AMSAT-ZL/KiwiSAT_Sub-Systems/Camera/C328-Camera-Application/grid test 300mm distance.jpg

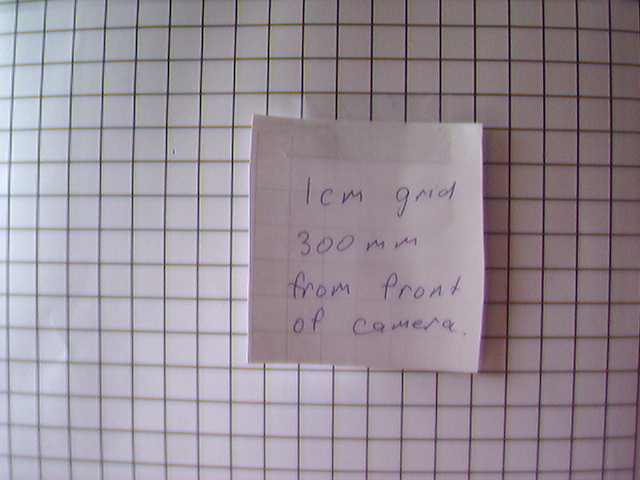
Camera/C328-Camera-Application/grid test 300mm distance.jpg
