AMSAT-ZL/KiwiSAT_Sub-Systems/IHU/Rev2/KiwiSAT U51 fix.JPG

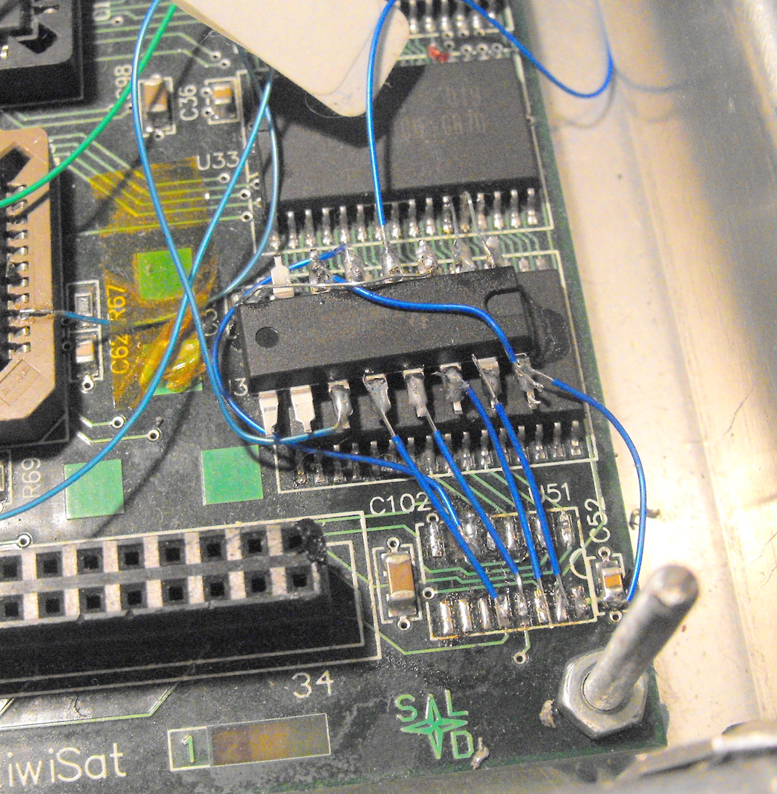
IHU/Rev2/KiwiSAT U51 fix.JPG
