AMSAT-ZL/KiwiSAT_Sub-Systems/README.md

# KiwiSAT_Sub-Systems
This Repository is for KiwiSAT Hardware.
It contains Data sheets for components, schematics, PCB designs, 
test data and photos for all the KiwiSAT Modules.
