AMSAT-ZL/KiwiSAT_Sub-Systems/Camera/PCB Panels/ReadMe.txt

15 May 2008   C Gumbrell

CameraADAC1 panel.
  Camera Version 2 and ADAC controller PCBs in a panel.
  Released for quote to OurPCB

16 May 2008   C Gumbrell

CameraADAC2 panel.
  Modified Camera Version 2 and ADAC controller PCBs in a panel.
  (not that version numbers of these PCBs was not changed)
  Power plane clearance needed to be increased for OurPCB.
  Released for manufacture.
