AMSAT-ZL/KiwiSAT_Sub-Systems/IHU/FEC_Encoder/ReadMe.txt

FEC Schematic

Forward Error Correction PCB

This is an add-on PCB for the IHU (first revision). It implements the FEC encoding.

Latest version is FEC Encoder 06B

Files:
FEC_Encoder_06B.DSN                     CAD schematic file (Proteus)
FEC_Encoder_06B.LYT                     CAD PCB file (Proteus)
FEC_Encoder_06B Schematic.pdf           PDF of the schematic
FEC_Encoder_06B Copper.pdf              Copper design (use this file to create the PCB)
FEC_Encoder_06B Layout.pdf              Diagram of the PCB layers. red=copper  blue=wire jumpers
