AMSAT-ZL/KiwiSAT_Sub-Systems/BCR/Notes on BCR.docx

Notes on BCR

This BCR (Battery Charge Regulator) uses MPPT (Maximum Power Point Transfer) to control the charge current fed to the battery.

The MPPT is controlled by a number 12FC671 PIC microcontrollers.

The programming code for these PICs is no longer available.
