AMSAT-ZL/KiwiSAT_Sub-Systems/FM_Receivers/drill.pdf

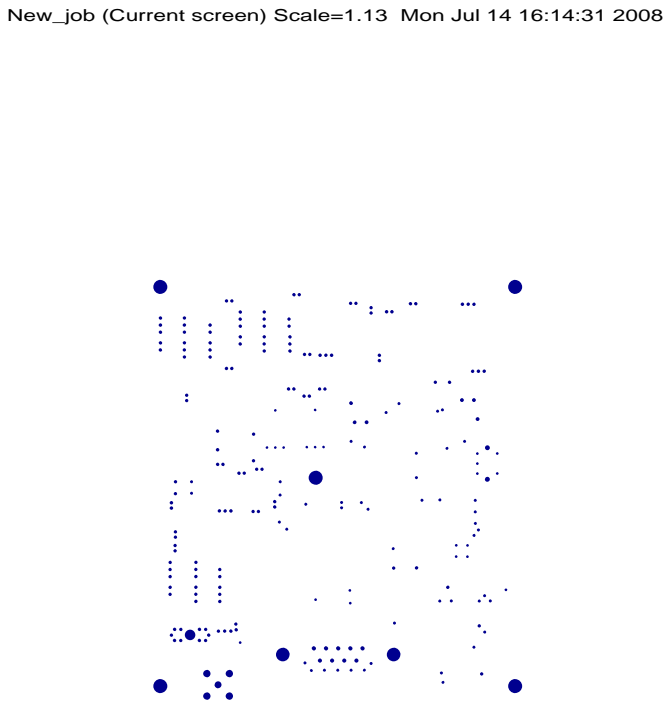
[picture p3: page 1]

New_job (Current screen) Scale=1.13 Mon Jul 14 16:14:31 2008
