AMSAT-ZL/KiwiSAT_Sub-Systems/BCR/BCR_Schematic_1.pdf

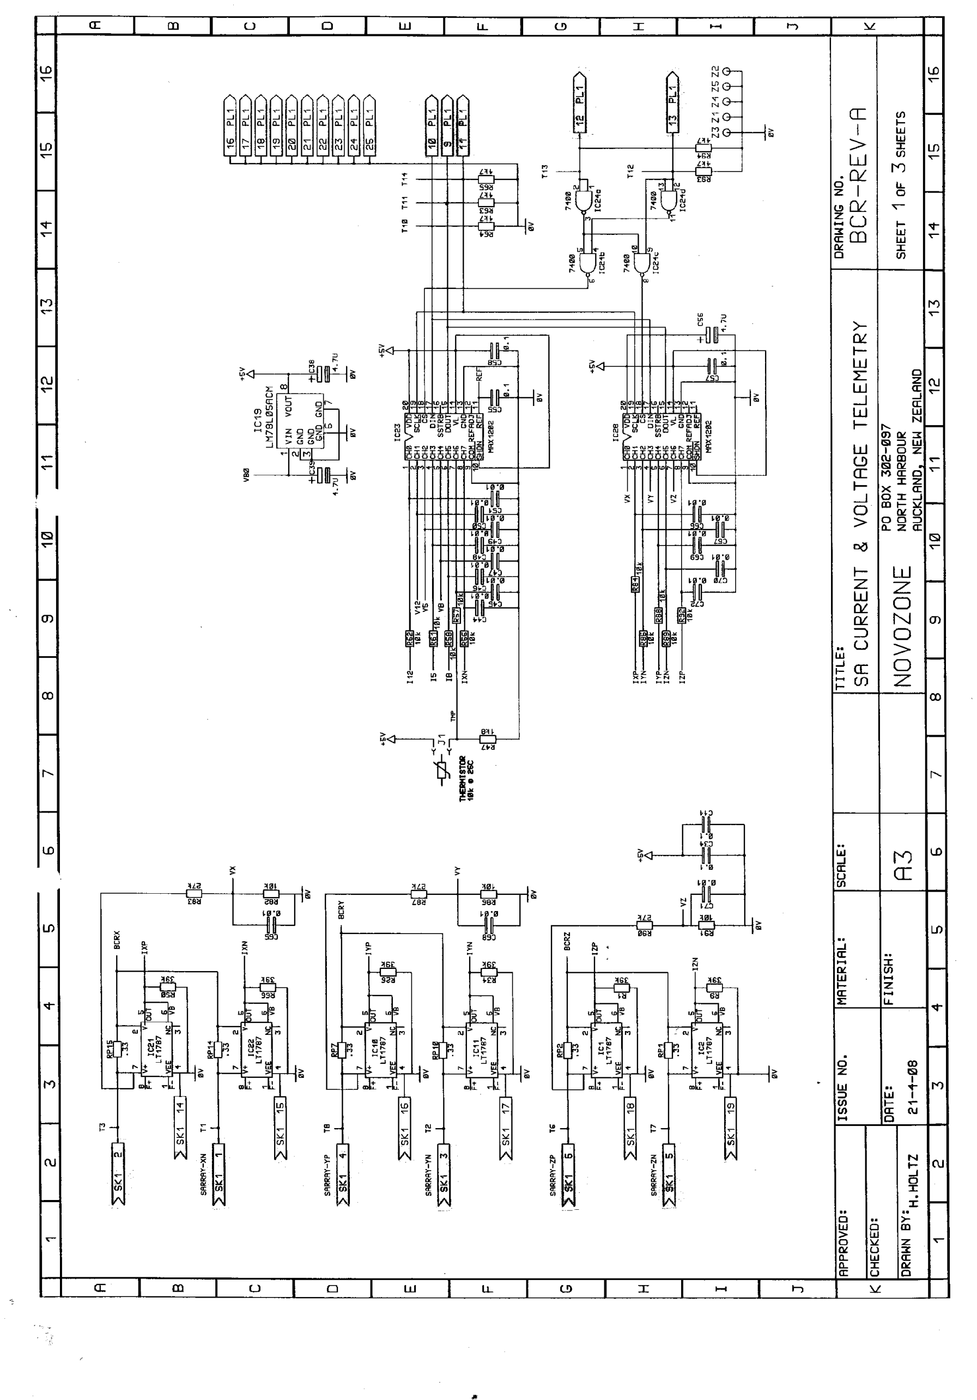
[picture p4: page 1]
