AMSAT-ZL/KiwiSAT_Sub-Systems/BCR/BCR_Schematic_2.pdf

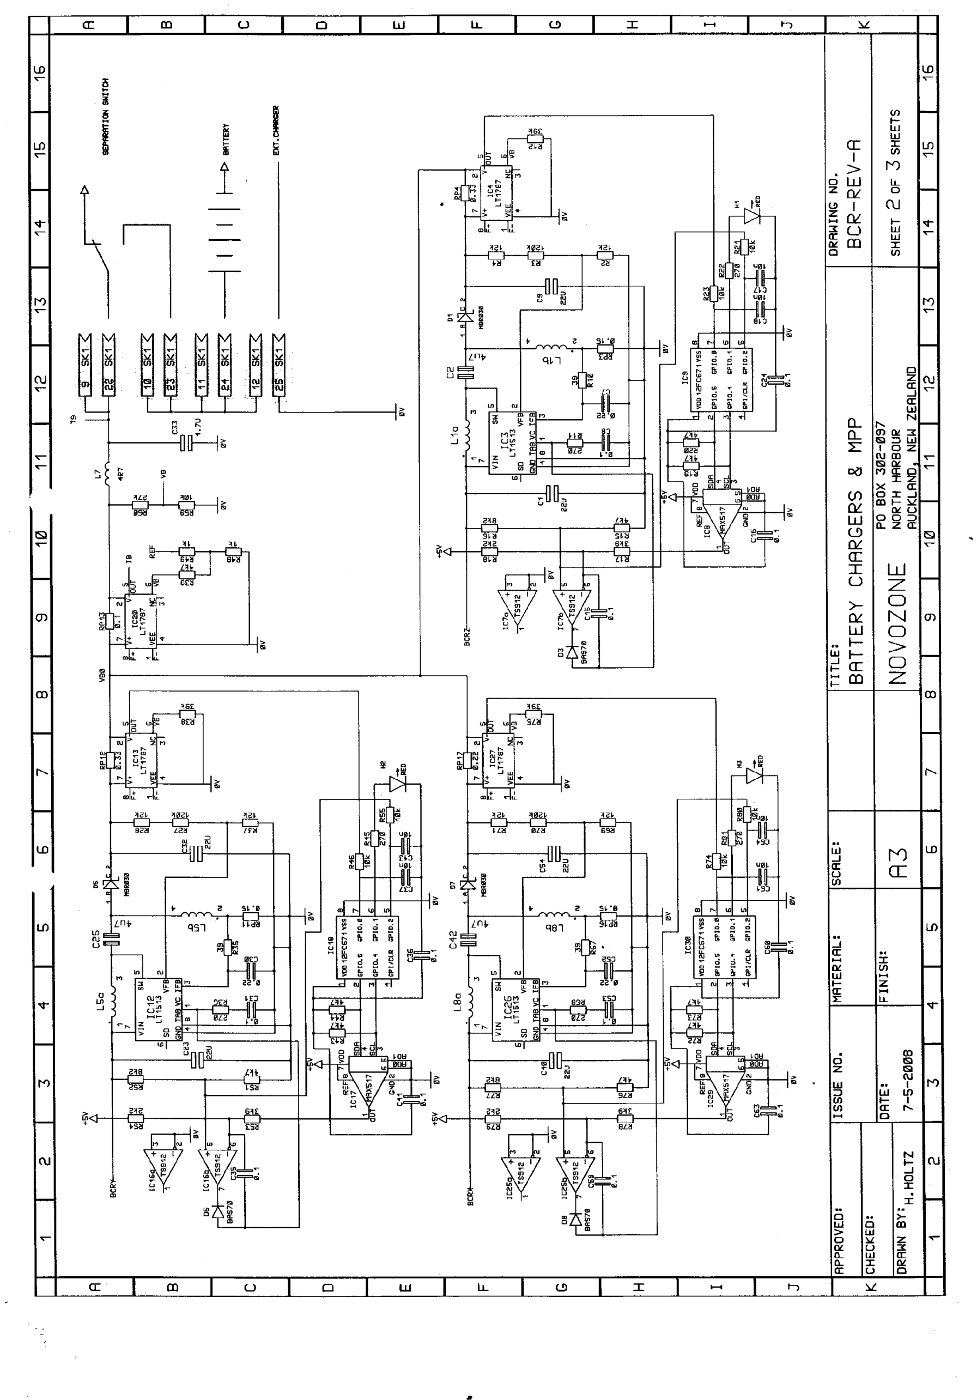
[picture p5: page 1]
