AMSAT-ZL/KiwiSAT_Sub-Systems/BCR/BCR_Schematic_3.pdf

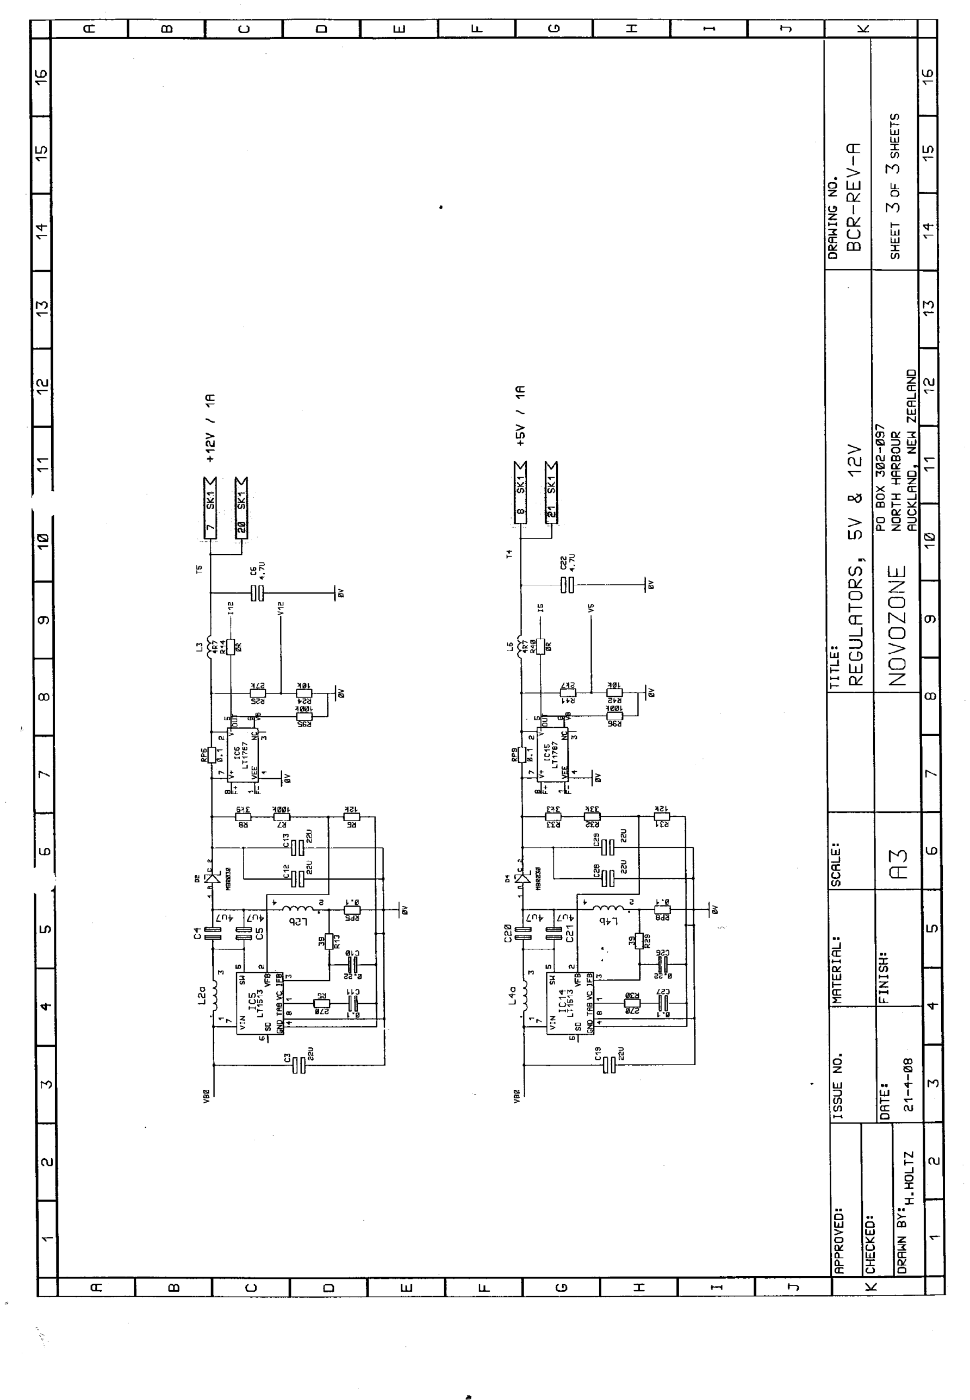
[picture p6: page 1]
