AMSAT-ZL/KiwiSAT_Sub-Systems/BCR/BCR_Board Layout.pdf

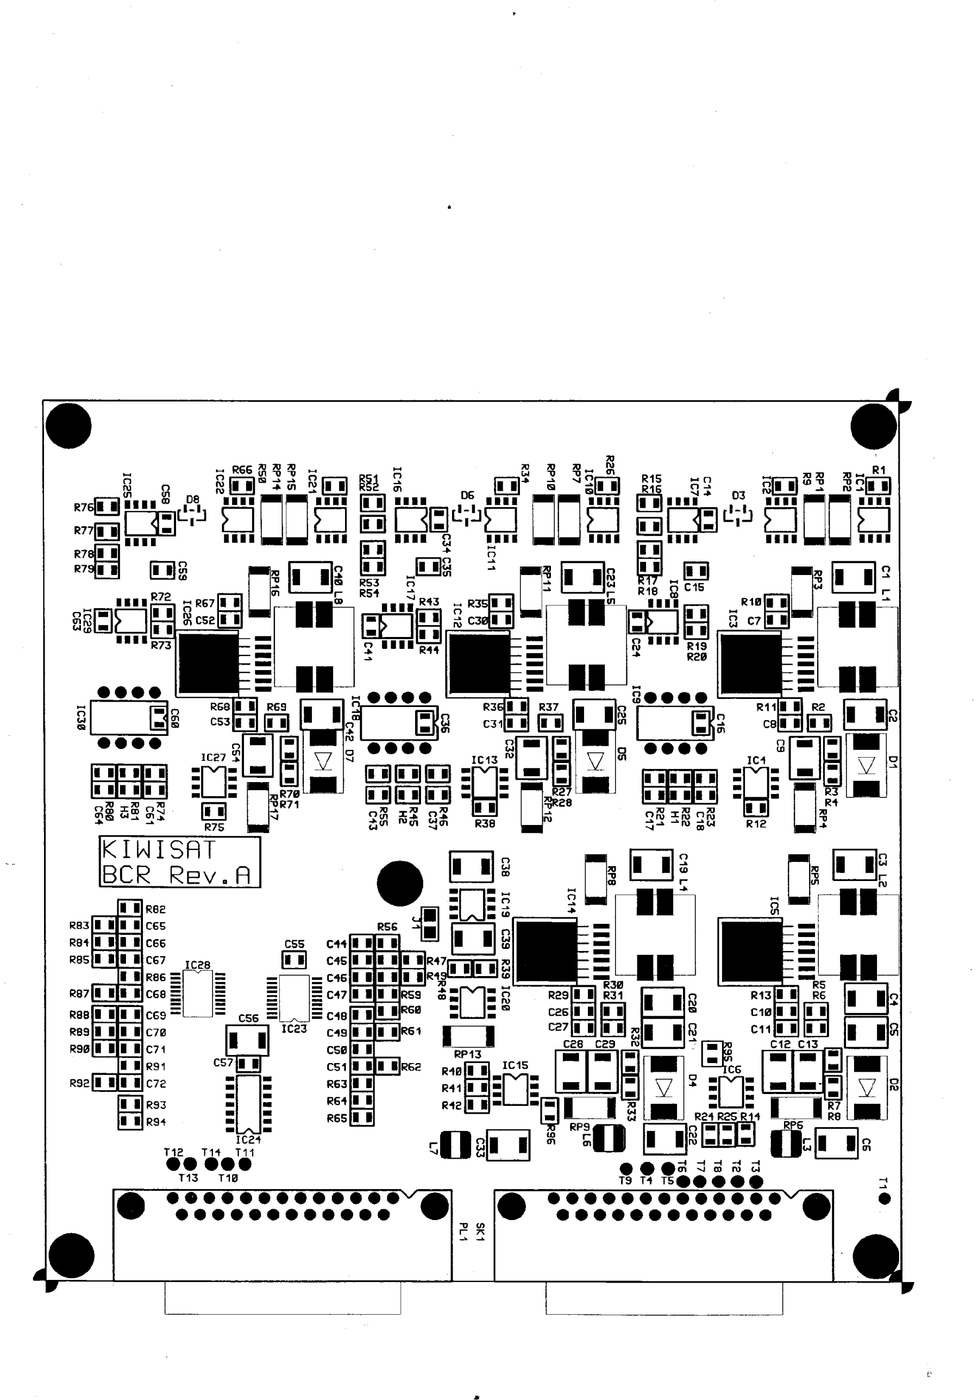
[picture p7: page 1]
