AMSAT-ZL/KiwiSAT_Sub-Systems/ADC_Module/ADC_Module_V10.gif

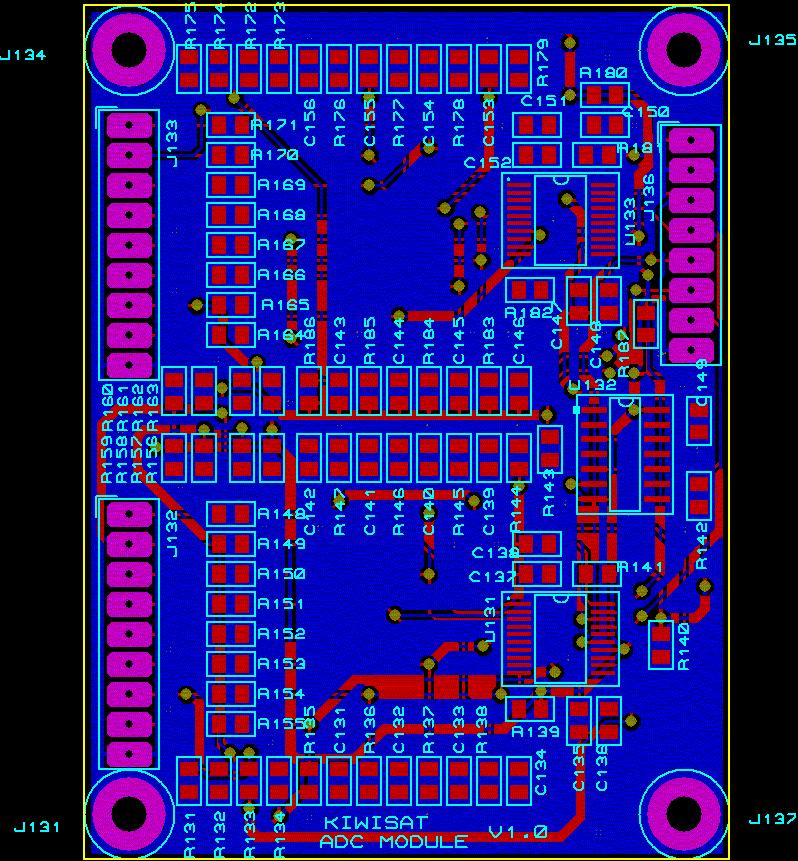
ADC_Module/ADC_Module_V10.gif
