AMSAT-ZL/KiwiSAT_Sub-Systems/Antennas/2M Turnstile Tx Ant/2M Canted Turnstile 3D.jpg

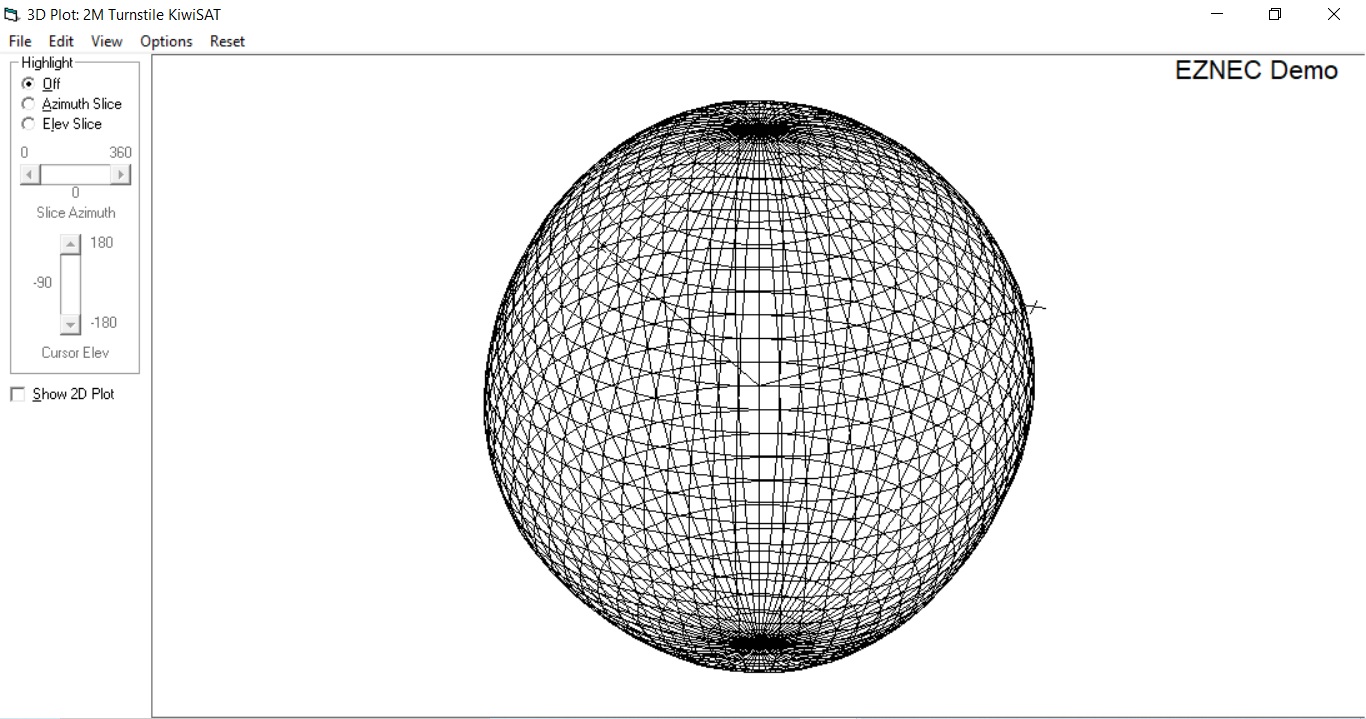
Antennas/2M Turnstile Tx Ant/2M Canted Turnstile 3D.jpg
