AMSAT-ZL/KiwiSAT_Sub-Systems/Antennas/2M Turnstile Tx Ant/2M Turnstile Azimuth.jpg

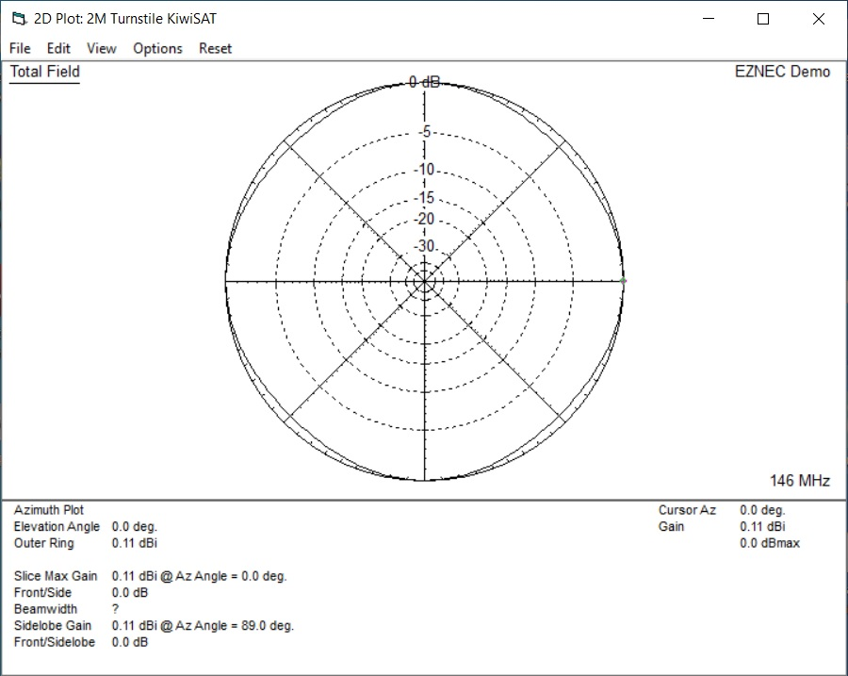
Antennas/2M Turnstile Tx Ant/2M Turnstile Azimuth.jpg
