AMSAT-ZL/KiwiSAT_Sub-Systems/Antennas/2M Turnstile Tx Ant/2M Turnstile Model.jpg

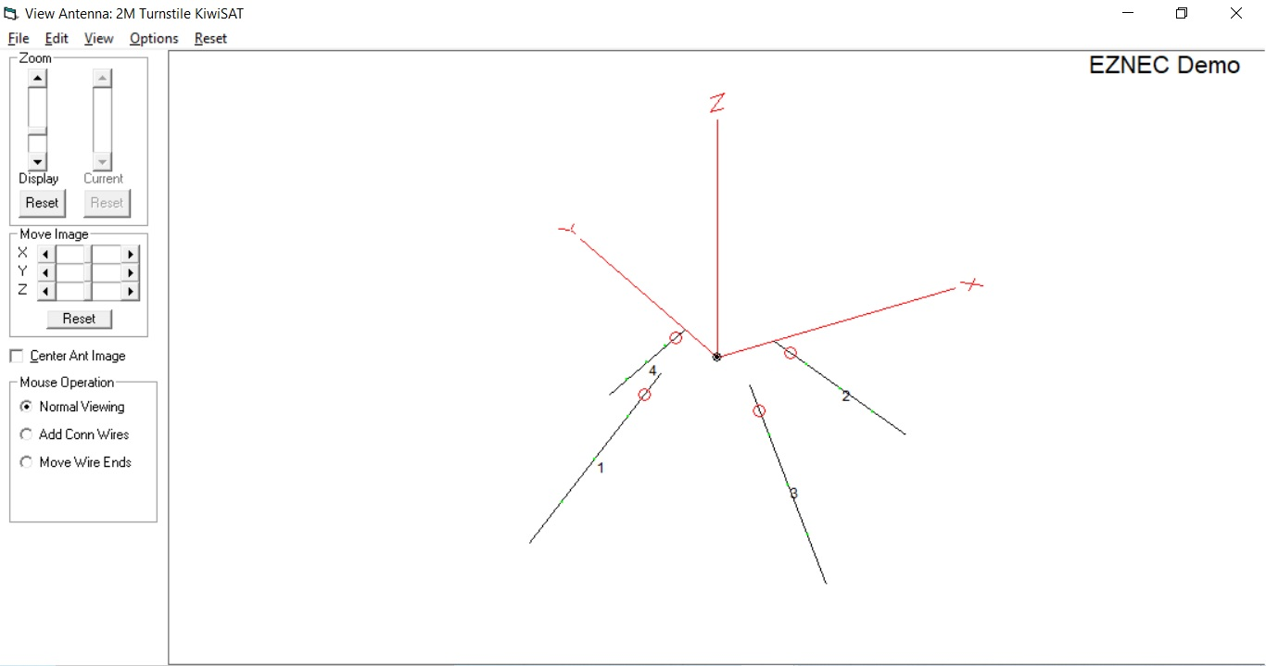
Antennas/2M Turnstile Tx Ant/2M Turnstile Model.jpg
