AMSAT-ZL/KiwiSAT_Sub-Systems/Antennas/70CM Whip/70Cm Whip1.bmp

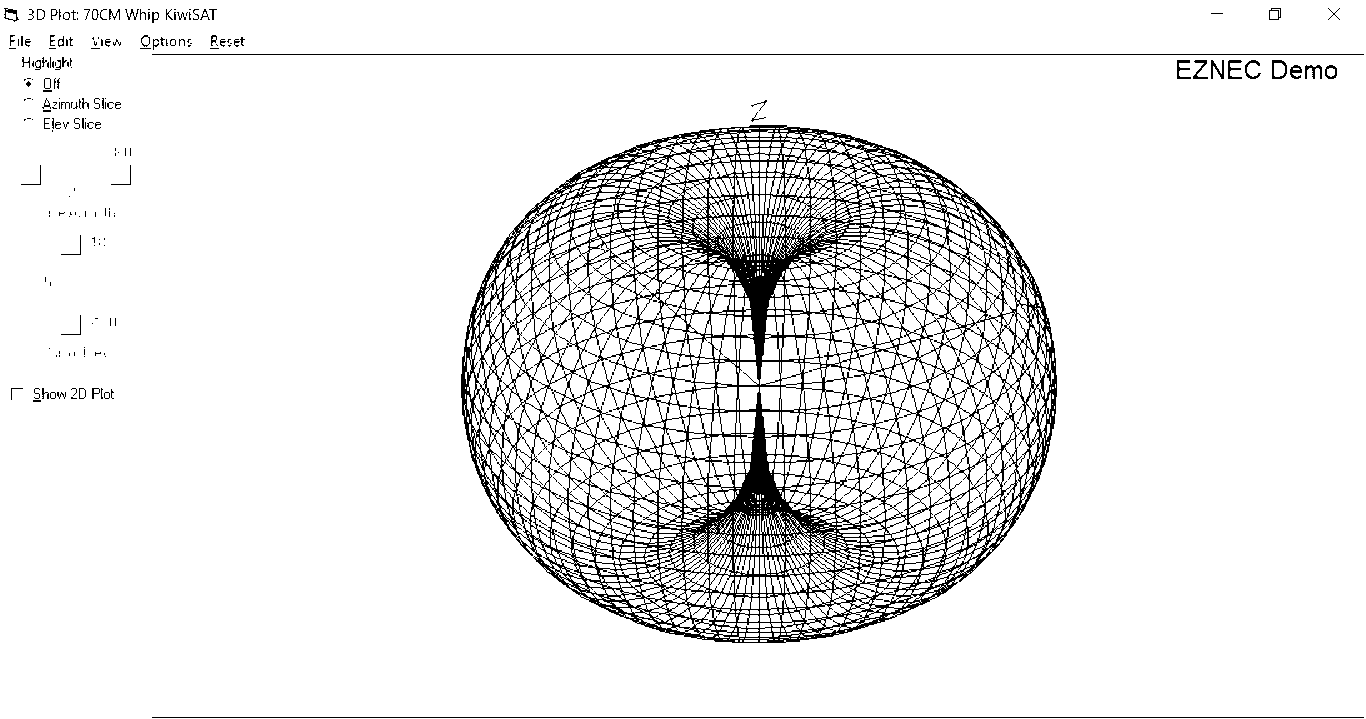
Antennas/70CM Whip/70Cm Whip1.bmp
