AMSAT-ZL/KiwiSAT_Sub-Systems/Antennas/70CM Whip/70Cm Whip1.jpg

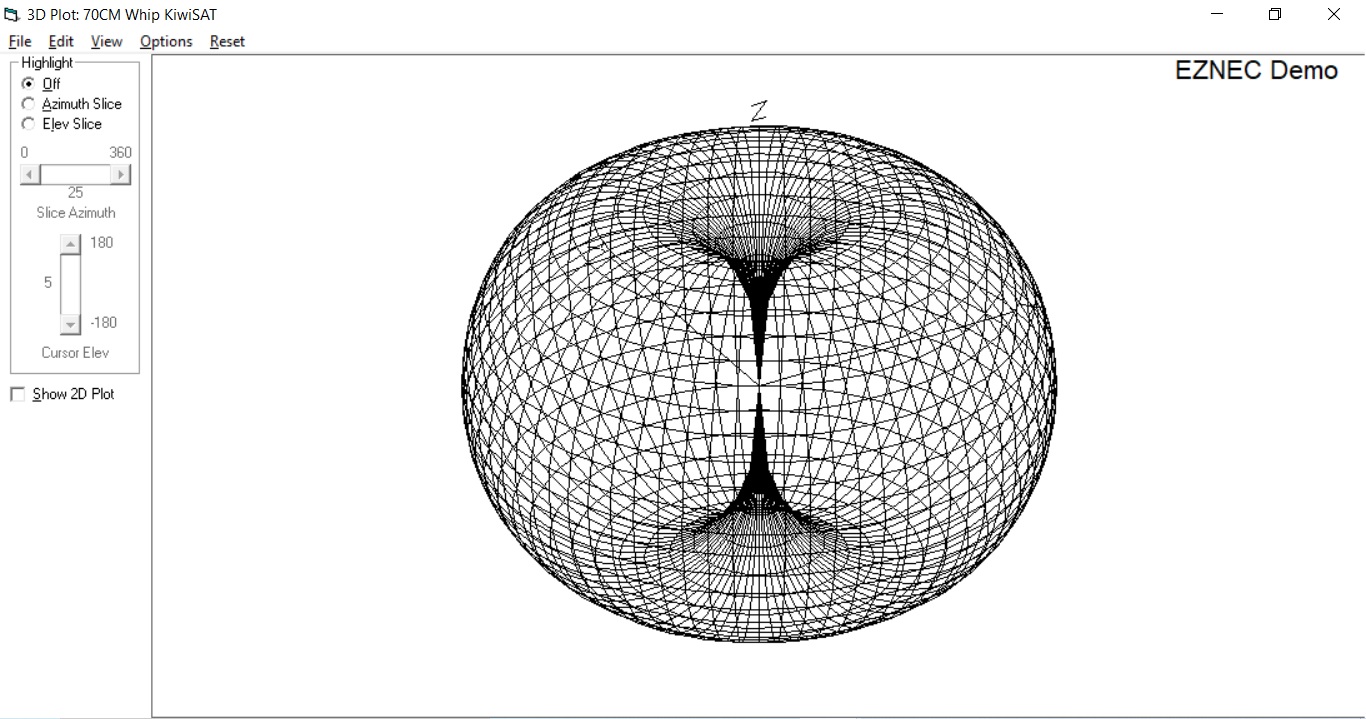
Antennas/70CM Whip/70Cm Whip1.jpg
