AMSAT-ZL/KiwiSAT_Sub-Systems/Antennas/70CM Whip/70CM Whip Model.jpg

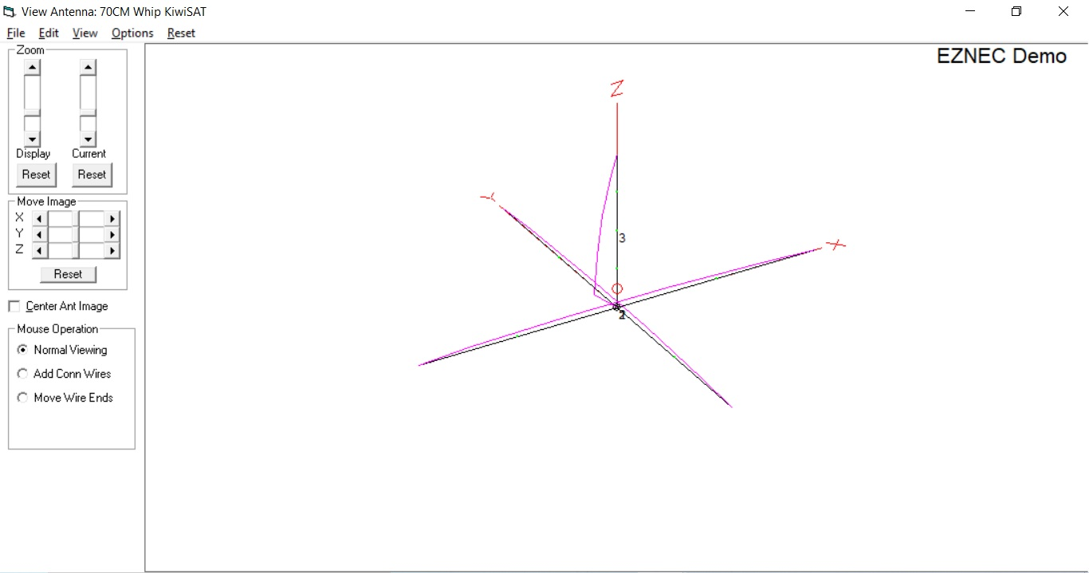
Antennas/70CM Whip/70CM Whip Model.jpg
