AMSAT-ZL/KiwiSAT_Sub-Systems/Antennas/Ant Switch/Ant Switch Block.jpg

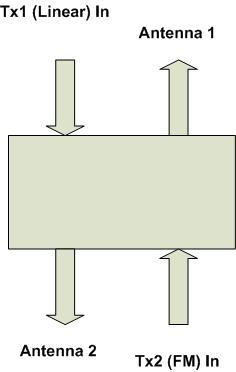
Antennas/Ant Switch/Ant Switch Block.jpg
