AMSAT-ZL/KiwiSAT_Sub-Systems/Antennas/Ant Switch/Antenna Phasing.jpg

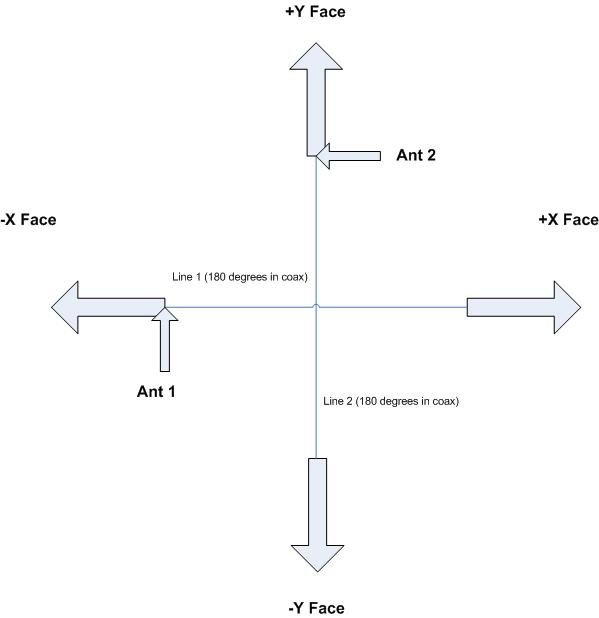
Antennas/Ant Switch/Antenna Phasing.jpg
