AMSAT-ZL/KiwiSAT_Sub-Systems/Antennas/Ant Switch/SCRN01.JPG

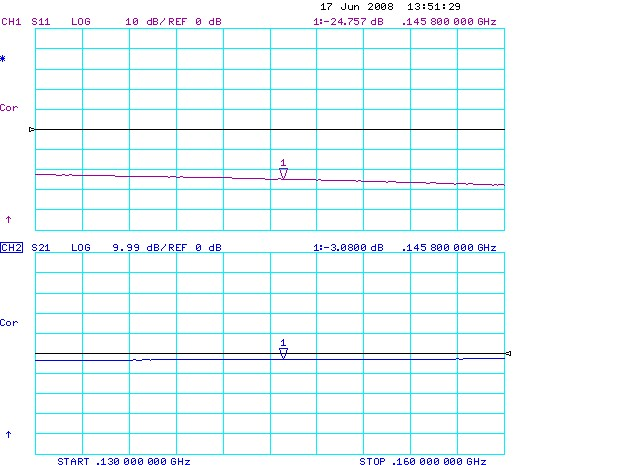
Antennas/Ant Switch/SCRN01.JPG
