AMSAT-ZL/KiwiSAT_Sub-Systems/BCR/BCR - in tray.jpg

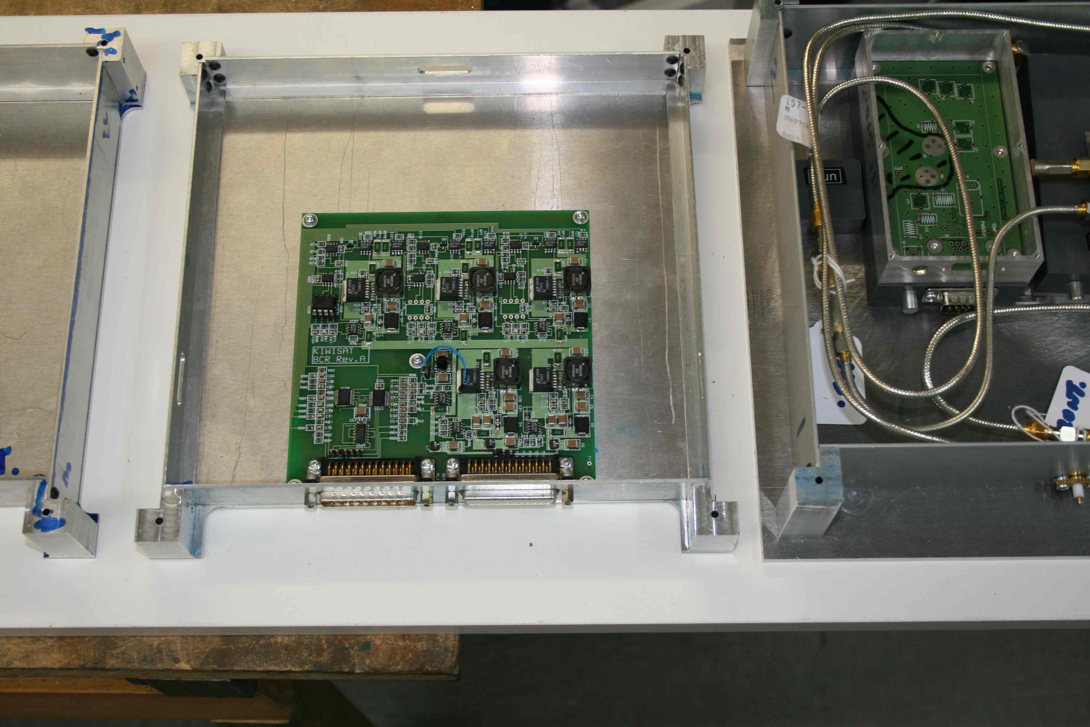
BCR/BCR - in tray.jpg
