AMSAT-ZL/KiwiSAT_Sub-Systems/BCR/KiwiSAT - BCR board Mk 2.jpg

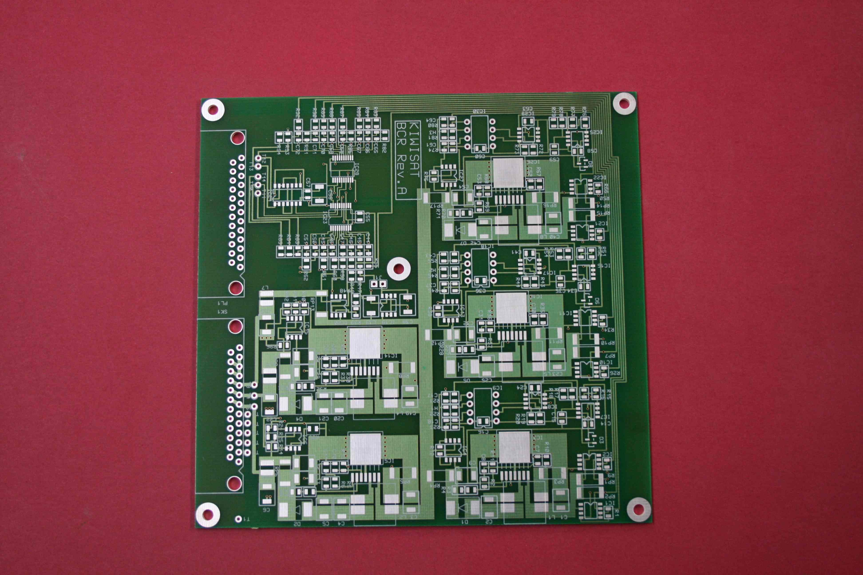
BCR/KiwiSAT - BCR board Mk 2.jpg
