AMSAT-ZL/KiwiSAT_Sub-Systems/BCR/SolarSim/Error Message.jpg

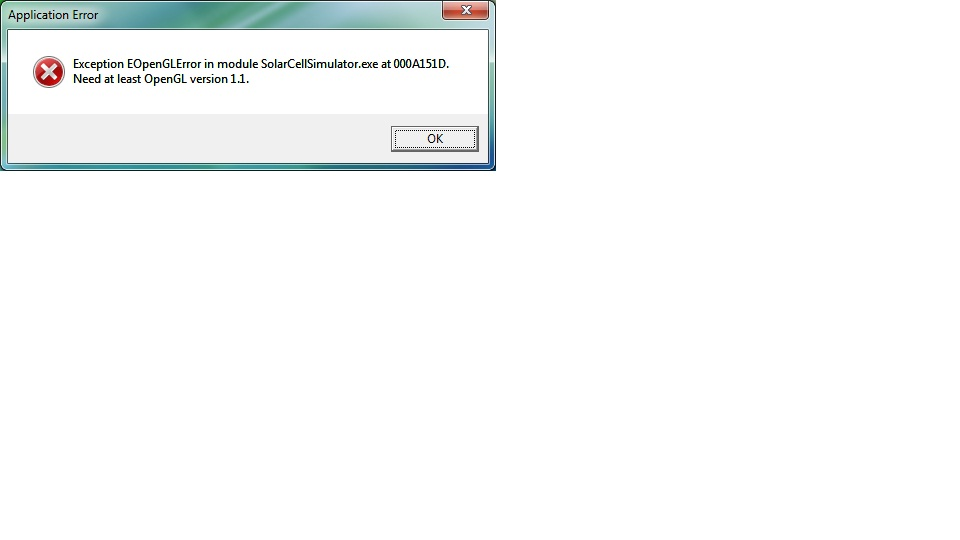
BCR/SolarSim/Error Message.jpg
