AMSAT-ZL/KiwiSAT_Sub-Systems/BCR/SolarSim/KiwiSAT - Power Sim1.jpg

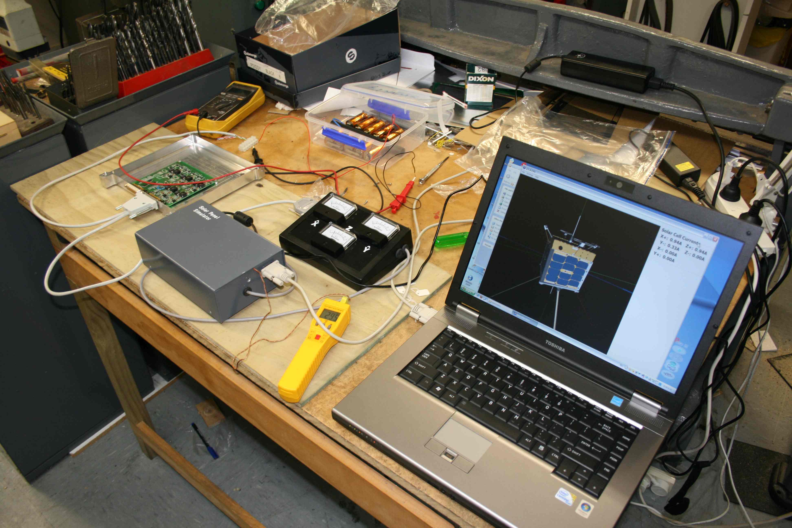
BCR/SolarSim/KiwiSAT - Power Sim1.jpg
