AMSAT-ZL/KiwiSAT_Sub-Systems/BCR/SolarSim/KiwiSAT - Power Sim2.jpg

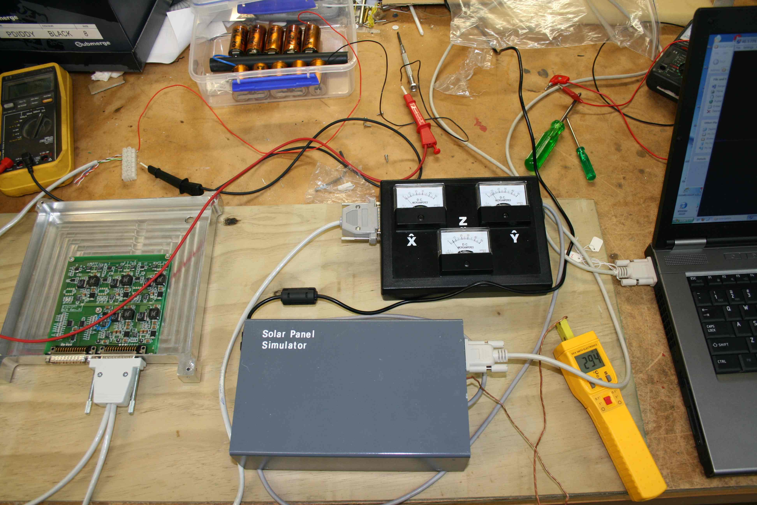
BCR/SolarSim/KiwiSAT - Power Sim2.jpg
