AMSAT-ZL/KiwiSAT_Sub-Systems/BCR/SolarSim/KiwiSAT - Power Sim3.jpg

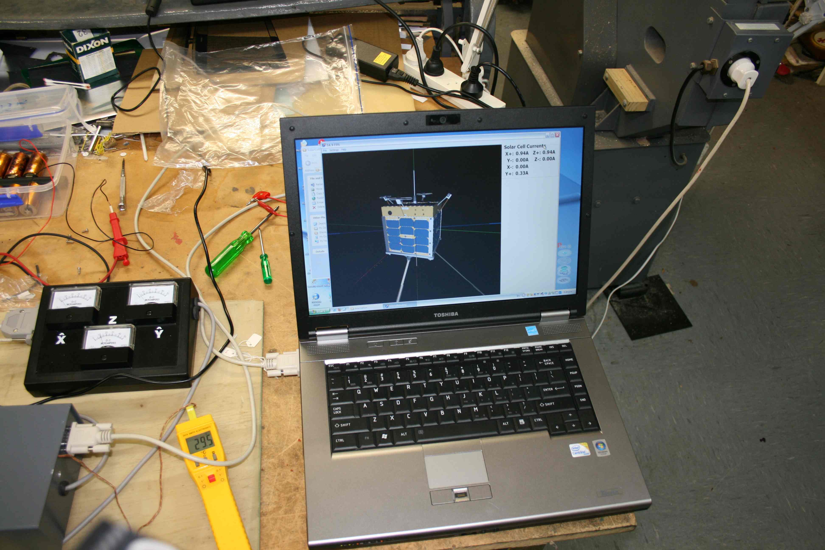
BCR/SolarSim/KiwiSAT - Power Sim3.jpg
