AMSAT-ZL/KiwiSAT_Sub-Systems/BCR/SolarSim/Sat Sim3.jpg

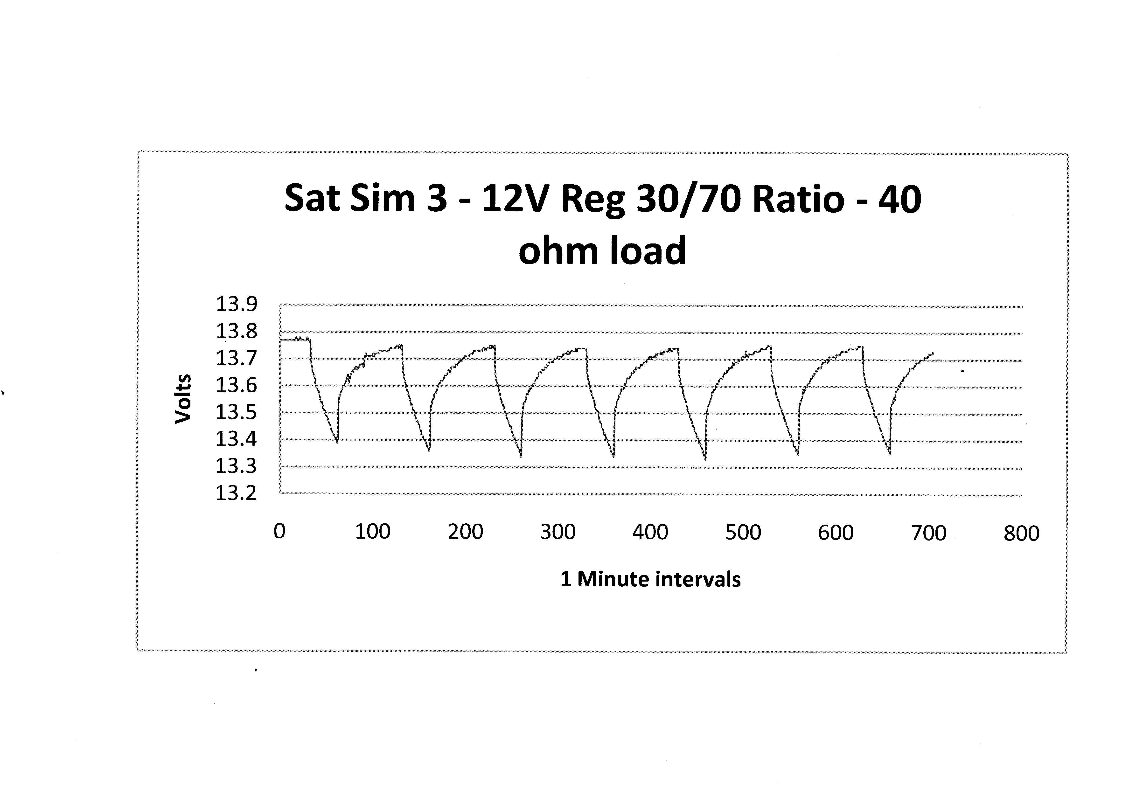
BCR/SolarSim/Sat Sim3.jpg
