AMSAT-ZL/KiwiSAT_Sub-Systems/BCR/SolarSim/Sat Sim4.jpg

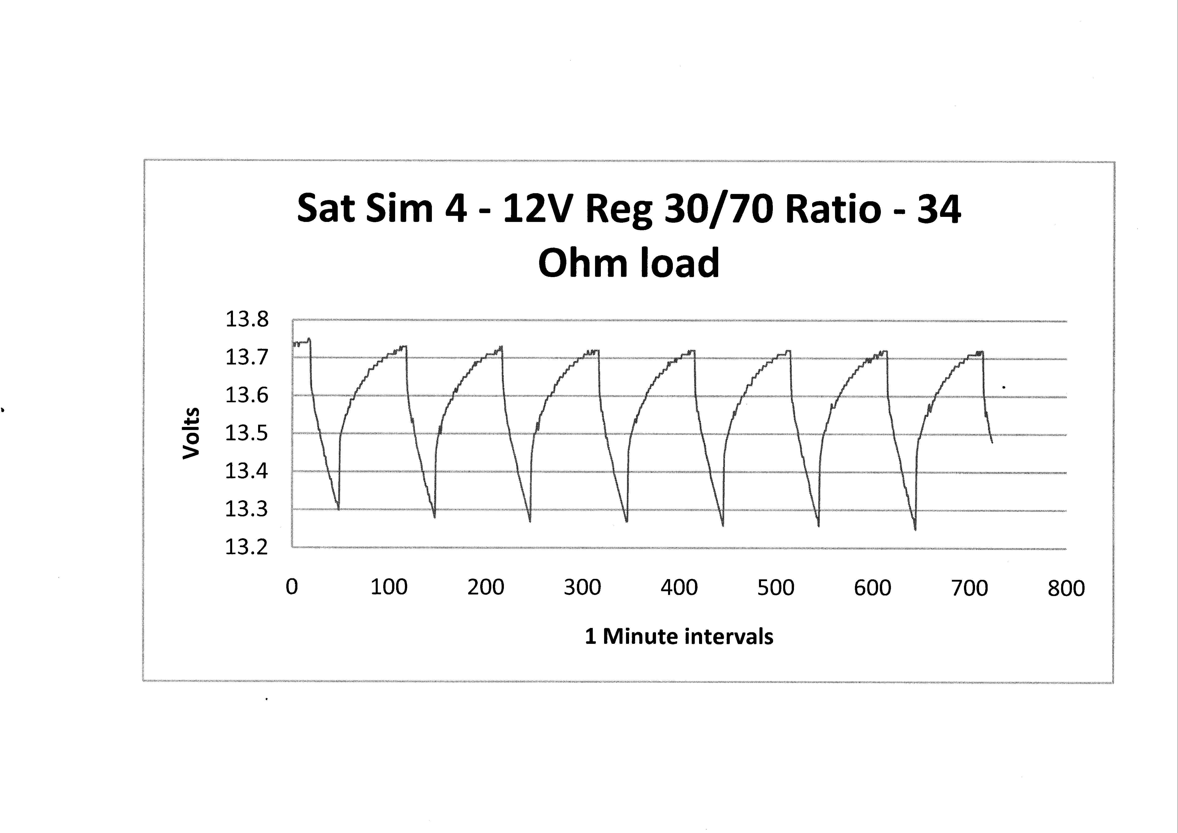
BCR/SolarSim/Sat Sim4.jpg
