AMSAT-ZL/KiwiSAT_Sub-Systems/BCR/SolarSim/Sat Sim5.jpg

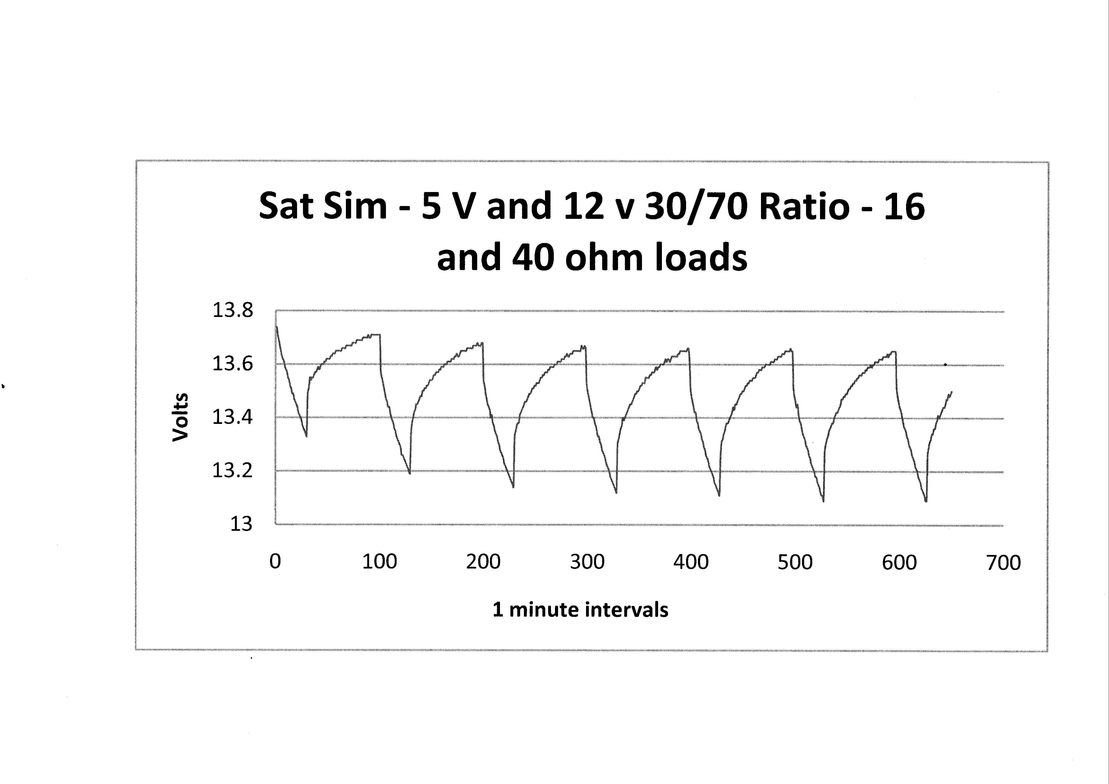
BCR/SolarSim/Sat Sim5.jpg
