AMSAT-ZL/KiwiSAT_Sub-Systems/BCR/SolarSim/Sat Sim 11.jpg

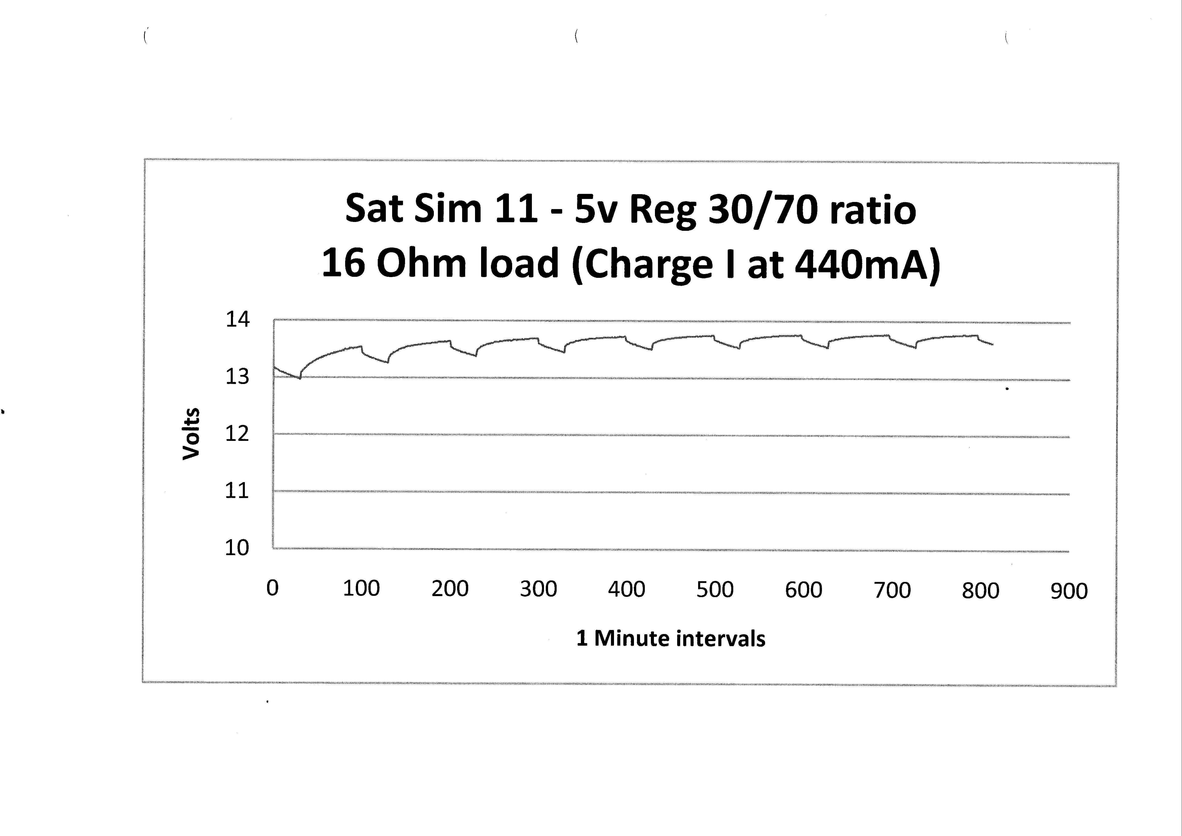
BCR/SolarSim/Sat Sim 11.jpg
