AMSAT-ZL/KiwiSAT_Sub-Systems/BCR/SolarSim/Sat Sim 12.jpg

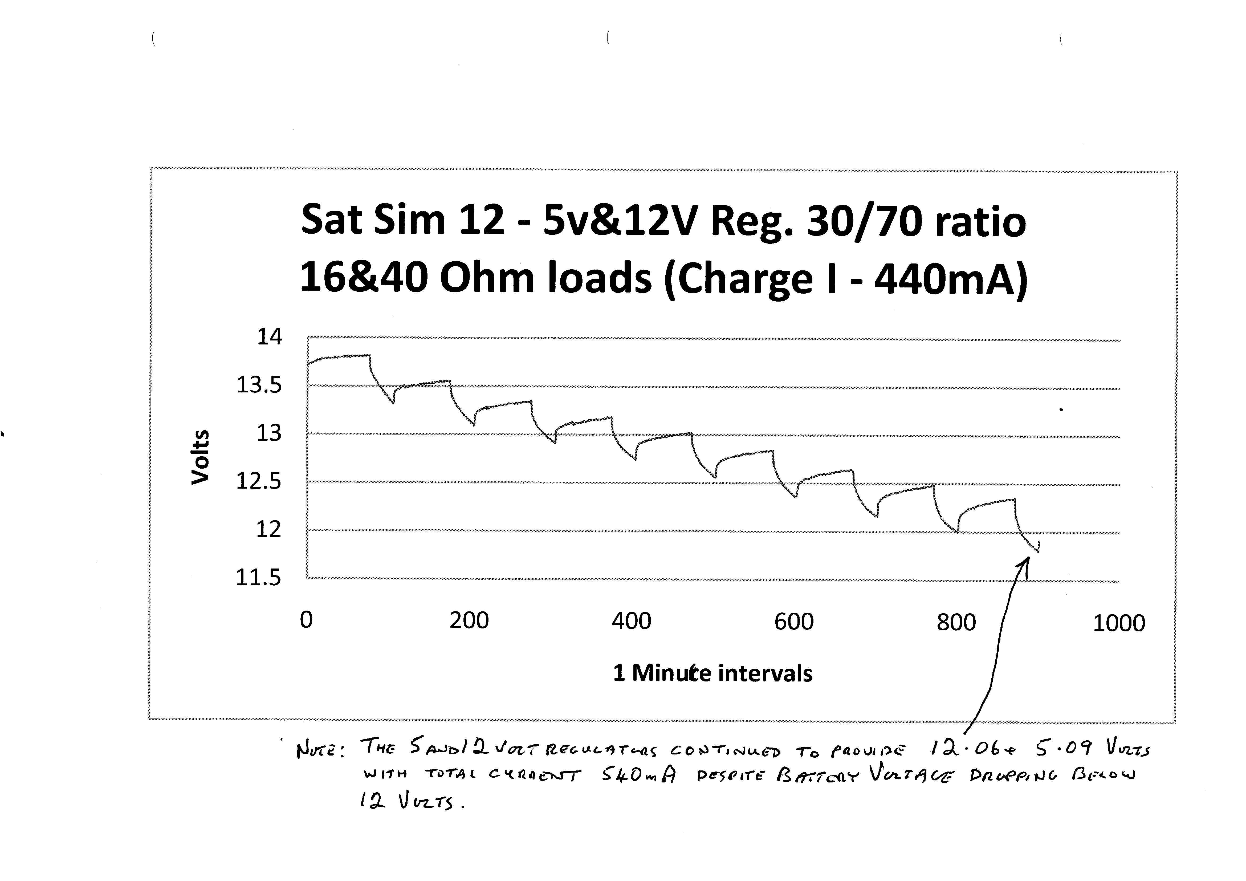
BCR/SolarSim/Sat Sim 12.jpg
