AMSAT-ZL/KiwiSAT_Sub-Systems/BCR/SolarSim/Sat Sim 13.jpg

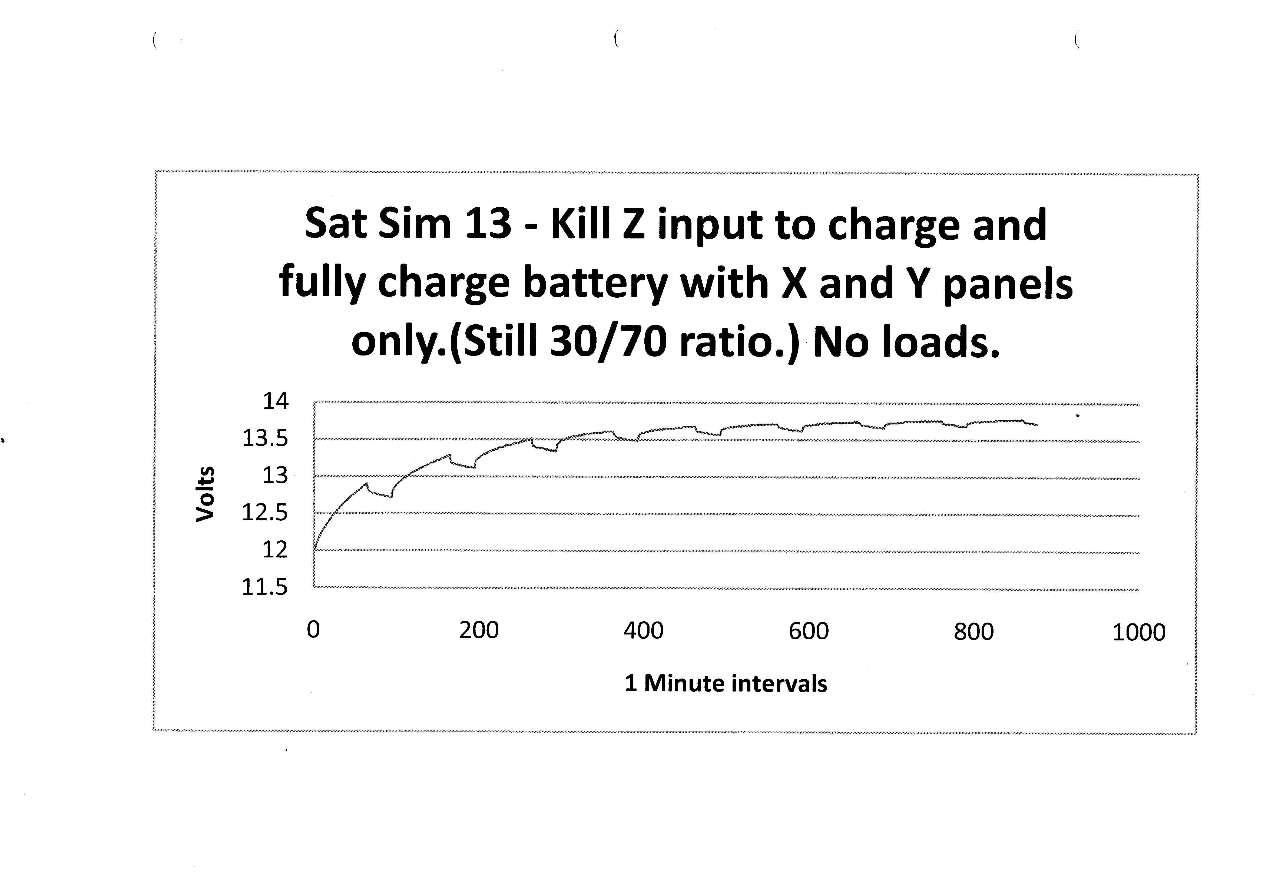
BCR/SolarSim/Sat Sim 13.jpg
