AMSAT-ZL/KiwiSAT_Sub-Systems/BCR/SolarSim/Sat Sim 14.jpg

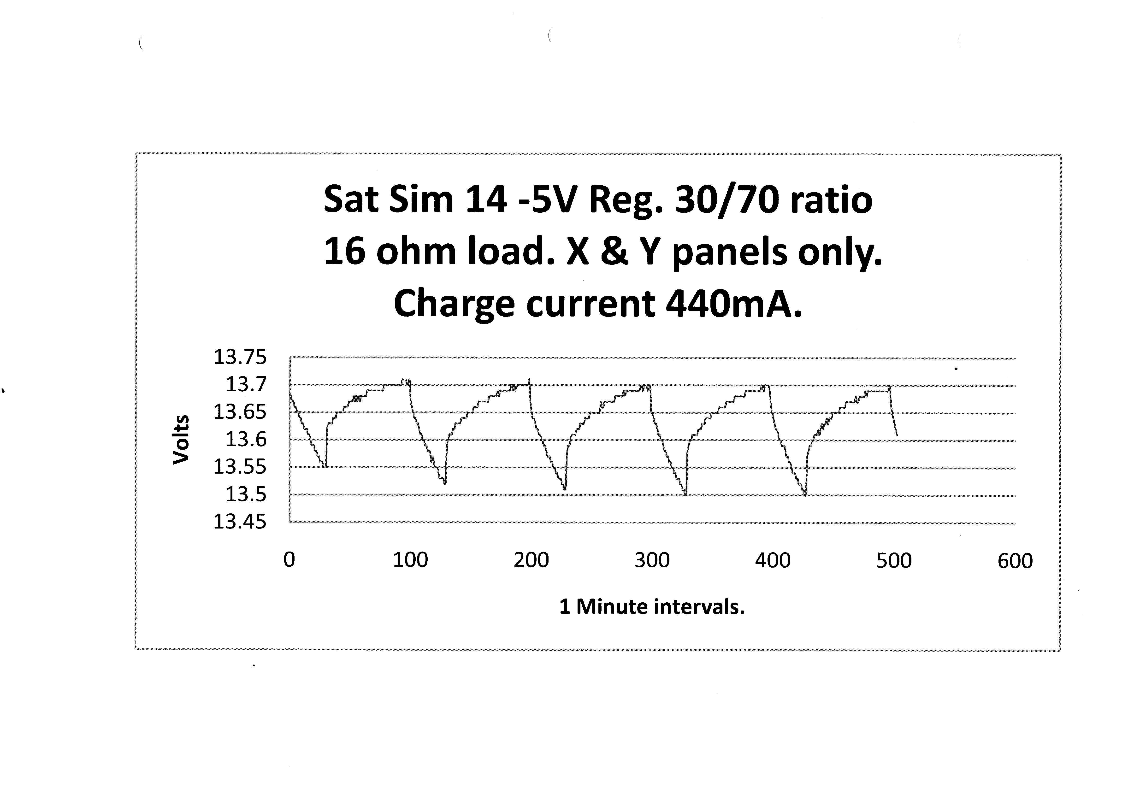
BCR/SolarSim/Sat Sim 14.jpg
