AMSAT-ZL/KiwiSAT_Sub-Systems/BCR/SolarSim/Sat Sim 15.jpg

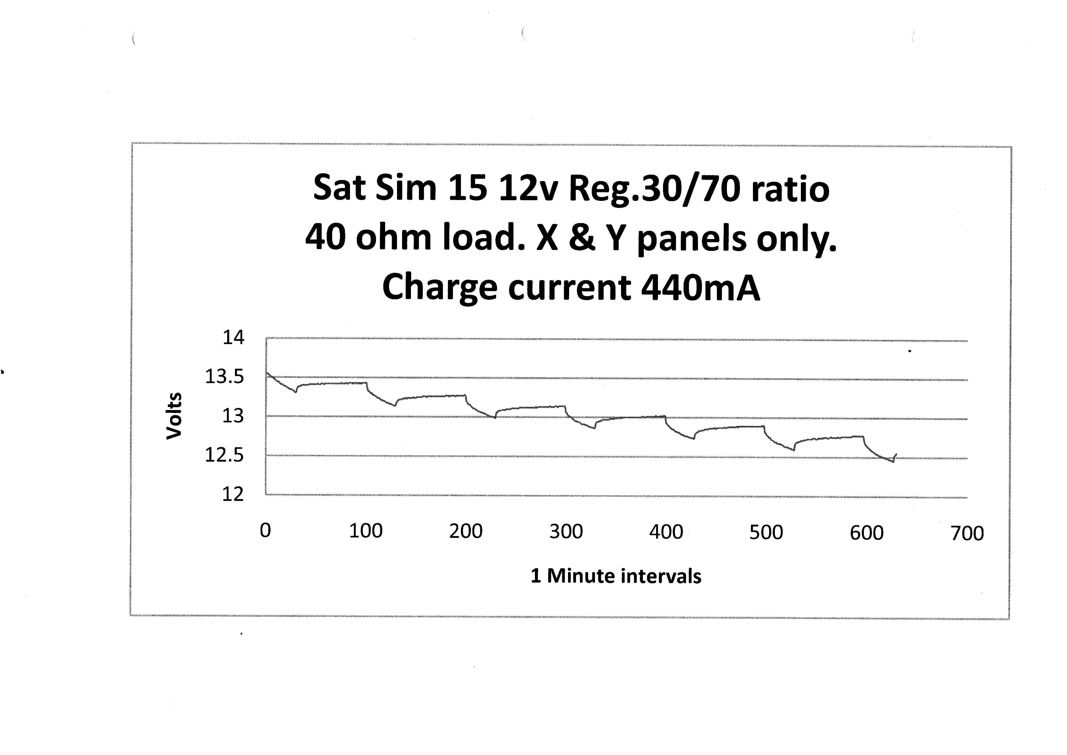
BCR/SolarSim/Sat Sim 15.jpg
