AMSAT-ZL/KiwiSAT_Sub-Systems/BCR/SolarSim/Save0001.jpg

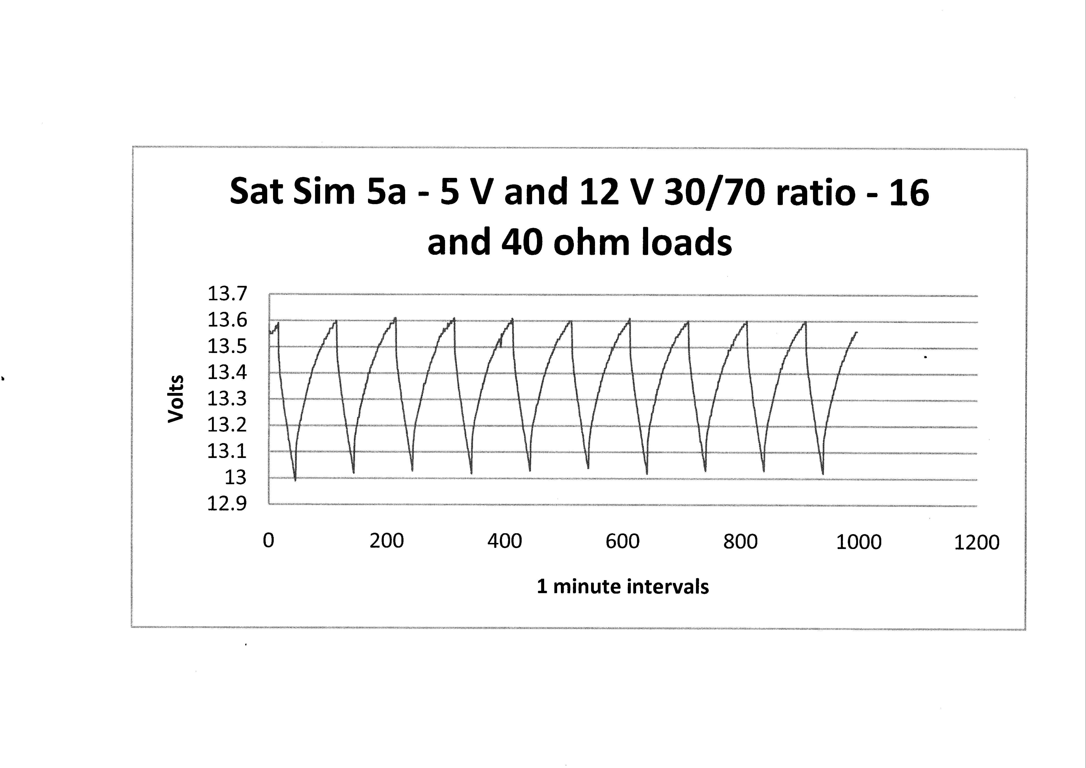
BCR/SolarSim/Save0001.jpg
