AMSAT-ZL/KiwiSAT_Sub-Systems/BCR/SolarSim/Save.jpg

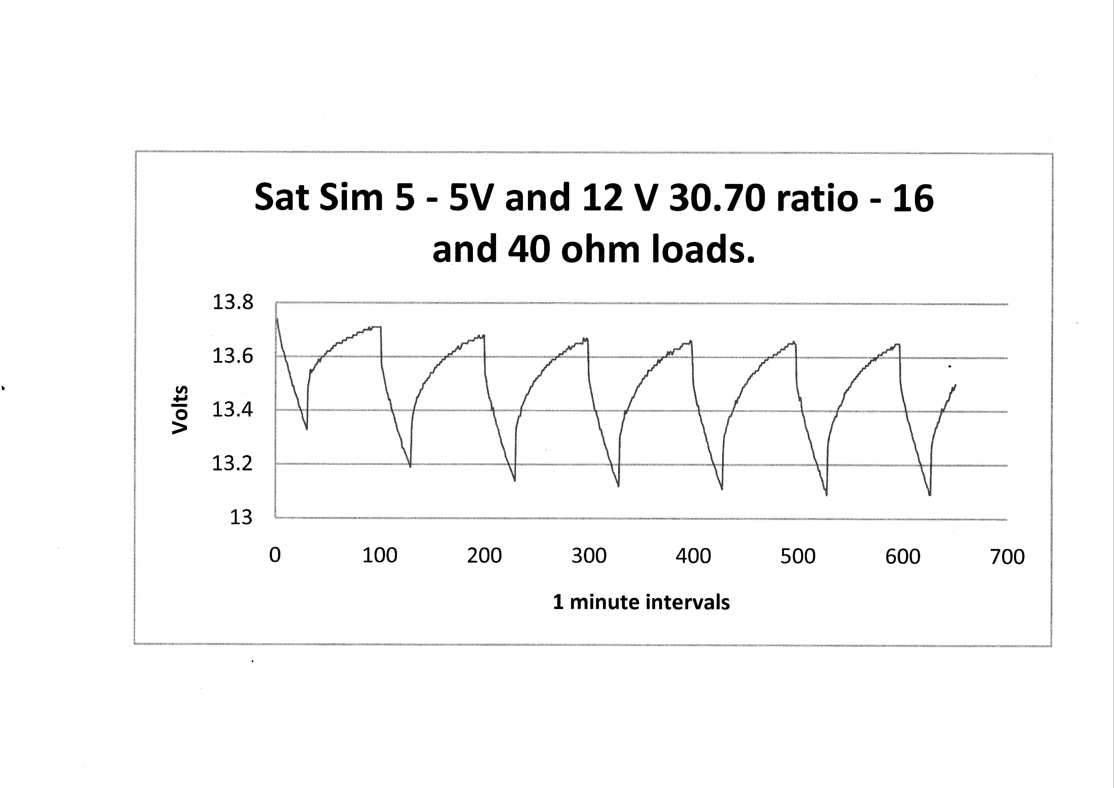
BCR/SolarSim/Save.jpg
