AMSAT-ZL/KiwiSAT_Sub-Systems/BCR/SolarSim/Side1.gif

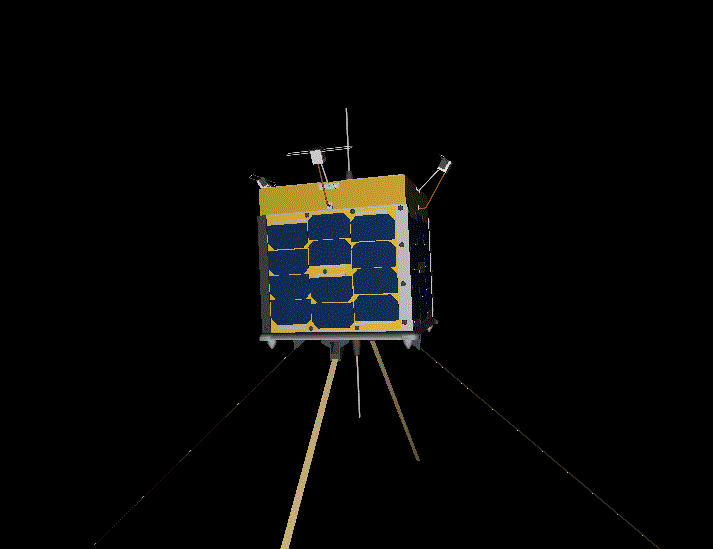
BCR/SolarSim/Side1.gif
