AMSAT-ZL/KiwiSAT_Sub-Systems/BCR/SolarSim/Side2.gif

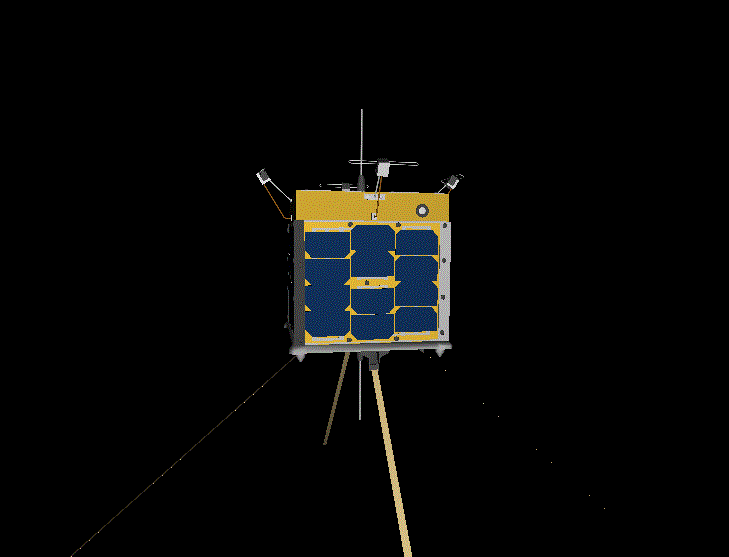
BCR/SolarSim/Side2.gif
