AMSAT-ZL/KiwiSAT_Sub-Systems/BCR/SolarSim/Solar Sim1.jpg

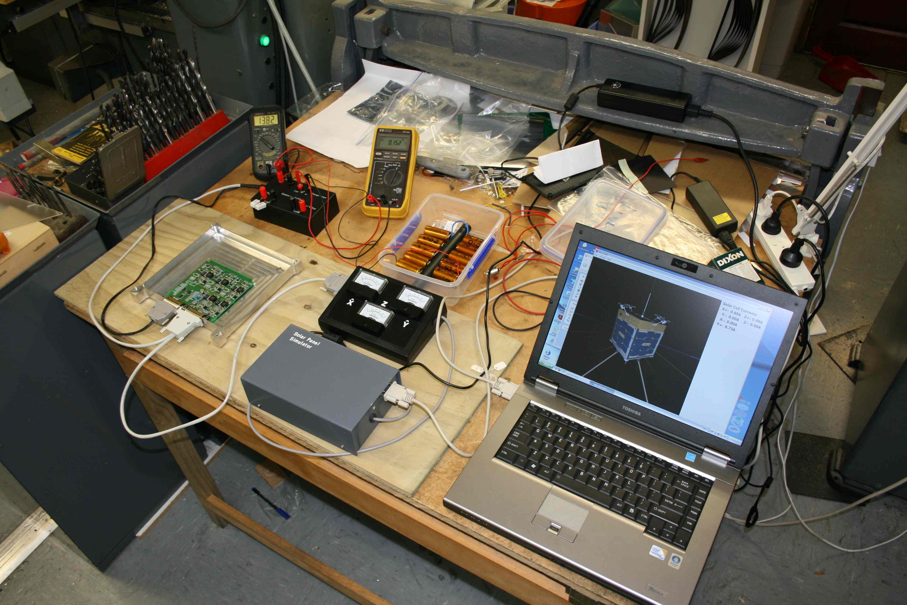
BCR/SolarSim/Solar Sim1.jpg
