AMSAT-ZL/KiwiSAT_Sub-Systems/BCR/SolarSim/Solar Sim2.jpg

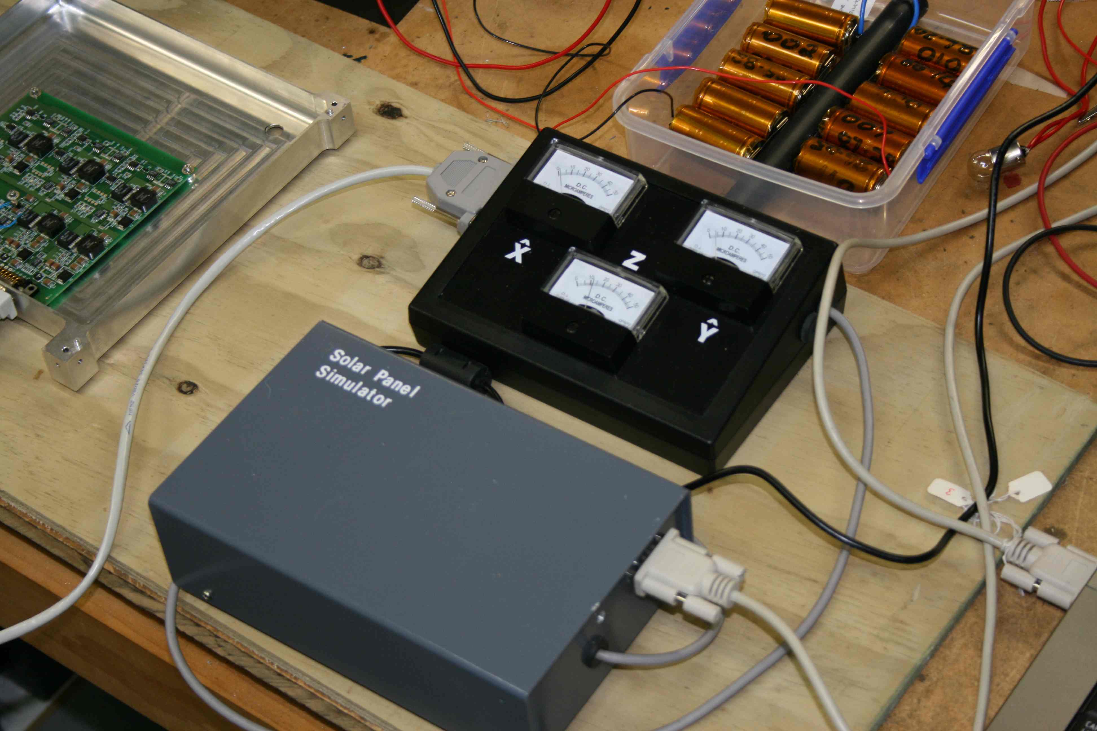
BCR/SolarSim/Solar Sim2.jpg
