AMSAT-ZL/KiwiSAT_Sub-Systems/BCR/SolarSim/ZFaceBtm.gif

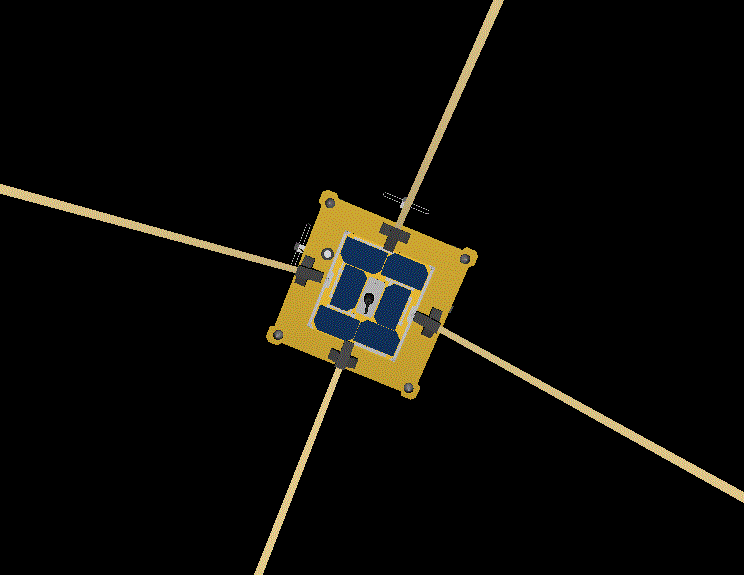
BCR/SolarSim/ZFaceBtm.gif
