AMSAT-ZL/KiwiSAT_Sub-Systems/BCR/SolarSim/ZFaceTop.gif

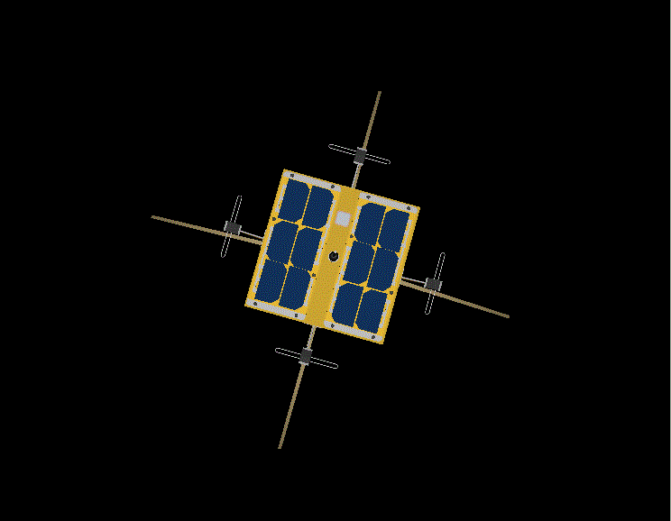
BCR/SolarSim/ZFaceTop.gif
