AMSAT-ZL/KiwiSAT_Sub-Systems/Block_v1.5.jpg

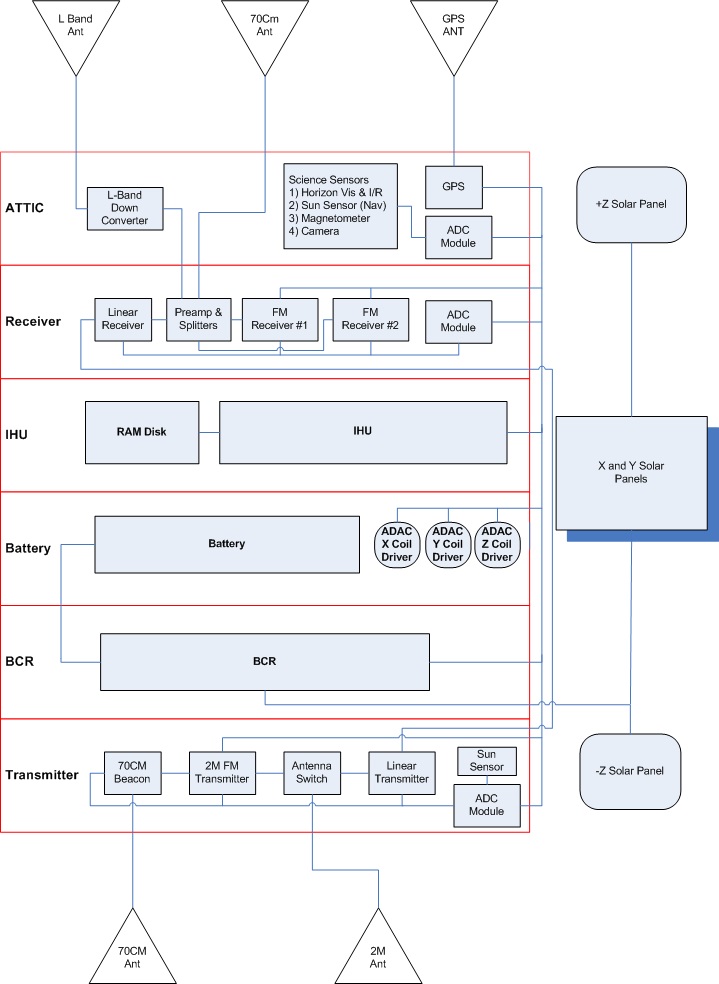
Block_v1.5.jpg
