AMSAT-ZL/KiwiSAT_Sub-Systems/Camera/Camera PCB - Coloured Image.gif

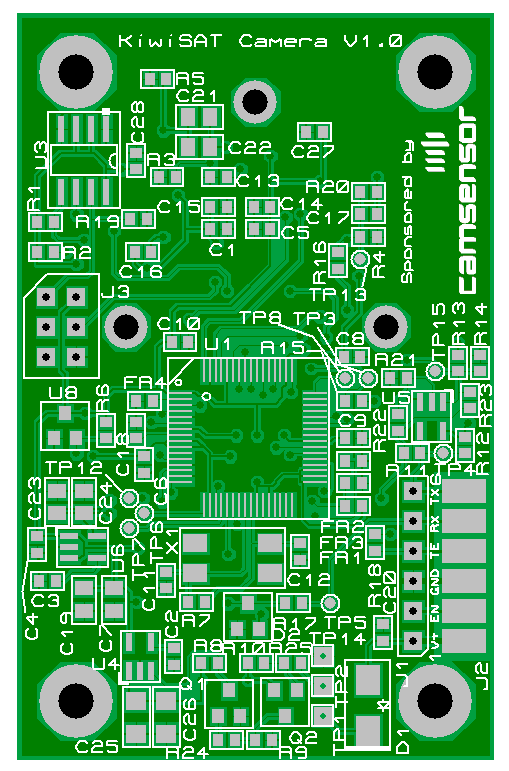
Camera/Camera PCB - Coloured Image.gif
