AMSAT-ZL/KiwiSAT_Sub-Systems/FM_Receivers/UHF FM RX Pictures/0 - UHF FM RX.jpg

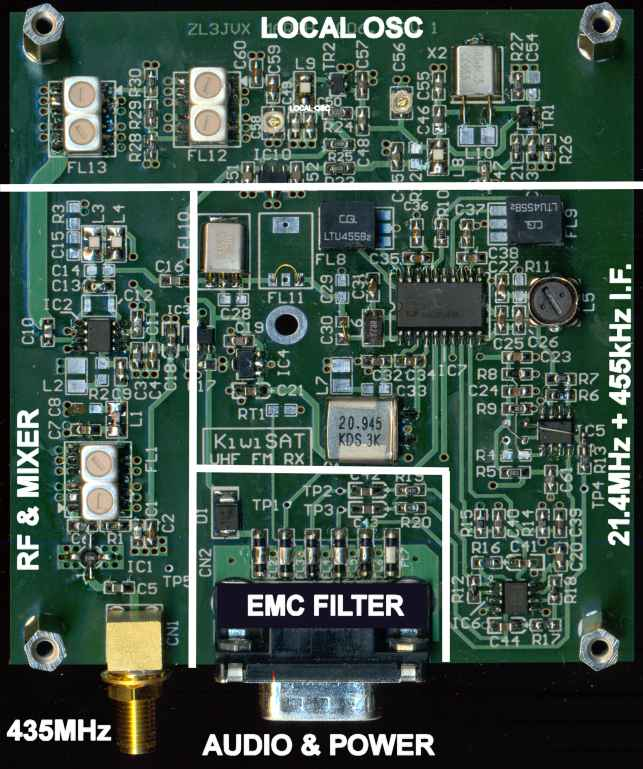
FM_Receivers/UHF FM RX Pictures/0 - UHF FM RX.jpg
