AMSAT-ZL/KiwiSAT_Sub-Systems/FM_Receivers/UHF FM RX Pictures/1 - RF and Mixer.jpg

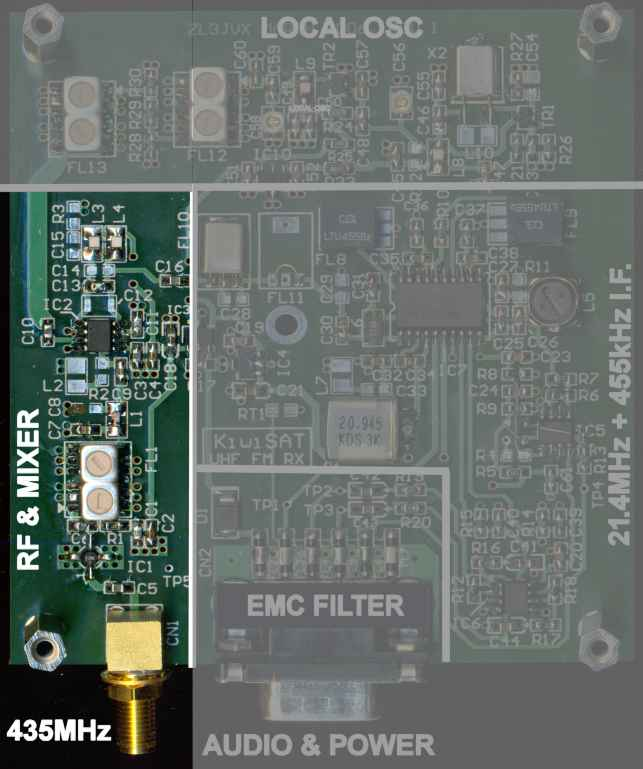
FM_Receivers/UHF FM RX Pictures/1 - RF and Mixer.jpg
