AMSAT-ZL/KiwiSAT_Sub-Systems/FM_Receivers/UHF FM RX Pictures/2 - 21-4MHz and 455kHz IF.jpg

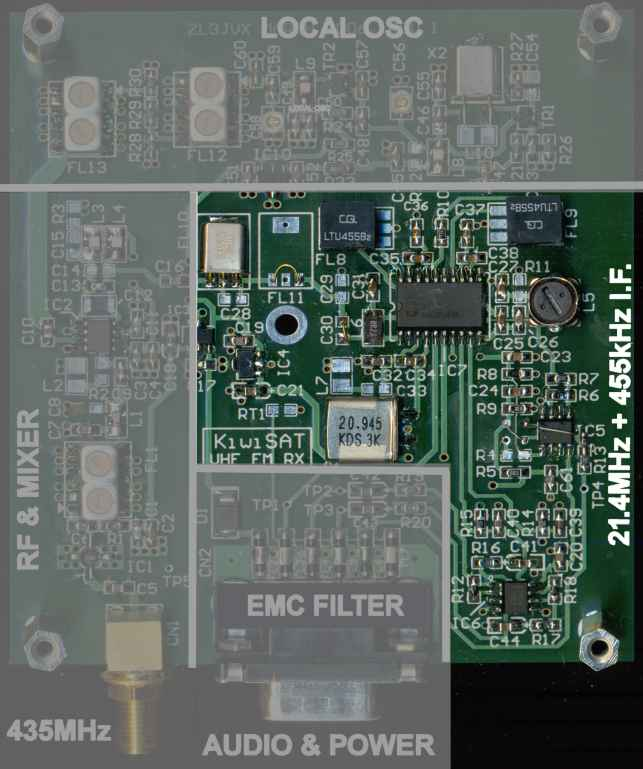
FM_Receivers/UHF FM RX Pictures/2 - 21-4MHz and 455kHz IF.jpg
