AMSAT-ZL/KiwiSAT_Sub-Systems/FM_Receivers/UHF FM RX Pictures/4 - EMC Filters.jpg

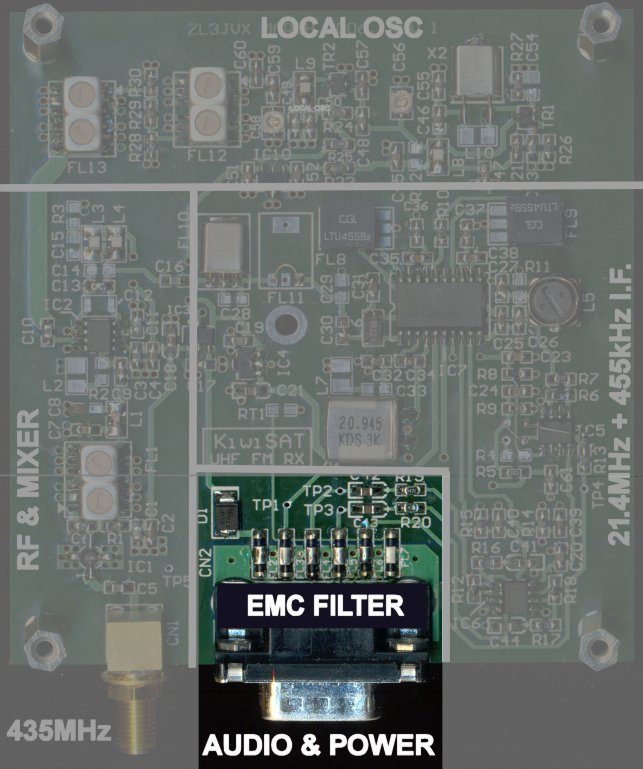
FM_Receivers/UHF FM RX Pictures/4 - EMC Filters.jpg
