AMSAT-ZL/KiwiSAT_Sub-Systems/GPS/DSCF2909.JPG

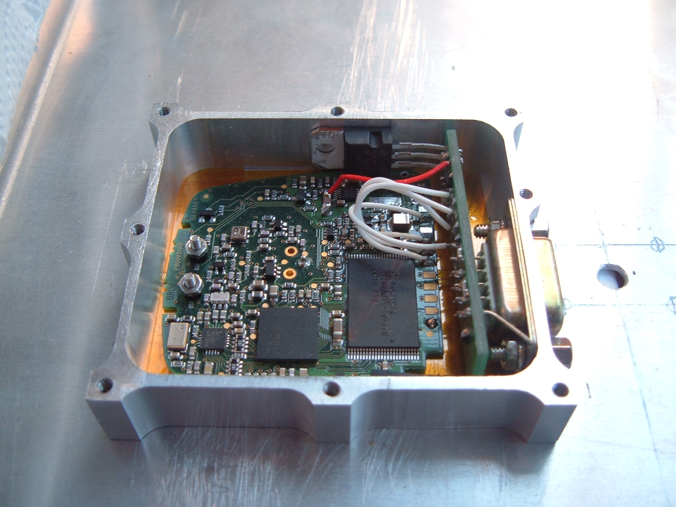
GPS/DSCF2909.JPG
