AMSAT-ZL/KiwiSAT_Sub-Systems/GPS/KiwiSAT - GPS Ant3.JPG

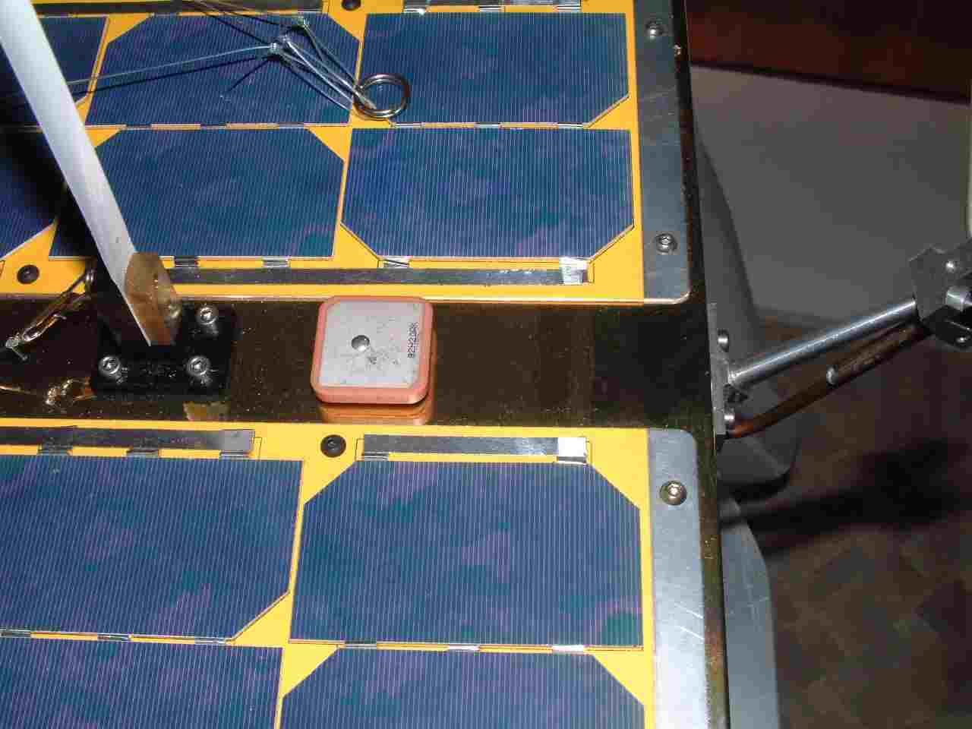
GPS/KiwiSAT - GPS Ant3.JPG
