AMSAT-ZL/KiwiSAT_Sub-Systems/IHU/FEC_Encoder/FEC V6 25Sept07.gif

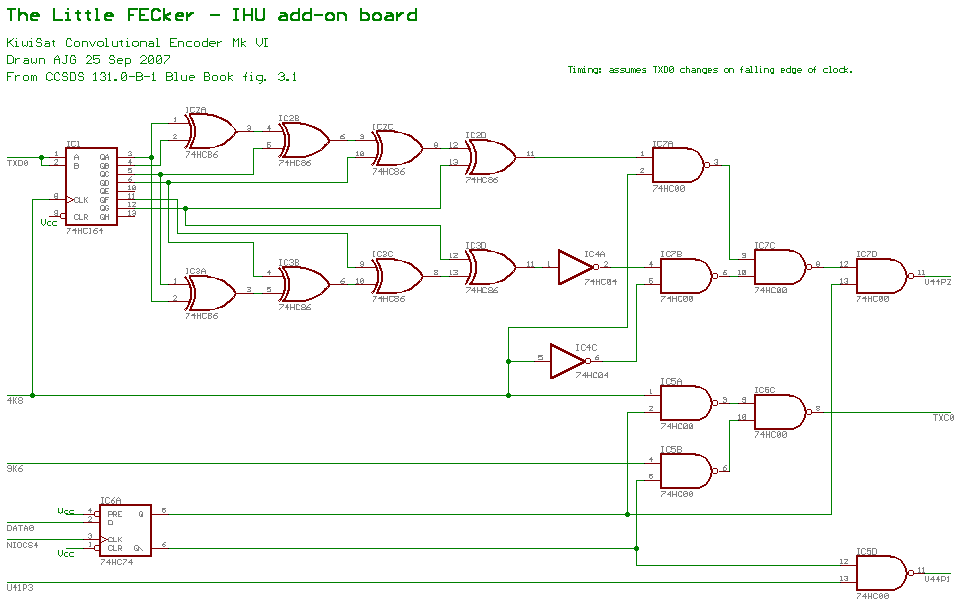
IHU/FEC_Encoder/FEC V6 25Sept07.gif
