AMSAT-ZL/KiwiSAT_Sub-Systems/IHU/FPGA/mem_wr_rd_corrected.JPG

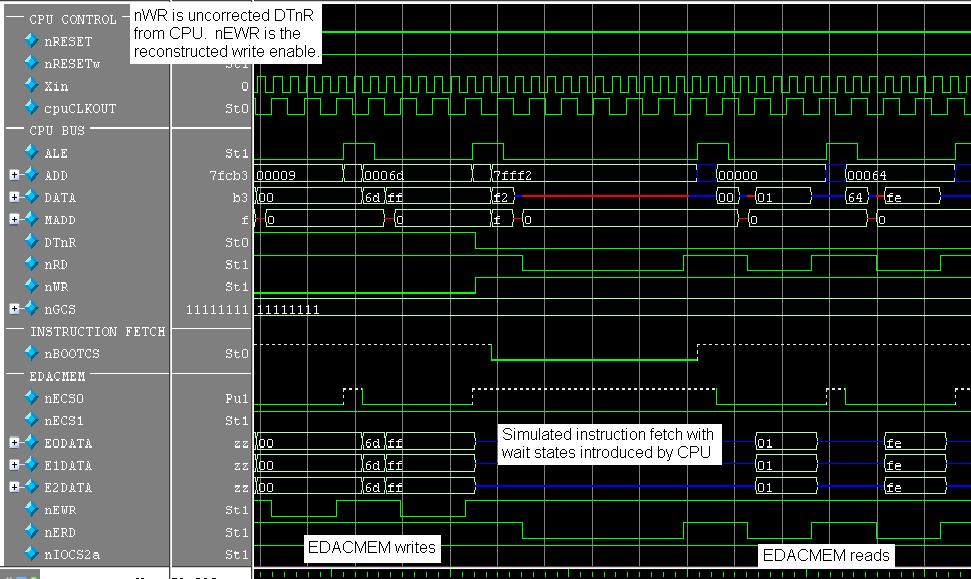
IHU/FPGA/mem_wr_rd_corrected.JPG
