AMSAT-ZL/KiwiSAT_Sub-Systems/IHU/Rev2/IHU1.jpg

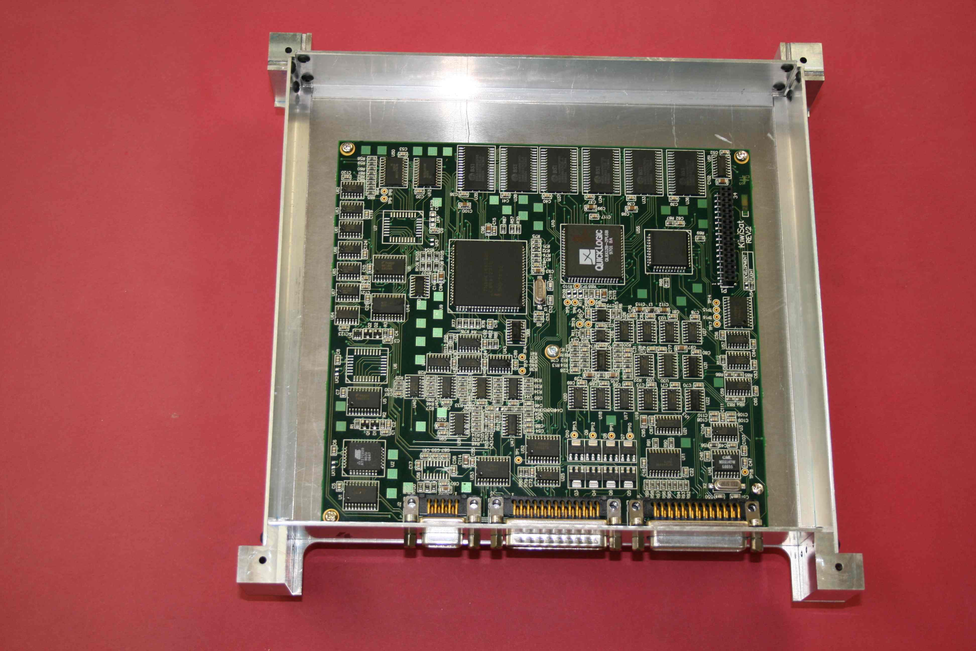
IHU/Rev2/IHU1.jpg
