AMSAT-ZL/KiwiSAT_Sub-Systems/IHU/Rev2/IHU2.jpg

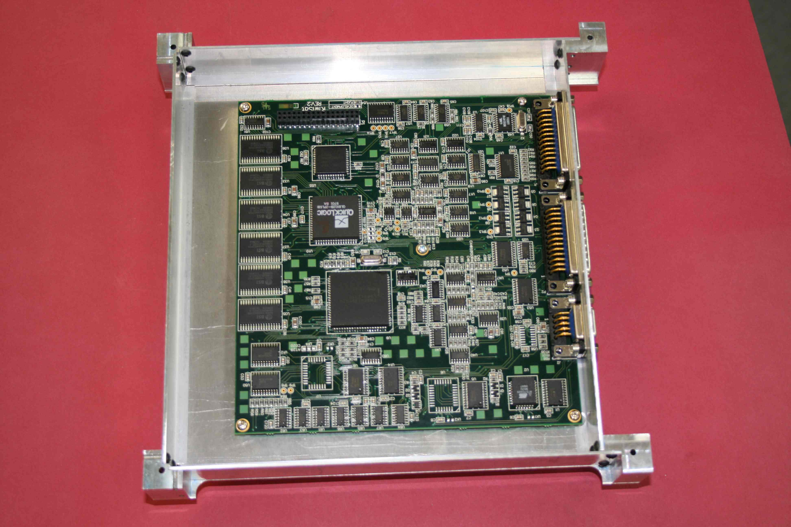
IHU/Rev2/IHU2.jpg
