AMSAT-ZL/KiwiSAT_Sub-Systems/IHU/Rev2/IHU_SCH_page11.bmp

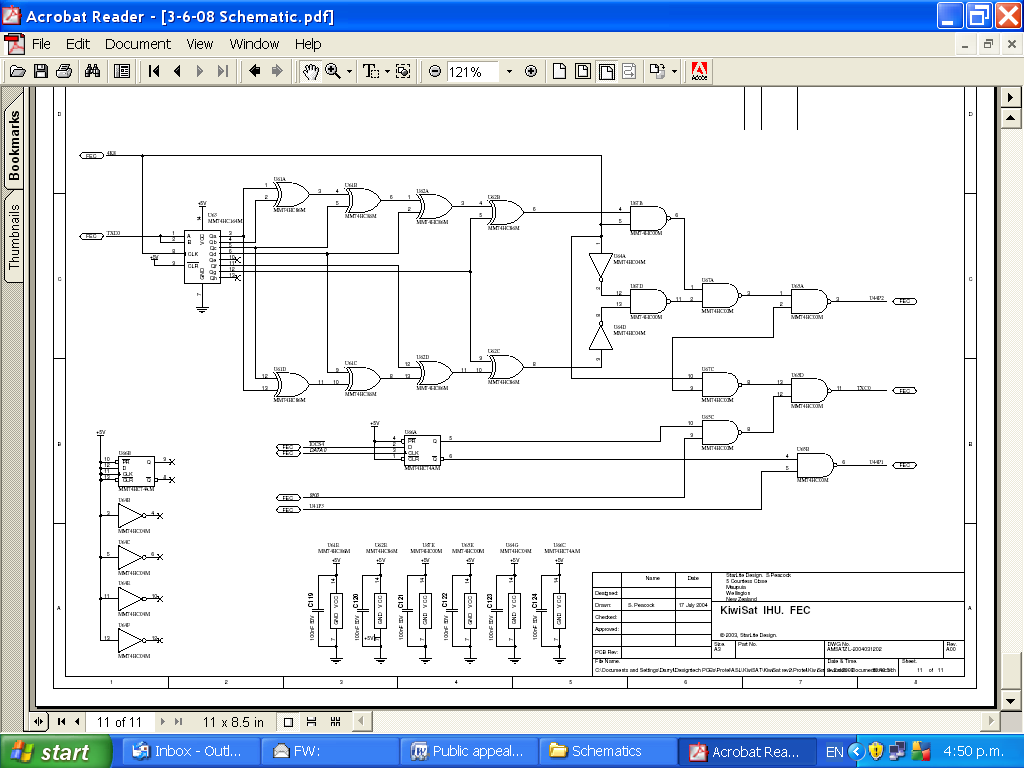
IHU/Rev2/IHU_SCH_page11.bmp
