AMSAT-ZL/KiwiSAT_Sub-Systems/IHU/Rev2/IMG_0348.JPG

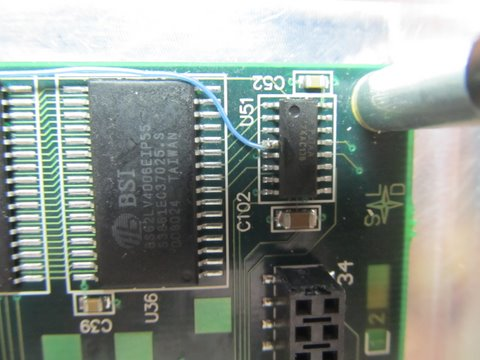
IHU/Rev2/IMG_0348.JPG
