AMSAT-ZL/KiwiSAT_Sub-Systems/IHU/Rev2/IMG_0351.JPG

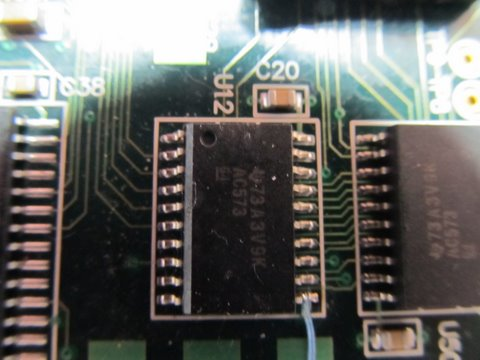
IHU/Rev2/IMG_0351.JPG
