AMSAT-ZL/KiwiSAT_Sub-Systems/IHU/Rev2/KiwiSAT - Mk 2  IHU DB9.jpg

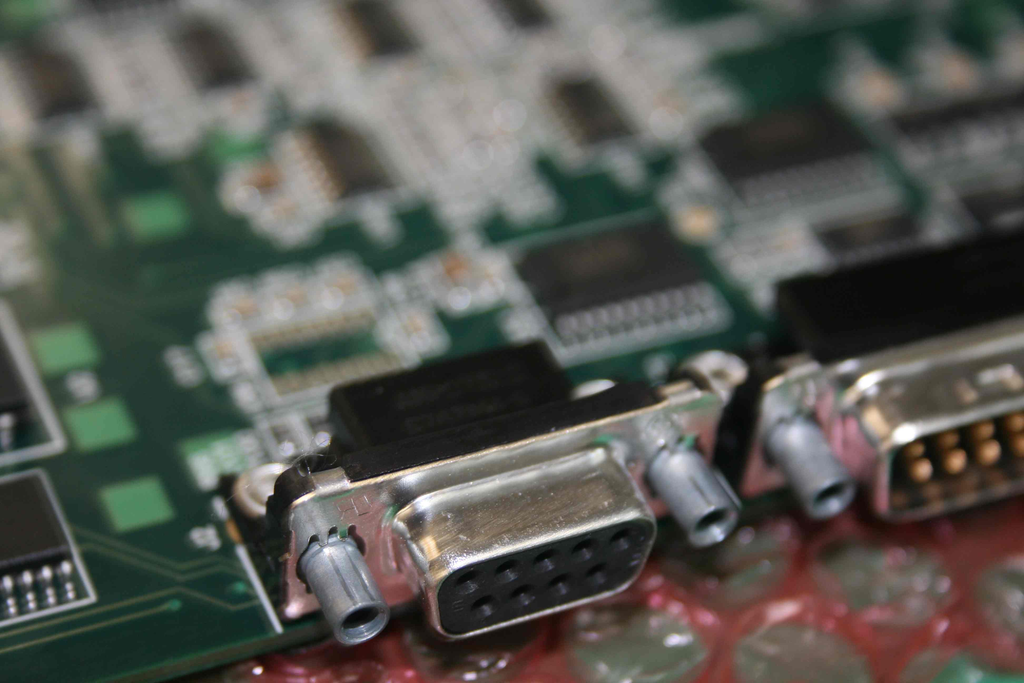
IHU/Rev2/KiwiSAT - Mk 2 IHU DB9.jpg
