AMSAT-ZL/KiwiSAT_Sub-Systems/IHU/Rev2/KiwiSAT - Mk 2  IHU PCB's.jpg

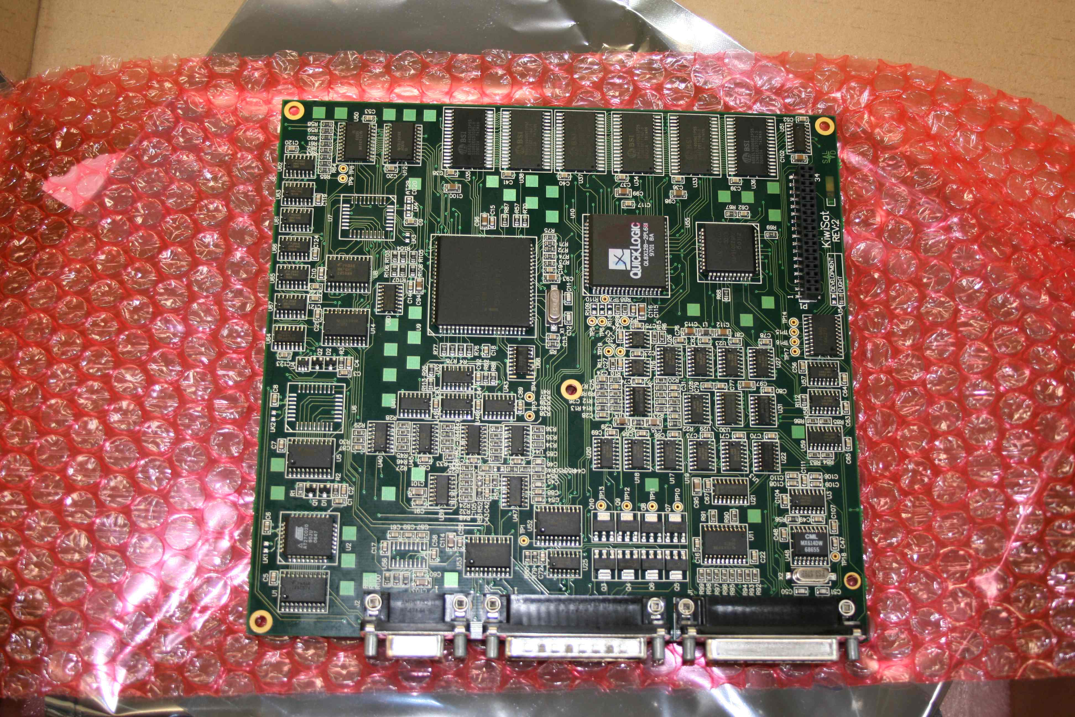
IHU/Rev2/KiwiSAT - Mk 2 IHU PCB's.jpg
