AMSAT-ZL/KiwiSAT_Sub-Systems/IHU/Rev2/Plots/nINTACK_Pullup.JPG

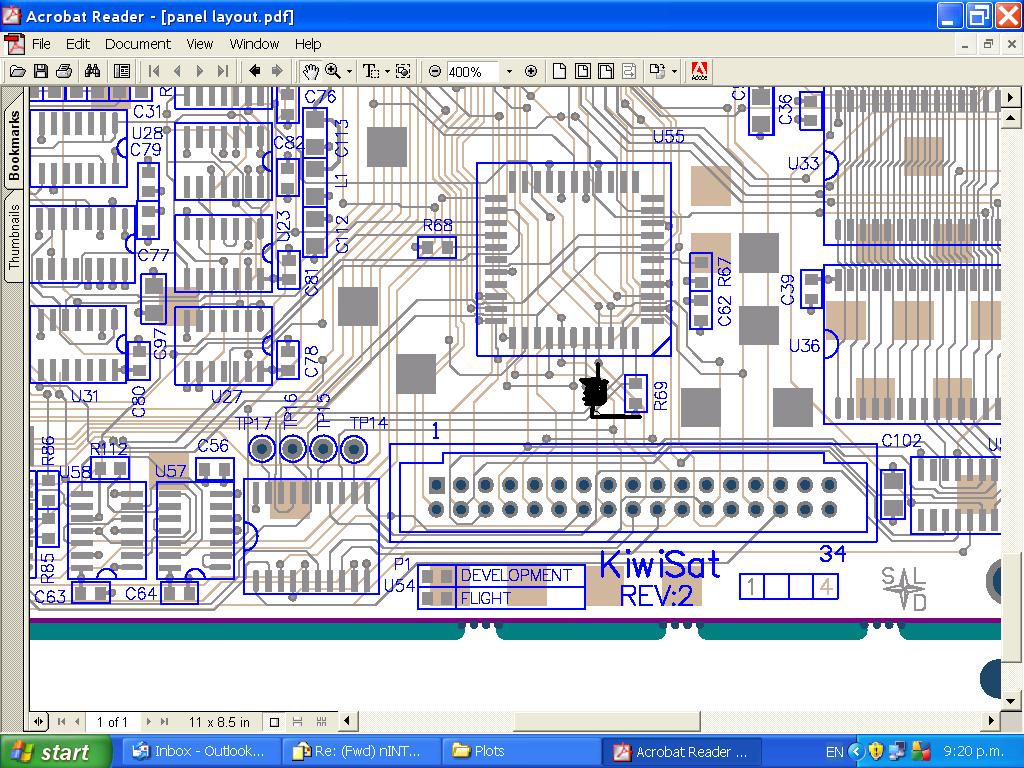
IHU/Rev2/Plots/nINTACK_Pullup.JPG
