AMSAT-ZL/KiwiSAT_Sub-Systems/IHU/Rev2/R479440-01.jpg

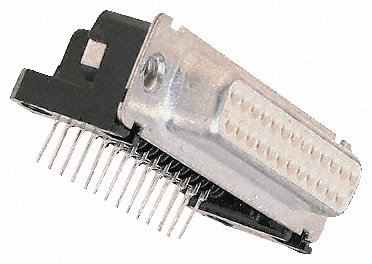
IHU/Rev2/R479440-01.jpg
