AMSAT-ZL/KiwiSAT_Sub-Systems/IHU/Rev2/Willem Eprom AT27C020.bmp

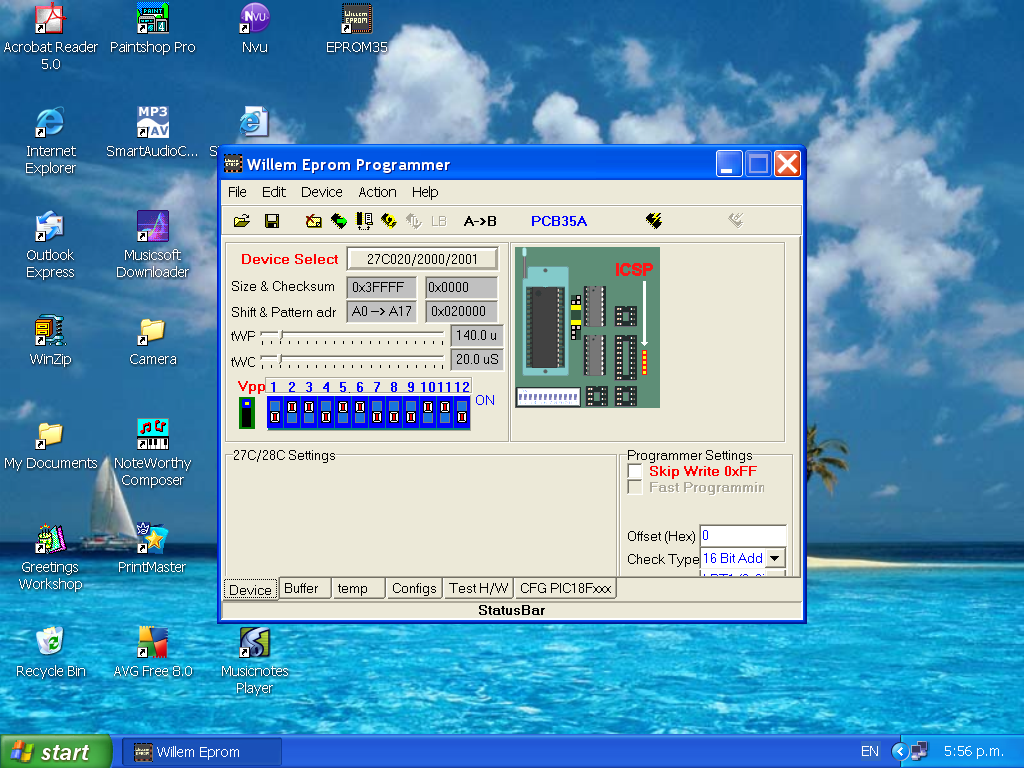
IHU/Rev2/Willem Eprom AT27C020.bmp
