AMSAT-ZL/KiwiSAT_Sub-Systems/Launch Adapter/IMG_2427.JPG

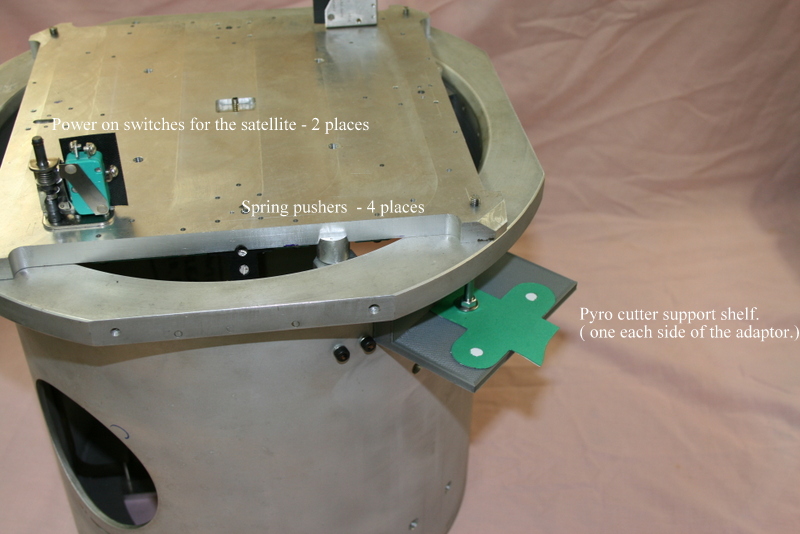
Launch Adapter/IMG_2427.JPG
