AMSAT-ZL/KiwiSAT_Sub-Systems/Launch Adapter/IMG_2428.JPG

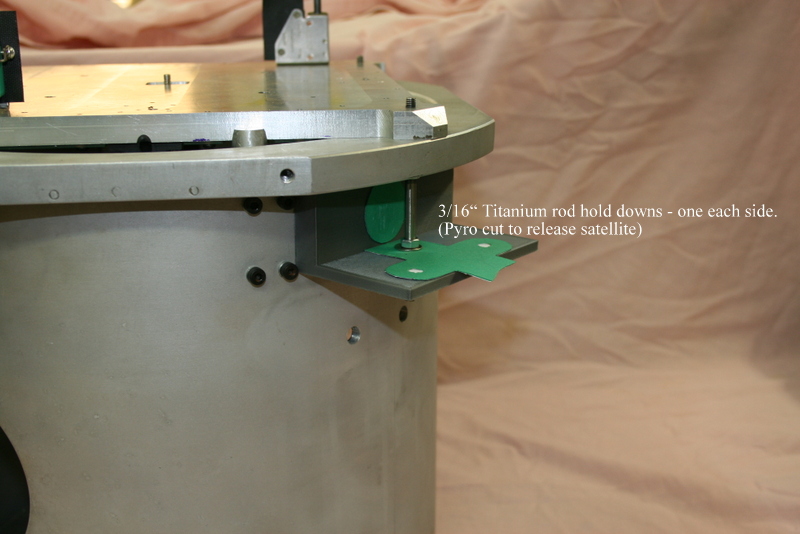
Launch Adapter/IMG_2428.JPG
