AMSAT-ZL/KiwiSAT_Sub-Systems/Launch Adapter/IMG_2430.JPG

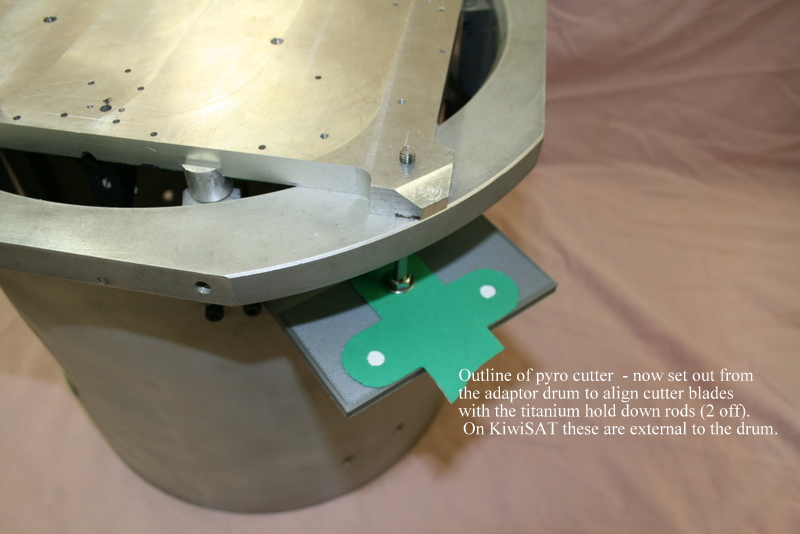
Launch Adapter/IMG_2430.JPG
