AMSAT-ZL/KiwiSAT_Sub-Systems/Launch Adapter/Launch Adapt. release1.jpg

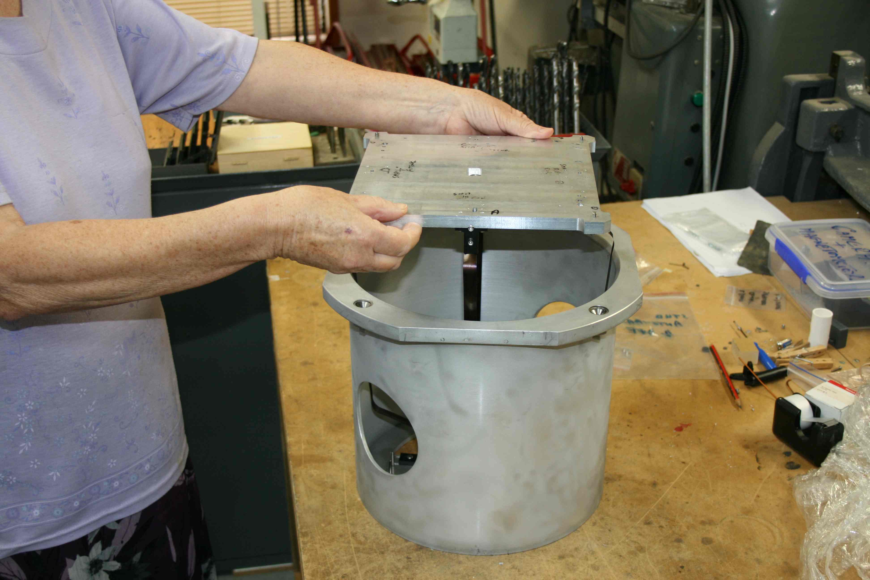
Launch Adapter/Launch Adapt. release1.jpg
