AMSAT-ZL/KiwiSAT_Sub-Systems/Launch Adapter/Launch adaptor 1.jpg

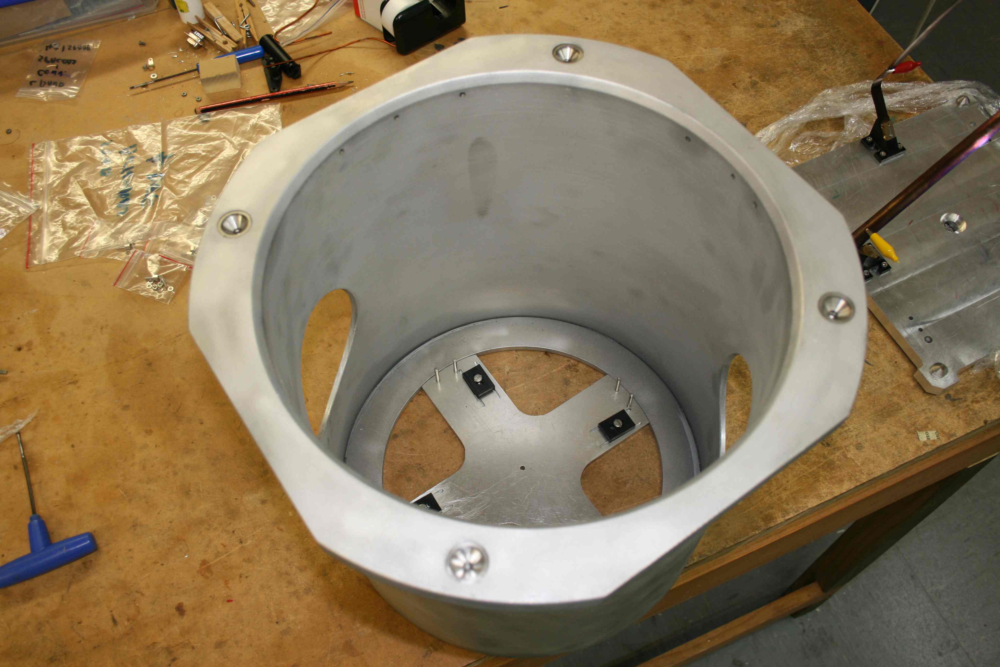
Launch Adapter/Launch adaptor 1.jpg
