AMSAT-ZL/KiwiSAT_Sub-Systems/Launch Adapter/Launch adaptor 2.jpg

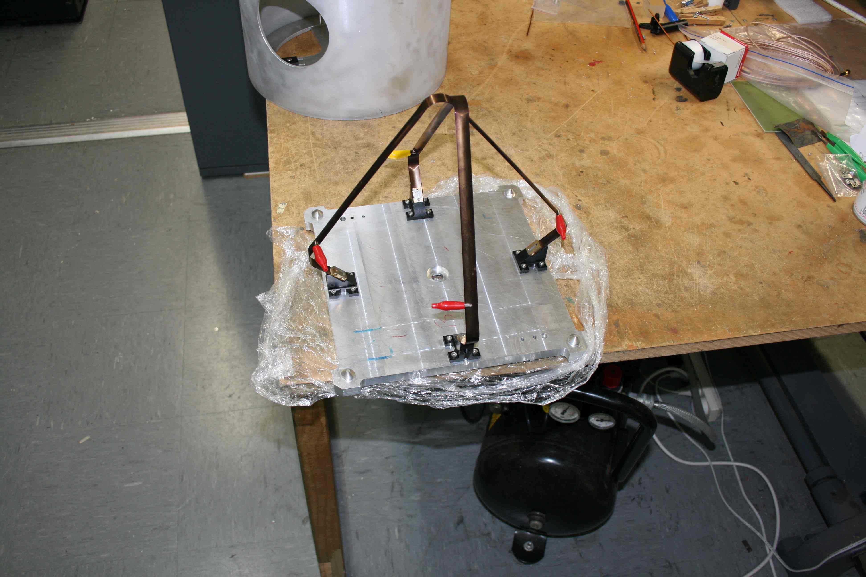
Launch Adapter/Launch adaptor 2.jpg
