AMSAT-ZL/KiwiSAT_Sub-Systems/Launch Adapter/Launch adaptor 3.jpg

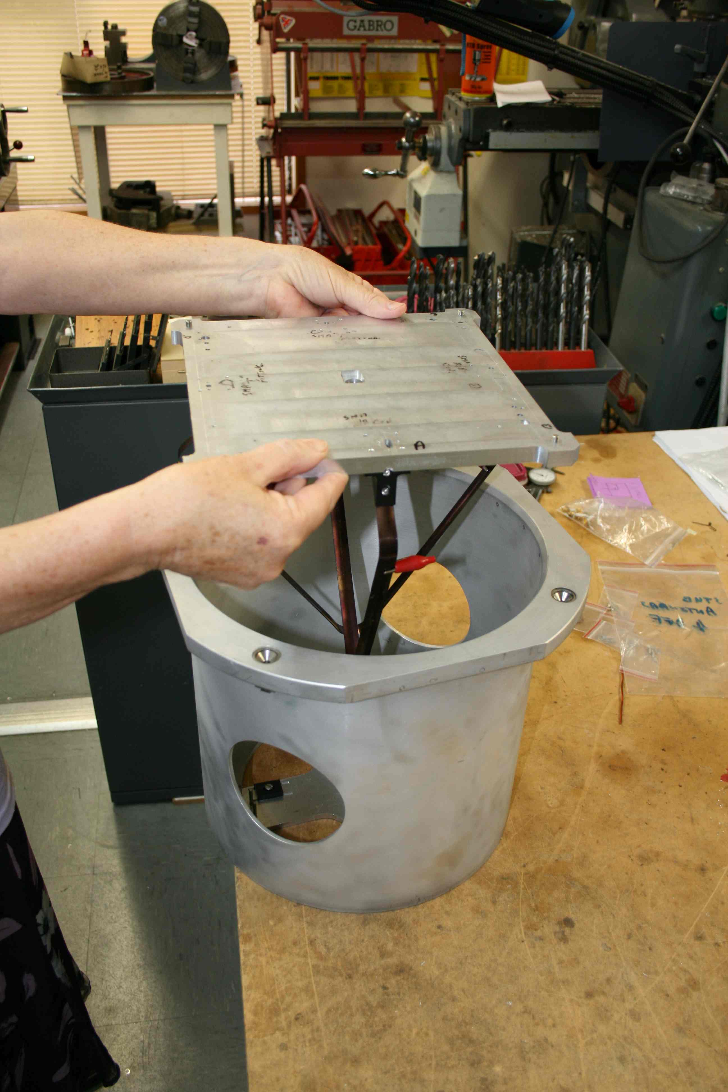
Launch Adapter/Launch adaptor 3.jpg
