AMSAT-ZL/KiwiSAT_Sub-Systems/Launch Adapter/Launch adaptor 4.jpg

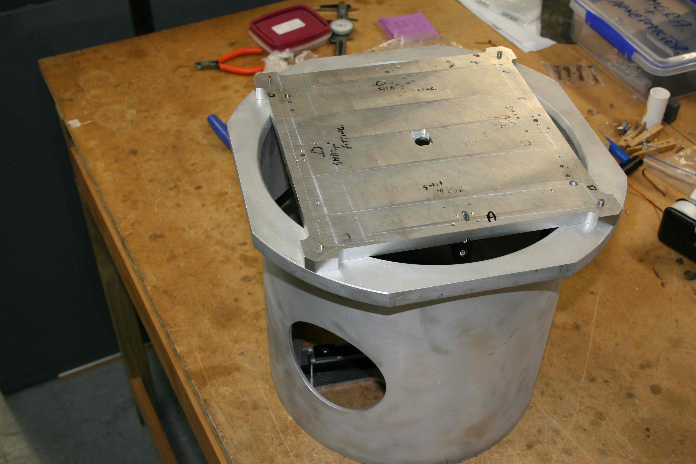
Launch Adapter/Launch adaptor 4.jpg
