AMSAT-ZL/KiwiSAT_Sub-Systems/Launch Adapter/Launch adaptor 5.jpg

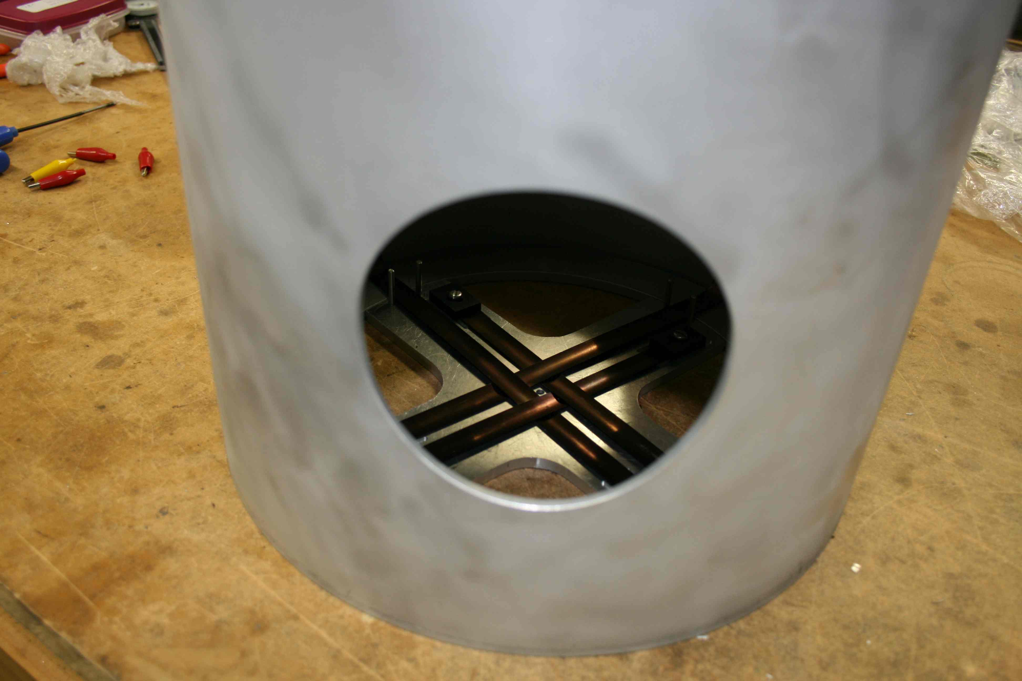
Launch Adapter/Launch adaptor 5.jpg
