AMSAT-ZL/KiwiSAT_Sub-Systems/Launch Adapter/Launch adaptor release2.jpg

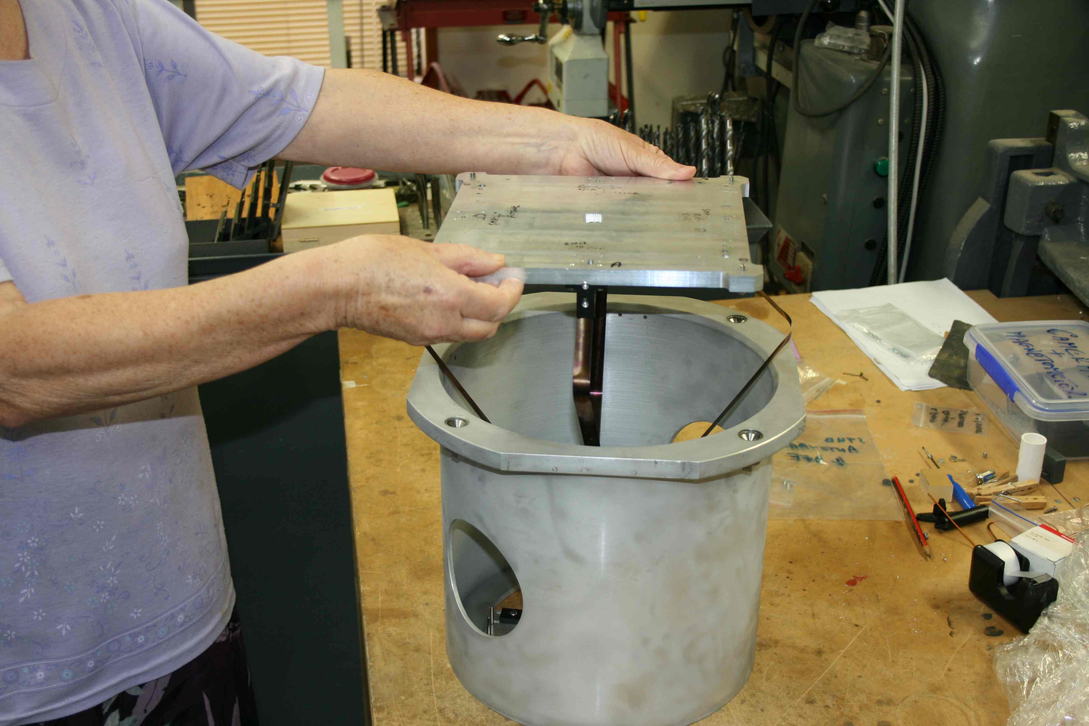
Launch Adapter/Launch adaptor release2.jpg
