AMSAT-ZL/KiwiSAT_Sub-Systems/Launch Adapter/Launch adaptor release3.jpg

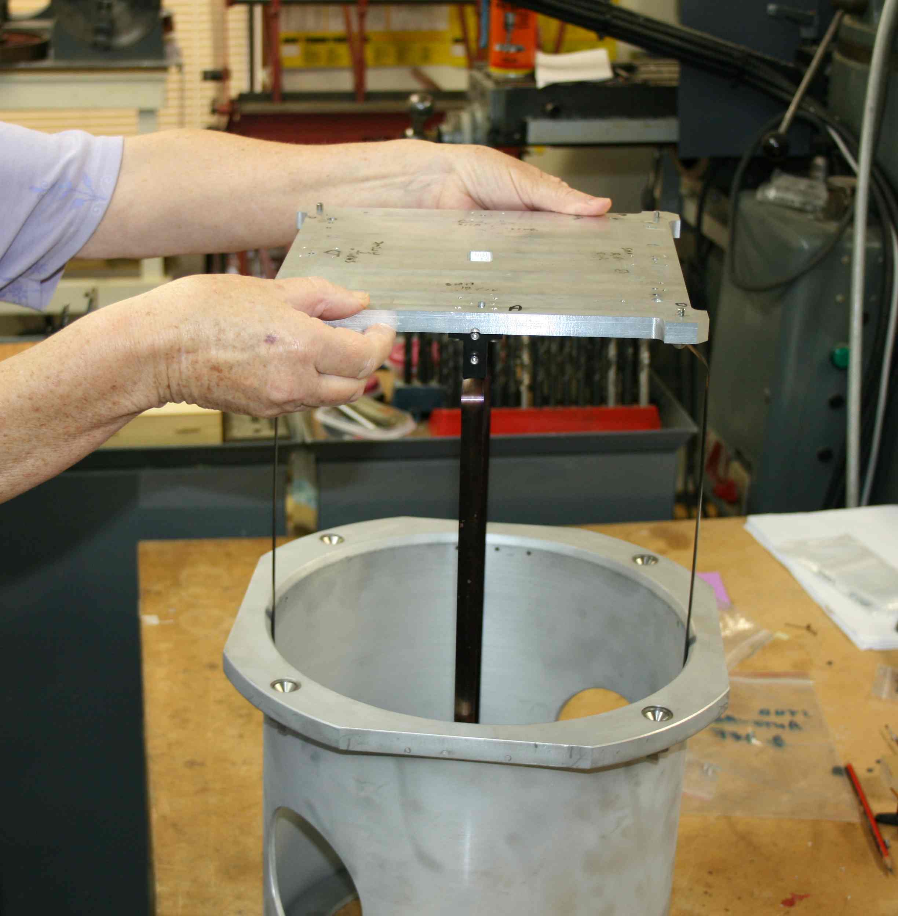
Launch Adapter/Launch adaptor release3.jpg
