AMSAT-ZL/KiwiSAT_Sub-Systems/Launch Adapter/Launch adaptor release4.jpg

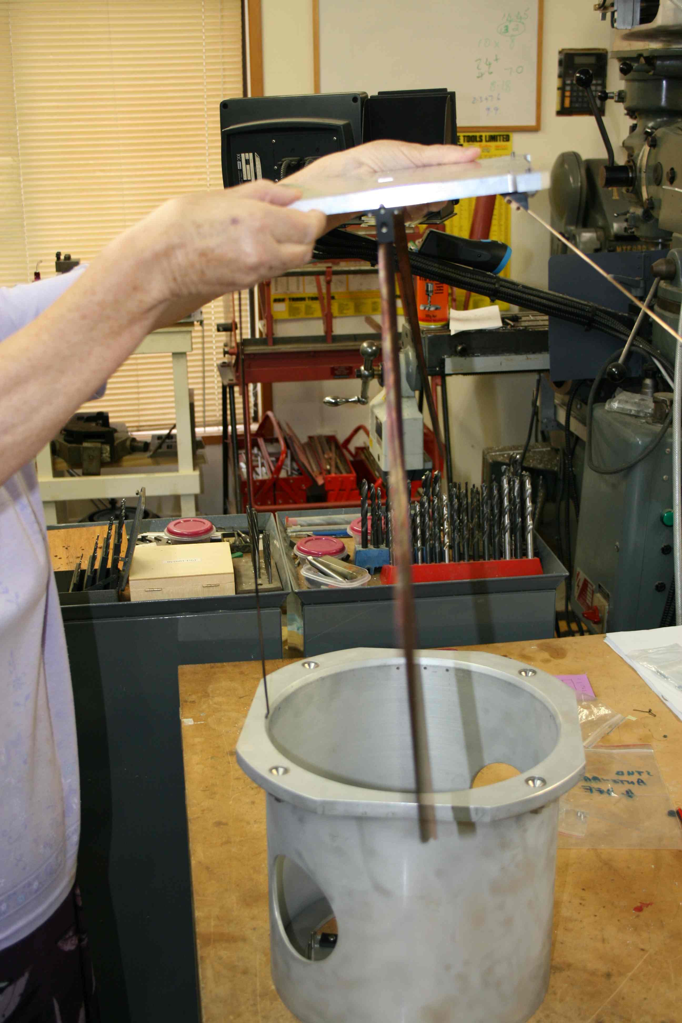
Launch Adapter/Launch adaptor release4.jpg
