AMSAT-ZL/KiwiSAT_Sub-Systems/Magnetometer/Magnetometer_V10.gif

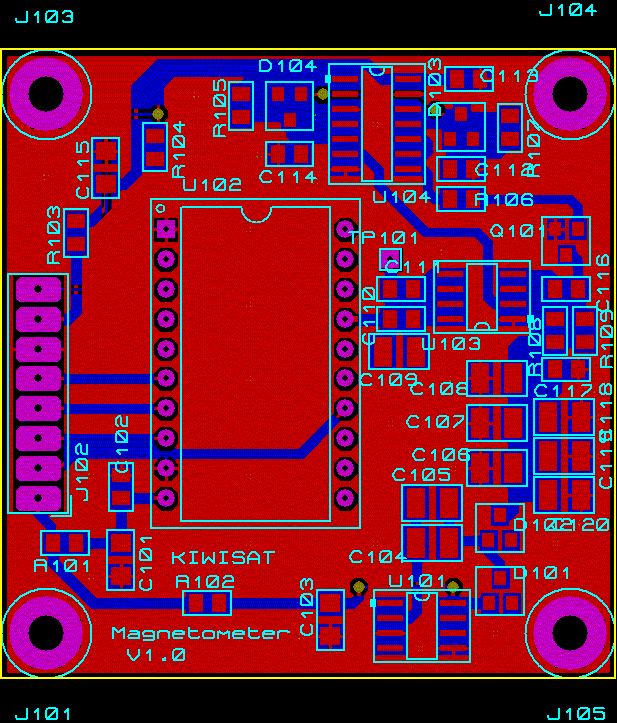
Magnetometer/Magnetometer_V10.gif
