AMSAT-ZL/KiwiSAT_Sub-Systems/Mechanical/Tray - Attic Layout (under)_Model.jpg

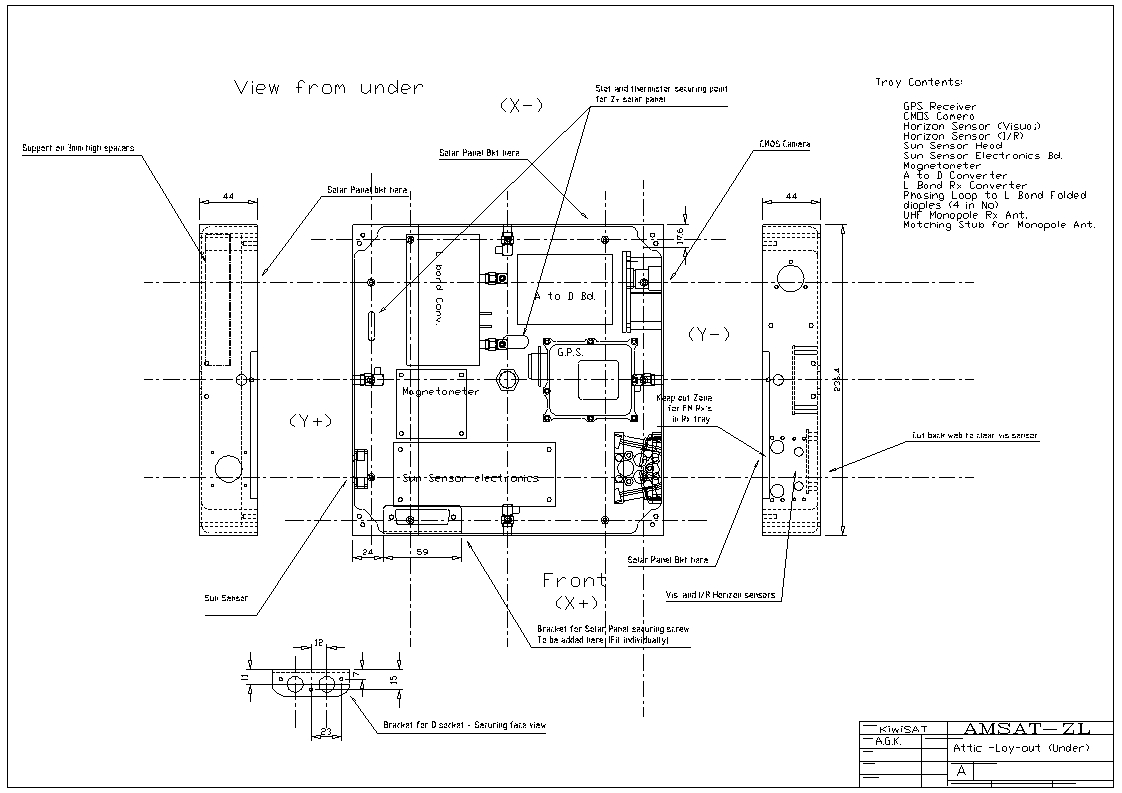
Mechanical/Tray - Attic Layout (under)_Model.jpg
