AMSAT-ZL/KiwiSAT_Sub-Systems/Mechanical/Tray - Attic Layout (under)_Model_2.jpg

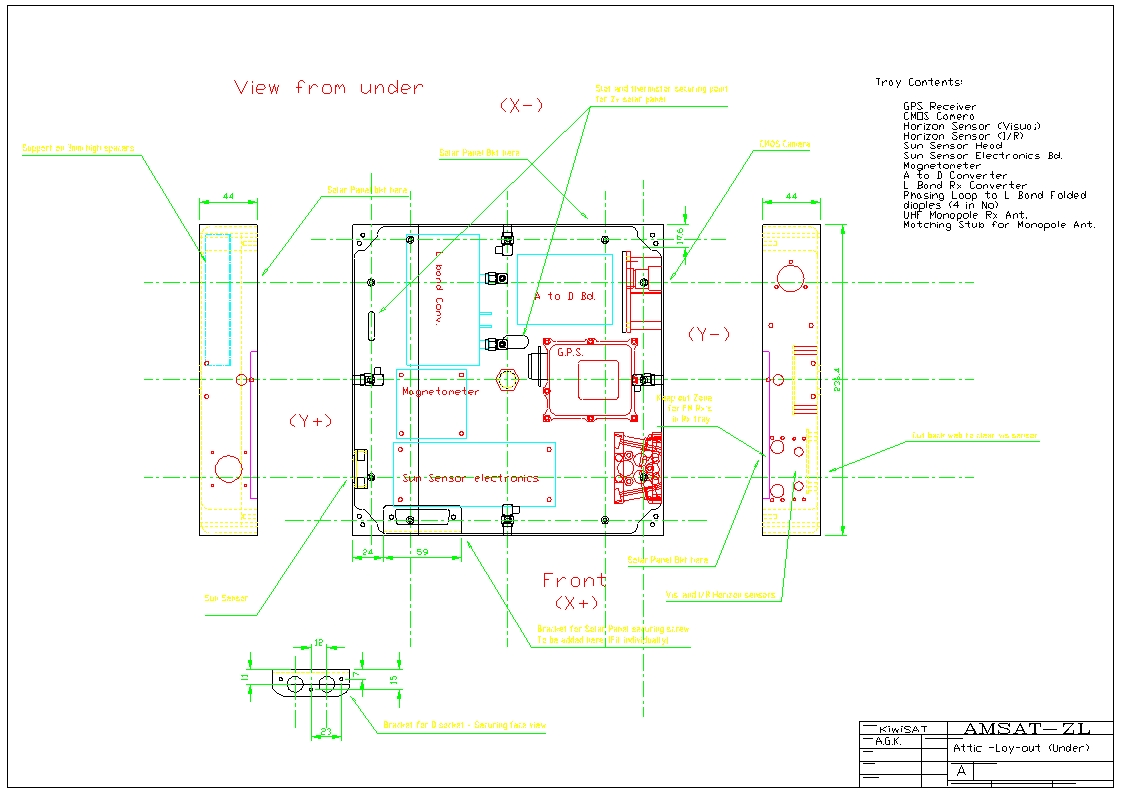
Mechanical/Tray - Attic Layout (under)_Model_2.jpg
