AMSAT-ZL/KiwiSAT_Sub-Systems/Mechanical/Tray - Battery Layout_Model.jpg

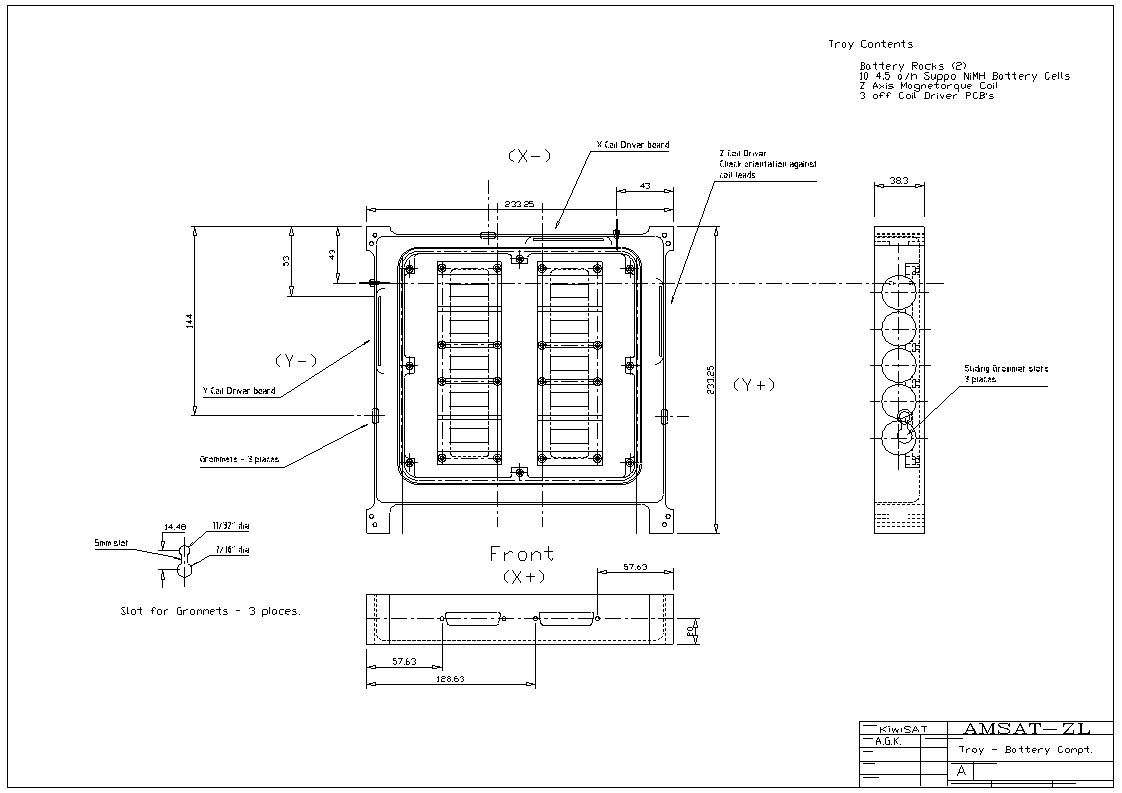
Mechanical/Tray - Battery Layout_Model.jpg
