AMSAT-ZL/KiwiSAT_Sub-Systems/Mechanical/Tray - BCR Layout_Model.jpg

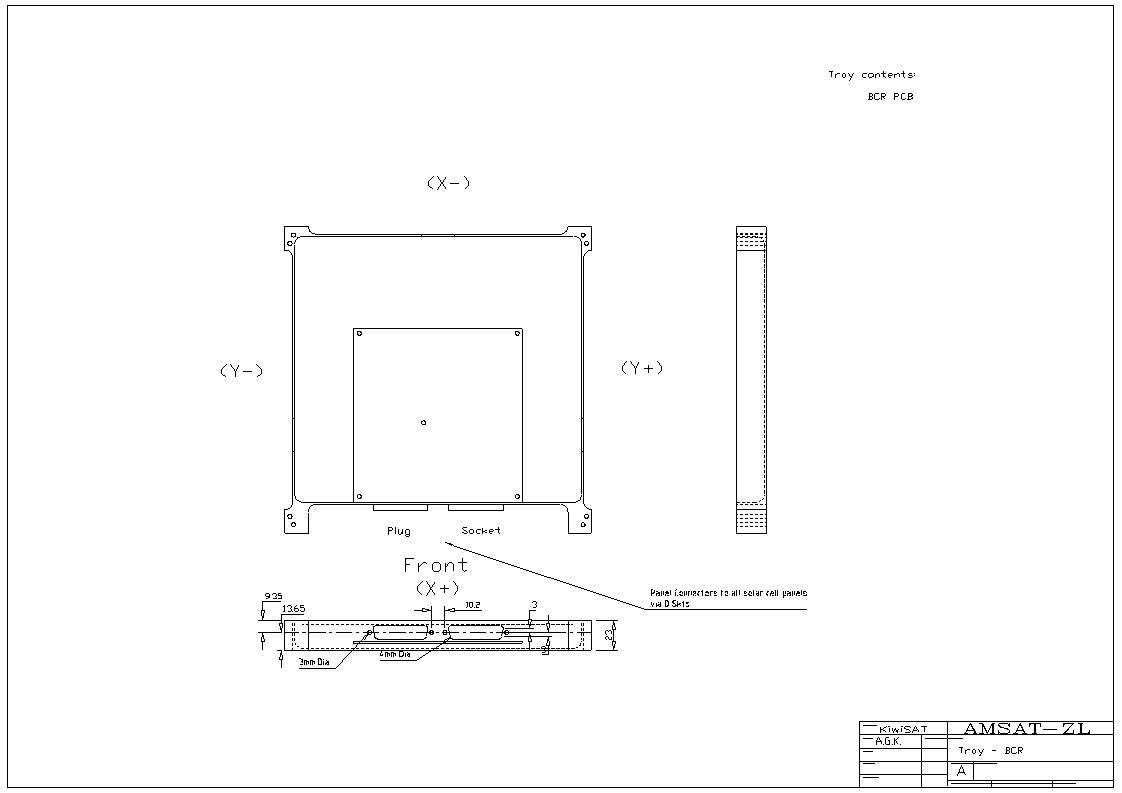
Mechanical/Tray - BCR Layout_Model.jpg
