AMSAT-ZL/KiwiSAT_Sub-Systems/Mechanical/Tray - IHU Layout_Model.jpg

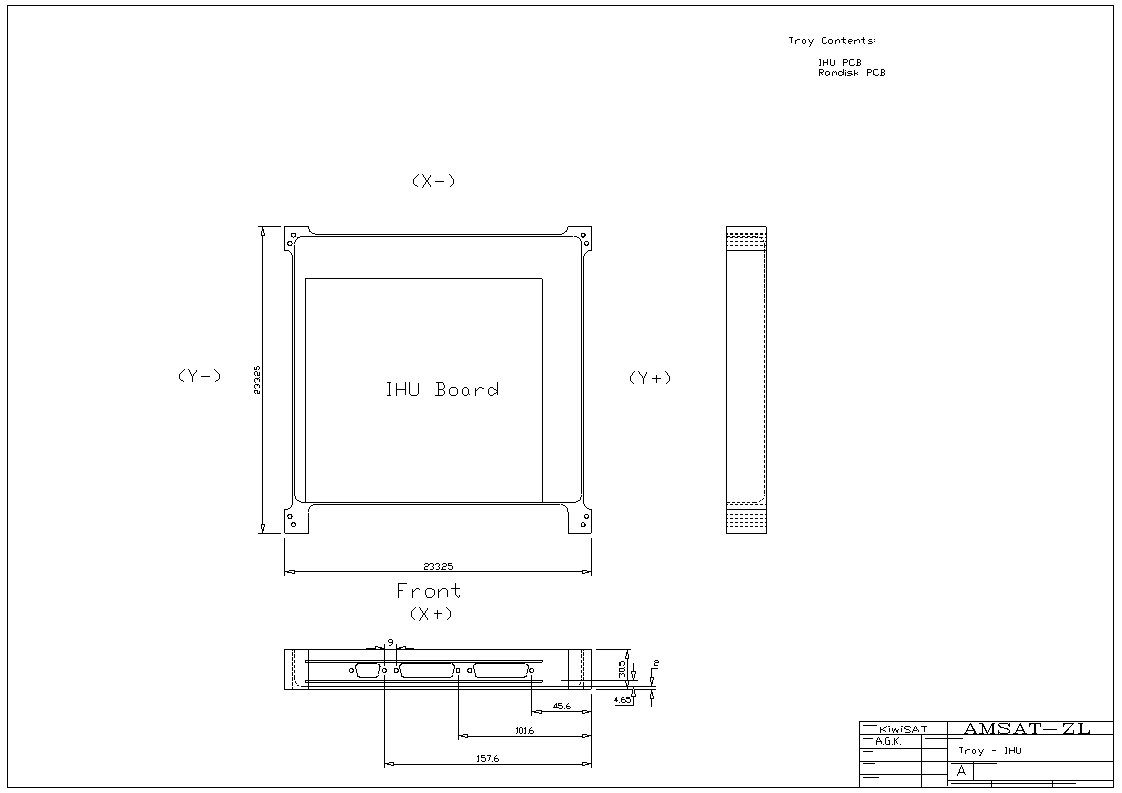
Mechanical/Tray - IHU Layout_Model.jpg
