AMSAT-ZL/KiwiSAT_Sub-Systems/Mechanical/Tray - IHU Layout_Model_3.jpg

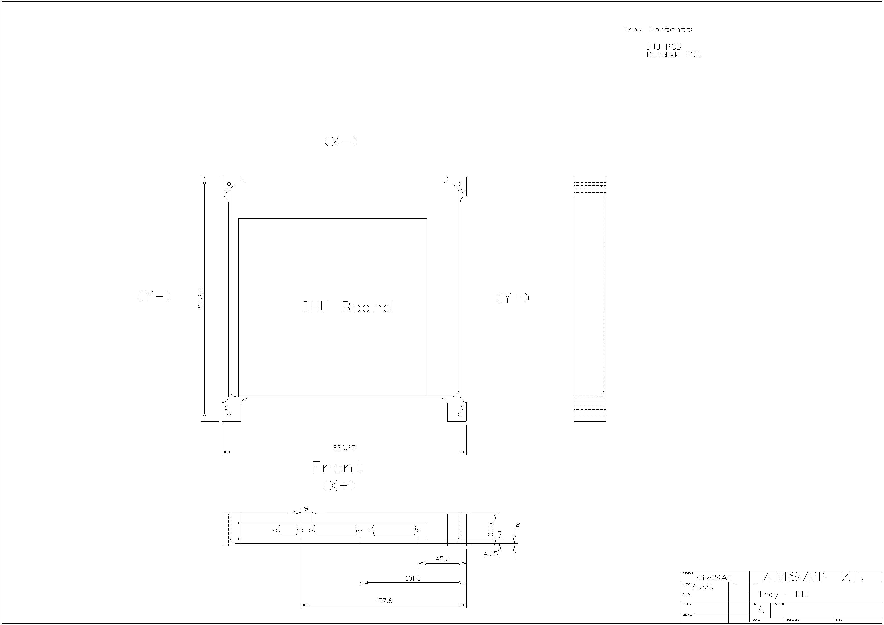
Mechanical/Tray - IHU Layout_Model_3.jpg
