AMSAT-ZL/KiwiSAT_Sub-Systems/Mechanical/Tray - Receivers Layout_Model.jpg

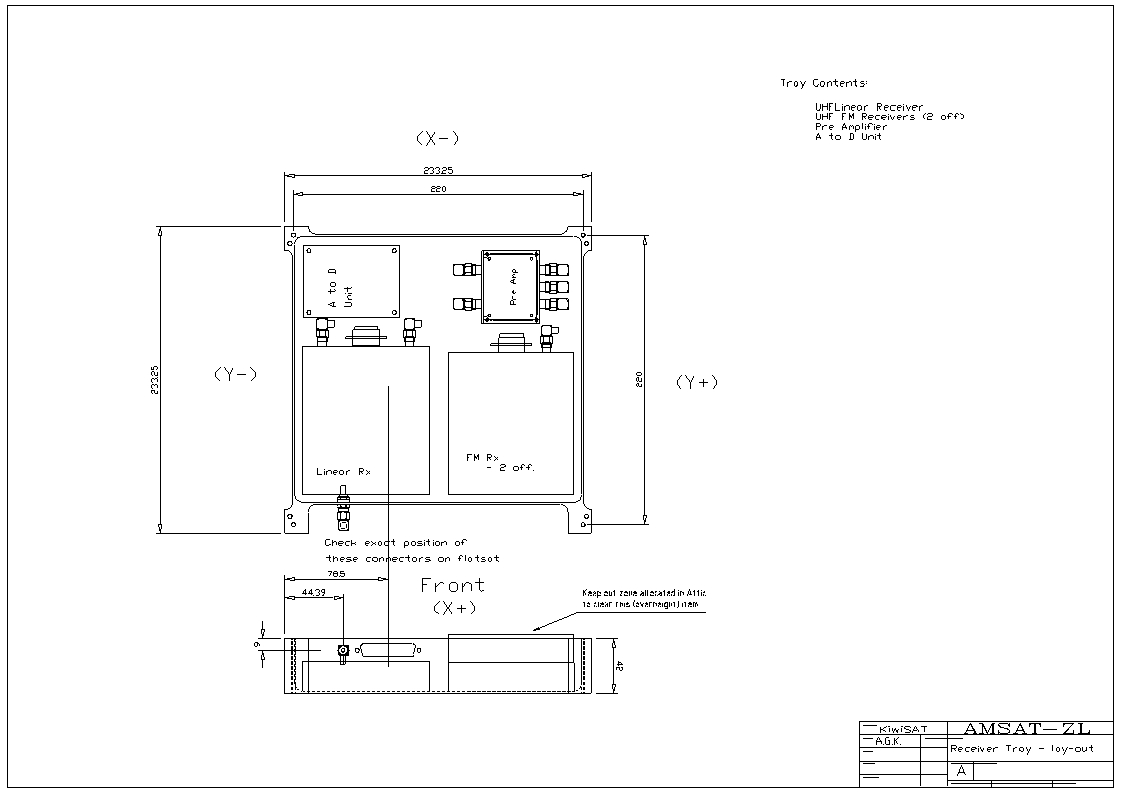
Mechanical/Tray - Receivers Layout_Model.jpg
