AMSAT-ZL/KiwiSAT_Sub-Systems/Mechanical/Tray - Receivers Layout_Model_3.jpg

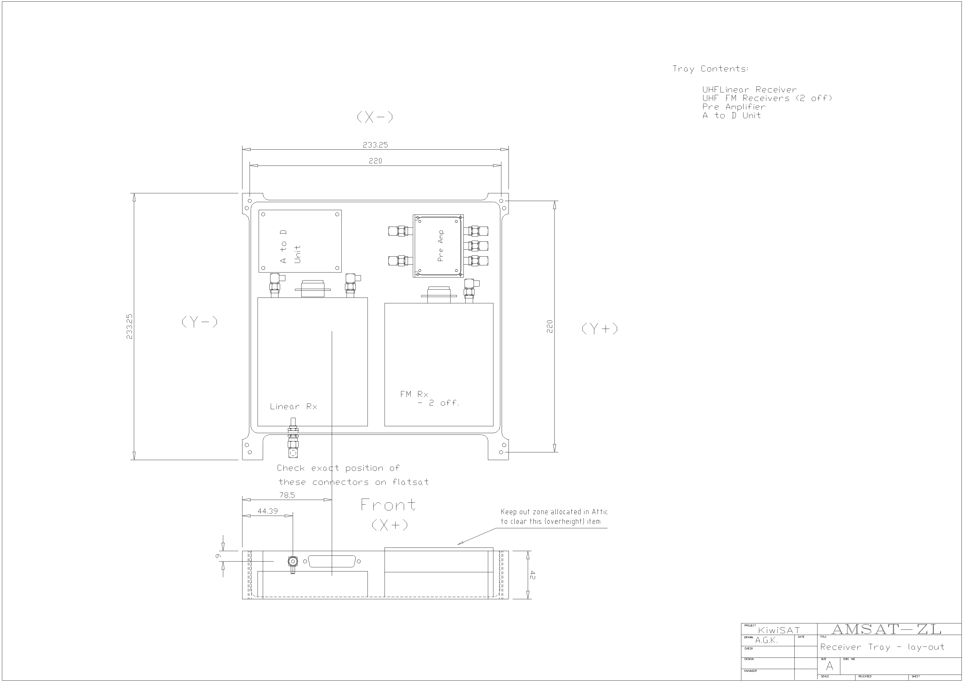
Mechanical/Tray - Receivers Layout_Model_3.jpg
