AMSAT-ZL/KiwiSAT_Sub-Systems/Mechanical/Tray - Transmitter Layout_Model.jpg

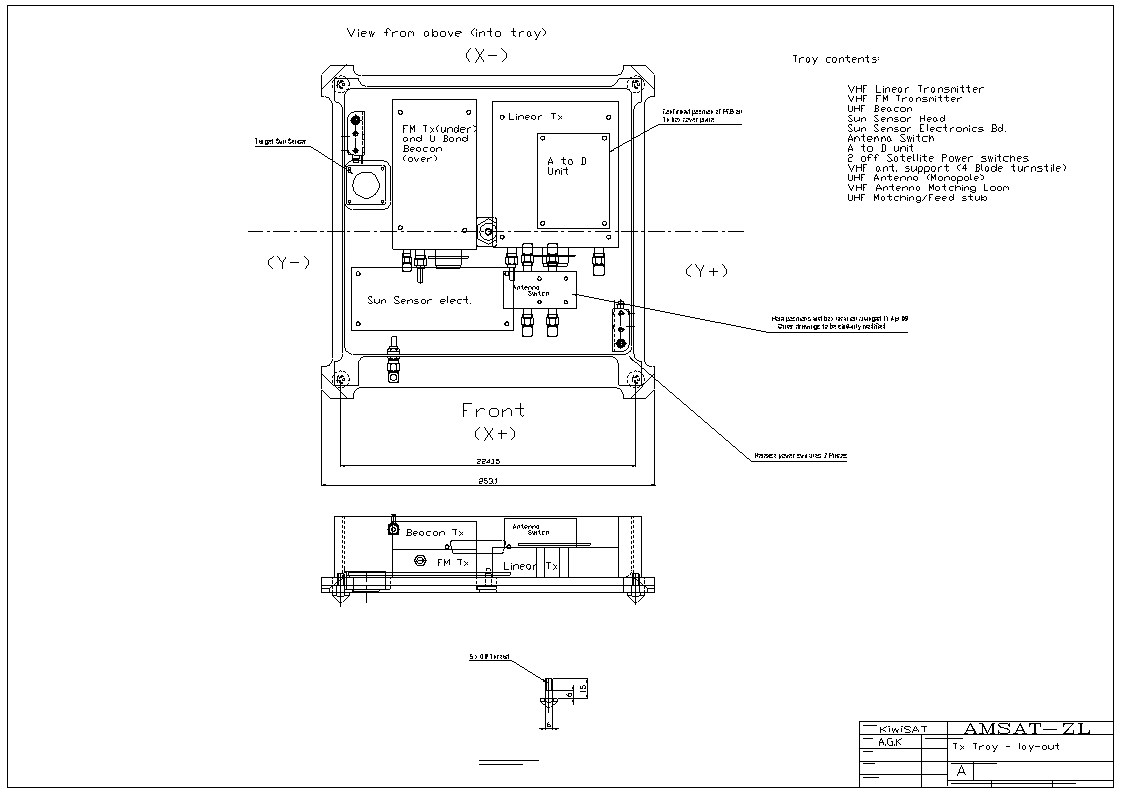
Mechanical/Tray - Transmitter Layout_Model.jpg
