AMSAT-ZL/KiwiSAT_Sub-Systems/Preamp/PreampV3/Preamp + splitter box.jpg

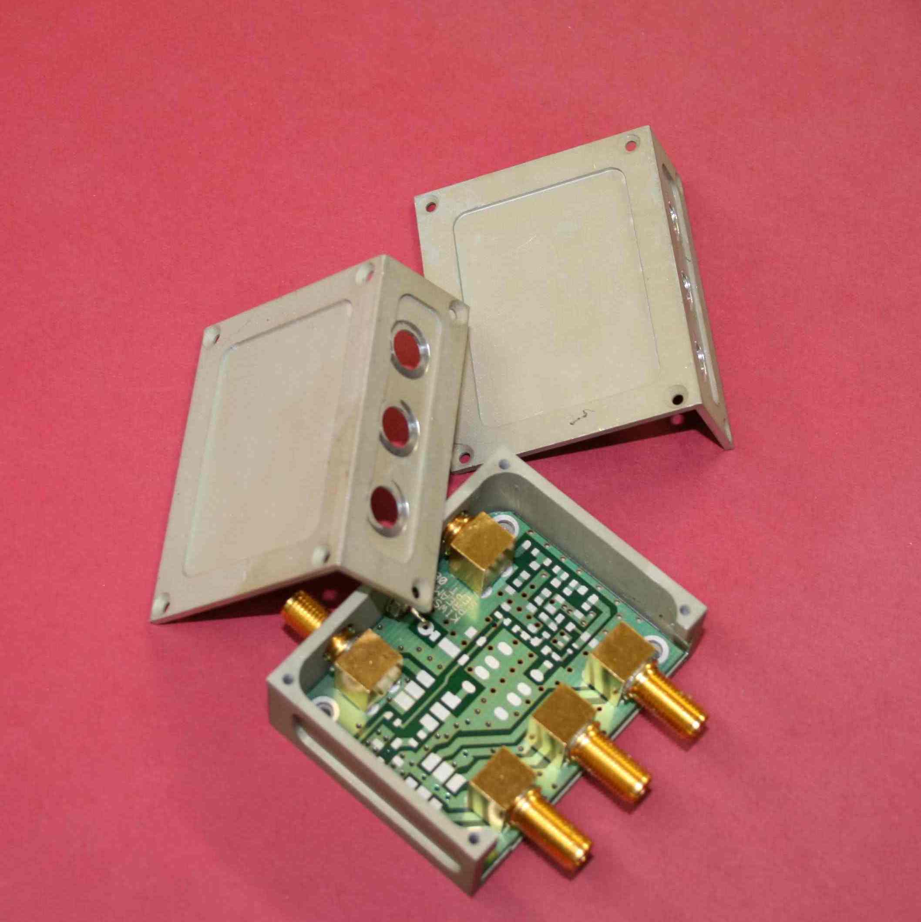
Preamp/PreampV3/Preamp + splitter box.jpg
