AMSAT-ZL/KiwiSAT_Sub-Systems/Preamp/U-Band Preamp.jpg

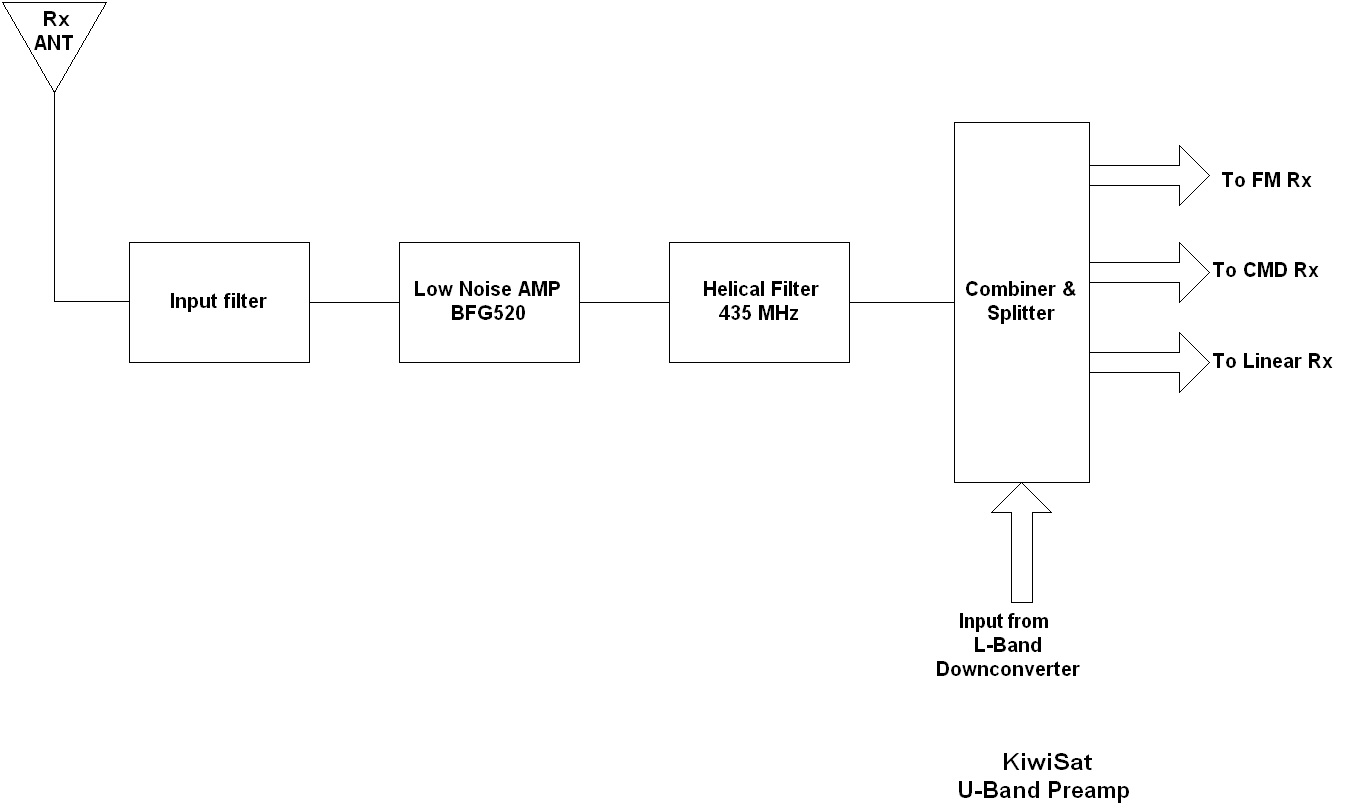
Preamp/U-Band Preamp.jpg
