AMSAT-ZL/KiwiSAT_Sub-Systems/Solar Panels1.jpg

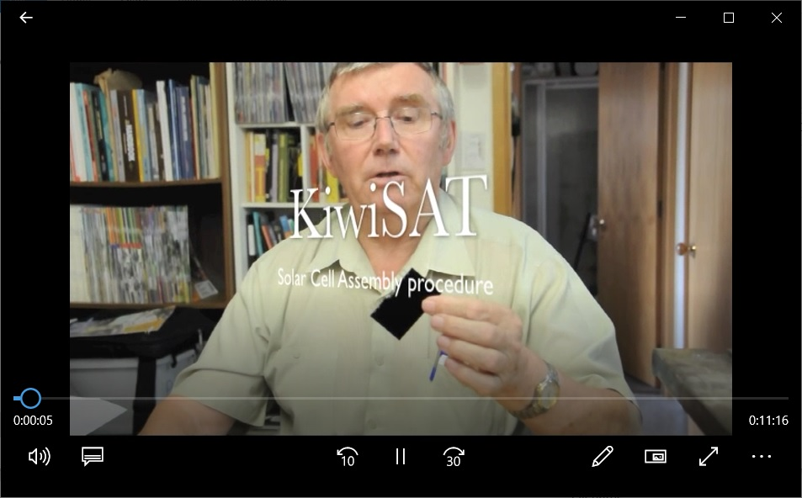
Solar Panels1.jpg
