AMSAT-ZL/KiwiSAT_Sub-Systems/Solar Panels/Adhesive laydown - First trial.jpg

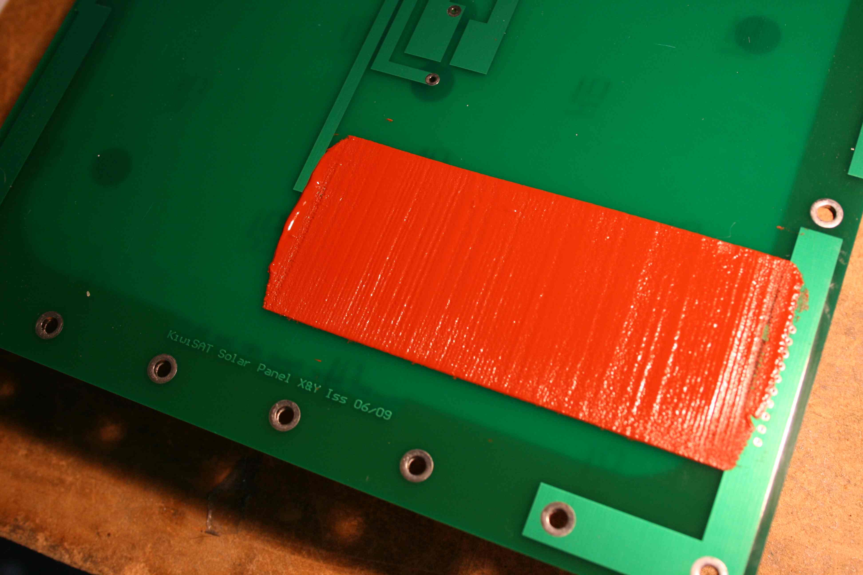
Solar Panels/Adhesive laydown - First trial.jpg
