AMSAT-ZL/KiwiSAT_Sub-Systems/Solar Panels/Cell and Blank.jpg

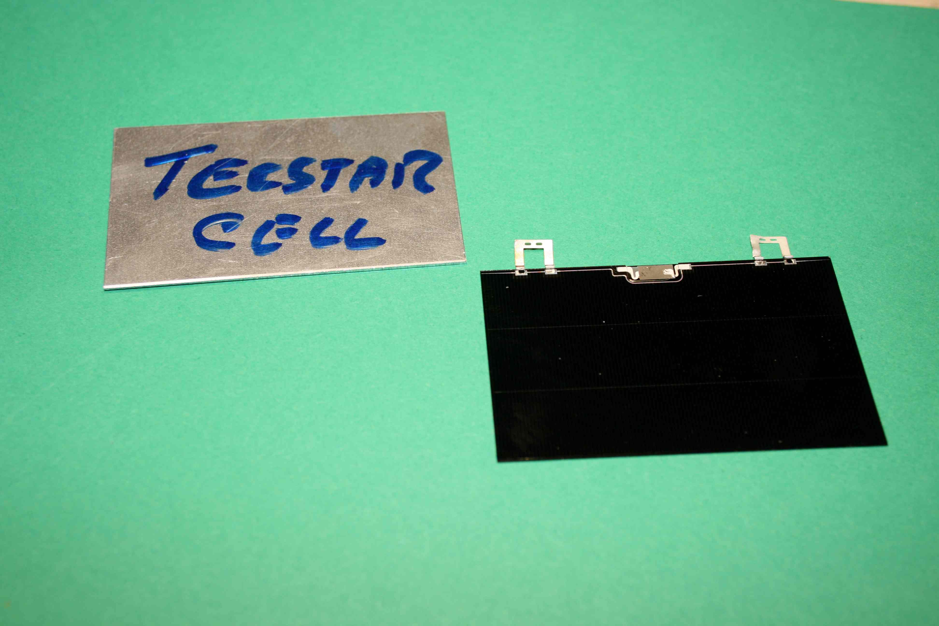
Solar Panels/Cell and Blank.jpg
