AMSAT-ZL/KiwiSAT_Sub-Systems/Solar Panels/Cell Box_Pack.jpg

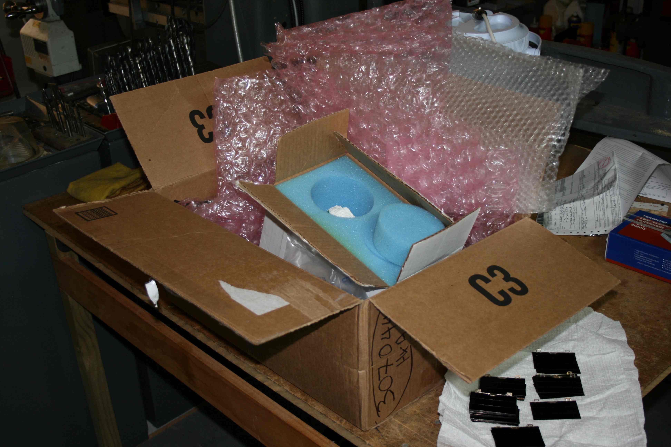
Solar Panels/Cell Box_Pack.jpg
