AMSAT-ZL/KiwiSAT_Sub-Systems/Solar Panels/CIMG1652.JPG

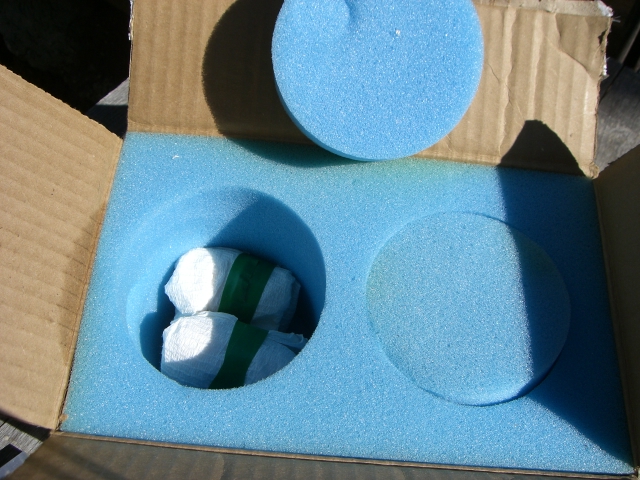
Solar Panels/CIMG1652.JPG
