AMSAT-ZL/KiwiSAT_Sub-Systems/Solar Panels/clip_image004.jpg

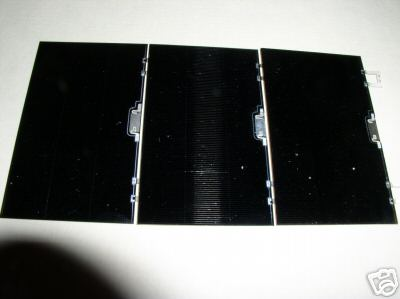
Solar Panels/clip_image004.jpg
