AMSAT-ZL/KiwiSAT_Sub-Systems/Solar Panels/First solar panels.jpg

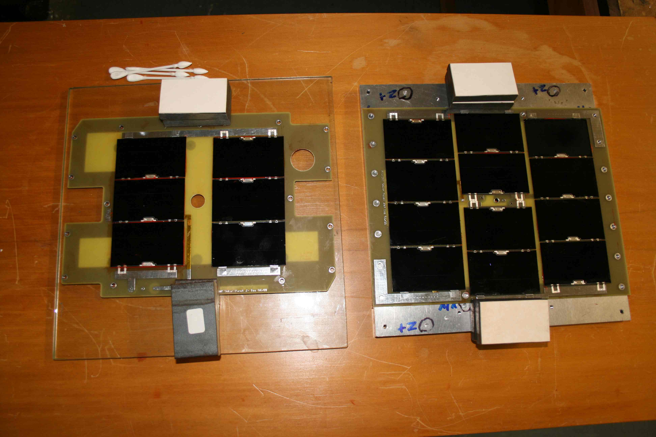
Solar Panels/First solar panels.jpg
