AMSAT-ZL/KiwiSAT_Sub-Systems/Solar Panels/Lay-up1.jpg

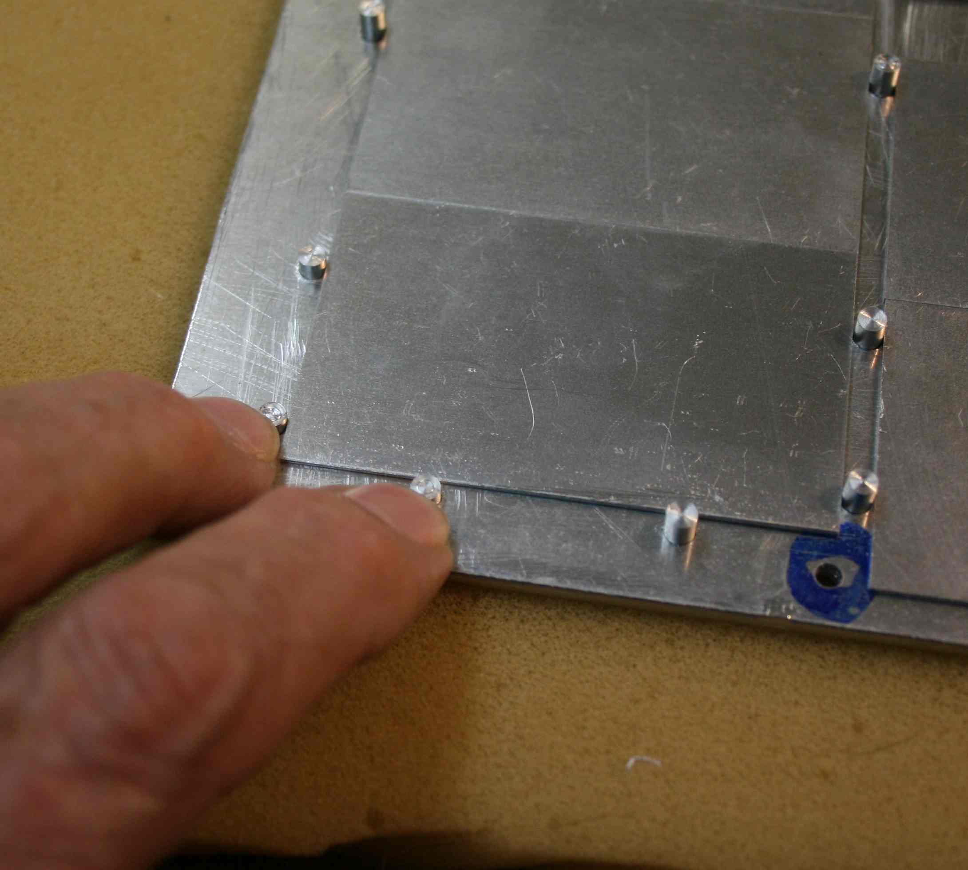
Solar Panels/Lay-up1.jpg
