AMSAT-ZL/KiwiSAT_Sub-Systems/Solar Panels/Lay-up2.jpg

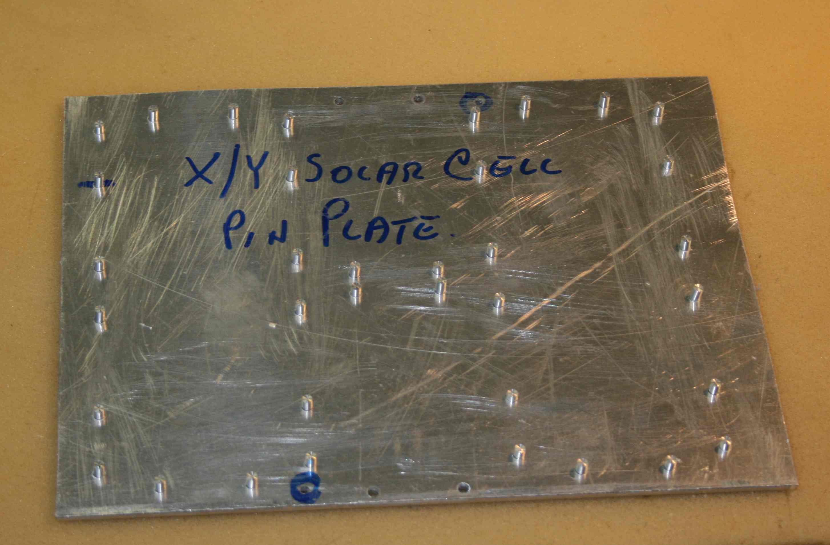
Solar Panels/Lay-up2.jpg
