AMSAT-ZL/KiwiSAT_Sub-Systems/Solar Panels/Lay-up3.jpg

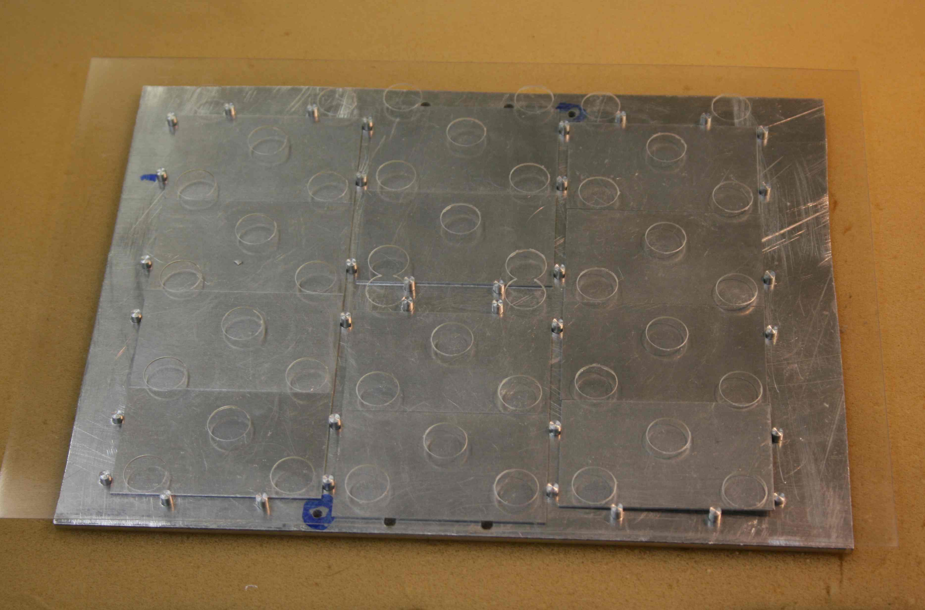
Solar Panels/Lay-up3.jpg
