AMSAT-ZL/KiwiSAT_Sub-Systems/Solar Panels/Lay-up4.jpg

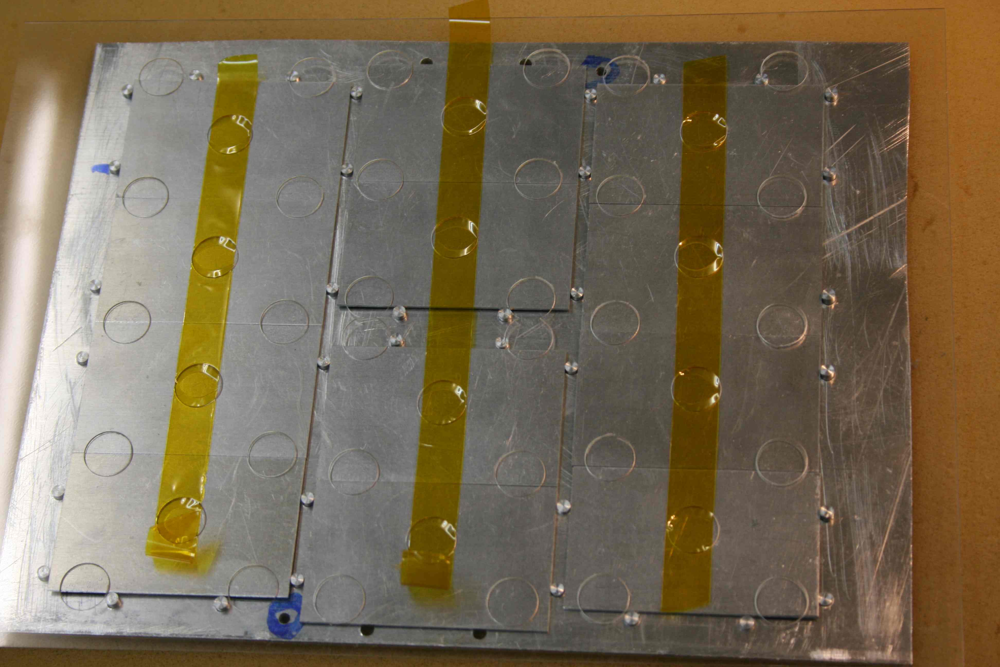
Solar Panels/Lay-up4.jpg
