AMSAT-ZL/KiwiSAT_Sub-Systems/Solar Panels/Lay-up5.jpg

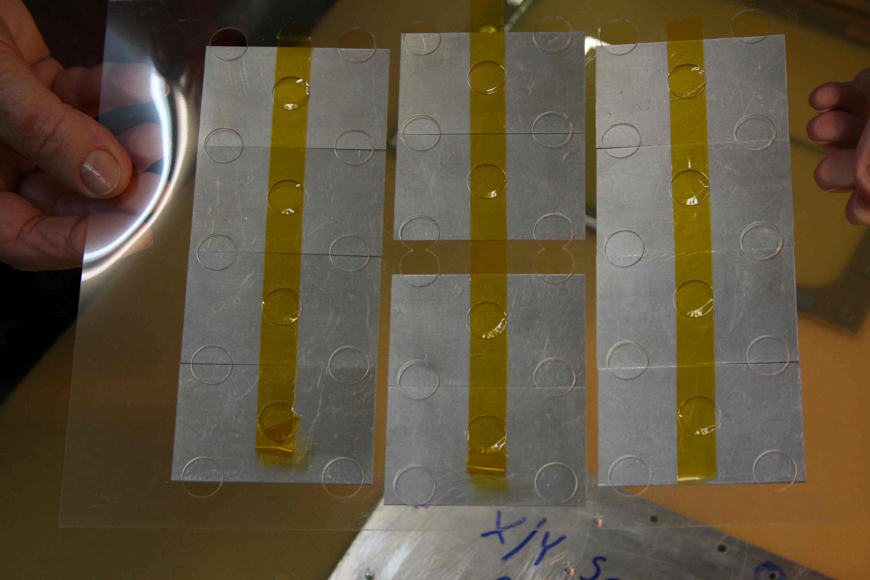
Solar Panels/Lay-up5.jpg
