AMSAT-ZL/KiwiSAT_Sub-Systems/Solar Panels/Lay-up6.jpg

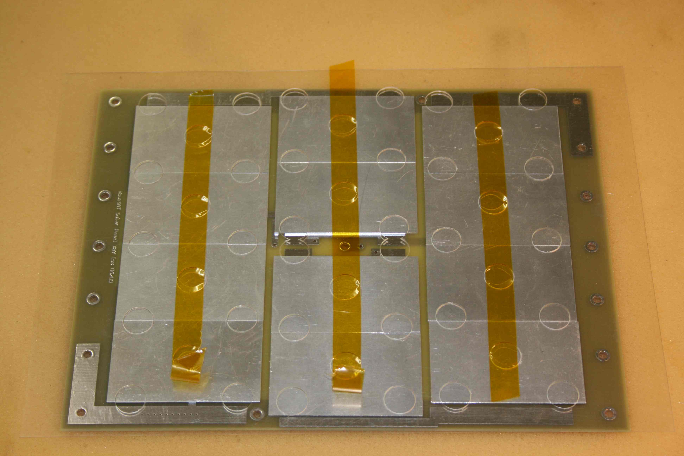
Solar Panels/Lay-up6.jpg
