AMSAT-ZL/KiwiSAT_Sub-Systems/Solar Panels/Lay-up7.jpg

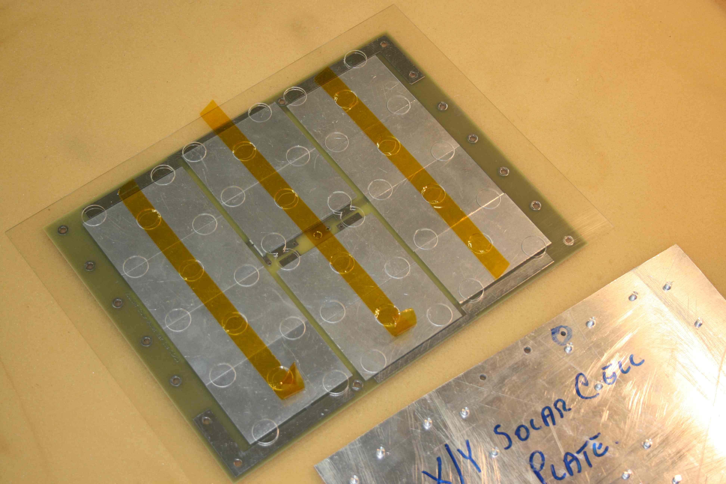
Solar Panels/Lay-up7.jpg
