AMSAT-ZL/KiwiSAT_Sub-Systems/Solar Panels/Lay-up8.jpg

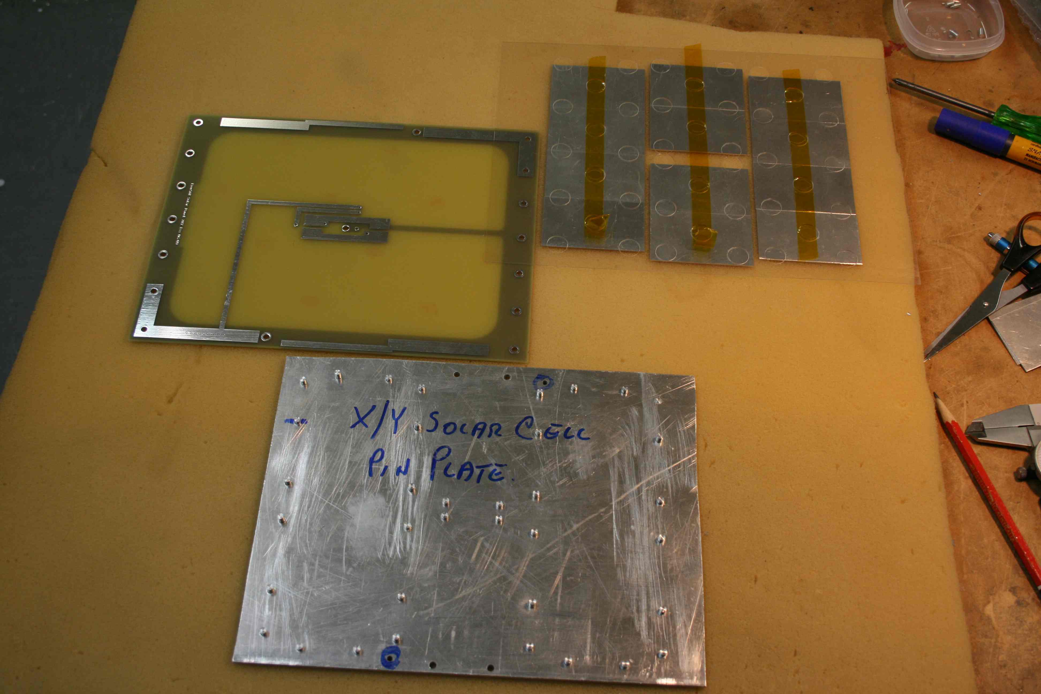
Solar Panels/Lay-up8.jpg
