AMSAT-ZL/KiwiSAT_Sub-Systems/Solar Panels/Lay-up9.jpg

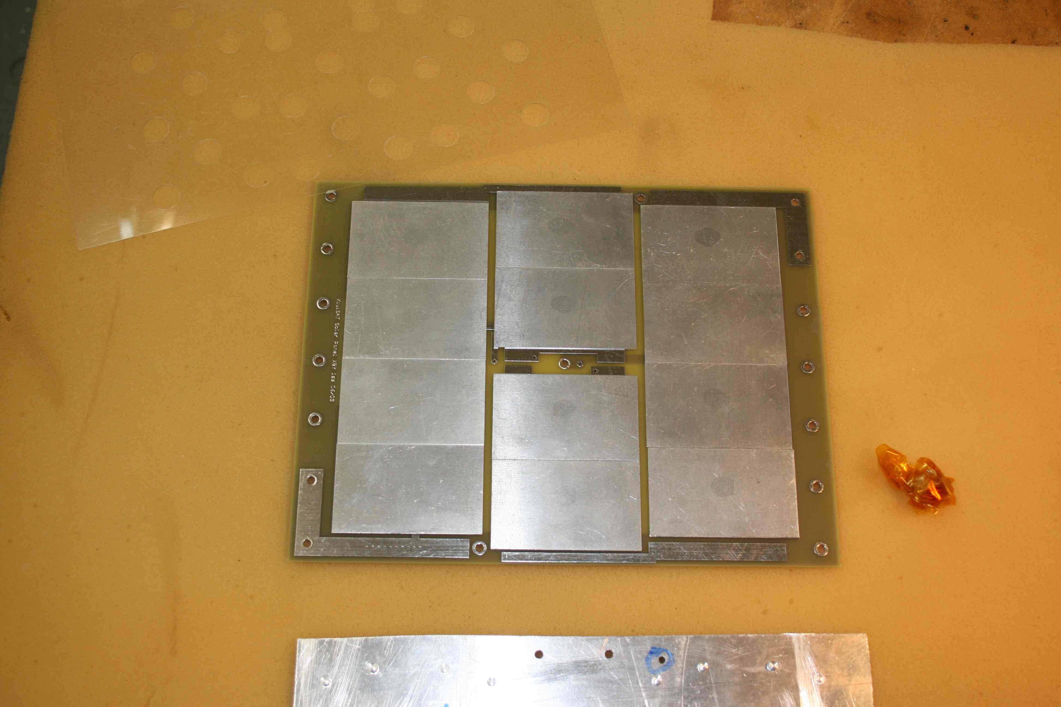
Solar Panels/Lay-up9.jpg
