AMSAT-ZL/KiwiSAT_Sub-Systems/Solar Panels/Lay-up10.jpg

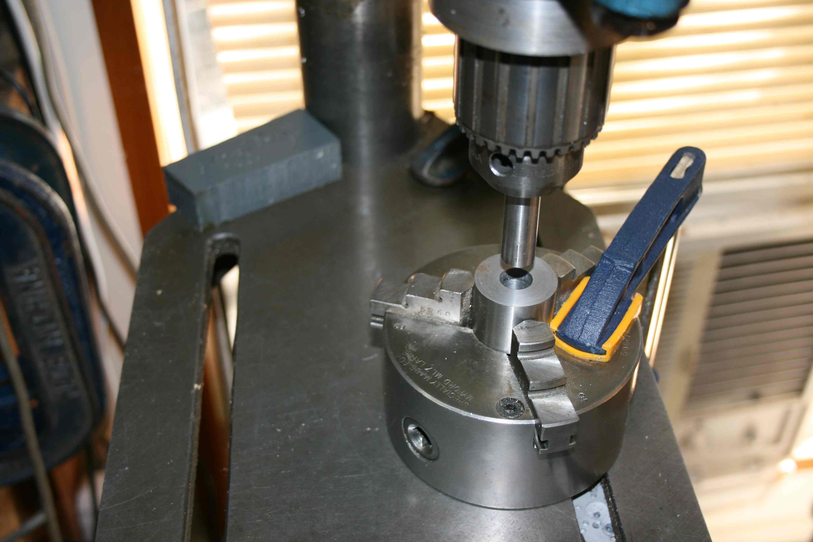
Solar Panels/Lay-up10.jpg
