AMSAT-ZL/KiwiSAT_Sub-Systems/Solar Panels/Solar panel boards2.jpg

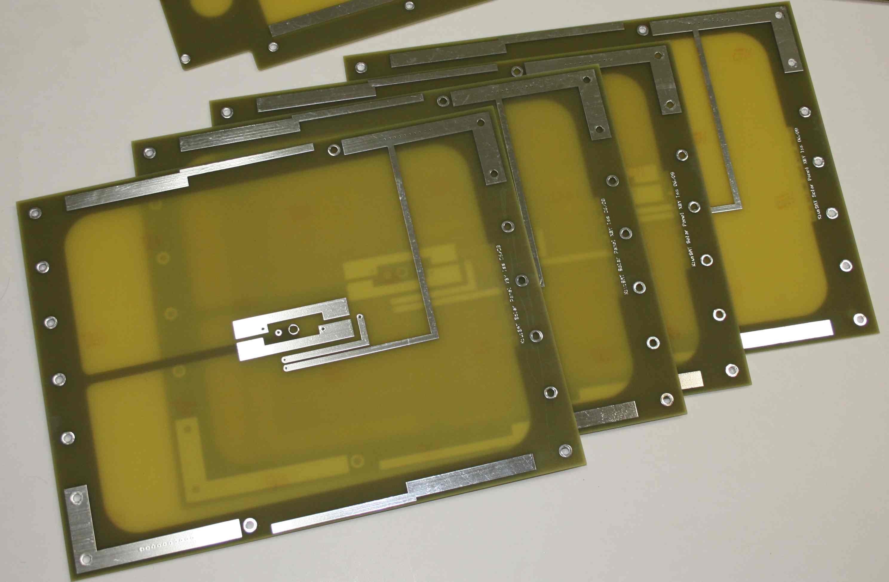
Solar Panels/Solar panel boards2.jpg
