AMSAT-ZL/KiwiSAT_Sub-Systems/Solar Panels/Solar panel boards.jpg

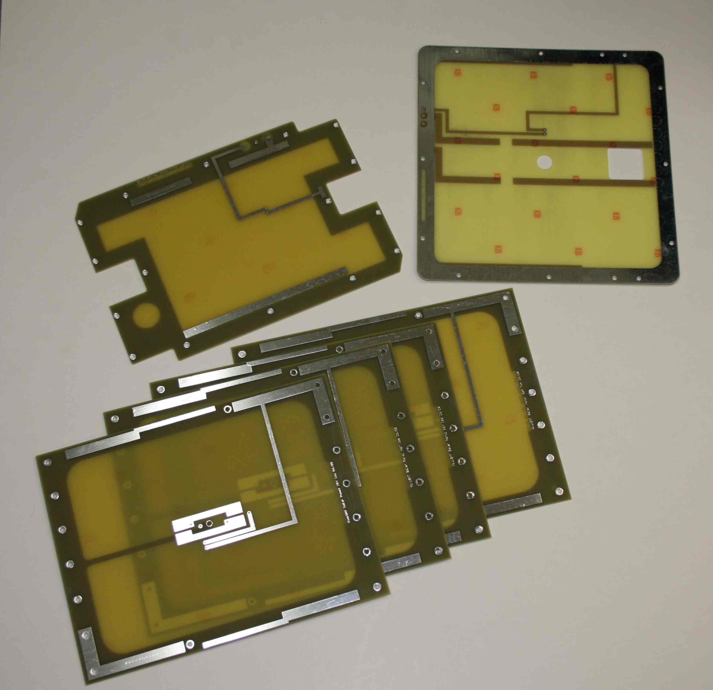
Solar Panels/Solar panel boards.jpg
