AMSAT-ZL/KiwiSAT_Sub-Systems/Sun_Sensor/SunSensor_V1.gif

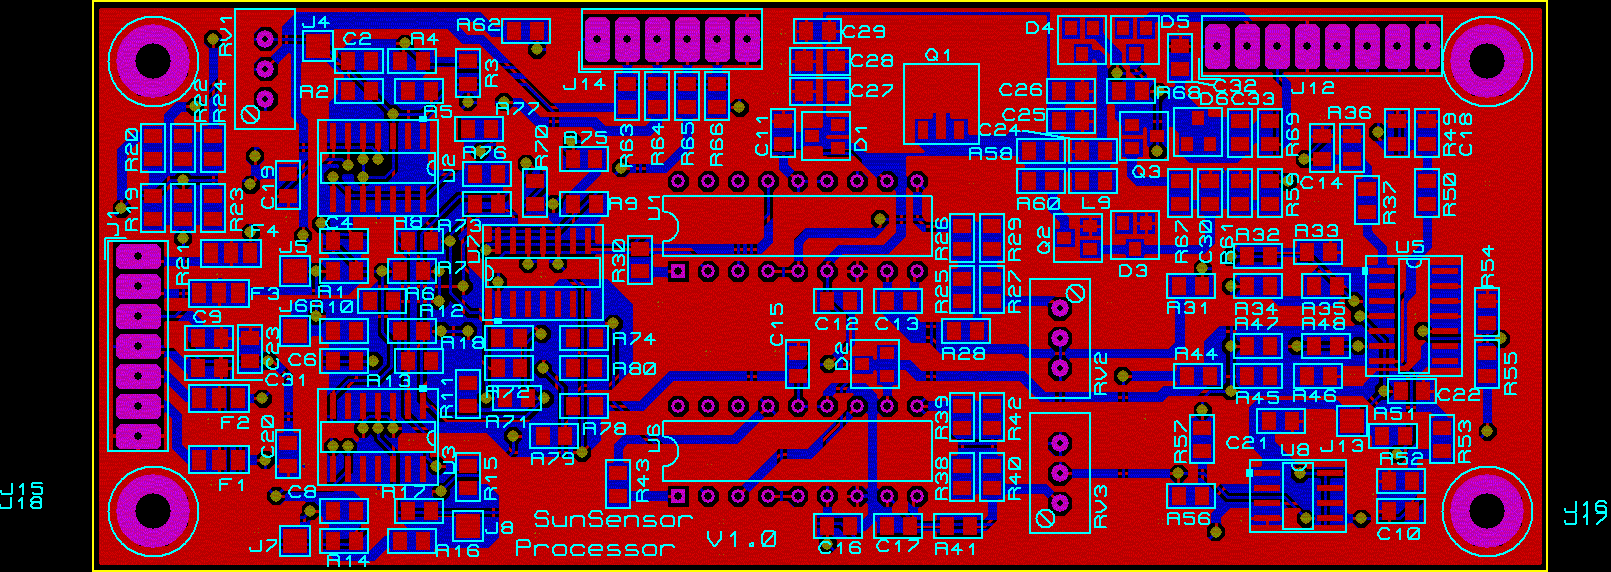
Sun_Sensor/SunSensor_V1.gif
