AMSAT-ZL/KiwiSAT_Sub-Systems/ADC_Module/ADC_Module_V10_BOM.xls

 | ADC PCB BOM
 |  |  | 2008-11-27
 | Number of PCBs
 |  | 5
 | All Cs 50V unless otherwise noted
 | Ensure Cs are appropriate type - do not use Y5V! X5R or X7R are okay
 | All Rs 1% unless otherwise noted
Quantity | Total | Total | Reference | Value | Package | Supplier
per PCB | Quantity | Supplied |  |  | Note | Part #
16 | 80 | 0 | C131-C134, C139-C146, C153-C156 | 1nF | SMD 0805 | ? - from my own stock
30 | 150 | - | C135, R131, R134-R136, R138, R139, R144-R147, R156, R157, R159-R163, R172-R179, R182-R185 | DNF | no part fitted | -
5 | 25 | 27 | C136, C138, C148, C150, C151 | 4.7uF 6.3V | SMD 0805 | Farnell 521-2832
3 | 15 | 17 | C137, C149, C152 | 100nF | SMD 0805 | ? - from my own stock
1 | 5 | 6 | C147 | 10nF | SMD 0805 | ? - from my own stock
4 | 20 | - | J131, J134, J135, J137 | M3 mount | no part | -
2 | 10 | - | J132, J133 | SIL-9 | no part | -
1 | 5 | - | J136 | SIL-8 | no part | -
20 | 100 | 102 | R132, R133, R148-R155, R158, R164-R171, R186 | 10k | SMD 0805 | Farnell 163-2457
1 | 5 | 0 | R137 | 22k | SMD 0805 | ? - from my own stock
1 | 5 | 0 | R140 | 1k | SMD 0805 | ? - from my own stock
3 | 15 | 17 | R141, R180, R181 | 10R | SMD 0805 | ? - from my own stock
2 | 10 | 0 | R142, R187 | 4k7 | SMD 0805 | ? - from my own stock
1 | 5 | 6 | R143 | 0R | SMD 0805 | ? - from my own stock
2 | 10 | 0 | U131, U133 | MAX1202 | SSOP20 | from Fred
1 | 5 | 6 | U132 | 74HC00 | SO14 | ? - from my own stock
