AMSAT-ZL/KiwiSAT_Sub-Systems/FM_Receivers/UHF-FM-RX BOM 2008-02-28.xls

Part Type | Designator | Footprint
0.5pF | C29 | CAP_0805
1-10pF | C12 | CAP_JR100
1-10pF | C56 | CAP_JR100
1-10pF | C58 | CAP_JR100
1uF | C44 | CAP_3216
1uF | C43 | CAP_3216
1uF | C42 | CAP_3216
1uF | C21 | CAP_3216
1uF | C41 | CAP_3216
1uF | C18 | CAP_3216
2.2k | R7 | RES_0805
2SC3356 | TR2 | IC_SOT23_3_BCE
2SC3356 | TR1 | IC_SOT23_3_BCE
2pF | C59 | CAP_0805
4.7k | R10 | RES_0805
4.7k | R26 | RES_0805
5pF | C60 | CAP_0805
6.8k | R21 | RES_0805
7pF | C7 | CAP_0805
8.2uH | L6 | IND_0805_1210
9nH | L1 | IND_0805_1210
10k 5% NTC | RT1 | CAP_0805
10k | R9 | RES_0805
10k | R5 | RES_0805
10k | R999 | RES_0805
10nF | C36 | CAP_0805
10nF | C38 | CAP_0805
10nF | C37 | CAP_0805
10nF | C35 | CAP_0805
10nF | C40 | CAP_0805
10nF | C26 | CAP_0805
10pF | C46 | CAP_0805
10pF | C25 | CAP_0805
15pF | C30 | CAP_0805
20.945MHz | X1 | XTAL_QC_41
20R | R29 | RES_0805
21.4MHz 30kHz | FL10 | XTAL_QC44
22pF | C13 | CAP_0805
27nH | L9 | IND_0805_1210
33pf | C48 | CAP_0805
47R | R13 | RES_0805
47k | R16 | RES_0805
47k | R17 | RES_0805
47pF | C34 | CAP_0805
47pF | C55 | CAP_0805
56nH | L8 | IND_0805_1210
68pF | C32 | CAP_0805
100R | R23 | RES_0805
100R | R1 | RES_0805
100k | R15 | RES_0805
100k | R14 | RES_0805
100k | R18 | RES_0805
100k | R12 | RES_0805
100nF | C4 | CAP_0805
100nF | C19 | CAP_0805
100nF | C22 | CAP_0805
100nF | C23 | CAP_0805
100nF | C20 | CAP_0805
100nF | C61 | CAP_0805
100nF | C17 | CAP_0805
100nF | C50 | CAP_0805
100nF | C31 | CAP_0805
100nF | C24 | CAP_0805
100nF | C51 | CAP_0805
100nF | C2 | CAP_0805
100nF | C52 | CAP_0805
100nF | C47 | CAP_0805
100pF | C57 | CAP_0805
106.25MHz | X2 | XTAL_QC_41
150nH | L3 | IND_0805_1210
150nH | L4 | IND_0805_1210
150pF | C39 | CAP_0805
150pF | C14 | CAP_0805
240k | R24 | RES_0805
270uH | L5 | TRANS_TOKO_7P
300R | R28 | RES_0805
300R | R27 | RES_0805
300R | R30 | RES_0805
300R | R25 | RES_0805
330nH | L10 | IND_0805_1210
390k | R8 | RES_0805
390pF | C27 | CAP_0805
470R | R19 | RES_0805
470R | R20 | RES_0805
470k | R6 | RES_0805
680pF | C11 | CAP_0805
680pF | C45 | CAP_0805
680pF | C9 | CAP_0805
680pF | C53 | CAP_0805
680pF | C5 | CAP_0805
680pF | C49 | CAP_0805
680pF | C3 | CAP_0805
680pF | C6 | CAP_0805
680pF | C1 | CAP_0805
680pF | C16 | CAP_0805
680pF | C10 | CAP_0805
CFU445B2 | FL9 | FILTER_PBFS_CFT
CFU445B2 | FL8 | FILTER_PBFS_CFT
CON_01 | TP2 | CON_TP
CON_01 | TP5 | CON_TP
CON_01 | TP1 | CON_TP
CON_01 | TP3 | CON_TP
CON_01 | TP4 | CON_TP
CON_DB9B | CN2 | CON_DB9RA_PLUG
DNS | C28 | CAP_0805
DNS | C33 | CAP_0805
DNS | C15 | CAP_0805
DNS | C54 | CAP_0805
DNS | C8 | CAP_0805
DNS | L7 | IND_0805_1210
DNS | L2 | IND_0805_1210
DNS | R3 | RES_0805
DNS | R22 | RES_0805
DNS | R4 | RES_0805
DNS | R11 | RES_0805
DNS | R2 | RES_0805
DNS | FL11 | XTAL_QC44
HELICAL_FILTER-5CHW | FL1 | FILTER_5CHW
HELICAL_FILTER-5CHW | FL13 | FILTER_5CHW
HELICAL_FILTER-5CHW | FL12 | FILTER_5CHW
IC_SA605 | IC7 | SOJ20/400
DNS | IC1 | IC_MMIC_84
LM2904 | IC5 | SO-8
LM2904 | IC6 | SO-8
MBRS130LT3 | D1 | SMB(403A)
MISC_SWAPBOX | J1 | MISC_SWAPBOX
NFM61RH20T332T1 | FL4 | FILTER_NFE61H
NFM61RH20T332T1 | FL6 | FILTER_NFE61H
NFM61RH20T332T1 | FL5 | FILTER_NFE61H
NFM61RH20T332T1 | FL7 | FILTER_NFE61H
NFM61RH20T332T1 | FL3 | FILTER_NFE61H
NFM61RH20T332T1 | FL2 | FILTER_NFE61H
NJM78L05UA | IC3 | IC_SOT89
NJM78L08UA | IC10 | IC_SOT89
NJM78L08UA | IC4 | IC_SOT89
SMA_RECEPTACLE | CN1 | CON_SMA_RA
U2796B | IC2 | SO-8
NOTES:
DNS means "Do Not Stuff"
A small inductor may be needed across the xtal to improve spectrum
Cut and jumper required around IC5, see photo
IC1 is only for testing, need to replace with short
4 pole IF filter preferable to 2 pole. RX will need to re-characterised
Probably worth getting SN1 back from Ian to allow side by side checking
