AMSAT-ZL/KiwiSAT_Sub-Systems/FM_Transmitter/FM TX RevF bom.xls

Used | Part Type | Designator | Footprint | Description | Qnty for 3 PCBs | Stock | Part Type | Size | order
2 | 0p5 | C14 C44 | 2012C | Capacitor 0805 | 6 | 0 | 0p5 | 0805 | 10
5 | 100n | C3 C18 C25 | 2012C | Capacitor 0805 | 15 | 36 | 100p | 0805 | 10
5 | 100p | C19 C23 | 2012C | Capacitor 0805 | 15 | 10 | 10p | 0805 | 10
1 | 10p | C36 | 2012C | Capacitor 0805 | 3 | 0 | 120p | 0805 | 10
1 | 120p | C26 | 2012C | Capacitor 0805 | 3 | 0 | 1n | 0805 | 50
1 | 180p | C8 | 2012C | Capacitor 0805 | 3 | 9 | 1p | 0805 | 10
1 | 18p | C30 | 2012C | Capacitor 0805 | 3 | 18 | 270p | 0805 | 10
14 | 1n | C1 C6 C9 | 2012C | Capacitor 0805 | 42 | 0 | 39P | 0805 | 10
2 | 1p | C7 C43 | 2012C | Capacitor 0805 | 6 | 3 | 4u7 | 0805 | 10
1 | 1p5 | C21 | 2012C | Capacitor 0805 | 3 | 7 | 5p6 | 0805 | 10
1 | 220p | C5 | 2012C | Capacitor 0805 | 3 | 100 | 1uH | 1210 | 5
1 | 22P | C10 | 2012C | Capacitor 0805 | 3 | 18
1 | 270p | C4 | 2012C | Capacitor 0805 | 3 | 0 | SMA-RA |  | 3
1 | 27p | C29 | 2012C | Capacitor 0805 | 3 | 17 | 16MHz |  | 1
1 | 330p | C24 | 2012C | Capacitor 0805 | 3 | 9 | DB9RA_PLG |  | 3
2 | 33p | C34 C35 | 2012C | Capacitor 0805 | 6 | 19
1 | 39P | C16 | 2012C | Capacitor 0805 | 3 | 0
3 | 47P | C12 C28 | 2012C | Capacitor 0805 | 9 | 18
1 | 4u7 | C2 | 2012C | Capacitor 0805 | 3 | 0
1 | 56P | C15 | 2012C | Capacitor 0805 | 3 | 100
1 | 5p6 | C20 | 2012C | Capacitor 0805 | 3 | 0
3 | 100k | R23 R29 | 2012R | Resistor SMD | 9 | 14
4 | 10k | R6 R10 R19 | 2012R | Resistor SMD | 12 | 40
1 | 120R | R14 | 2012R | Resistor SMD | 3 | 10
1 | 15k | R7 | 2012R | Resistor SMD | 3 | 11
4 | 1k | R4 R9 R18 | 2012R | Resistor SMD | 12 | 20
1 | 22R | R17 | 2012R | Resistor SMD | 3 | 100
1 | 240R | R12 | 2012R | Resistor SMD | 3 | 9
1 | 270R | R8 | 2012R | Resistor SMD | 3 | 8
2 | 47k | R2 R5 | 2012R | Resistor SMD | 6 | 15
3 | 47R | R1 R3 R13 | 2012R | Resistor SMD | 9 | 15
2 | 560k | R20 R22 | 2012R | Resistor SMD | 6 | 8
1 | 68k | R21 | 2012R | Resistor SMD | 3 | 11
1 | 6k8 | R32 | 2012R | Resistor SMD | 3 | 16
2 | 120nH | L3 L4 | TOKO136KEEPOUT | COIL AND SCREENING CAN | 6
4 | 62nH | L6 L7 L8 | TOKO136KEEPOUT | COIL AND SCREENING CAN | 12
2 | FB 120E | L1 L12 | 805 | Choke smd | 6 | 10
2 | 1uH | L2 L5 | 1210 | Choke smd | 6 | 2
1 | COIL1.5/2.5S | L11 | COIL3.5/3S | Air wound coil | 3
1 | 5.5t/3.5mm | L16 | COIL5.5/3S | Air wound coil | 3
1 | 5.5t/3mm | L9 | COIL5.5/3S | Air wound coil | 3
1 | 6.5t/4S | L13 | COIL6.5/4S | Air wound coil | 3
1 | DB9RA_PLG | P1 | DB9RAM_18316 | 9 way Dsub pins RA | 3 | 0
1 | SMA-RA | S1 | SMA-RA | PCB BNC SOCKET METAL | 3 | 0
1 | SMC-RA | S2 | SMA-RA | PCB BNC SOCKET METAL | 3 | 3
1 | FQD11P06 | Q7 | DPAK-H | P CHAN MOSFET | 3 | 4
1 | LM358D | IC1 | SO-8 | Dual Op Amp | 3 | 4
2 | 2SC3356 | Q2 Q3 | SOT-23S | UHF NPN transistor | 6 | 18
1 | 8v2 | D1 | SOT-23S | Zener diode | 3 | 7
2 | BAS16 | D2 D5 | SOT-23S | Switching diode | 6 | 20
2 | BBY40 | D3 D4 | SOT-23S | VARICAP 5P/8V | 6 | 8
1 | BFR92A | Q1 | SOT-23S | UHF NPN transistor | 3 | 8
1 | 2SC908 | Q5 | TO-5 | NPN RF TRANSISTOR | 3 | 6
1 | 16MHz | X1 | XTAL/UM | Generic Crystal | 3 | 2
