AMSAT-ZL/KiwiSAT_Sub-Systems/70Cm_Beacon/BeaconParts List.xls

Sheet: MixerAMP
Designator | Value | Type | Source | PN. | Notes
C1 | 100pf | 0603 | Farnell | 722-080
C2 | 100pf | 0603 | Farnell | 722-080
C6 | 10nf | 0805 | Farnell | 301-9937
C13 | 1uf | 0805 | Farnell | 197-476
C3 | 100pf | 0603 | Farnell | 722-080
C17 | 150pf | 0603 | Farnell | 722-108
C18 | 150pf | 0603 | Farnell | 722-108
C19 | 22pf | 0603 | Farnell
C23 | 22pf | 0603 | Farnell
C25 | 10nf | 0603 | Farnell
C24 | 1nf | 0603 | Farnell
C20 | 1uf | 0603 | Farnell
L1 | 330nH | 0805 | Farnell | 400-0532
L2 | 330nH | 0805 | Farnell | 400-0532
L3 | 2.2uH | 0805 | Farnell
L4 | 2.2uH | 0805 | Farnell
R1 | 100 | 0805 | Farnell | 911-732
R2 | 330 | 0805 | Farnell
R4 | 51 | 0805 | Farnell | 321-7905
R5 | 51 | 0805 | Farnell | 321-7905
R6 | AOT | 0805 | Farnell
R7 | AOT | 0805 | Farnell
R8 | AOT | 0805 | Farnell
RT1 | 10K | 0805 | Farnell |  | Thermistor
IC1 | ERA-3 |  | Minicircuits
IC2 | GVA-84 |  | Minicircuits
U1 | TUF-5SM |  | Minicircuits |  | Mixer
CN1 | SMA | PCB rta | Digikey | J569-ND | Johnson 142-0701-501
CN2 | SMC | PCB rta
CN3 | DB9 | PCB rta | Farnell | 150-710
PCB |  |  | Sierra Proto
Box |  |  | Fred

Sheet: Local Oscillator
Designator | Value | Type | Source | PN. | Notes
C33 | TBD | 0603
C35 | 1nf | 0805
C21 | 47pf | 0603
C22 | 47pf | 0603
C34 | 2.2pf | 0603
C39 | 2.2pf | 0603
C40 | 2.2pf | 0603
C36 | 1nf | 0805
C9 | 2.2pf | 0603
C41 | 2.2pf | 0603
C42 | 2.2pf | 0603
C43 | 0.68pf | 0603
C44 | 2.2pf | 0603
C45 | 2.2pf | 0603
C46 | 2.2pf | 0603
C47 | 0.68pf | 0603
C48 | 2.2pf | 0603
C49 | 2.2pf | 0603
L9 | 100nH | 0805 | Farnell | 400-470
L7 | 56nH | 0805 | Farnell | 400-0420
L8 | 56nH | 0805 | Farnell | 400-0420
L9 | 56nH | MC120 | TOKO
L10 | 56nH | MC120 | TOKO
L11 | 56nH | MC120 | TOKO
L12 | 56nH | MC120 | TOKO
R21 | 560 | 0805 | Farnell | 911-823
R12 | 10k | 0805 | Farnell | 911-975
R6 | 22k | 0805 | Farnell | 912-013
R17 | 100 | 0805 | Farnell | 911-732
R22 | 330 | 0805 | Farnell | 911-793
R18 | 1.5k | 0805 | Farnell | 911-872
R19 | 68k | 0805 | Farnell | 912-074
R20 | 47 | 0805 | Farnell | 911-690
Q1 | BFW92A
Q2 | BSW92A
X1 | 97.18666 |  | Hi Q |  | Crystal 5th O/T series res

Sheet: Power Supply
Designator | Value | Type | Source | PN. | Notes
C35 | 10uf | 1206 | Farnell
C38 | 100nf | 0805 | Farnell | 644-249
C36 | 10uf | 1206 | Farnell
C37 | 1nf | 0805 | Farnell | 718-567
U4 | LP2951 |  | Farnell
R19 | 10k | 0805 | Farnell | 911-975
R20 | 10k | 0805 | Farnell | 911-975
R21 | 10k | 0805 | Farnell | 911-975
D1 | MBRS130LT3 |  | Farnell | 708-150 | Idiot diode
D2 | MBRS130LT3 |  | Farnell | 708-150 | Idiot diode
