AMSAT-ZL/KiwiSAT_Sub-Systems/FM_Receivers/2008-02-28 Assembly instructions and BOM/UHF-FM-RX BOM 2006-10-10.xls

Sheet: UHF-FM-RX
Part Type | Designator | Footprint | Load on PCB ? | Supply to Assy house | Notes
0.5pF NPO | C29 | CAP_0805 | no
100k | R12 | RES_0805 | yes
100k | R14 | RES_0805 | yes
100k | R15 | RES_0805 | yes
100k | R18 | RES_0805 | yes
100nF | C17 | CAP_0805 | yes
100nF | C19 | CAP_0805 | yes
100nF | C2 | CAP_0805 | yes
100nF | C20 | CAP_0805 | yes
100nF | C22 | CAP_0805 | yes
100nF | C23 | CAP_0805 | yes
100nF | C24 | CAP_0805 | yes
100nF | C31 | CAP_0805 | yes
100nF | C4 | CAP_0805 | yes
100nF | C47 | CAP_0805 | yes
100nF | C50 | CAP_0805 | yes
100nF | C51 | CAP_0805 | yes
100nF | C52 | CAP_0805 | yes
100nF | C61 | CAP_0805 | yes
100pF NPO | C57 | CAP_0805 | yes
100R | R1 | RES_0805 | yes
100R | R23 | RES_0805 | yes
106.25MHz | X2 | XTAL_QC_41 | no |  | On order
10k | R5 | RES_0805 | no |  | AOT for Squelch
10k | R9 | RES_0805 | yes
10k | R999 | RES_0805 | no |  | Board modification
10k 5% NTC | RT1 | CAP_0805 | no
10nF | C26 | CAP_0805 | yes
10nF | C35 | CAP_0805 | yes
10nF | C36 | CAP_0805 | yes
10nF | C37 | CAP_0805 | yes
10nF | C38 | CAP_0805 | yes
10nF | C40 | CAP_0805 | yes
10pF NPO | C25 | CAP_0805 | yes
10pF NPO | C46 | CAP_0805 | yes
1-10pF | C12 | CAP_JR100 | yes | yes
1-10pF | C56 | CAP_JR100 | yes | yes
1-10pF | C58 | CAP_JR100 | yes | yes
150nH | L3 | IND_0805_1210 | no
150nH | L4 | IND_0805_1210 | no
150pF NPO | C14 | CAP_0805 | yes
150pF NPO | C39 | CAP_0805 | yes
15pF NPO | C30 | CAP_0805 | yes
1uF 16V 0805 | C18 | CAP_3216 | yes
1uF 16V 0805 | C21 | CAP_3216 | yes
1uF 16V 0805 | C41 | CAP_3216 | yes
1uF 16V 0805 | C42 | CAP_3216 | yes
1uF 16V 0805 | C43 | CAP_3216 | yes
1uF 16V 0805 | C44 | CAP_3216 | yes
2.2k | R7 | RES_0805 | yes
20.945MHz | X1 | XTAL_QC_41 | no |  | On order
20R | R29 | RES_0805 | yes
21.4MHz 30kHz | FL10 | XTAL_QC44 | no |  | On order
22pF NPO | C13 | CAP_0805 | yes
240k | R24 | RES_0805 | yes
270uH | L5 | TRANS_TOKO_7P | yes | yes
27nH | L9 | IND_0805_1210 | yes | yes
2pF NPO | C59 | CAP_0805 | yes
2SC3356 | TR1 | IC_SOT23_3_BCE | yes | yes
2SC3356 | TR2 | IC_SOT23_3_BCE | yes | yes
300R | R25 | RES_0805 | yes
300R | R27 | RES_0805 | yes
300R | R28 | RES_0805 | yes
300R | R30 | RES_0805 | yes
330nH | L10 | IND_0805_1210 | no
33pf NPO | C48 | CAP_0805 | yes
390k | R8 | RES_0805 | yes
390pF NPO | C27 | CAP_0805 | yes
4.7k | R10 | RES_0805 | yes
4.7k | R26 | RES_0805 | yes
470k | R6 | RES_0805 | yes
470R | R19 | RES_0805 | yes
470R | R20 | RES_0805 | yes
47k | R16 | RES_0805 | yes
47k | R17 | RES_0805 | yes
47pF | C55 | CAP_0805 | yes
47pF NPO | C34 | CAP_0805 | yes
47R | R13 | RES_0805 | yes
56nH | L8 | IND_0805_1210 | yes | yes
5pF NPO | C60 | CAP_0805 | yes
6.8k | R21 | RES_0805 | yes
680pF | C1 | CAP_0805 | yes
680pF | C10 | CAP_0805 | yes
680pF | C11 | CAP_0805 | yes
680pF | C16 | CAP_0805 | yes
680pF | C3 | CAP_0805 | yes
680pF | C45 | CAP_0805 | yes
680pF | C49 | CAP_0805 | yes
680pF | C5 | CAP_0805 | yes
680pF | C53 | CAP_0805 | yes
680pF | C6 | CAP_0805 | yes
680pF | C9 | CAP_0805 | yes
68pF NPO | C32 | CAP_0805 | yes
7pF NPO | C7 | CAP_0805 | yes
8.2uH | L6 | IND_0805_1210 | yes | yes | On order
9nH | L1 | IND_0805_1210 | yes | yes | On order
CFU445B2 | FL8 | FILTER_PBFS_CFT | yes | yes
CFU445B2 | FL9 | FILTER_PBFS_CFT | yes | yes
CON_DB9B | CN2 | CON_DB9RA_PLUG | no
DNS | C15 | CAP_0805 | no
DNS | C28 | CAP_0805 | no
DNS | C33 | CAP_0805 | no
DNS | C54 | CAP_0805 | no
DNS | C8 | CAP_0805 | no
DNS | FL11 | XTAL_QC44 | no
DNS | L2 | IND_0805_1210 | no
DNS | L7 | IND_0805_1210 | no
DNS | R11 | RES_0805 | no
DNS | R2 | RES_0805 | no
DNS | R22 | RES_0805 | no
DNS | R3 | RES_0805 | no
DNS | R4 | RES_0805 | no
HELICAL_FILTER-5CHW | FL1 | FILTER_5CHW | yes | yes
HELICAL_FILTER-5CHW | FL12 | FILTER_5CHW | yes | yes
HELICAL_FILTER-5CHW | FL13 | FILTER_5CHW | yes | yes
IC_SA605 | IC7 | SOJ20/400 | yes | yes
INA-03184 | IC1 | IC_MMIC_84 | yes | yes
LM2904 | IC5 | SO-8 | yes | yes
LM2904 | IC6 | SO-8 | yes | yes
MBRS130LT3 | D1 | SMB(403A) | yes | yes
NFM61RH20T332T1 | FL2 | FILTER_NFE61H | yes | yes
NFM61RH20T332T1 | FL3 | FILTER_NFE61H | yes | yes
NFM61RH20T332T1 | FL4 | FILTER_NFE61H | yes | yes
NFM61RH20T332T1 | FL5 | FILTER_NFE61H | yes | yes
NFM61RH20T332T1 | FL6 | FILTER_NFE61H | yes | yes
NFM61RH20T332T1 | FL7 | FILTER_NFE61H | yes | yes
NJM78L05UA | IC3 | IC_SOT89 | yes | yes | Tab needs solder mask scraping away
NJM78L08UA | IC10 | IC_SOT89 | yes | yes | Tab needs solder mask scraping away
NJM78L08UA | IC4 | IC_SOT89 | yes | yes | Tab needs solder mask scraping away
SMA_RECEPTACLE | CN1 | CON_SMA_RA | yes | yes
U2796B | IC2 | SO-8 | yes | yes
Unless otherwise stated, capacitors may be NPO, X7R or Y5U
Unless otherwise stated, resistors are 1%
Include photo of finished PCB
Mark Atherton, 10th October 2006

Sheet: SUPPLY TO ASSY HOUSE
Part Type | Designator | Footprint
NFM61RH20T332T1 | FL2 | FILTER_NFE61H
NFM61RH20T332T1 | FL3 | FILTER_NFE61H
NFM61RH20T332T1 | FL4 | FILTER_NFE61H
NFM61RH20T332T1 | FL5 | FILTER_NFE61H
NFM61RH20T332T1 | FL6 | FILTER_NFE61H
NFM61RH20T332T1 | FL7 | FILTER_NFE61H
NJM78L08UA | IC10 | IC_SOT89
NJM78L08UA | IC4 | IC_SOT89
CFU445B2 | FL8 | FILTER_PBFS_CFT
CFU445B2 | FL9 | FILTER_PBFS_CFT
LM2904 | IC5 | SO-8
LM2904 | IC6 | SO-8
HELICAL_FILTER-5CHW | FL12 | FILTER_5CHW | 420MHz
HELICAL_FILTER-5CHW | FL13 | FILTER_5CHW | 420MHz
NJM78L05UA | IC3 | IC_SOT89
HELICAL_FILTER-5CHW | FL1 | FILTER_5CHW | 434MHz
INA-03184 | IC1 | IC_MMIC_84
U2796B | IC2 | SO-8
IC_SA605 | IC7 | SOJ20/400
MBRS130LT3 | D1 | SMB(403A)
270uH | L5 | TRANS_TOKO_7P
8.2uH | L6 | IND_0805_1210
Needs fetching from garage
1-10pF | C12 | CAP_JR100
1-10pF | C56 | CAP_JR100
1-10pF | C58 | CAP_JR100
2SC3356 | TR1 | IC_SOT23_3_BCE
2SC3356 | TR2 | IC_SOT23_3_BCE
Needs ordering
9nH | L1 | IND_0805_1210 | M1153CT-ND | USD 0.53
56nH | L8 | IND_0805_1210 | M1185CT-ND | USD 0.53
27nH | L9 | IND_0805_1210 | M1181CT-ND | USD 0.53
SMA_RECEPTACLE | CN1 | CON_SMA_RA | J569-ND | USD 12.80 | One with Kelvin
DB9 RA PCB |  |  | RS 151-804 to 152-043
Thermistors ? |  |  |  |  | What type ?
