AMSAT-ZL/KiwiSAT_Sub-Systems/IHU/Rev2/BOM/KiwiSatOverview.XLS

Part Type | Designator | Footprint | Description | Read-Only Field 2 | Read-Only Field 3 | DEVELOPMENT VERSION | FLIGHT VERSION
0K 1% (0805) | R103 | CC0805 | RES CHIP 0E 150V 125mW |  |  | NOT FITTED | FITTED
0K 1% (0805) | R104 | CC0805 | RES CHIP 0E 150V 125mW |  |  | NOT FITTED | FITTED
0K 1% (0805) | R101 | CC0805 | RES CHIP 0E 150V 125mW |  |  | NOT FITTED | FITTED
0K 1% (0805) | R100 | CC0805 | RES CHIP 0E 150V 125mW |  |  | NOT FITTED | FITTED
0K 1% (0805) | R105 | CC0805 | RES CHIP 0E 150V 125mW |  |  | NOT FITTED | FITTED
0K 1% (0805) | R107 | CC0805 | RES CHIP 0E 150V 125mW |  |  | NOT FITTED | FITTED
0K 1% (0805) | R108 | CC0805 | RES CHIP 0E 150V 125mW |  |  | NOT FITTED | FITTED
0K 1% (0805) | R106 | CC0805 | RES CHIP 0E 150V 125mW |  |  | NOT FITTED | FITTED
1M 1% | R34 | CC0805 | RES CHIP 1M 150V 125mW 1% | VENKEL | CR0805-8W-10004FT | FITTED | FITTED
1k 1% | R55 | CC0805 | RES CHIP 1k 150V 125mW 1% | VENKEL | CR0805-8W-1001F | FITTED | FITTED
1k 1% | R23 | CC0805 | RES CHIP 1k 150V 125mW 1% | VENKEL | CR0805-8W-1001F | FITTED | FITTED
1k 1% | R1 | CC0805 | RES CHIP 1k 150V 125mW 1% | VENKEL | CR0805-8W-1001F | FITTED | FITTED
1k 1% | R10 | CC0805 | RES CHIP 1k 150V 125mW 1% | VENKEL | CR0805-8W-1001F | FITTED | FITTED
1k 1% | R14 | CC0805 | RES CHIP 1k 150V 125mW 1% | VENKEL | CR0805-8W-1001F | FITTED | FITTED
1k 1% | R19 | CC0805 | RES CHIP 1k 150V 125mW 1% | VENKEL | CR0805-8W-1001F | FITTED | FITTED
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
10k 1% | R76 | CC0805 | RES CHIP 10k 150V 125mW 1% | VENKEL | CR0805-8W-1002FT | FITTED | FITTED
10k 1% | R66 | CC0805 | RES CHIP 10k 150V 125mW 1% | VENKEL | CR0805-8W-1002FT | FITTED | FITTED
10k 1% | R44 | CC0805 | RES CHIP 10k 150V 125mW 1% | VENKEL | CR0805-8W-1002FT | FITTED | FITTED
10k 1% | R2 | CC0805 | RES CHIP 10k 150V 125mW 1% | VENKEL | CR0805-8W-1002FT | FITTED | FITTED
10k 1% | DEVELOPMENT | CC0805 | RES CHIP 10k 150V 125mW 1% | VENKEL | CR0805-8W-1002FT | FITTED | NOT FITTED
10k 1% | R3 | CC0805 | RES CHIP 10k 150V 125mW 1% | VENKEL | CR0805-8W-1002FT | FITTED | FITTED
10k 1% | R50 | CC0805 | RES CHIP 10k 150V 125mW 1% | VENKEL | CR0805-8W-1002FT | FITTED | FITTED
10k 1% | FLIGHT | CC0805 | RES CHIP 10k 150V 125mW 1% | VENKEL | CR0805-8W-1002FT | NOT FITTED | FITTED
10nF 50V | C107 | CC0805 | CAP X7R 10nF 50V 10% | VENKEL | C0805X7R500-103KN | FITTED | FITTED
10nF 50V | C42 | CC0805 | CAP X7R 10nF 50V 10% | VENKEL | C0805X7R500-103KN | FITTED | FITTED
10nF 50V | C108 | CC0805 | CAP X7R 10nF 50V 10% | VENKEL | C0805X7R500-103KN | FITTED | FITTED
10nF 50V | C109 | CC0805 | CAP X7R 10nF 50V 10% | VENKEL | C0805X7R500-103KN | FITTED | FITTED
10nF 50V | C106 | CC0805 | CAP X7R 10nF 50V 10% | VENKEL | C0805X7R500-103KN | FITTED | FITTED
10pF 50V | C11 | CC0805 | CAP COG 10pF 50V 5% | VENKEL | C0805C0G500-100JN | FITTED | FITTED
12k1 1% | R45 | CC0805 | RES CHIP 12k1 150V 125mW 1% | VENKEL | CR0805-8W-1212FT | FITTED | FITTED
13k 1% | R43 | CC0805 | RES CHIP 13k 150V 125mW 1% | VENKEL | CR0805-8W-1302FT | FITTED | FITTED
14.7456MHz | X1 | XTAL-HC49SD | XTAL SMD 14.7456MHz | FOX | HC49SD-14.7456 | FITTED | FITTED
18pF 50V | C51 | CC0805 | CAP COG 18pF 50V 5% | VENKEL | C0805C0G500-180JN | FITTED | FITTED
18pF 50V | C50 | CC0805 | CAP COG 18pF 50V 5% | VENKEL | C0805C0G500-180JN | FITTED | FITTED
22pF 50V | C12 | CC0805 | CAP COG 22pF 50V 5% | VENKEL | C0805C0G500-220JN | FITTED | FITTED
24k3 1% | R46 | CC0805 | RES CHIP 24k3 150V 125mW 1% | VENKEL | CR0805-8W-2432FT | FITTED | FITTED
27k4 1% | R20 | CC0805 | RES CHIP 27k4 150V 125mW 1% | VENKEL | CR0805-8W-2742FT | FITTED | FITTED
27k4 1% | R11 | CC0805 | RES CHIP 27k4 150V 125mW 1% | VENKEL | CR0805-8W-2742FT | FITTED | FITTED
30k1 1% | R42 | CC0805 | RES CHIP 30k1 150V 125mW 1% | VENKEL | CR0805-8W-3012FT | FITTED | FITTED
30k1 1% | R24 | CC0805 | RES CHIP 30k1 150V 125mW 1% | VENKEL | CR0805-8W-3012FT | FITTED | FITTED
33R2 1% | R95 | CC0805 | RES CHIP 33R2 150V 125mW 1% | VENKEL | CR0805-8W-33R2FT | FITTED | FITTED
33R2 1% | R92 | CC0805 | RES CHIP 33R2 150V 125mW 1% | VENKEL | CR0805-8W-33R2FT | FITTED | FITTED
33R2 1% | R93 | CC0805 | RES CHIP 33R2 150V 125mW 1% | VENKEL | CR0805-8W-33R2FT | FITTED | FITTED
33R2 1% | R94 | CC0805 | RES CHIP 33R2 150V 125mW 1% | VENKEL | CR0805-8W-33R2FT | FITTED | FITTED
33R2 1% | R99 | CC0805 | RES CHIP 33R2 150V 125mW 1% | VENKEL | CR0805-8W-33R2FT | FITTED | FITTED
33R2 1% | R90 | CC0805 | RES CHIP 33R2 150V 125mW 1% | VENKEL | CR0805-8W-33R2FT | FITTED | FITTED
33R2 1% | R91 | CC0805 | RES CHIP 33R2 150V 125mW 1% | VENKEL | CR0805-8W-33R2FT | FITTED | FITTED
33R2 1% | R96 | CC0805 | RES CHIP 33R2 150V 125mW 1% | VENKEL | CR0805-8W-33R2FT | FITTED | FITTED
33R2 1% | R97 | CC0805 | RES CHIP 33R2 150V 125mW 1% | VENKEL | CR0805-8W-33R2FT | FITTED | FITTED
33R2 1% | R98 | CC0805 | RES CHIP 33R2 150V 125mW 1% | VENKEL | CR0805-8W-33R2FT | FITTED | FITTED
33R2 1% | R86 | CC0805 | RES CHIP 33R2 150V 125mW 1% | VENKEL | CR0805-8W-33R2FT | FITTED | FITTED
33R2 1% | R84 | CC0805 | RES CHIP 33R2 150V 125mW 1% | VENKEL | CR0805-8W-33R2FT | FITTED | FITTED
33R2 1% | R83 | CC0805 | RES CHIP 33R2 150V 125mW 1% | VENKEL | CR0805-8W-33R2FT | FITTED | FITTED
33R2 1% | R88 | CC0805 | RES CHIP 33R2 150V 125mW 1% | VENKEL | CR0805-8W-33R2FT | FITTED | FITTED
33R2 1% | R85 | CC0805 | RES CHIP 33R2 150V 125mW 1% | VENKEL | CR0805-8W-33R2FT | FITTED | FITTED
33R2 1% | R89 | CC0805 | RES CHIP 33R2 150V 125mW 1% | VENKEL | CR0805-8W-33R2FT | FITTED | FITTED
33k2 1% | R48 | CC0805 | RES CHIP 33k2 150V 125mW 1% | VENKEL | CR0805-8W-3322FT | FITTED | FITTED
33k2 1% | R40 | CC0805 | RES CHIP 33k2 150V 125mW 1% | VENKEL | CR0805-8W-3322FT | FITTED | FITTED
36k5 1% | R39 | CC0805 | RES CHIP 36k5 150V 125mW 1% | VENKEL | CR0805-8W-3652FT | FITTED | FITTED
39k2 1% | R18 | CC0805 | RES CHIP 39k2 150V 125mW 1% | VENKEL | CR0805-8W-3922FT | FITTED | FITTED
39k2 1% | R9 | CC0805 | RES CHIP 39k2 150V 125mW 1% | VENKEL | CR0805-8W-3922FT | FITTED | FITTED
47k5 1% | R15 | CC0805 | RES CHIP 47k5 150V 125mW 1% | VENKEL | CR0805-8W-4752FT | FITTED | FITTED
47k5 1% | R6 | CC0805 | RES CHIP 47k5 150V 125mW 1% | VENKEL | CR0805-8W-4752FT | FITTED | FITTED
56k2 1% | R54 | CC0805 | RES CHIP 56k2 150V 125mW 1% | VENKEL | CR0805-8W-5622FT | FITTED | FITTED
68k1 1% | R25 | CC0805 | RES CHIP 68k1 150V 125mW 1% | VENKEL | CR0805-8W-6812FT | FITTED | FITTED
74AC138SC | U51 | SO-16 | IC 3-8 LINE DECODER / DEMULTIPLEXOR | FAIRCHILD | 74AC138SC | FITTED | FITTED
74AC273SC | U52 | SO-20W | IC OCTAL D-TYPE FLIP FLOP WITH RESET | FAIRCHILD | 74AC273SC | FITTED | FITTED
74AC273SC | U54 | SO-20W | IC OCTAL D-TYPE FLIP FLOP WITH RESET | FAIRCHILD | 74AC273SC | FITTED | FITTED
74AC273SC | U53 | SO-20W | IC OCTAL D-TYPE FLIP FLOP WITH RESET | FAIRCHILD | 74AC273SC | FITTED | FITTED
74AC573SC | U12 | SO-20W | IC OCTAL D LATCH WITH TRI-STATE OUTPUTS | FAIRCHILD | 74AC573SC | FITTED | FITTED
74AC573SC | U50 | SO-20W | IC OCTAL D LATCH WITH TRI-STATE OUTPUTS | FAIRCHILD | 74AC573SC | FITTED | FITTED
74AC573SC | U14 | SO-20W | IC OCTAL D LATCH WITH TRI-STATE OUTPUTS | FAIRCHILD | 74AC573SC | FITTED | FITTED
74AC573SC | U11 | SO-20W | IC OCTAL D LATCH WITH TRI-STATE OUTPUTS | FAIRCHILD | 74AC573SC | FITTED | FITTED
74AC574ASC | U5 | SO-20W | IC OCTAL D FLIP-FLOP WITH 3-STATE OUTPUTS | FAIRCHILD | 74AC574ASC | FITTED | FITTED
74AC574ASC | U1 | SO-20W | IC OCTAL D FLIP-FLOP WITH 3-STATE OUTPUTS | FAIRCHILD | 74AC574ASC | FITTED | FITTED
74HC393D | U60 | SO-14 | IC SN74HC393DR DUAL 4BIT BINRY COUNTR SO-14 |  |  | FITTED | FITTED
82k5 1% | R8 | CC0805 | RES CHIP 82k5 150V 125mW 1% | VENKEL | CR0805-8W-8252FT | FITTED | FITTED
82k5 1% | R17 | CC0805 | RES CHIP 82k5 150V 125mW 1% | VENKEL | CR0805-8W-8252FT | FITTED | FITTED
90k9 1% | R28 | CC0805 | RES CHIP 90k9 150V 125mW 1% | VENKEL | CR0805-8W-9092FT | FITTED | FITTED
100k 1% | R53 | CC0805 | RES CHIP 100k 150V 125mW 1% | VENKEL | CR0805-8W-1003FT | FITTED | FITTED
100k 1% | R81 | CC0805 | RES CHIP 100k 150V 125mW 1% | VENKEL | CR0805-8W-1003FT | FITTED | FITTED
100k 1% | R59 | CC0805 | RES CHIP 100k 150V 125mW 1% | VENKEL | CR0805-8W-1003FT | FITTED | FITTED
100k 1% | R58 | CC0805 | RES CHIP 100k 150V 125mW 1% | VENKEL | CR0805-8W-1003FT | FITTED | FITTED
100k 1% | R82 | CC0805 | RES CHIP 100k 150V 125mW 1% | VENKEL | CR0805-8W-1003FT | FITTED | FITTED
100k 1% | R26 | CC0805 | RES CHIP 100k 150V 125mW 1% | VENKEL | CR0805-8W-1003FT | FITTED | FITTED
100k 1% | R16 | CC0805 | RES CHIP 100k 150V 125mW 1% | VENKEL | CR0805-8W-1003FT | FITTED | FITTED
100k 1% | R21 | CC0805 | RES CHIP 100k 150V 125mW 1% | VENKEL | CR0805-8W-1003FT | FITTED | FITTED
100k 1% | R56 | CC0805 | RES CHIP 100k 150V 125mW 1% | VENKEL | CR0805-8W-1003FT | FITTED | FITTED
100k 1% | R38 | CC0805 | RES CHIP 100k 150V 125mW 1% | VENKEL | CR0805-8W-1003FT | FITTED | FITTED
100k 1% | R22 | CC0805 | RES CHIP 100k 150V 125mW 1% | VENKEL | CR0805-8W-1003FT | FITTED | FITTED
100k 1% | R63 | CC0805 | RES CHIP 100k 150V 125mW 1% | VENKEL | CR0805-8W-1003FT | FITTED | FITTED
100k 1% | R64 | CC0805 | RES CHIP 100k 150V 125mW 1% | VENKEL | CR0805-8W-1003FT | FITTED | FITTED
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
100nF 50V | C13 | CC0805 | CAP X7R 100nF 50V 10% | VENKEL | C0805X7R500-104KN | FITTED | FITTED
100nF 50V | C116 | CC0805 | CAP X7R 100nF 50V 10% | VENKEL | C0805X7R500-104KN | FITTED | FITTED
100nF 50V | C117 | CC0805 | CAP X7R 100nF 50V 10% | VENKEL | C0805X7R500-104KN | FITTED | FITTED
100nF 50V | C22 | CC0805 | CAP X7R 100nF 50V 10% | VENKEL | C0805X7R500-104KN | FITTED | FITTED
100nF 50V | C21 | CC0805 | CAP X7R 100nF 50V 10% | VENKEL | C0805X7R500-104KN | FITTED | FITTED
100nF 50V | C104 | CC0805 | CAP X7R 100nF 50V 10% | VENKEL | C0805X7R500-104KN | FITTED | FITTED
100nF 50V | C76 | CC0805 | CAP X7R 100nF 50V 10% | VENKEL | C0805X7R500-104KN | FITTED | FITTED
100nF 50V | C47 | CC0805 | CAP X7R 100nF 50V 10% | VENKEL | C0805X7R500-104KN | FITTED | FITTED
100nF 50V | C20 | CC0805 | CAP X7R 100nF 50V 10% | VENKEL | C0805X7R500-104KN | FITTED | FITTED
100nF 50V | C16 | CC0805 | CAP X7R 100nF 50V 10% | VENKEL | C0805X7R500-104KN | FITTED | FITTED
100nF 50V | C82 | CC0805 | CAP X7R 100nF 50V 10% | VENKEL | C0805X7R500-104KN | FITTED | FITTED
100nF 50V | C105 | CC0805 | CAP X7R 100nF 50V 10% | VENKEL | C0805X7R500-104KN | FITTED | FITTED
100nF 50V | C111 | CC0805 | CAP X7R 100nF 50V 10% | VENKEL | C0805X7R500-104KN | FITTED | FITTED
100nF 50V | C64 | CC0805 | CAP X7R 100nF 50V 10% | VENKEL | C0805X7R500-104KN | FITTED | FITTED
100nF 50V | C63 | CC0805 | CAP X7R 100nF 50V 10% | VENKEL | C0805X7R500-104KN | FITTED | FITTED
100nF 50V | C65 | CC0805 | CAP X7R 100nF 50V 10% | VENKEL | C0805X7R500-104KN | FITTED | FITTED
100nF 50V | C110 | CC0805 | CAP X7R 100nF 50V 10% | VENKEL | C0805X7R500-104KN | FITTED | FITTED
100nF 50V | C75 | CC0805 | CAP X7R 100nF 50V 10% | VENKEL | C0805X7R500-104KN | FITTED | FITTED
100pF 50V | C46 | CC0805 | CAP COG 100pF 50V 5% | VENKEL | C0805C0G500-101JN | FITTED | FITTED
100pF 50V | C45 | CC0805 | CAP COG 100pF 50V 5% | VENKEL | C0805C0G500-101JN | FITTED | FITTED
110k 1% | R36 | CC0805 | RES CHIP 110k 150V 125mW 1% | VENKEL | CR0805-8W-1103FT | FITTED | FITTED
110k 1% | R41 | CC0805 | RES CHIP 110k 150V 125mW 1% | VENKEL | CR0805-8W-1103FT | FITTED | FITTED
121k 1% | R29 | CC0805 | RES CHIP 121k 150V 125mW 1% | VENKEL | CR0805-8W-1213FT | FITTED | FITTED
182k 1% | R35 | CC0805 | RES CHIP 182k 150V 125mW 1% | VENKEL | CR0805-8W-1823FT | FITTED | FITTED
220pF 50V | C26 | CC0805 | CAP COG 220pF 50V 5% | VENKEL | C0805C0G500-221JN | FITTED | FITTED
220pF 50V | C32 | CC0805 | CAP COG 220pF 50V 5% | VENKEL | C0805C0G500-221JN | FITTED | FITTED
221k 1% | R47 | CC0805 | RES CHIP 221k 150V 125mW 1% | VENKEL | CR0805-8W-2213FT | FITTED | FITTED
221k 1% | R37 | CC0805 | RES CHIP 221k 150V 125mW 1% | VENKEL | CR0805-8W-2213FT | FITTED | FITTED
332k 1% | R27 | CC0805 | RES CHIP 332k 150V 125mW 1% | VENKEL | CR0805-8W-3323FT | FITTED | FITTED
432k 1% | R30 | CC0805 | RES CHIP 432k 150V 125mW 1% | VENKEL | CR0805-8W-4323FT | FITTED | FITTED
470pF 50V | C44 | CC0805 | CAP COG 470pF 50V 5% | VENKEL | C0805C0G500-471JN | FITTED | FITTED
475k 1% | R32 | CC0805 | RES CHIP 475k 150V 125mW 1% | VENKEL | CR0805-8W-4753FT | FITTED | FITTED
619k 1% | R31 | CC0805 | RES CHIP 619k 150V 125mW 1% | VENKEL | CR0805-8W-6193FT | FITTED | FITTED
909k 1% | R33 | CC0805 | RES CHIP 909k 150V 125mW 1% | VENKEL | CR0805-8W-9093FT | FITTED | FITTED
AT27C020 | U2 | PLCC/R-32 | IC 256k x 8 EPROM | ATMEL | AT27C020 | FITTED | FITTED
AT27C020 | U6 | PLCC/R-32 | IC 256k x 8 EPROM | ATMEL | AT27C020 | FITTED | FITTED
AT27C020 | U7 | PLCC/R-32 | IC 256k x 8 EPROM | ATMEL | AT27C020 | FITTED | FITTED
BLM31AJ601SN1 | L1 | CC1206 | IND FERRITE BEAD | MURATA | BLM31AJ601SN1 | FITTED | FITTED
CD74ACT297M | U30 | SO-16 | IC DIGITAL PHASE-LOCKED LOOP | TI | CD74ACT297M | FITTED | FITTED
CD74ACT297M | U21 | SO-16 | IC DIGITAL PHASE-LOCKED LOOP | TI | CD74ACT297M | FITTED | FITTED
CD74HC4024M | U31 | SO-14 | IC 7-STAGE BINARY RIPPLE COUNTER | TI | CD74HC4024M | FITTED | FITTED
CD74HC4024M | U22 | SO-14 | IC 7-STAGE BINARY RIPPLE COUNTER | TI | CD74HC4024M | FITTED | FITTED
DB9S | J2 | DB9/LRS | CON DB9 RECEPTICAL LOW PROFILE | AMP | 747844-5 | FITTED | FITTED
DB25P | P2 | DB25/LRP | CON DB25 PLUG LOW PROFILE | AMP | 747842-5 | FITTED | FITTED
DB25S | J1 | DB25/LRS | CON DB25 RECEPTICAL LOW PROFILE | AMP | 747846-5 | FITTED | FITTED
FIDUCIAL | TOPFIDB | FIDUCIAL(PACK) | FIDUCIAL -SMD VISON TARGET (NOT A REAL COMPONENT) | FIDUCIAL (NOT A REAL COMPONENT) | FIDUCIAL (NOT A REAL COMPONENT) | * | *
FIDUCIAL | TOPFIDA | FIDUCIAL(PACK) | FIDUCIAL -SMD VISON TARGET (NOT A REAL COMPONENT) | FIDUCIAL (NOT A REAL COMPONENT) | FIDUCIAL (NOT A REAL COMPONENT) | * | *
FMMD914 | D2 | SOT-23 | DIODE SILICON PLANAR HIGH SPEED SWITCHING | ZETEX | FMMD914 | FITTED | FITTED
FMMD914 | D1 | SOT-23 | DIODE SILICON PLANAR HIGH SPEED SWITCHING | ZETEX | FMMD914 | FITTED | FITTED
HM628512CLFPI-7 | U36 | RENESAS/FP-32D | IC 512K x 8 SRAM | RENESAS | HM628512CLFPI-7 | FITTED | FITTED
HM628512CLFPI-7 | U35 | RENESAS/FP-32D | IC 512K x 8 SRAM | RENESAS | HM628512CLFPI-7 | FITTED | FITTED
HM628512CLFPI-7 | U38 | RENESAS/FP-32D | IC 512K x 8 SRAM | RENESAS | HM628512CLFPI-7 | FITTED | FITTED
HM628512CLFPI-7 | U37 | RENESAS/FP-32D | IC 512K x 8 SRAM | RENESAS | HM628512CLFPI-7 | FITTED | FITTED
HM628512CLFPI-7 | U34 | RENESAS/FP-32D | IC 512K x 8 SRAM | RENESAS | HM628512CLFPI-7 | FITTED | FITTED
HM628512CLFPI-7 | U33 | RENESAS/FP-32D | IC 512K x 8 SRAM | RENESAS | HM628512CLFPI-7 | FITTED | FITTED
IDC32 | P1 | AMP/1-103169-5 | CON IDC HEADER 0.1" 17x2 | AMP | 1-103169-5 | FITTED | FITTED
LM311M | U16 | SO-8 | IC VOLTAGE COMPARATOR | NAT SEMI | LM311M | FITTED | FITTED
LM311M | U24 | SO-8 | IC VOLTAGE COMPARATOR | NAT SEMI | LM311M | FITTED | FITTED
LM2902D | U47 | SO-14 | IC QUAD OP-AMP -40 to +125C | TI | LM2902D | FITTED | FITTED
LM2902D | U15 | SO-14 | IC QUAD OP-AMP -40 to +125C | TI | LM2902D | FITTED | FITTED
MAX823MEUK-T | U4 | SOT-23/5 | IC 5-PIN uP SUPER WITH W-DOG AND MAN-RESET 4.38V | MAXIUM | MAX823MEUK-T | FITTED | FITTED
MAX3232ECAE | U56 | SO-16 | IC 2RX 2TX RS232 TRANSCEIVER | MAXIM | MAX3232ECAE | FITTED | NOT FITTED
MC74HC4040 | U59 | SO-16 | IC 12-STAGE RIPPLE CARRY BINARY COUNTER | FAIRCHILD | MM74HC4040M | FITTED | FITTED
MISC-LOGO | A1 | STARLITE | LOGO |  |  | FITTED | FITTED
MM7HC4052M | U3 | SO-16 | IC DUAL 4-CHANNEL ANALOG MULTIPLEXOR | FAIRCHILD | MM74HC4052M | FITTED | FITTED
MM74HC00M | U67 | SO-14 | IC QUAD 2-INPUT NAND GATE | FAIRCHILD | MM74HC00M | FITTED | FITTED
MM74HC00M | U65 | SO-14 | IC QUAD 2-INPUT NAND GATE | FAIRCHILD | MM74HC00M | FITTED | FITTED
MM74HC00M | U57 | SO-14 | IC QUAD 2-INPUT NAND GATE | FAIRCHILD | MM74HC00M | FITTED | FITTED
MM74HC04M | U64 | SO-14 | IC HEX INVERTER | FAIRCHILD | MM74HC04M | FITTED | FITTED
MM74HC04M | U39 | SO-14 | IC HEX INVERTER | FAIRCHILD | MM74HC04M | FITTED | FITTED
MM74HC04M | U46 | SO-14 | IC HEX INVERTER | FAIRCHILD | MM74HC04M | FITTED | FITTED
MM74HC74AM | U43 | SO-14 | IC DUAL D-TYPE FLIP FLOP | FAIRCHILD | MM74HC74AM | FITTED | FITTED
MM74HC74AM | U66 | SO-14 | IC DUAL D-TYPE FLIP FLOP | FAIRCHILD | MM74HC74AM | FITTED | FITTED
MM74HC74AM | U19 | SO-14 | IC DUAL D-TYPE FLIP FLOP | FAIRCHILD | MM74HC74AM | FITTED | FITTED
MM74HC74AM | U58 | SO-14 | IC DUAL D-TYPE FLIP FLOP | FAIRCHILD | MM74HC74AM | FITTED | FITTED
MM74HC74AM | U28 | SO-14 | IC DUAL D-TYPE FLIP FLOP | FAIRCHILD | MM74HC74AM | FITTED | FITTED
MM74HC86M | U61 | SO-14 | IC QUAD 2-INPUT XOR GATE | FAIRCHILD | MM74HC86M | FITTED | FITTED
MM74HC86M | U25 | SO-14 | IC QUAD 2-INPUT XOR GATE | FAIRCHILD | MM74HC86M | FITTED | FITTED
MM74HC86M | U62 | SO-14 | IC QUAD 2-INPUT XOR GATE | FAIRCHILD | MM74HC86M | FITTED | FITTED
MM74HC86M | U32 | SO-14 | IC QUAD 2-INPUT XOR GATE | FAIRCHILD | MM74HC86M | FITTED | FITTED
MM74HC86M | U13 | SO-14 | IC QUAD 2-INPUT XOR GATE | FAIRCHILD | MM74HC86M | FITTED | FITTED
MM74HC86M | U23 | SO-14 | IC QUAD 2-INPUT XOR GATE | FAIRCHILD | MM74HC86M | FITTED | FITTED
MM74HC164M | U40 | SO-14 | IC 8-BIT SERIAL-IN / PARALLEL-OUT SHIGT REGISTER | FAIRCHILD | MM74HC164M | FITTED | FITTED
MM74HC164M | U29 | SO-14 | IC 8-BIT SERIAL-IN / PARALLEL-OUT SHIGT REGISTER | FAIRCHILD | MM74HC164M | FITTED | FITTED
MM74HC164M | U45 | SO-14 | IC 8-BIT SERIAL-IN / PARALLEL-OUT SHIGT REGISTER | FAIRCHILD | MM74HC164M | FITTED | FITTED
MM74HC164M | U63 | SO-14 | IC 8-BIT SERIAL-IN / PARALLEL-OUT SHIGT REGISTER | FAIRCHILD | MM74HC164M | FITTED | FITTED
MM74HC164M | U27 | SO-14 | IC 8-BIT SERIAL-IN / PARALLEL-OUT SHIGT REGISTER | FAIRCHILD | MM74HC164M | FITTED | FITTED
MM74HC164M | U26 | SO-14 | IC 8-BIT SERIAL-IN / PARALLEL-OUT SHIGT REGISTER | FAIRCHILD | MM74HC164M | FITTED | FITTED
MM74HC164M | U42 | SO-14 | IC 8-BIT SERIAL-IN / PARALLEL-OUT SHIGT REGISTER | FAIRCHILD | MM74HC164M | FITTED | FITTED
MM74HC164M | U44 | SO-14 | IC 8-BIT SERIAL-IN / PARALLEL-OUT SHIGT REGISTER | FAIRCHILD | MM74HC164M | FITTED | FITTED
MM74HC164M | U20 | SO-14 | IC 8-BIT SERIAL-IN / PARALLEL-OUT SHIGT REGISTER | FAIRCHILD | MM74HC164M | FITTED | FITTED
MM74HC164M | U41 | SO-14 | IC 8-BIT SERIAL-IN / PARALLEL-OUT SHIGT REGISTER | FAIRCHILD | MM74HC164M | FITTED | FITTED
MM74HC164M | U17 | SO-14 | IC 8-BIT SERIAL-IN / PARALLEL-OUT SHIGT REGISTER | FAIRCHILD | MM74HC164M | FITTED | FITTED
MM74HC164M | U18 | SO-14 | IC 8-BIT SERIAL-IN / PARALLEL-OUT SHIGT REGISTER | FAIRCHILD | MM74HC164M | FITTED | FITTED
MM74HC245AWM | U8 | SO-20W | IC OCTAL 3-STATE TRANSCEIVER | FAIRCHILD | MM74HC245AWM | FITTED | FITTED
MMBT3904LT1 | Q2 | SOT-23 | TRANSISTOR NPN GENERAL PURPOSE 40V 100mA | ON SEMI | MMBT3904LT1 | FITTED | FITTED
MMBT3904LT1 | Q1 | SOT-23 | TRANSISTOR NPN GENERAL PURPOSE 40V 100mA | ON SEMI | MMBT3904LT1 | FITTED | FITTED
MMFT2N02ELT1 | Q5 | SOT-223 | MOSFET POWER N CHANNEL 2A 20V | ON SEMI | MMFT2N02ELT1 | FITTED | FITTED
MMFT2N02ELT1 | Q8 | SOT-223 | MOSFET POWER N CHANNEL 2A 20V | ON SEMI | MMFT2N02ELT1 | FITTED | FITTED
MMFT2N02ELT1 | Q6 | SOT-223 | MOSFET POWER N CHANNEL 2A 20V | ON SEMI | MMFT2N02ELT1 | FITTED | FITTED
MMFT2N02ELT1 | Q10 | SOT-223 | MOSFET POWER N CHANNEL 2A 20V | ON SEMI | MMFT2N02ELT1 | FITTED | FITTED
MMFT2N02ELT1 | Q9 | SOT-223 | MOSFET POWER N CHANNEL 2A 20V | ON SEMI | MMFT2N02ELT1 | FITTED | FITTED
MMFT2N02ELT1 | Q7 | SOT-223 | MOSFET POWER N CHANNEL 2A 20V | ON SEMI | MMFT2N02ELT1 | FITTED | FITTED
MMFT2N02ELT1 | Q3 | SOT-223 | MOSFET POWER N CHANNEL 2A 20V | ON SEMI | MMFT2N02ELT1 | FITTED | FITTED
MMFT2N02ELT1 | Q4 | SOT-223 | MOSFET POWER N CHANNEL 2A 20V | ON SEMI | MMFT2N02ELT1 | FITTED | FITTED
MX614DW | U48 | SO-16W | IC BELL 202 MODEM | CML | MX614DW | FITTED | FITTED
PSEUDO-LAYERWINDOW | PSEUDO1 | WINDOW-4 | Pseudo schematic part used in PCB layout. |  |  | FITTED | FITTED
PSEUDO-TITLE-BLOCK | PSEUDO2 | BOARD-TITLE-BLOCK | Pseudo schematic part used in PCB layout. |  |  | FITTED | FITTED
QL8X12B-1PL68M | U10 | PLCC-68 | IC QL8x12B PLCC68 | QUICKLOGIC | QL8x12B-1PL68M | FITTED | FITTED
SN74HC32NSR | U68 | SO-16 | IC SN74HC32NSR QUAD 2 I/P POSITIVE OR GATES SO14 |  |  | FITTED | FITTED
SOT 1% | R49 | CC0805 | RES CHIP S.O.T. 150V 125mW 1% | VENKEL | CR0805-8W-????FT | FITTED | FITTED
TN80C188EB20 | U9 | PLCC-84 | IC 16-BIT HIGH-INTEGRATION EMBEDDED PROCESSOR | INTEL | TN80C188EB20 | FITTED | FITTED
TP | TP9 | TP3 | Test Point |  |  | FITTED | FITTED
TP | TP8 | TP3 | Test Point |  |  | FITTED | FITTED
TP | TP17 | TP3 | Test Point |  |  | FITTED | FITTED
TP | TP12 | TP3 | Test Point |  |  | FITTED | FITTED
TP | TP11 | TP3 | Test Point |  |  | FITTED | FITTED
TP | TP10 | TP3 | Test Point |  |  | FITTED | FITTED
TP | TP19 | TP3 | Test Point |  |  | FITTED | FITTED
TP | TP20 | TP3 | Test Point |  |  | FITTED | FITTED
TP | TP18 | TP3 | Test Point |  |  | FITTED | FITTED
TP | TP16 | TP3 | Test Point |  |  | FITTED | FITTED
TP | TP15 | TP3 | Test Point |  |  | FITTED | FITTED
TP | TP14 | TP3 | Test Point |  |  | FITTED | FITTED
TP | TP13 | TP3 | Test Point |  |  | FITTED | FITTED
TP | TP7 | TP3 | Test Point |  |  | FITTED | FITTED
TP | TP2 | TP3 | Test Point |  |  | FITTED | FITTED
TP | TP5 | TP3 | Test Point |  |  | FITTED | FITTED
TP | TP6 | TP3 | Test Point |  |  | FITTED | FITTED
TP | TP3 | TP3 | Test Point |  |  | FITTED | FITTED
TP | TP4 | TP3 | Test Point |  |  | FITTED | FITTED
TP | TP1 | TP3 | Test Point |  |  | FITTED | FITTED
TRIANGLE2A | LK2 | 805 | 2 WAY TRIANGLE JUMPERS. PRELINKED |  | REMOVE FROM BOM | FITTED | FITTED
TRIANGLE2A | LK1 | 805 | 2 WAY TRIANGLE JUMPERS. PRELINKED |  | REMOVE FROM BOM | FITTED | FITTED
TRIANGLE2A | LK3 | 805 | 2 WAY TRIANGLE JUMPERS. PRELINKED |  | REMOVE FROM BOM | FITTED | FITTED
TRIANGLE3B | LK4 | 0805_X2 | 3 WAY TRIANGLE JUMPERS. PRELINKED 3-2 |  | REMOVE FROM BOM | FITTED | FITTED
Z85230 16 V E C | U55 | PLCC-44 | IC ZILOG ESCC. | ZILOG | Z85230 16 V E C | FITTED | FITTED
