AMSAT-ZL/KiwiSAT_Sub-Systems/FM_Receivers/Production BOM_v1.0.xls

Part Type | Designator | Footprint | Quantity per Unit | Total for 6 Units
U2796B | IC2 | SO-8 | 1 | 6
SMA_RECEPTACLE | CN1 | CON_SMA_RA | 1 | 6
NJM78L08UA | IC10, IC4, IC3 | IC_SOT89 | 3 | 18
NFM61RH20T332T1 | FL2, FL3, FL4, FL5, FL6, FL7 | FILTER_NFE61H | 6 | 36
MBRS130LT3 | D1 | SMB(403A) | 1 | 6
LM2904 | IC5, IC6 | SO-8 | 2 | 12
INA-03184 | IC1 | IC_MMIC_84 | 1 | 6
IC_SA605 | IC7 | SOJ20/400 | 1 | 6
HELICAL_FILTER-5CHW | FL1 | FILTER_5CHW | 1 | 6
HELICAL_FILTER-5CHW | FL12, FL13 | FILTER_5CHW | 2 | 12
DNS | C15 | CAP_0805 |  | 0
DNS | C28 | CAP_0805 |  | 0
DNS | C33 | CAP_0805 |  | 0
DNS | C54 | CAP_0805 |  | 0
DNS | C8 | CAP_0805 |  | 0
DNS | FL11 | XTAL_QC44 |  | 0
DNS | L2 | IND_0805_1210 |  | 0
DNS | L7 | IND_0805_1210 |  | 0
DNS | R11 | RES_0805 |  | 0
DNS | R2 | RES_0805 |  | 0
DNS | R22 | RES_0805 |  | 0
DNS | R3 | RES_0805 |  | 0
DNS | R4 | RES_0805 |  | 0
CON_DB9B | CN2 | CON_DB9RA_PLUG | 1 | 6
CFU445B2 | FL8, FL9 | FILTER_PBFS_CFT | 2 | 12
9nH | L1 | IND_0805_1210 | 1 | 6
8.2uH | L6 | IND_0805_1210 | 1 | 6
7pF NPO | C7 | CAP_0805 | 1 | 6
68pF NPO | C32 | CAP_0805 | 1 | 6
680pF | C1, C10, C11, C16, C3, C45, C49, C5, C53, C6, C9 | CAP_0805 | 11 | 66
6.8k | R21 | RES_0805 | 1 | 6
5pF NPO | C60 | CAP_0805 | 1 | 6
56nH | L8 | IND_0805_1210 | 1 | 6
47R | R13 | RES_0805 | 1 | 6
47pF NPO | C34 | CAP_0805 | 1 | 6
47pF | C55 | CAP_0805 | 1 | 6
47k | R16, R17 | RES_0805 | 2 | 12
470R | R19, R20 | RES_0805 | 2 | 12
470k | R6 | RES_0805 | 1 | 6
4.7k | R10, R26 | RES_0805 | 2 | 12
390pF NPO | C27 | CAP_0805 | 1 | 6
390k | R8 | RES_0805 | 1 | 6
33pf NPO | C48 | CAP_0805 | 1 | 6
330nH | L10 | IND_0805_1210 | 1 | 6
300R | R25, R27, R28, R30 | RES_0805 | 4 | 24
2SC3356 | TR1, TR2 | IC_SOT23_3_BCE | 2 | 12
2pF NPO | C59 | CAP_0805 | 1 | 6
27nH | L9 | IND_0805_1210 | 1 | 6
270uH | L5 | TRANS_TOKO_7P | 1 | 6
240k | R24 | RES_0805 | 1 | 6
22pF NPO | C13 | CAP_0805 | 1 | 6
21.4MHz 30kHz | FL10 | XTAL_QC44 | 1 | 6
20R | R29 | RES_0805 | 1 | 6
20.945MHz | X1 | XTAL_QC_41 | 1 | 6
2.2k | R7 | RES_0805 | 1 | 6
1uF 16V 0805 | C18, C21, C41, C42, C43, C44 | CAP_3216 | 6 | 36
15pF NPO | C30 | CAP_0805 | 1 | 6
150pF NPO | C14, C39 | CAP_0805 | 2 | 12
150nH | L3, L4 | IND_0805_1210 | 2 | 12
1-10pF | C12, C56, C58 | CAP_JR100 | 3 | 18
10pF NPO | C25, C46 | CAP_0805 | 2 | 12
10nF | C26, C35, C36, C37, C38, C40 | CAP_0805 | 6 | 36
10k 5% NTC | RT1 | CAP_0805 | 1 | 6
10k | R5, R9, R999 | RES_0805 | 3 | 18
106.25MHz | X2 | XTAL_QC_41 | 1 | 6
100R | R1, R23 | RES_0805 | 2 | 12
100pF NPO | C57 | CAP_0805 | 1 | 6
100nF | C17, C19, C2, C20, C22, C23, C24, C31, C4, C47, C50, C51, C52, C61 | CAP_0805 | 14 | 84
100k | R12, R14, R15, R18 | RES_0805 | 4 | 24
0.5pF NPO | C29 | CAP_0805 | 1 | 6
