AMSAT-ZL/KiwiSAT_Sub-Systems/Camera/Camera_V2.DXF

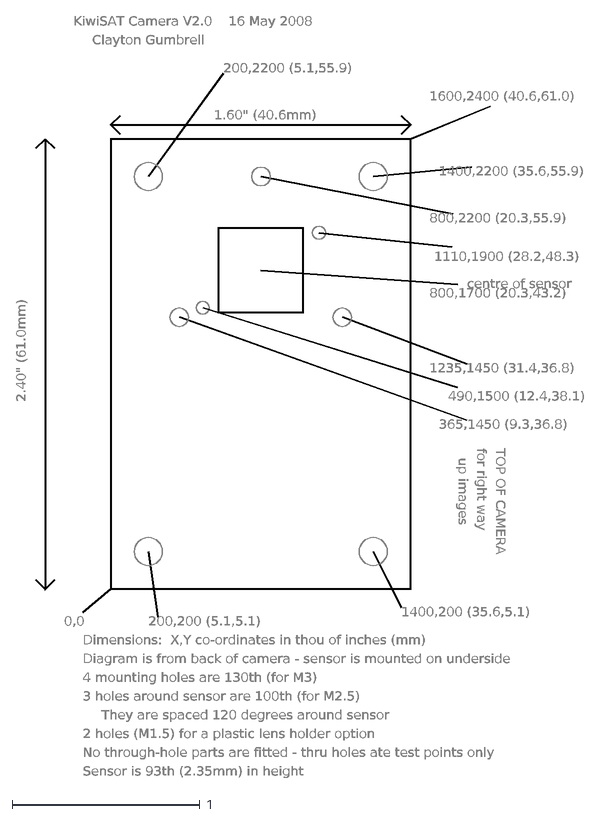
[picture p105: CAD file, 2021-08-17]
Camera/Camera_V2.DXF
1.60" (40.6mm)
2.40" (61.0mm)
0,0
200,200 (5.1,5.1)
1400,200 (35.6,5.1)
365,1450 (9.3,36.8)
1235,1450 (31.4,36.8)
centre of sensor
800,1700 (20.3,43.2)
800,2200 (20.3,55.9)
1400,2200 (35.6,55.9)
1600,2400 (40.6,61.0)
200,2200 (5.1,55.9)
4 mounting holes are 130th (for M3)
3 holes around sensor are 100th (for M2.5)
2 holes (M1.5) for a plastic lens holder option
Sensor is 93th (2.35mm) in height
They are spaced 120 degrees around sensor
Dimensions: X,Y co-ordinates in thou of inches (mm)
No through-hole parts are fitted - thru holes ate test points only
1110,1900 (28.2,48.3)
490,1500 (12.4,38.1)
Diagram is from back of camera - sensor is mounted on underside
KiwiSAT Camera V2.0 16 May 2008
Clayton Gumbrell
TOP OF CAMERA
for right way
up images
