AMSAT-ZL/KiwiSAT_Sub-Systems/Launch Adapter/Launch Adaptor - Concept 1 (CGWIC).dxf

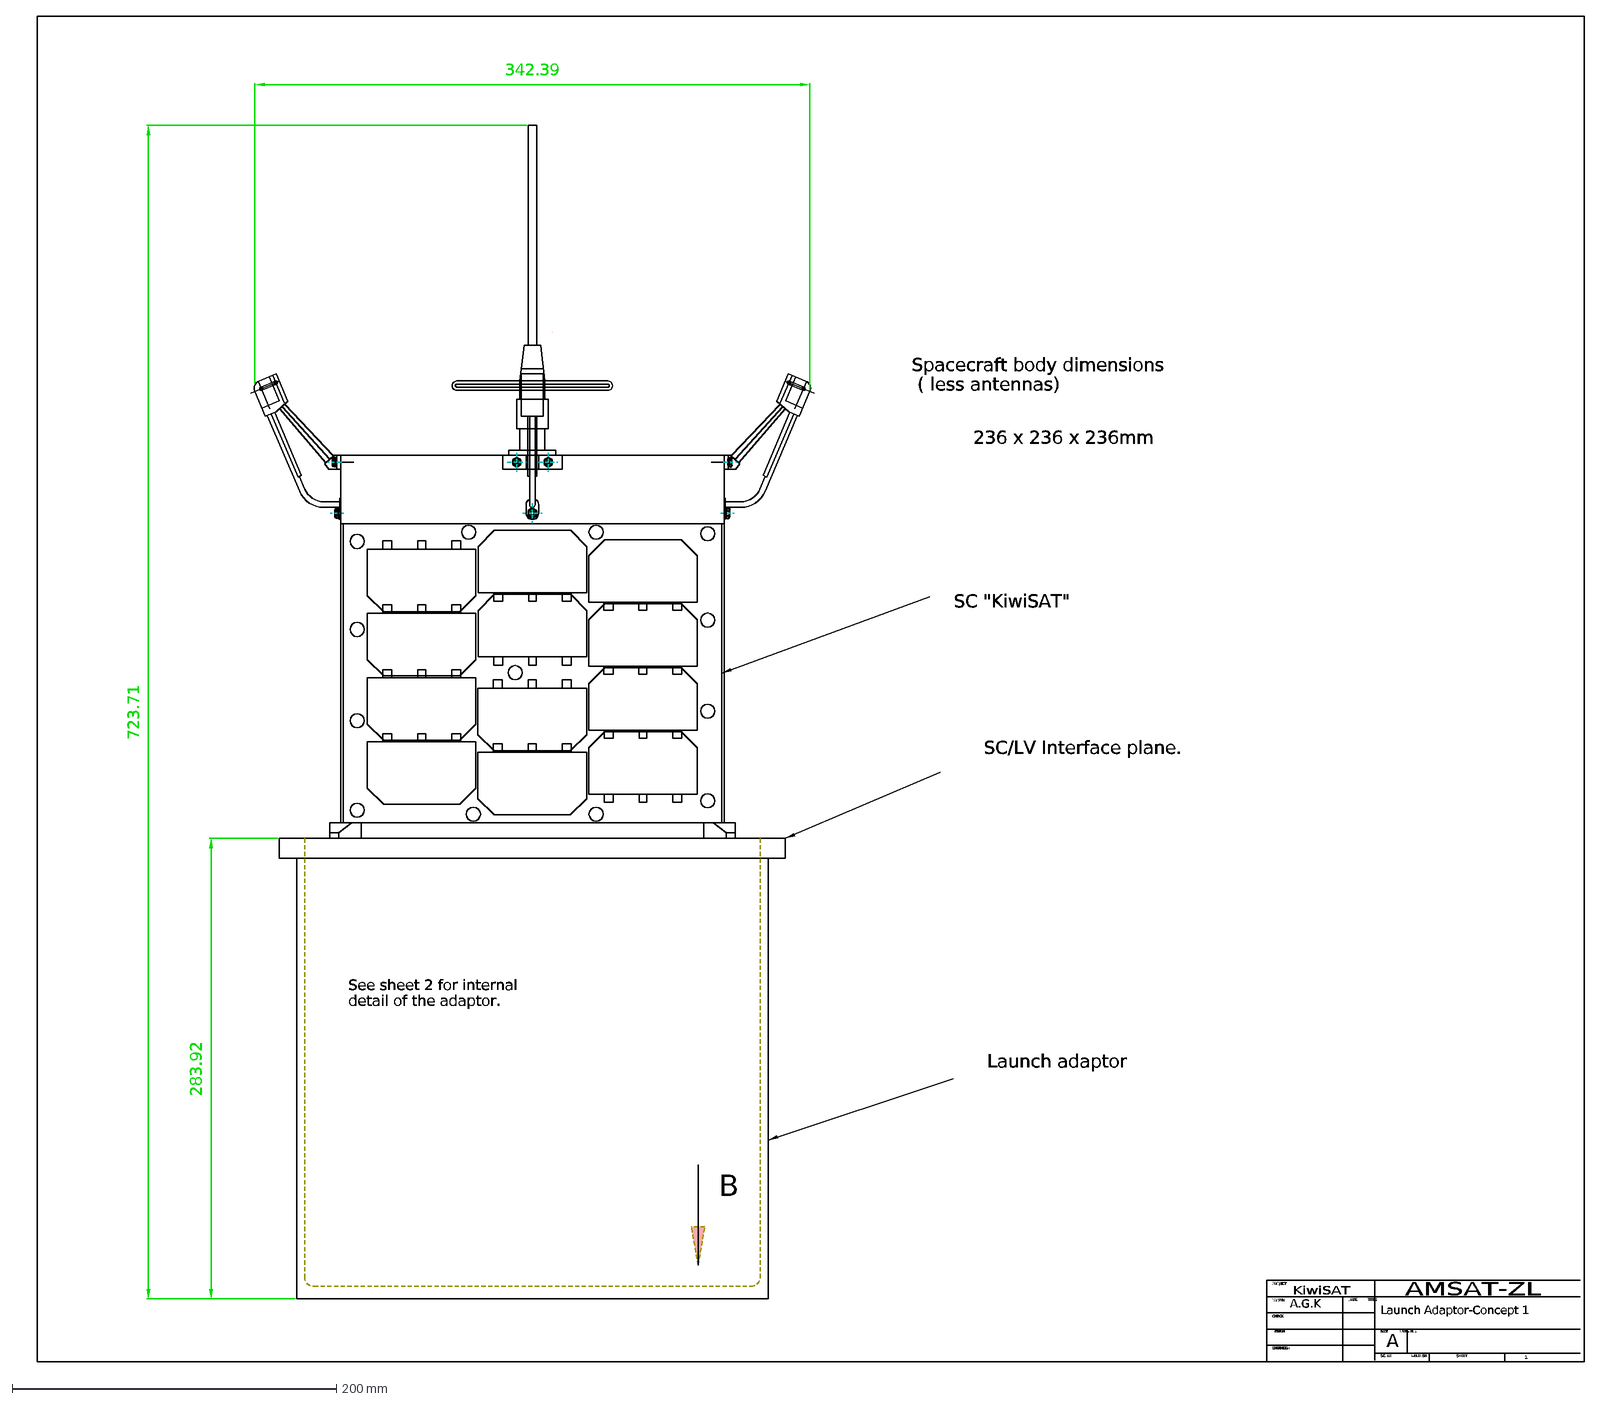
[picture p106: CAD file, 2021-09-17]
Launch Adapter/Launch Adaptor - Concept 1 (CGWIC).dxf
SCALE RELEASED SHEET
AMSAT-ZL
KiwiSAT
DESIGN
ENGINEER
DRAWN
CHECK
PROJECT
DATE TITLE
SIZE DWG. NO.
A
B
Launch adaptor
SC "KiwiSAT"
SC/LV Interface plane.
1
A.G.K
Launch Adaptor-Concept 1
See sheet 2 for internal
detail of the adaptor.
Spacecraft body dimensions
( less antennas)
236 x 236 x 236mm
283.92
723.71
342.39
