AMSAT-ZL/KiwiSAT_Sub-Systems/LBandDownConverter/LBandCon_V1.DXF

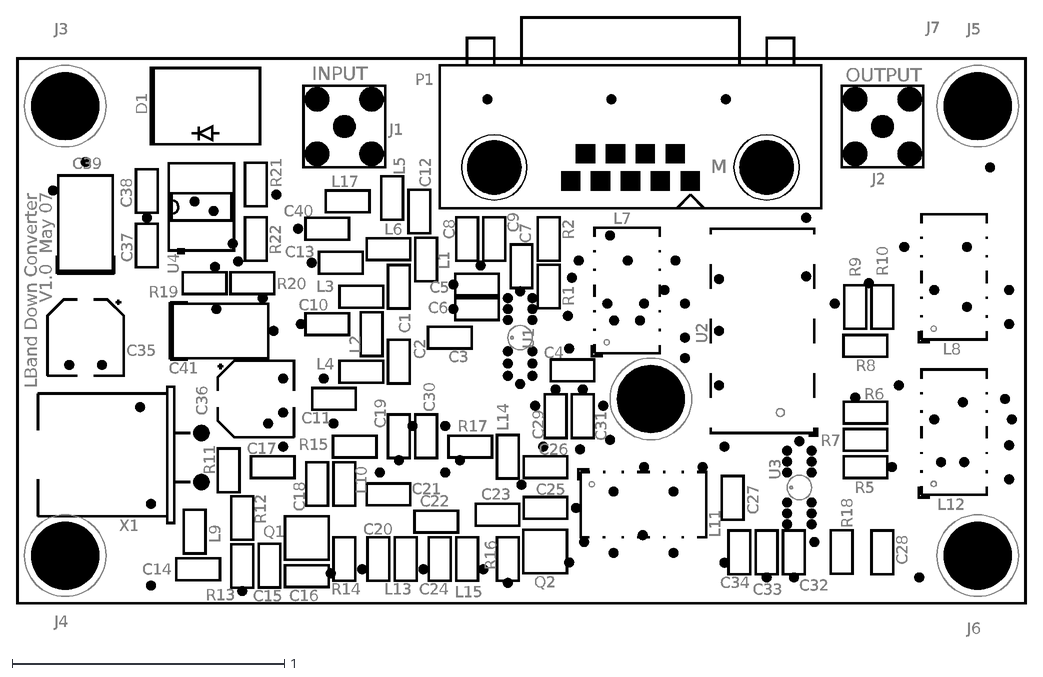
[picture p107: CAD file, 2021-08-17]
LBandDownConverter/LBandCon_V1.DXF
J1
M
P1
J2
L17
C40
L5
C12
L1
L2
L3
L4
L6
L7
L8
C1
C2
C3
C4
C7
C8
C9
U1
R1
R2
R5
R6
R7
R8
R9
R10
U2
C13
C10
C11
C27
L12
C28
U3
L11
C26
Q2
L14
R17
C30
C29
C31
R16
C23
L15
C24
C22
C20
L13
C21
C18
L10
Q1
R14
C15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
