AMSAT-ZL/KiwiSAT_Sub-Systems/Launch Adapter/Launch Adaptor Concept 2 (CGWIC).dxf

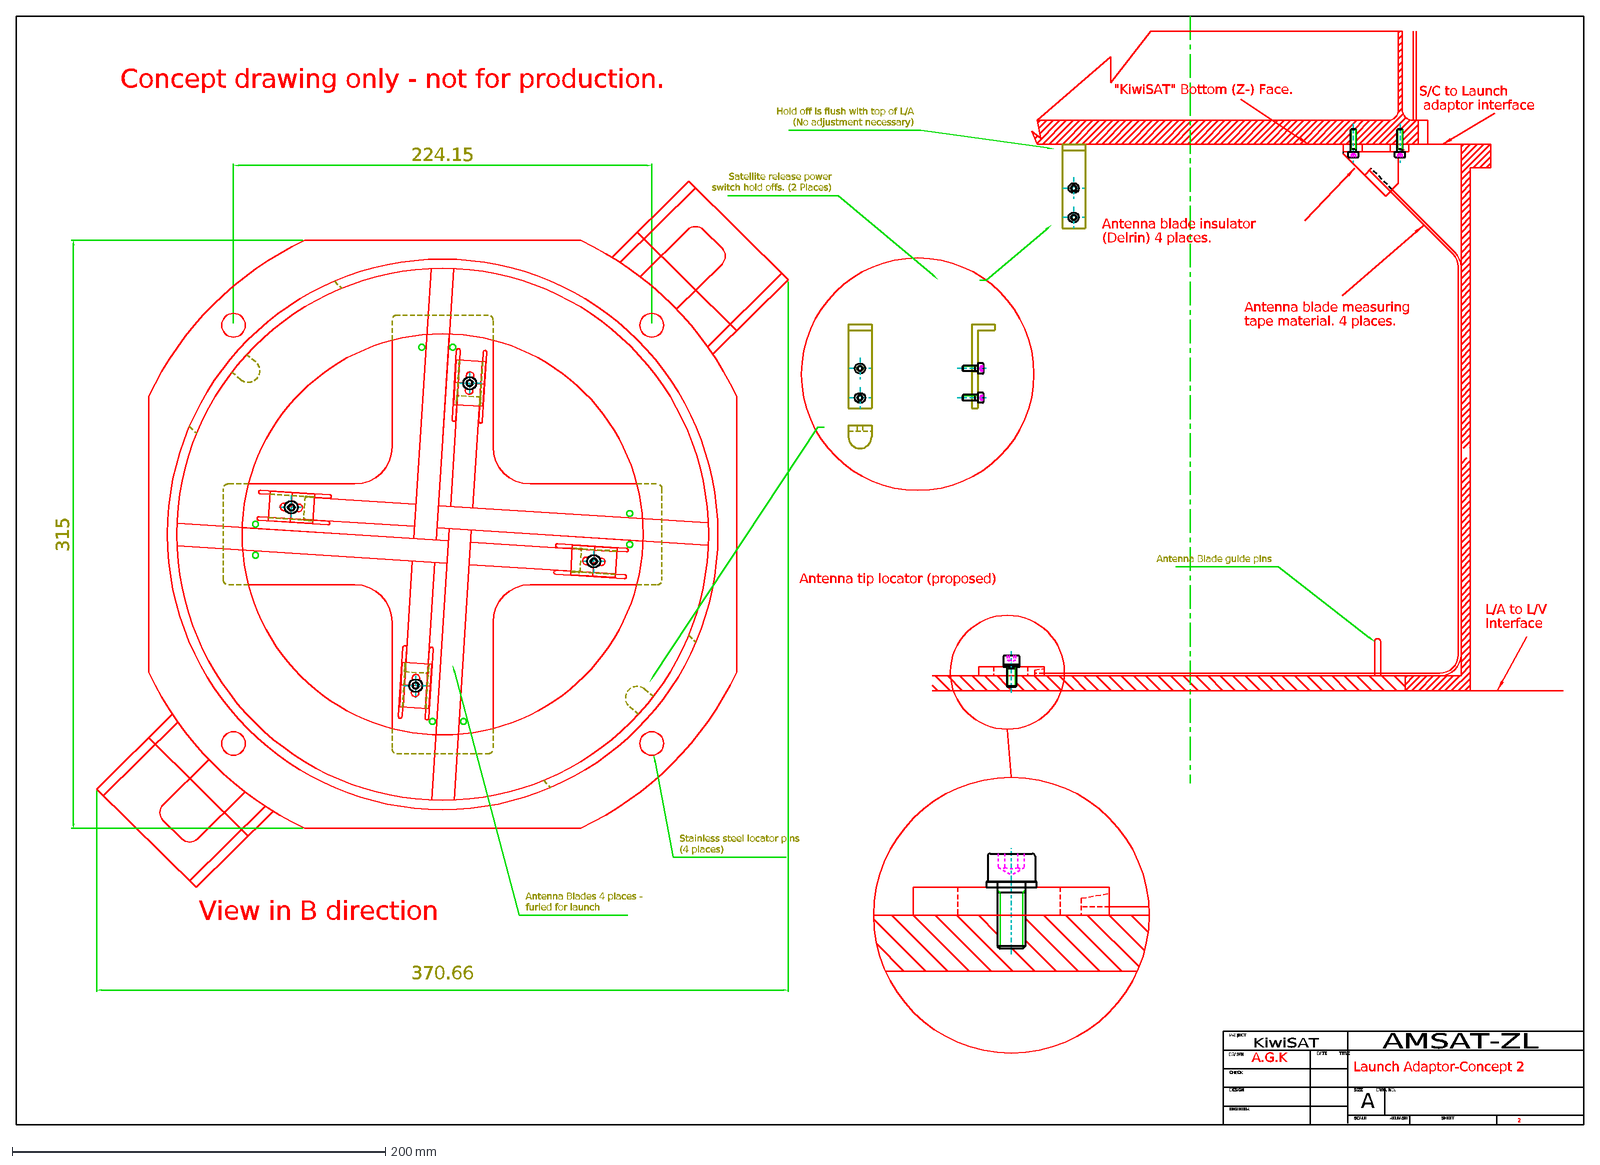
[picture p109: CAD file, 2021-09-17]
Launch Adapter/Launch Adaptor Concept 2 (CGWIC).dxf
SCALE RELEASED SHEET
AMSAT-ZL
KiwiSAT
DESIGN
ENGINEER
DRAWN
CHECK
PROJECT
DATE TITLE
SIZE DWG. NO.
A
Concept drawing only - not for production.
Antenna tip locator (proposed)
"KiwiSAT" Bottom (Z-) Face.
Antenna blade insulator
(Delrin) 4 places.
Antenna blade measuring
tape material. 4 places.
S/C to Launch
adaptor interface
L/A to L/V
Interface
2
Launch Adaptor-Concept 2
A.G.K
View in B direction
224.15
Satellite release power switch hold offs. (2 Places)
Hold off is flush with top of L/A (No adjustment necessary)
Antenna Blade guide pins
315
Antenna Blades 4 places - furled for launch
Stainless steel locator pins (4 places)
370.66
