AMSAT-ZL/KiwiSAT_Sub-Systems/Mechanical/Tray - BCR Layout.dxf

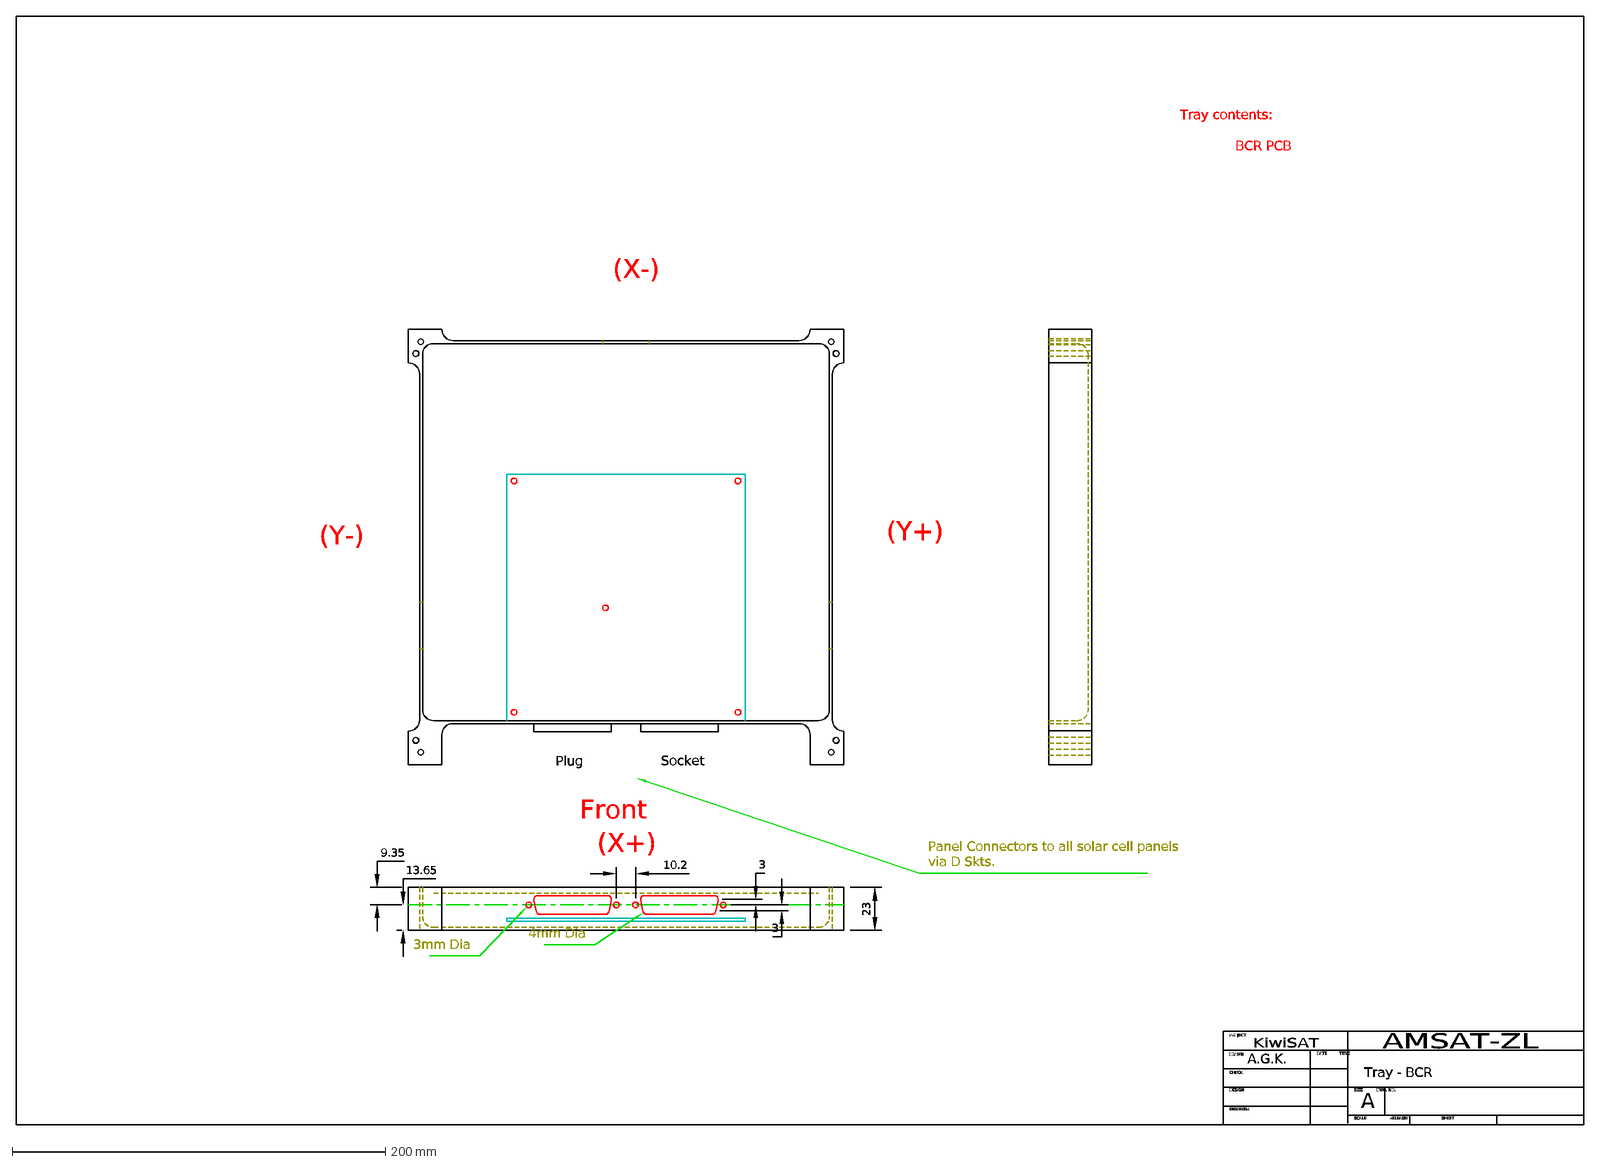
[picture p110: CAD file, 2021-08-17]
Mechanical/Tray - BCR Layout.dxf
SCALE RELEASED SHEET
AMSAT-ZL
KiwiSAT
DESIGN
ENGINEER
DRAWN
CHECK
PROJECT
DATE TITLE
SIZE DWG. NO.
A
A.G.K.
Tray - BCR
4mm Dia
3
3mm Dia
Plug
Socket
Panel Connectors to all solar cell panels via D Skts.
23
Tray contents:
BCR PCB
9.35
13.65
10.2
Front
(X+)
(Y+)
(Y-)
(X-)
