AMSAT-ZL/KiwiSAT_Sub-Systems/Mechanical/Tray - Receivers Layout.dxf

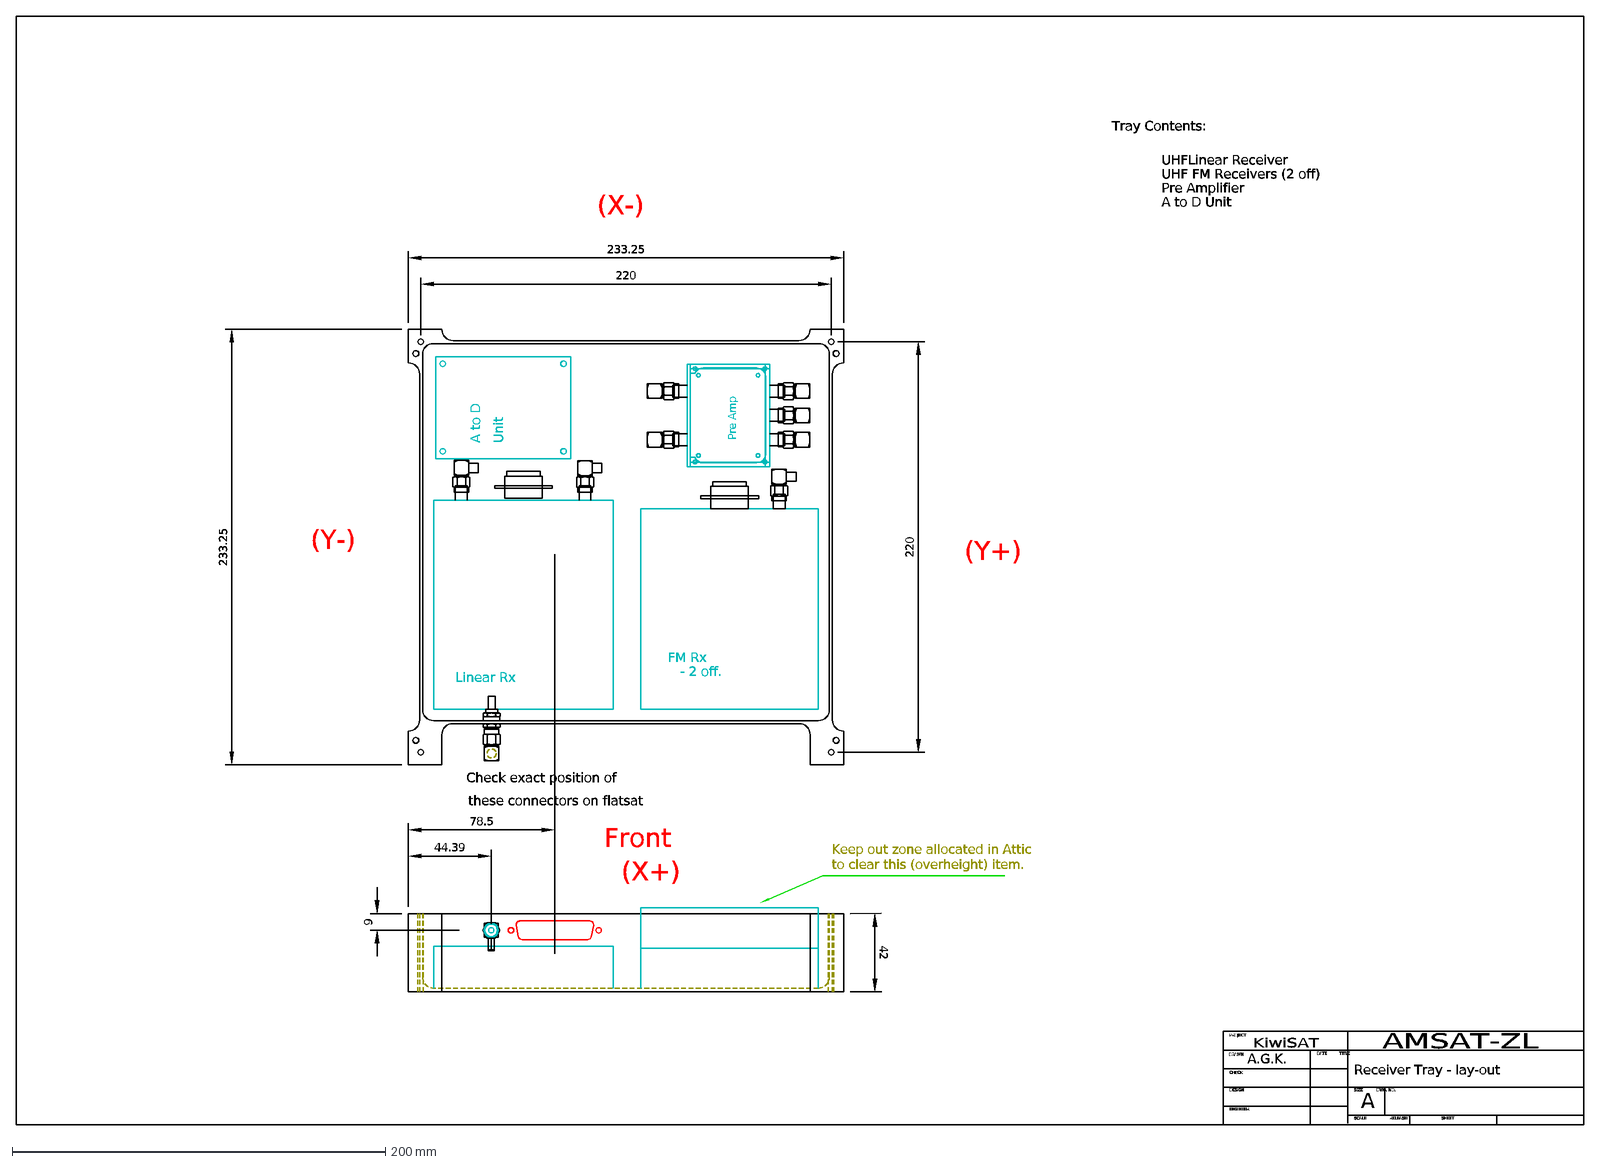
[picture p111: CAD file, 2021-08-17]
Mechanical/Tray - Receivers Layout.dxf
SCALE RELEASED SHEET
AMSAT-ZL
KiwiSAT
DESIGN
ENGINEER
DRAWN
CHECK
PROJECT
DATE TITLE
SIZE DWG. NO.
A
A.G.K.
233.25
Receiver Tray - lay-out
A to D
Unit
Linear Rx
FM Rx
- 2 off.
Keep out zone allocated in Attic to clear this (overheight) item.
Pre Amp
44.39
78.5
9
Check exact position of
these connectors on flatsat
220
42
Tray Contents:
UHFLinear Receiver
UHF FM Receivers (2 off)
Pre Amplifier
A to D Unit
Front
(X+)
(Y+)
(Y-)
(X-)
