AMSAT-ZL/KiwiSAT_Sub-Systems/Mechanical/Tray - Transmitter Layout.dxf

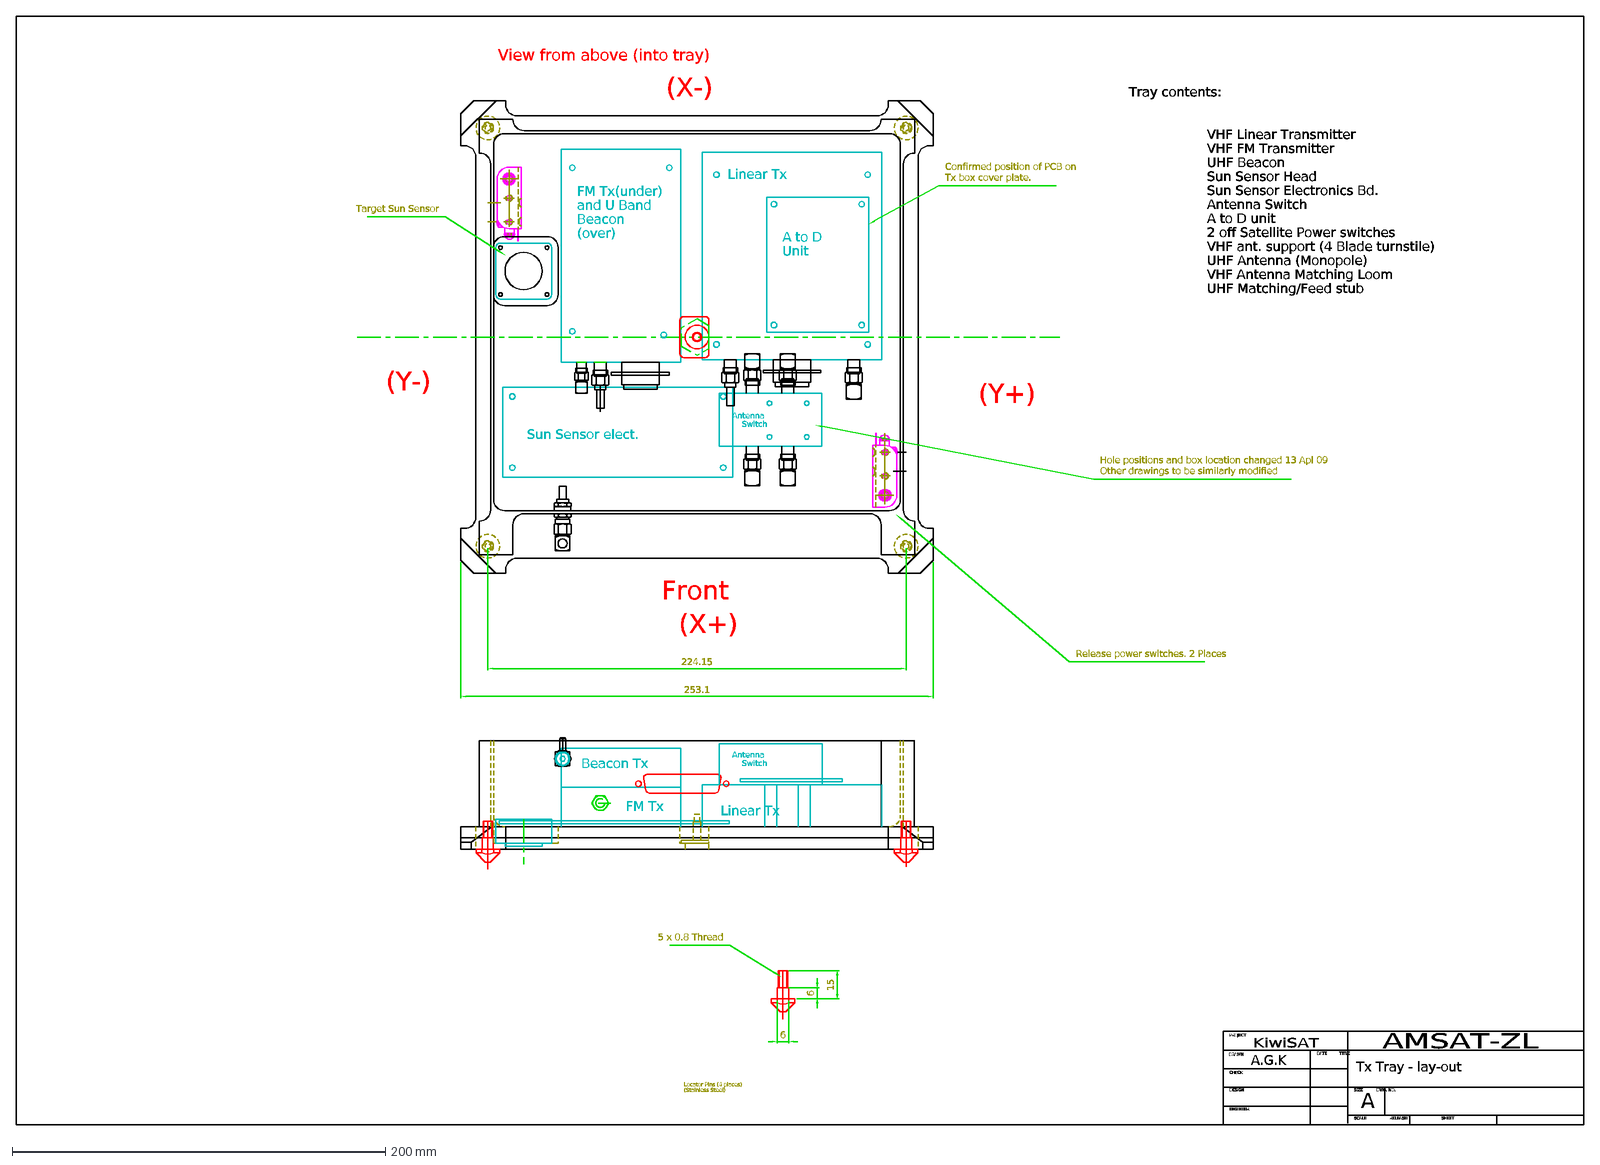
[picture p112: CAD file, 2021-08-17]
Mechanical/Tray - Transmitter Layout.dxf
SCALE RELEASED SHEET
AMSAT-ZL
KiwiSAT
DESIGN
ENGINEER
DRAWN
CHECK
PROJECT
DATE TITLE
SIZE DWG. NO.
A
View from above (into tray)
6
15
5 x 0.8 Thread
Locator Pins (4 places)
(Stainless Steel)
253.1
224.15
Tx Tray - lay-out
Sun Sensor elect.
Linear Tx
A to D
Unit
FM Tx(under)
and U Band
Beacon
(over)
Target Sun Sensor
FM Tx
Beacon Tx
Release power switches. 2 Places
A.G.K
Confirmed position of PCB on Tx box cover plate.
Tray contents:
VHF Linear Transmitter
VHF FM Transmitter
UHF Beacon
Sun Sensor Head
Sun Sensor Electronics Bd.
Antenna Switch
A to D unit
2 off Satellite Power switches
VHF ant. support (4 Blade turnstile)
UHF Antenna (Monopole)
VHF Antenna Matching Loom
UHF Matching/Feed stub
Antenna
Switch
Hole positions and box location changed 13 Apl 09 Other drawings to be similarly modified
Front
(X+)
(Y+)
(Y-)
(X-)
