AMSAT-ZL/KiwiSAT_Sub-Systems/Mechanical/Tray - IHU Layout.dxf

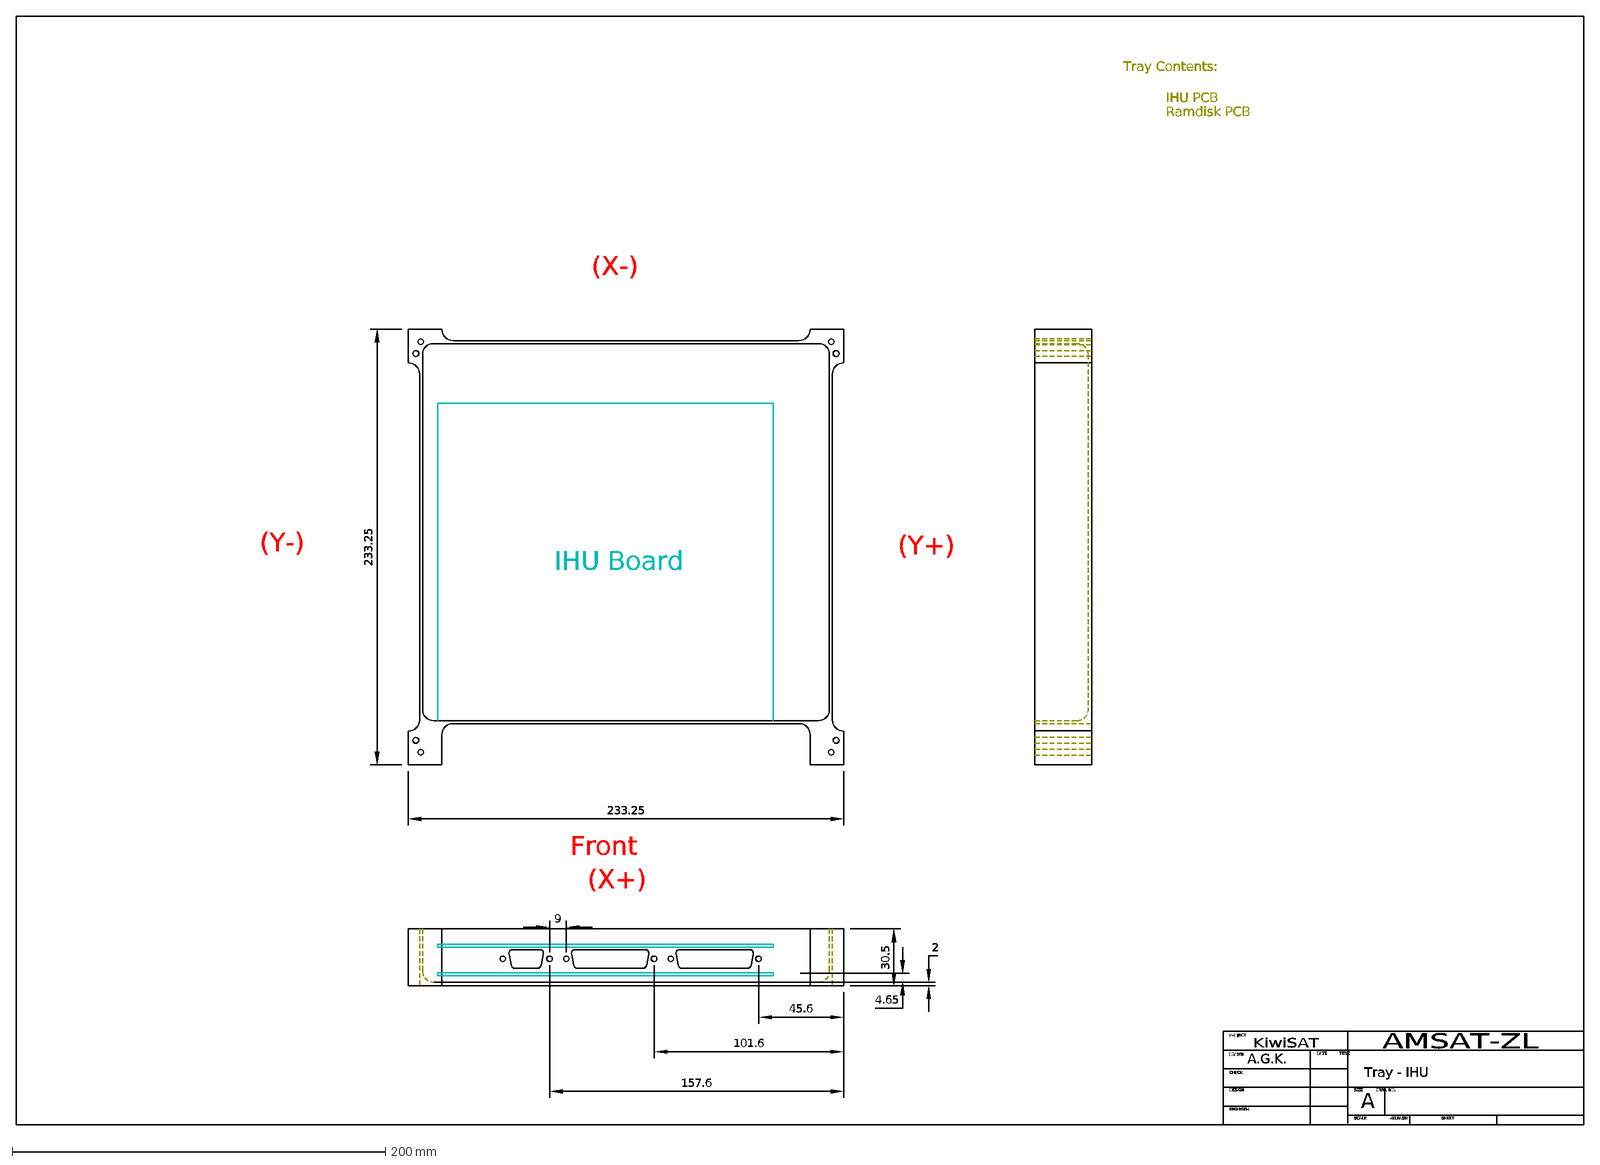
[picture p113: CAD file, 2021-08-17]
Mechanical/Tray - IHU Layout.dxf
SCALE RELEASED SHEET
AMSAT-ZL
KiwiSAT
DESIGN
ENGINEER
DRAWN
CHECK
PROJECT
DATE TITLE
SIZE DWG. NO.
A
A.G.K.
Tray - IHU
233.25
IHU Board
30.5
Tray Contents:
IHU PCB
Ramdisk PCB
2
4.65
9
Front
(X+)
(Y+)
(Y-)
(X-)
45.6
101.6
157.6
