AMSAT-ZL/KiwiSAT_Sub-Systems/(list of files, cad)

Other CAD files:
Mechanical/Tray - Attic Layout (under).dwg
LBandDownConverter/KiwiSAT - L Band Converter Box 3.dwg
Launch Adapter/Launch drum with pushers for CGWIC.dwg
Sun_Sensor/OldFiles/Old design and mechanical/sun sensor (ham) pcb.dwg
Sun_Sensor/OldFiles/Old design and mechanical/new sun sensor 4.dxf
Mechanical/Tray-Attic_Layout_(under).dwg
Sun_Sensor/OldFiles/Old design and mechanical/new sun sensor 4.dwg
