AMSAT-ZL/KiwiSAT_Sub-Systems/Wiring_Loom/Wiring Loom2.0.13.xls

Sheet: Attic
ATTIC
Tray Interconnections
Designation | Type | Tray DB25 (Plug) | Direction | Spacecraft Wiring | Module Wiring |  | Checked | Notes
 |  | Pin Out
+12 Volt Supply | Power | 1 | ← | Battery Tray S1/21 | L-Band DC F/T1 | Sun Sensor J12-1 |  | +12 Volt Supply
Earth bus | Power | 2 | ← | BCR P1/16 | Earth |  |  | Earth bus
Magnetometer Reset | CMOS I/P | 3 | ← | IHU J1/22 | Magnetometer J102-8 |  |  | Magnetometer Reset
-X Panel Temperature | Thermistor O/P | 4 | ← | Battery Tray S1/3 | ADC J132-2 |  |  | -X Panel Temperature
GPS Clock | TTL O/P | 5 | → | IHU P2/7 | GPS P3 |  |  | GPS Clock
GPS Tx Data | TTL O/P | 6 | → | IHU P2/8 | GPS P4 |  |  | GPS Tx Data
GPS Rx Data | TTL I/P | 7 | ← | IHU P2/20 | GPS P5 |  |  | GPS Rx Data
SPI MOSI | TTL I/P | 8 | → | IHU J1/1 | ADC J136-4 |  |  | SPI MOSI
SPI MISO | TTL O/P | 9 | ← | IHU J1/14 | ADC J136-5 |  |  | SPI MISO
SPI CS | TTL I/P | 10 | ← | IHU J1/15 | ADC J136-6 |  |  | SPI CS
SPI CLK | TTL I/P | 11 | ← | IHU J1/2 | ADC J136-3 |  |  | SPI CLK
Camera Activate | Open Drain FET | 12 | ← | IHU P2/12 | Camera J1-2 |  |  | Camera Activate
+5 Volts Supply | Power | 13 | ← | Battery Tray S1/14 | ADC J136-1 | Horizon Sensor J206-4 |  | +5 Volts Supply
Data Supply Earth | Power | 14 | ← | IHU J2/5 | ADC J136-2 |  |  | Data Supply Earth
Camera Tx Data | CMOS I/P | 15 | → | IHU J2/3 | Camera J1-6 |  |  | Camera Tx Data
Camera Rx Data | CMOS O/P | 16 | ← | IHU J2/2 | Camera J1-5 |  |  | Camera Rx Data
Sun Sensor Enable | TTL I/P | 17 | ← | IHU J1/23 | Sun Sensor J12-3 |  |  | Sun Sensor Enable
ADC Chip Select | TTL I/P | 18 | ← | IHU P2/3 | ADC J136-7 |  |  | ADC Chip Select
+Y Panel Temperature | Thermistor O/P | 19 | ← | Battery Tray S1/11 | ADC J132-7 |  |  | +Y Panel Temperature
-Y Panel Temperature | Thermistor O/P | 20 | ← | Battery Tray S1/7 | ADC J132-8 |  |  | -Y Panel Temperature
+Z Solar O/P +ve | Power | 21 | → | BCR Tray S1/6 | Solar Panel |  |  | +Z Solar O/P +ve
+Z Solar O/P -ve | Power | 22 | → | BCR S1/18 | Solar Panel |  |  | +Z Solar O/P -ve
L-Band DC On | Open Drain FET | 23 | ← | IHU P2/24 | L-Band DC F/T3 |  |  | L-Band DC On
GPS Serial Boot | Open Drain FET | 24 | ← | IHU J2/7 OD4 from IHU TP10 | GPS P1/8 |  | OD4 | GPS Serial Boot
GPS Power ON/OFF | Open Drain FET | 25 |  | IHU J2/8 OD5 from IHU TP11 | GPS P1/9 | PWREN | OD5 | GPS Power ON/OFF
Modules
L-Band Down Converter |  | Feed Through |  | Destination |  |  |  | Module #1
 |  | Pin Out |  |  |  |  |  | L-Band Down Converter
+12 Volts | Power | 1 | ← | Tray P1/1 |  |  |  | +12 Volts
Earth | Power | 2 | ← | Tray P1/2 |  |  |  | Earth
Module On | Open Drain FET | 3 | ← | Tray P1/23 |  |  |  | Module On
Earth |  | Mtg screws |  |  |  |  |  | Earth
SMA 1 | Coax RF I/P | SMA 1 | ← | L Band Antenna |  |  |  | SMA 1
SMA 2 | Coax RF O/P | SMA 2 | → | Preamp SMA2 |  |  |  | SMA 2
ADC Module # 1 |  | PCB |  | Destination
 |  | Pin Out |  |  |  |  |  | Designation
+5 Volts Supply | Power | J136-1 | ← | Tray P1/13 |  |  |  | +5 Volts Supply
Earth | Power | J136-2 | ← | Tray P1/14 |  |  |  | Earth #1
SPI Clock from IHU | TTL I/P | J136-3 | ← | Tray P1/11 |  |  |  | SPI CLK
Data I/P from IHU | TTL I/P | J136-4 | ← | Tray P1/8 |  |  |  | SPI MOSI
Data O/P to IHU | TTL O/P | J136-5 | → | Tray P1/9 |  |  |  | SPI MISO
SPI Chip Select from IHU | TTL I/P | J136-6 | ← | Tray P1/10 |  |  |  | SPI CS
A/D Chip Select | TTL I/P | J136-7 | ← | Tray P1/18 |  |  |  | A/D Chip Select
Logic earth | Power | J136-8 | ← | Tray P1/14 |  |  |  | 0 V Logic
Channel 0 | Analog DC | J133-1 | ← | Magnetometer J102-4 |  |  |  | Channel 1 | Magnetometer X
Channel 1 | Analog DC | J133-2 | ← | Magnetometer J102-2 |  |  |  | Channel 2 | Magnetometer Y
Channel 2 | Analog DC | J133-3 | ← | Magnetometer J102-5 |  |  |  | Channel 3 | Magnetometer Z
Channel 3 | Analog DC | J133-4 | ← | Magnetometer J102-3 |  |  |  | Channel 4 | Magnetometer Ref
Channel 4 | Analog DC | J133-5 | ← | Horizon Sensor vis J203-1 |  |  |  | Channel 5 | Horizon Sensor Vis Vref
Channel 5 | Analog DC | J133-6 | ← | Sun Sensor J12-5 |  |  |  | Channel 6 | Sun Sensor X Out
Channel 6 | Analog DC | J133-7 | ← | Sun Sensor J12-6 |  |  |  | Channel 7 | SunSensor Y Out
Channel 7 | Analog DC | J133-8 | ← | Sun Sensor J12-7 |  |  |  | Channel 8 | Sun Sensor Valid
0 V Logic | Power | J133-9 | ← | Tray P1/14 |  |  |  | 0 V Logic | Logic earth
Channel 8 | Analog DC | J132-1 | ← | +Z Panel Thermistor |  |  |  | Channel 9 | +Z Panel Temperature
Channel 9 | Analog DC | J132-2 | ← | -X Panel Thermistor |  |  |  | Channel 10 | -X Panel Temperature
Channel 10 | Analog DC | J132-3 | ← | Horizon Sensor Vis J203-2 |  |  |  | Channel 11 | Horizon Sensor Vis 1
Channel 11 | Analog DC | J132-4 | ← | Horizon Sensor Vis J203-5 |  |  |  | Channel 12 | Horizon Sensor Viz 2
Channel 12 | Analog DC | J132-5 | ← | Horizon Sensor IR1 J206-5 |  |  |  | Channel 13 | Horizon Sensor IR 1
Channel 13 | Analog DC | J132-6 | ← | Horizon Sensor IR2 J208-5 |  |  |  | Channel 14 | Horizon Sensor IR 2
Channel 14 | Analog DC | J132-7 | ← | +Y Panel Thermistor |  |  |  | Channel 15 | +Y Panel Temperature
Channel 15 | Analog DC | J132-8 | ← | -Y Panel Thermistor |  |  |  | Channel 16 | -Y Panel Temperature
0 V Logic | Power | J132-9 | ← | Tray P1/14 |  |  |  | 0 V Logic | Logic earth
Sun Sensor Processor |  | PCB |  | Destination |  |  |  | Designation
 |  | Pin Out
+12 Volts | Power | J12-1 | ← | Tray P1/1 | Magnetometer J102-1 |  |  | +12 Volt Supply
 |  | J12-2 |  | Not Used
Sun Sensor Enable | Analog DC | J12-3 | ← | Tray P1/17 |  |  |  | Sun Sensor Enable
Logic earth | Power | J12-4 | ← | Tray P1/14 |  |  |  | 0 V Logic
SS X output | Analog DC | J12-5 | → | ADC J133-6 |  |  |  | SS X out
SS Y output | Analog DC | J12-6 | → | ADC J133-7 |  |  |  | SS Y out
SS Valid | Analog DC | J12-7 | → | ADC J133-8 |  |  |  | SS Valid
Earth | Power | J12-8 | ← | Tray P1/14 |  |  |  | Earth
Sun Sensor Head Interface |  |  |  |  |  |  |  | Designation
Sensor Y2 Anode | Analog DC | J1-1 | ← | Sun Sensor Head Y2 Anode (J1-1) |  |  |  | Sensor Y2 Anode
Sensor X2 Anode | Analog DC | J1-2 | ← | Sun Sensor Head X2 Anode (J1-2) |  |  |  | Sensor X2 Anode
Sensor Cathode | Analog DC | J1-3 | → | Sun Sensor Head Cathode J1-3 |  |  |  | VCON
+10 Volts | Power | J1-4 |  | Not Used |  |  |  | Supply #1
Sensor Y1 Anode | Analog DC | J1-5 | ← | Sun Sensor Head Y1 Anode (J1-5) |  |  |  | Sensor Y1 Anode
Sensor X1 Anode | Analog DC | J1-6 | ← | Sun Sensor Head X1 Anode (J1-6) |  |  |  | Sensor X1 Anode
Earth | Power | J1-7 |  | Not Used |  |  |  | Earth
Sun Sensor Head |  | PCB |  | Destination |  |  |  | Designation
 |  | Pin Out
Sensor Y2 Anode | Analog DC | 1 | ← | Sun Sensor I/F J1-1 |  |  |  | Sensor Y2 Anode
Sensor X2 Anode | Analog DC | 2 | ← | Sun Sensor I/F J1-2 |  |  |  | Sensor X2 Anode
Sensor Cathode | Analog DC | 3 | → | Sun Sensor I/F J1-3 |  |  |  | VCON
+10 Volts | Power | 4 | ← | Sun Sensor I/F J1-4 |  |  |  | Supply #1
Sensor Y1 Anode | Analog DC | 5 | ← | Sun Sensor I/F J1-5 |  |  |  | Sensor Y1 Anode
Sensor X1 Anode | Analog DC | 6 | ← | Sun Sensor I/F J1-6 |  |  |  | Sensor X1 Anode
Earth | Power | 7 | ← | Sun Sensor I/F J1-7 |  |  |  | Earth
Horizon Sensor IR1 |  | PCB |  | Destination |  |  |  | Designation
 |  | Pin Out
Ground | Power | J206-3 | ← | IR2 J208-3, Tray P1/14 |  |  |  | Ground
+5 Volts Supply | Power | J206-4 | ← | IR2 J208-4, Tray P1/13 |  |  |  | +5 Volts Supply
Output 1 | Analog DC | J206-5 | → | ADC J132-5 |  |  |  | Output 1
Vref Output | Analog DC | J206-6 | → | IR2 J208-6 |  |  |  | Vref Output
Horizon Sensor IR2 |  | PCB Pads
Ground | Power | J208-3 | ← | IR1 J206-3, Tray P1/14 |  |  |  | Ground
+5 Volts | Power | J208-4 | ← | IR1 J206-4, Hor Sens Vis J203-3 |  |  |  | +5 Volts Supply
Output 2 | Analog DC | J208-5 | → | ADC J132-6 |  |  |  | Output 2
Vref Input | Analog DC | J208-6 | ← | IR1 J206-6 |  |  |  | Vref Input
Horizon Sensor Vis |  | PCB Pads
Vref Output | Analog DC | J203-1 | → | ADC J133-5 |  |  |  | Vref Output
Output 1 | Analog DC | J203-2 | → | ADC J132-3 |  |  |  | Output 1
+5 Volts | Power | J203-3 | ← | Horizon Sensor IR2 J208-4, Magnetometer J102-7 |  |  |  | +5 Volts Supply
Ground | Power | J203-4 | ← | Tray P1/14 |  |  |  | Ground
Output 2 | Analog DC | J203-5 | → | ADC J132-4 |  |  |  | Output 2
Ground | Power | J203-6 | ← | Tray P1/14 |  |  |  | Ground
Magnetometer |  | PCB |  | Destination |  |  |  | Designation
 |  | Pin Out
+12 Volts | Power | J102-1 | ← | SunSensor J12-1 |  |  |  | +12 Volt Supply
Mag Y O/P (analogue volts) | Analog DC | J102-2 | → | ADC J133-2 |  |  |  | Magnetometer Y O/P
Magnetometer Vref | Analog DC | J102-3 | → | ADC J133-4 |  |  |  | Magnetometer Vref
Mag X O/P (analogue volts) | Analog DC | J102-4 | → | ADC J133-1 |  |  |  | Magnetometer X O/P
Mag Z O/P (analogue volts) | Analog DC | J102-5 | → | ADC J133-3 |  |  |  | Magnetometer Z O/P
Earth | Power | J102-6 | ← | Tray P1/14 |  |  |  | Earth
+5 Volts Supply | Power | J102-7 | ← | Horizon Sensor Vis J203-3, Camera J1-1 |  |  |  | +5 Volts Supply
Magnetometer Reset | TTL I/P | J102-8 | ← | Tray P1/3 |  |  |  | Reset
Camera |  | PCB |  | Destination |  |  |  | Designation
 |  | Pin Out
+5 Volts Supply | Power | J1-1 | ← | Magnetometer J102-7, GPS P1/1 |  |  |  | +5 Volts Supply
Earth | Power | J1-3 | ← | Tray P1/14 |  |  |  | Earth
Camera Enable (OD FET) | Open Drain FET | J1-2 | ← | Tray P1/12 |  |  |  | Camera Activate
RS232 Camera Tx Data | CMOS O/P | J1-6 | → | Tray P1/15 |  |  |  | Camera Tx Data
RS232 Camera Rx Data | CMOS I/P | J1-5 | ← | Tray P1/16 |  |  |  | Camera Rx Data
GPS |  | DB9 |  | Destination |  |  |  | Designation
 |  | Pin Out
+5 Volts Supply | Power | P1/1 | ← | Camera J1-1 |  |  |  | +5 Volts Supply
Earth | Power | P1/2 | ← | Tray P1/14 |  |  |  | Earth
Clock TTL Pulses | TTL O/P | P1/3 | → | Tray P1/5 |  |  |  | Clock O/P
Data Out | TTL O/P | P1/4 | → | Tray P1/6 |  |  |  | GPS Tx Data
Data I/P | TTL I/P | P1/5 | ← | Tray P1/7 |  |  |  | GPS Rx Data
+5 Volts Supply | Power | P1/6 | ← | Tray P1/13 |  |  |  | +5 Volts Supply
Earth | Power | P1/7 | ← | Tray P1/14 |  |  |  | Earth
Serial Boot | TTL I/P | P1/8 | ← | Tray P1/24 |  |  |  | Serial Boot
PWREN |  | P1/9 |  | Tray P1/25 |  |  |  | GPS Power ON/OFF enable
Solar panel +Z Face |  | Module
 |  | Continental
Z+ Solar O/P +ve | Power | 1 | → | Tray P1/21 |  |  |  | Z+ Solar O/P +ve
Z+ Solar O/P -ve | Power | 2 | → | Tray P1/22 |  |  |  | Z+ Solar O/P -ve
Z+ Panel Thermistor | Analog DC | 3 | → | ADC J132-1 |  |  |  | Z+ Panel Temperature
Earth | Analog DC | 4 | → | ADC J132-9 |  |  |  | Earth
External Battery Charger |  | Charger Socket
Charger +ve | Power | SKT 1/1 |  | Rx Tray P1/14
Charger -ve | Power | SKT 1/2 |  | Rx Tray P1/25

Sheet: Receiver Tray
Receiver Tray
Tray Interconnections
Designation | Type | Tray DB25 (Plug) | Direction | Wiring From S/C | Module Wiring |  | Checked | Notes
 |  | Pin Out
+12 Volts Supply (Rx Tray) | Power | 1 | ← | Battery Tray S1/22 | FM Rx1 P1/1 |  |  | +12 Volts Supply (Rx Tray)
Earth | Power | 2 | ← | BCR P1/17 | FM Rx1 P1/2 |  |  | Earth
 |  | 3
 |  | 4
 |  | 5
+X Panel Temperature | Analog DC | 6 | ← | +X Panel Thermistor | ADC Module J132-2 |  |  | Entry from Wiring cavity
 |  | 7
SPI MOSI | TTL I/P | 8 | ← | IHU J1/7 | ADC Module J136-4 |  |  | SPI Data to ADC
SPI MISO | TTL O/P | 9 | → | IHU J1/20 | ADC Module J136-5 |  |  | SPI Data from ADC
SPI CS | TTL I/P | 10 | ← | IHU J1/21 | ADC Module J136-6 |  |  | SPI Chip Select
SPI CLK | TTL I/P | 11 | ← | IHU J1/8 | ADC Module J136-3 |  |  | SPI Clock
ADC Chip Select | TTL I/P | 12 | ← | IHU P2/3 | ADC Module J136-7 |  |  | ADC Chip Select
+5 Volt Supply | Power | 13 | ← | Battery Tray S1/15 | ADC Module J136-1 |  |  | +5 Volt Supply
Battery Charger | Power | 14 | → | BCR P1/12 | SKT 1/1 | In Attic |  | External Battery Charger + ve
 |  | 15
FM Rx 1 Data O/P | Data | 16 | → | IHU J1/5 | FM Rx1 P1/4 |  |  | FM Rx 1 Data O/P
FM Rx 1 Audio O/P | Audio | 17 | → | IHU J1/6 | FM Rx1 P1/8 |  |  | FM Rx 1 Audio O/P
 |  | 18
 |  | 19
 |  | 20
FM Rx 2 Data O/P | Data | 21 | → | IHU J1/18 | FM Rx2 P1/4 |  |  | FM Rx 2 Data O/P
FM Rx 2 Audio O/P | Audio | 22 | → | IHU J1/19 | FM Rx2 P1/8 |  |  | FM Rx 2 Audio O/P
 |  | 23
 |  | 24
Battery Charger | Power | 25 | → | BCR P1/25 | SKT 1/2 | In Attic |  | External Battery Charger - ve
Preamp/Splitter |  | Feed Through |  | Destination |  |  |  | Destination
 |  | Pin Out
+12 Volts | Power | +12 Volts | ← | FM Rx #2 P1/6 |  |  |  | 12 Volt Bus
Earth | Power | Earth | ← | FM Rx #2 P1/7 |  |  |  | Eth Bus
SMA 1 | Coax | SMA 1 | ← | U Band Antenna |  |  |  | U Band Antenna
SMA 2 | Coax | SMA 2 | ← | L-Band D/C O/P |  |  |  | L-Band D/C O/P
SMA 3 | Coax | SMA 3 | → | Linear Rx SMA 1 |  |  |  | Linear Rx SMA 1
SMA 4 | Coax | SMA 4 | → | FM Rx #1 SMA 1 |  |  |  | FM Rx #1 SMA 1
SMA 5 | Coax | SMA 5 | → | FM Rx #2 SMA 1 |  |  |  | FM Rx #2 SMA 1
Linear Receiver |  | DB9 |  | Destination |  |  |  | Designation
 |  | Pin Out
+5 Volts | Power | 1 | ← | ADC J136-1 |  |  |  | Supply #1
Earth | Power | 2 | ← | Tray P1/2 |  |  |  | Earth #1
Rx Power Control | DC Switch | 3 |  | Not Used (always on) |  |  |  | Rx Enable
Telemetry AGC Output | Analog DC | 4 | → | ADC J133-1 |  |  |  | Telemetry #1
Telemetry Rx temperature | Analog DC | 5 | → | ADC J132-8 |  |  |  | Telemetry #2
+12 Volts | Power | 6 | ← | FM Rx #2 P1/6 |  |  |  | Supply #2
Earth | Power | 7 | ← | FM Rx #2 P1/7 |  |  |  | Earth #2
NC |  | 8
Rx Current Monitor | Analog DC | 9 | → | ADC J133-4 |  |  |  | Rx Current Monitor
Earth |  |  |  |  |  |  |  | Mtg screws
SMA 1 | Coax | SMA 1 | ← | Preamp SMA 3 |  |  |  | RF Input
SMA 2 | Coax | SMA 2 | → | Tx Tray SMA 2 |  |  |  | IF Output
FM Receiver #1 |  | DB9 |  | Destination |  |  |  | Designation
 |  | Pin Out
+12 Volts | Power | 1 | ← | Tray P1/1 |  |  |  | Supply #1
Earth | Power | 2 | ← | Tray P1/2 |  |  |  | Earth #1
Mute O/P | DC Switch | 3 | → | Not Used |  |  |  | Mute O/P
Data O/P | Data | 4 | → | Tray P1/16 |  |  |  | Data O/p
Telemetry Rx temperature | Analog DC | 5 | → | ADC J132-1 |  |  |  | Telemetry #2
+12 Volts | Power | 6 | → | FM Rx #2 P1/1 |  |  |  | Supply #2
Earth | Power | 7 | → | FM Rx #2 P1/2 |  |  |  | Earth #2
Audio O/P | Audio | 8 | → | Tray P1/17 |  |  |  | Audio I/O
RSSI | Analog DC | 9 | → | ADC J133-2 |  |  |  | RSSI
Earth |  |  |  |  |  |  |  | Mtg screws
SMA 1 | Coax | SMA 1 | ← | Preamp SMA 4 |  |  |  | RF Input
FM Receiver #2 |  | DB9 |  | Destination |  |  |  | Designation
 |  | Pin Out
+12 Volts | Power | 1 | ← | FM Rx #1 P1/6 |  |  |  | Supply #1
Earth | Power | 2 | ← | FM Rx #1 P1/7 |  |  |  | Earth #1
Mute O/P | DC Switch | 3 | → | Not Used |  |  |  | Mute O/P
Data O/P | Data | 4 | → | Tray P1/21 |  |  |  | Data O/P
Telemetry Rx temperature | Analog DC | 5 | → | ADC J132-7 |  |  |  | Telemetry #2
+12 Volts | Power | 6 | → | Linear Rx P1/6 | Preamp FT/1 |  |  | Supply #2
Earth | Power | 7 | → | Linear Rx P1/7 | Preamp Earth |  |  | Earth #2
Audio O/P | Audio | 8 | → | Tray P1/22 |  |  |  | Audio I/O
RSSI | Analog DC | 9 | → | ADC J133-3 |  |  |  | RSSI
Earth |  |  |  |  |  |  |  | Mtg screws
SMA 1 | Coax | SMA 1 | ← | Preamp SMA 5 |  |  |  | RF Input
ADC Module # 3 |  | PCB |  | Destination |  |  |  | Designation
+5 Volts | Power | J136-1 | ← | Tray P1/13 | Linear Rx P1/1 |  |  | Supply #1
Earth | Power | J136-2 | ← | Tray P1/2 |  |  |  | Earth #1
SPI Clock from IHU | TTL I/P | J136-3 | ← | Tray P1/11 |  |  |  | SPI CLK
Data I/P from IHU | TTL I/P | J136-4 | ← | Tray P1/8 |  |  |  | SPI MOSI
Data O/P to IHU | TTL O/P | J136-5 | → | Tray P1/9 |  |  |  | SPI MISO
SPI Chip Select from IHU | TTL I/P | J136-6 | ← | Tray P1/10 |  |  |  | SPI CS
A/D Chip Select | TTL I/P | J136-7 | ← | Tray P1/12 |  |  |  | A/D Chip Select
Logic earth | Power | J136-8 | ← | Tray P1/2 |  |  |  | 0 V Logic
Linear Receiver AGC | Analog DC | J133-1 | ← | Linear Rx P1/4 |  |  |  | Channel 0 | Linear Receiver AGC
FM RX1 RSSI | Analog DC | J133-2 | ← | FM Rx #1 P1/9 |  |  |  | Channel 1 | FM RX1 RSSI
FM RX2 RSSI | Analog DC | J133-3 | ← | FM Rx #2 P1/9 |  |  |  | Channel 2 | FM RX2 RSSI
Linear Rx Current | Analog DC | J133-4 | ← | Linear Rx P1/9 |  |  |  | Channel 3 | Linear Rx Current
 |  | J133-5 |  |  |  |  |  | Channel 4
 |  | J133-6 |  |  |  |  |  | Channel 5
 |  | J133-7 |  |  |  |  |  | Channel 6
 |  | J133-8 |  |  |  |  |  | Channel 7
Logic earth |  | J133-9 |  | Tray P1/2 |  |  |  | 0 V Logic
FM Rx 1 Temperature | Analog DC | J132-1 | ← | FM Rx #1 P1/5 |  |  |  | Channel 8 | FM Rx 1 Temperature
+X Panel Temperature | Analog DC | J132-2 | ← | Tray P1/6 |  |  |  | Channel 9 | +X Panel Temperature
 |  | J132-3 |  |  |  |  |  | Channel 10
 |  | J132-4 |  |  |  |  |  | Channel 11
 |  | J132-5 |  |  |  |  |  | Channel 12
 |  | J132-6 |  |  |  |  |  | Channel 13
FM Rx 2 Temperature | Analog DC | J132-7 | ← | FM Rx #2 P1/5 |  |  |  | Channel 14 | FM Rx 2 Temperature
Linear Rx temperature | Analog DC | J132-8 | ← | Linear Rx P1/5 |  |  |  | Channel 15 | Linear Rx temperature
Logic earth | Power | J132-9 | ← | Tray P1/2 |  |  |  | 0 V Logic | Logic earth

Sheet: IHU Tray
IHU Tray
Tray Interconnections
Designation | Type | DB25 (Plug) P2 | Direction | Wiring from S/C |  | Checked | Notes
 |  | Pin Out
+5 Volt Supply | Power | 1 | ← | Battery Tray S1/16 |  |  | +5 Volt Supply
Earth #1 | Power | 2 | ← | BCR P1/15 |  |  | Earth
Out 0 | TTL O/P | 3 | → | BCR P1/2 | Attic P1/18 |  | ADC Chip select
Out 2 | TTL O/P | 4 | → | Battery Tray P1/15 |  |  | ADAC -X
Out 4 | TTL O/P | 5 | → | Battery Tray P1/16 |  |  | ADAC -Y
Out 6 | TTL O/P | 6 | → | Battery Tray P1/17 |  |  | ADAC -Z
1 pps | TTL I/P | 7 | ← | Attic P1/5 |  |  | GPS 1 PPS in
GPS RxD | TTL I/P | 8 | ← | Attic P1/6 |  |  | GPS Rx Data
MISO2 | TTL I/P | 9 | ← | Tx Tray P1/9 |  |  | Tx SPI Data In
n SPI CS2 | TTL O/P | 10 | → | Tx Tray P1/10 |  |  | Tx SPI Chip Select
OD1 | Open Drain FET | 11 | → | Tx Tray P1/4 |  |  | FM TX PTT
OD3 | Open Drain FET | 12 | → | Attic P1/12 |  |  | Camera Activate
IN5 |  | 13
+5 Volt Supply | Power | 14 |  | Battery Tray S1/17 |  |  | +5 Volt Supply
Earth #2 |  | 15 |  | BCR P1/23 |  |  | Earth
Out 1 | TTL O/P | 16 | → | Battery Tray P1/2 |  |  | ADAC +X
Out 3 | TTL O/P | 17 | → | Battery Tray P1/3 |  |  | ADAC +Y
Out 5 | TTL O/P | 18 | → | Battery Tray P1/4 |  |  | ADAC +Z
Out 7 | TTL O/P | 19 | → | Tx Tray P1/20 |  |  | Tx Tray Sun Sensor Enable
GPS TxD | TTL O/P | 20 | → | Attic P1/7 |  |  | Data In From GPS
MOSI2 | TTL O/P | 21 | → | Tx Tray P1/8 |  |  | Tx SPI Data Out
SPI CLK2 | TTL O/P | 22 | → | Tx Tray P1/11 |  |  | Tx SPI Clk out
OD0 | Open Drain FET | 23 | → | Tx Tray P1/3 |  |  | Linear Tx PTT
OD2 | Open Drain FET | 24 | → | Attic P1/23 |  |  | L-Band DC On
IN4 |  | 25
Designation |  | DB25 (Socket) J1 |  |  |  |  | SKT1
 |  | Pin Out |  |  |  |  | DB25 Socket
MOSI0 | TTL O/P | 1 | → | Attic P1/8 |  |  | SCI SPI Data Out
SPI CLK0 | TTL O/P | 2 | → | Attic P1/11 |  |  | SCI SPI Clk out
MOSI1 | TTL O/P | 3 | → | BCR P1/4 |  |  | BCR SPI Data in
SPI CLK1 | TTL O/P | 4 | → | BCR P1/3 |  |  | BCR SPI Clk out
RXA 0 | Data | 5 | ← | Rx Tray P1/16 |  |  | CMD Rx Data
RXB 0 | Audio | 6 | ← | Rx Tray P1/17 |  |  | CMD Rx Audio
MOSI3 | TTL O/P | 7 | → | Rx Tray P1/8 |  |  | Rx SPI Data in
SPI CLK3 | TTL O/P | 8 | → | Rx Tray P1/11 |  |  | RX SPI Clk out
Out 8 | TTL O/P | 9 | →
Out 10 | TTL O/P | 10 | → | Tx Tray P1/6 |  |  | CW Beacon
IN 0 |  | 11
IN 2 |  | 12
MOD Out | Audio | 13 | → | Tx Tray P1/7 |  |  | FM Tx Audio
MISO 0 | TTL I/P | 14 | ← | Attic P1/9 |  |  | SCI SPI Data in
nSPI CS0 | TTL O/P | 15 | → | Attic P1/10 |  |  | SCI SPI Chip Select
MISO 1 | TTL I/P | 16 | ← | BCR P1/5 |  |  | BCR SPI Data out
nSPI CS1 | TTL O/P | 17 | → | BCR P1/1 |  |  | BCR SPI Chip Select
RXA 1 | Data | 18 | ← | Rx Tray P1/21 |  |  | Wkg RX Data
RXB 1 | Audio | 19 | ← | Rx Tray P1/22 |  |  | Wkg Rx Audio
MISO 3 | TTL I/P | 20 | ← | Rx Tray P1/9 |  |  | RX SPI Data In
nSPI CS3 | TTL O/P | 21 | → | Rx Tray P1/10 |  |  | RX SPI Chip Select
Out 9 | TTL O/P | 22 | → | Attic P1/3 |  |  | Magnetometer Reset
Out 11 | TTL O/P | 23 | → | Attic P1/17 |  |  | Attic SunSensor Enable
IN 1 |  | 24
IN 3 |  | 25
Designation |  | DB9 (Socket) J2 |  |  |  |  | Plug1
 |  | Pin Out |  |  |  |  | DB9 Socket
 |  | 1
RS232 ATXD | CMOS O/P | 2 | → | Attic P1/16 |  |  | RS232 Tx Data
RS232 ARXD | CMOS I/P | 3 | ← | Attic P1/15 |  |  | RS232 RX Data
TP12 OD6 | Open Drain FET | 4 | → | Tx Tray P1/5 |  |  | 70CM Beacon PTT
RS232 Eth | Data Power Earth | 5 |  | Attic P1/14 |  |  | RS232 Earth
+5 Volts | Power | 6
TP10 OD4 | Open Drain FET | 7 | → | Attic P1/24 |  |  | GPS Serial Boot. Enable OD4 to pull serial boot low for reset
TP11 OD5 | Open Drain FET | 8 | → | Attic P1/25 |  |  | GPS Power Switch. Enable OD5 to switch GPS OFF
External Reset | CMOS I/P | 9 | ←

Sheet: Battery Tray
Battery Tray
Tray Interconnections
Designation | Type | DB25 (Plug) P1 | Direction | Wiring From S/C | Wiring To Modules | Checked | Notes
 |  | Pin Out
+12 Volts | Power | 1 | ← | Not Used
ADAC +X I/P | TTL I/P | 2 | ← | IHU P2/16 | ADAC #1 J54/1
ADAC +Y I/P | TTL I/P | 3 | ← | IHU P2/17 | ADAC #2 J54/1
ADAC +Z I/P | TTL I/P | 4 | ← | IHU P2/18 | ADAC #3 J54/1
 |  | 5
 |  | 6
 |  | 7
 |  | 8
 |  | 9
- Battery | Power | 10 | → | BCR P1/19 | - Battery
- Battery | Power | 11 | → | BCR P1/20 | - Battery
+ Battery | Power | 12 | ↔ | BCR S1/11 | + Battery | ADAC Driver #1 J52/1
+ Battery | Power | 13 | ↔ | BCR S1/12 | + Battery
Earth | Power | 14 | → | BCR P1/22 | ADAC #1 J52/2
ADAC -X I/P | TTL I/P | 15 | ← | IHU P2/4 | ADAC #1 J54/3
ADAC -Y I/P | TTL I/P | 16 | ← | IHU P2/5 | ADAC #2 J54/3
ADAC -Z I/P | TTL I/P | 17 | ← | IHU P2/6 | ADAC #3 J54/3
 |  | 18
 |  | 19
 |  | 20
 |  | 21
 |  | 22
 |  | 23
 |  | 24
 |  | 25
Designation |  | DB25 (Socket) S1 |  | Wiring to S/C | Wiring from Modules
 |  | Pin Out
-X Solar O/P +ve | Power | 1 | → | BCR S1/1 | X- Connential 1
-X Solar O/P -ve | Power | 2 | → | BCR S1/15 | X- Connential 2
-X Panel Temperature | Thermistor O/P | 3 | → | Attic P1/4 | X- Connential 3
-X Panel Temperature eth | Thermistor O/P | 4 | → | Attic P1/14 | X- Connential 4 |  | Data Earth
-Y Solar O/P +ve | Power | 5 | → | BCR S1/3 | Y- Connential 1
-Y Solar O/P -ve | Power | 6 | → | BCR SK1/17 | Y- Connential 2
-Y Panel Temperature | Thermistor O/P | 7 | → | Attic P1/20 | Y- Connential 3
-Y Panel Temperature eth | Thermistor O/P | 8 | → | Attic P1/14 | Y- Connential 4 |  | Data Earth
+Y Solar O/P +ve | Power | 9 | → | BCR SK1/4 | Y+ Connential 1
+Y Solar O/P -ve | Power | 10 | → | BCR SK1/16 | Y+ Connential 2
+Y Panel Temperature | Thermistor O/P | 11 | → | Attic P1/19 | Y+ Connential 3
+Y Panel Temperature eth | Thermistor O/P | 12 | → | Attic P1/14 | Y+ Connential 4 |  | Data Earth
+5 Volt Supply | Power | 13 | ← | BCR S1/8 | Tray S1/14
+5 Volt Supply (Attic) | Power | 14 | → | Attic P1/13 | Tray S1/13, S1/15
+5 Volt Supply (Rx Tray) | Power | 15 | → | Rx Tray P1/13 | Tray S1/14, S1/16
+5 Volt Supply (IHU #1) | Power | 16 | → | IHU P2/1 | Tray S1/15, S1/17
+5 Volt Supply (IHU #2) | Power | 17 | → | IHU P2/14 | Tray S1/16, S1/18
+5 Volt Supply (Tx Tray) | Power | 18 | → | Tx Tray P1/13 | Tray S1/17, S1/19
+5 Volt Supply | Power | 19 | ← | BCR S1/21 | Tray S1/18
Not Used | Power | 20 | ←
+12 Volt Supply | Power | 21 | → | BCR S1/7 | Tray S1/22
+12 Volt Supply (Attic) | Power | 22 | → | Attic P1/1 | Tray S1/21, S1/23
+12 Volt Supply (Rx Tray) | Power | 23 | → | Rx Tray P1/1 | Tray S1/22, S1/24
+12 Volt Supply (Tx Tray) | Power | 24 | → | Tx Tray P1/1 | Tray S1/23, S1/25
+12 Volt Supply | Power | 25 | ← | BCR S1/20 | Tray S1/24
Modules
ADAC Driver #1 (X Axis) |  | PCB Pads
+12 Volts | Power | J52/1 | ← | Tray P1/12 |  |  | + Battery
Earth | Power | J52/2 | ← | Tray P1/14 |  |  | Eth Bus
+12 Volts | Power | J53/1 | → | ADAC #2 J52/1 |  |  | + Battery
Earth | Power | J53/2 | → | ADAC #2 J52/2 |  |  | Eth Bus
ADAC +X I/P | TTL I/P | J54/1 | ← | Tray P1/2 |  |  | IHU P2/16
ADAC -X I/P | TTL I/P | J54/3 | ← | Tray P1/15 |  |  | IHU P2/4
Data Earth | Earth | J54 /2/4 | ← | Tray P1/14 |  |  | Eth Bus
ADAC +X O/P | Coil Drive | J51/1 | → | X Coil + |  |  | X Coil +ve
ADAC -X O/P | Coil Drive | J51/2 | → | X Coil - |  |  | X Coil -ve
ADAC Driver #2 (Y Axis) |  | PCB Pads
+12 Volts | Power | J52/1 | ← | ADAC #1 J53/1 |  |  | + Battery
Earth | Power | J52/2 | ← | ADAC #1 J53/2 |  |  | Eth Bus
+12 Volts | Power | J53/1 | → | ADAC #3 J52/1 |  |  | + Battery
Earth | Power | J53/2 | ← | ADAC #3 J52/2 |  |  | Eth Bus
ADAC +Y I/P | TTL I/P | J54/1 | ← | Tray P1/3 |  |  | IHU P2/17
ADAC -Y I/P | TTL I/P | J54/3 | ← | Tray P1/16 |  |  | IHU P2/5
Data Earth | Earth | J54 /2/4 | ← | Tray P1/14 |  |  | Eth Bus
ADAC +Y O/P | Coil Drive | J51/1 | → | Y Coil + |  |  | Y Coil +ve
ADAC -Y O/P | Coil Drive | J51/2 | → | Y Coil - |  |  | Y Coil -ve
ADAC Driver #3 (Z Axis) |  | PCB Pads
+12 Volts | Power | J52/1 | ← | ADAC#2 J53/1 |  |  | + Battery
Earth | Power | J52/2 | ← | ADAC#2 J53/2 |  |  | Eth Bus
+12 Volts | Power | J53/1 | → | Spare |  |  | + Battery
Earth | Power | J53/2 | ← | Spare |  |  | Eth Bus
ADAC +Z I/P | TTL I/P | J54/1 | ← | Tray P1/4 |  |  | IHU P2/18
ADAC -Z I/P | TTL I/P | J54/3 | ← | Tray P1/17 |  |  | IHU P2/6
Data Earth | Earth | J54 /2/4 | ← | Tray P1/14 |  |  | Eth Bus
ADAC +Z O/P | Coil Drive | J51/1 | → | Coil Lead |  |  | Z Coil +ve
ADAC -Z O/P | Coil Drive | J51/2 | → | Coil Lead |  |  | Z Coil -ve
-X Solar Panel Module
-X Connential 1 | Power | -X Connential 1 | → | Tray S1/1 | BCR S1/1
-X Connential 2 | Power | -X Connential 2 | → | Tray S1/2 | BCR S1/15
-X Connential 3 | Thermistor O/P | -X Connential 3 | → | Tray S1/3 | Attic P1/4
-X Connential 4 | Data Earth | -X Connential 4 | → | Tray S1/4 | Attic P1/14
-Y Solar Panel Module
-Y Connential 1 | Power | -Y Connential 1 | → | Tray S1/5 | BCR S1/3
-Y Connential 2 | Power | -Y Connential 2 | → | Tray S1/6 | BCR SK1/17
-Y Connential 3 | Thermistor O/P | -Y Connential 3 | → | Tray S1/7 | Attic P1/20
-Y Connential 4 | Data Earth | -Y Connential 4 | → | Tray S1/8 | Attic P1/14
+Y Solar Panel Module
+Y Connential 1 | Power | +Y Connential 1 | → | Tray S1/9 | BCR SK1/4
+Y Connential 2 | Power | +Y Connential 2 | → | Tray S1/10 | BCR SK1/16
+Y Connential 3 | Thermistor O/P | +Y Connential 3 | → | Tray S1/11 | Attic P1/19
+Y Connential 4 | Data Earth | +Y Connential 4 | → | Tray S1/12 | Attic P1/14

Sheet: BCR Tray
BCR Tray
Tray Interconnections
Designation | Type | Tray DB25 (Plug) | Direction | Spacecraft Wiring | Checked | Notes
 |  | Pin Out
SPI CS | TTL I/P | 1 | ← | IHU J1/17 |  | SPI Chip Select
ADC Chip Select | TTL I/P | 2 | ← | IHU P2/3 |  | ADC Chip Select
SPI CLK | TTL I/P | 3 | ← | IHU J1/4 |  | SPI Clock
SPI MOSI | TTL I/P | 4 | ← | IHU J1/3 |  | SPI Data in from IHU
SPI MISO | TTL O/P | 5 | → | IHU J1/16 |  | SPI Data out to IHU
 |  | 6
 |  | 7
 |  | 8
 |  | 9
 |  | 10
 |  | 11
 |  | 12
 |  | 13
Earth | Power | 14
Earth | Power | 15
Earth | Power | 16 | → | Attic P1/2, P1/14 |  | Earth
Earth | Power | 17 | → | Rx Tray P1/2 |  | Earth
Earth | Power | 18 | → | IHU P2/2 |  | Earth
Earth | Power | 19 | → | Battery Tray P1/10 |  | Earth
Earth | Power | 20 | → | Battery Tray P1/11 |  | Earth
Earth | Power | 21 | → | Tx Tray P1/2 |  | Earth
Earth | Power | 22 | → | Battery Tray P1/14 |  | Earth
Earth | Power | 23 | → | IHU P2/15 |  | Earth
 |  | 24
 |  | 25
Designation |  | Tray DB25 (Socket) |  | Wiring From S/C
 |  | Pin Out
-X Solar O/P +ve | Power | 1 | ← | Battery Tray S1/1
+X Solar O/P +ve | Power | 2 | ← | X+ Solar Array |  | Direct from wiring cavity
-Y Solar O/P +ve | Power | 3 | ← | Battery Tray S1/5
+Y Solar O/P +ve | Power | 4 | ← | Y+ Solar Array
-Z Solar O/P +ve | Power | 5 | ← | Tx Tray P1/22
+Z Solar O/P +ve | Power | 6 | ← | Attic P1/21
+12 Volt Supply | Power | 7 | → | Battery Tray S1/21 |  | Main +12 Volt supply
+5 Volt Supply | Power | 8 | → | Battery Tray S1/19 |  | Main +5Volt Supply
Separation Sw C/T | DC Switch | 9 | ← | Tx Tray P1/17 |  | Separation Sw 1 C/T
Separation Sw N/C | DC Switch | 10 | ← | Tx Tray P1/16 |  | Separation Sw 1 N/C
+ Battery | Power | 11 | ↔ | Battery Tray P1/12 |  | Battery +ve
+ Battery | Power | 12 | ← | Rx Tray P1/14 |  | External Charger
 |  | 13
+X Solar O/P -ve | Power | 14 | ← | X+ Solar Array |  | Direct from wiring Cavity
-X Solar O/P -ve | Power | 15 | ← | X- Solar Array |  | X- Solar O/P
+Y Solar O/P -ve | Power | 16 | ← | Y+ Solar Array |  | Y+ Solar O/P
-Y Solar O/P -ve | Power | 17 | ← | Y- Solar Array |  | Y- Solar O/P
+Z Solar O/P -ve | Power | 18 | ← | Attic |  | Z+ Solar O/P
-Z Solar O/P -ve | Power | 19 | ← | Tx Tray P1/25 |  | Z- Solar O/P
+12 Volt Supply | Power | 20 | → | Battery Tray S1/20 |  | Main +12 Volt supply
+5 Volt Supply | Power | 21 | → | Battery Tray S1/13 |  | Main +5Volt Supply
Separation Sw C/T |  | 22 | ← | Not Used
Separation Sw N/C |  | 23 | ← | Not Used
+ Battery | Power | 24 | → | Battery Tray P1/13 |  | Battery +ve
- Battery | Power | 25 | ← | Rx Tray P1/25 |  | External Charger

Sheet: Transmitter Tray
Transmitter Tray
Tray Interconnections
Designation | Type | Tray DB25 (Plug) | Direction | Wiring From S/C | Wiring To Modules | Wiring To Modules |  | Checked | Notes
 |  | Pin Out |  |  |  |  |  |  | Tray
+12 Volt Supply (Tx Tray) | Power | 1 | ← | Battery Tray S1/24 | FM Tx P1/1 |  |  |  | FM Tx +12 Volts
Earth | Power | 2 | ← | BCR P1/21 | Linear Tx P1/2 | ADC J136-2 |  |  | Linear Tx Earth
Linear Tx PTT | Open Drain FET | 3 | ← | IHU P2/23 | Linear Tx P1/3 |  |  |  | Linear Tx PTT
FM Tx PTT | Open Drain FET | 4 | ← | IHU P2/11 | FM Tx P1/3 | 70CM Beacon P1/8 |  |  | FM Tx PTT
70 CM Beacon PTT | Open Drain FET | 5 | ← | IHU J2/4 | 70CM Beacon P1/3 |  |  |  | OD6 from IHU (TP12)
CW Beacon Data In | TTL I/P | 6 | ← | IHU J1/10 | Linear Tx P1/8 |  |  |  | Digital O/P from IHU
FM TX Audio In | Audio | 7 | ← | IHU J1/13 | FM Tx P1/8 |  |  |  | FM TX Audio I/P
SPI MOSI | TTL I/P | 8 | ← | IHU P2/21 | ADC J136-4 |  |  |  | SPI Data to ADC
SPI MISO | TTL O/P | 9 | → | IHU P2/9 | ADC J136-5 |  |  |  | SPI Data from ADC
SPI CS | TTL I/P | 10 | ← | IHU P2/10 | ADC J136-6 |  |  |  | SPI Chip Select
SPI CLK | TTL I/P | 11 | ← | IHU P2/22 | ADC J136-3 |  |  |  | SPI Clock
ADC Chip select | TTL I/P | 12 | ← | BCR P1/13 | ADC Chip select |  |  |  | ADC Chip select
+5 Volt Supply | Power | 13 | ← | Battery Tray S1/18 | Linear Tx P1/1 | ADC J136-1, | 70 CM Beacon P1/9 |  | +5 Volt Supply
+12 Volt Supply (Tx Tray) | Power | 14 | ← | Battery Tray S1/24 | Linear Tx P1/6 |  |  |  | FM Tx +12 Volts
Earth #2 |  | 15 | ← | BCR P1/13 | FM Tx P1/7 | FM Tx P1/7 | Sun Sen P1/7 |  | FM Tx Earth
Separation Switch SW1 N/C |  | 16 | → | BCR S1/10 | Separation Switch SW1 N/C |  |  |  | Separation Sw 1/1
Separation Switch SW1 C/T |  | 17 | → | BCR S1/9 | Separation Switch SW1 C/T |  |  |  | Separation Sw 1/2
 |  | 18 | → |  |  |  |  |  | Separation Sw 1/3
 |  | 19
Sun Sensor Enable | TTL I/P | 20 | → | IHU P2/19 | Sun Sensor J12-3
 |  | 21
-Z Solar O/P +ve | Power | 22 | → | BCR S1/5 | Solar Continental #1 | Z- Solar O/P +ve |  |  | -Z Solar O/P +ve
 |  | 23
 |  | 24
-Z Solar O/P -ve | Power | 25 | → | BCR S1/19 | Solar Continental #2 | Z- Solar O/P -ve |  |  | -Z Solar O/P -ve
Modules
 |  |  |  |  |  |  |  |  | Designation
Linear Transmitter |  | Pin Out |  | Destination |  |  |  |  | Linear Tx
+5 Volts | Power | 1 | ← | Tray P1/13 |  |  |  |  | +5 Volt Supply
Earth | Power | 2 | ← | Tray P1/2 |  |  |  |  | Earth bus
PTT | Open Drain FET | 3 | ← | Tray P1/3 |  |  |  |  | Module On
Telemetry Power Output | Analog DC | 4 | → | ADC J133-1 |  |  |  |  | Telemetry #1
Telemetry PA Temperature | Analog DC | 5 | → | ADC J132-1 |  |  |  |  | Telemetry #2
+12 Volts Supply | Power | 6 | ← | Tray P1/14 |  |  |  |  | +12 Volt Supply
Earth | Power | 7 | ← | Tray P1/2 |  |  |  |  | Earth bus
CW Data from IHU | TTL I/P | 8 | ← | Tray P1/6 |  |  |  |  | CW Beacon Data In
Tx Current Monitor | Analog DC | 9 | → | ADC J133-4 |  |  |  |  | Tx Current Monitor
Earth |  | Mtg screws |  |  |  |  |  |  | Mtg screws
Lin Rx IF | Coax | SMA 1 | ← | Rx Tray SMA 2 | Lin Rx IF | SMA out | in to module |  | Lin Rx IF
Ant Switch | Coax | SMA 2 | → | RF Out | Ant Switch | SMA 2 | out to Antenna switch |  | Ant Switch
 |  |  |  |  |  |  |  |  | Designation
FM Transmitter |  | Pin Out |  | Destination |  |  |  |  | FM Tx
+12 Volts | Power | 1 | ← | Tray P1/1 |  |  |  |  | +12 Volt Supply
Earth | Power | 2 | ← | Tray P1/15 |  |  |  |  | Earth bus
PTT | Open Drain FET | 3 | ← | Tray P1/4 | 70 CM Beacon P1/8 |  |  |  | Module On
Telemetry Power Output | Analog DC | 4 | → | ADC J133-2 |  |  |  |  | Telemetry #1
Telemetry PA Temperature | Analog DC | 5 | → | ADC J132-7 |  |  |  |  | Telemetry #2
+12 Volts | Power | 6 | → | 70 CM Beacon P1/1 |  |  |  |  | +12 Volt Supply
Earth | Power | 7 | → | 70 CM Beacon P1/2 |  |  |  |  | Earth bus
Audio I/P | Audio | 8 | ← | Tray P1/7 |  |  |  |  | Audio I/O
 |  | 9 |  | N/C
Earth |  | Mtg screws |  | Mtg screws |  |  |  |  | Mtg screws
Low Level RF O/P | Coax | SMC 1 | → | 70CM Beacon IF/IP |  |  | out to 70CM beacon |  | Low Level RF O/P
RF Out |  | SMA 3 | → | Ant Switch |  |  | out to Antenna Switch |  | RF Out
Separation Switches |  | Pin Out |  | Destination |  |  |  |  | Separation Switch
Separation Sw N/C | DC Switch | Sw 1 N/C | → | Tray P1/16 | BCR S1/9 |  |  |  | Out to BCR S1/9
Separation Sw C/T | DC Switch | Sw 1 C/T | → | Tray P1/17 | BCR S1/10 |  |  |  | Out to BCR S1/10
Separation Sw N/O | DC Switch | Sw 1 N/O | → | Earth |  |  |  |  | Not Used
Antenna Switch |  | Pin Out |  | Destination |  |  |  |  | Antenna Switch
Input 1 | Coax | SMA 2 | ← | in from Linear Tx |  |  |  |  | Linear Tx SMA
Input 2 | Coax | SMA 3 | ← | in from FM Tx |  |  |  |  | FM Tx SMA
Output #1 | Coax | SMA 4 | → | out to 2M Antenna |  |  |  |  | 2M Tx array
Output #2 | Coax | SMA 5 | → | out to 2M Antenna |  |  |  |  | 2M Tx array
70Cm Beacon Transmitter |  | Pin Out |  | Destination |  |  |  |  | 70 CM Beacon
+12 Volts | Power | 1 | ← | FM Tx P1/6 |  |  |  |  | 12 Volt Bus
Earth | Power | 2 | ← | FM Tx P1/7 |  |  |  |  | Eth Bus
70Cm Beacon PTT | Open Drain FET | 3 | ← | Tray P1/5 |  |  |  |  | IHU P2/24
Telemetry Power Output | Analog DC | 4 | → | ADC J133-3 |  |  |  |  | ADC Module
Telemetry PA Temperature | Analog DC | 5 | → | ADC J132-8 |  |  |  |  | ADC Module
+12 Volts | Power | 6 | → | Sun Sensor J12-1 |  |  |  |  | 12 Volt Bus
Earth | Power | 7 | → | Sun Sensor J12-8 |  |  |  |  | Eth Bus
FM TxPTT | Open Drain FET | 8 | ← | FM Tx P1/3 |  |  |  |  | IHU P2/11
+5 Volts | Power | 9 | ← | Tray P1/13 |  |  |  |  | 5 Volt Bus
Earth | Power | Mtg screws |  | Mtg screws
Low Level RF I/P | Coax | SMC 1 | ← | FM TX SMC 1 |  |  |  |  | Low Level RF I/P
RF Out | Coax | SMA 6 | → | 70CM Antenna |  |  |  |  | 70 CM RF Out
ADC Module #2 |  | Pin Out |  | Destination |  |  |  |  | ADC Module
+5 Volts | Power | J136-1 | ← | Tray P1/13 |  |  |  |  | +5 Volt Supply
Earth | Power | J136-2 | ← | Tray P1/2 |  |  |  |  | Earth bus
SPI Clock from IHU | TTL I/P | J136-3 | ← | Tray P1/11 |  |  |  |  | SPI CLK
Data I/P from IHU | TTL I/P | J136-4 | ← | Tray P1/8 |  |  |  |  | SPI MOSI
Data O/P to IHU | TTL O/P | J136-5 | → | Tray P1/9 |  |  |  |  | SPI MISO
SPI Chip Select from IHU | TTL I/P | J136-6 | ← | Tray P1/10 |  |  |  |  | SPI CS
A/D Chip Select | TTL I/P | J136-7 | ← | Tray P1/12 |  |  |  |  | A/D Chip Select
Logic earth | Power | J136-8 | ← | Tray P1/2 |  |  |  |  | 0 V Logic
Linear Tx Power Output | Analog DC | J133-1 | ← | Linear Tx P1/4 |  |  |  |  | Channel 0
FM Tx Power Output | Analog DC | J133-2 | ← | FM Tx P1/4 |  |  |  |  | Channel 1
Beacon Power Output | Analog DC | J133-3 | ← | Beacon P1/4 |  |  |  |  | Channel 2
Linear Current Monitor | Analog DC | J133-4 | ← | Linear Tx P1/9 |  |  |  |  | Channel 3
 |  | J133-5 | ← |  |  |  |  |  | Channel 4
Sun Sensor X Out | Analog DC | J133-6 | ← | Sun Sensor J12-5 |  |  |  |  | Channel 5
SunSensor Y Out | Analog DC | J133-7 | ← | Sun Sensor J12-6 |  |  |  |  | Channel 6
Sun Sensor Valid | Analog DC | J133-8 | ← | Sun Sensor J12-7 |  |  |  |  | Channel 7
Logic earth | Power | J133-9 | ← | Tray P1/15 |  |  |  |  | 0 V Logic
 |  |  | ←
Linear Tx Temperature | Analog DC | J132-1 | ← | Linear Tx P1/5 |  |  |  |  | Channel 8
-Z Panel Temperature | Analog DC | J132-2 | ← | -Z Panel Con 3 |  |  |  |  | Channel 9
 |  | J132-3 | ← |  |  |  |  |  | Channel 10
 |  | J132-4 | ← |  |  |  |  |  | Channel 11
 |  | J132-5 | ← |  |  |  |  |  | Channel 12
 |  | J132-6 | ← |  |  |  |  |  | Channel 13
FM Tx Temperature | Analog DC | J132-7 | ← | FM Tx P1/5 |  |  |  |  | Channel 14
BeaconTemperature | Analog DC | J132-8 | ← | Beacon P1/5 |  |  |  |  | Channel 15
Logic earth | Power | J132-9 | ← | Tray P1/15 |  |  |  |  | 0 V Logic
Sun Sensor Processor |  | PCB |  | Destination |  |  |  |  | Sun Sensor
+12 Volts | Power | J12-1 | ← | Tray P1/1 |  |  |  |  | +12 Volt Supply
+5 Volts | Power | J12-2 |  | Not Used |  |  |  |  | +5 Volts Not used
Sun Sensor Enable | TTL I/P | J12-3 | ← | Tray P1/20 |  |  |  |  | Sun Sensor Enable
Logic earth | Power | J12-4 | ← | Tray P1/15 |  |  |  |  | 0 V Logic
SS X output | Analog DC | J12-5 | → | ADC J133-6 |  |  |  |  | SS X out
SS Y output | Analog DC | J12-6 | → | ADC J133-7 |  |  |  |  | SS Y out
SS Valid | Analog DC | J12-7 | → | ADC J133-8 |  |  |  |  | SS Valid
Earth | Power | J12-8 | ← | Tray P1/14 |  |  |  |  | Earth
Sun Sensor Head Interface |  |  |  | Sensor Head PCB Pads |  |  |  |  | Sun Sensor Interface
Sensor Y2 Anode | Analog DC | J1-1 | ← | 1 |  |  |  |  | Sun Sensor Head Y2 Anode
Sensor X2 Anode | Analog DC | J1-2 | ← | 2 |  |  |  |  | Sun Sensor Head X2 Anode
Sensor Cathode | Analog DC | J1-3 | → | 3 |  |  |  |  | Sun Sensor Head Cathode
+10 Volts | Power | J1-4 | → | 4 |  |  |  |  | Not Used
Sensor Y1 Anode | Analog DC | J1-5 | ← | 5 |  |  |  |  | Sun Sensor Head Y1 Anode
Sensor X1 Anode | Analog DC | J1-6 | ← | 6 |  |  |  |  | Sun Sensor Head X1 Anode
Earth | Power | J1-7 | ← | 7 |  |  |  |  | Not Used
Sun Sensor Head |  | PCB Pads |  | Destination |  |  |  |  | Sun Sensor Head
Sensor Y2 Anode | Analog DC | 1 | → | Sun Sensor I/F J1-1 |  |  |  |  | Sensor Y2 Anode
Sensor X2 Anode | Analog DC | 2 | → | Sun Sensor I/F J1-2 |  |  |  |  | Sensor X2 Anode
Sensor Cathode | Analog DC | 3 | ← | Sun Sensor I/F J1-3 |  |  |  |  | VCON
+10 Volts | Power | 4 | ← | Sun Sensor I/F J1-4 |  |  |  |  | Supply #1
Sensor Y1 Anode | Analog DC | 5 | → | Sun Sensor I/F J1-5 |  |  |  |  | Sensor Y1 Anode
Sensor X1 Anode | Analog DC | 6 | → | Sun Sensor I/F J1-6 |  |  |  |  | Sensor X1 Anode
Earth | Power | 7 | ← | Sun Sensor I/F J1-7 |  |  |  |  | Earth
Solar panel |  | Continental |  | Destination |  |  |  |  | Solar Panel
Z- Solar O/P +ve | Power | 1 | → | Tray P1/22 |  |  |  |  | Z- Solar O/P +ve
Z- Solar O/P -ve | Power | 2 | → | Tray P1/25 |  |  |  |  | Z- Solar O/P -ve
-Z Panel Thermistor | Analog DC | 3 | → | ADC J132-2 |  |  |  |  | -Z Panel Temperature
Earth | Analog DC | 4 | → | ADC J132-9 |  |  |  |  | Earth

Sheet: Notes
Notes:
Version Number v02.00.13
1) New Format
2) Sun Sensor Enable wires added
3) +Y, -X and -Y Solar Panels to come in through Battery Tray walls
4) +X Solar Panel has direct entry to wiring cavity
5) +Z Solar Panel has direct access to Attic
6) -Z Solar Panel has direct access to Transmitter tray
7) Supply wiring added to battery tray
8) + 12 Volt bus wiring added to trays
9) +5 Volt Bus wiring added to trays
10) ADAC Power feeds taken from battery
11) Tx Tray Logic Earth errors fixed
12) Tx Tray ADC#2 J133-4 connected to Linear Tx P1/9
13) Earth Added to Separation Switch #1
14) Wiring Cavity sheet added for Separation Switch #2
15) Battery Charger wiring to Rx Tray/Attic added
16) Wiring to Separation Switch #1 in Tx Tray removed
17) Error in Rx data/audio to IHU corrected
18) Wiring to Separation Switch in Tx tray restored
19) Wiring to Separation Switch in wiring cavity removed
20) BCR to IHU Interface updated from BCR Rev_B
21) GPS wiring changes in the ATTIC marked in yellow highlite
22) DB9 Socket on IHU added GPS wiring marked in yellow
23) OUT11 not used on IHU for sunsensor - now on OUT 7
24) IHU BCR interface at IHU end updated
24) OUT 11 reused for Attic Sunsor (Note 23 cancelled)
25) IHU OUT8, GPS Serial Boot label removed
26) IHU TP12 to S2/4 added fro 70CM Beacon PTT
27) IHU sockets labels changed from Sx/y to Jx/y
