AMSAT-ZL/KiwiSAT_Sub-Systems/FM_Receivers/2008-02-28 Assembly instructions and BOM/UHF-FM-RX assembled unit.jpg

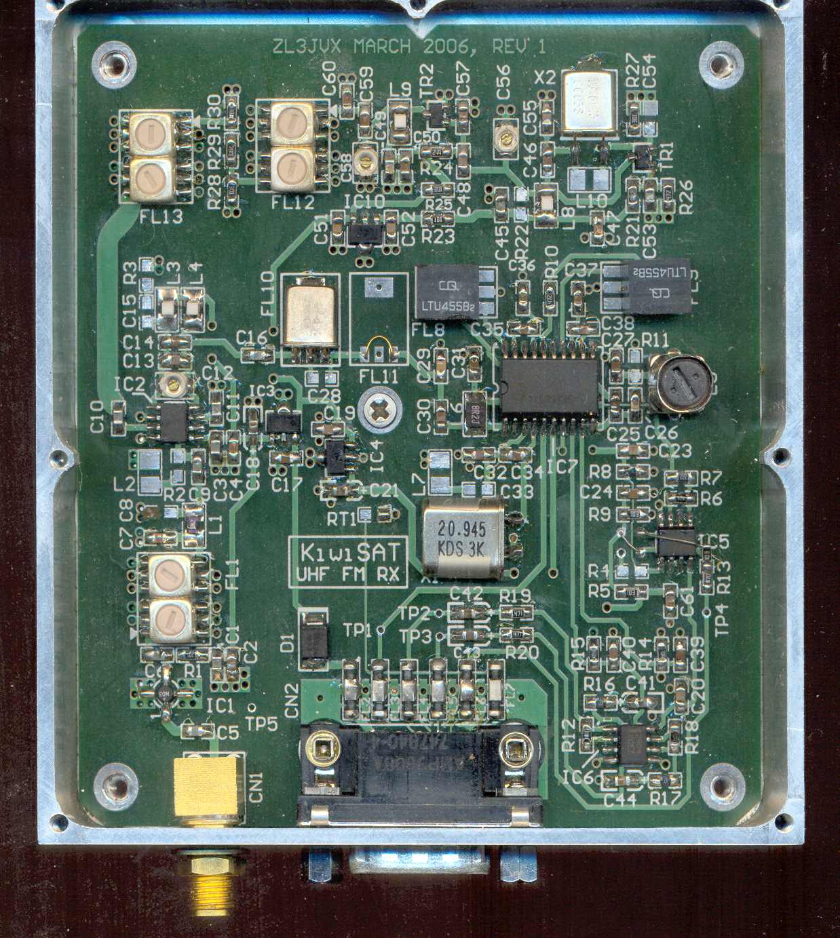
FM_Receivers/2008-02-28 Assembly instructions and BOM/UHF-FM-RX assembled unit.jpg
