AMSAT-ZL/KiwiSAT_Sub-Systems/Solar Panels/First test results for Tecstar cells_.txt

From: "Fred Kennedy" <fredk@kcbbs.gen.nz>
To: <hans2@novozone.co.nz>; <bill@hsmicrowave.com>; <osbornes@paradise.net.nz>; <g.shirville@btinternet.com>
Subject: First test results for Tecstar cells.
Date: Saturday, 8 March 2008 11:08 a.m.

Hi Guys,
               Hot off the press - the first set of results with a reliable clear Sun.
 3 Excel files attached.
    I think they are self explanatory but a few comments.
    The test set up is as pictured and the test was done with the Perspex cell protector 
removed - which upped the no load voltage >0.5 volt.
     The measured angle of the sun from the horizon was taken using the gimbal fitting on the 
left.   It is difficult to read - with my eyesight - but it should be within a degree or so.   (The test 
panel was "squared" onto the Sun using its own indicator.)
   3 sets were taken. with the drawn current controlled by the 3 large rheostats and a small 
500 ohm 5 watt wire wound pot making up the load.  The last reading on each was the 
highest 20mA step I could achieve.
       The cells themselves are the ones I tested at 60 Deg. C in the vac tank for a couple of 
days.   They were from the lower value set as determined under the xenon lamp and 8 
"grubby" ones plus 4 that looked very bright and clean but had a few solder splashes visible 
under the cover glass were used.   They were not cleaned externally either.  Handling of all 
sorts was kept to an absolute minimum.  They are attached to the insulated board using 2 
small double sided Sellotape "fixit" patches - about 1.5m thick - on each cell piece. (So I can 
slice under with a craft knife and remove them for use some time in the future perhaps.  
Suspended like that - above the panel - the slightest pressure from above could crack them 
so I left well alone      

 The shadowing system that I used is shown by Jen on the last pic.  It was very thick black 
card that showed no light whatsoever when held up to the sun.  As you see it covered the cell 
entirely and a very small bit of the cell above and below it. (2 mm or so!!)
   I did it in two positions - the "2nd from top" is shown.
 I'll try and take another set around mid day when the air mass is at its lowest - assuming the 
existing very good Sun conditions are still with us.!!
  Mean time the prototype launch adaptor drawing is now top priority here as I want to get the 
Massey engineering outfit (who have a much bigger lathe than I ) on to it next next week.
     Be interesting to apply the air mass correction to the charts and see what we have bought 
ourselves.  I've added my position co ordinates and UTC time into the chart if anyone is 
interested in doing the maths.
    Anyone need any other readings?
    Very best
Fred
