AMSAT-ZL/KiwiSAT_Sub-Systems/BCR/BCR_ADC_Calibration.pdf

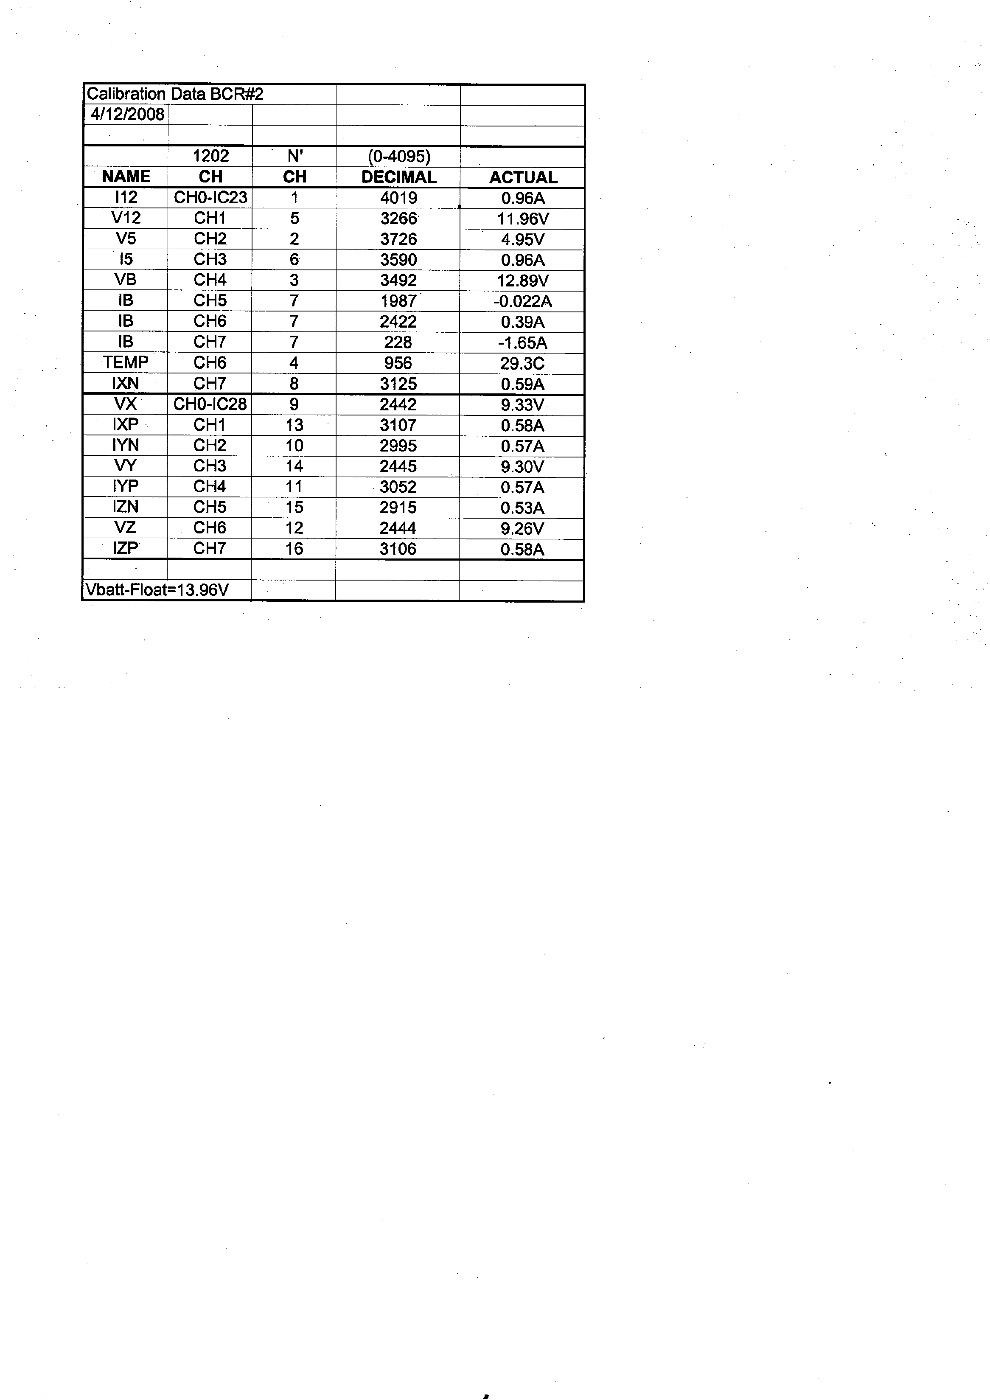
[picture p115: page 1]
