AMSAT-ZL/KiwiSAT_Sub-Systems/Solar Panels/Solar cell evaluation 2.xls

Cell No 10925 01-068 |  | (Rev.2)
Res. Ohms | Volts | Current mA | Power mW
Inf | 2.407 | 0 | 0
13.8 | 2.205 | 157 | 346.185
12.8 | 2.169 | 167 | 362.223
11.8 | 2.12 | 177 | 375.24
10.8 | 2.03 | 185 | 375.55
9.8 | 1.869 | 189 | 353.241
8.8 | 1.696 | 191 | 323.936
7.8 | 1.517 | 192 | 291.264
6.8 | 1.332 | 193 | 257.076
Lit with xenon lamp
Inf | 2.398 | 0 | 0
13.8 | 2.153 | 154 | 331.562
12.8 | 2.122 | 163 | 345.886
11.8 | 2.068 | 174 | 359.832
10.8 | 1.981 | 182 | 360.542
9.8 | 1.828 | 185 | 338.18
8.8 | 1.657 | 187 | 309.859
7.8 | 1.483 | 189 | 280.287
6.8 | 1.303 | 190 | 247.57
Lit with same lamp 20mins later
These lit with steady sunlight at 18 deg alt.
Inf | 2.362 | 0 | 0
13.8 | 2.124 | 152 | 322.848
12.8 | 2.089 | 161 | 336.329
11.8 | 2.035 | 171 | 347.985
10.8 | 1.957 | 179 | 350.303
9.8 | 1.814 | 185 | 335.59
8.8 | 1.665 | 189 | 314.685
7.8 | 1.504 | 192 | 288.768
6.8 | 1.333 | 196 | 261.268
These lit with steady sunlight at 30 degrees alt.
Inf | 2.356 | 0 | 0
13.8 | 2.162 | 155 | 335.11
12.8 | 2.145 | 166 | 356.07
11.8 | 2.124 | 178 | 378.072
10.8 | 2.097 | 192 | 402.624
9.8 | 2.06 | 209 | 430.54
8.8 | 2.007 | 227 | 455.589
7.8 | 1.914 | 245 | 468.93
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
