AMSAT-ZL/KiwiSAT_Sub-Systems/Camera/C328-Camera-Application/camera retest after vacuum test  8 Apr 08.jpg

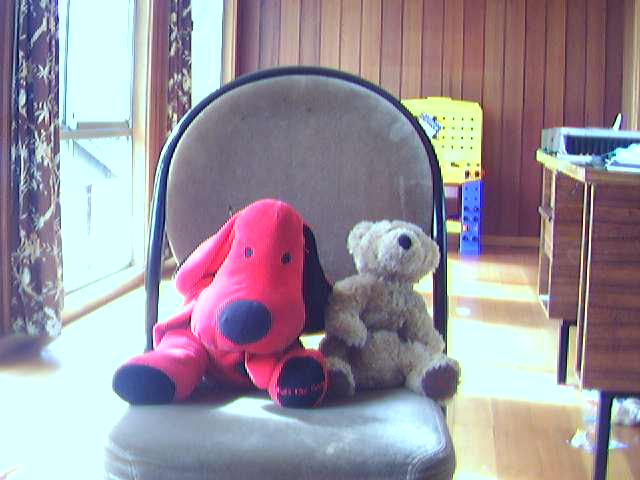
Camera/C328-Camera-Application/camera retest after vacuum test 8 Apr 08.jpg
