AMSAT-ZL/KiwiSAT_Sub-Systems/Camera/C328-Camera-Application/KiwiSAT V2 camera test  5 Jul 08.jpg

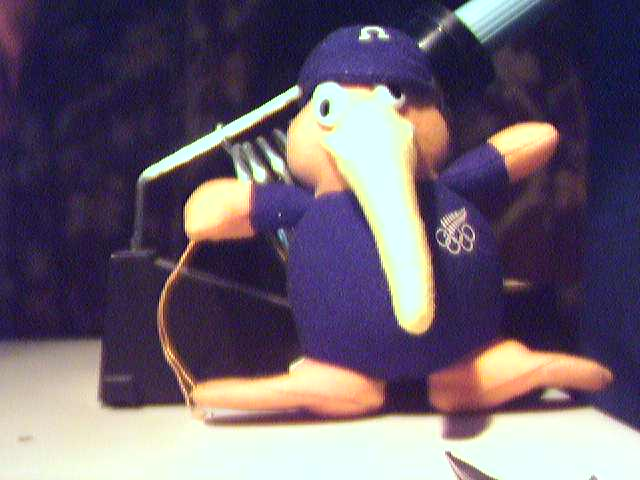
Camera/C328-Camera-Application/KiwiSAT V2 camera test 5 Jul 08.jpg
