AMSAT-ZL/KiwiSAT_Sub-Systems/Solar Panels/Cell test 1.jpg

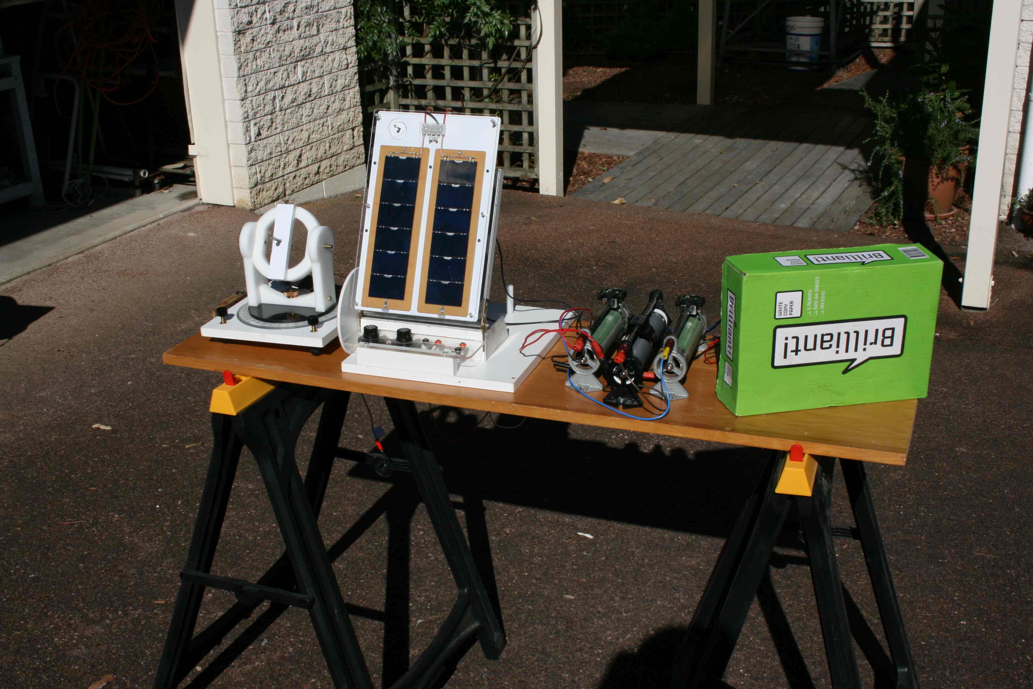
Solar Panels/Cell test 1.jpg
