AMSAT-ZL/KiwiSAT_Sub-Systems/Solar Panels/Cell test 2.jpg

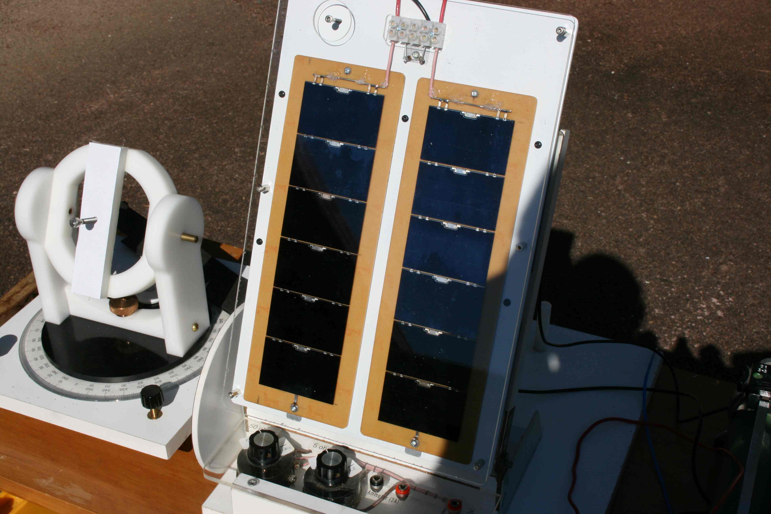
Solar Panels/Cell test 2.jpg
