AMSAT-ZL/KiwiSAT_Sub-Systems/Solar Panels/Cell test 3.jpg

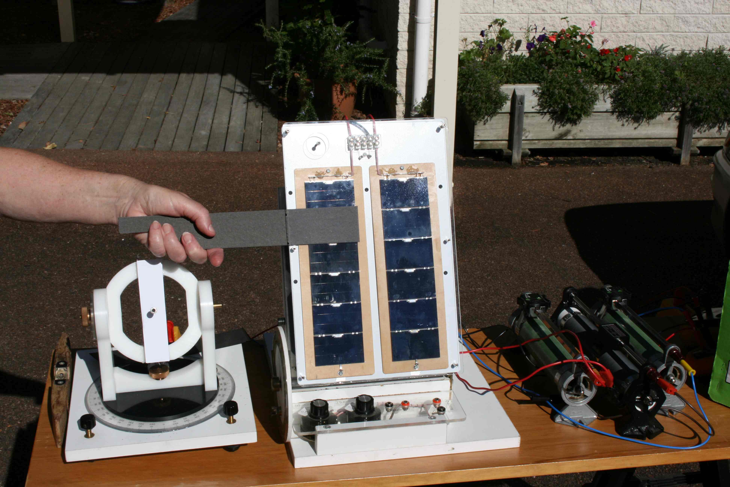
Solar Panels/Cell test 3.jpg
