AMSAT-ZL/KiwiSAT_Sub-Systems/FM_Receivers/drill and top solder.pdf

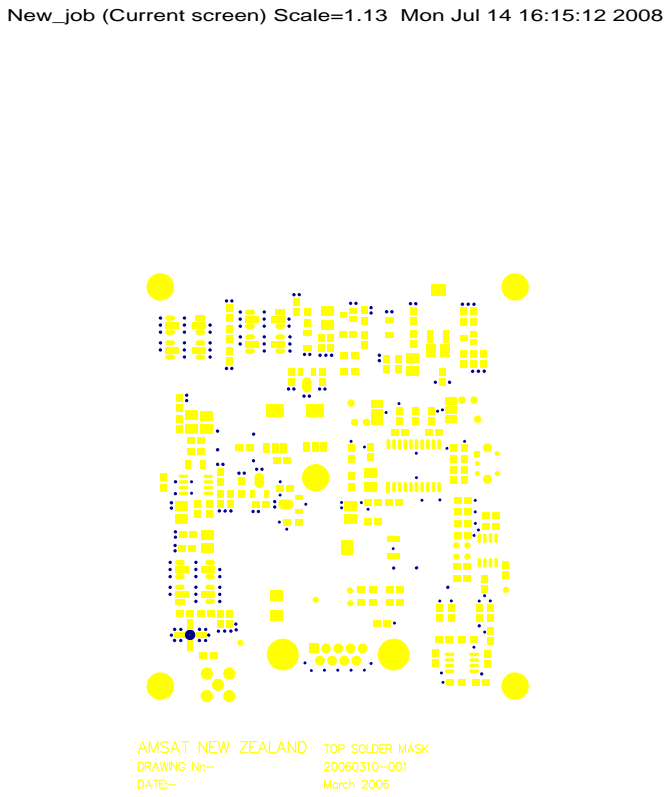
[picture p122: page 1]

New_job (Current screen) Scale=1.13 Mon Jul 14 16:15:12 2008
