AMSAT-ZL/KiwiSAT_Sub-Systems/Launch Adapter/Launch Adaptor - Concept 1 (CGWIC)2.pdf

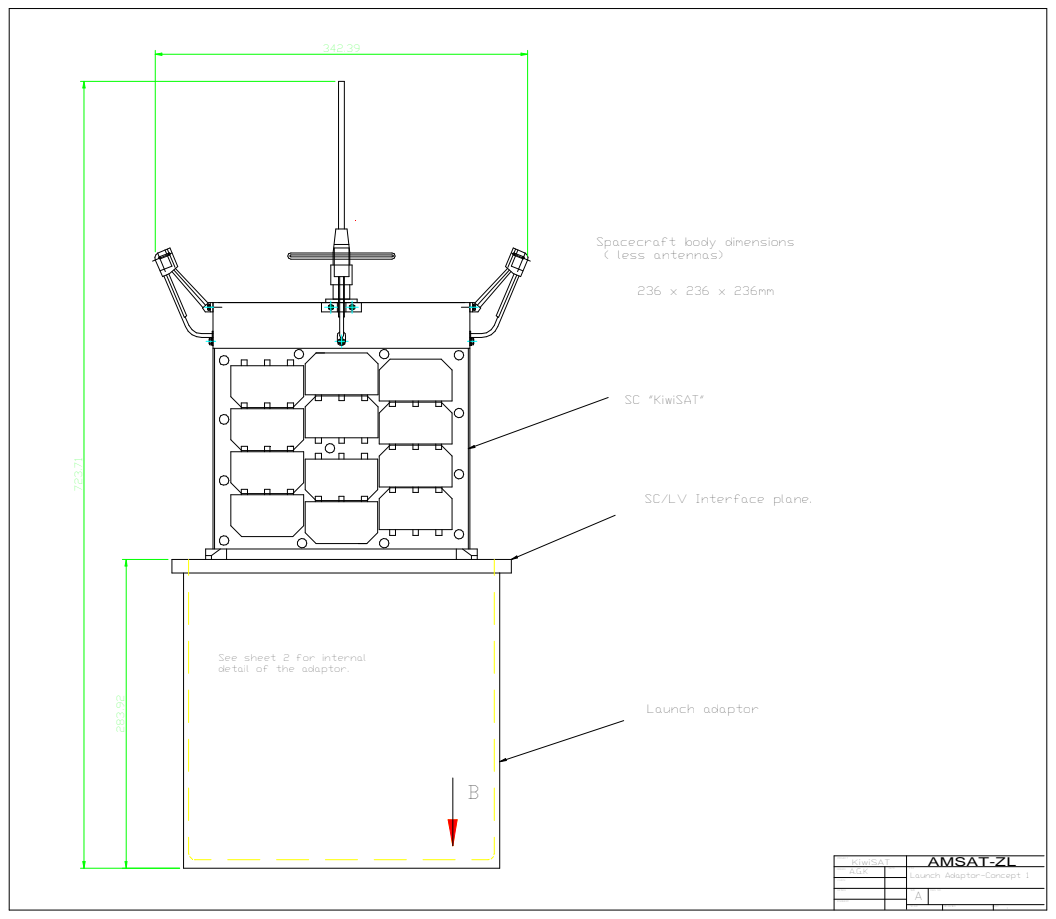
[picture p123: page 1]
Launch adaptor; SC "KiwiSAT"

Spacecraft body dimensions
( less antennas)

SC/LV Interface plane.

See sheet 2 for internal
detail of the adaptor.

DRAWN A.G.K | DATE | TITLE Launch Adaptor-Concept 1

PROJECT KiwiSAT | AMSAT-ZL

CHECK

DESIGN | | SIZE A | DWG. NO.

ENGINEER | | SCALE RELEASED SHEET 1
