AMSAT-ZL/KiwiSAT_Sub-Systems/Launch Adapter/Launch Adaptor Concept 2 (CGWIC).pdf

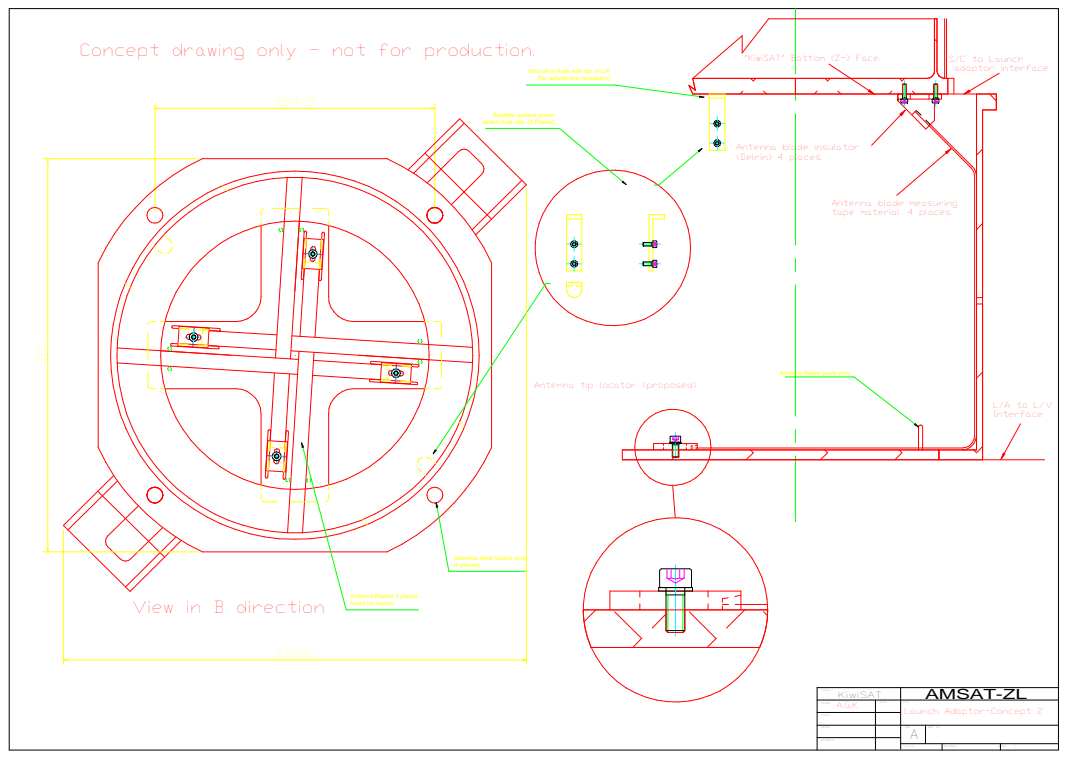
[picture p124: page 1]
S/C to Launch adaptor interface; L/A to L/V Interface; Satellite release power

Concept drawing only - not for production.

"KiwiSAT" Bottom (Z-) Face.

Hold off is flush with top of L/A
(No adjustment necessary)

switch hold offs. (2 Places)

Antenna blade insulator
(Delrin) 4 places.

Antenna blade measuring
tape material. 4 places.

Antenna Blade guide pins

Antenna tip locator (proposed)

Stainless steel locator pins
(4 places)

View in B direction

Antenna Blades 4 places -
furled for launch

PROJECT KiwiSAT | AMSAT-ZL

DRAWN | DATE | TITLE Launch Adaptor-Concept 2 A.G.K

CHECK

DESIGN | | SIZE A | DWG. NO.

ENGINEER | | SCALE RELEASED SHEET 2
