AMSAT-ZL/KiwiSAT_Sub-Systems/RamDisk/RamDisk Schematic 17Jul2004.pdf

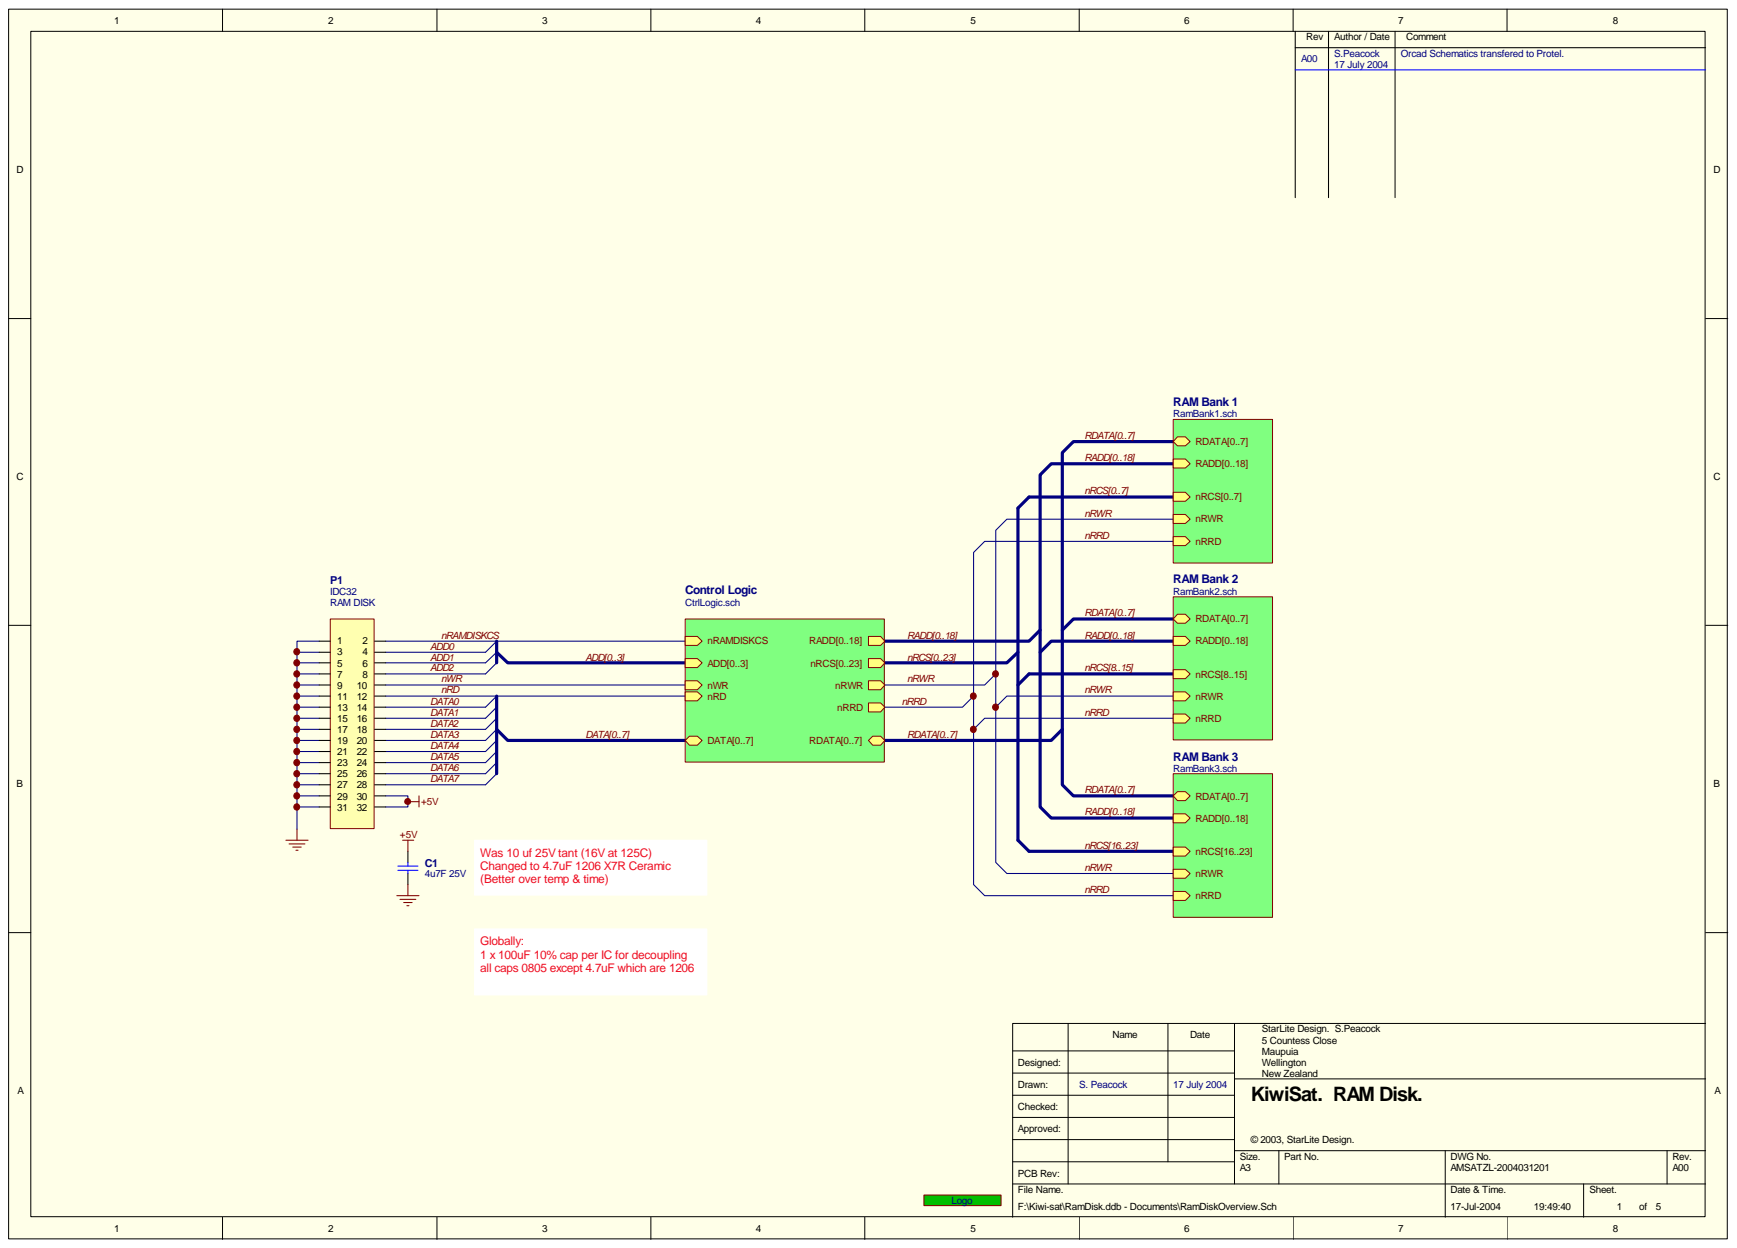
[picture p136: page 1]
Approved:; Name; Date; Designed:; Checked:; Drawn:; © 2003, StarLite Design.; Rev; Author / Date; Comment; Size.; Rev.; Sheet.; 17-Jul-2004; Part No.; DWG No.; AMSATZL-2004031201; File Name.; Date & Time.; nRWR; nRRD; nRCS[0..23]; RADD[0..18]; RDATA[0..7]; nRCS[0..7]; nRCS[8..15]; nRCS[16..23]; DATA[0..7]; ADD[0..3]; nRAMDISKCS ADD0 ADD1 ADD2; DATA0 DATA1 DATA2 DATA3 DATA4 DATA5 DATA6 DATA7; nRD; nWR; nRAMDISKCS; Control Logic CtrlLogic.sch; RAM Bank 1 RamBank1.sch; RAM Bank 2 RamBank2.sch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

Orcad Schematics transfered to Protel.

Was 10 uf 25V tant (16V at 125C)
Changed to 4.7uF 1206 X7R Ceramic
(Better over temp & time)

Globally:
1 x 100uF 10% cap per IC for decoupling
all caps 0805 except 4.7uF which are 1206

StarLite Design. S.Peacock
5 Countess Close
Maupuia
Wellington
New Zealand
KiwiSat. RAM Disk.

PCB Rev:
F:\Kiwi-sat\RamDisk.ddb - Documents\RamDiskOverview.Sch

I/O | 55 I/O | 56 I/O | 57 I/O | 58 I/O | 59 I/O | 60 I/O | 61 I/O | 62 I/O | 63 I/O | 64 I/O | 65 I/O | 66 I/O | 67 I/O | 68

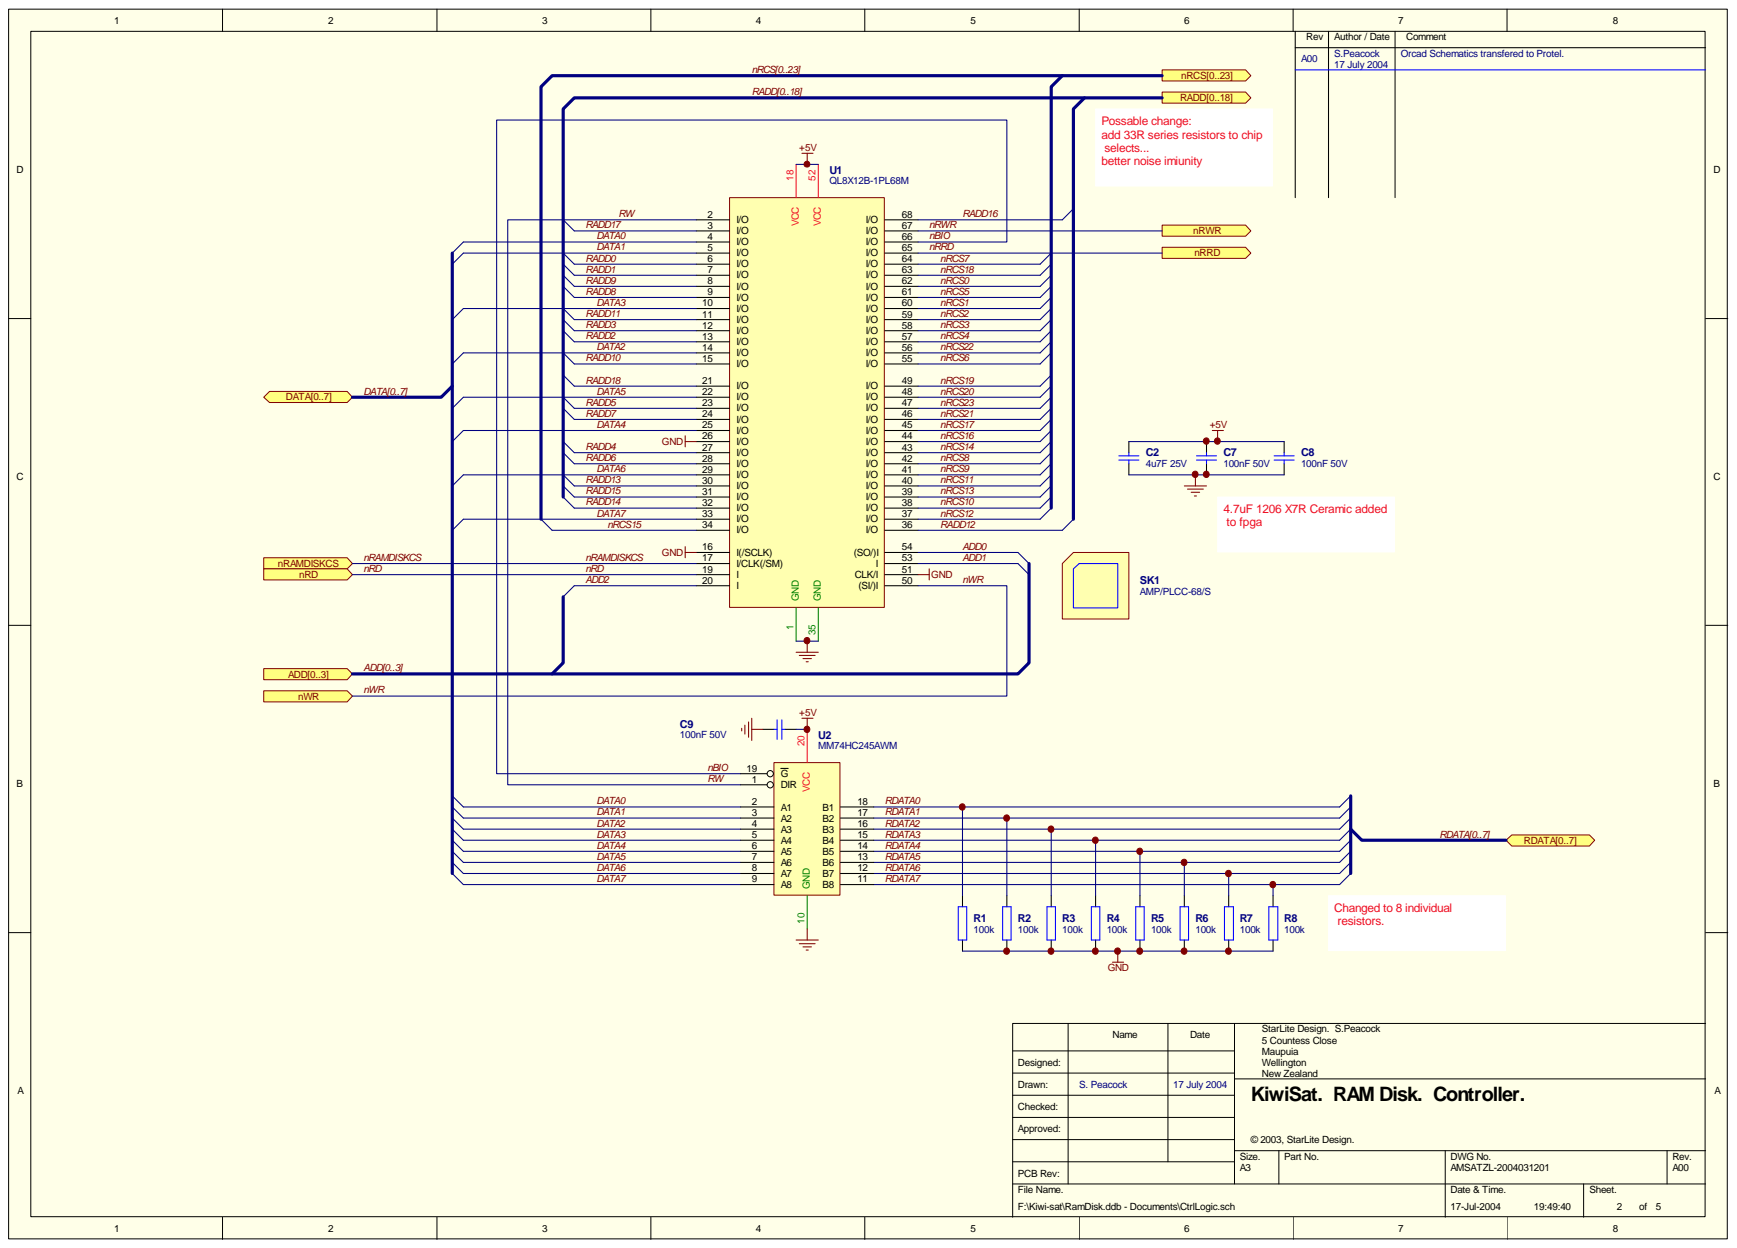
[picture p137: page 2]

Possable change:
add 33R series resistors to chip
selects...
better noise imiunity

StarLite Design. S.Peacock
5 Countess Close
Maupuia
Wellington
New Zealand
KiwiSat. RAM Disk. Controller.

F:\Kiwi-sat\RamDisk.ddb - Documents\CtrlLogic.sch

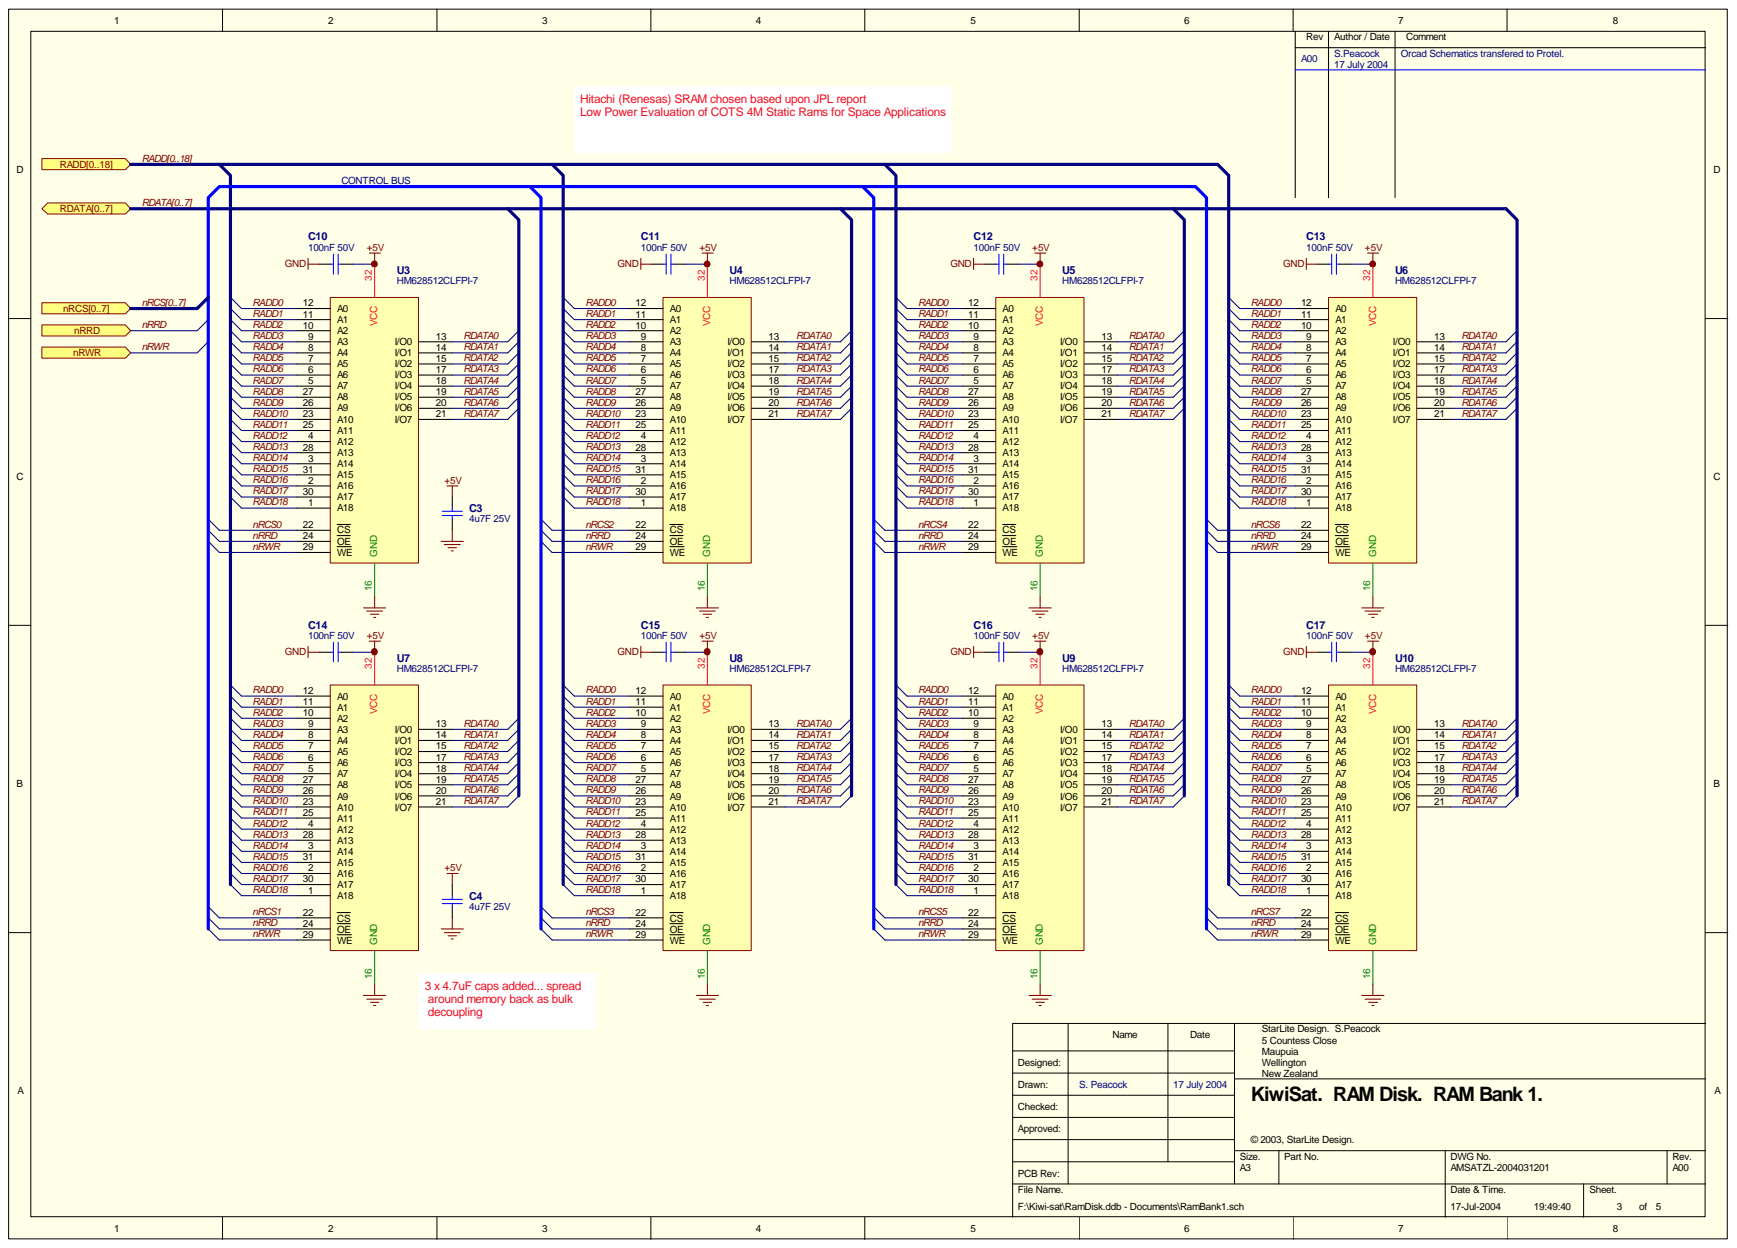
[picture p138: page 3]

Hitachi (Renesas) SRAM chosen based upon JPL report
Low Power Evaluation of COTS 4M Static Rams for Space Applications

3 x 4.7uF caps added... spread
around memory back as bulk
decoupling

StarLite Design. S.Peacock
5 Countess Close
Maupuia
Wellington
New Zealand
KiwiSat. RAM Disk. RAM Bank 1.

F:\Kiwi-sat\RamDisk.ddb - Documents\RamBank1.sch

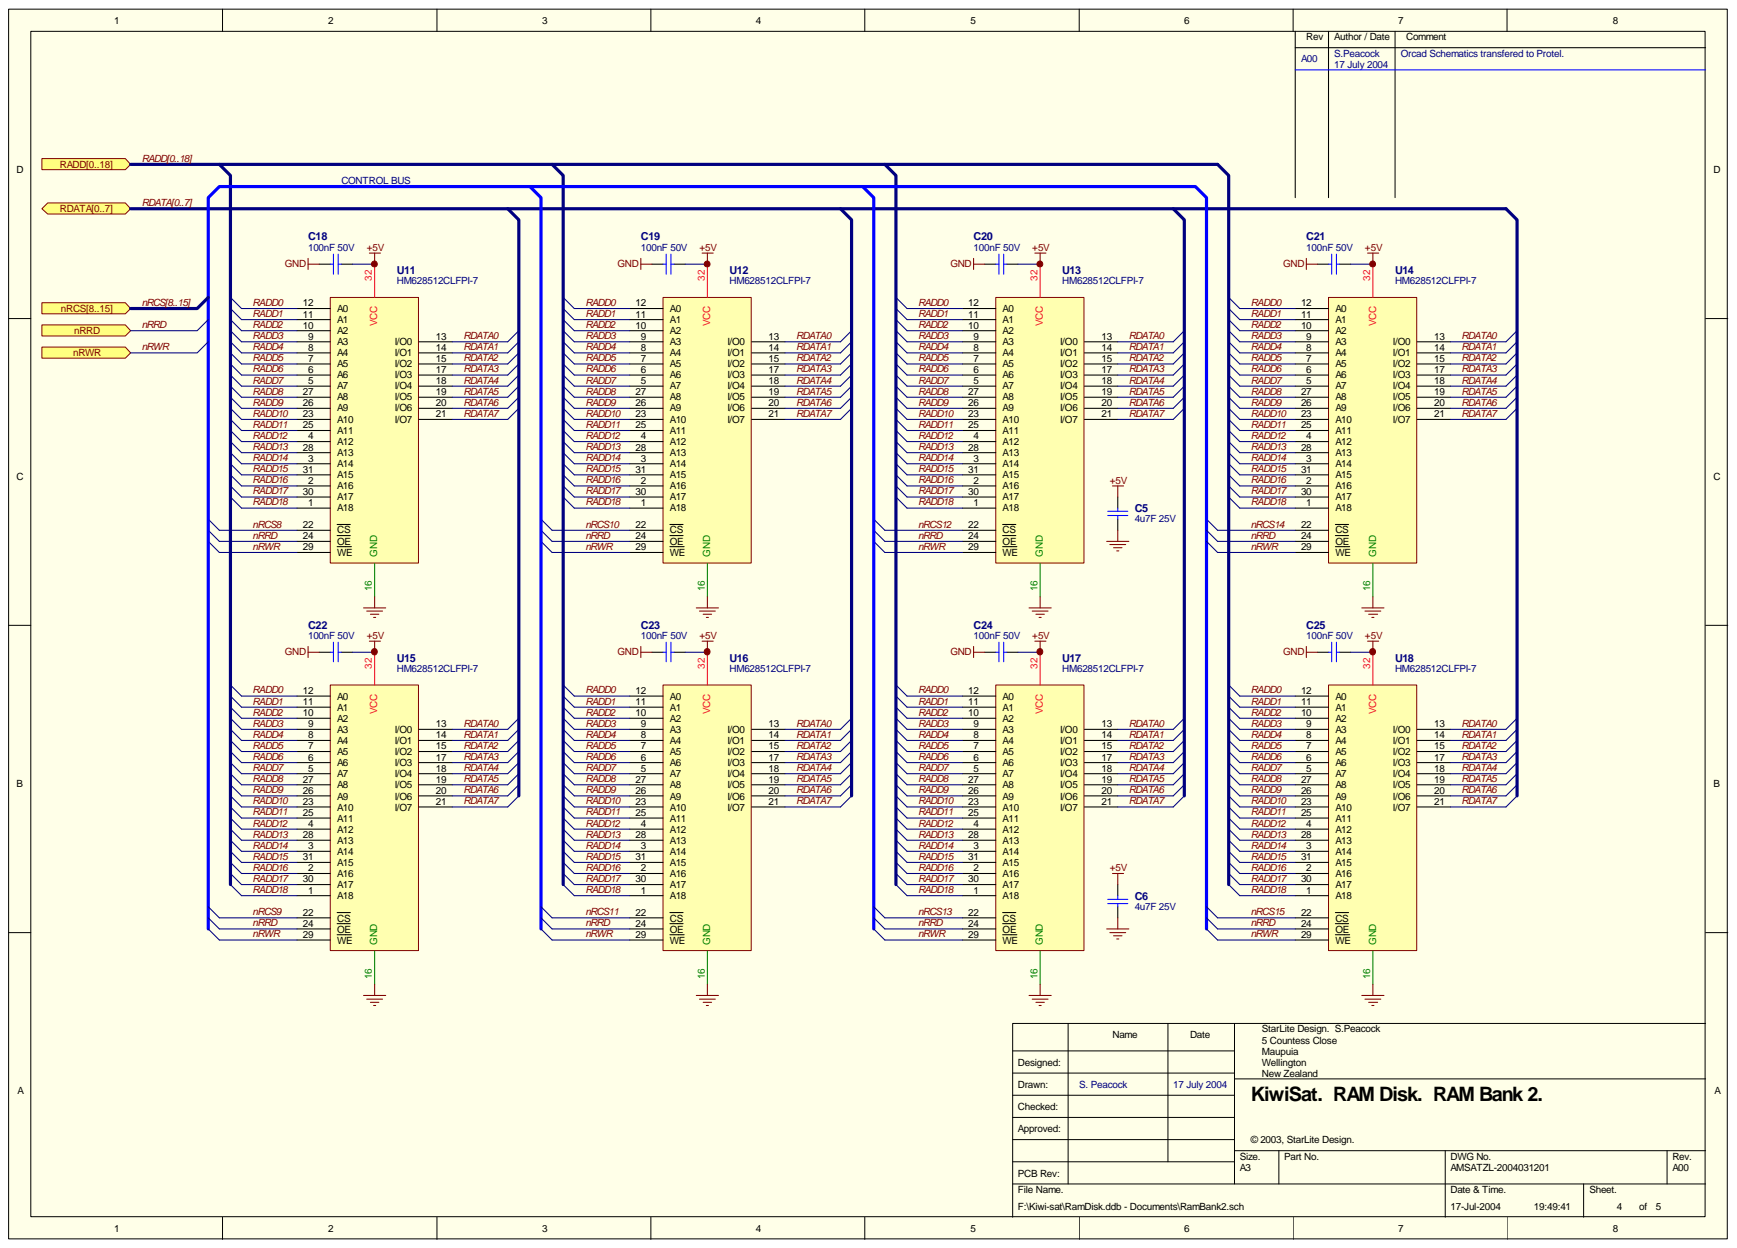
[picture p139: page 4]

StarLite Design. S.Peacock
5 Countess Close
Maupuia
Wellington
New Zealand
KiwiSat. RAM Disk. RAM Bank 2.

F:\Kiwi-sat\RamDisk.ddb - Documents\RamBank2.sch

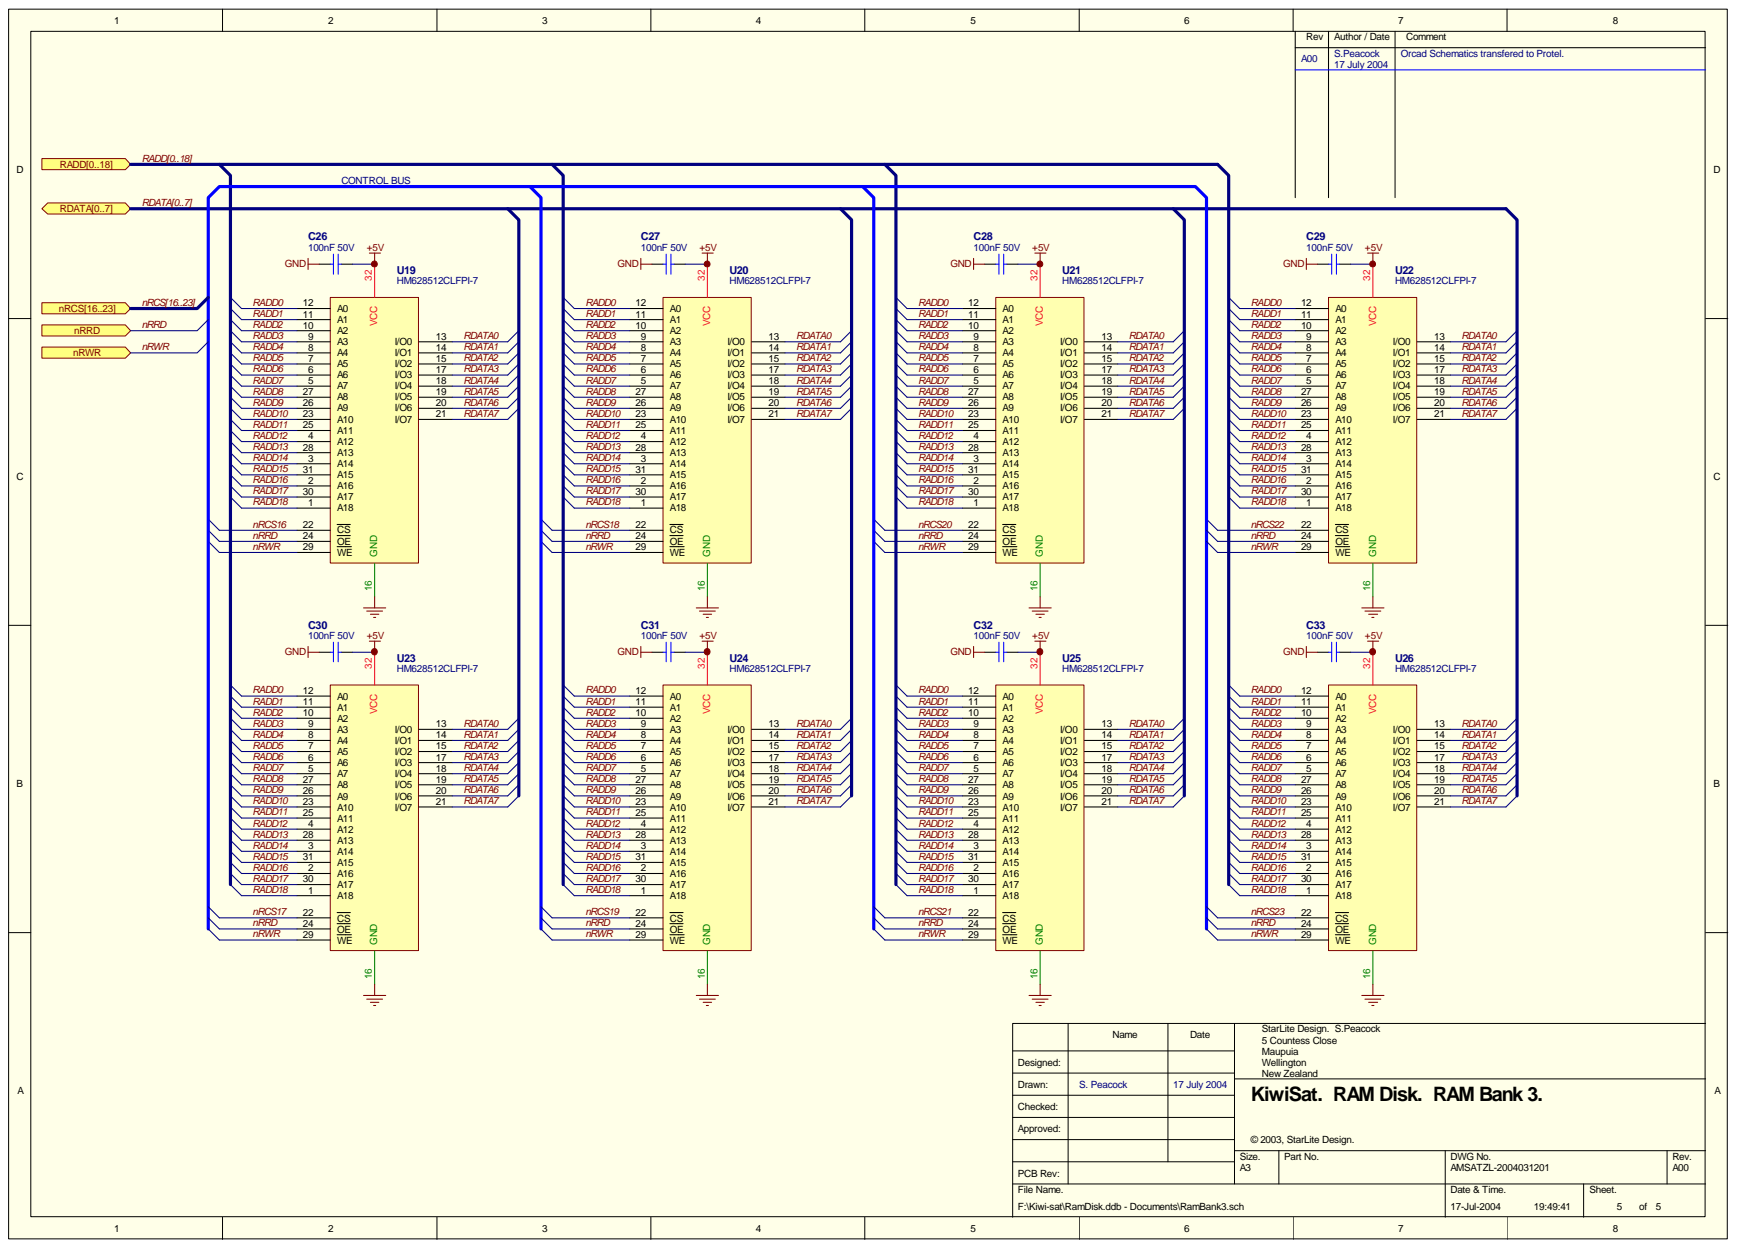
[picture p140: page 5]

StarLite Design. S.Peacock
5 Countess Close
Maupuia
Wellington
New Zealand
KiwiSat. RAM Disk. RAM Bank 3.

F:\Kiwi-sat\RamDisk.ddb - Documents\RamBank3.sch
