AMSAT-ZL/KiwiSAT_Sub-Systems/Wiring_Loom/Attic Sch.pdf

## A to D Board

## Camera +ve

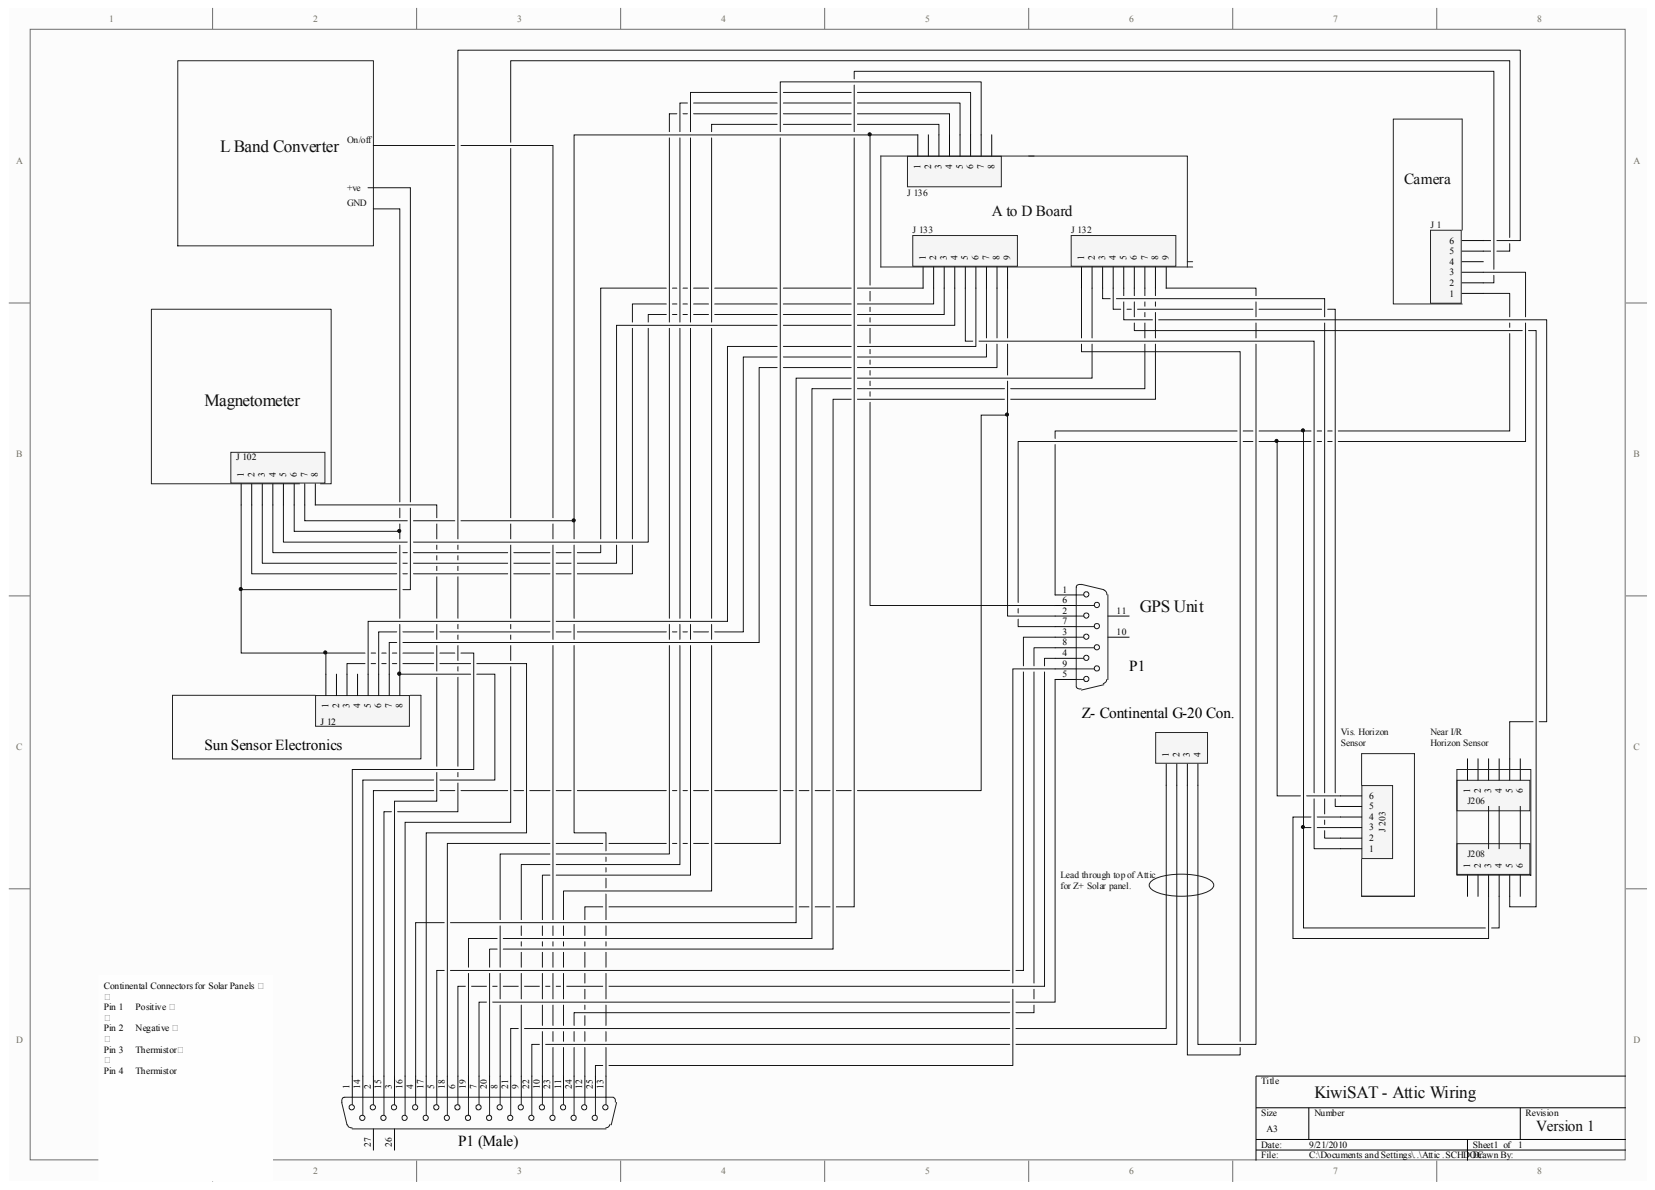
[picture p141: page 1]
Size; Number; Revision; Date:; Sheet of; File:; C:\Documents and Settings\..\Attic .SCHDOCDrawn By:; Continental Connectors for Solar Panels   Pin 1 Positive   Pin 2 Negative   Pin 3 Thermistor  Pin 4 Thermistor; P1 (Male); Magnetometer; GPS Unit; Vis. Horizon; Near I/R; Z- Continental G-20 Con.; GND; L Band Converter; Sensor; Horizon Sensor; On/off; Version 1

Sun Sensor Electronics

Lead through top of Attic
for Z+ Solar panel.

Title
KiwiSAT - Attic Wiring
