AMSAT-ZL/KiwiSAT_Sub-Systems/Wiring_Loom/Battery Tray Sch.pdf

## X Axis (#1)

## Z Axis (#3)

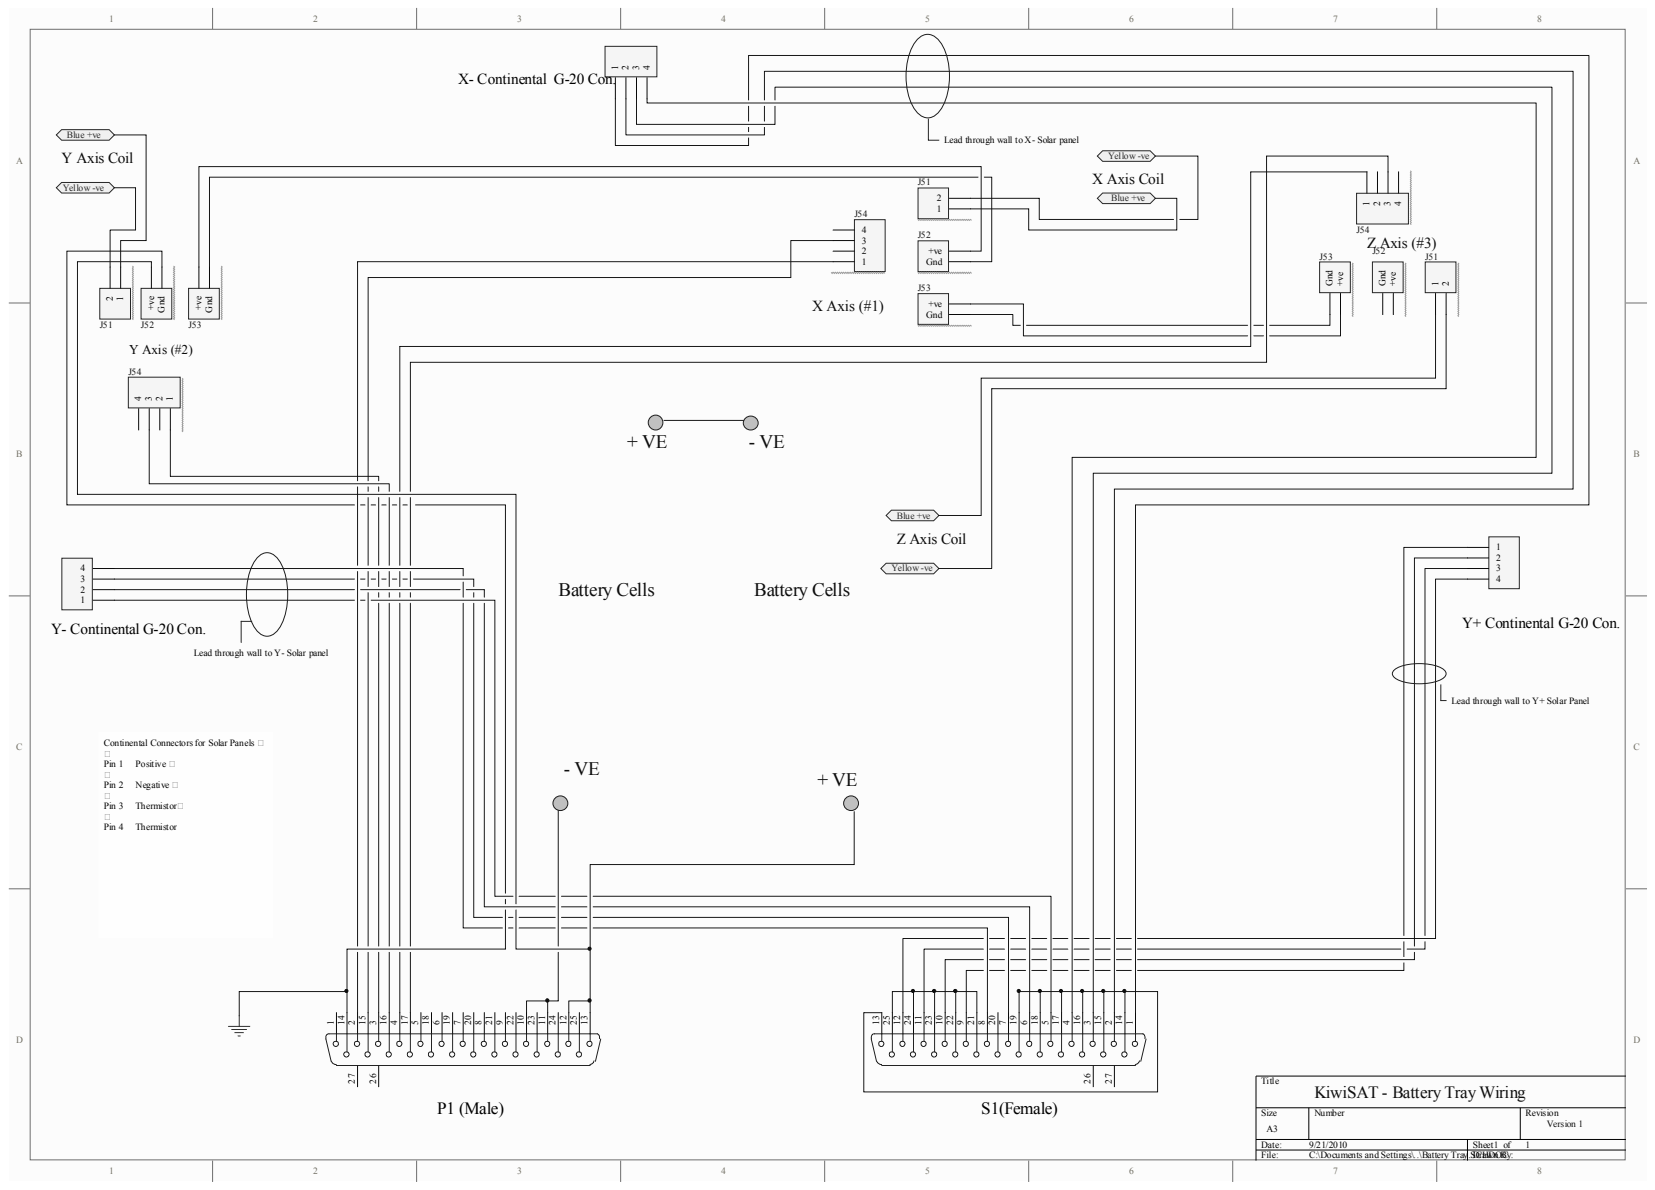
[picture p142: page 1]
Size; Number; Revision; Date:; Sheet of; File:; C:\Documents and Settings\..\Battery Tray.SCHDOC Drawn By:; Gnd; +ve Gnd; J53 Y Axis (#2); P1 (Male); S1(Female); Y- Continental G-20 Con.; X- Continental G-20 Con.; Y+ Continental G-20 Con.; Blue +ve; Yellow -ve; Z Axis Coil; Y Axis Coil; X Axis Coil; Battery Cells; Continental Connectors for Solar Panels   Pin 1 Positive   Pin 2 Negative   Pin 3 Thermistor  Pin 4 Thermistor; Version 1

Lead through wall to X- Solar panel

Lead through wall to Y- Solar panel

Lead through wall to Y+ Solar Panel

Title
KiwiSAT - Battery Tray Wiring
