AMSAT-ZL/KiwiSAT_Sub-Systems/Wiring_Loom/Receiver Tray Sch.pdf

## A to D Board

+ ve

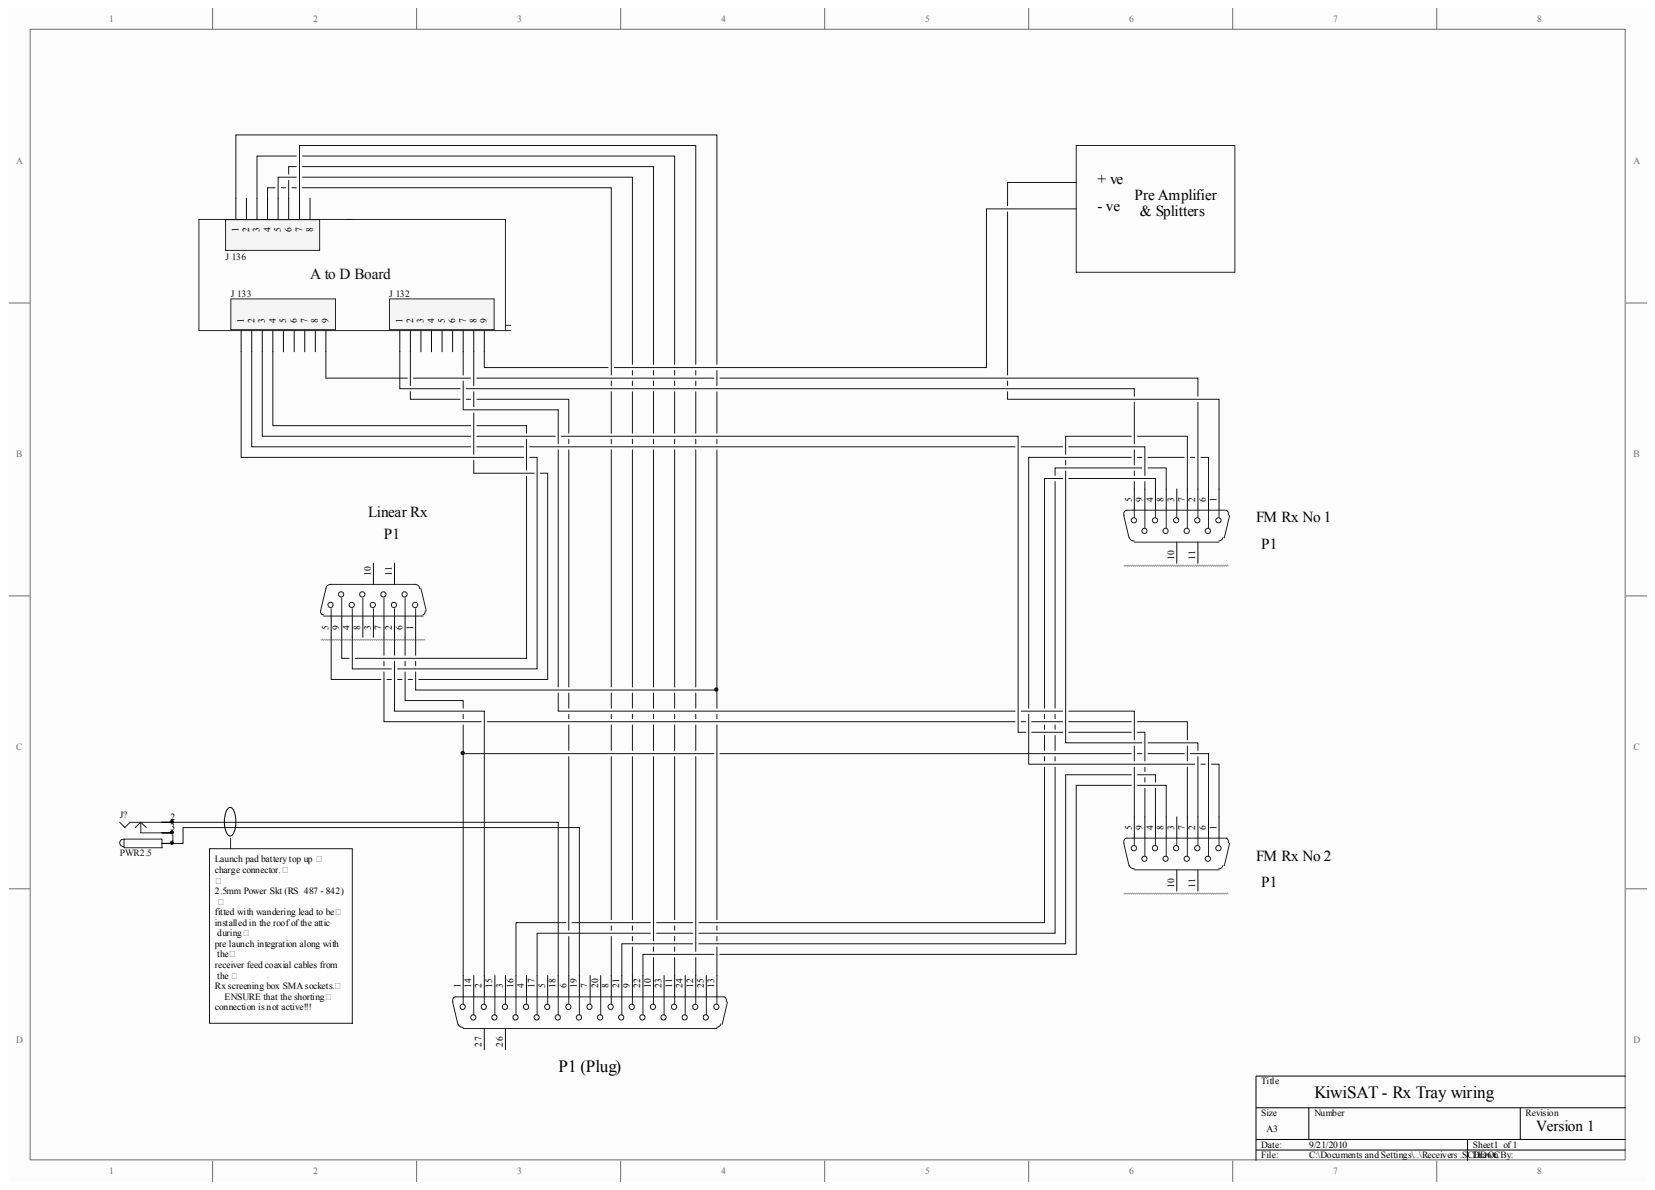
[picture p143: page 1]
Size; Number; Revision; Date:; Sheet of; File:; C:\Documents and Settings\..\Receivers .SCHDOC Drawn By:; P1 (Plug); Linear Rx; Version 1; PWR2.5; Launch pad battery top up 

- ve Pre Amplifier
& Splitters

charge connector.
2.5mm Power Skt (RS 487 - 842)
fitted with wandering lead to be
installed in the roof of the attic
during
pre launch integration along with
the
receiver feed coaxial cables from
the 
Rx screening box SMA sockets.
ENSURE that the shorting
connection is not active!!!

Title
KiwiSAT - Rx Tray wiring
