AMSAT-ZL/KiwiSAT_Sub-Systems/Wiring_Loom/Transmitter Tray Sch.pdf

P1

# 2 mtr FM Tx

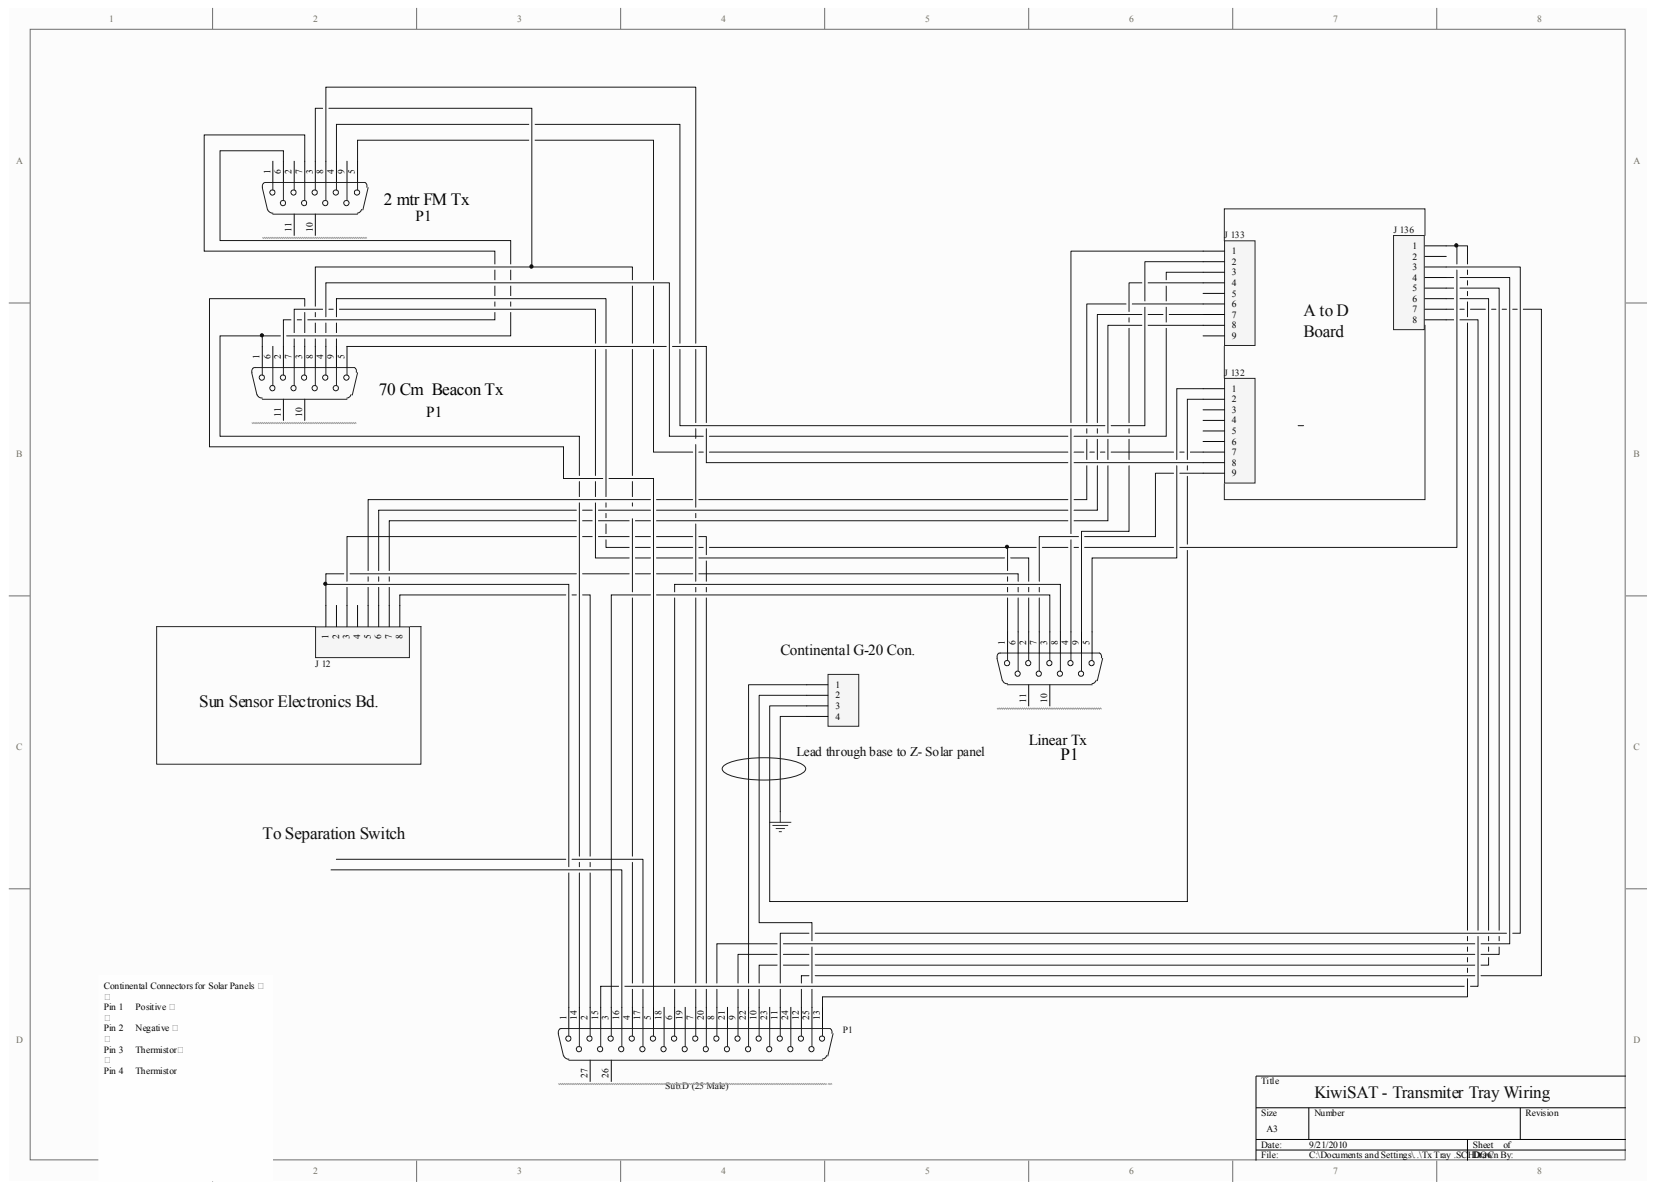
[picture p144: page 1]
Title; Size; Number; Revision; Date:; Sheet of; File:; C:\Documents and Settings\..\Tx Tray .SCHDOC Drawn By:; Sub.D (25 Male); KiwiSAT - Transmiter Tray Wiring; 70 Cm Beacon Tx; Linear Tx; A to D Board; Continental G-20 Con.; Continental Connectors for Solar Panels   Pin 1 Positive   Pin 2 Negative   Pin 3 Thermistor  Pin 4 Thermistor

Sun Sensor Electronics Bd.

Lead through base to Z- Solar panel

To Separation Switch
