AMSAT-ZL/KiwiSAT_Sub-Systems/FM_Receivers/2008-02-28 Assembly instructions and BOM/UHF-FM-RX1.pdf

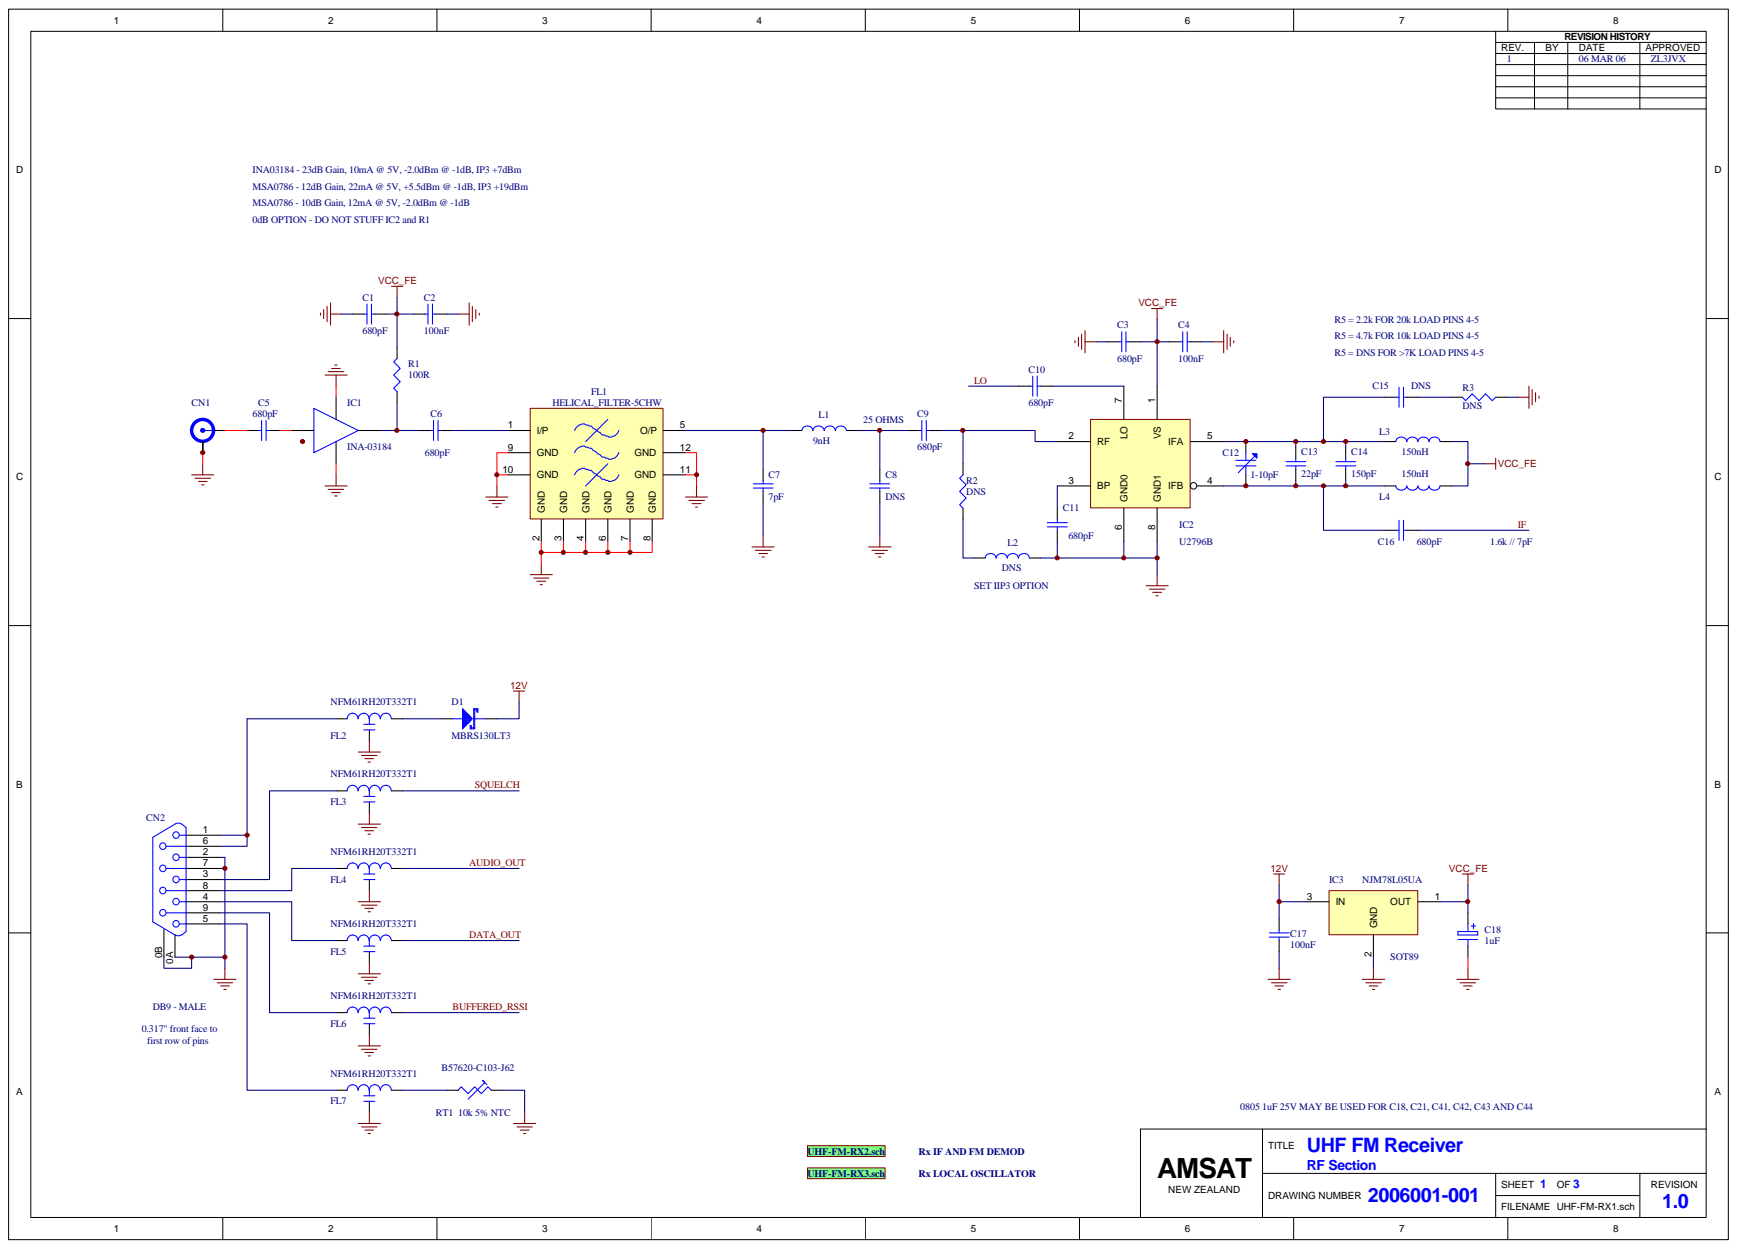
[picture p145: page 1]

INA03184 - 23dB Gain, 10mA @ 5V, -2.0dBm @ -1dB, IP3 +7dBm
MSA0786 - 12dB Gain, 22mA @ 5V, +5.5dBm @ -1dB, IP3 +19dBm
MSA0786 - 10dB Gain, 12mA @ 5V, -2.0dBm @ -1dB
0dB OPTION - DO NOT STUFF IC2 and R1

R5 = 2.2k FOR 20k LOAD PINS 4-5
R5 = 4.7k FOR 10k LOAD PINS 4-5
R5 = DNS FOR >7K LOAD PINS 4-5

0.317" front face to
first row of pins

0805 1uF 25V MAY BE USED FOR C18, C21, C41, C42, C43 AND C44

FILENAME UHF-FM-RX1.sch
