AMSAT-ZL/KiwiSAT_Sub-Systems/FM_Receivers/2008-02-28 Assembly instructions and BOM/UHF-FM-RX2.pdf

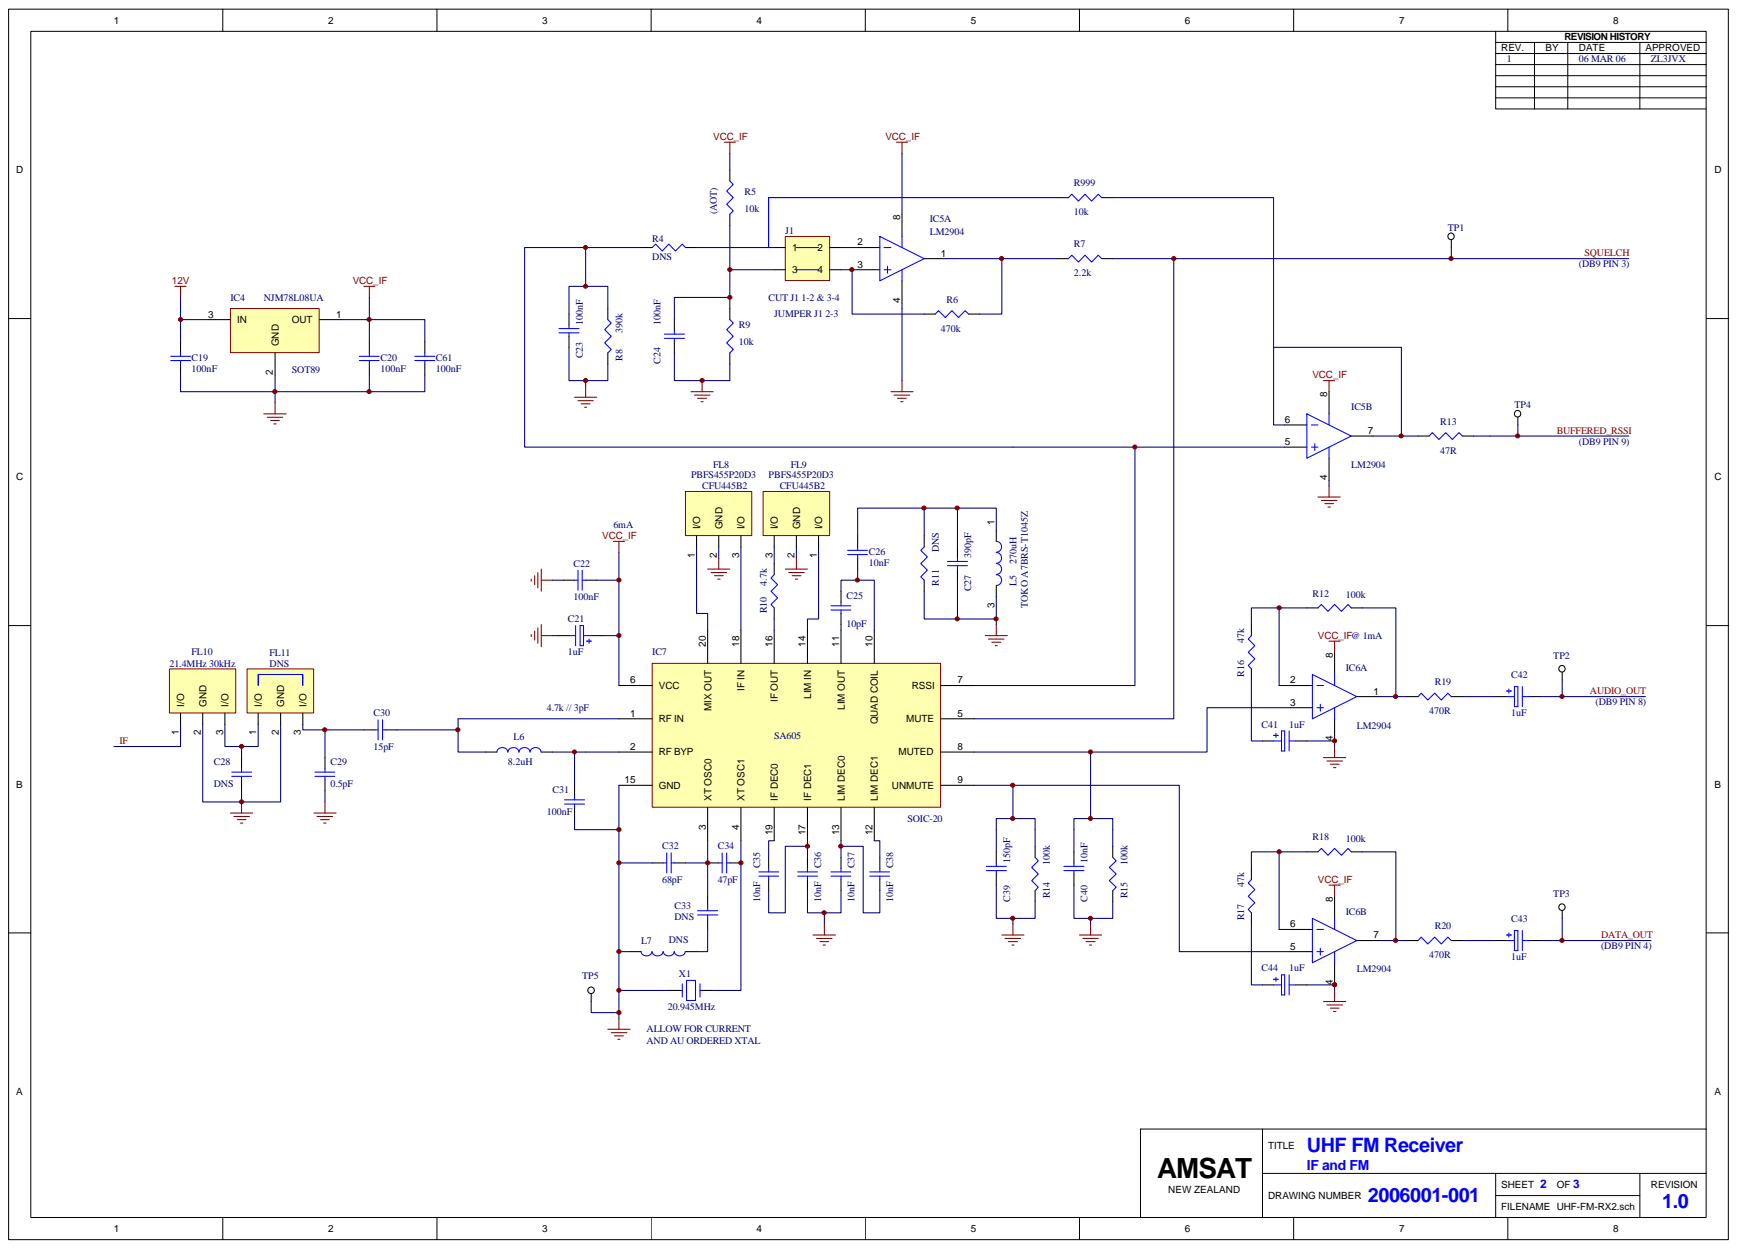
[picture p146: page 1]

ALLOW FOR CURRENT
AND AU ORDERED XTAL

FILENAME UHF-FM-RX2.sch
