AMSAT-ZL/KiwiSAT_Sub-Systems/GPS/Interface RevB/Kiwisat GPS Wiring Diagram  Rev B 20091213.pdf

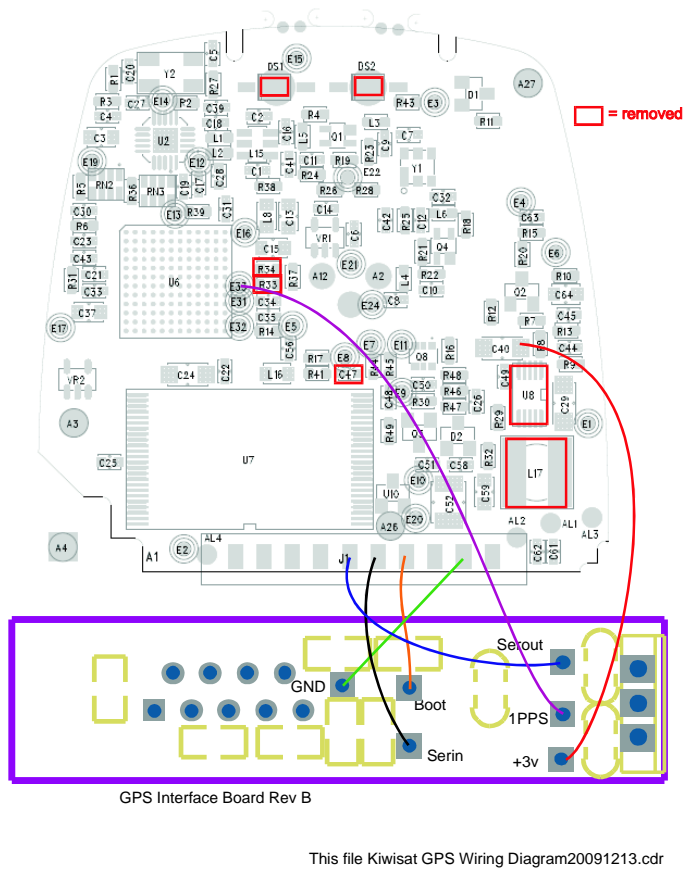
[picture p147: page 1]
GND; Serout; 1PPS; Serin; Boot

GPS Interface Board RevB

This file Kiwisat GPS Wiring Diagram20091213.cdr
