AMSAT-ZL/KiwiSAT_Sub-Systems/IHU/Rev2/Schematics/27-5-08 Schematic.pdf

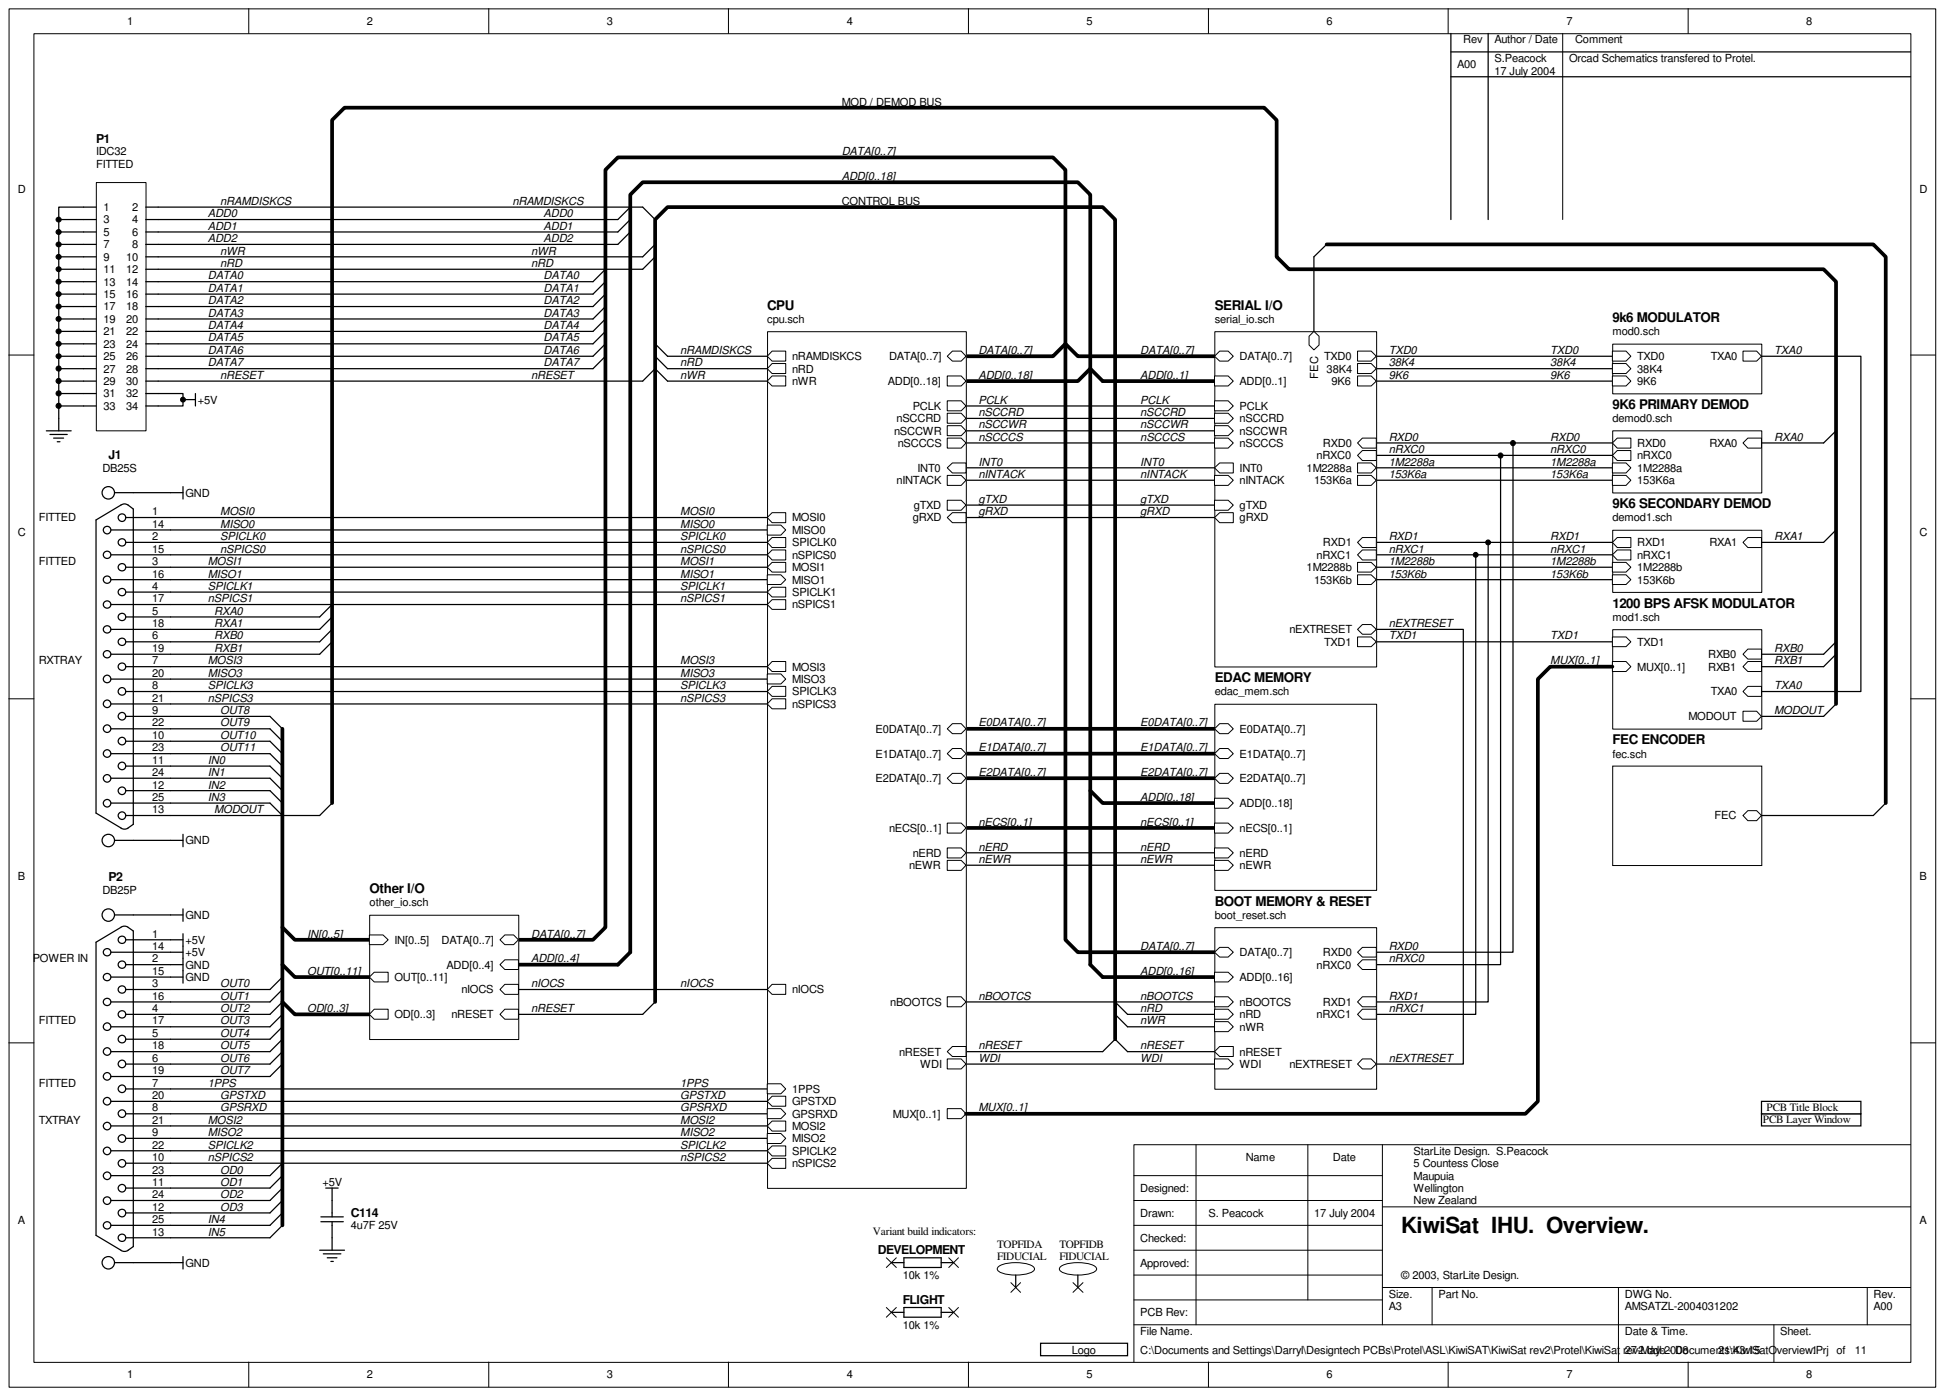
[picture p148: page 1]
Approved:; Name; Date; Designed:; Checked:; Drawn:; © 2003, StarLite Design.; Rev; Author / Date; Comment; Size.; Rev.; Sheet.; 27-May-2008; Part No.; DWG No.; AMSATZL-2004031202; File Name.; Date & Time.; nRAMDISKCS ADD0 ADD1 ADD2; DATA0 DATA1 DATA2 DATA3 DATA4 DATA5 DATA6 DATA7; nRD; nWR; P1 IDC32 FITTED; FITTED; RXTRAY; TXTRAY; POWER IN; GND; GND GND; MOSI0 MISO0 SPICLK0 nSPICS0; nSPICS1; MOSI1 MISO1 SPICLK1; RXA0 RXA1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

MOD / DEMOD BUS

BOOT MEMORY & RESET
boot_reset.sch

PCB Title Block
PCB Layer Window

StarLite Design. S.Peacock
5 Countess Close
Maupuia
Wellington
New Zealand
KiwiSat IHU. Overview.

Variant build indicators:
FIDUCIAL DEVELOPMENT

PCB Rev:
C:\Documents and Settings\Darryl\Designtech PCBs\Protel\ASL\KiwiSAT\KiwiSat rev2\Protel\KiwiSat rev2.ddb - Documents\KiwiSatOverview.Prj

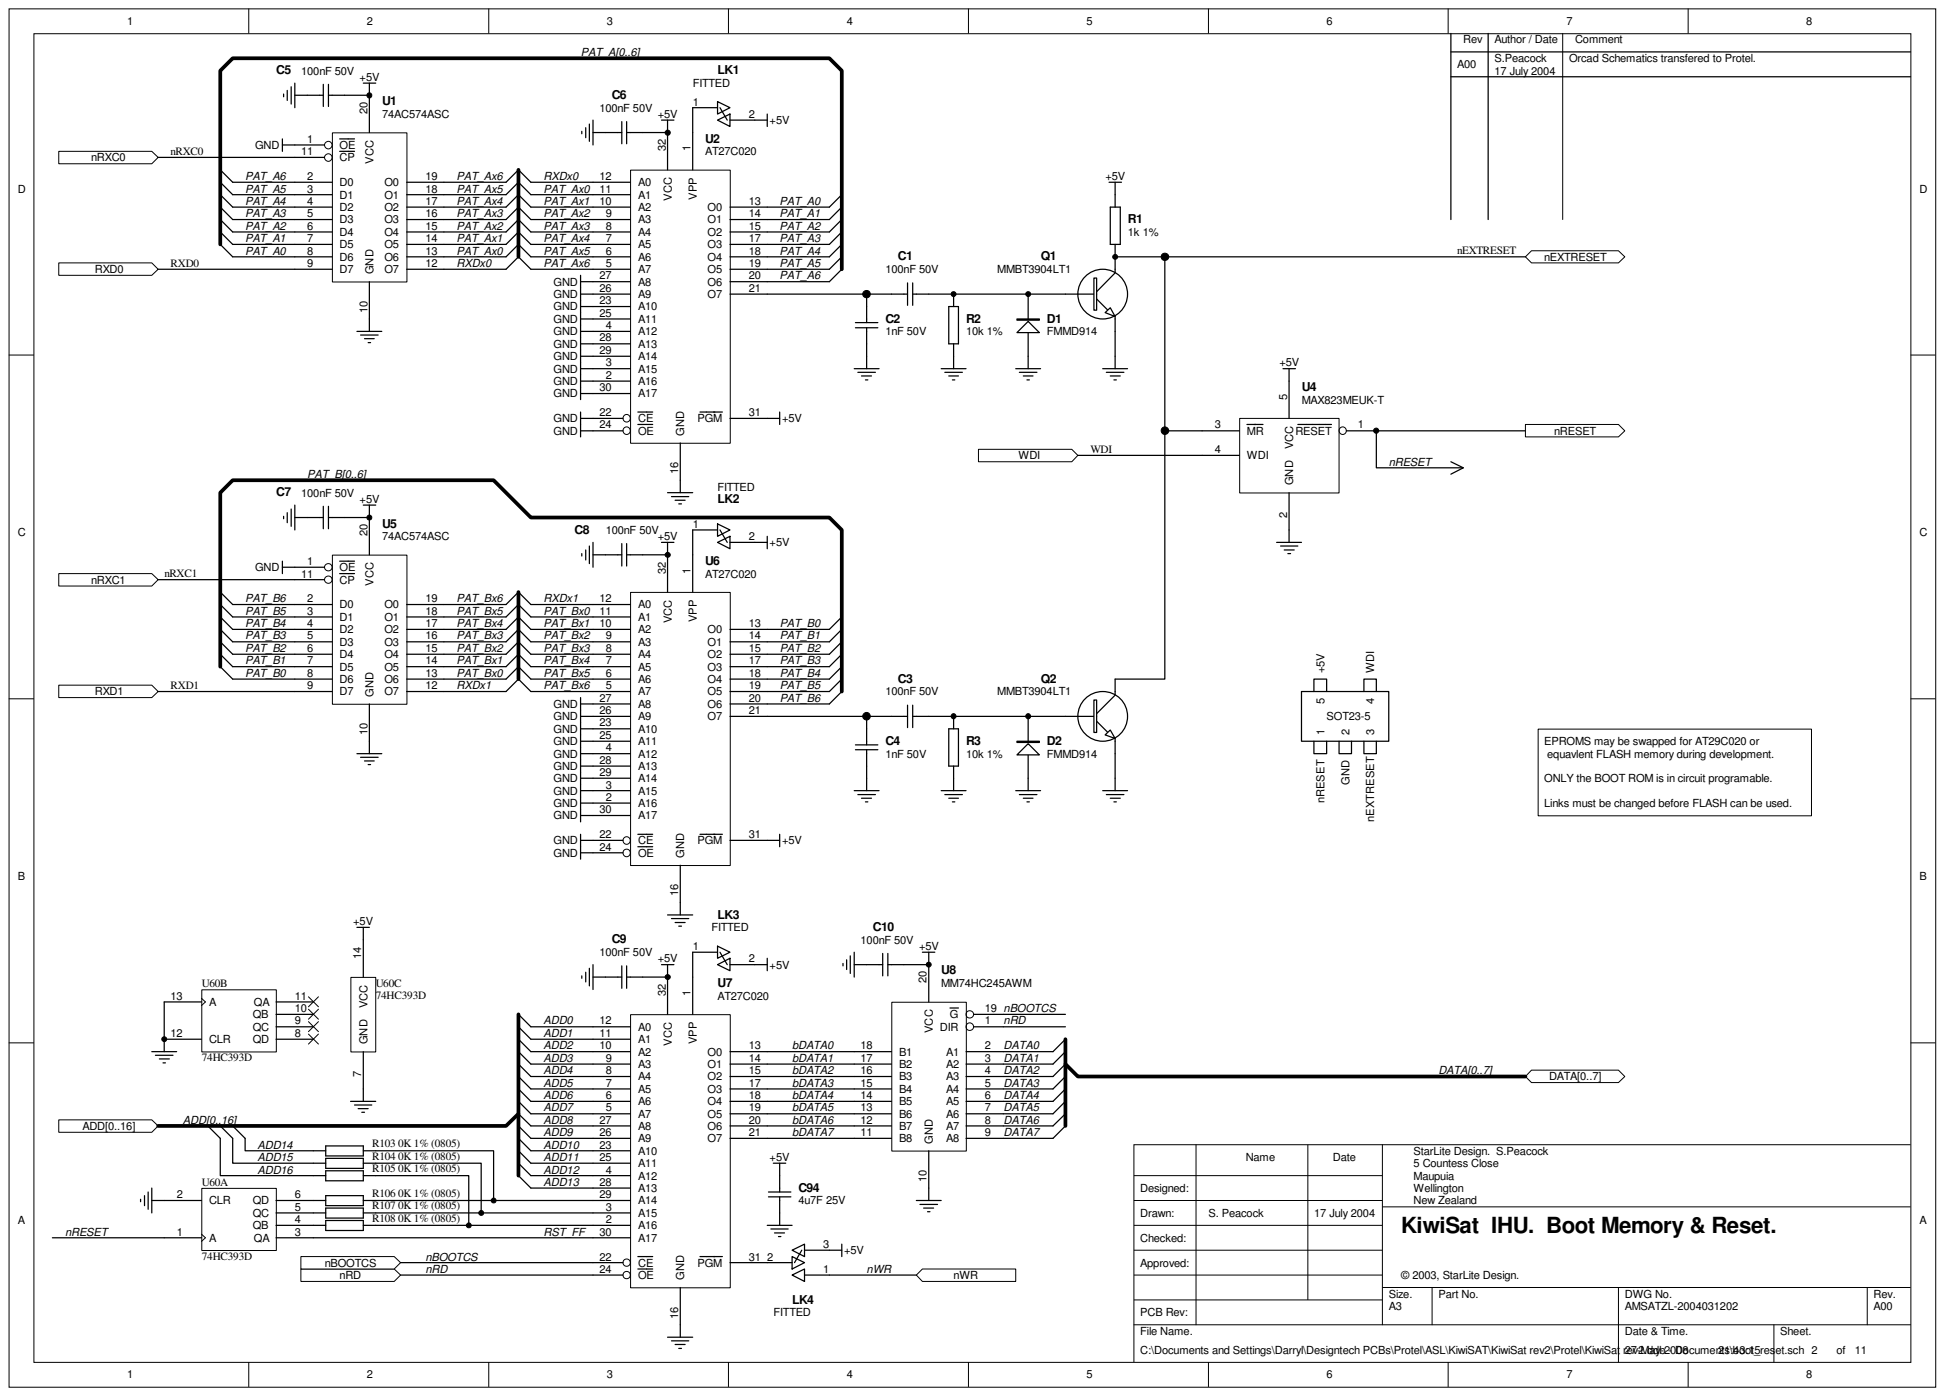
[picture p149: page 2]

EPROMS may be swapped for AT29C020 or
equavlent FLASH memory during development.

ONLY the BOOT ROM is in circuit programable.

Links must be changed before FLASH can be used.

StarLite Design. S.Peacock
5 Countess Close
Maupuia
Wellington
New Zealand
KiwiSat IHU. Boot Memory & Reset.

C:\Documents and Settings\Darryl\Designtech PCBs\Protel\ASL\KiwiSAT\KiwiSat rev2\Protel\KiwiSat rev2.ddb - Documents\boot_reset.sch

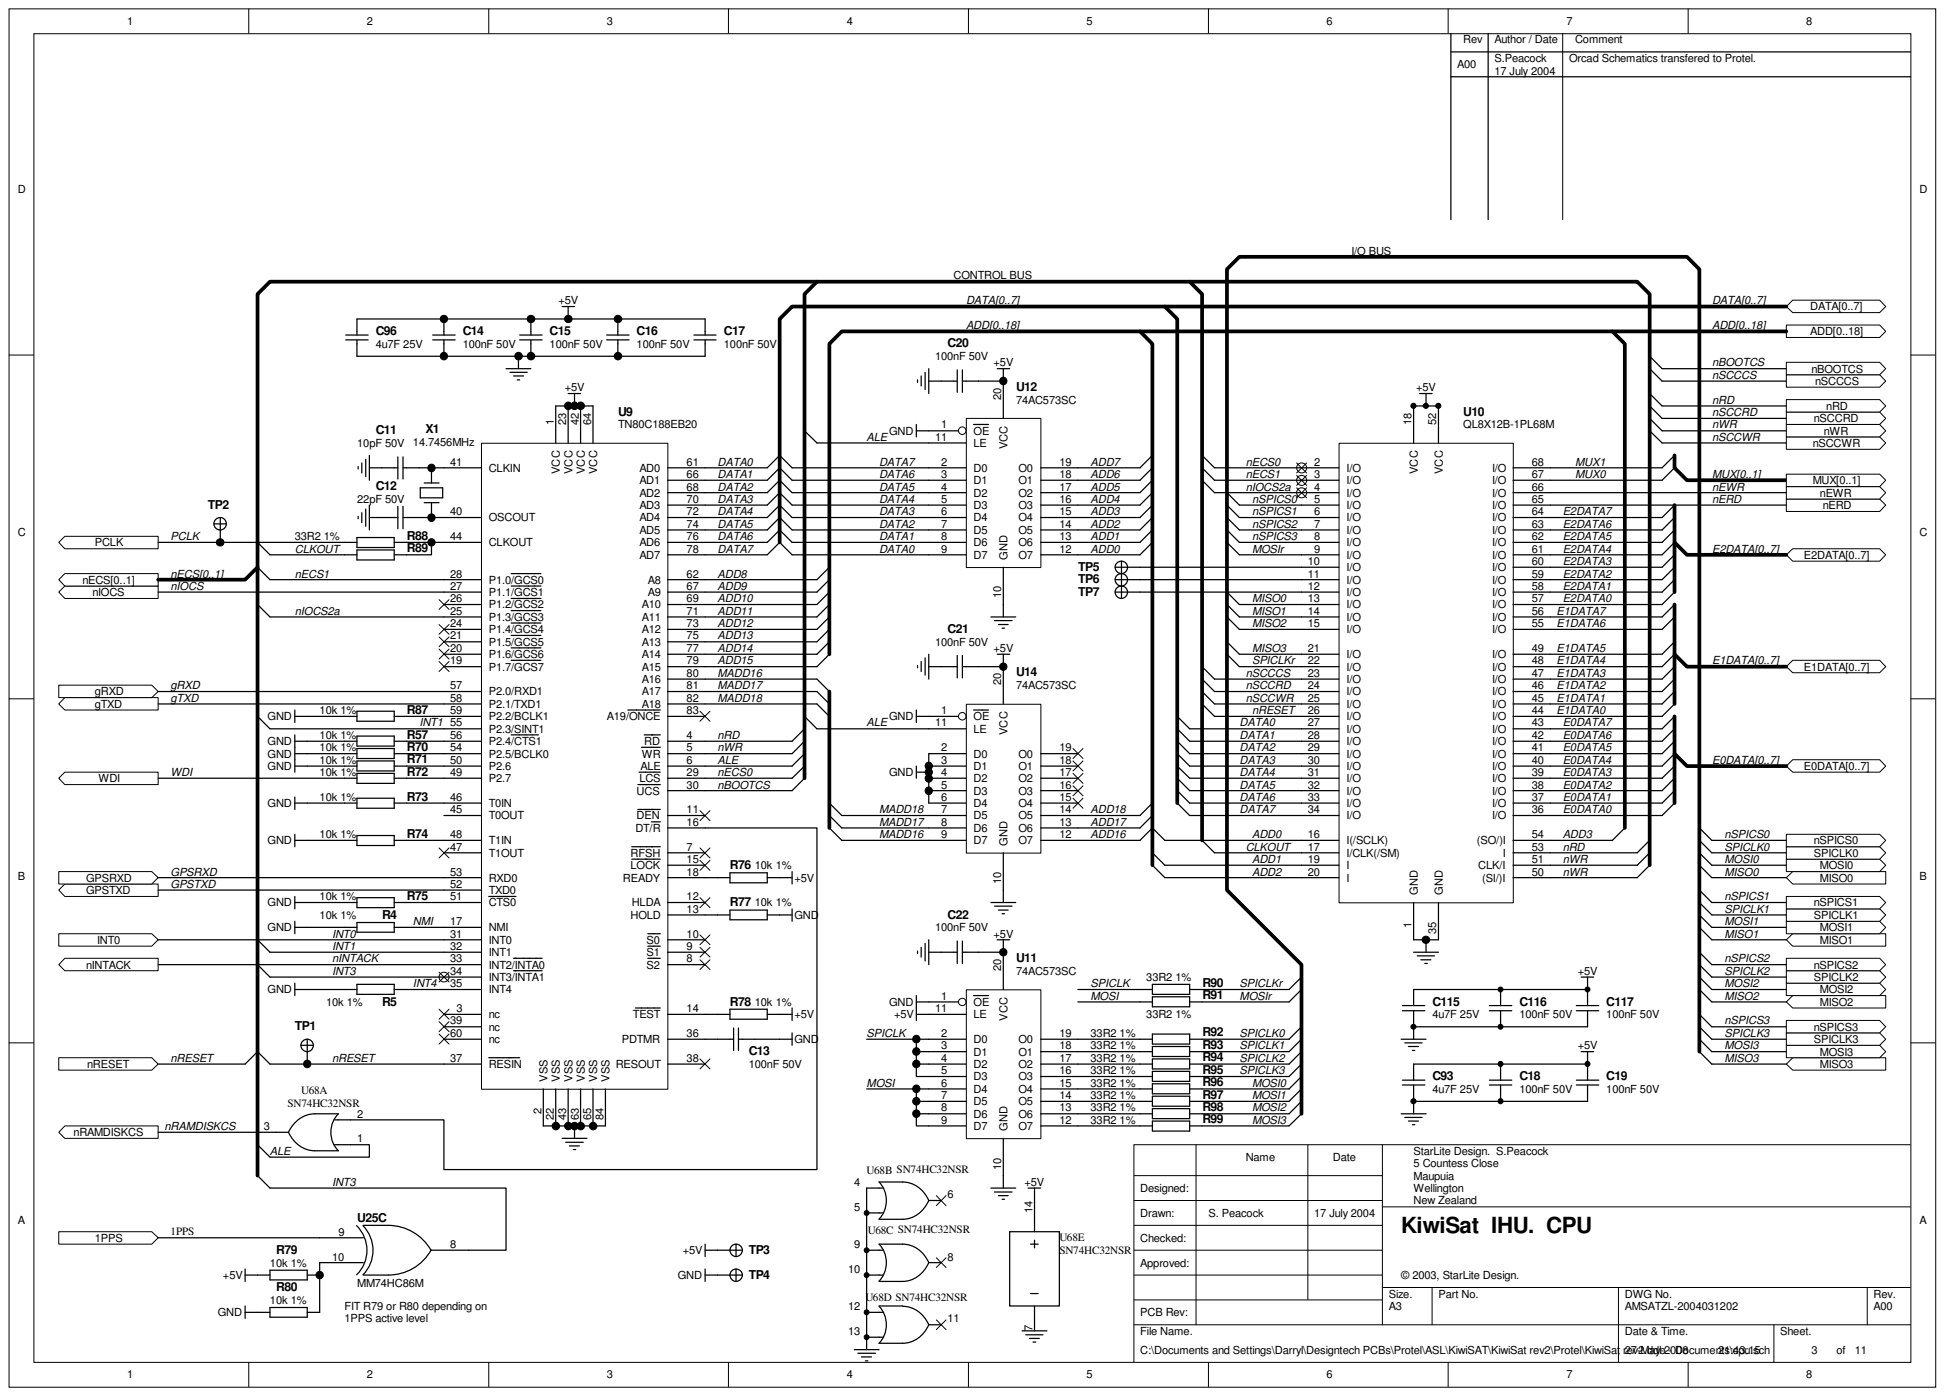
[picture p150: page 3]

FIT R79 or R80 depending on
1PPS active level

C:\Documents and Settings\Darryl\Designtech PCBs\Protel\ASL\KiwiSAT\KiwiSat rev2\Protel\KiwiSat rev2.ddb - Documents\cpu.sch

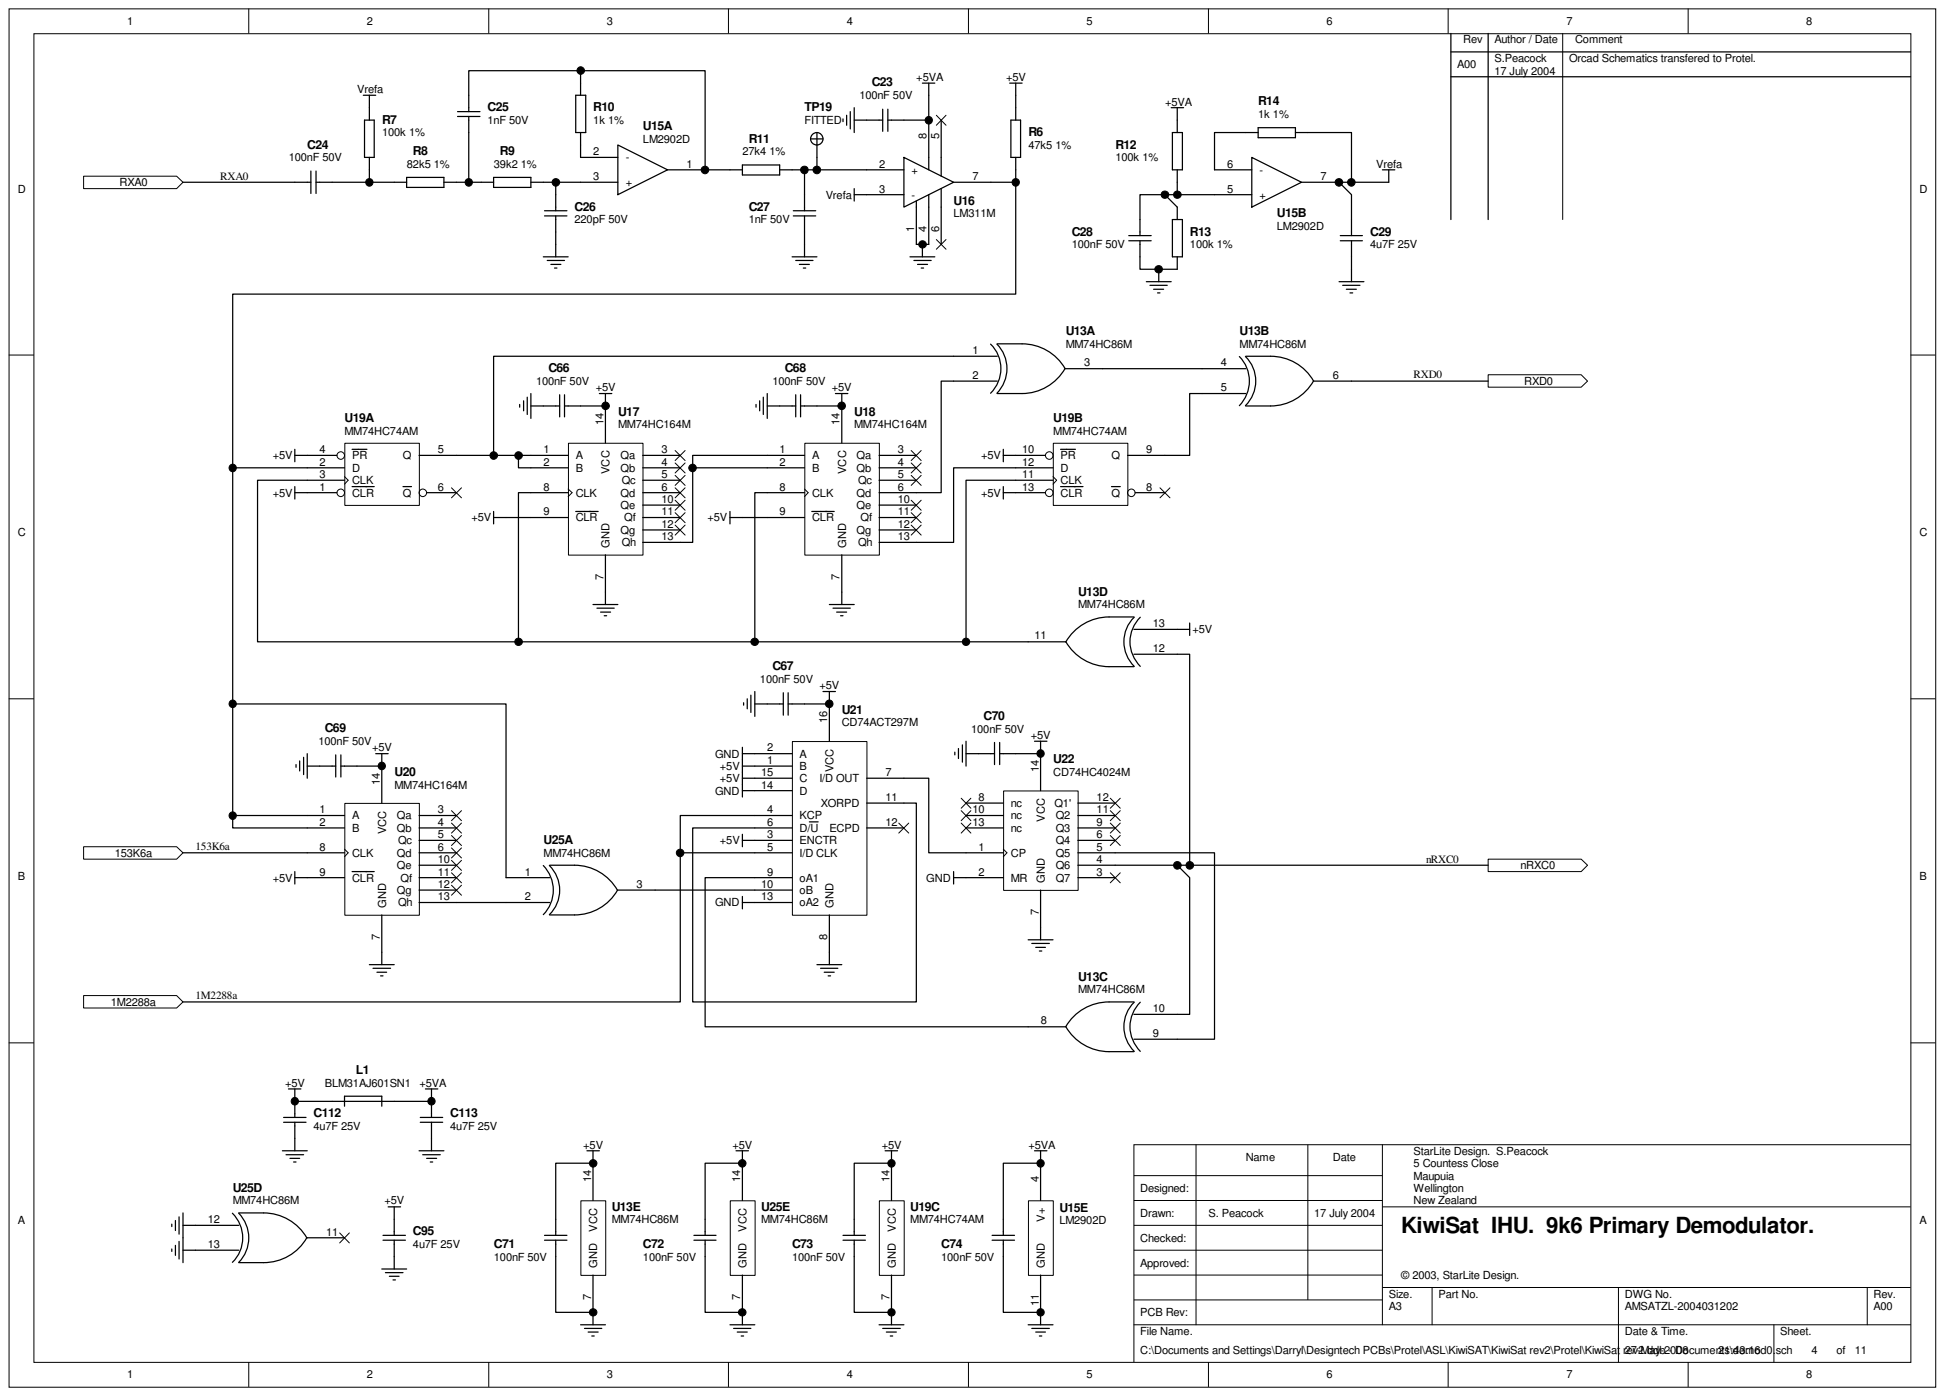
[picture p151: page 4]

StarLite Design. S.Peacock
5 Countess Close
Maupuia
Wellington
New Zealand
KiwiSat IHU. 9k6 Primary Demodulator.

C:\Documents and Settings\Darryl\Designtech PCBs\Protel\ASL\KiwiSAT\KiwiSat rev2\Protel\KiwiSat rev2.ddb - Documents\demod0.sch

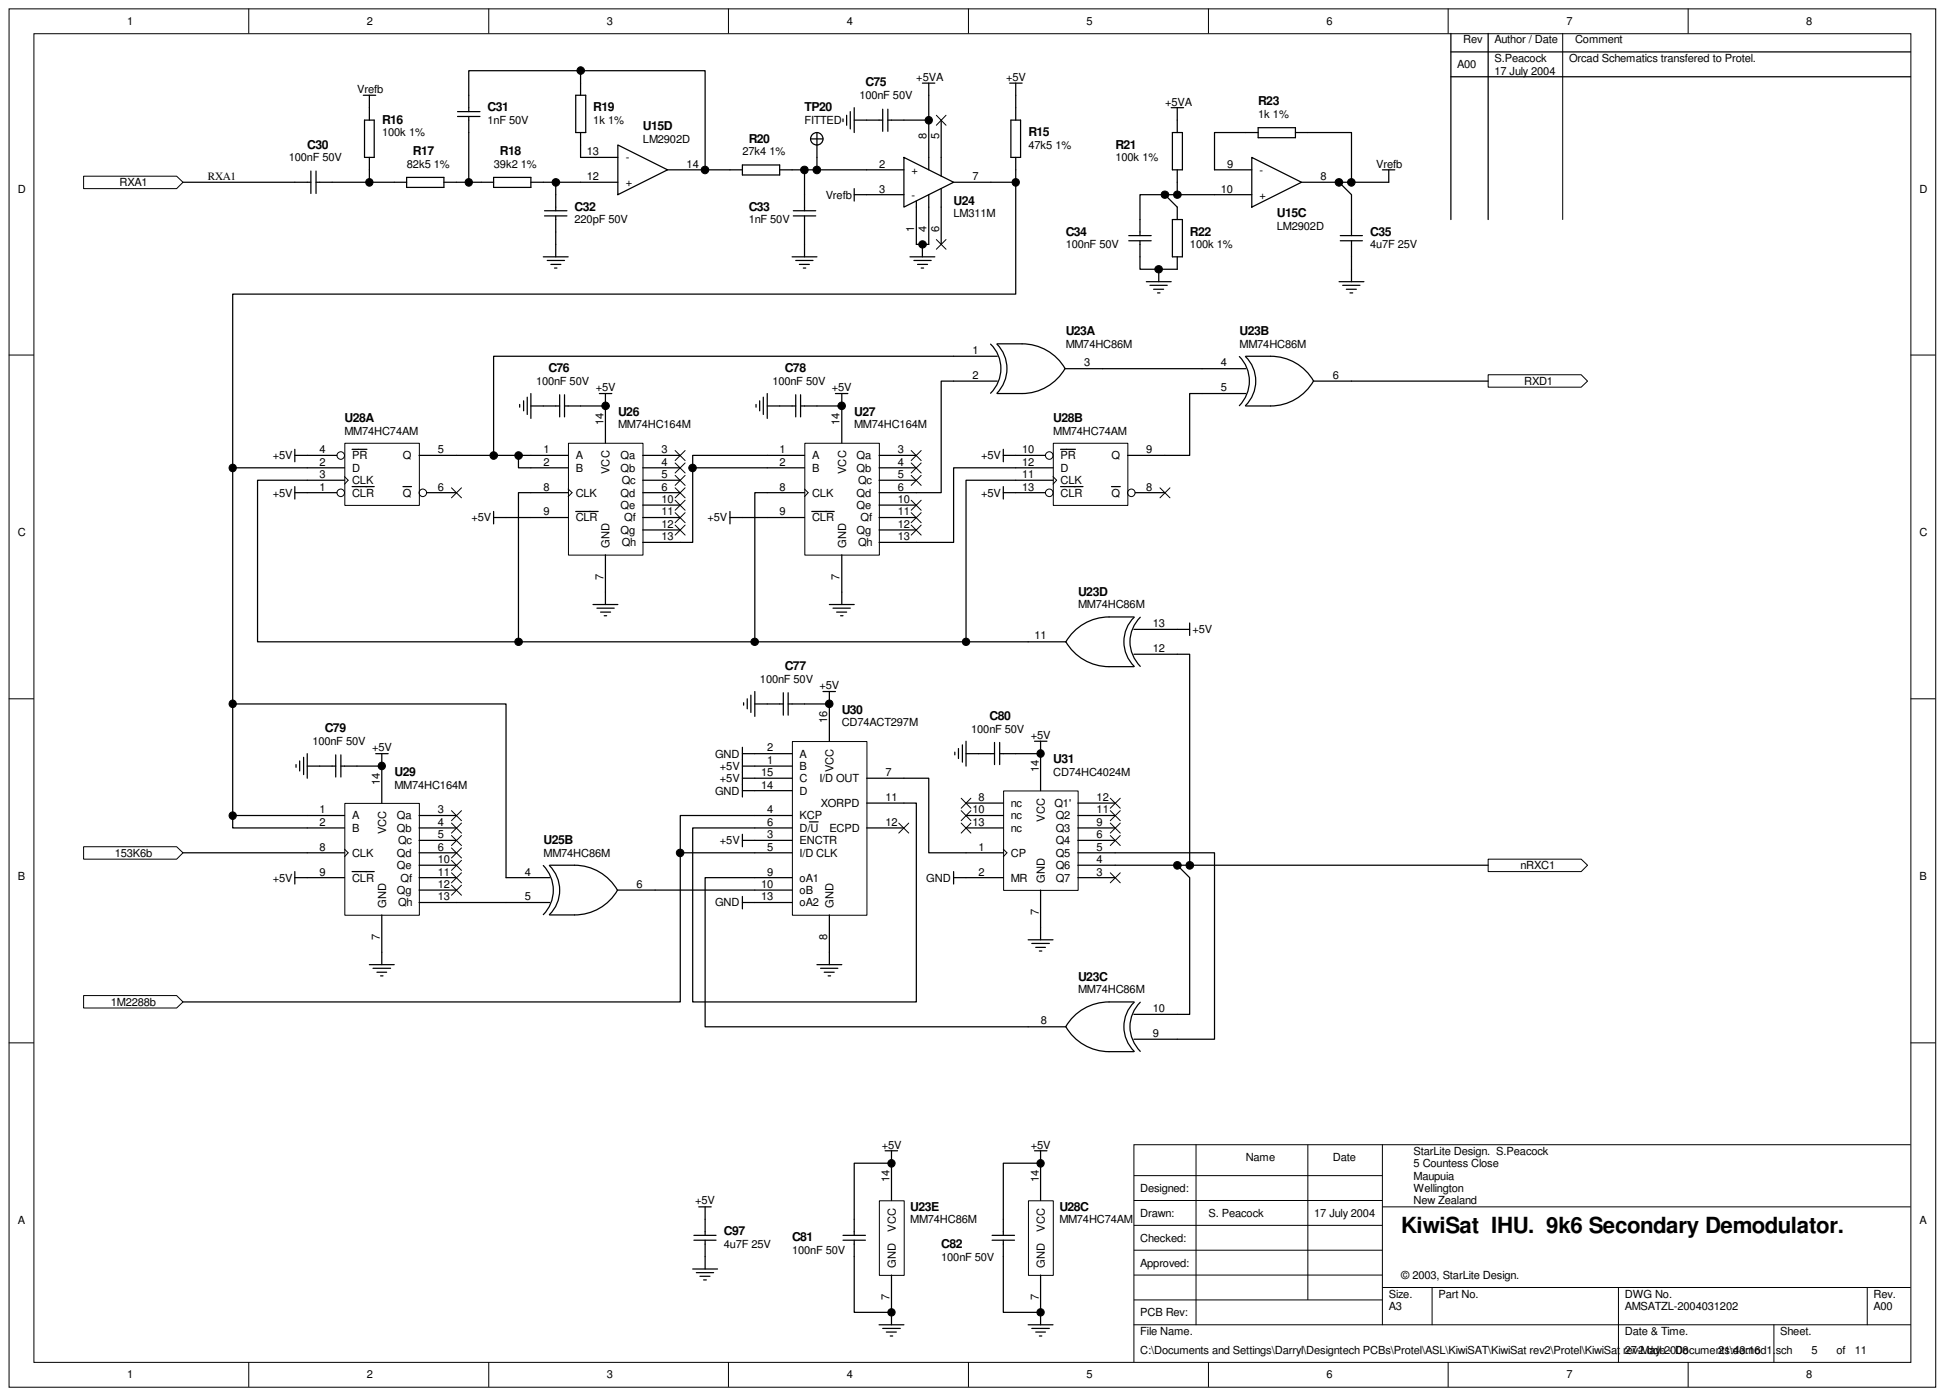
[picture p152: page 5]

StarLite Design. S.Peacock
5 Countess Close
Maupuia
Wellington
New Zealand
KiwiSat IHU. 9k6 Secondary Demodulator.

C:\Documents and Settings\Darryl\Designtech PCBs\Protel\ASL\KiwiSAT\KiwiSat rev2\Protel\KiwiSat rev2.ddb - Documents\demod1.sch

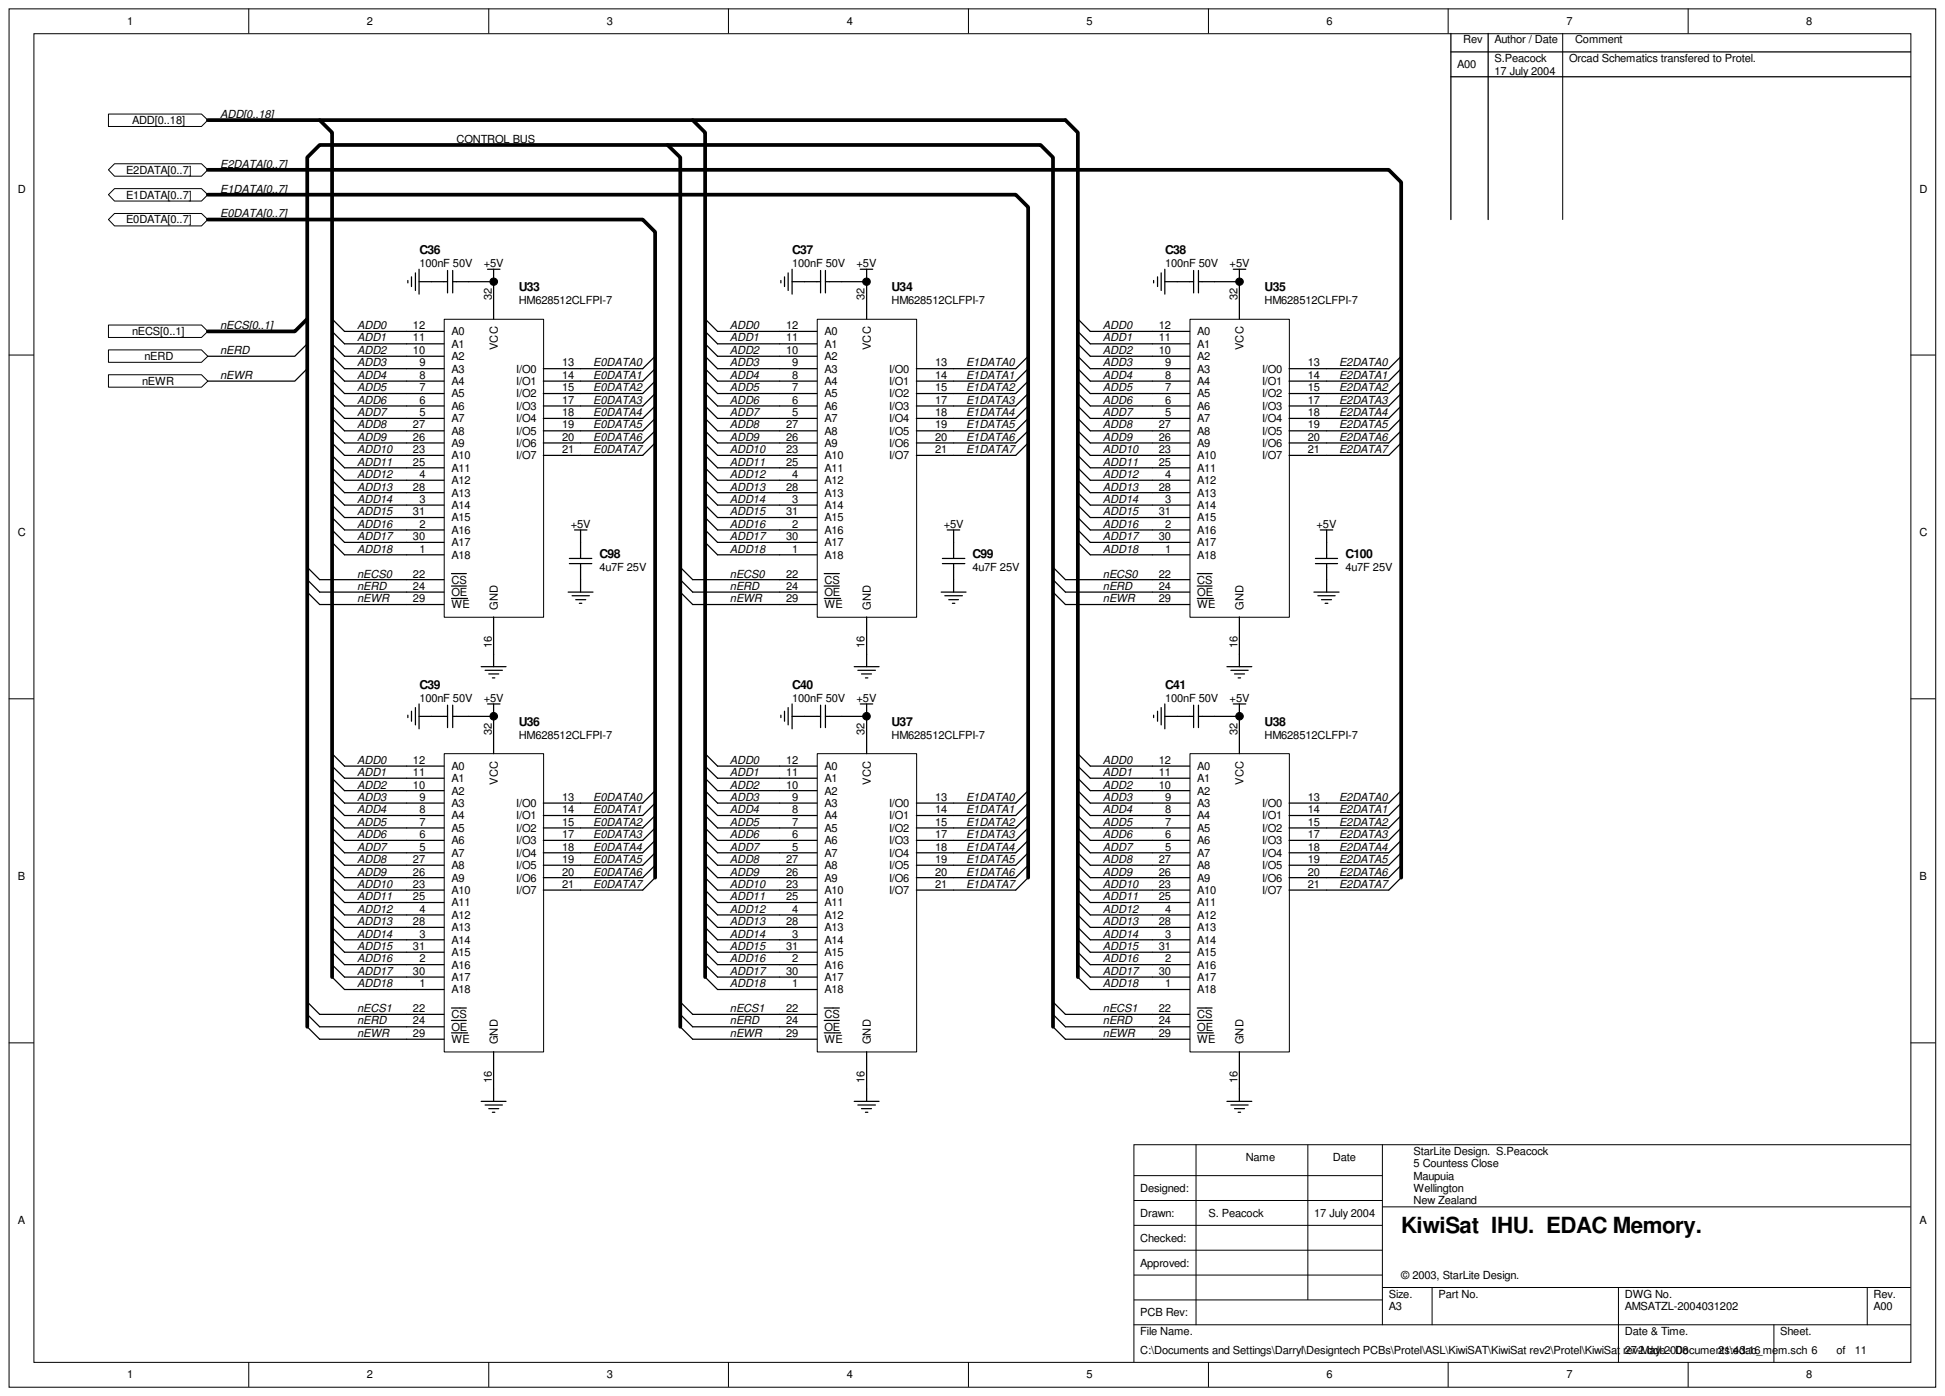
[picture p153: page 6]

StarLite Design. S.Peacock
5 Countess Close
Maupuia
Wellington
New Zealand
KiwiSat IHU. EDAC Memory.

C:\Documents and Settings\Darryl\Designtech PCBs\Protel\ASL\KiwiSAT\KiwiSat rev2\Protel\KiwiSat rev2.ddb - Documents\edac_mem.sch

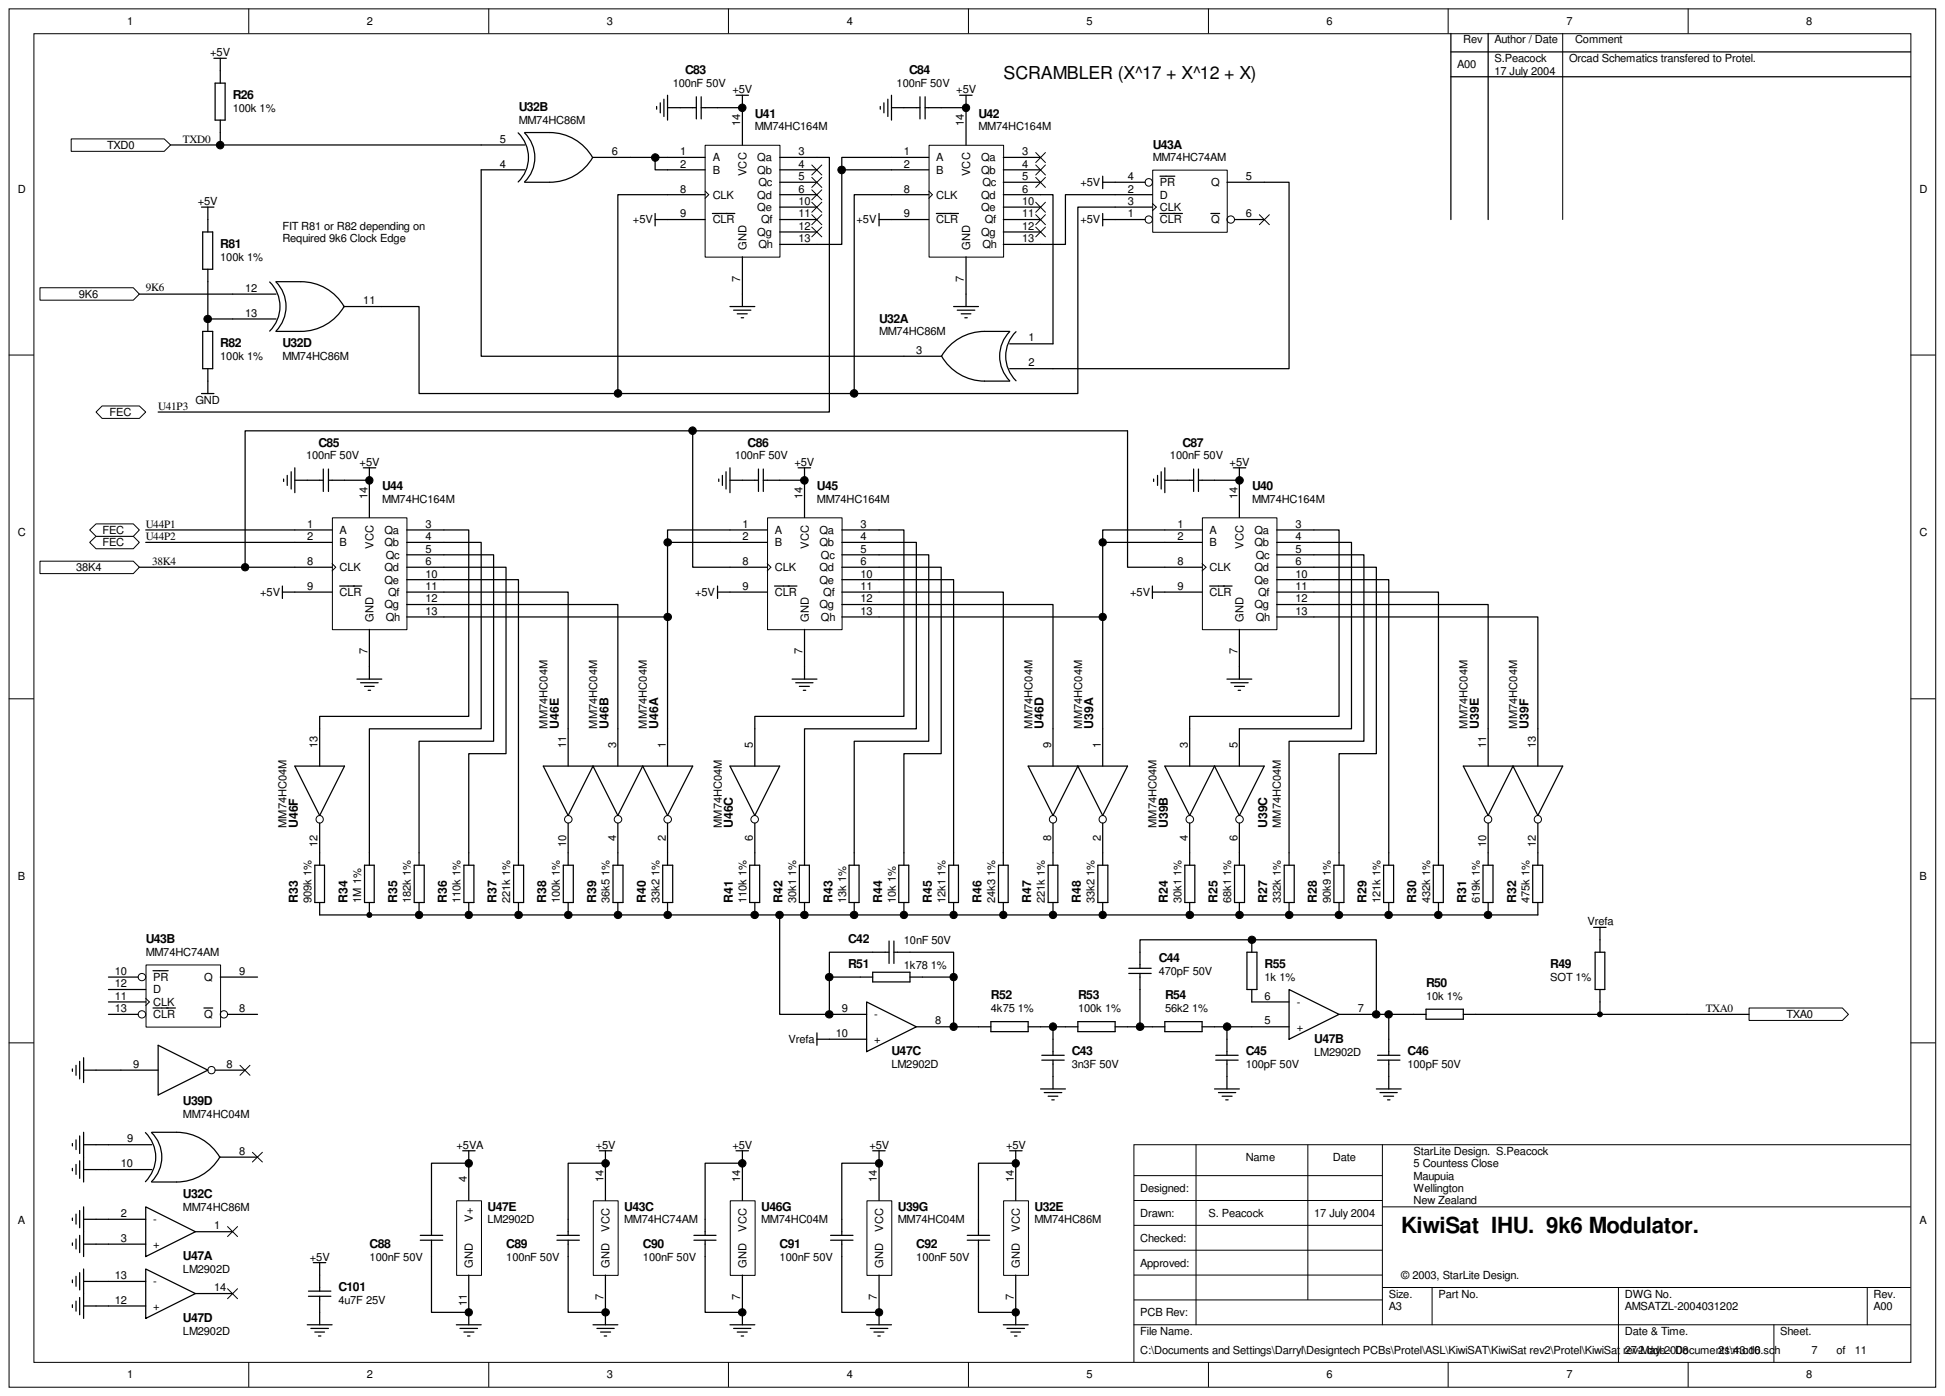
[picture p154: page 7]

FIT R81 or R82 depending on
Required 9k6 Clock Edge

C:\Documents and Settings\Darryl\Designtech PCBs\Protel\ASL\KiwiSAT\KiwiSat rev2\Protel\KiwiSat rev2.ddb - Documents\mod0.sch

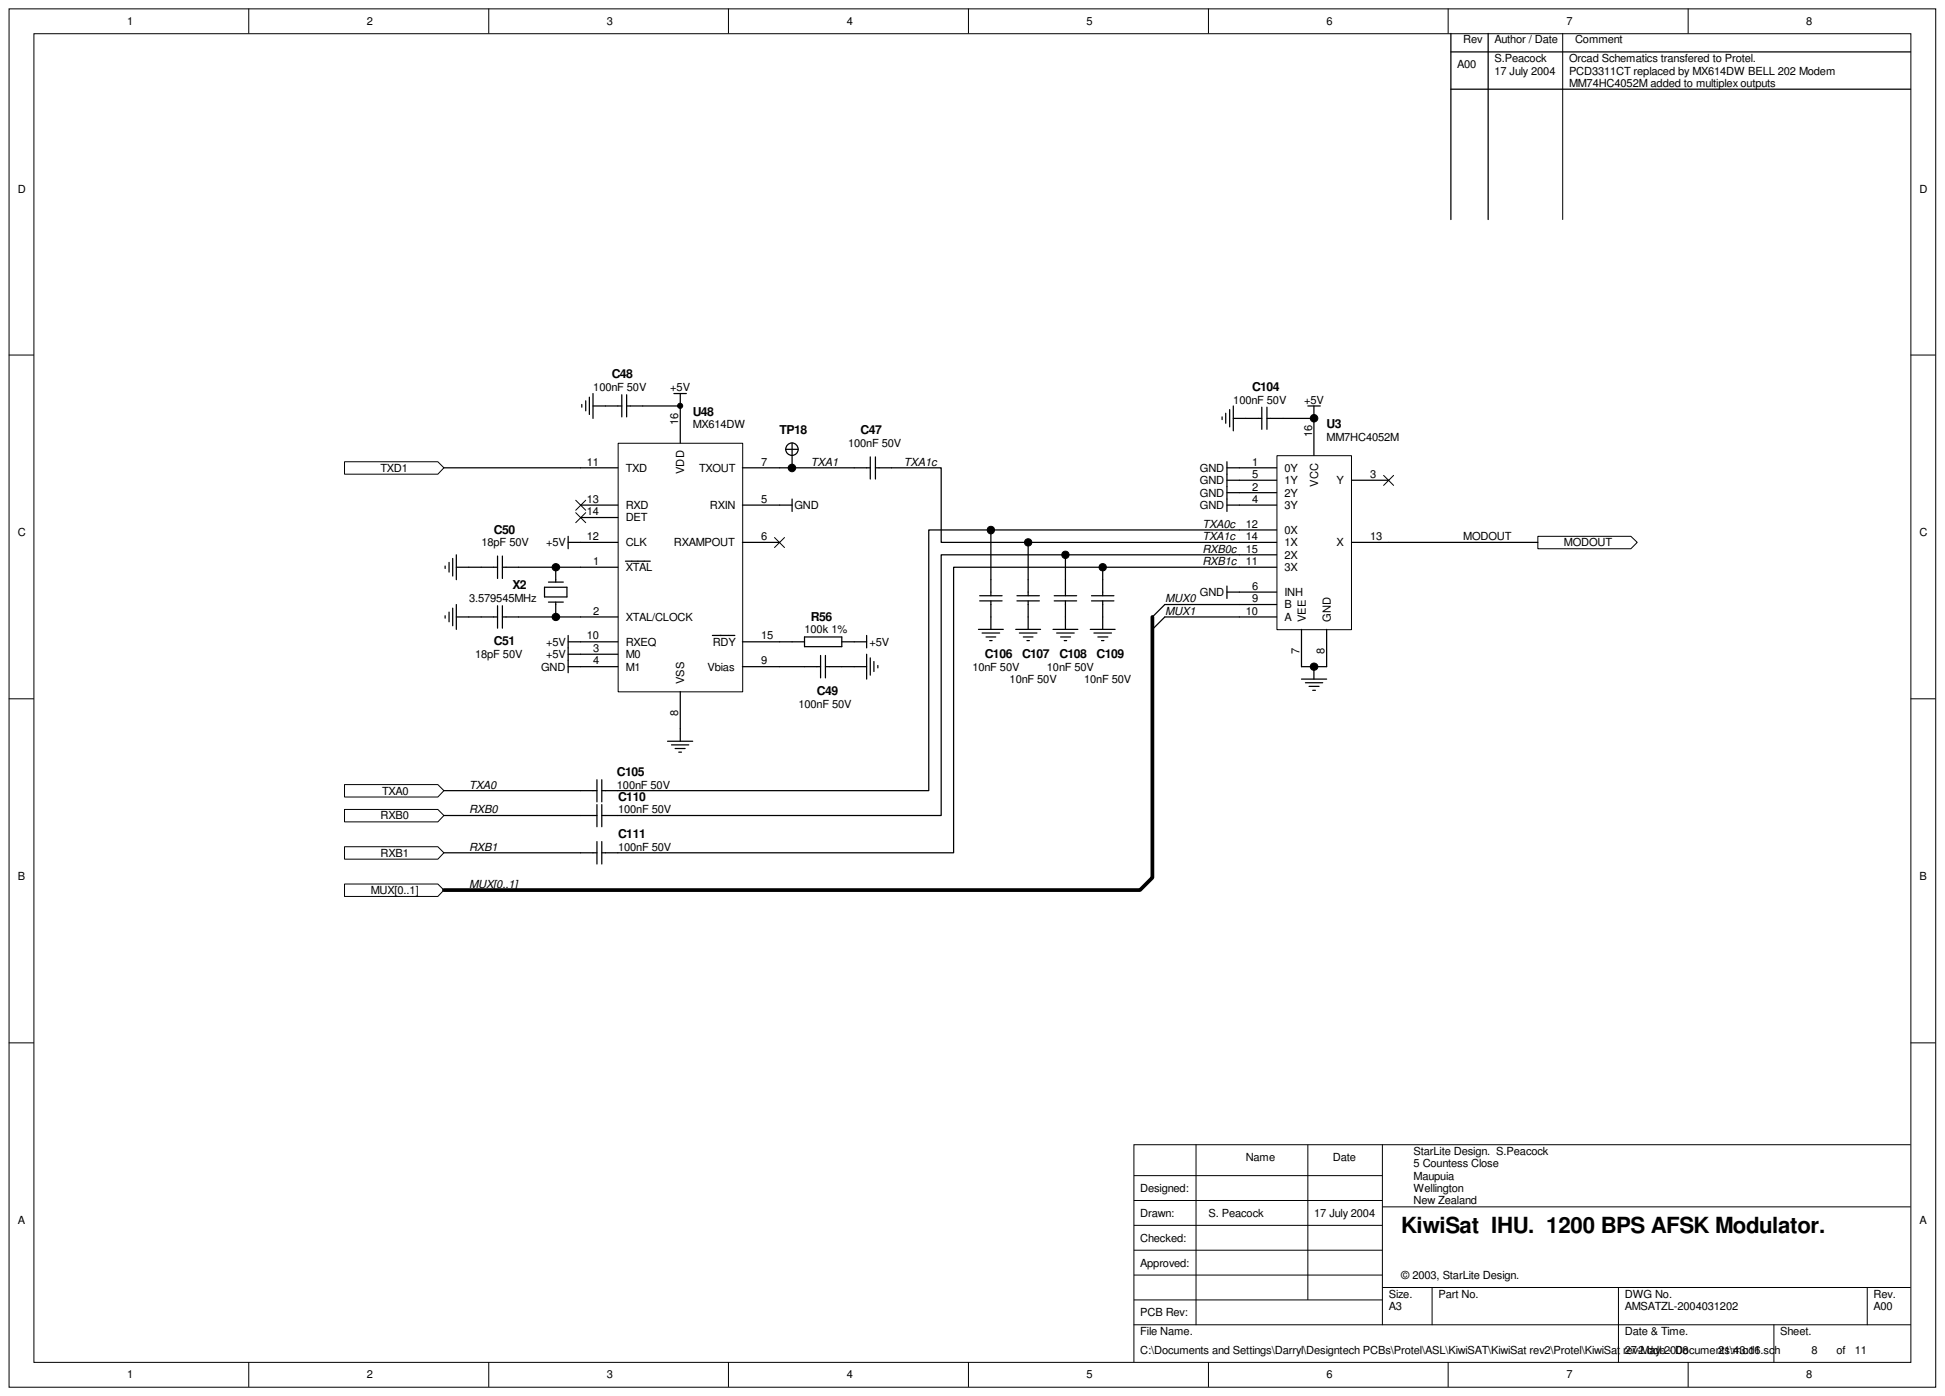
[picture p155: page 8]

MM74HC4052M added to multiplex outputs

StarLite Design. S.Peacock
5 Countess Close
Maupuia
Wellington
New Zealand
KiwiSat IHU. 1200 BPS AFSK Modulator.

C:\Documents and Settings\Darryl\Designtech PCBs\Protel\ASL\KiwiSAT\KiwiSat rev2\Protel\KiwiSat rev2.ddb - Documents\mod1.sch

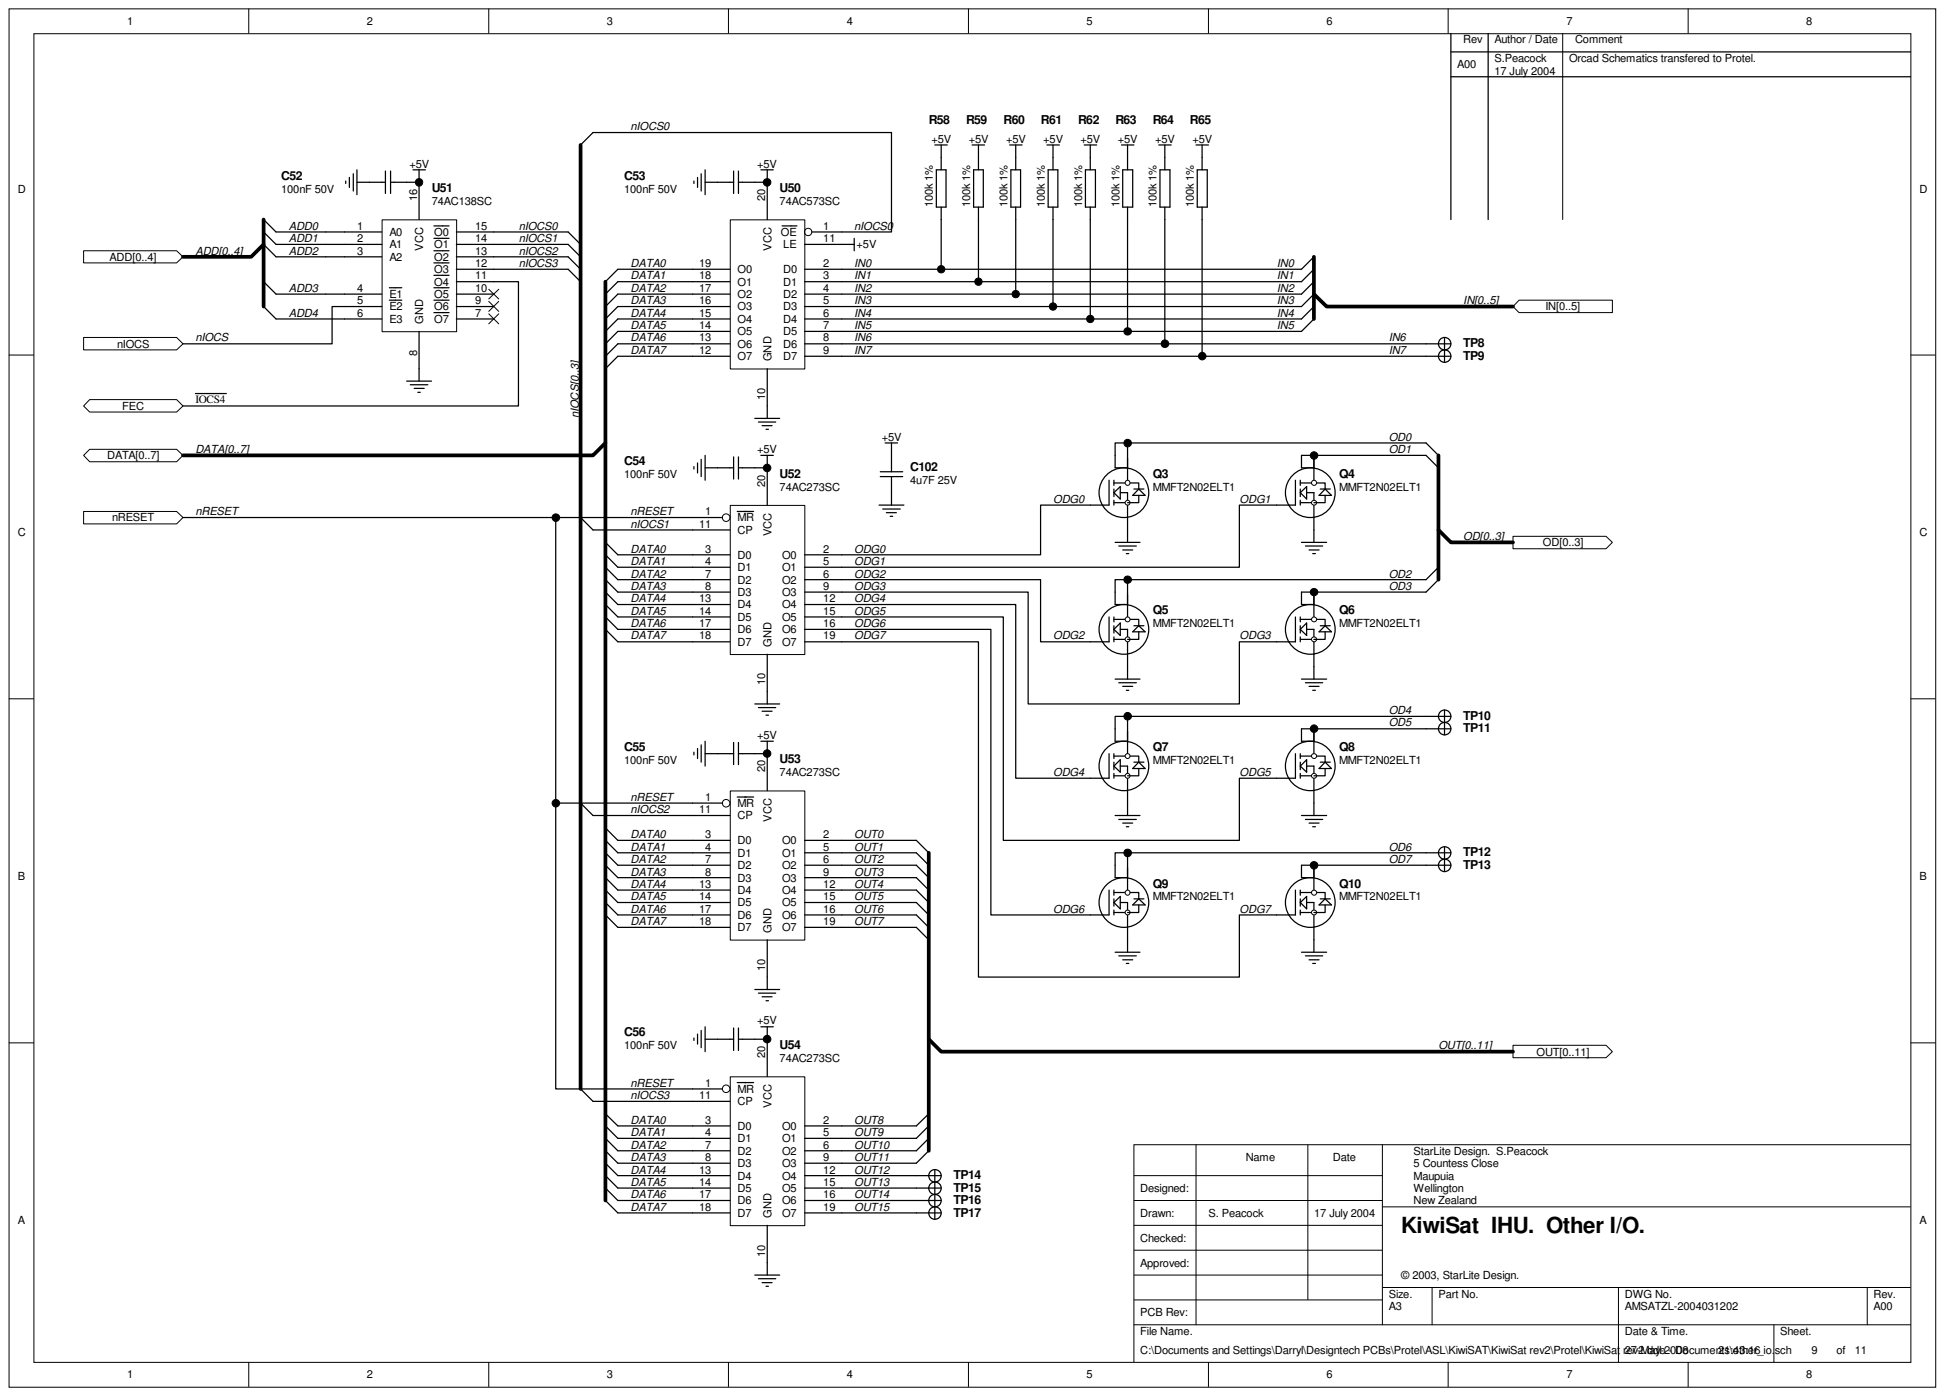
[picture p156: page 9]

C:\Documents and Settings\Darryl\Designtech PCBs\Protel\ASL\KiwiSAT\KiwiSat rev2\Protel\KiwiSat rev2.ddb - Documents\other_io.sch

# DIVIDE BY 3

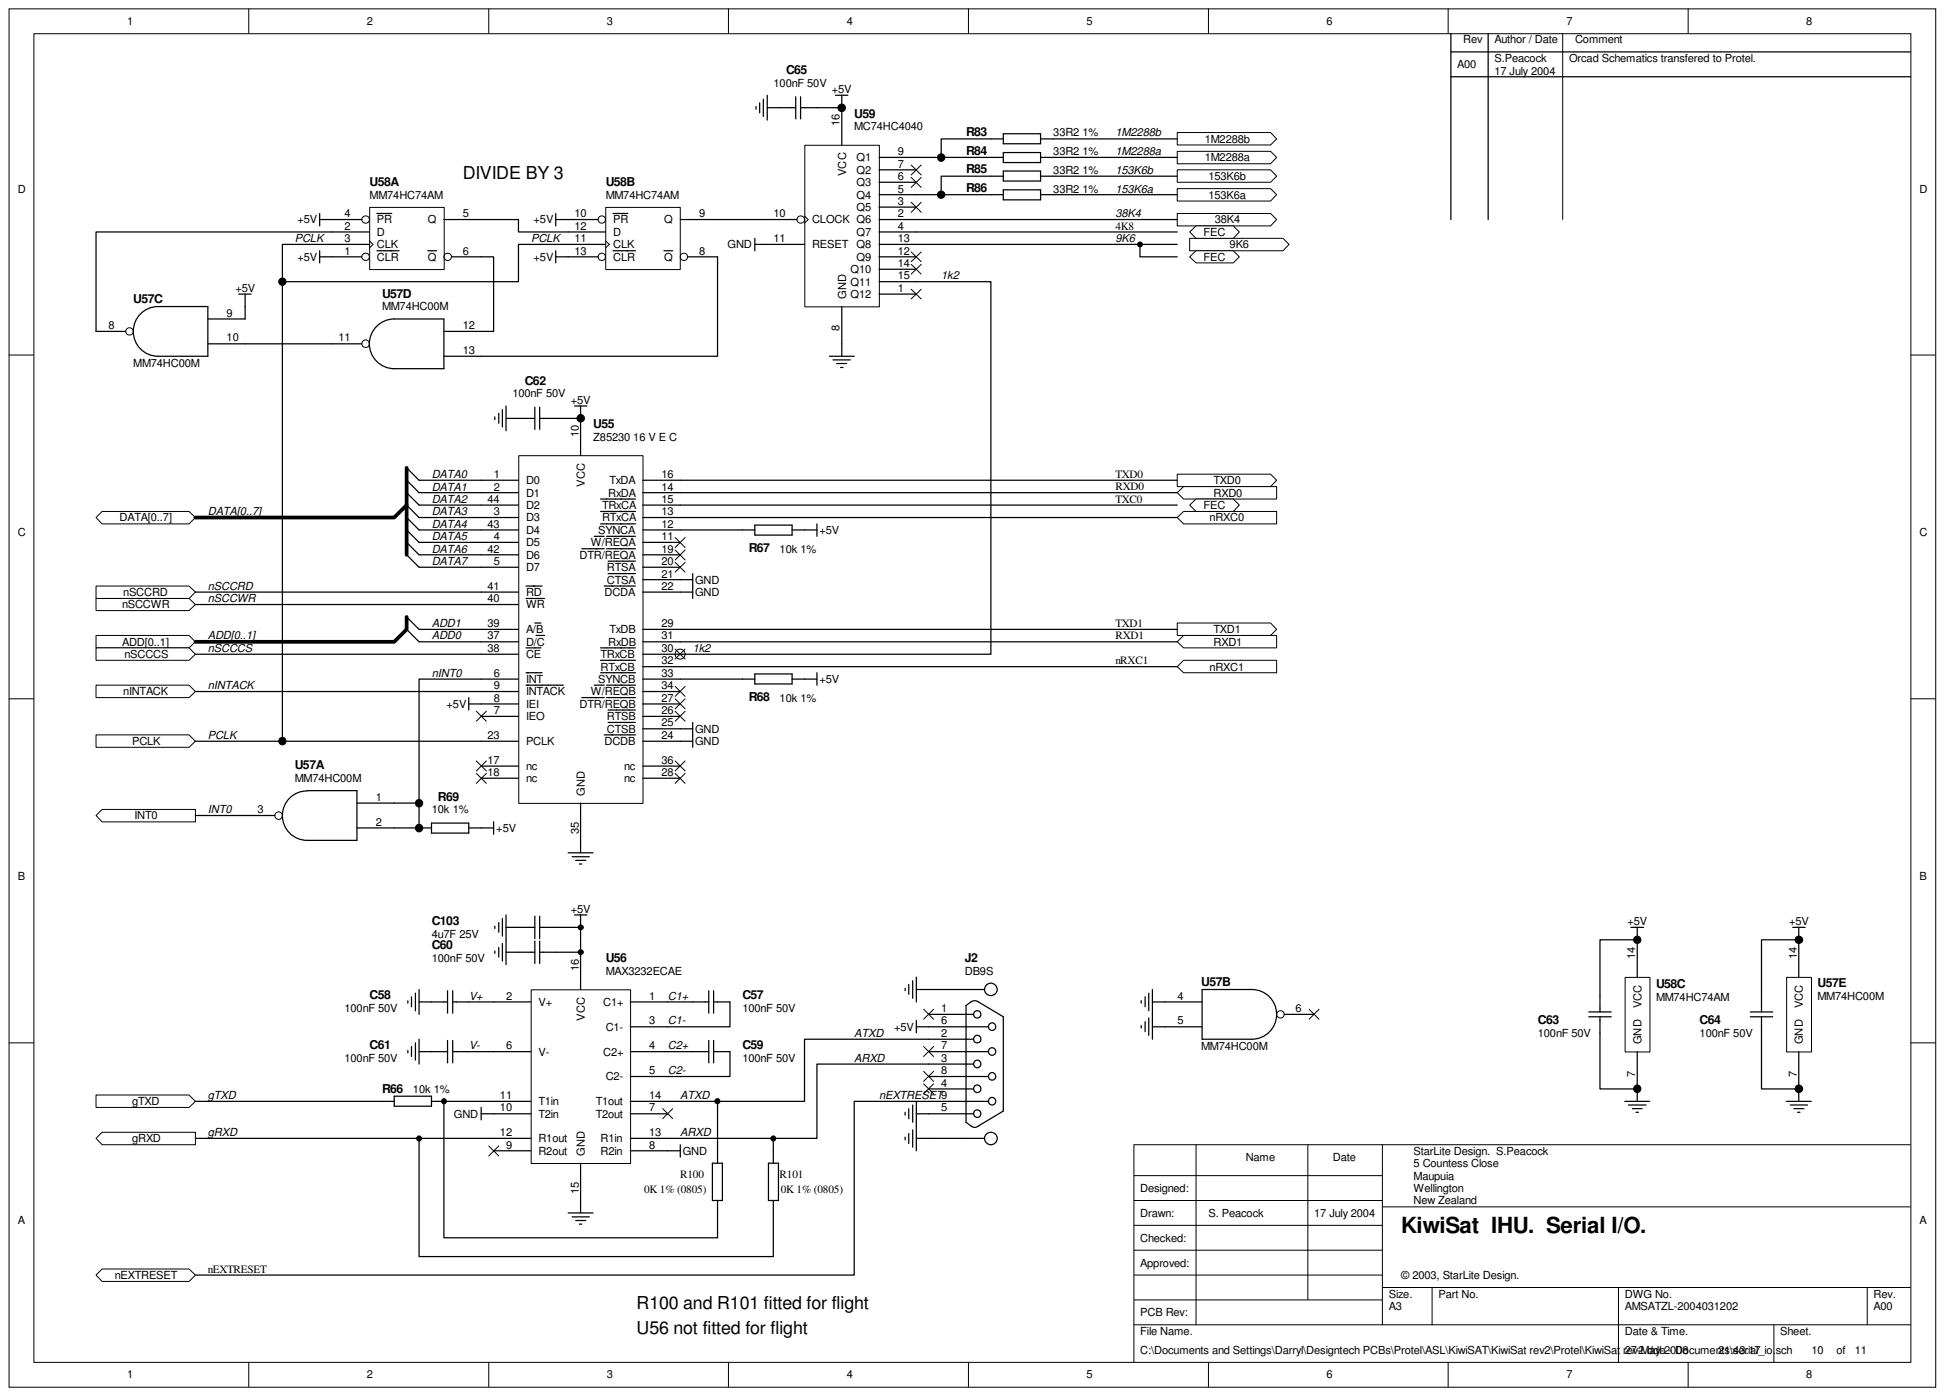
[picture p157: page 10]

R100 and R101 fitted for flight
U56 not fitted for flight

C:\Documents and Settings\Darryl\Designtech PCBs\Protel\ASL\KiwiSAT\KiwiSat rev2\Protel\KiwiSat rev2.ddb - Documents\serial_io.sch

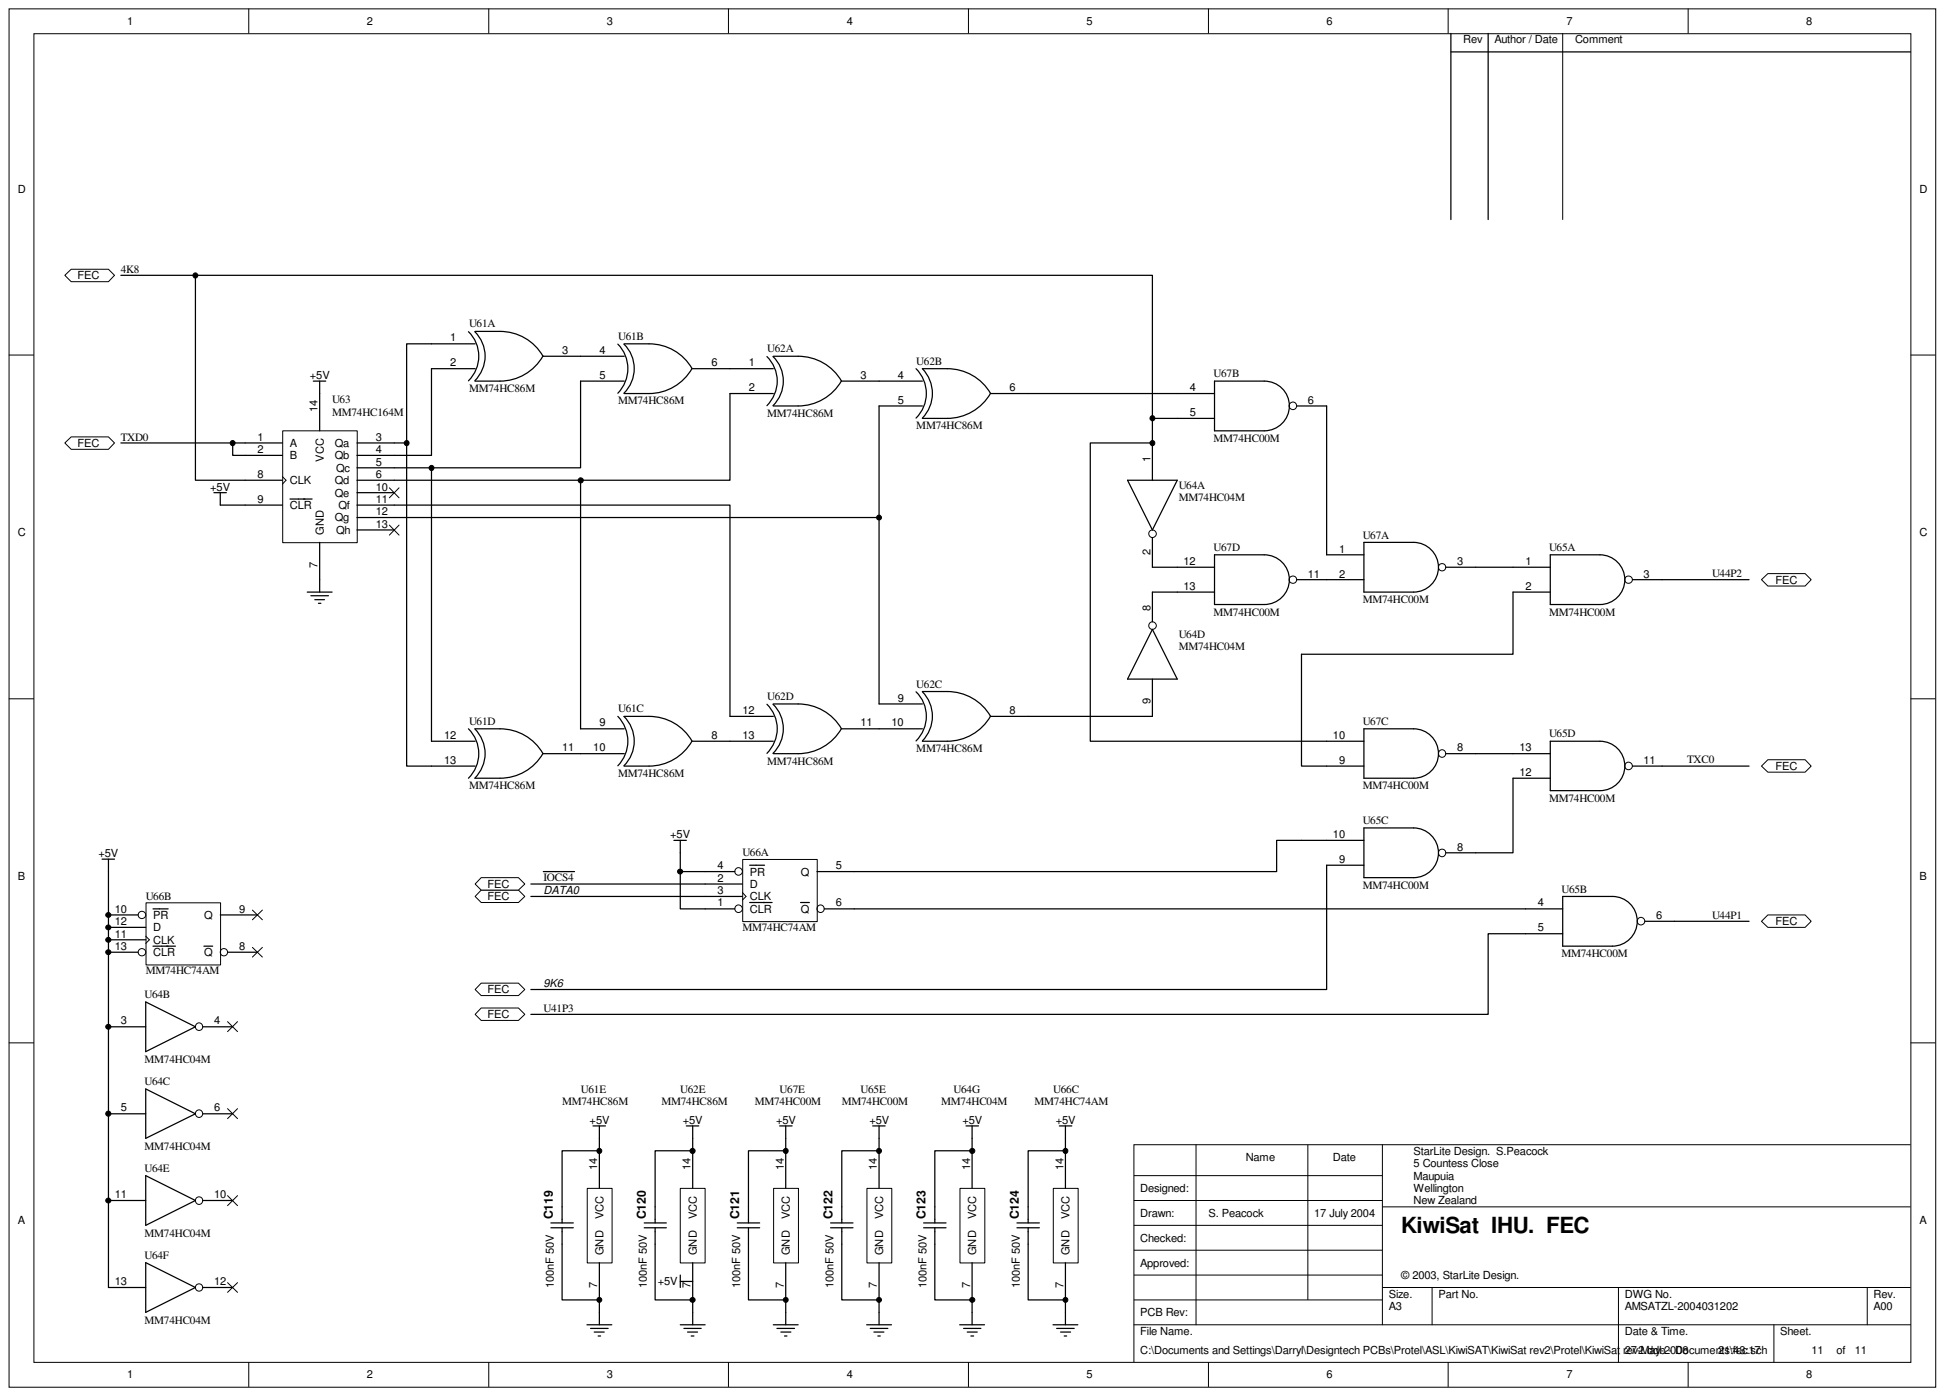
[picture p158: page 11]

C:\Documents and Settings\Darryl\Designtech PCBs\Protel\ASL\KiwiSAT\KiwiSat rev2\Protel\KiwiSat rev2.ddb - Documents\fec.sch
