AMSAT-ZL/KiwiSAT_Sub-Systems/IHU/FPGA/kiwiproj/docs/PCB-schematics/27-5-08 Schematic.pdf

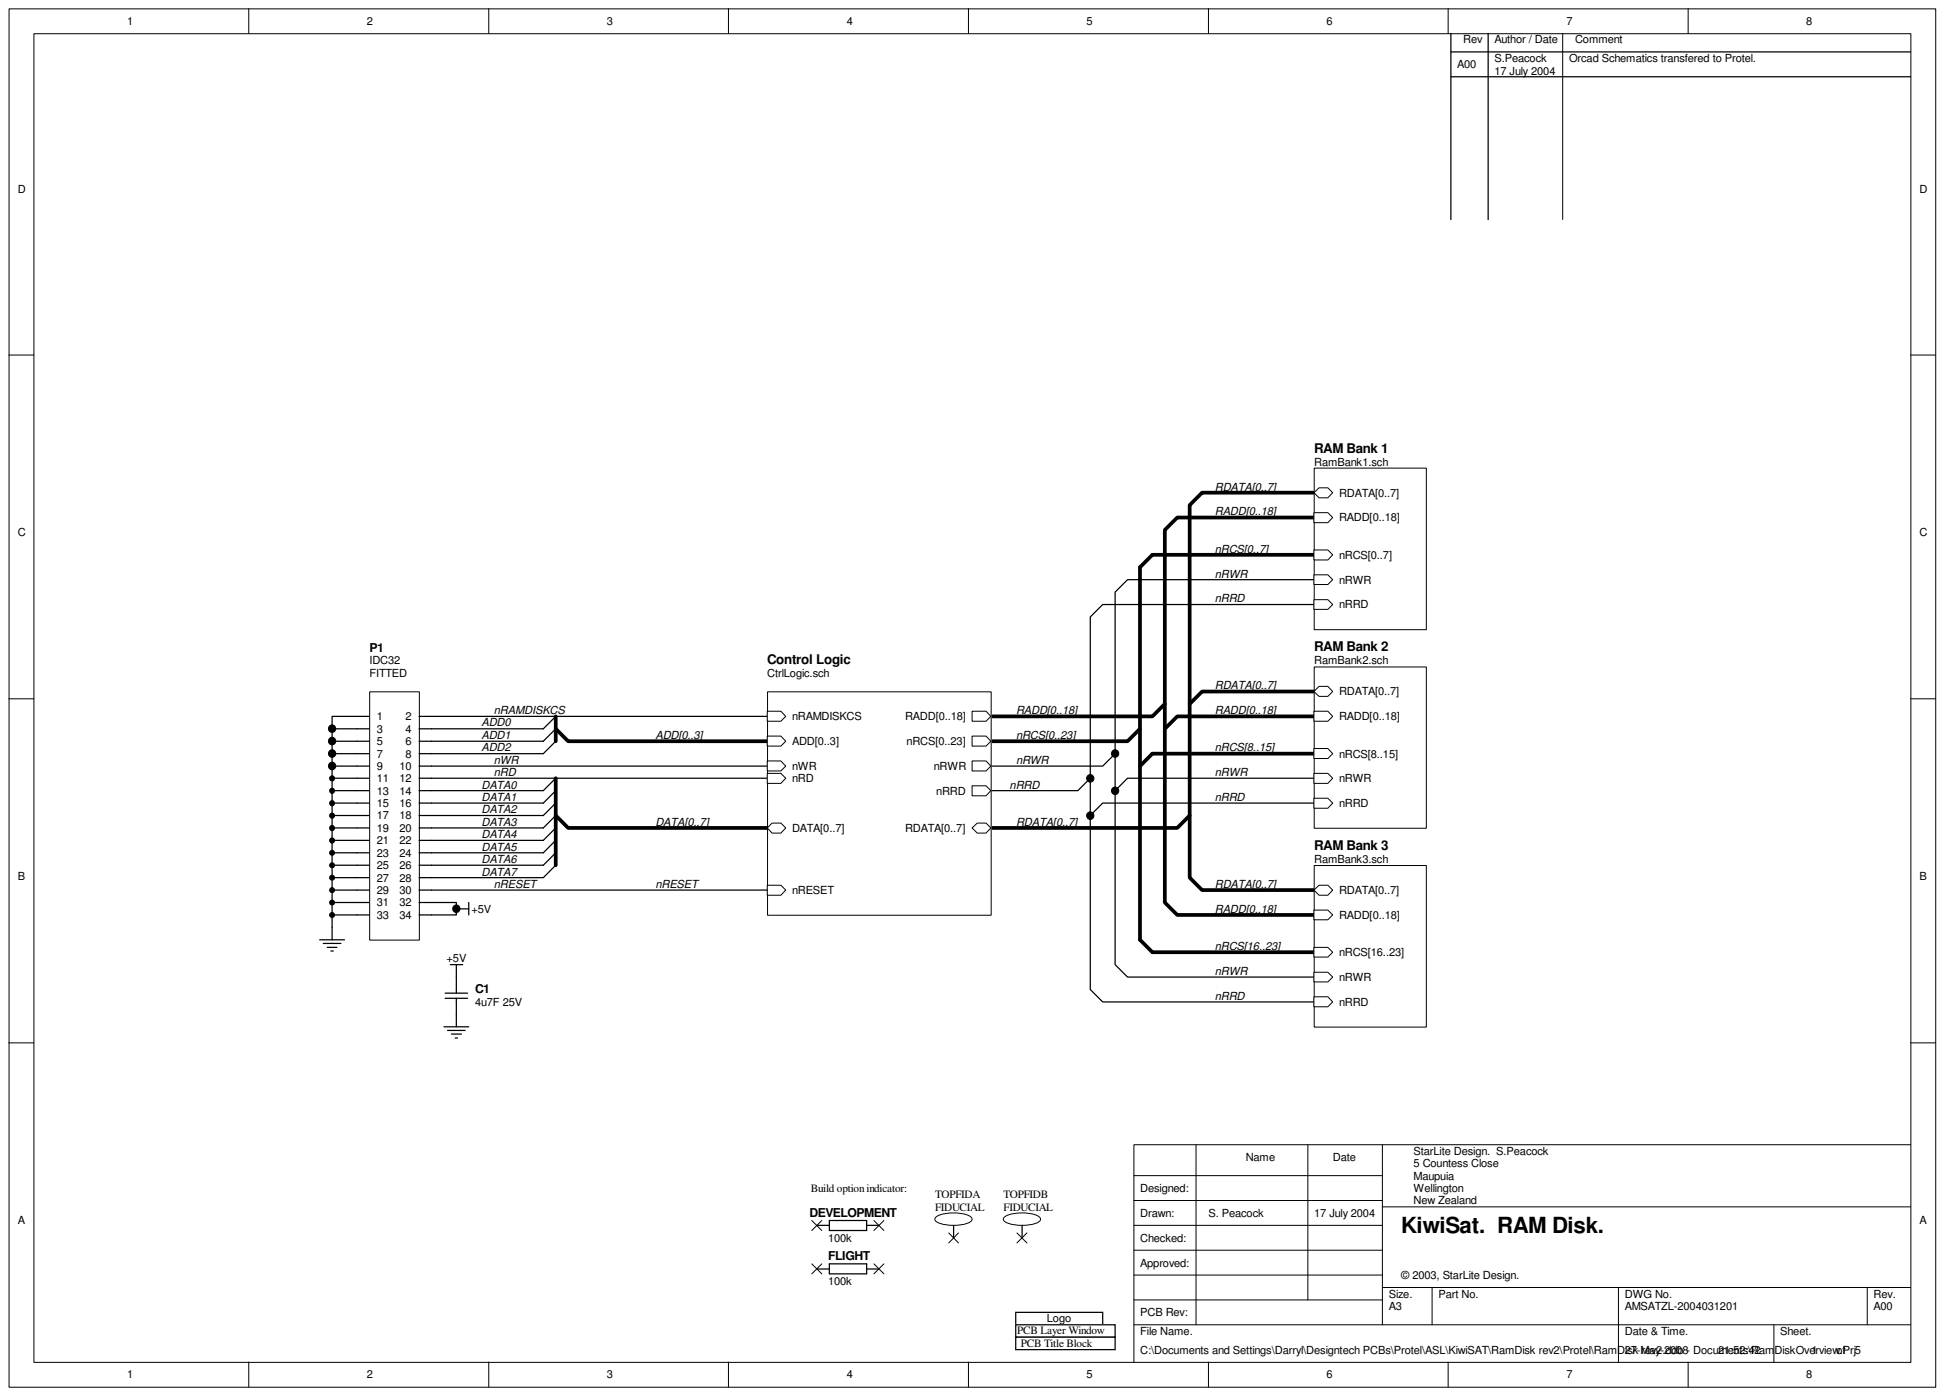
[picture p159: page 1]
Approved:; Name; Date; Designed:; Checked:; Drawn:; © 2003, StarLite Design.; Rev; Author / Date; Comment; Size.; Rev.; Sheet.; 27-May-2008; Part No.; DWG No.; AMSATZL-2004031201; File Name.; Date & Time.; nRWR; nRRD; nRCS[0..23]; RADD[0..18]; RDATA[0..7]; nRCS[0..7]; nRCS[8..15]; nRCS[16..23]; DATA[0..7]; ADD[0..3]; nRAMDISKCS ADD0 ADD1 ADD2; DATA0 DATA1 DATA2 DATA3 DATA4 DATA5 DATA6 DATA7; nRD; nWR; nRAMDISKCS; nRESET; Control Logic CtrlLogic.sch; RAM Bank 1 RamBank1.sch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

StarLite Design. S.Peacock
5 Countess Close
Maupuia
Wellington
New Zealand
KiwiSat. RAM Disk.

Build option indicator:
FIDUCIAL DEVELOPMENT

Logo
PCB Layer Window
PCB Title Block

PCB Rev:
C:\Documents and Settings\Darryl\Designtech PCBs\Protel\ASL\KiwiSAT\RamDisk rev2\Protel\RamDisk rev2.ddb - Documents\RamDiskOverview.Prj

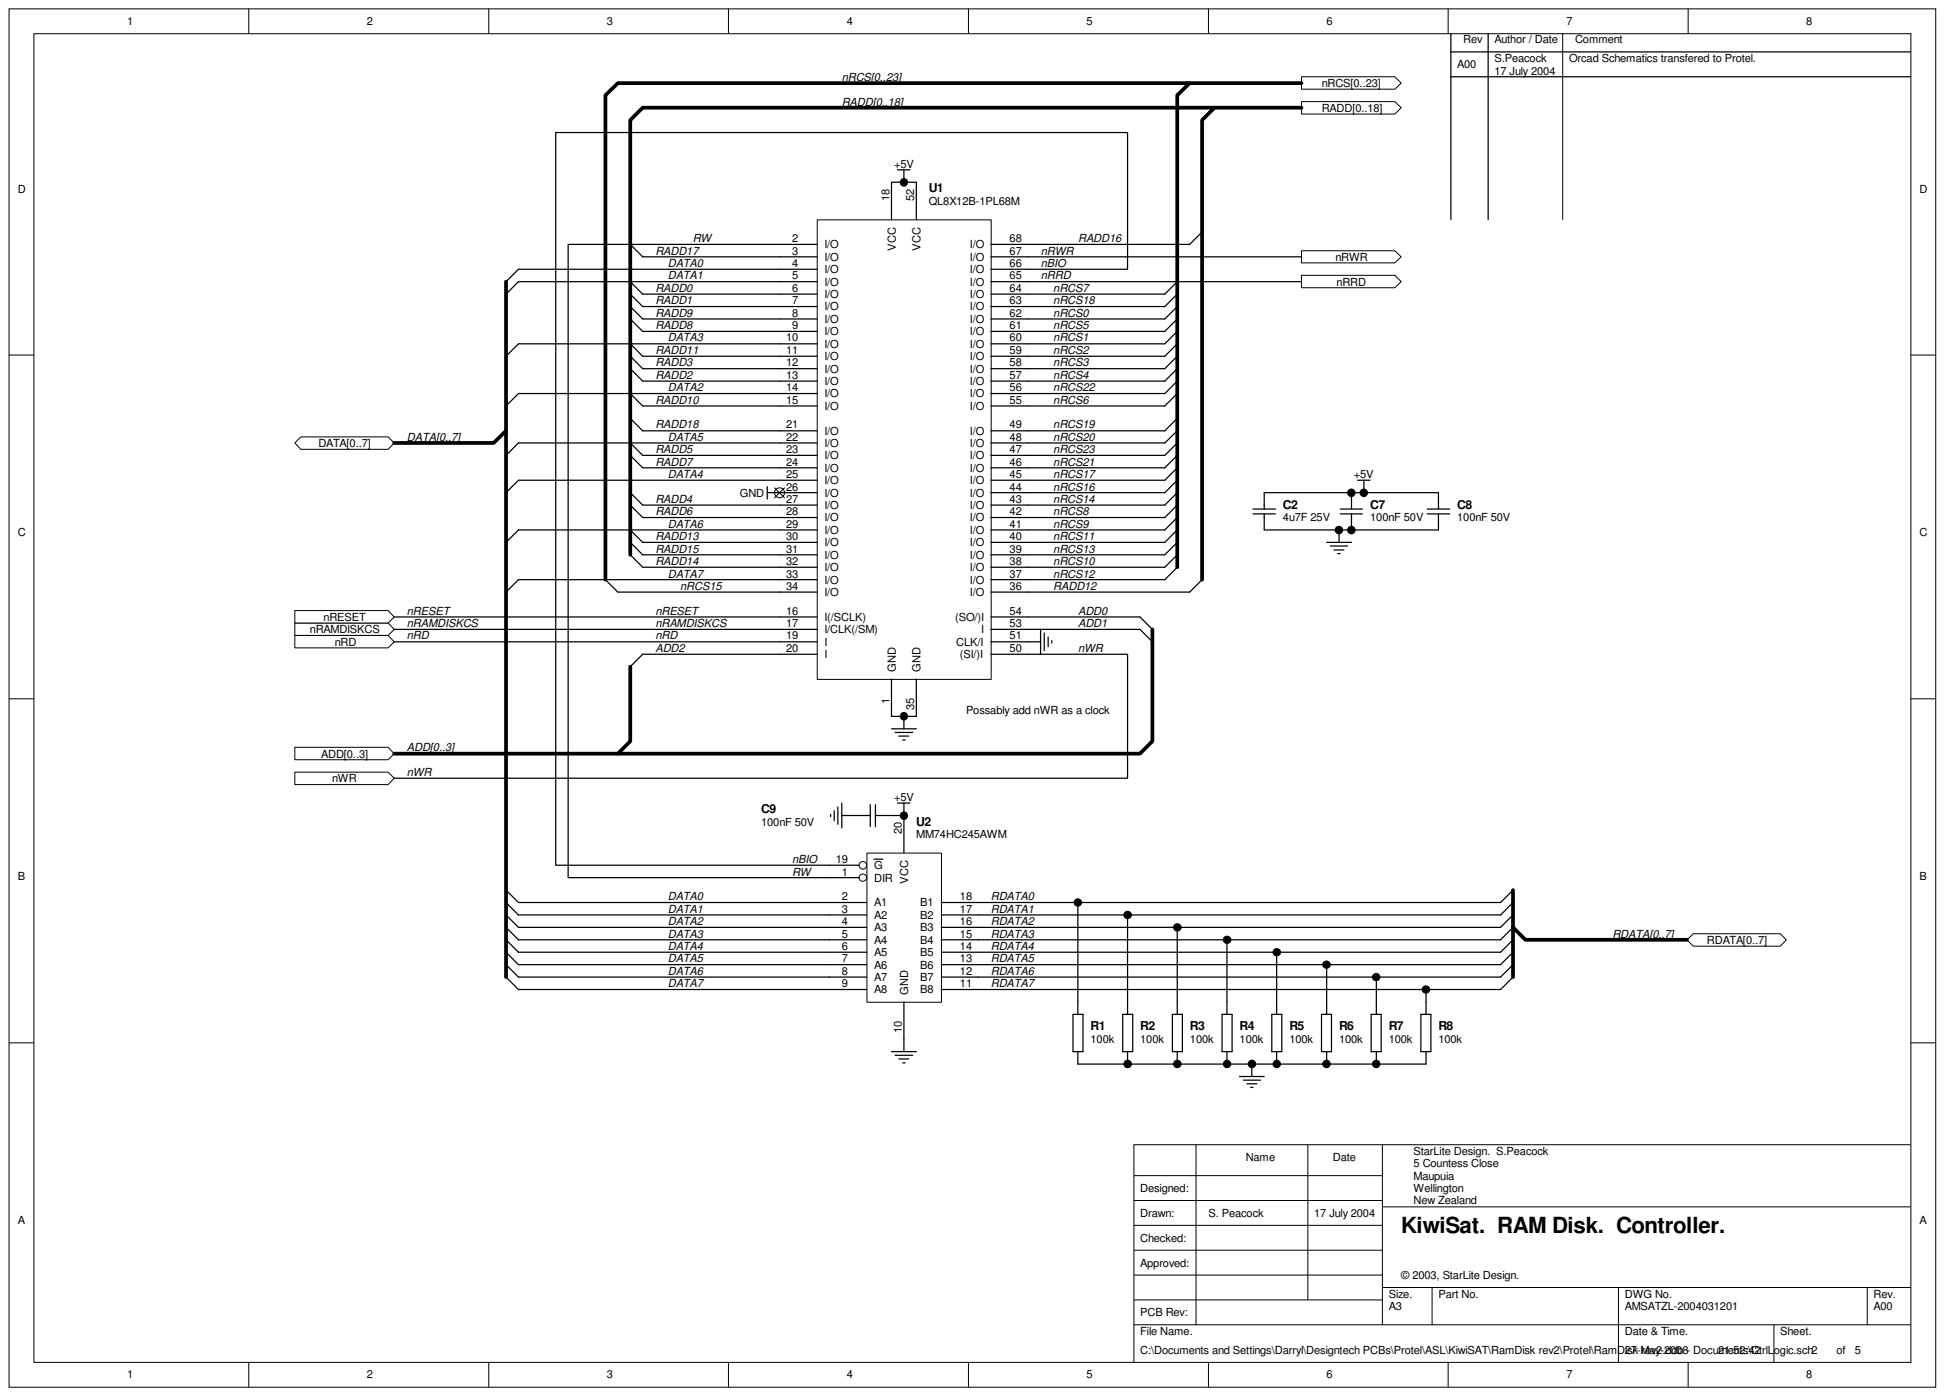
[picture p160: page 2]

Possably add nWR as a clock

StarLite Design. S.Peacock
5 Countess Close
Maupuia
Wellington
New Zealand
KiwiSat. RAM Disk. Controller.

C:\Documents and Settings\Darryl\Designtech PCBs\Protel\ASL\KiwiSAT\RamDisk rev2\Protel\RamDisk rev2.ddb - Documents\CtrlLogic.sch

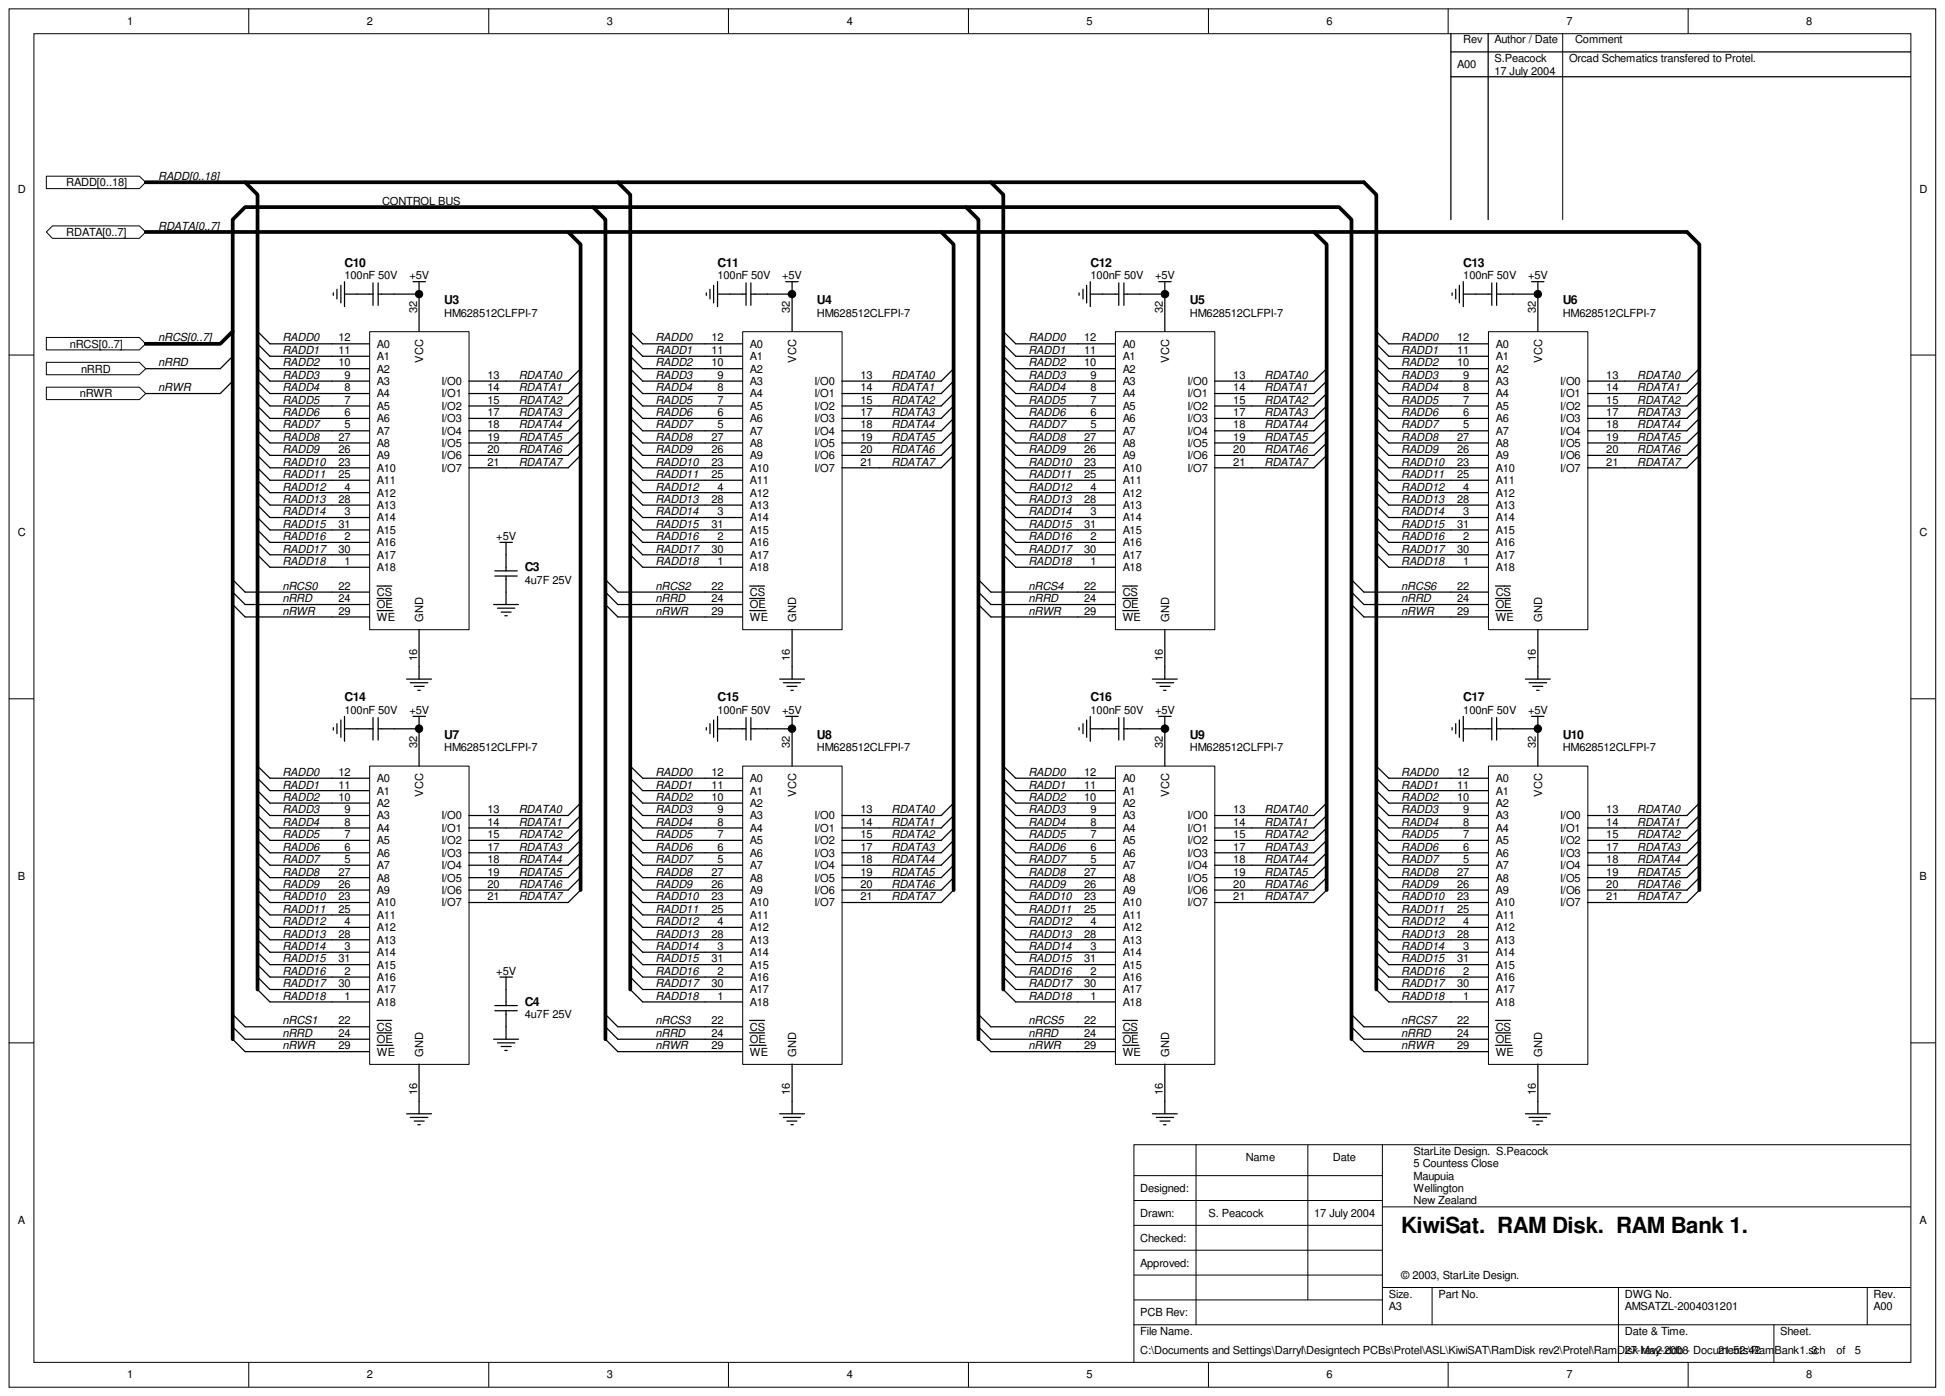
[picture p161: page 3]

StarLite Design. S.Peacock
5 Countess Close
Maupuia
Wellington
New Zealand
KiwiSat. RAM Disk. RAM Bank 1.

C:\Documents and Settings\Darryl\Designtech PCBs\Protel\ASL\KiwiSAT\RamDisk rev2\Protel\RamDisk rev2.ddb - Documents\RamBank1.sch

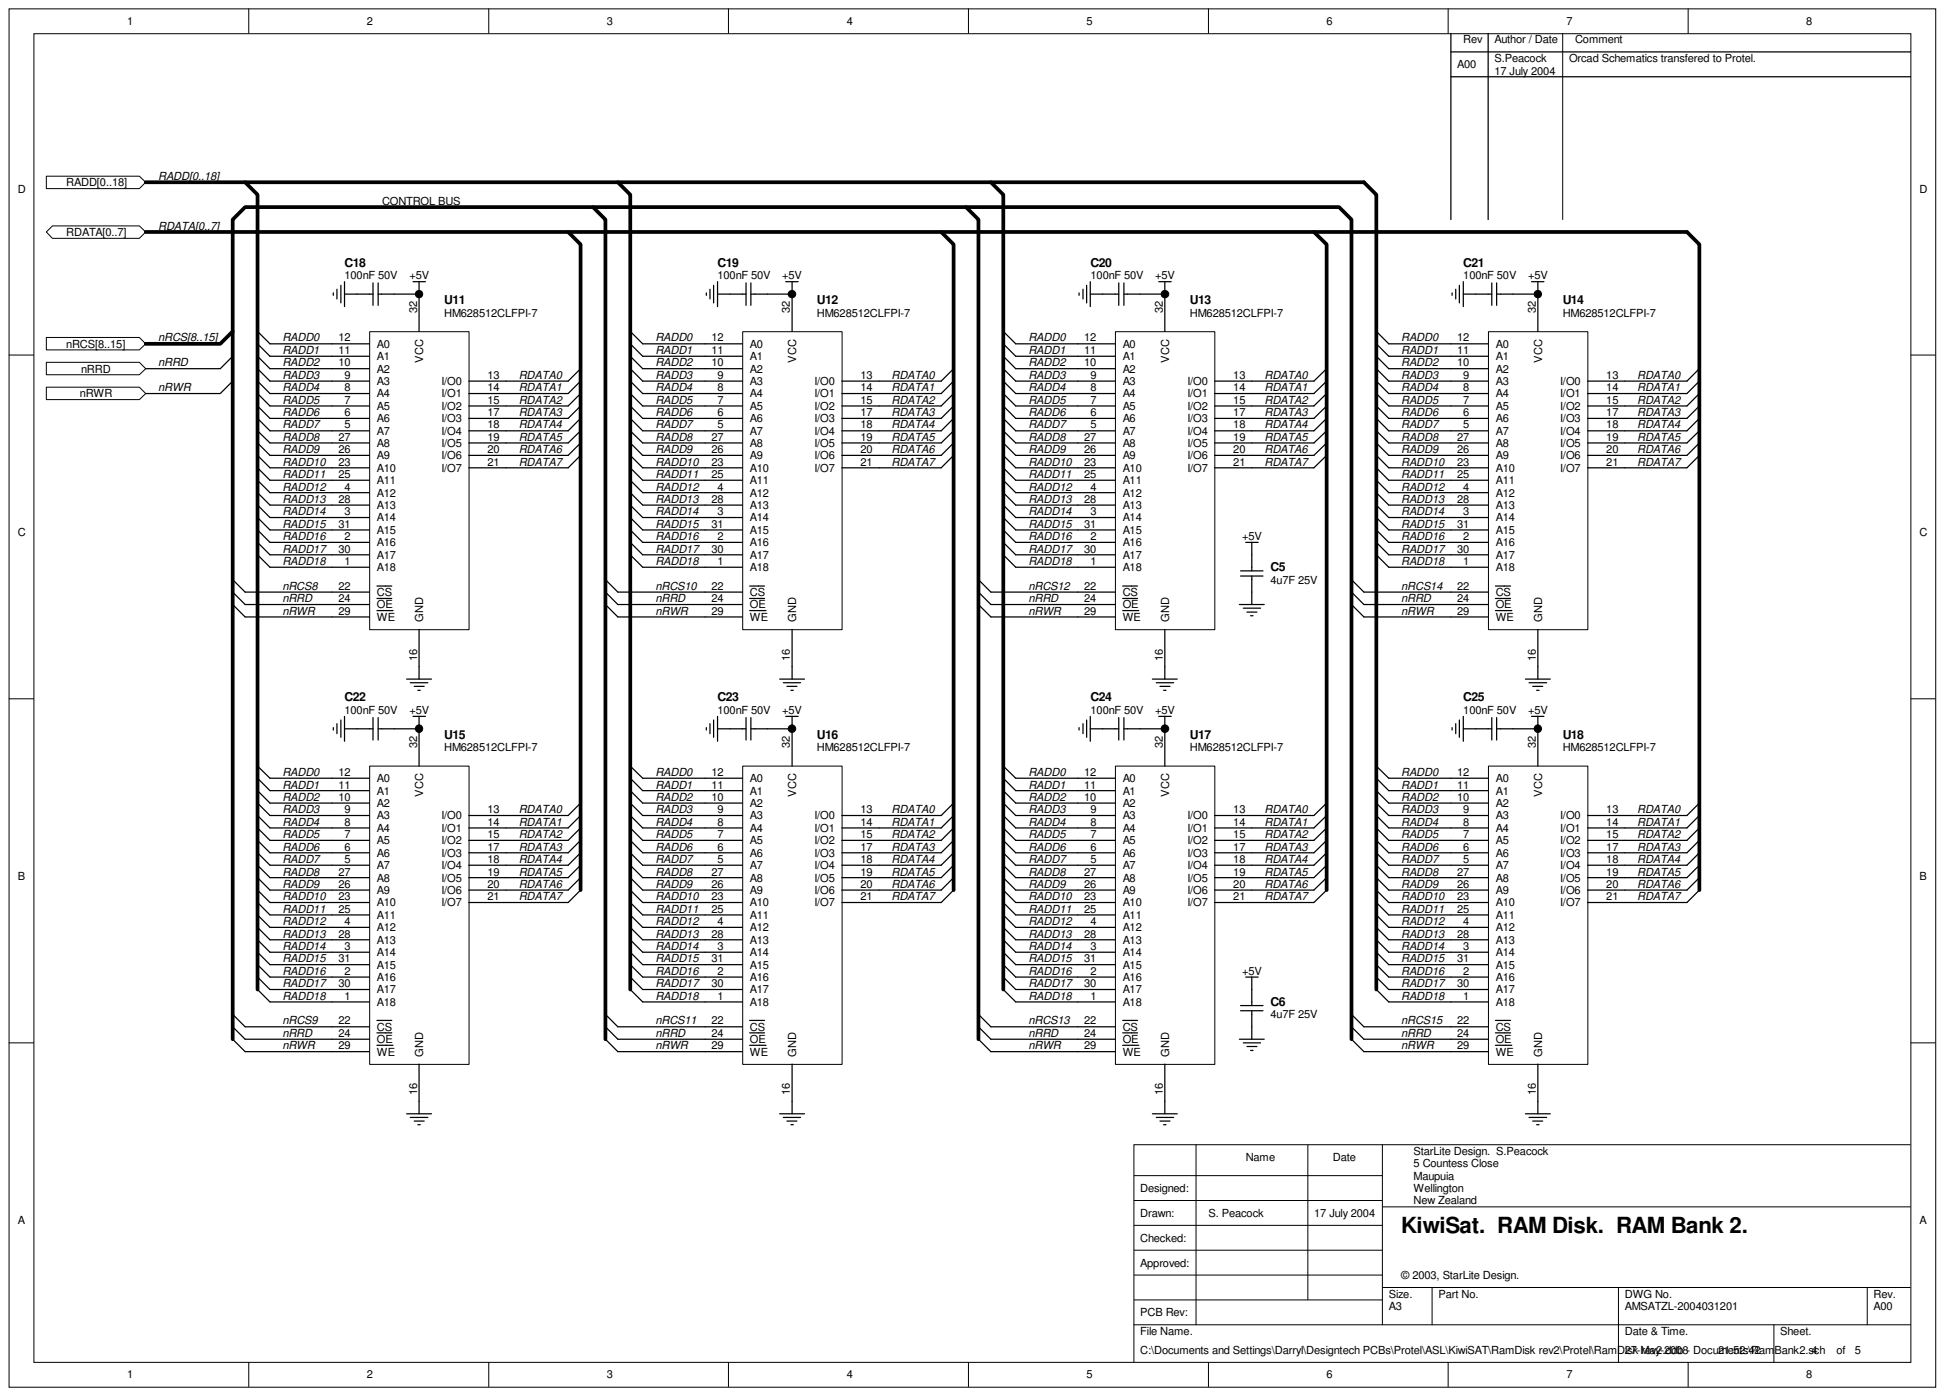
[picture p162: page 4]

StarLite Design. S.Peacock
5 Countess Close
Maupuia
Wellington
New Zealand
KiwiSat. RAM Disk. RAM Bank 2.

C:\Documents and Settings\Darryl\Designtech PCBs\Protel\ASL\KiwiSAT\RamDisk rev2\Protel\RamDisk rev2.ddb - Documents\RamBank2.sch

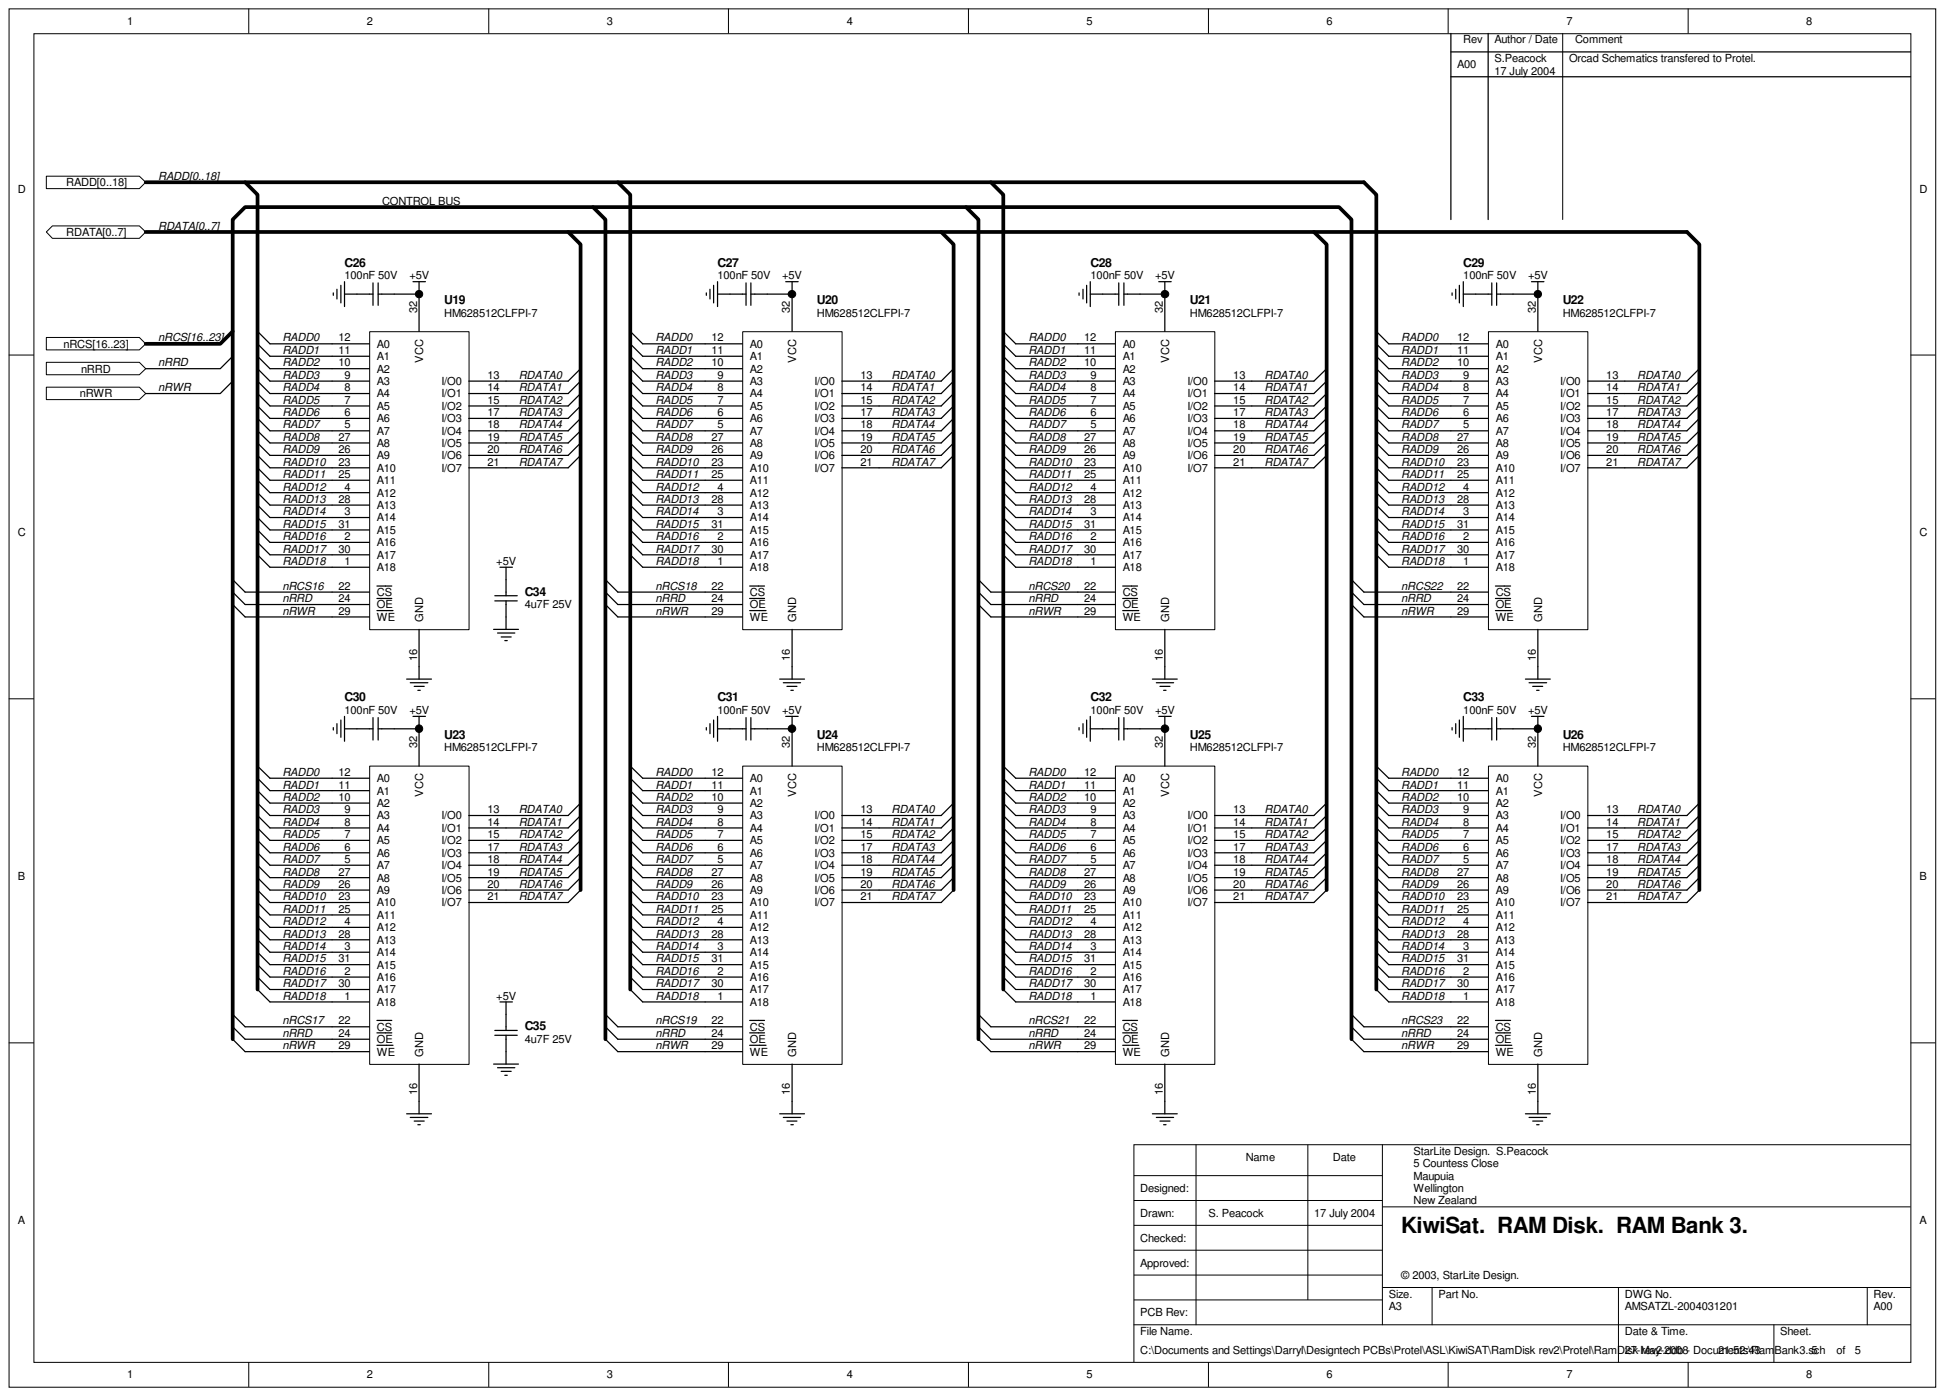
[picture p163: page 5]

StarLite Design. S.Peacock
5 Countess Close
Maupuia
Wellington
New Zealand
KiwiSat. RAM Disk. RAM Bank 3.

C:\Documents and Settings\Darryl\Designtech PCBs\Protel\ASL\KiwiSAT\RamDisk rev2\Protel\RamDisk rev2.ddb - Documents\RamBank3.sch
