AMSAT-ZL/KiwiSAT_Sub-Systems/Launch Adapter/Launch drum  with pushers for CGWIC.pdf

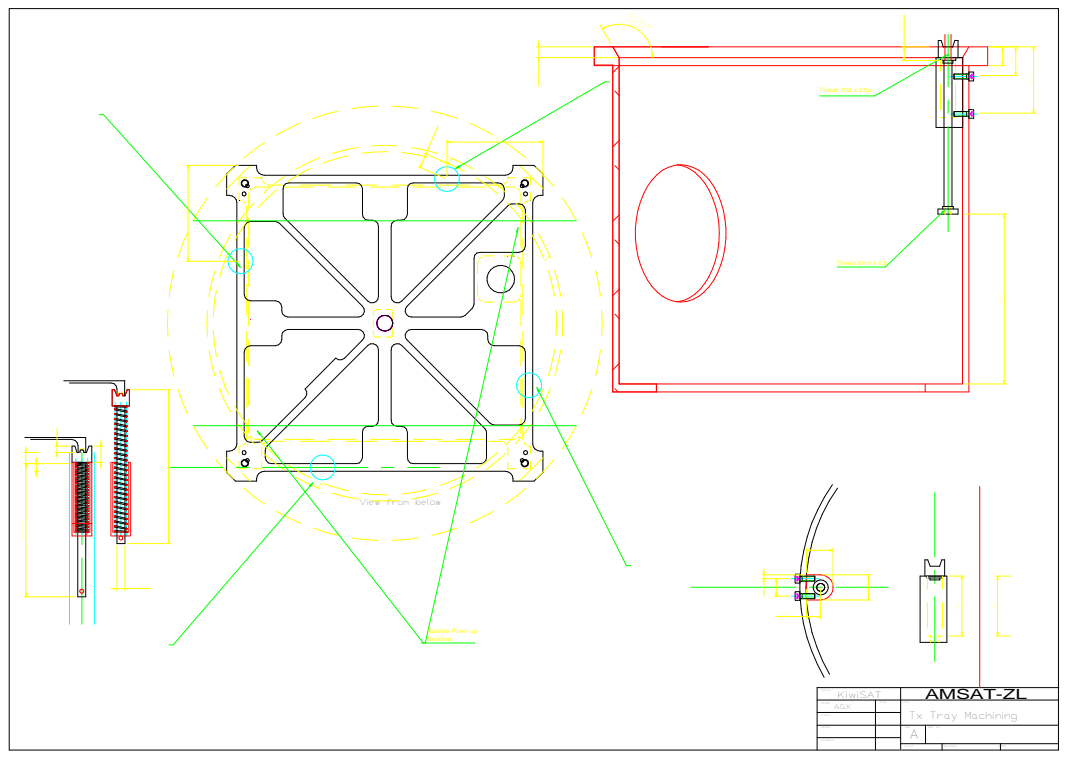
[picture p164: page 1]
Thread 7/32 x 32tpi; Thread 5mm x 0.8

View from below

Satellite Power up
Switches

PROJECT KiwiSAT | AMSAT-ZL

DRAWN | DATE | TITLE Tx Tray Machining A.G.K

CHECK

DESIGN | | SIZE A | DWG. NO.

ENGINEER | | SCALE RELEASED SHEET
