AMSAT-ZL/KiwiSAT_Sub-Systems/GPS/LatimerGPS/Where to drill the fixing hole.pdf

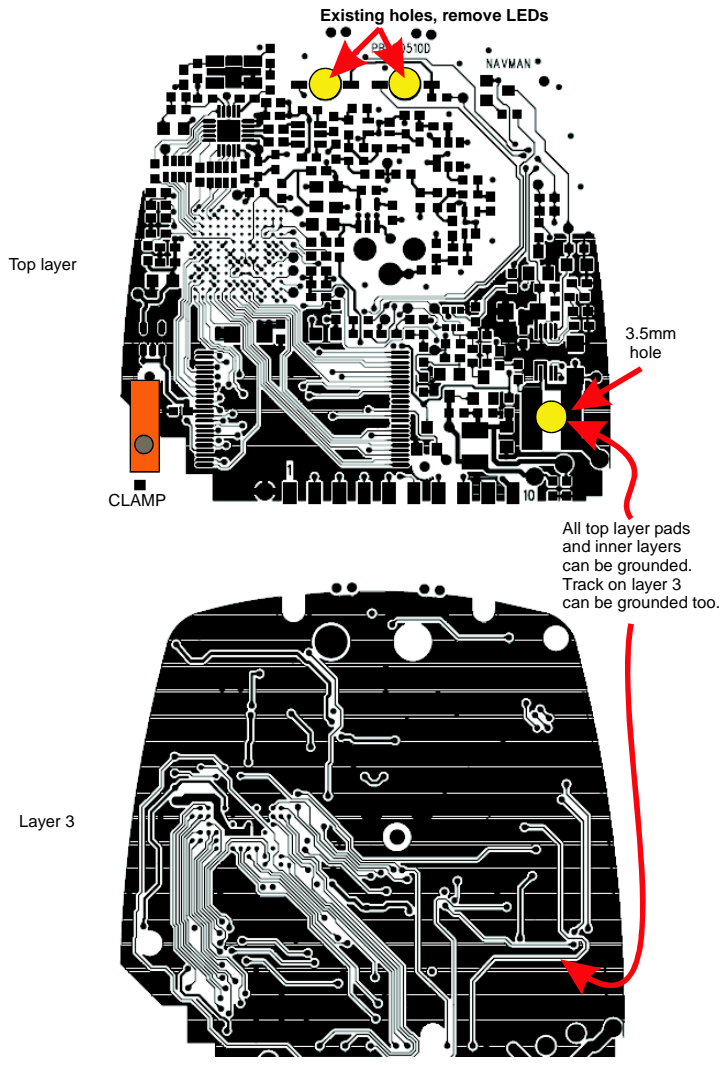
[picture p165: page 1]
Top layer; Layer3; 3.5mm hole; CLAMP

Existing holes, remove LEDs

All top layer pads
and inner layers
can be grounded.
Track on layer3
can be grounded too.
