AMSAT-ZL/KiwiSAT_Sub-Systems/ADC_Module/ADC_Module_V10 mechanical.pdf

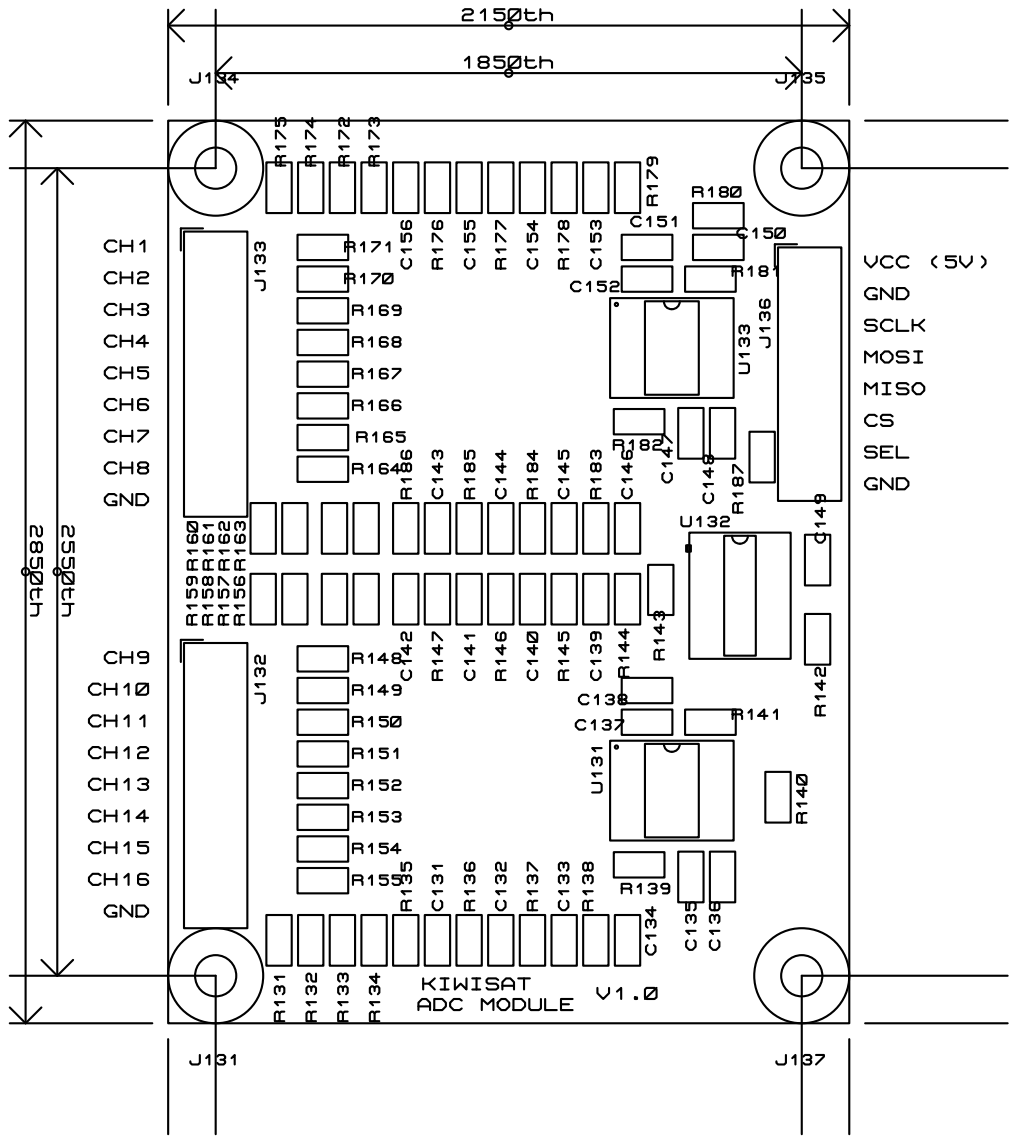
[picture p166: page 1]
