AMSAT-ZL/KiwiSAT_Sub-Systems/ADC_Module/ADC_Module_V10 schematic.pdf

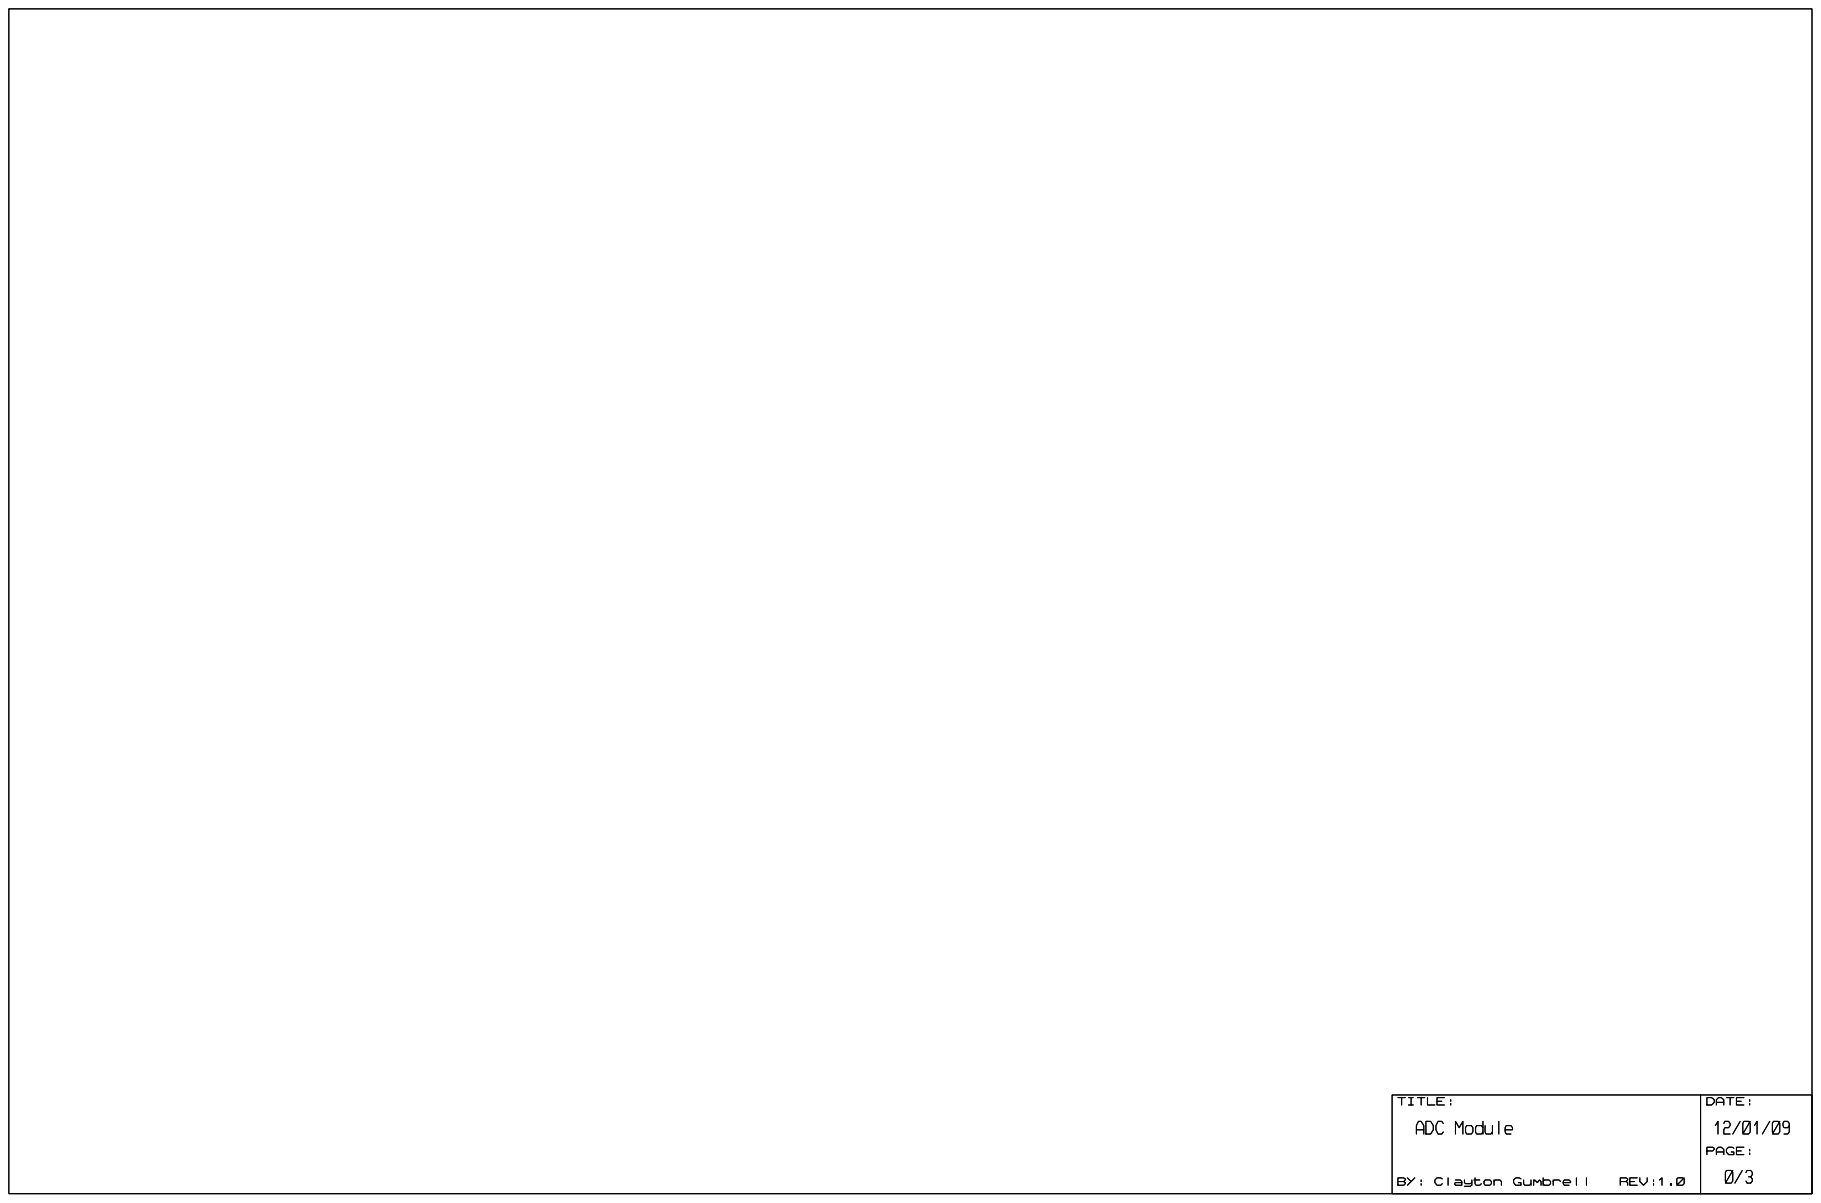
[picture p167: page 1]

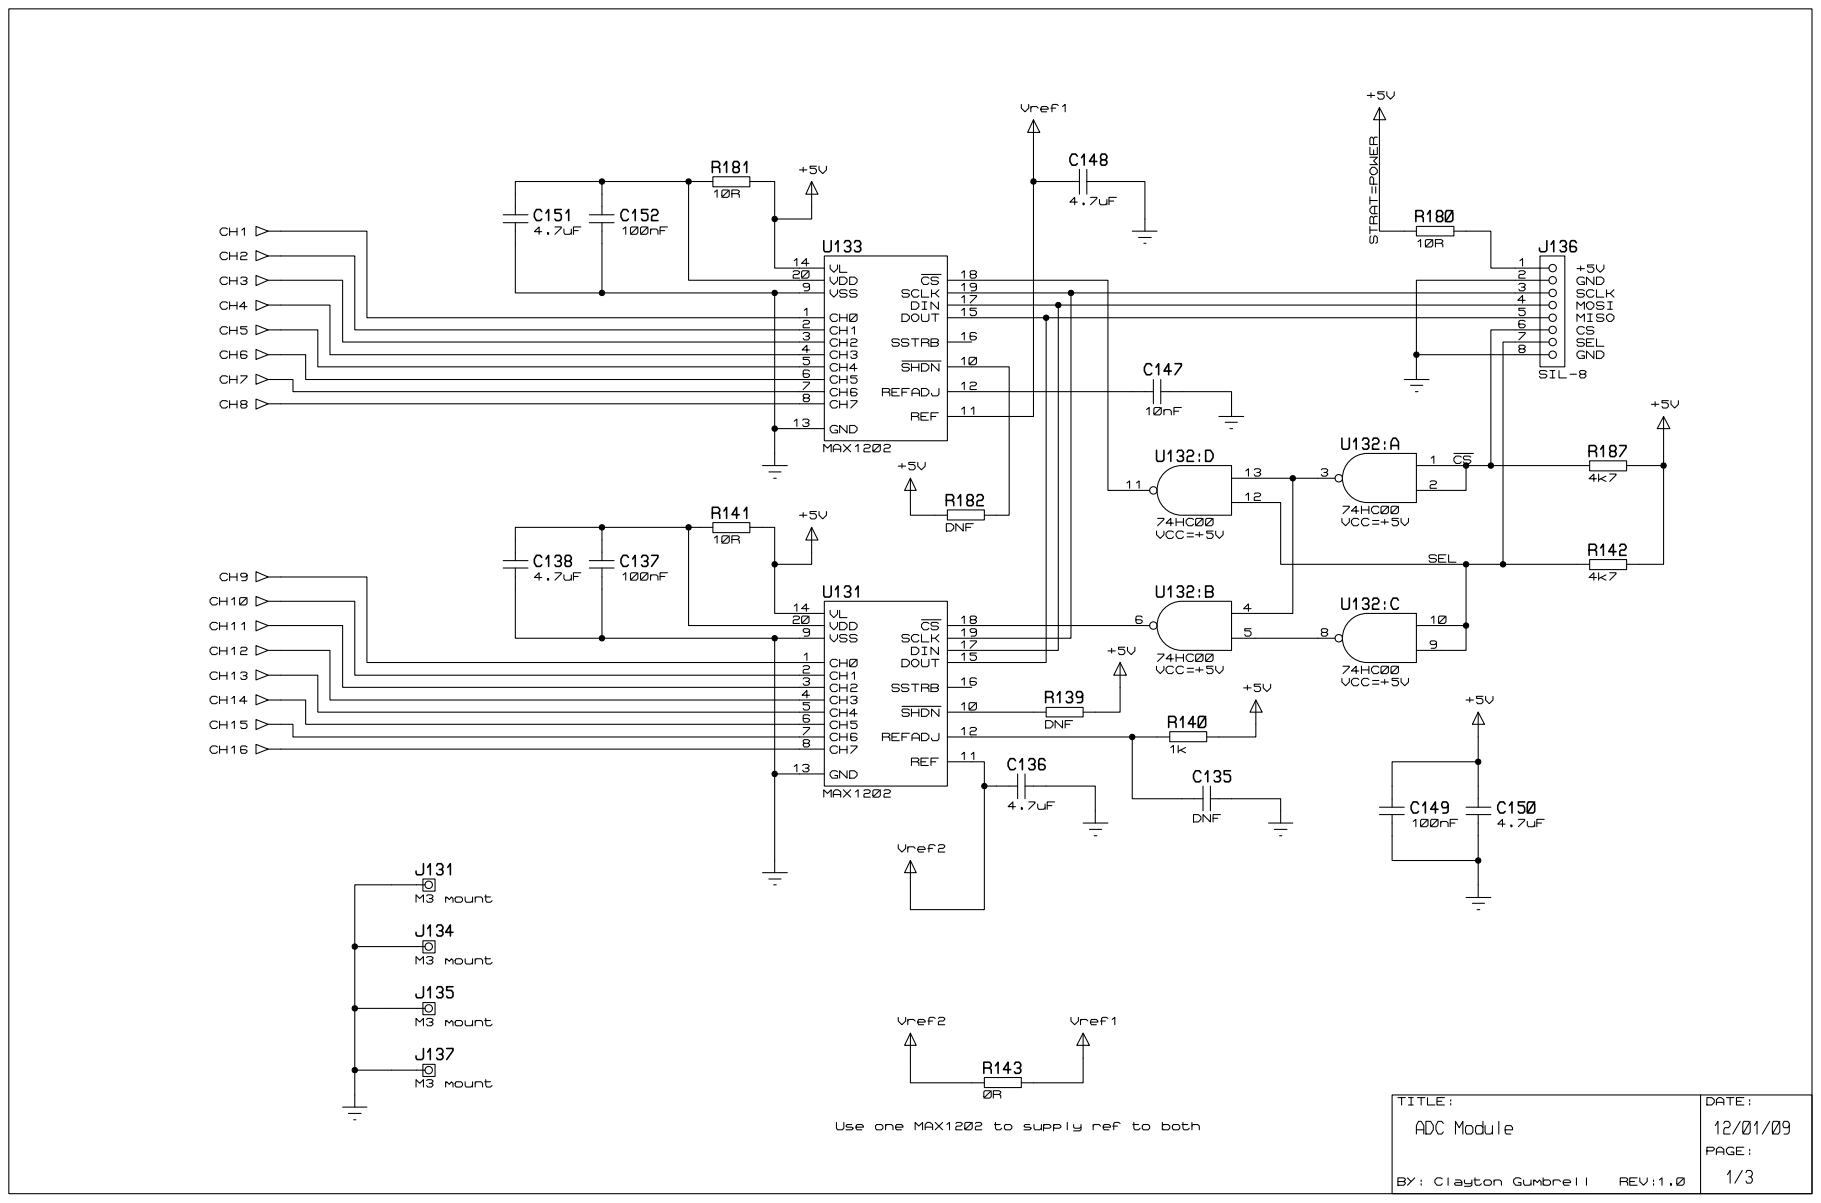
[picture p168: page 2]

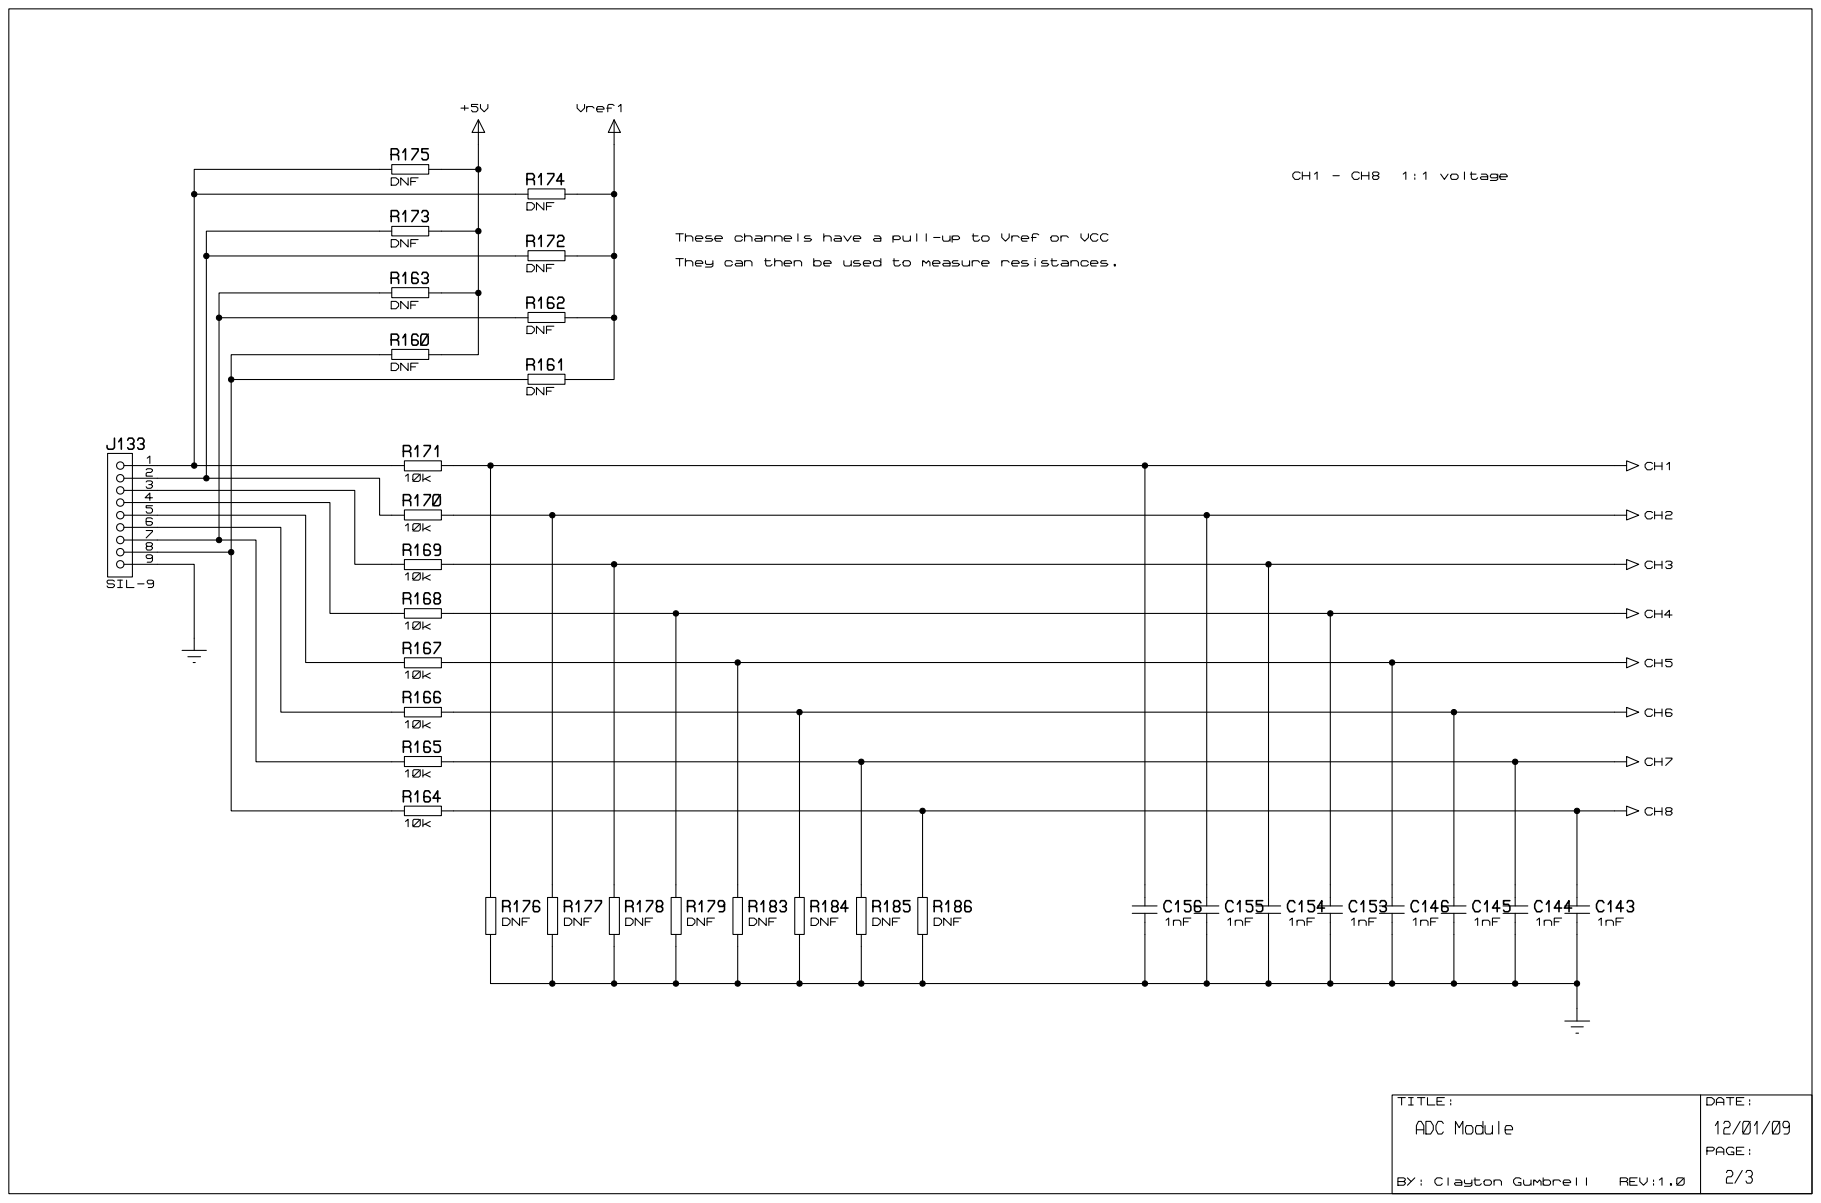
[picture p169: page 3]

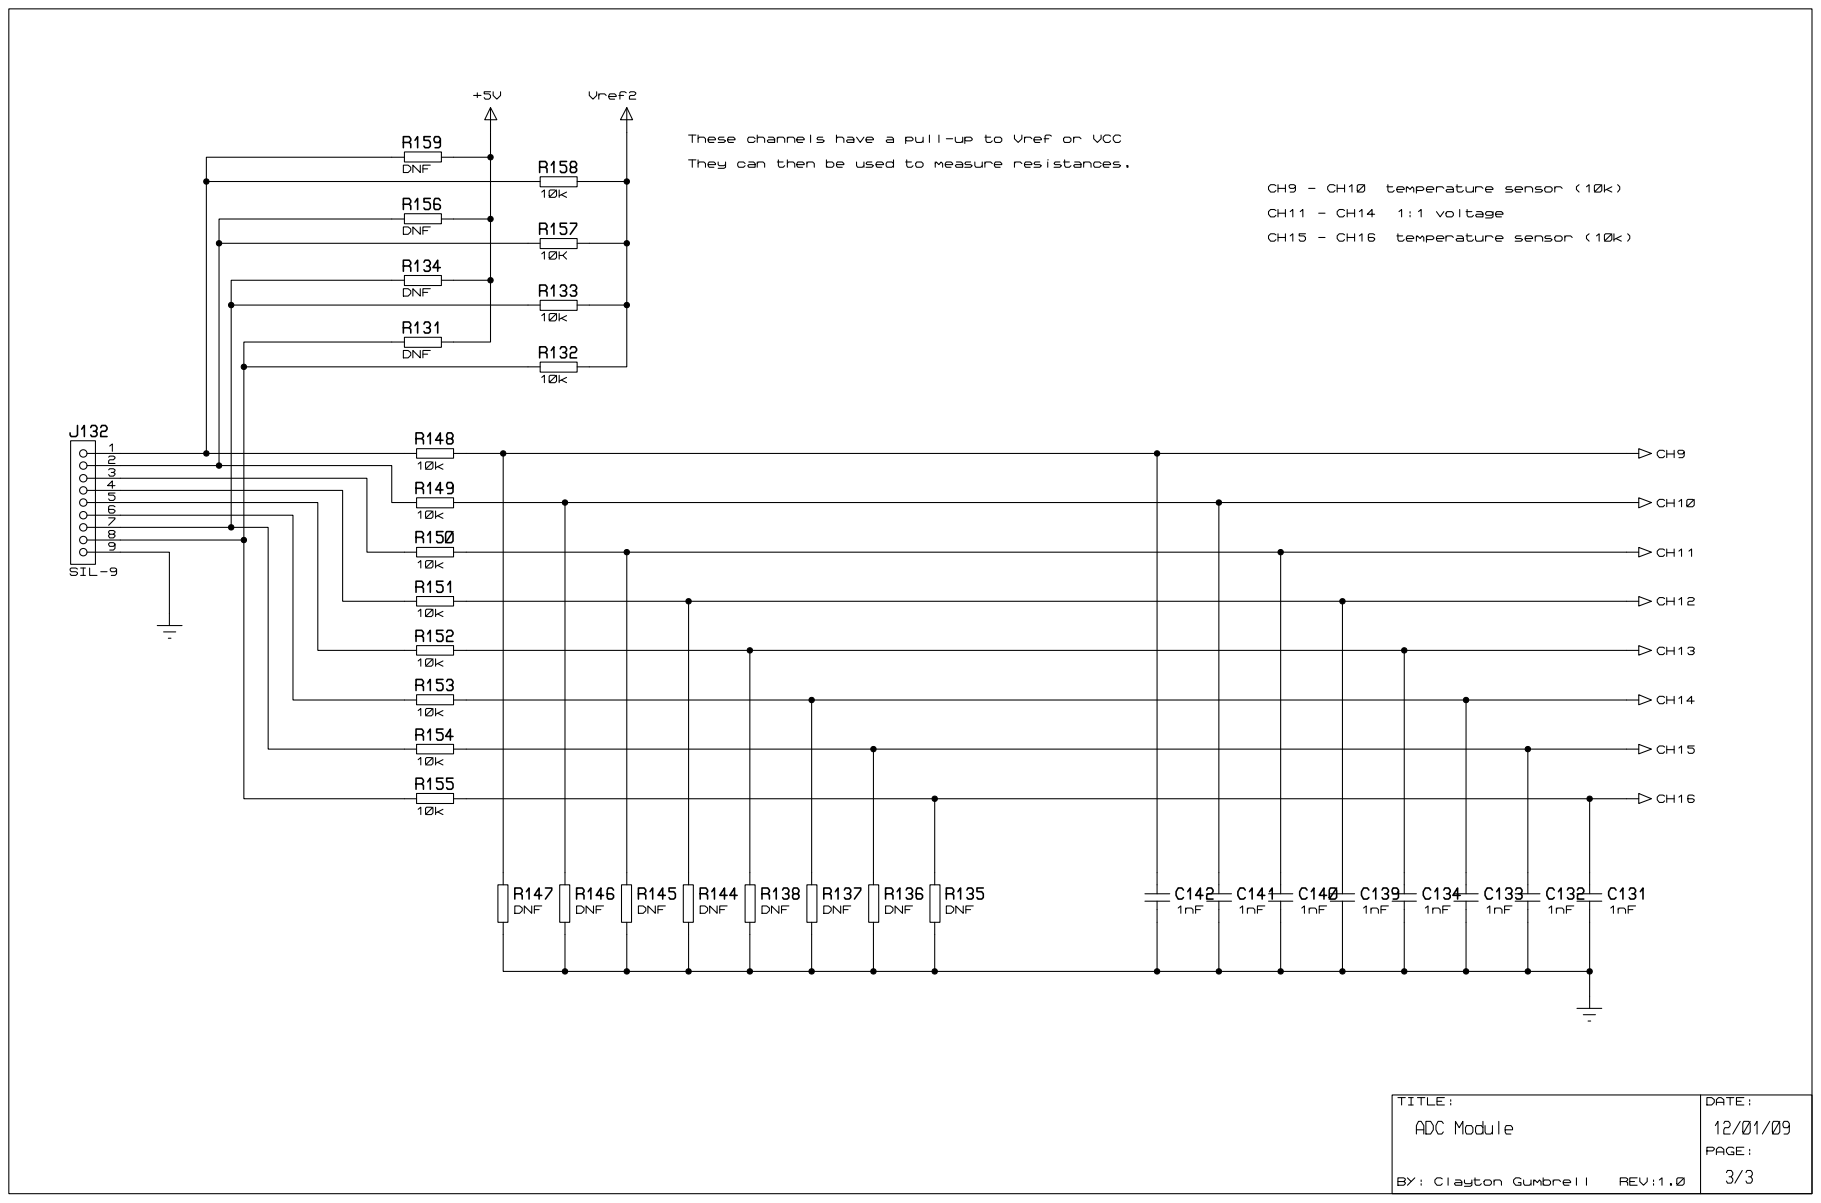
[picture p170: page 4]
