AMSAT-ZL/KiwiSAT_Sub-Systems/Camera/Camera_V2 mechanical.pdf

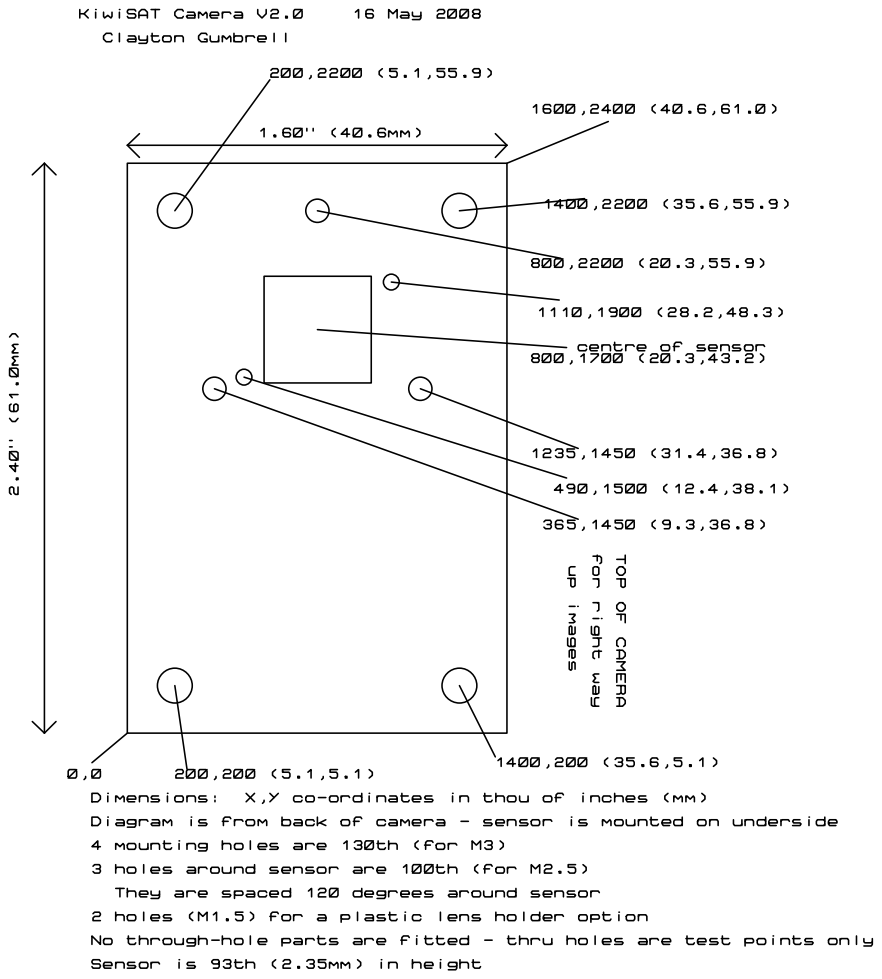
[picture p171: page 1]
