AMSAT-ZL/KiwiSAT_Sub-Systems/Camera/Camera_V2 schematic.pdf

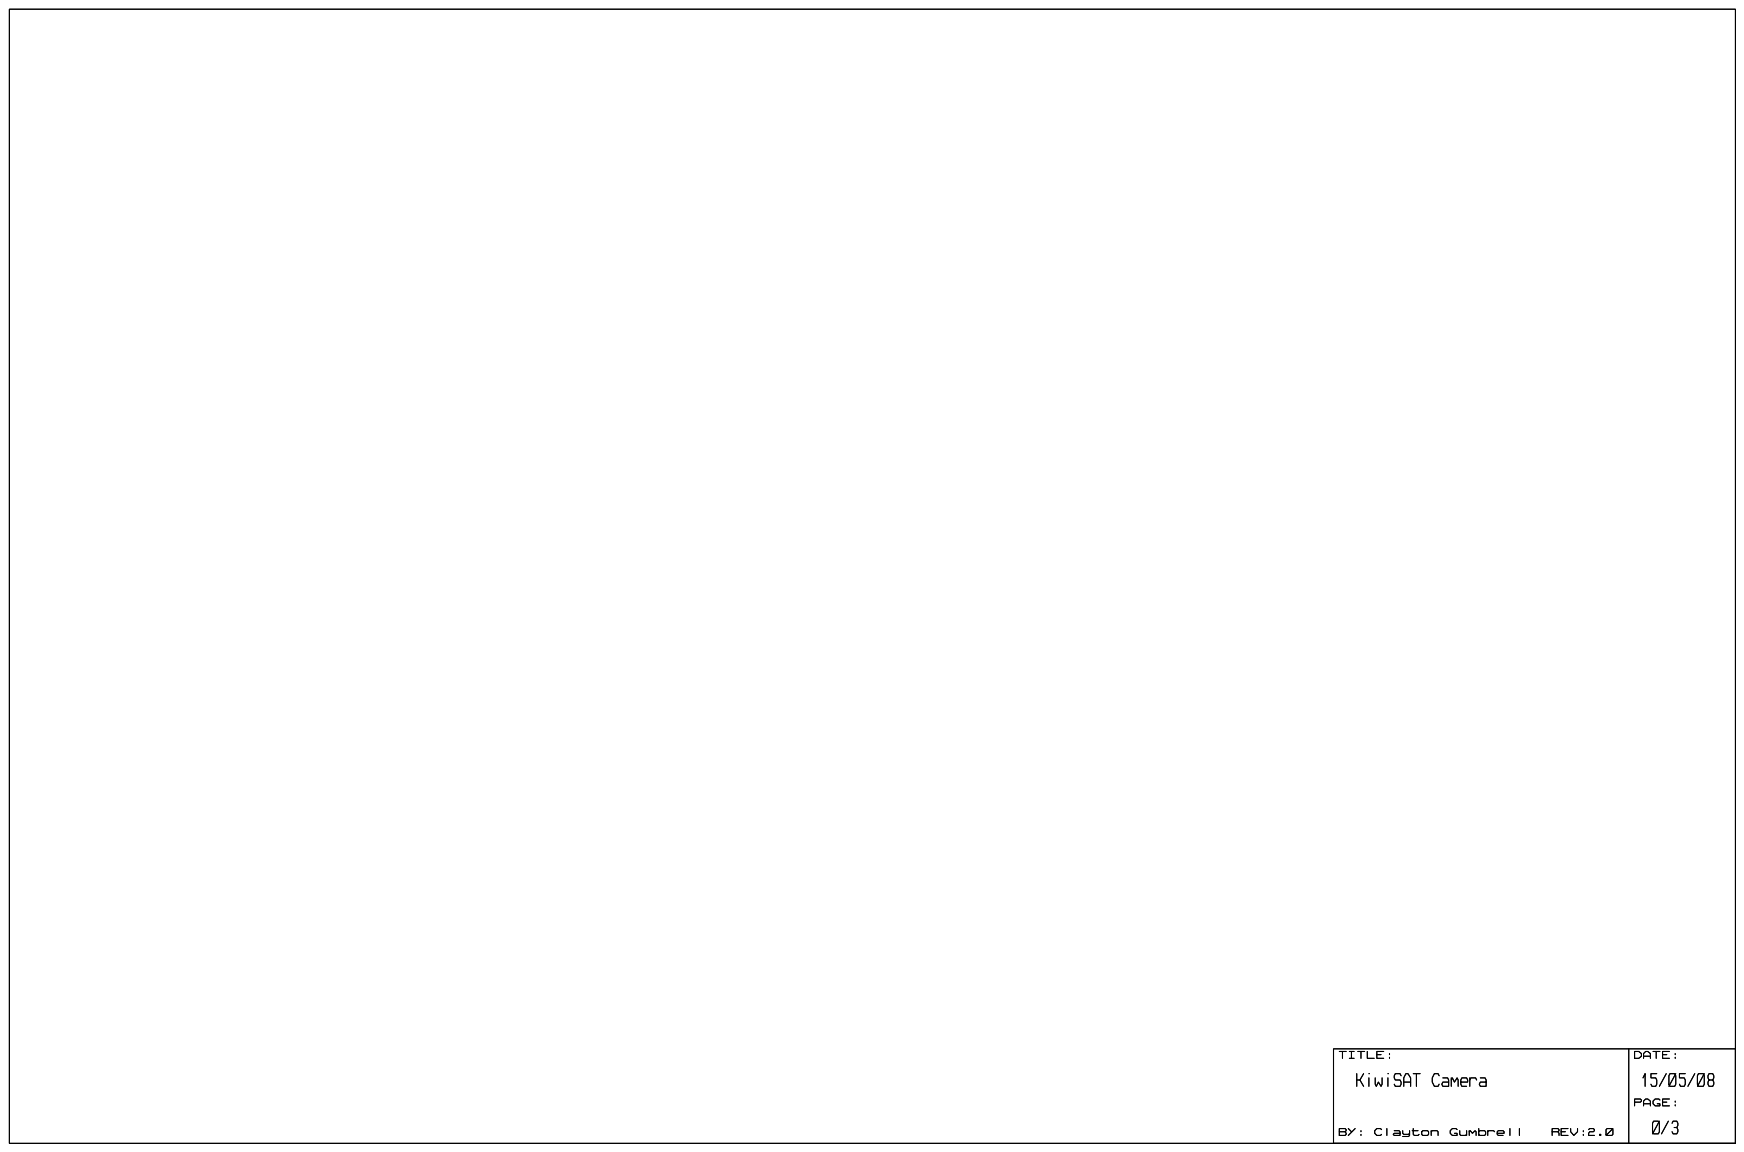
[picture p172: page 1]

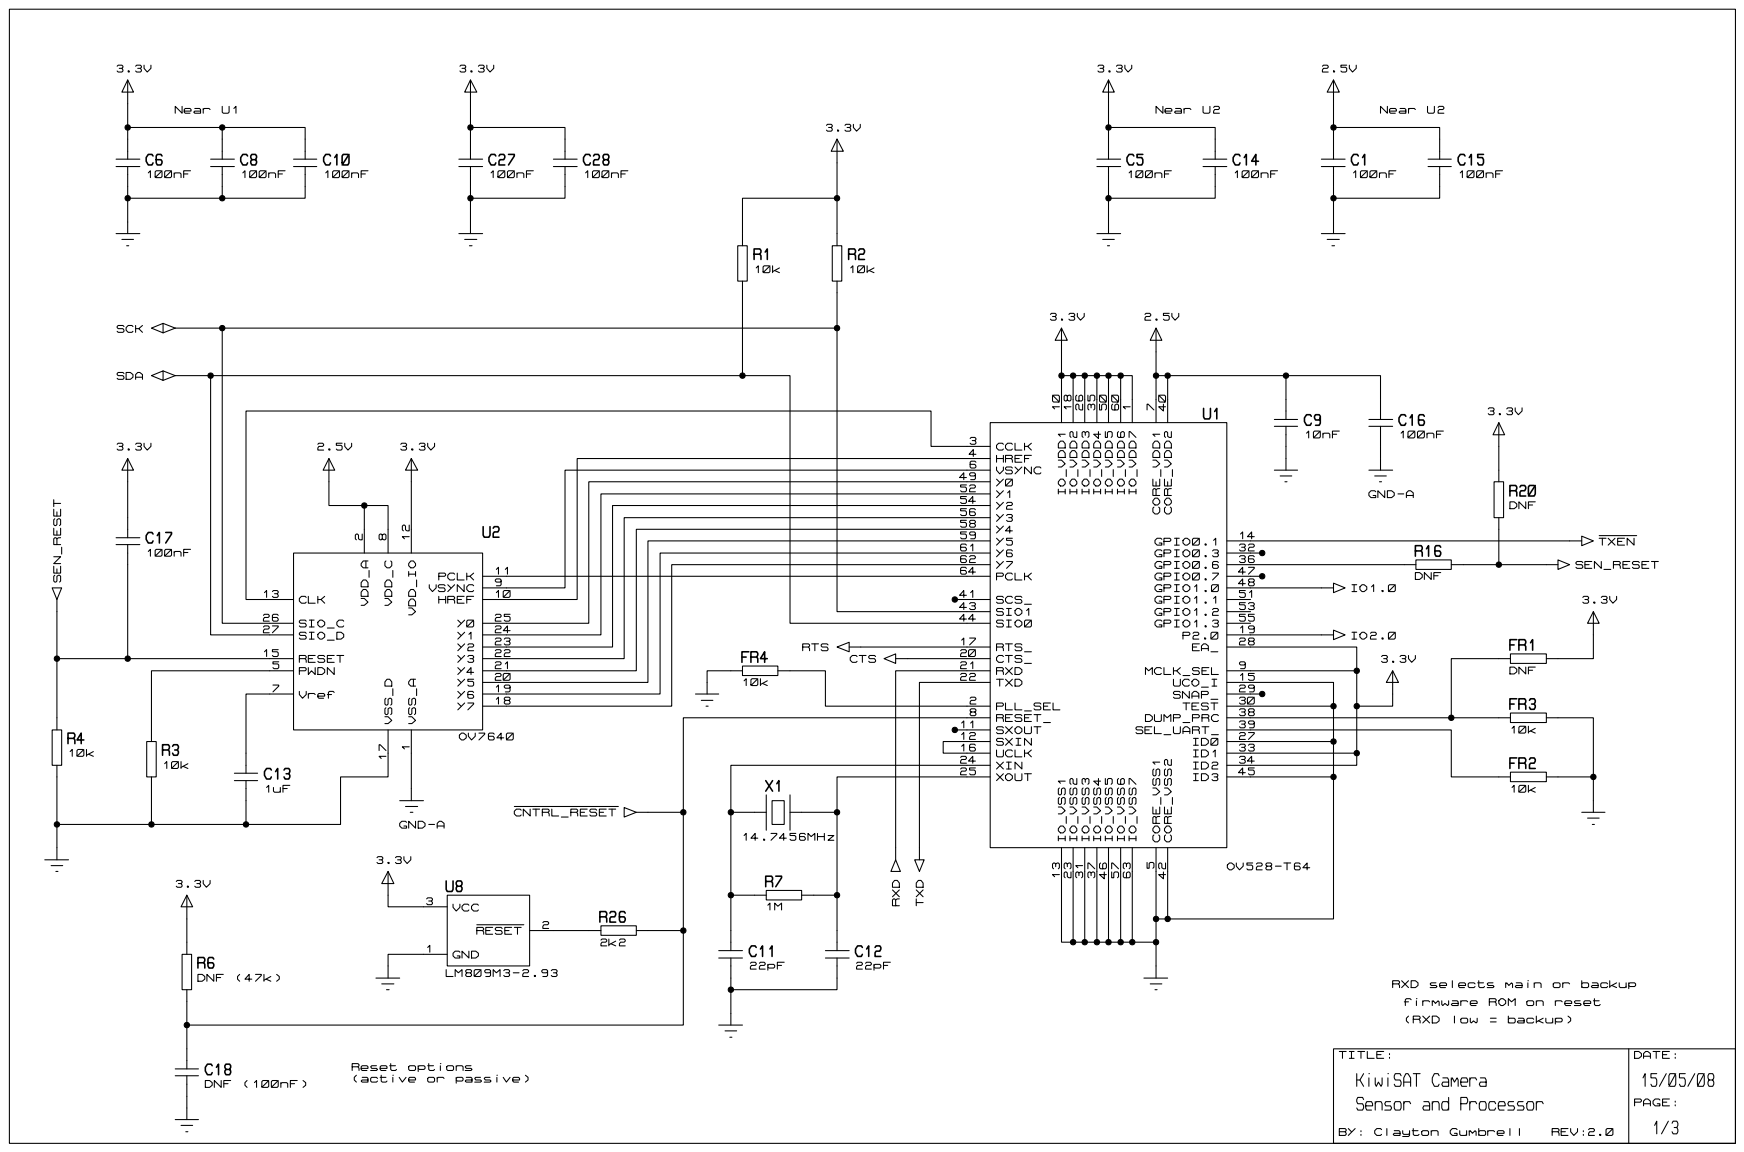
[picture p173: page 2]

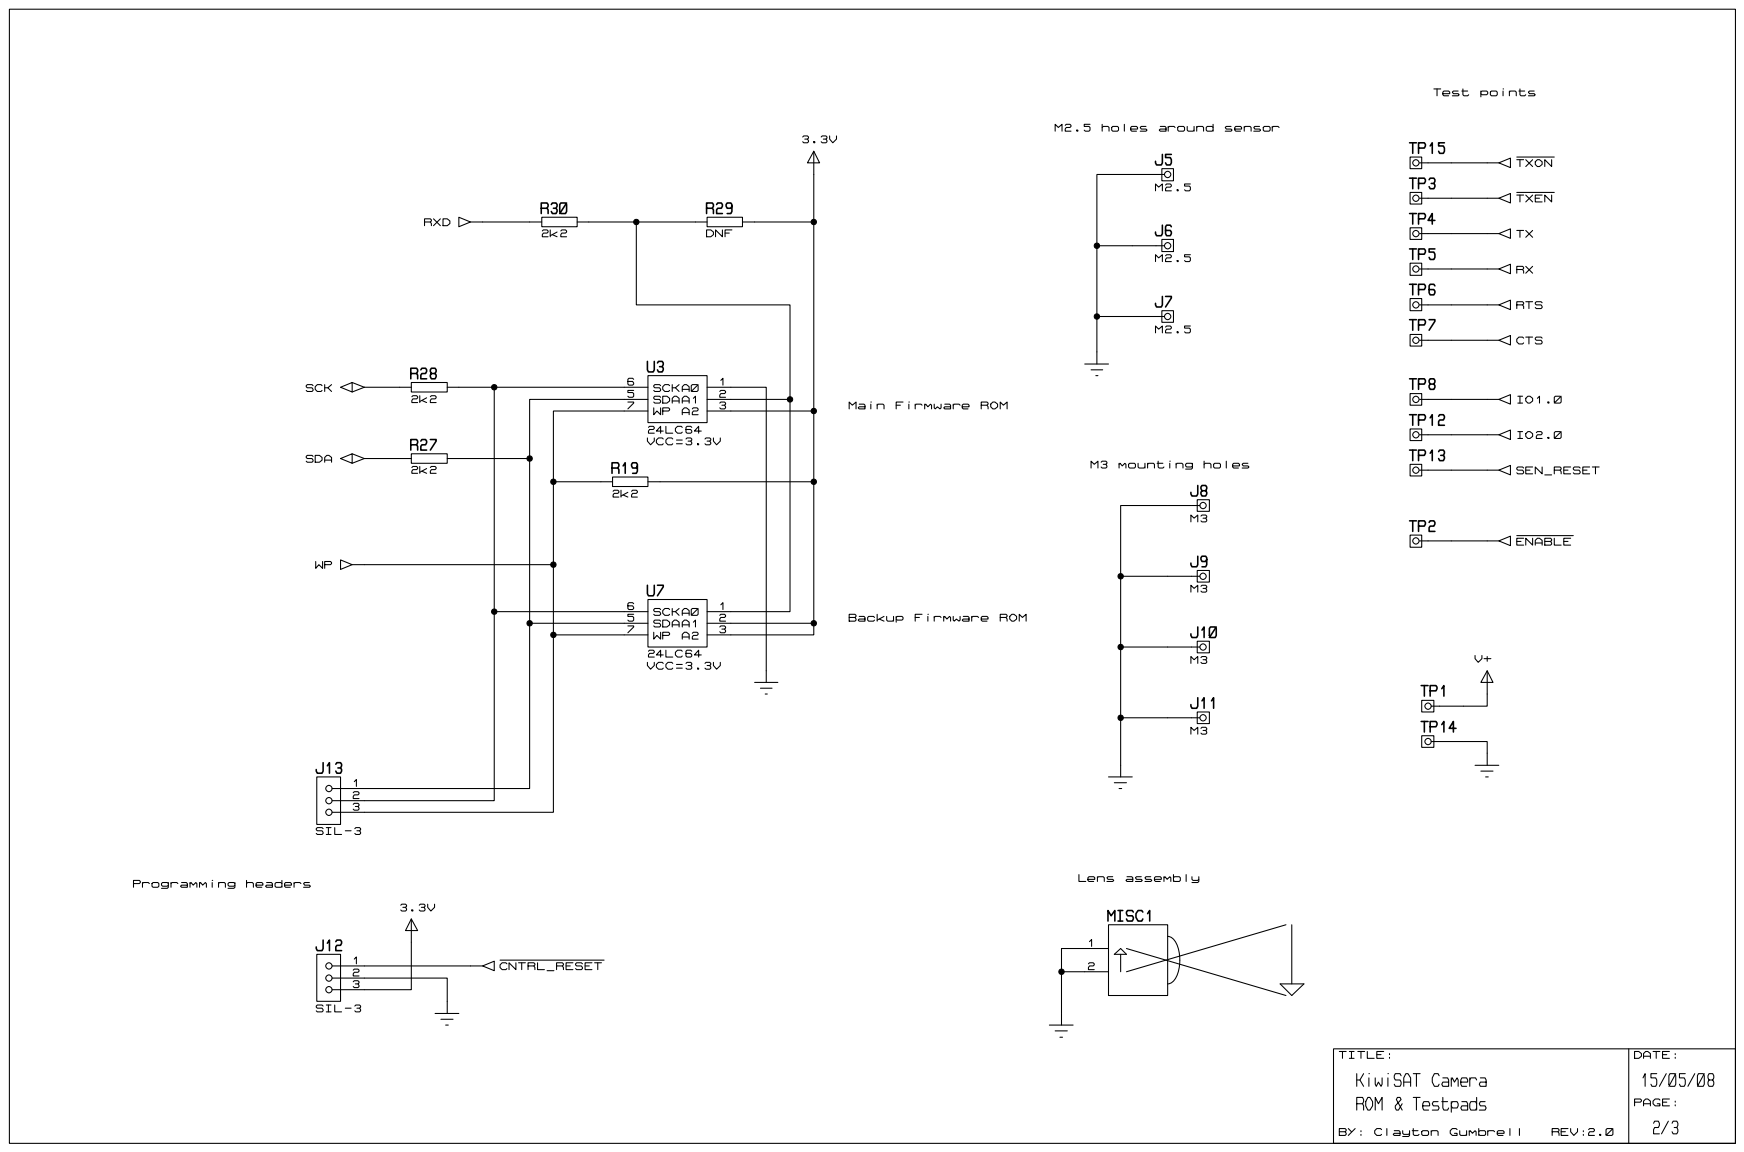
[picture p174: page 3]

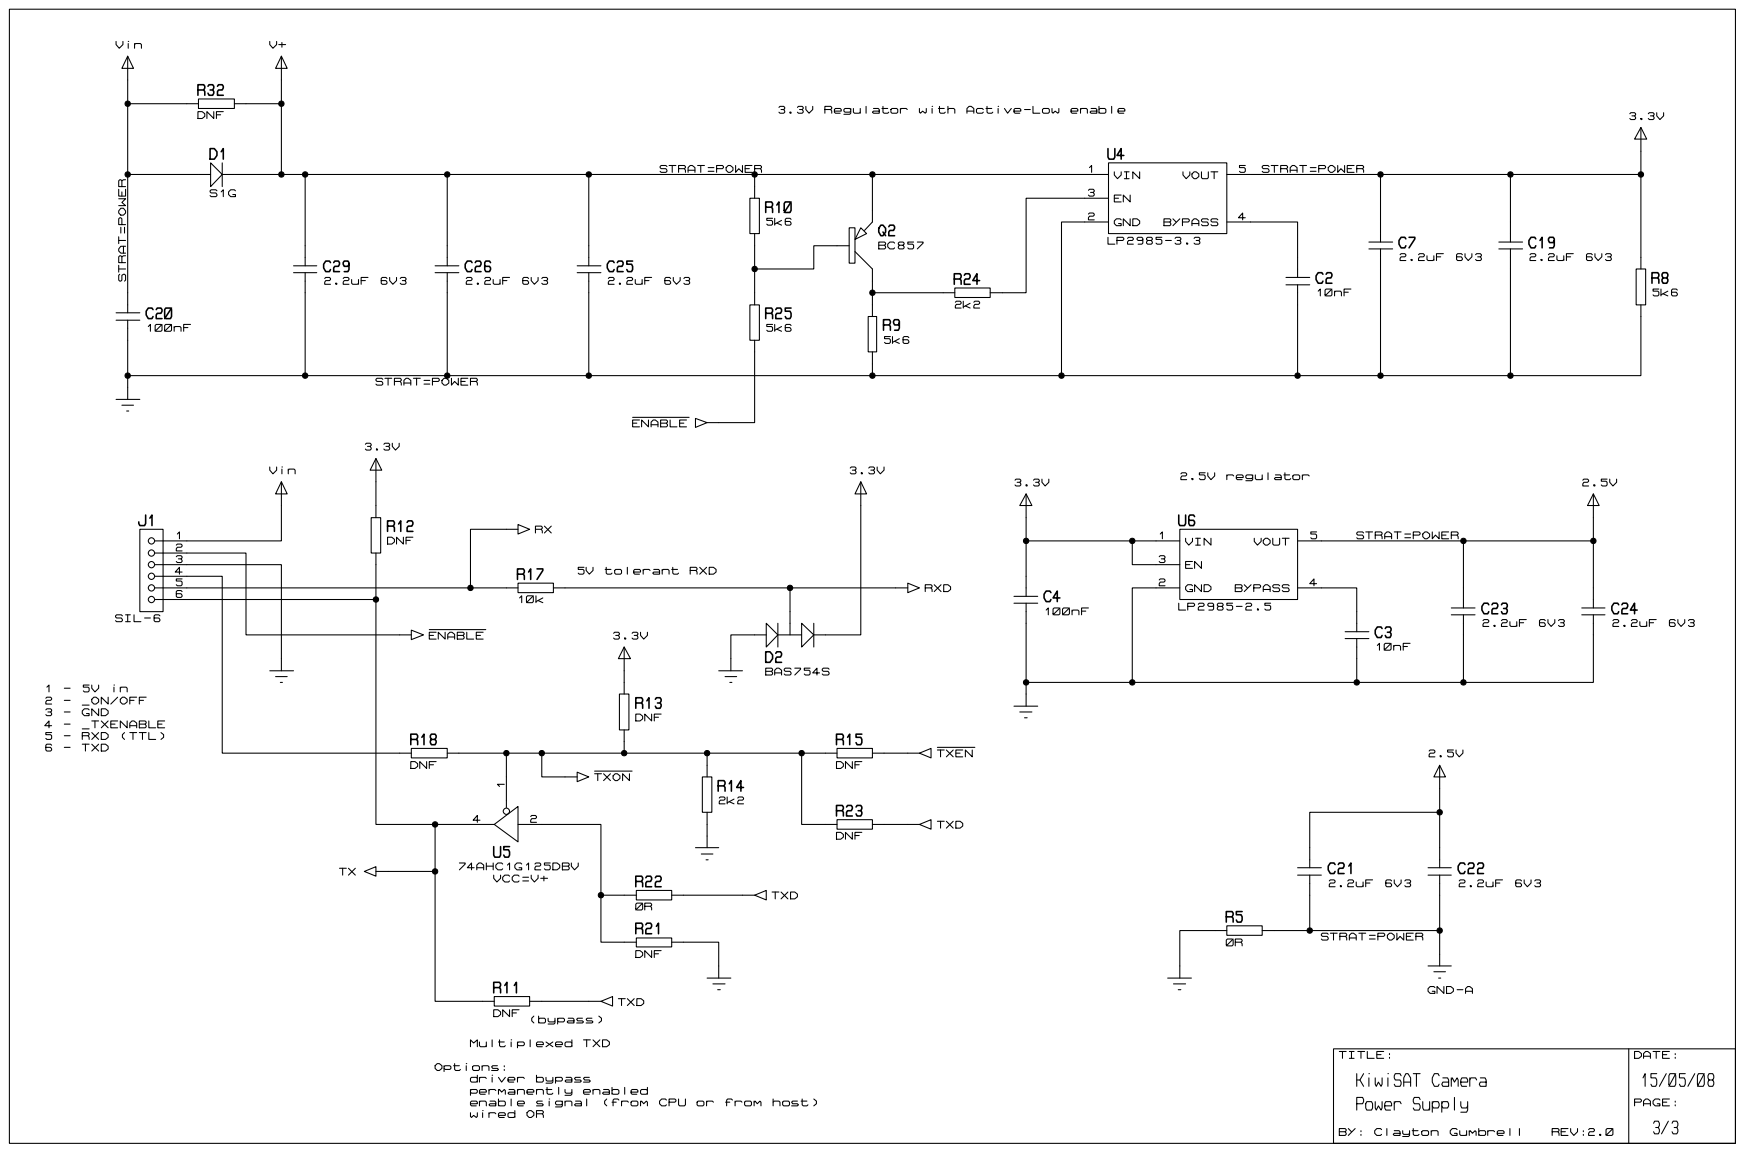
[picture p175: page 4]
