AMSAT-ZL/KiwiSAT_Sub-Systems/Coil_Driver/ADAC Schematic v1.pdf

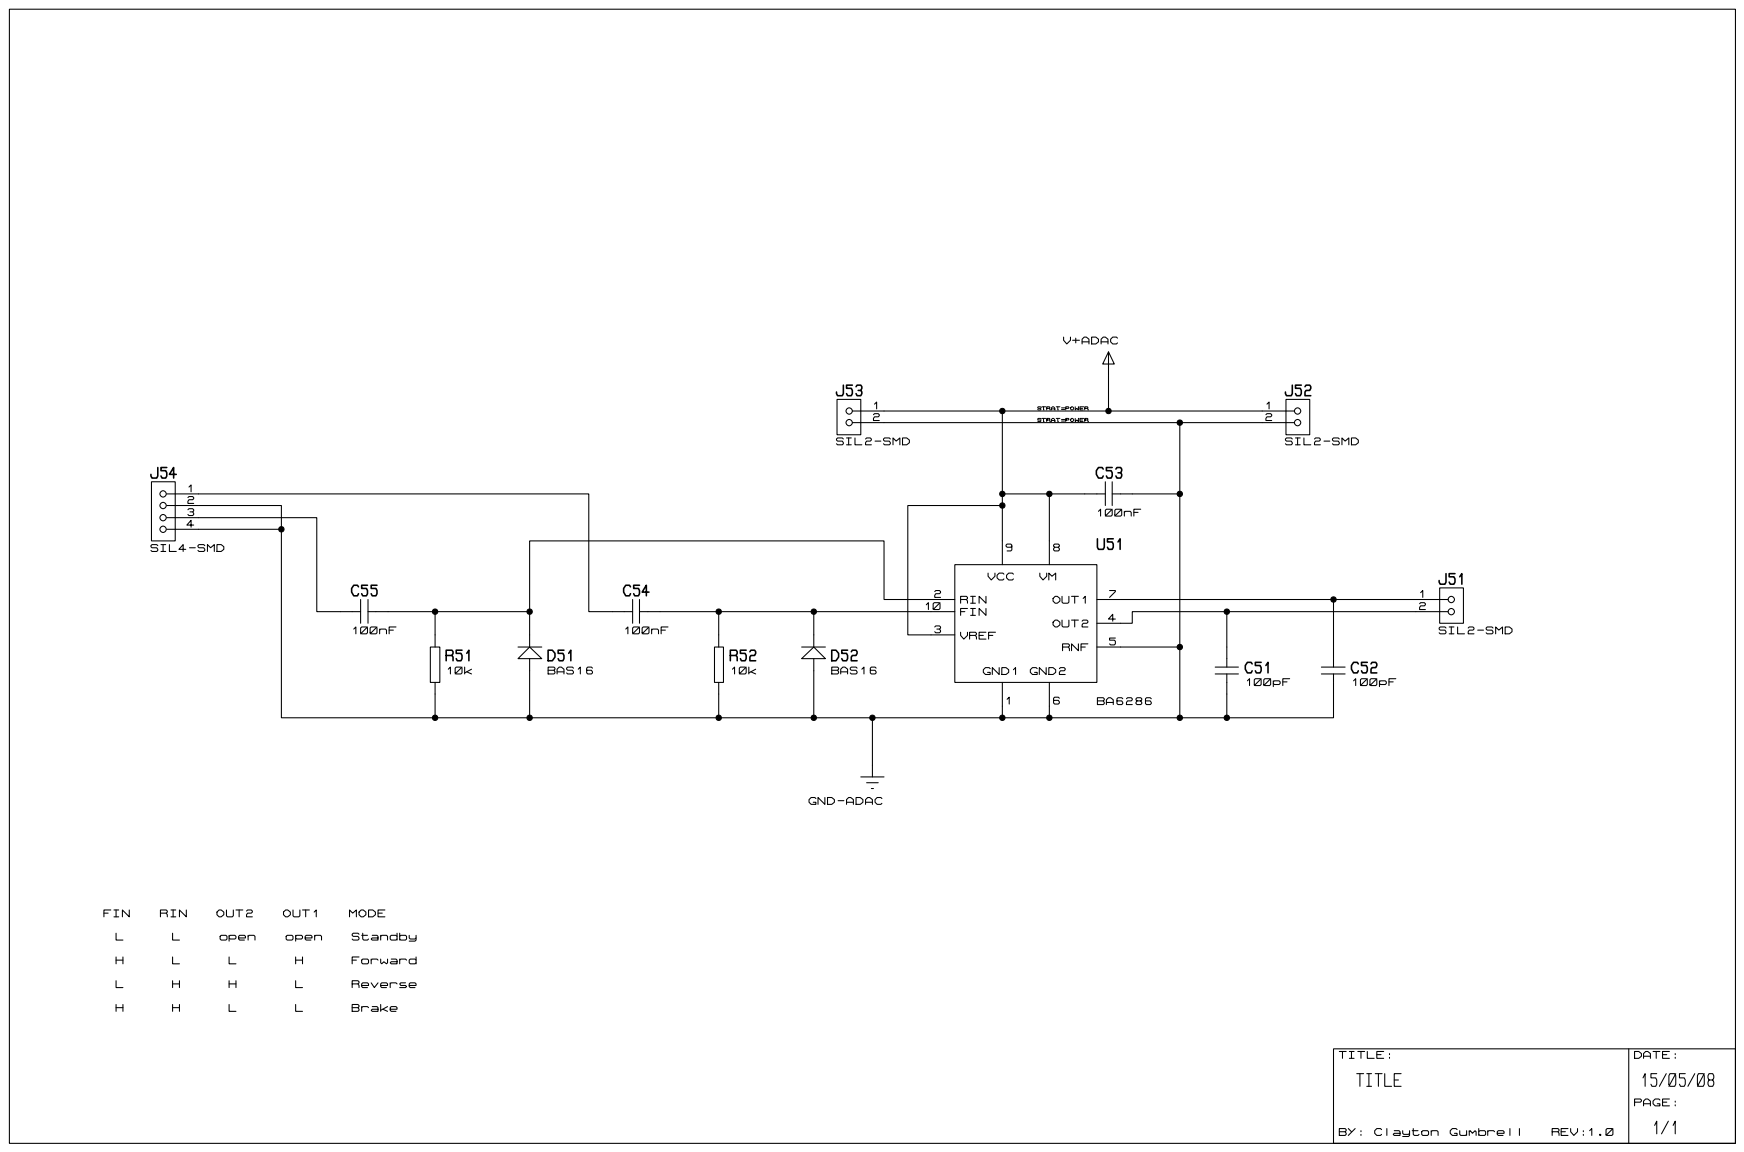
[picture p176: page 1]
