AMSAT-ZL/KiwiSAT_Sub-Systems/Earth_Horizon_Sensor/Horizon_Sensor_Heads_V11 mechanical.pdf

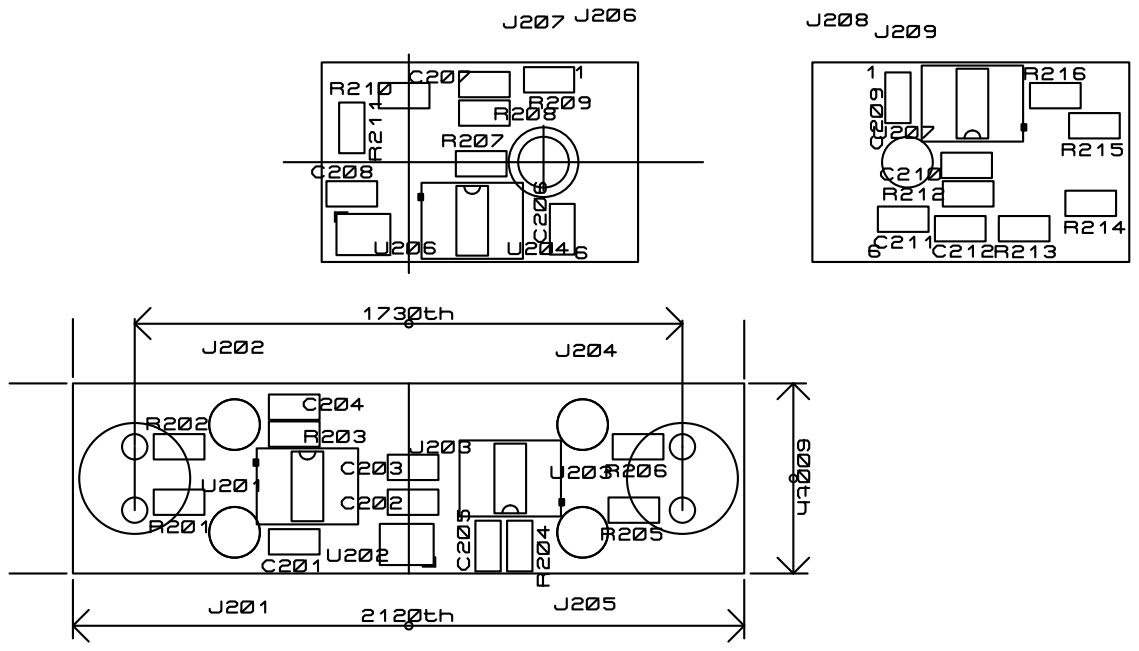
[picture p177: page 1]
