AMSAT-ZL/KiwiSAT_Sub-Systems/Earth_Horizon_Sensor/Horizon_Sensor_Heads_V11b schematic.pdf

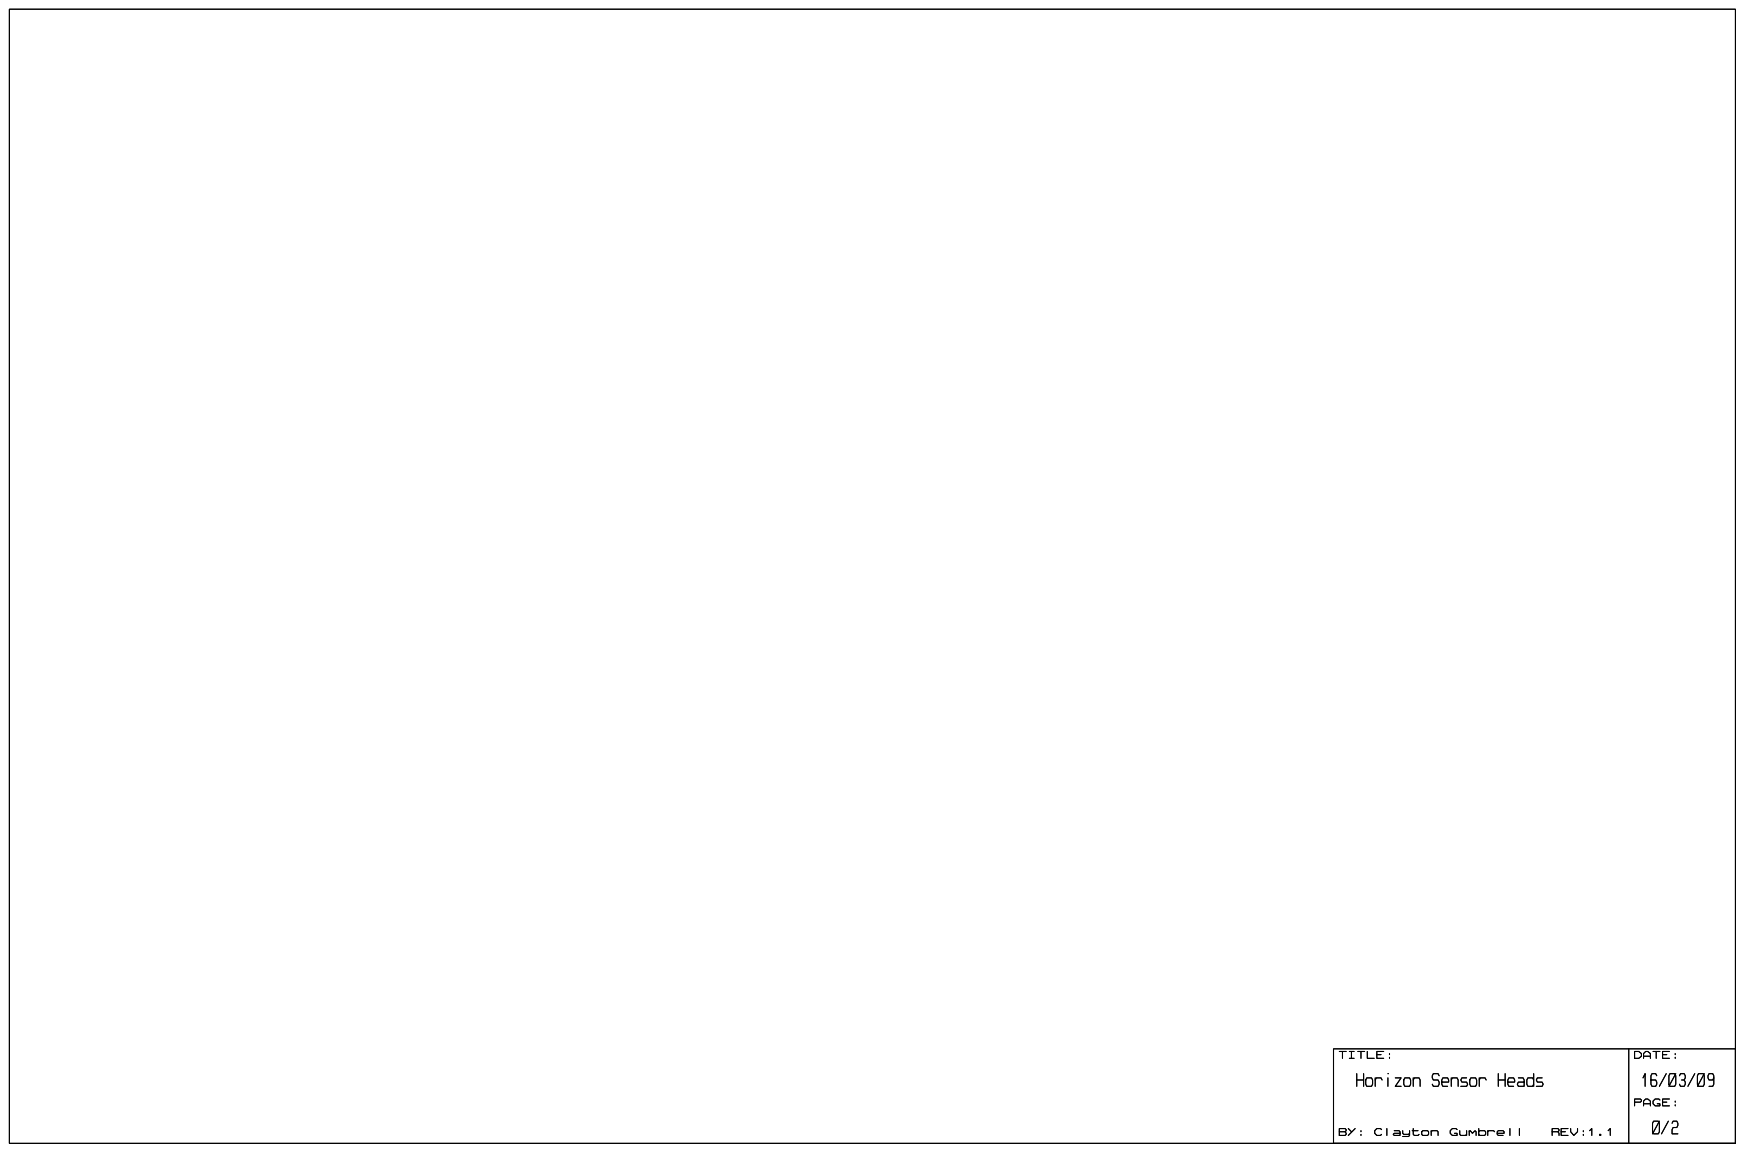
[picture p178: page 1]

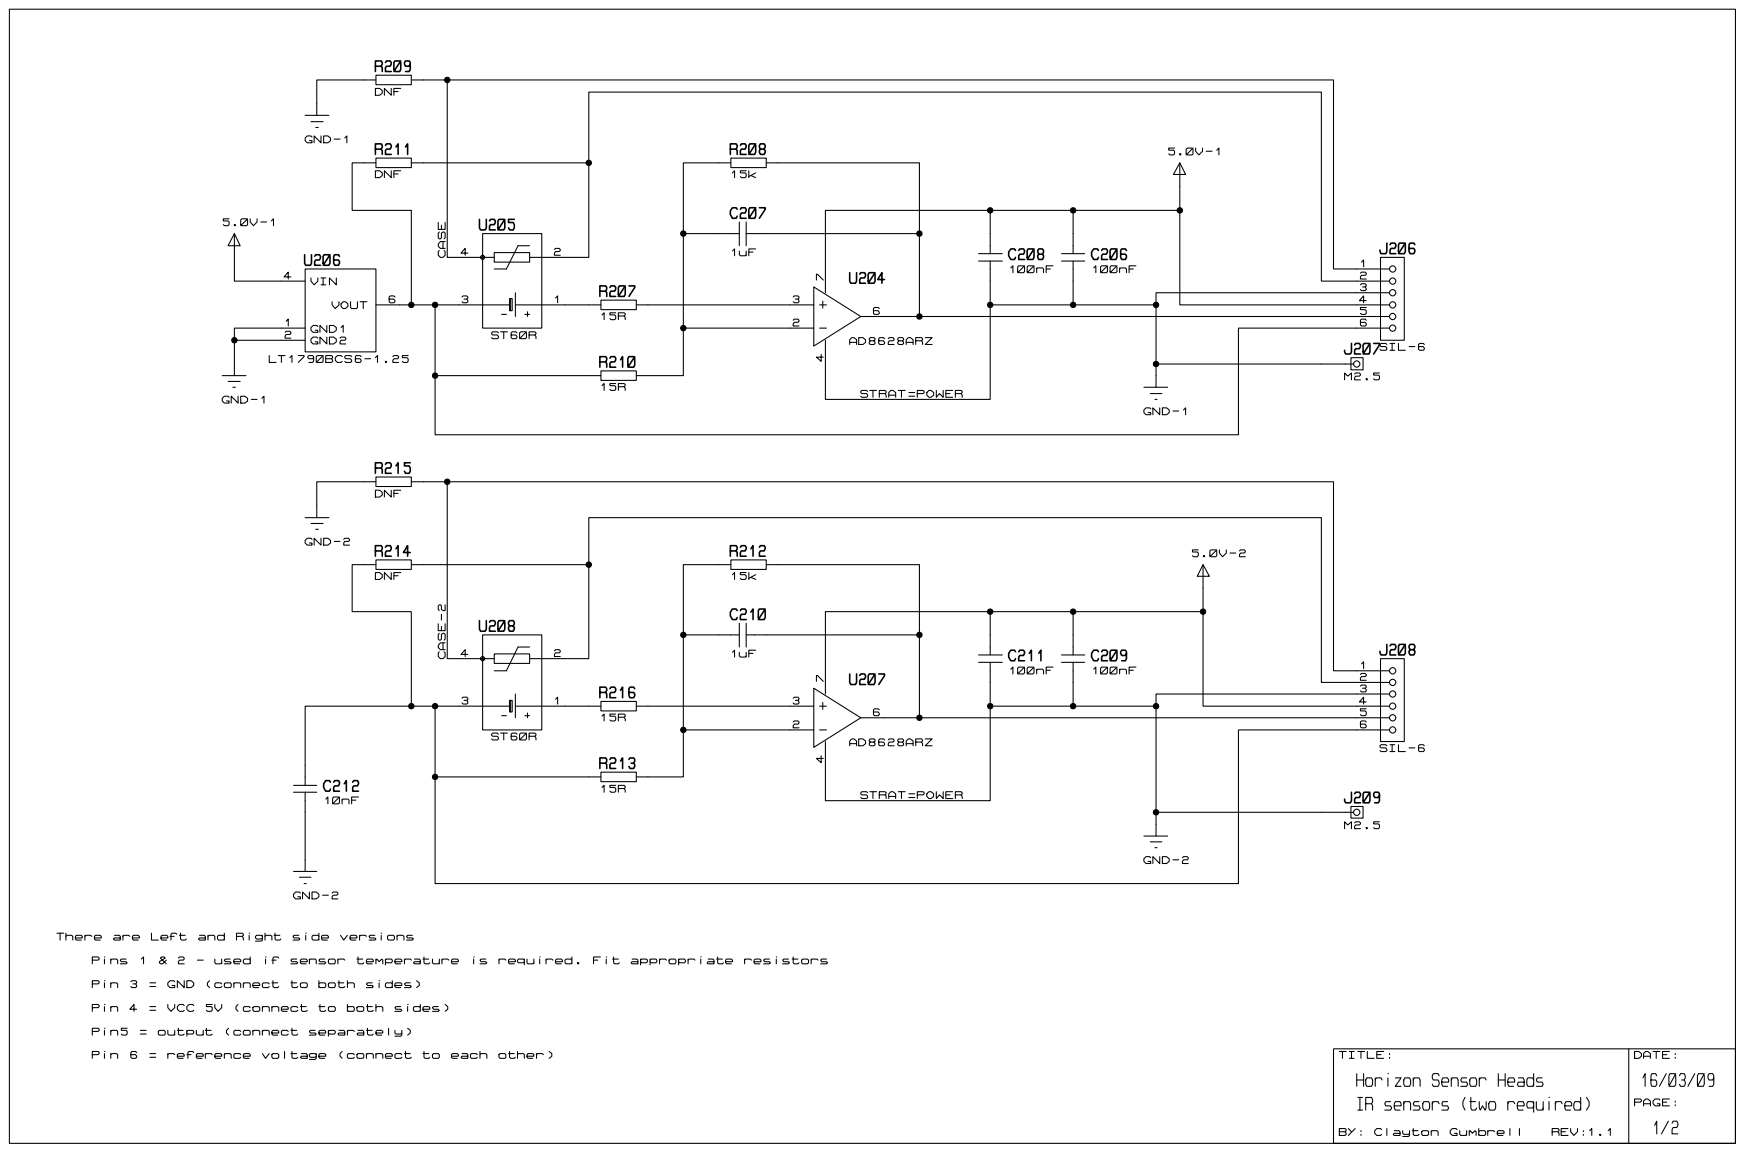
[picture p179: page 2]

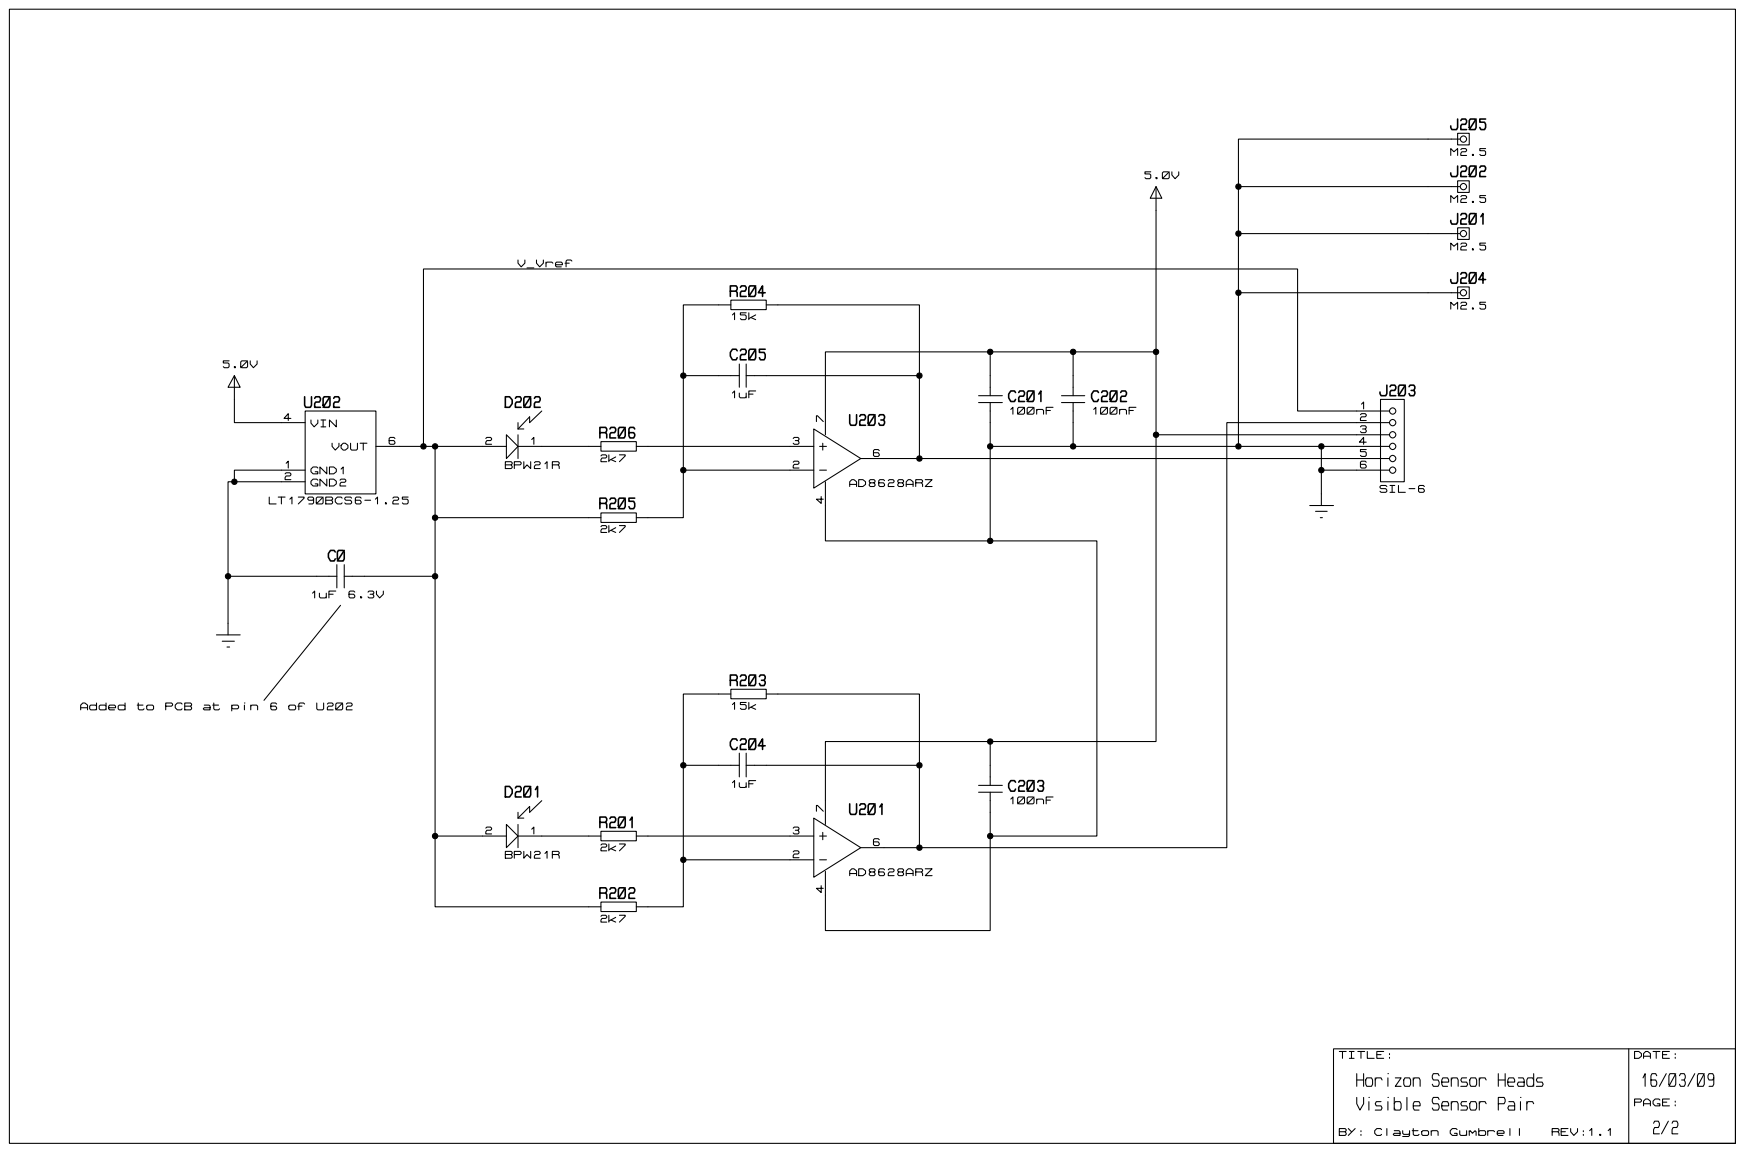
[picture p180: page 3]
