AMSAT-ZL/KiwiSAT_Sub-Systems/LBandDownConverter/LBandCon_V1_schematic.pdf

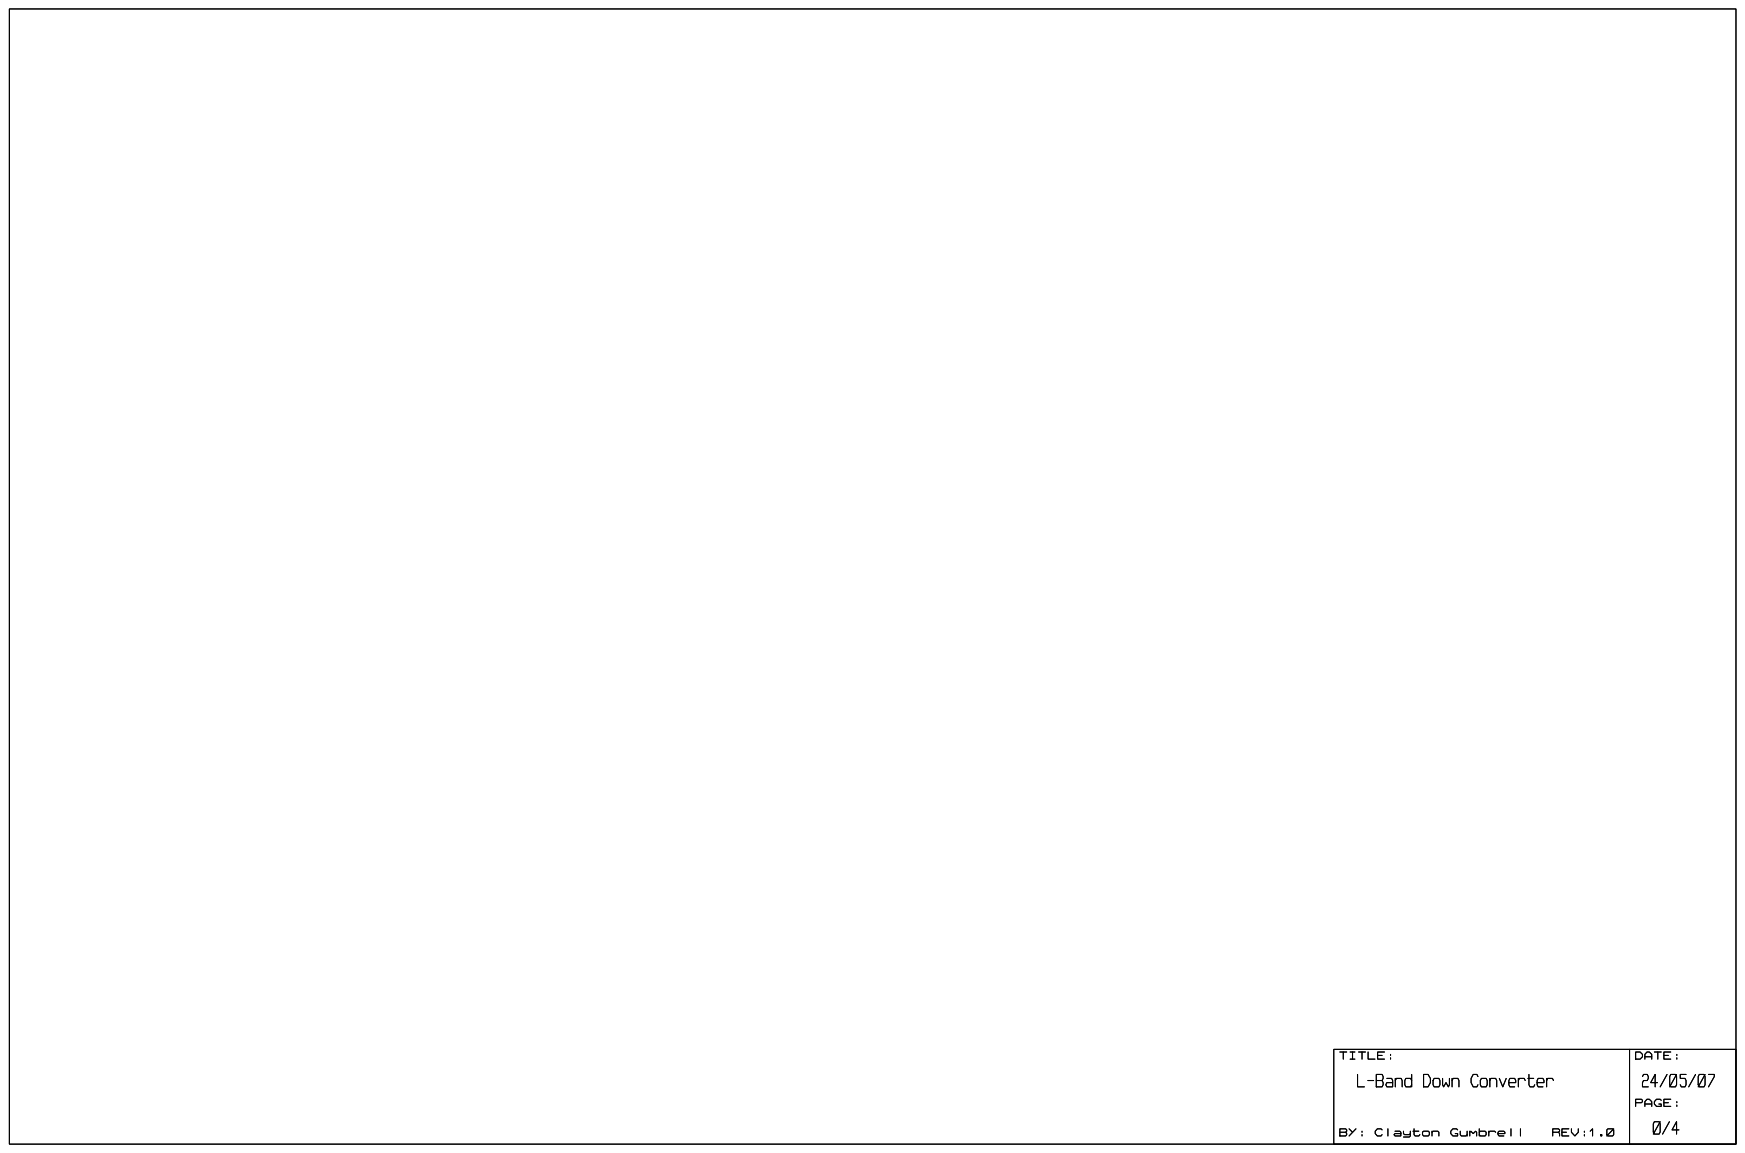
[picture p181: page 1]

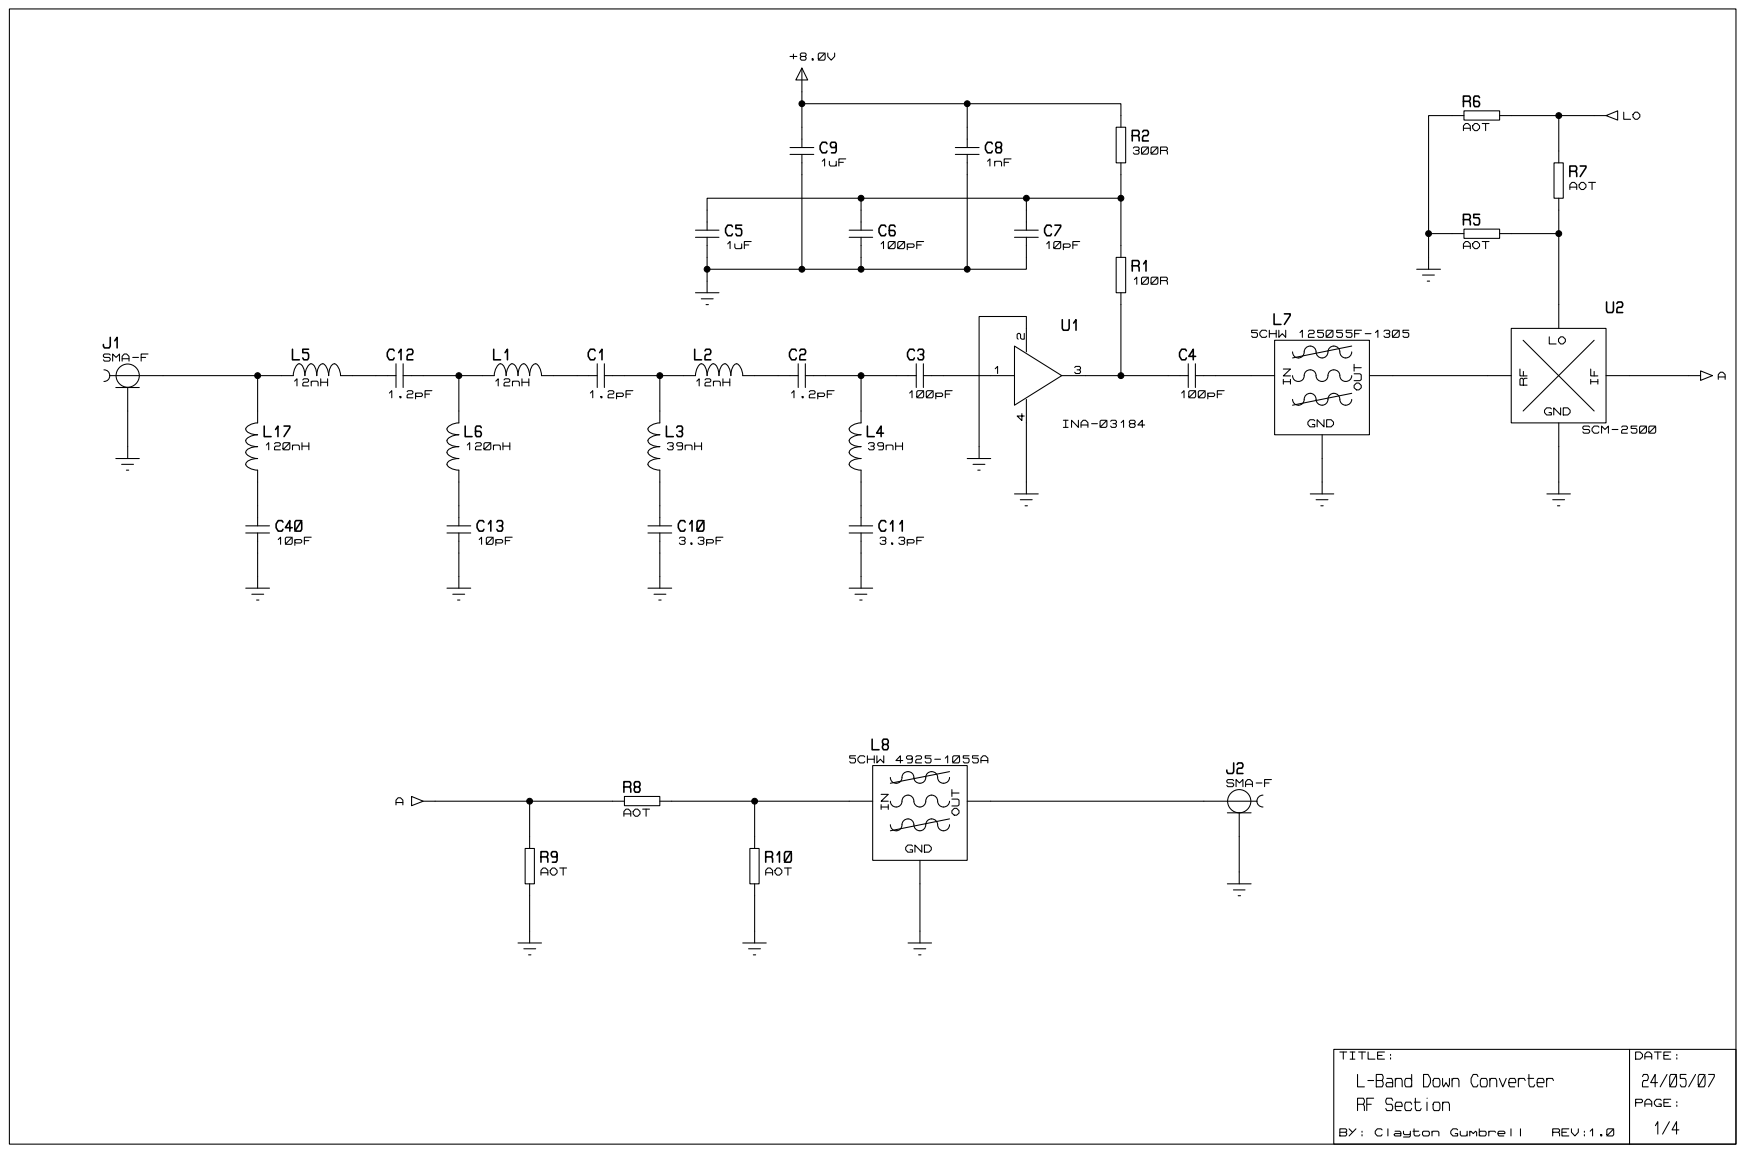
[picture p182: page 2]

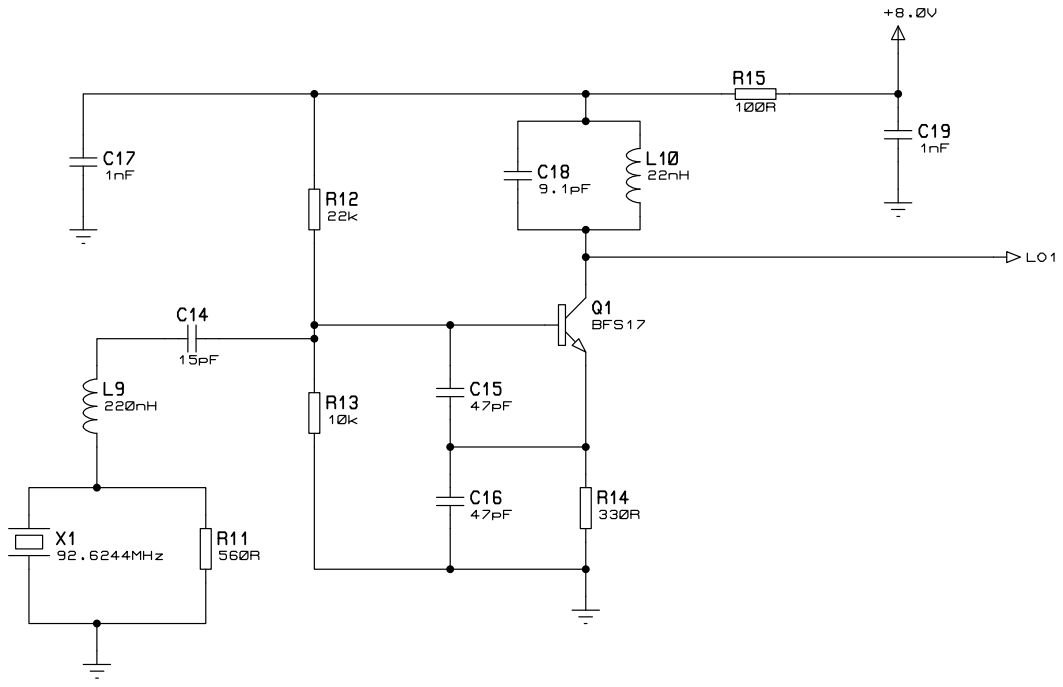
[picture p183: page 3]

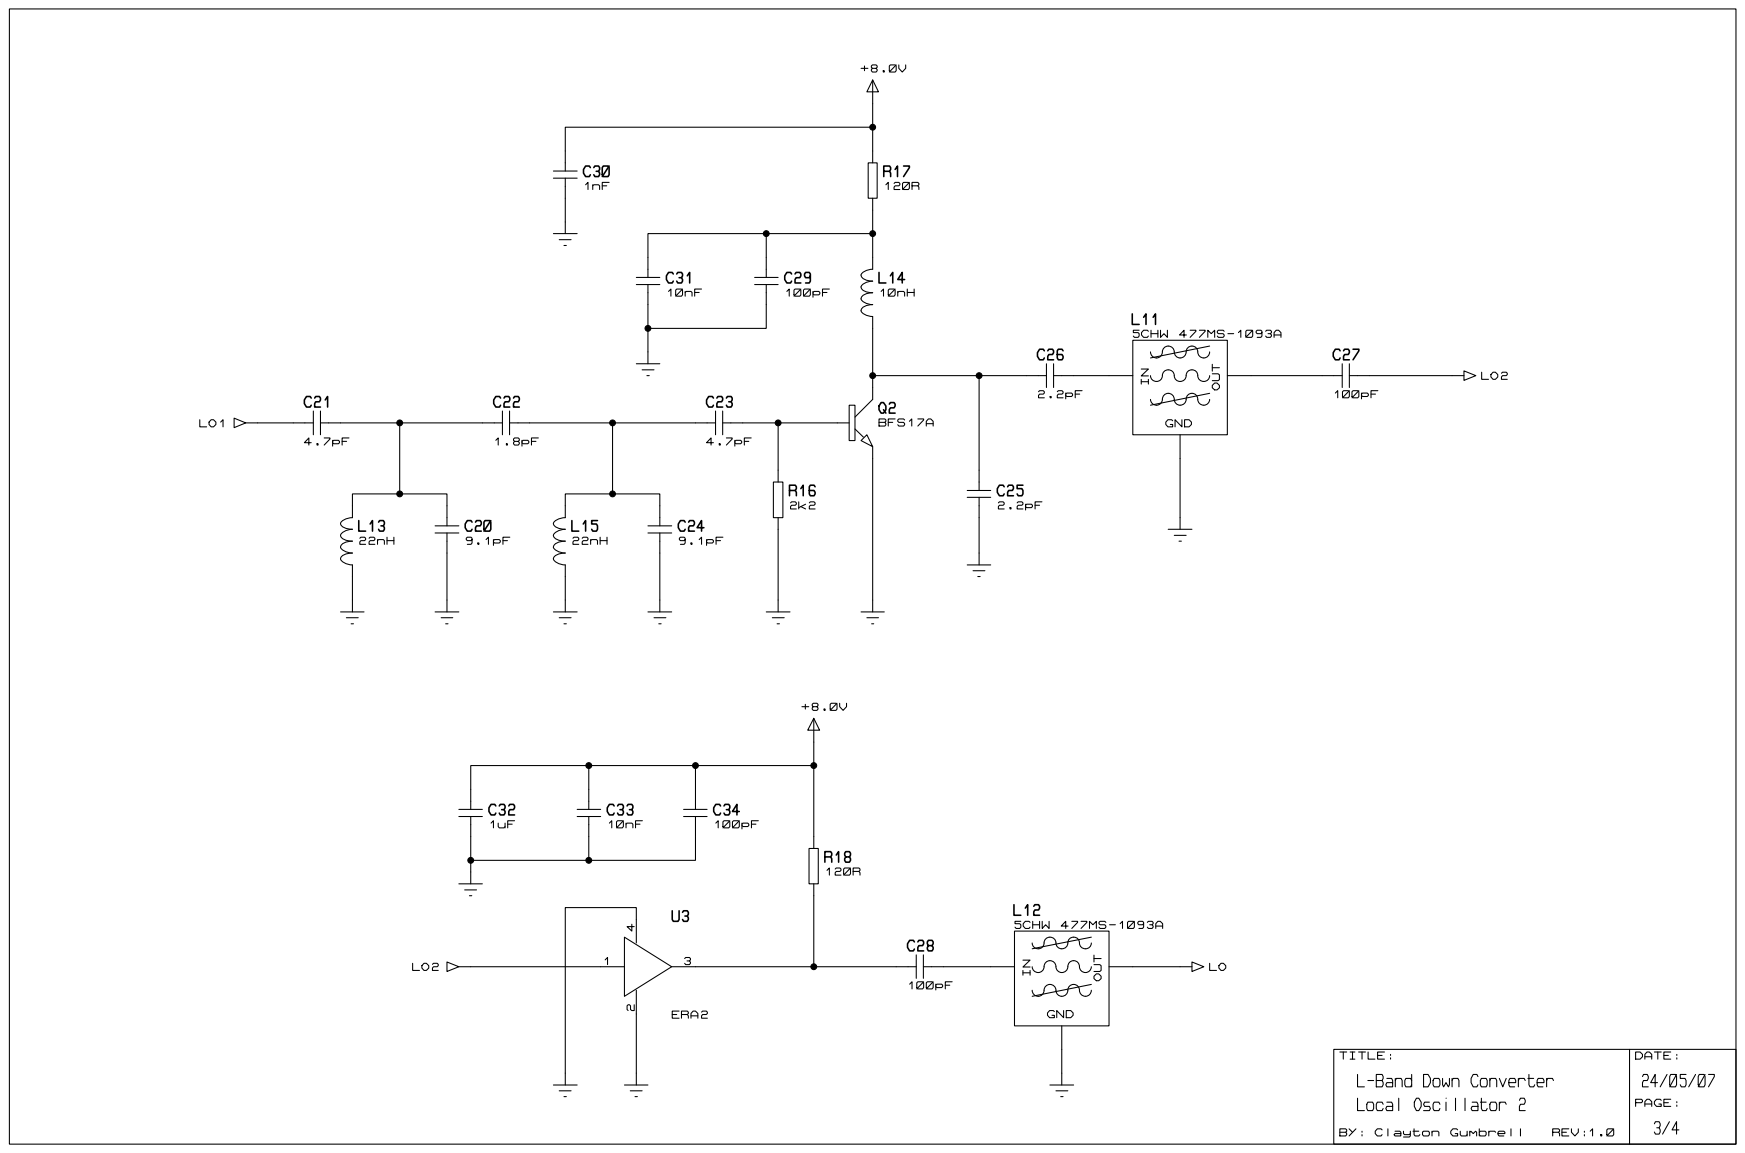
[picture p184: page 4]

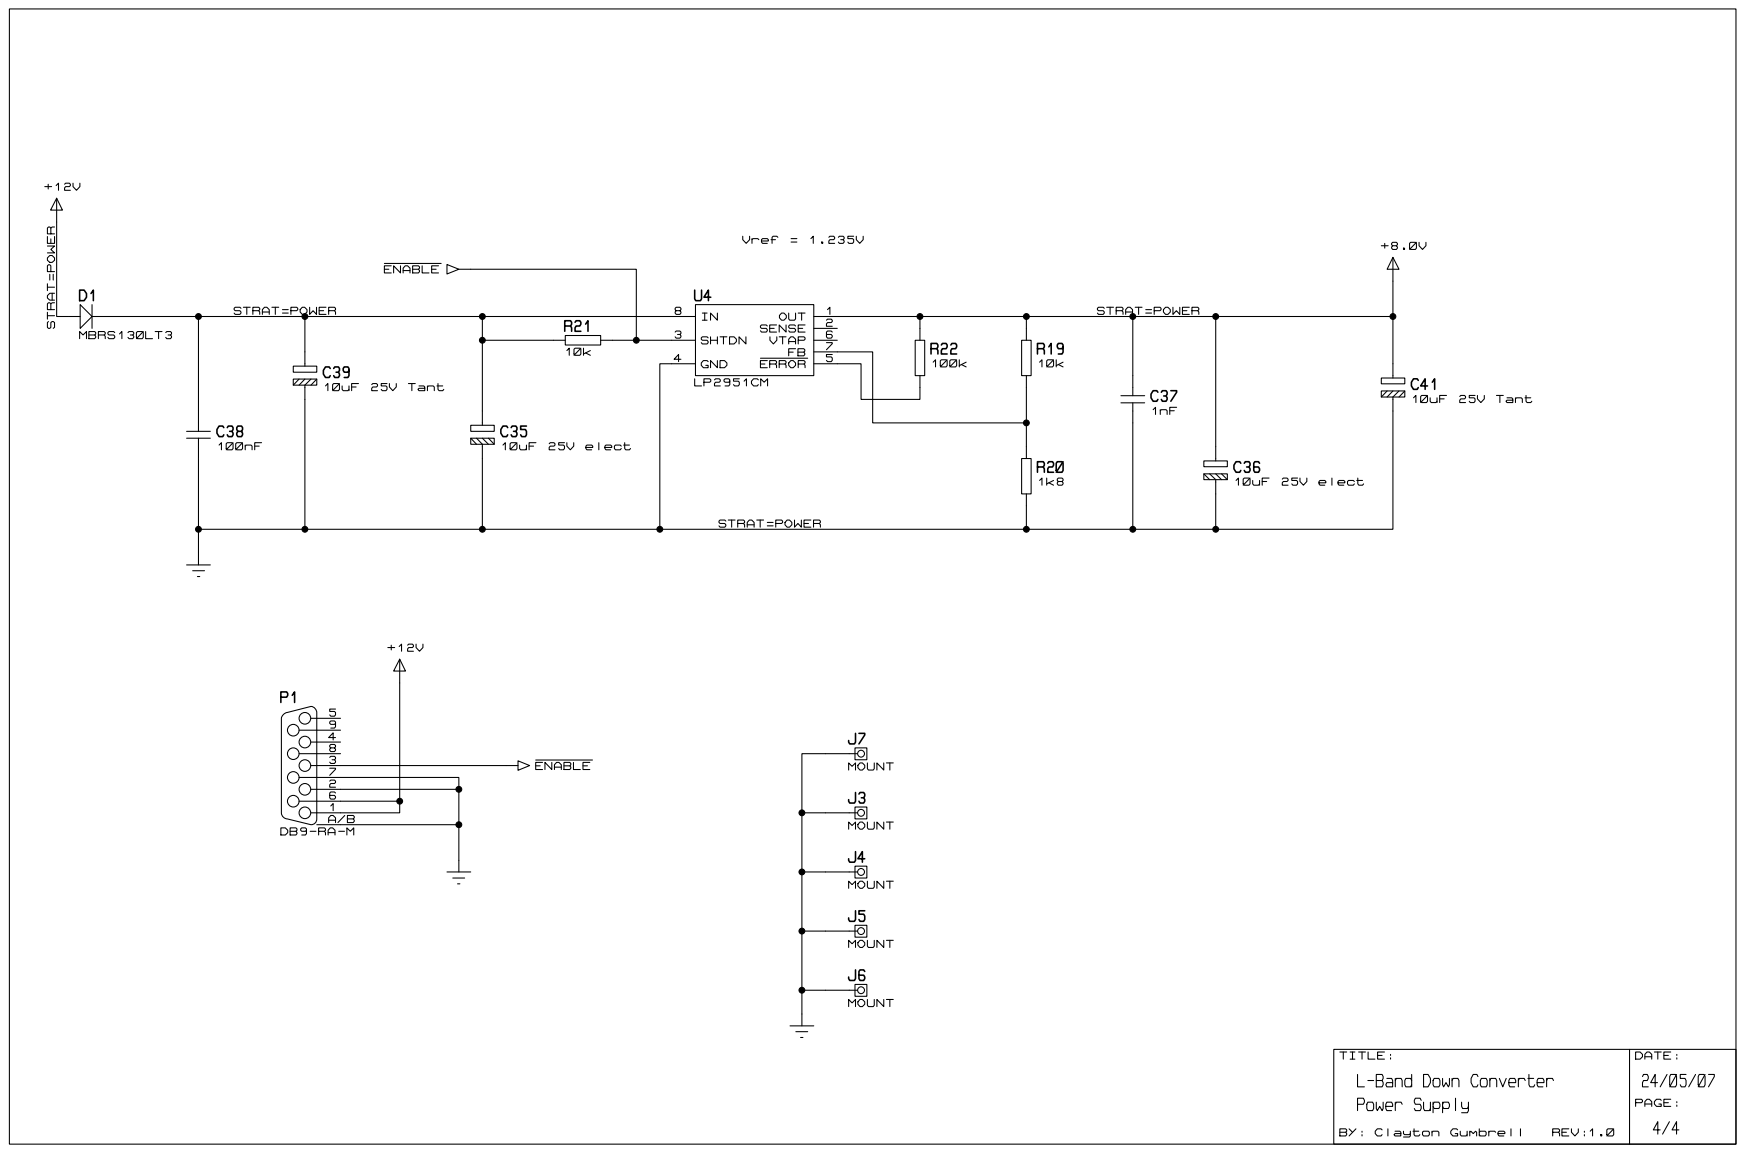
[picture p185: page 5]
