AMSAT-ZL/KiwiSAT_Sub-Systems/Magnetometer/Magnetometer_V10 mechanical.pdf

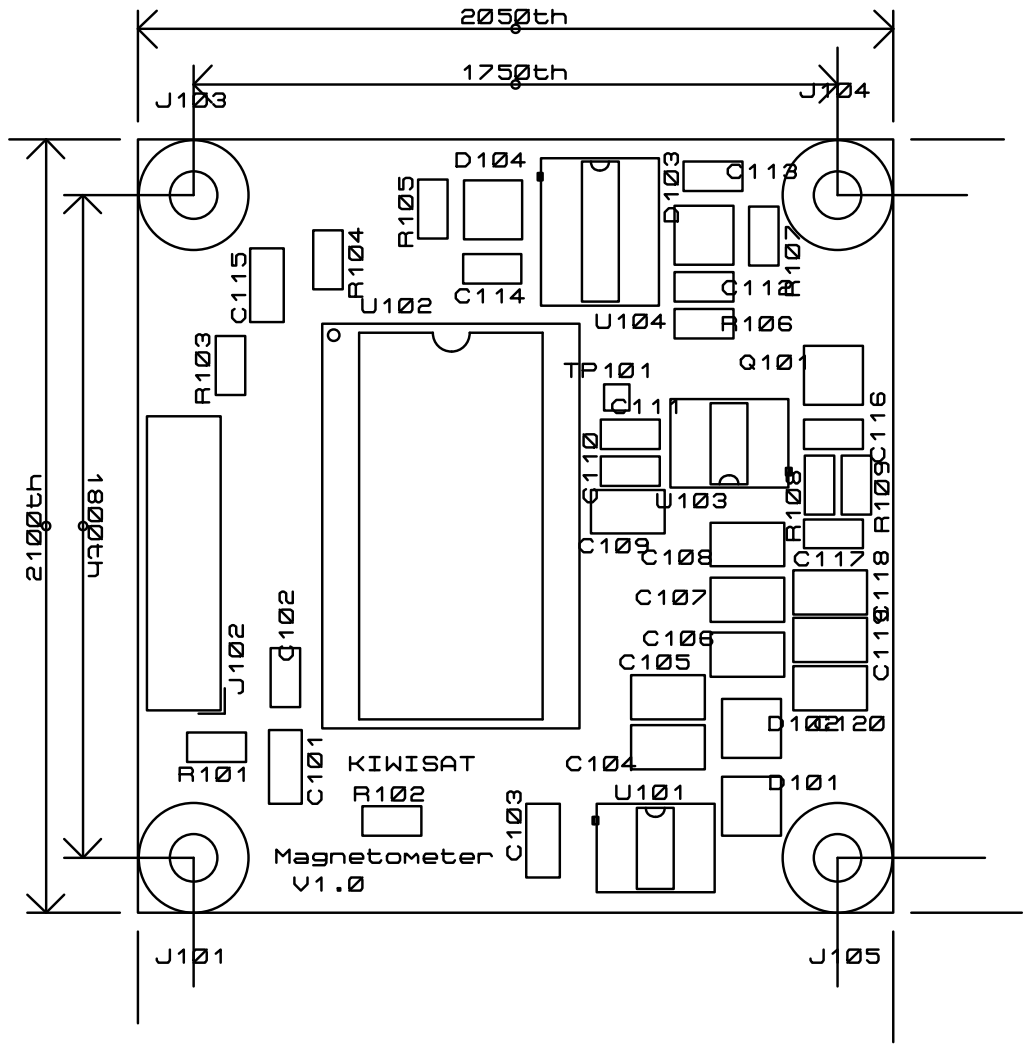
[picture p186: page 1]
