AMSAT-ZL/KiwiSAT_Sub-Systems/Magnetometer/Magnetometer_V10 schematic.pdf

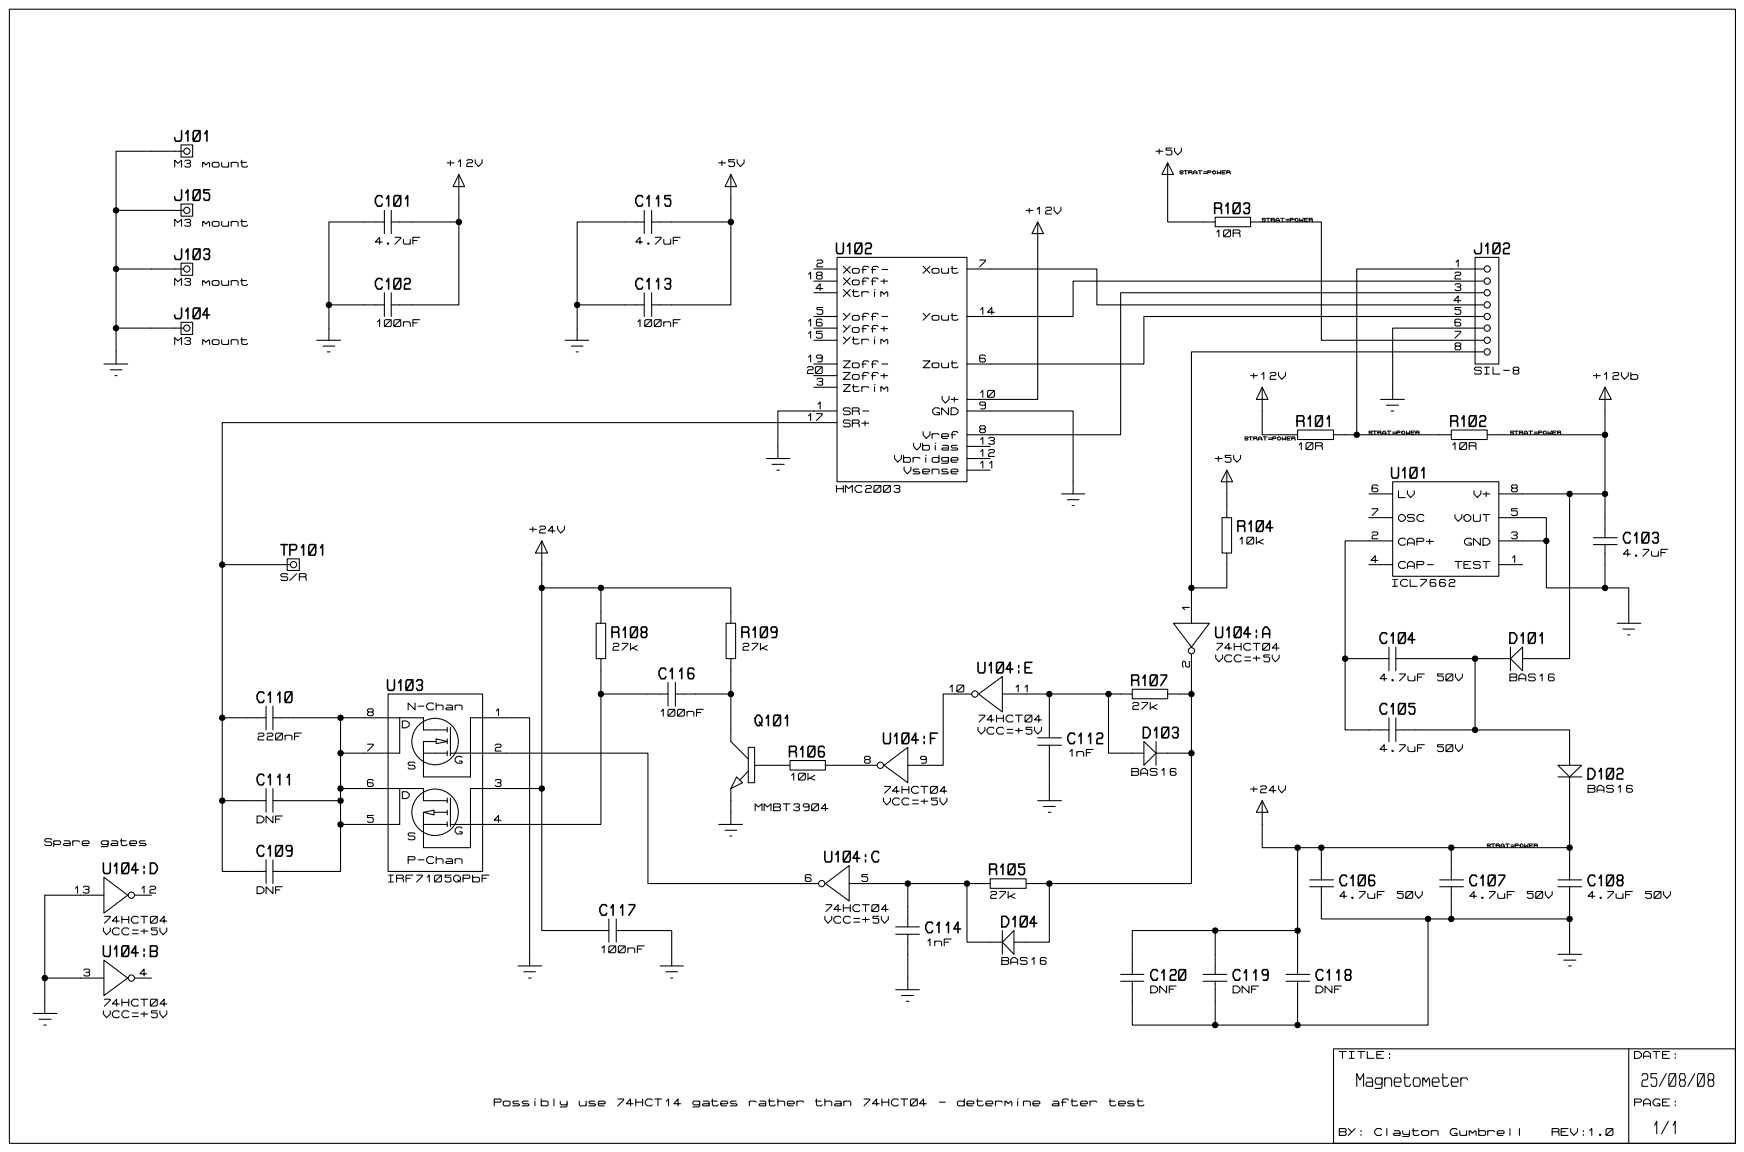
[picture p187: page 1]
