AMSAT-ZL/KiwiSAT_Sub-Systems/Sun_Sensor/SunSensor_V1 mechanical.pdf

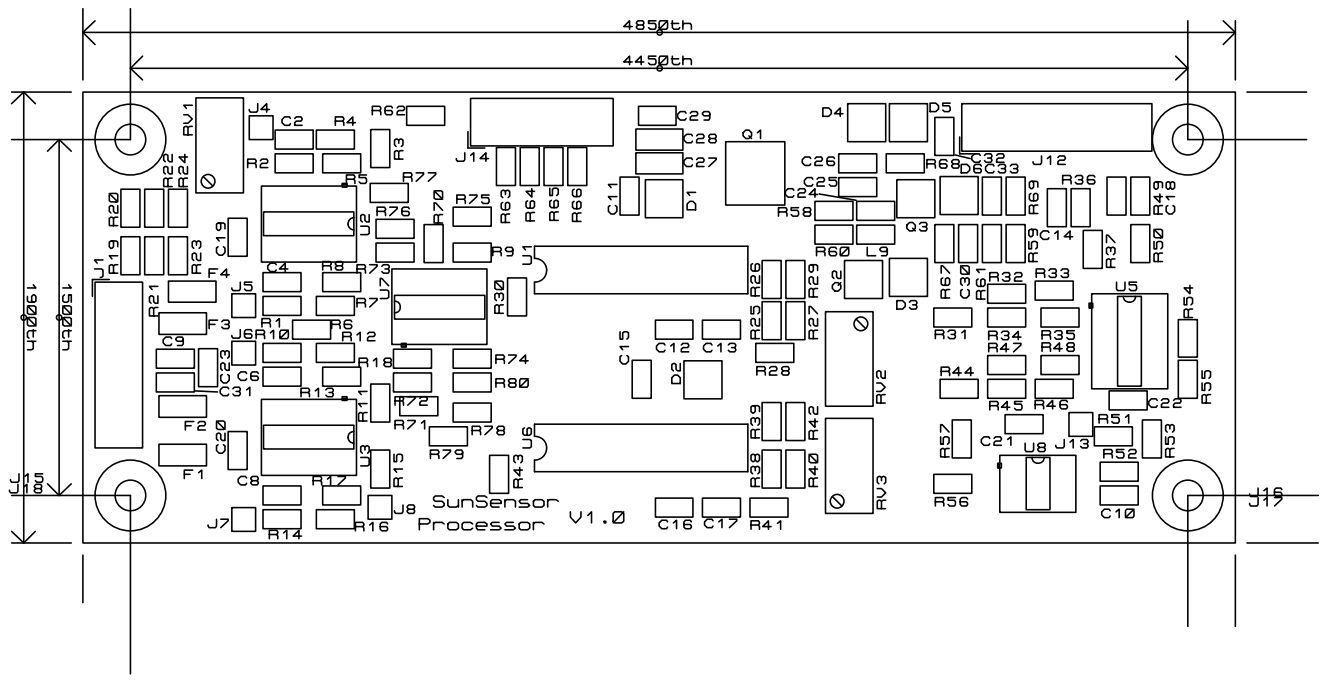
[picture p193: page 1]
