AMSAT-ZL/KiwiSAT_Sub-Systems/Sun_Sensor/SunSensor_V1 schematic.pdf

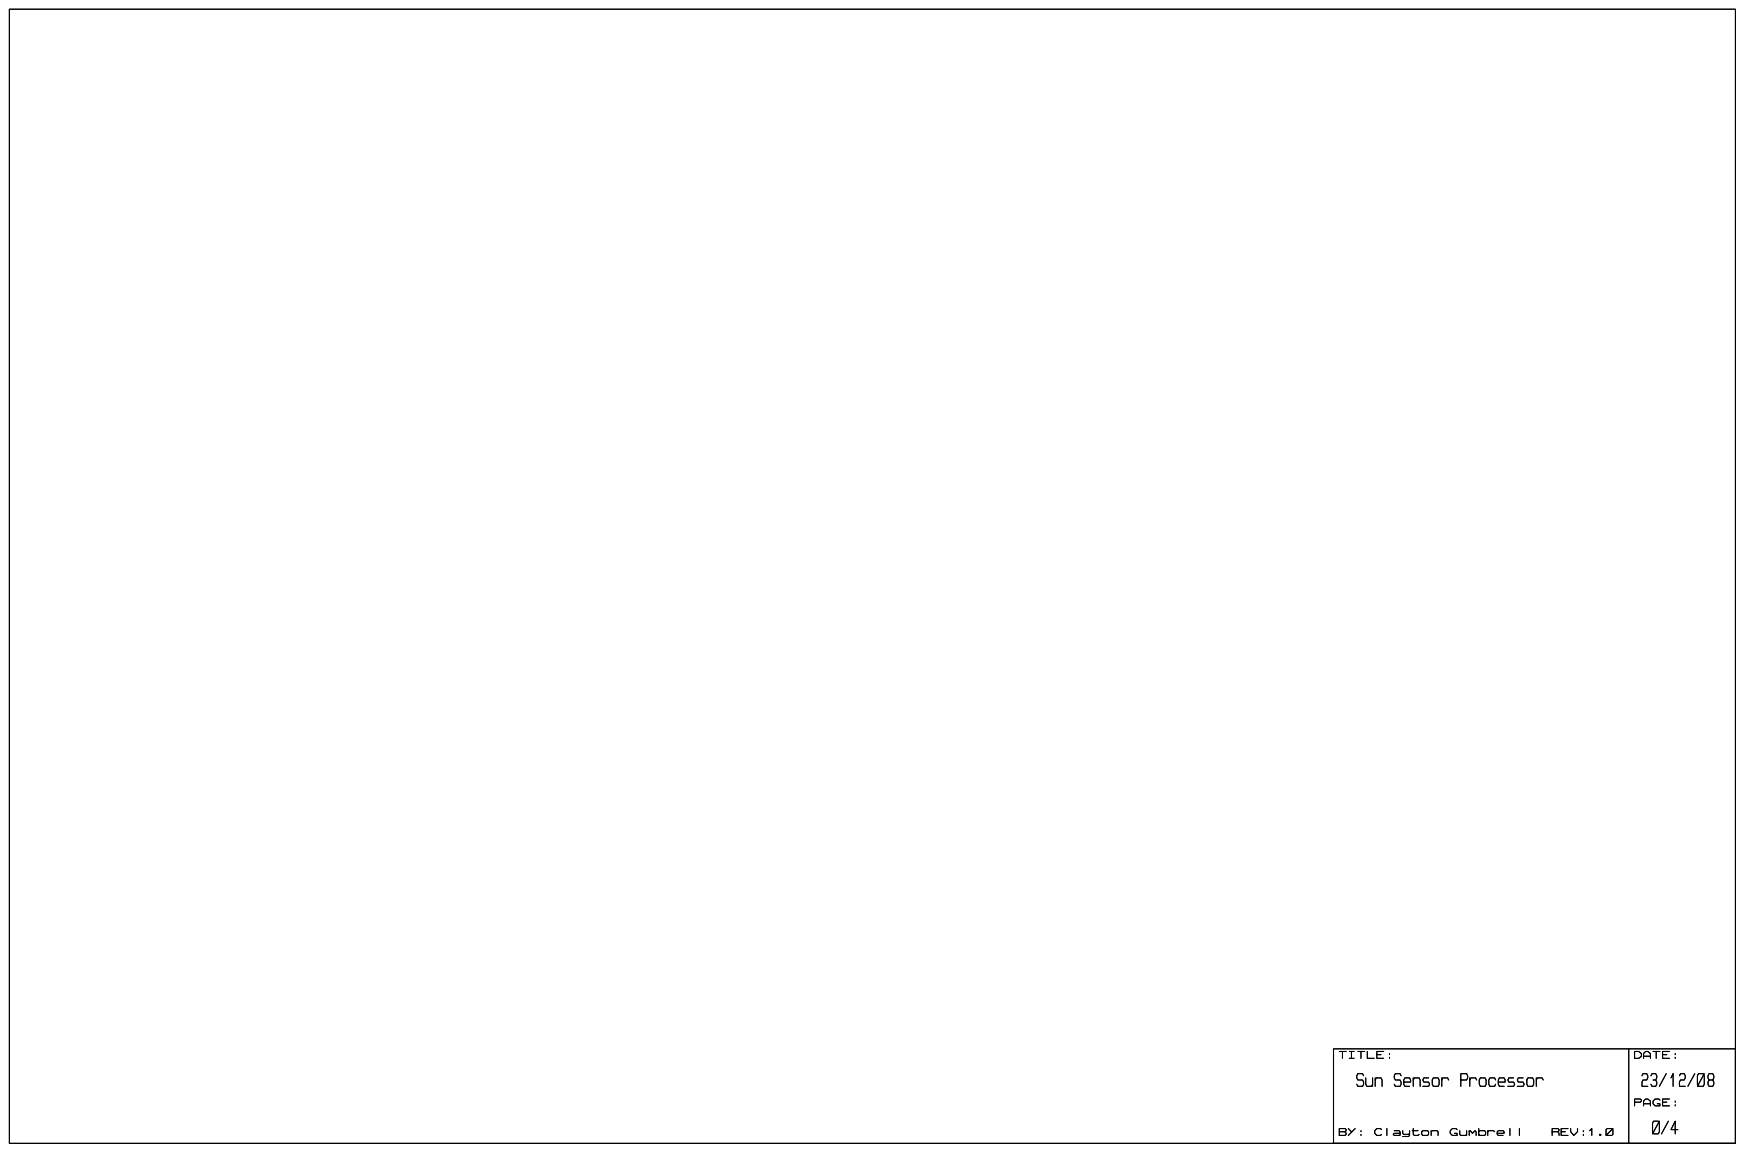
[picture p194: page 1]

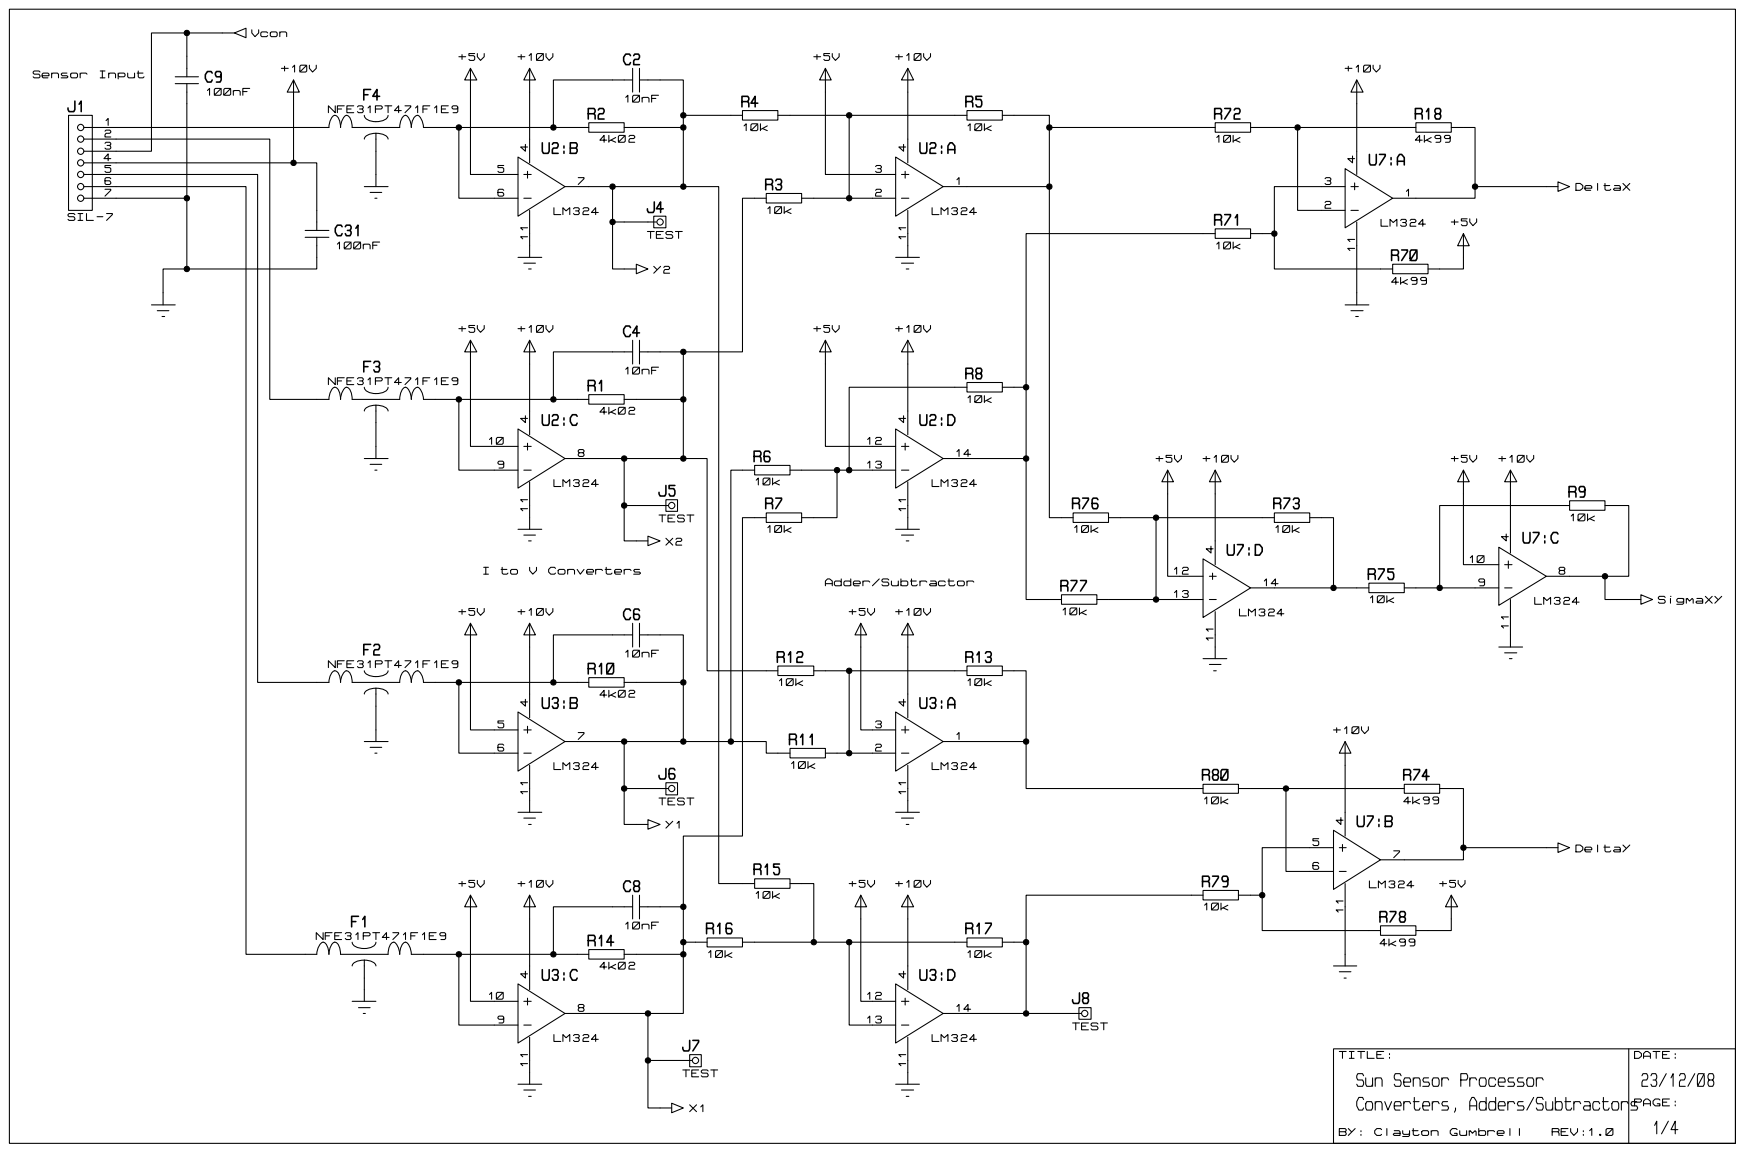
[picture p195: page 2]

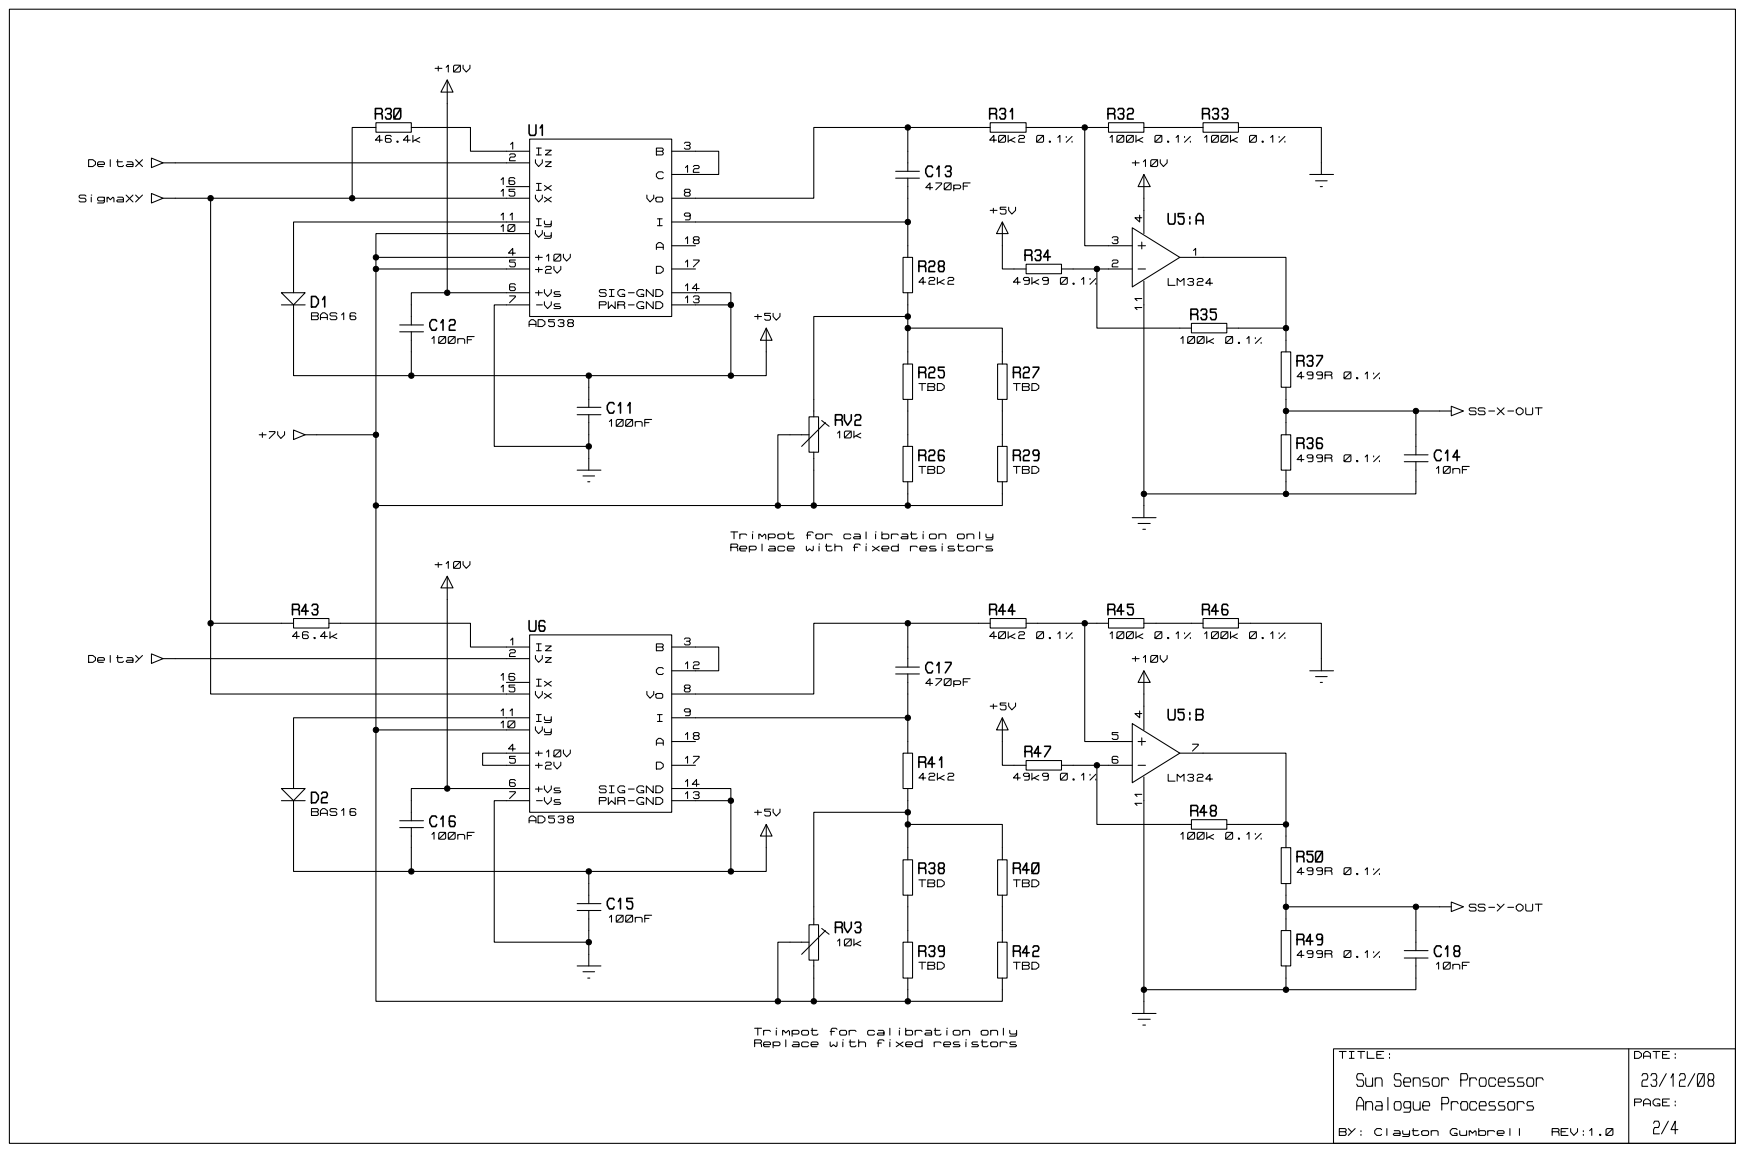
[picture p196: page 3]

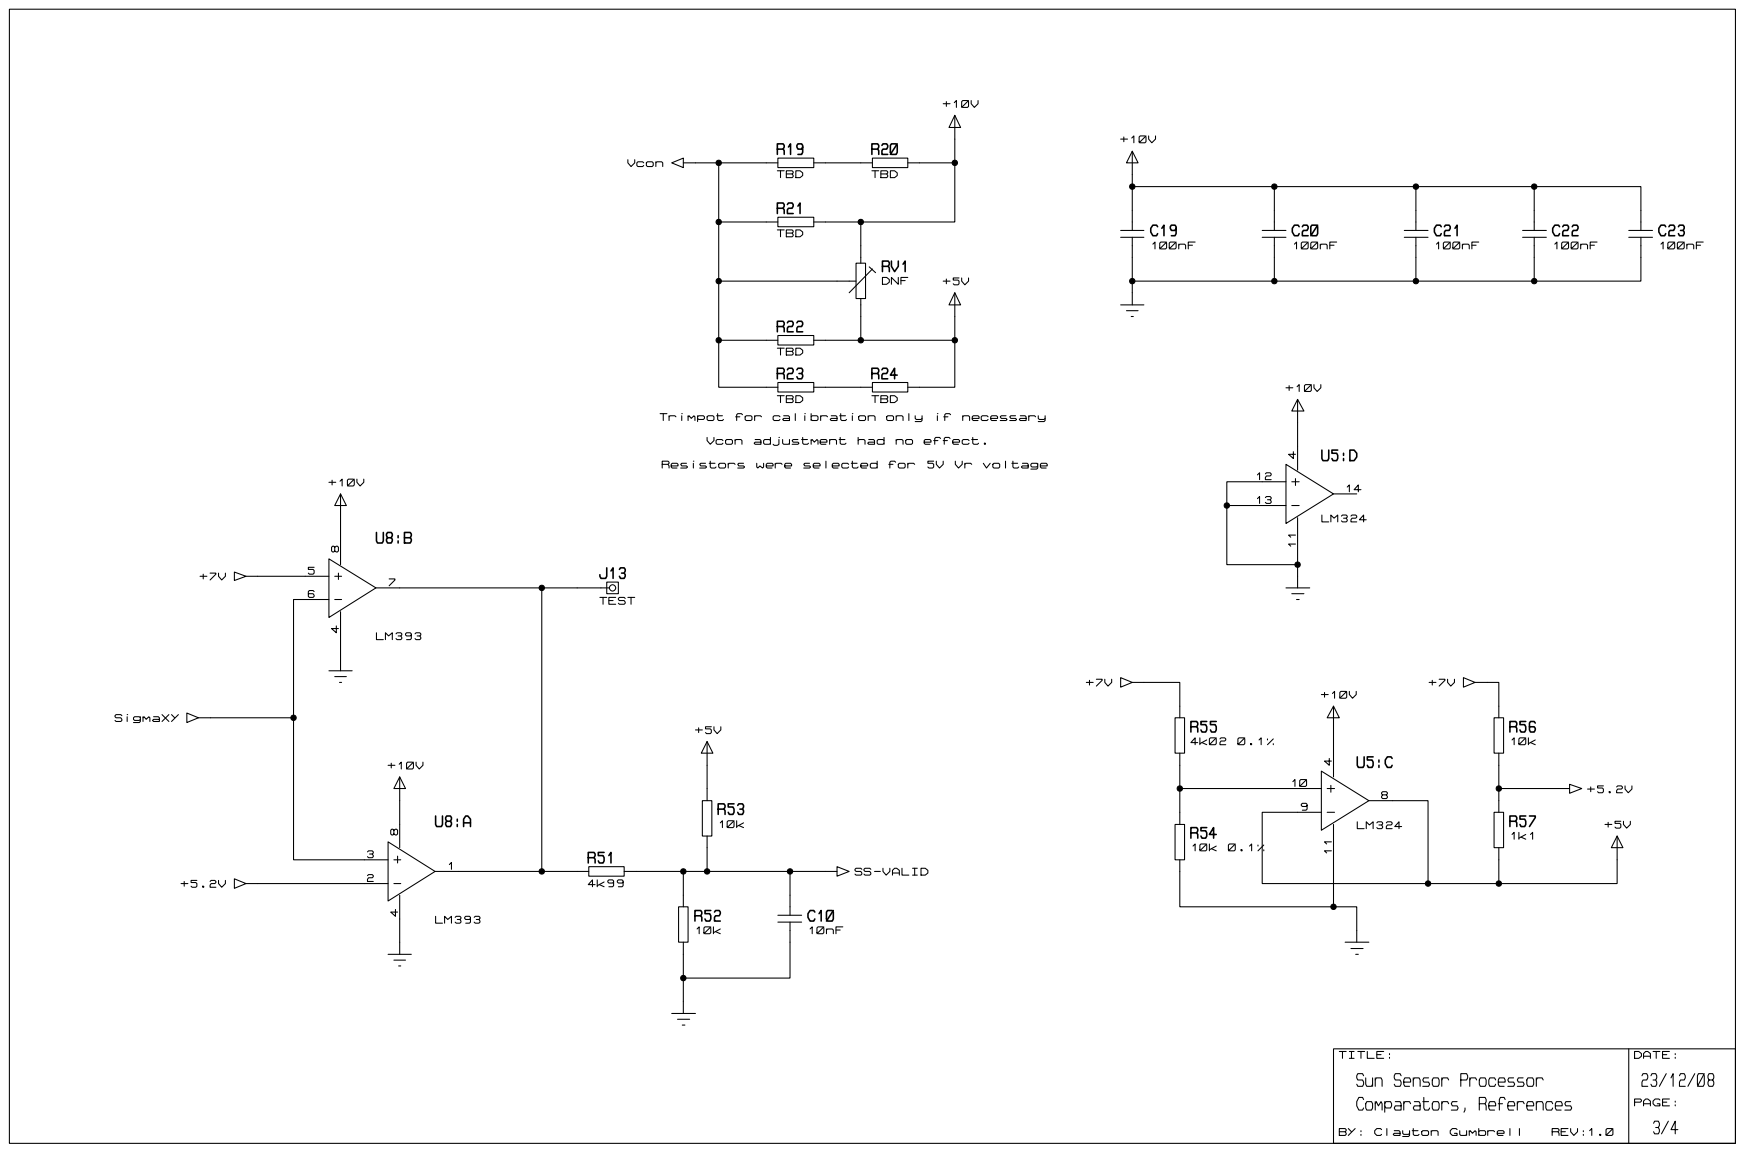
[picture p197: page 4]

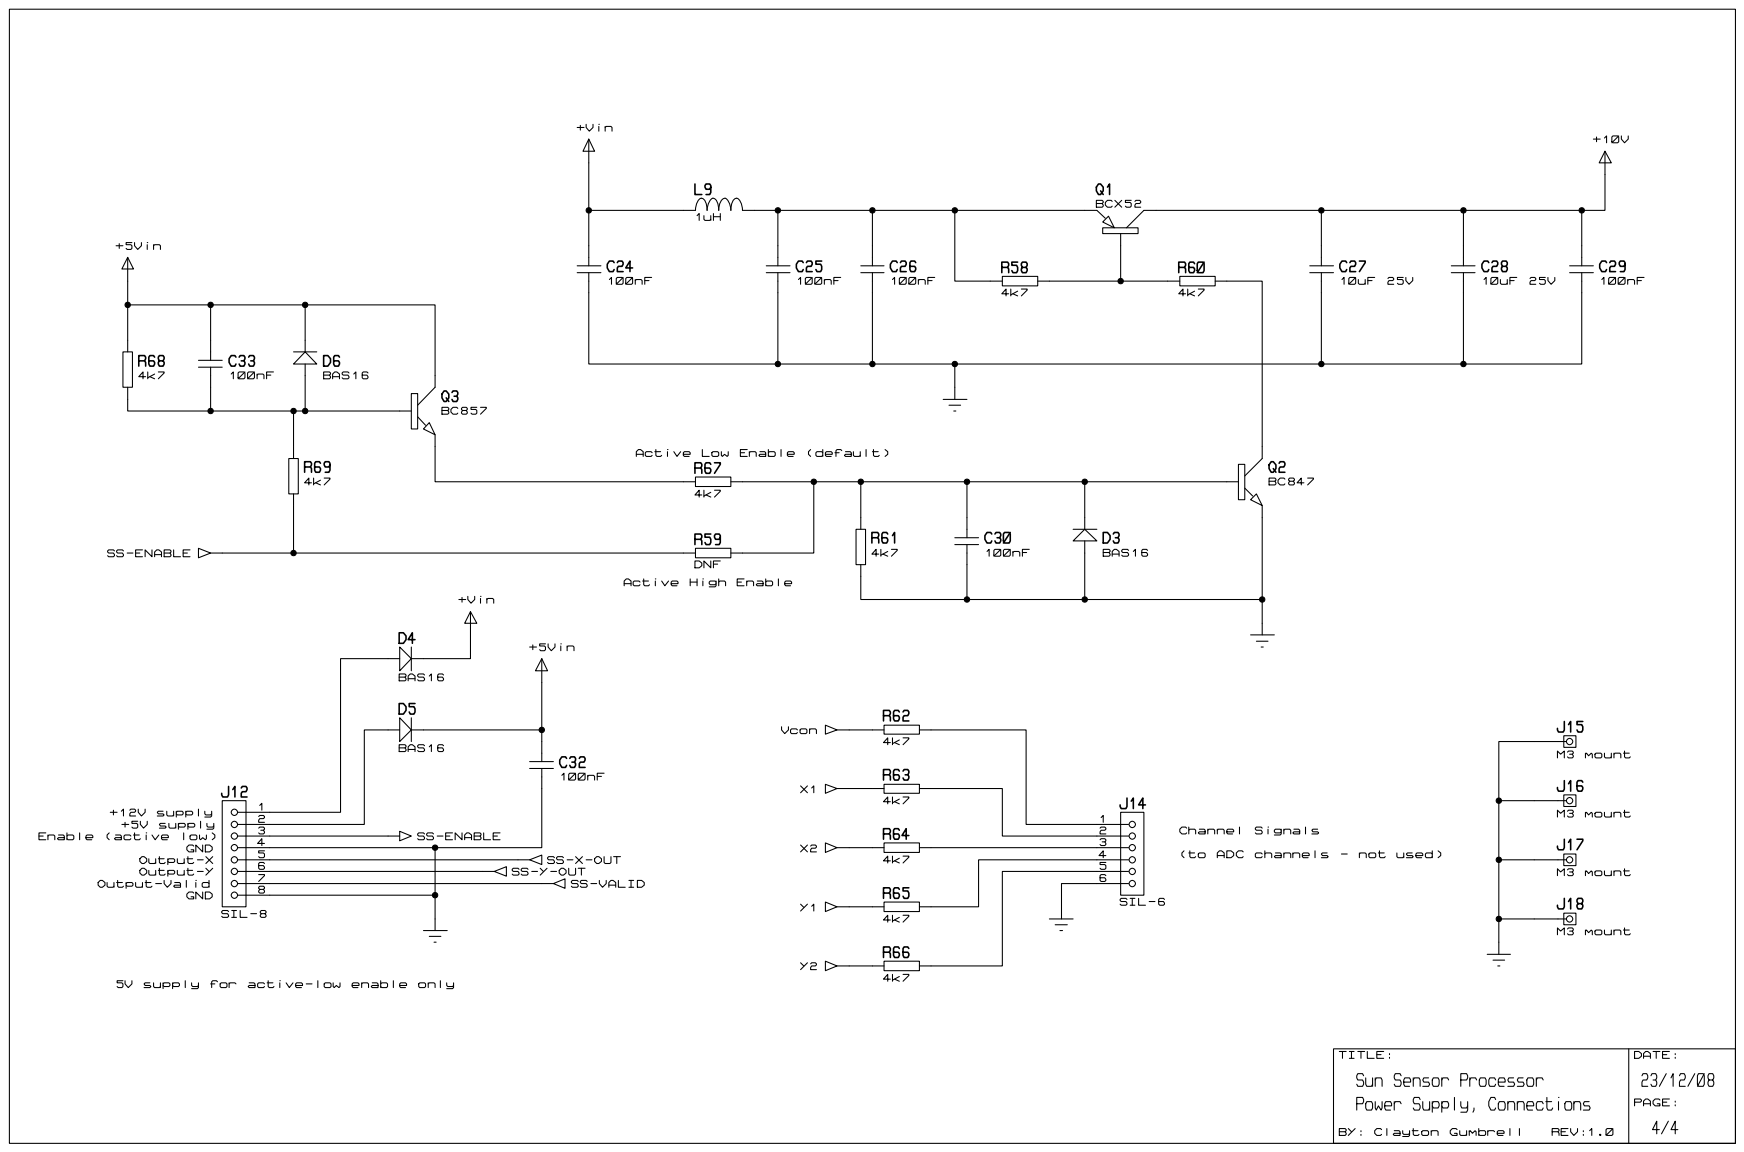
[picture p198: page 5]
