AMSAT-ZL/KiwiSAT_Sub-Systems/FM_Receivers/2008-02-28 Assembly instructions and BOM/UHF-FM-RX3.pdf

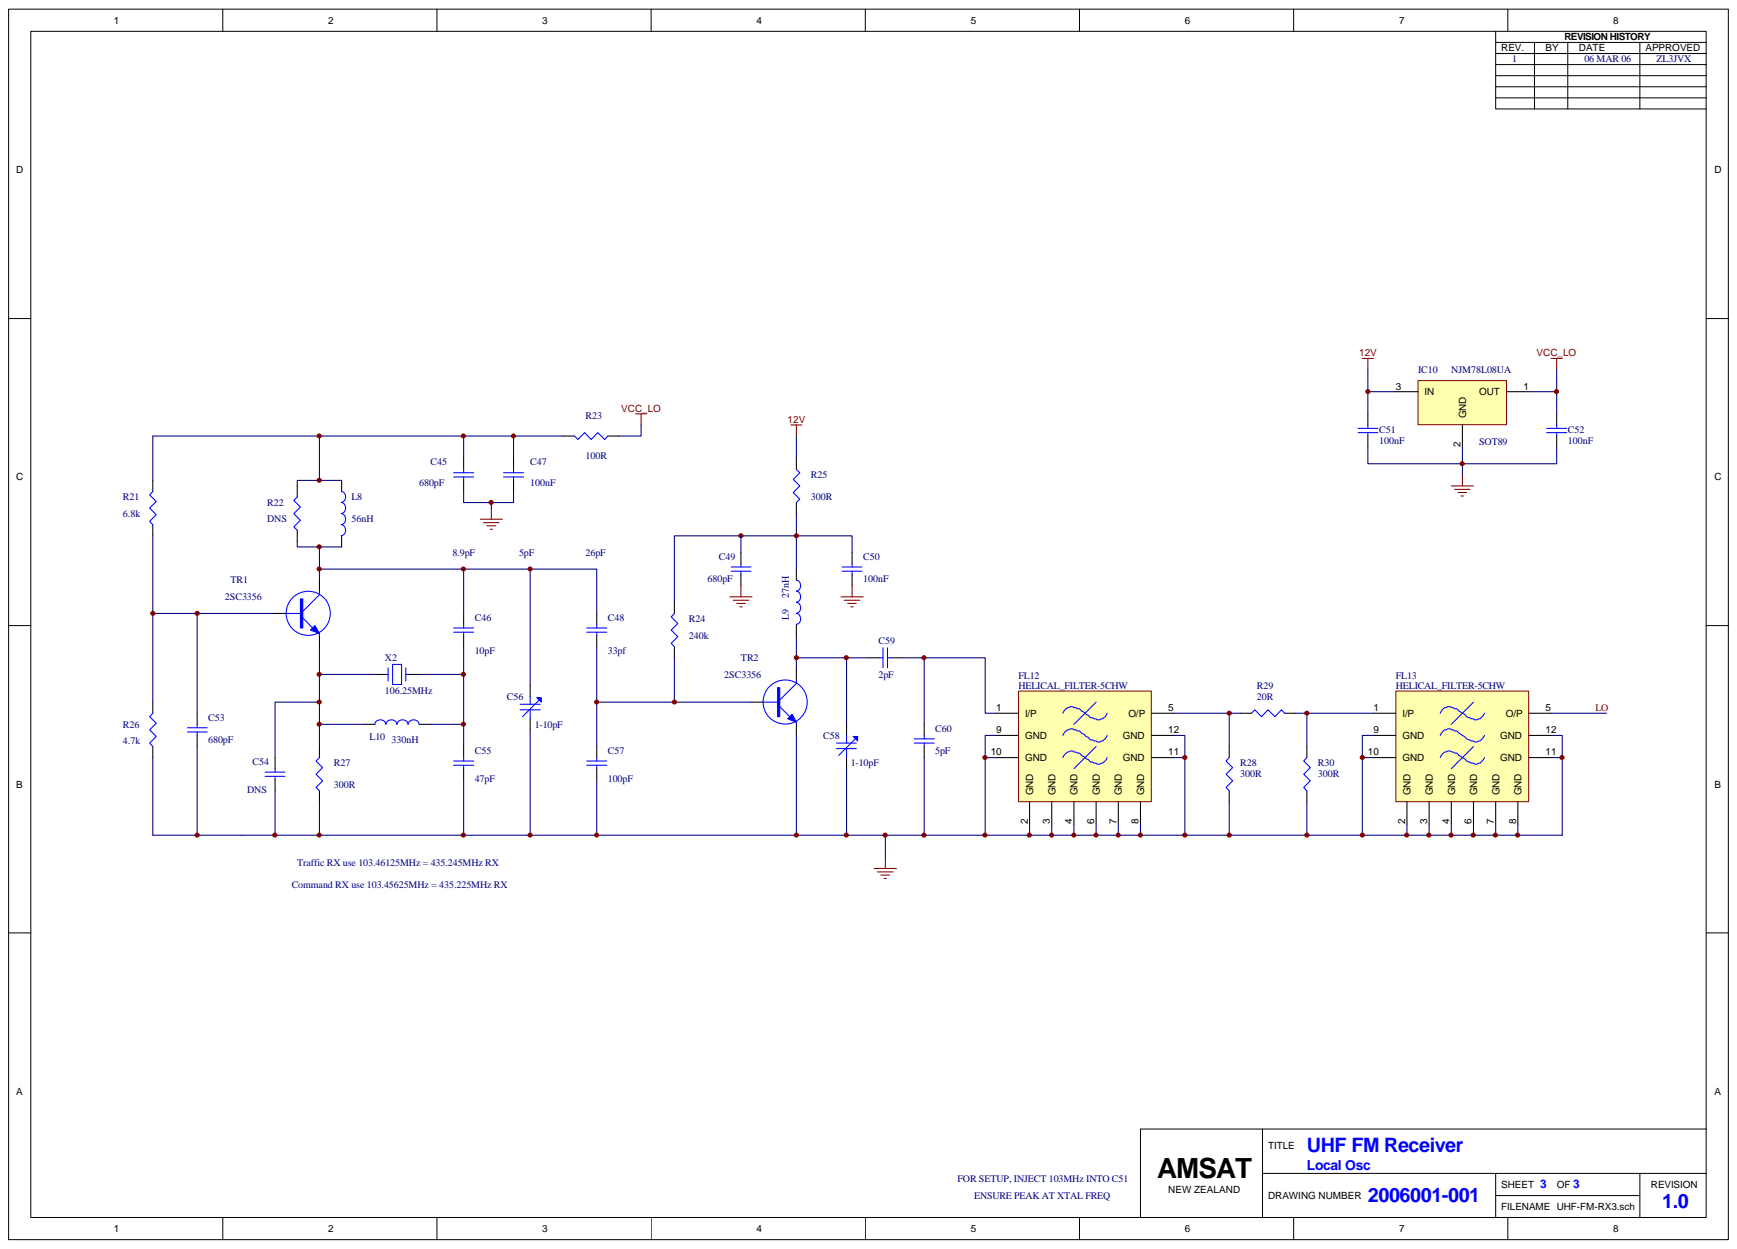
[picture p199: page 1]

Traffic RX use 103.46125MHz = 435.245MHz RX

Command RX use 103.45625MHz = 435.225MHz RX

FOR SETUP, INJECT 103MHz INTO C51
ENSURE PEAK AT XTAL FREQ

FILENAME UHF-FM-RX3.sch
