AMSAT-ZL/KiwiSAT_Sub-Systems/FM_Receivers/Gerbers for UHF-FM-RX/Fabrication UHF FM Rx.pdf

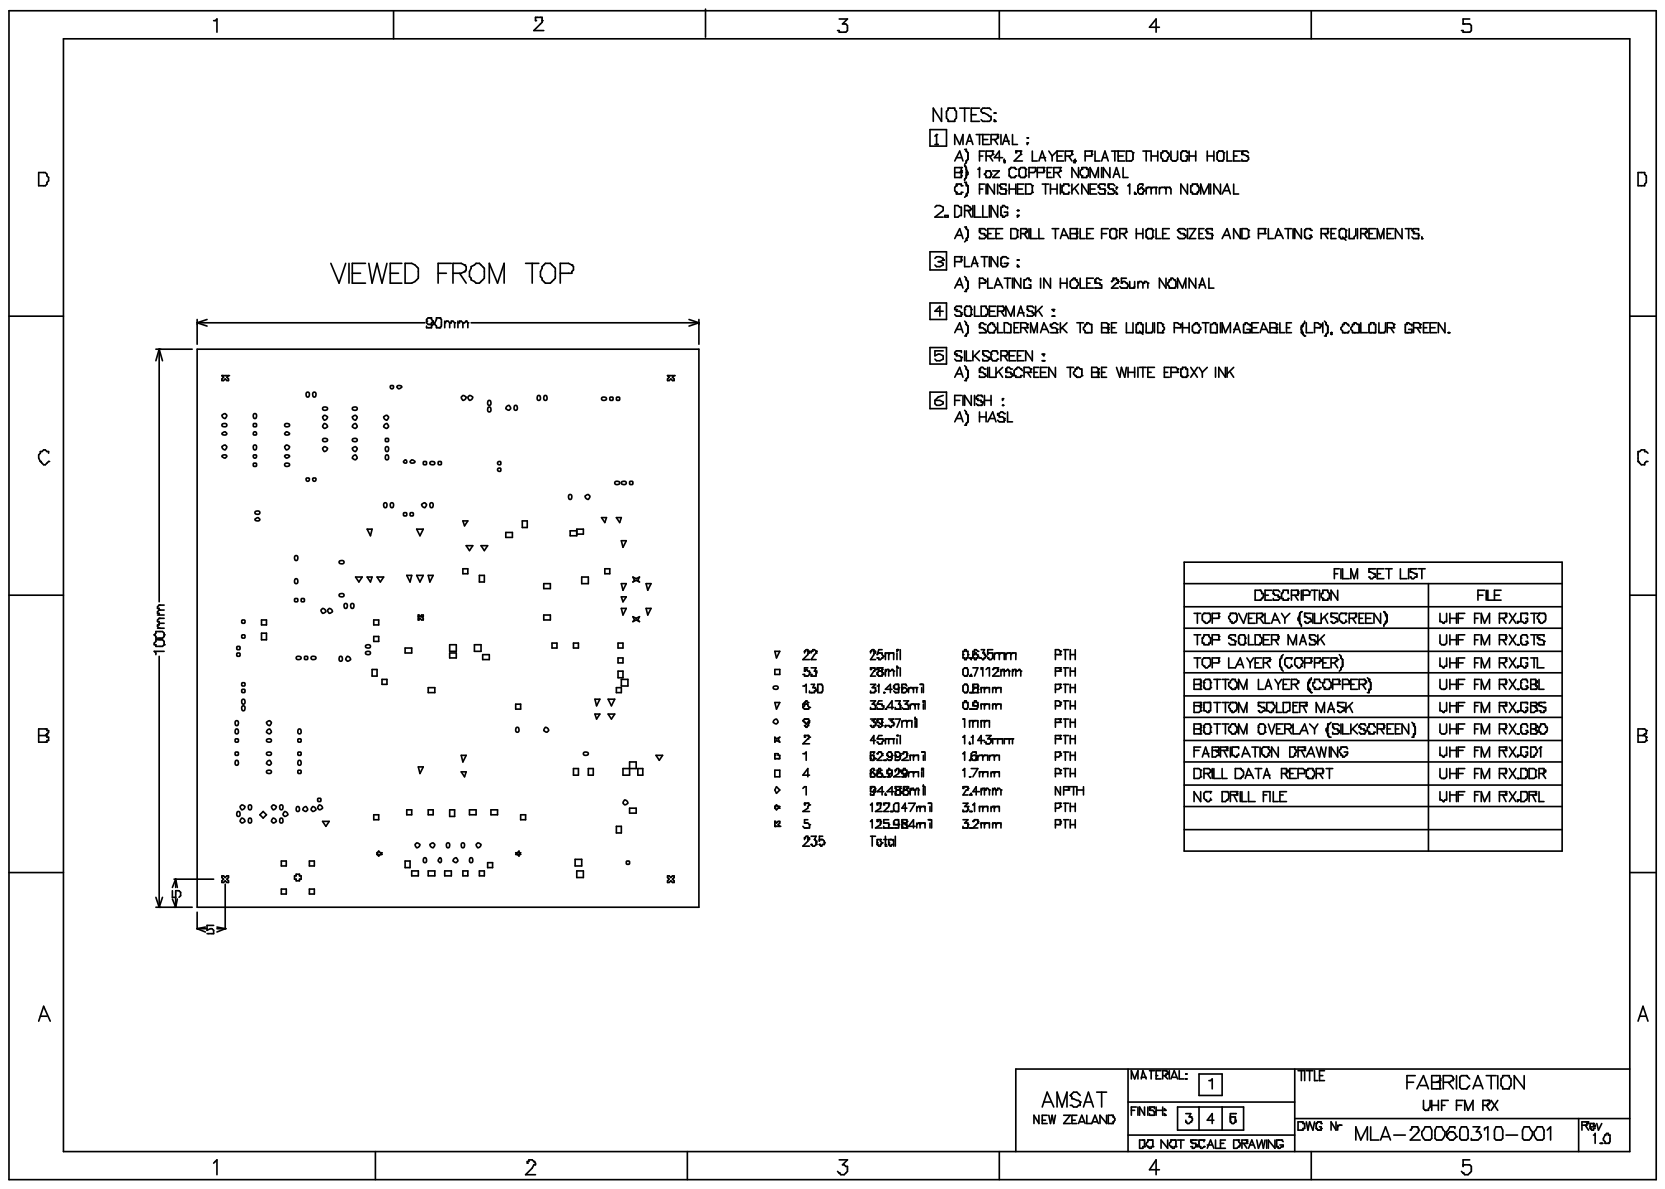
[picture p200: page 1]
