AMSAT-ZL/KiwiSAT_Sub-Systems/GPS/LatimerGPS/Assembly_layer1.pdf

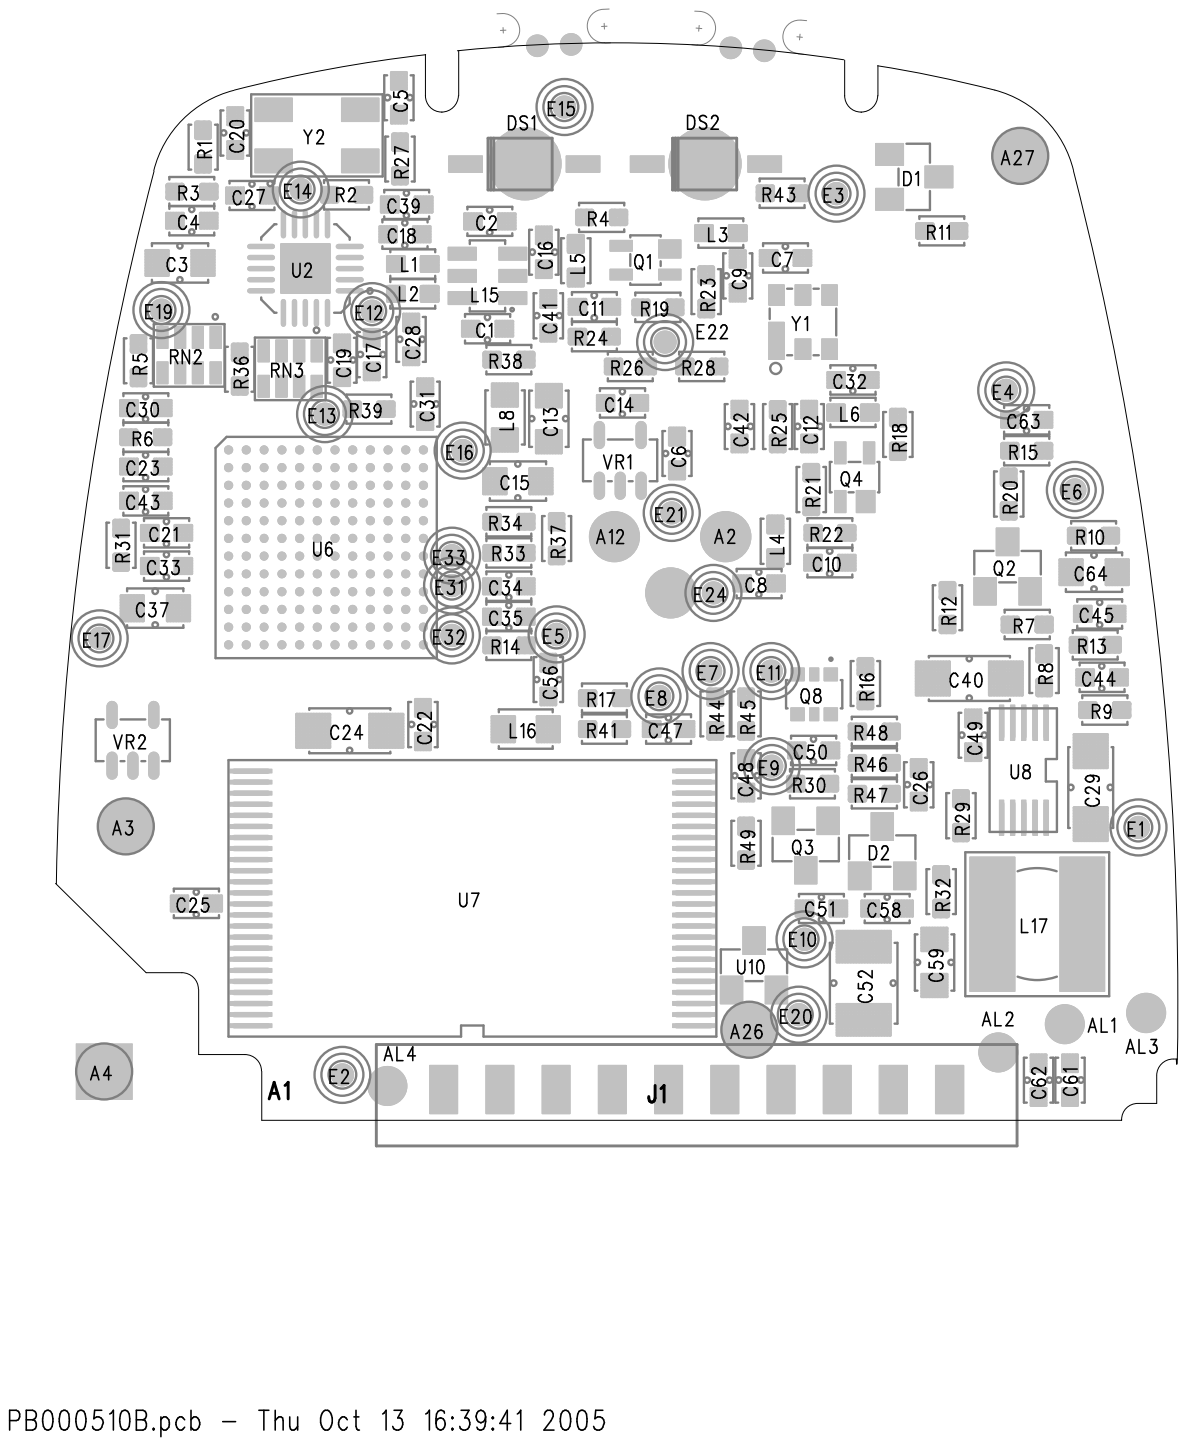
[picture p202: page 1]
