AMSAT-ZL/KiwiSAT_Sub-Systems/GPS/LatimerGPS/Assembly_layer4_mirrored.pdf

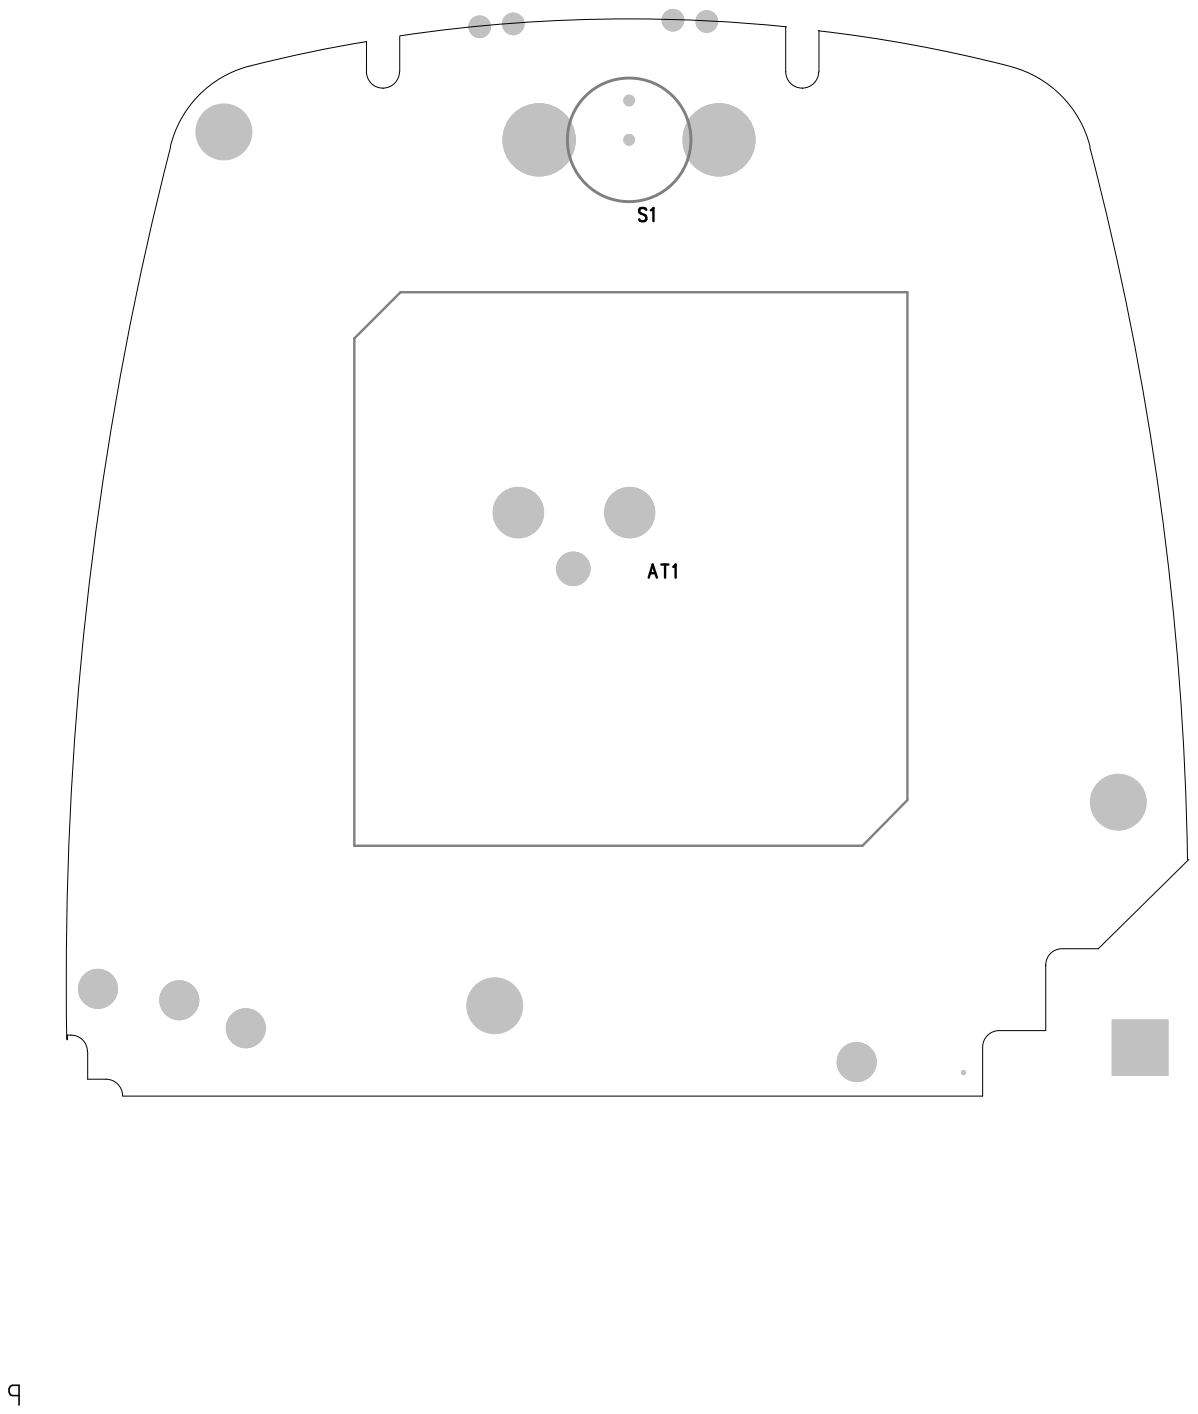
[picture p203: page 1]
