AMSAT-ZL/KiwiSAT_Sub-Systems/GPS/LatimerGPS/Schematic.pdf

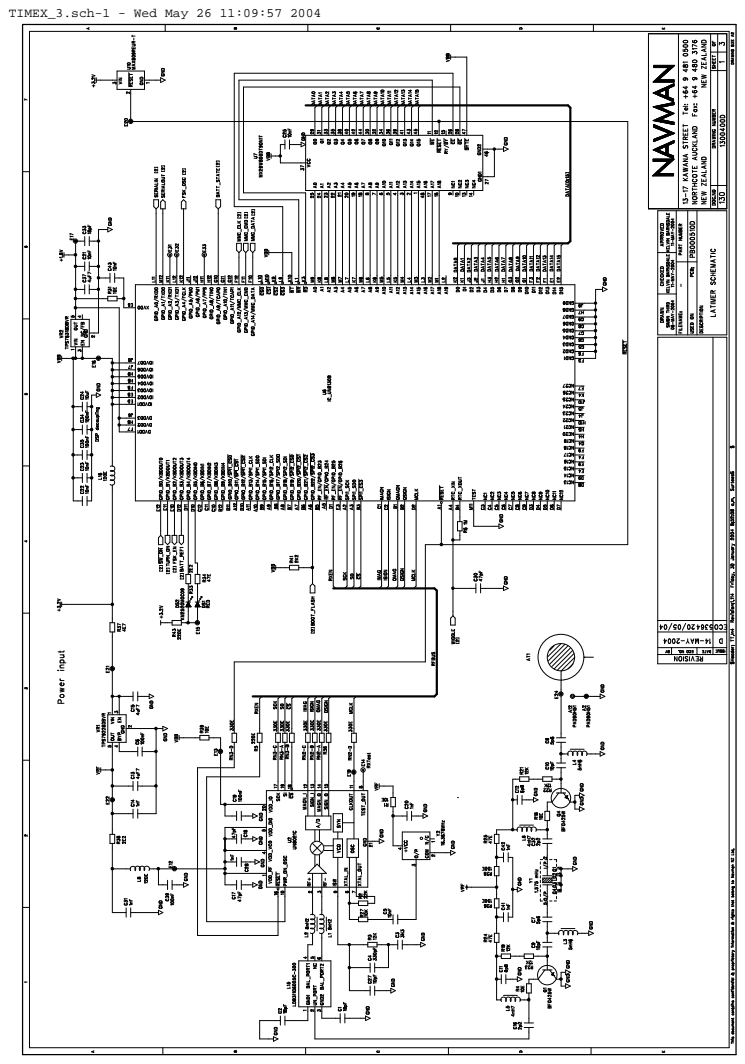
[picture p204: page 1]

TIMEX_3.sch-1 - Wed May 26 11:09:57 2004

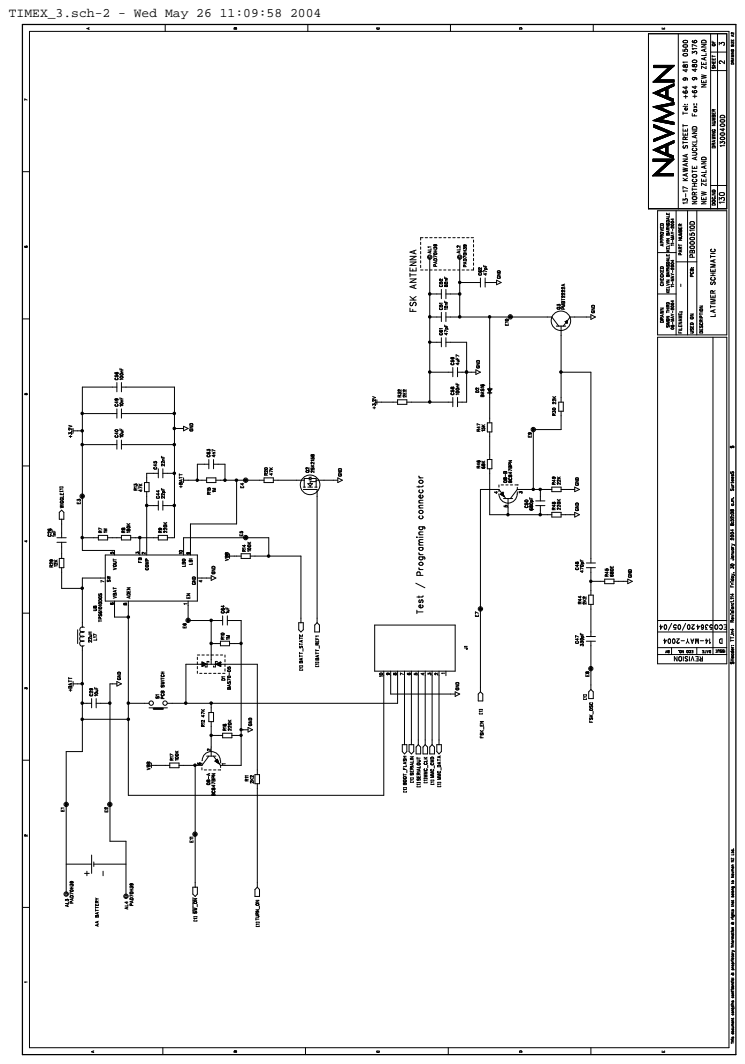
[picture p205: page 2]

TIMEX_3.sch-2 - Wed May 26 11:09:58 2004

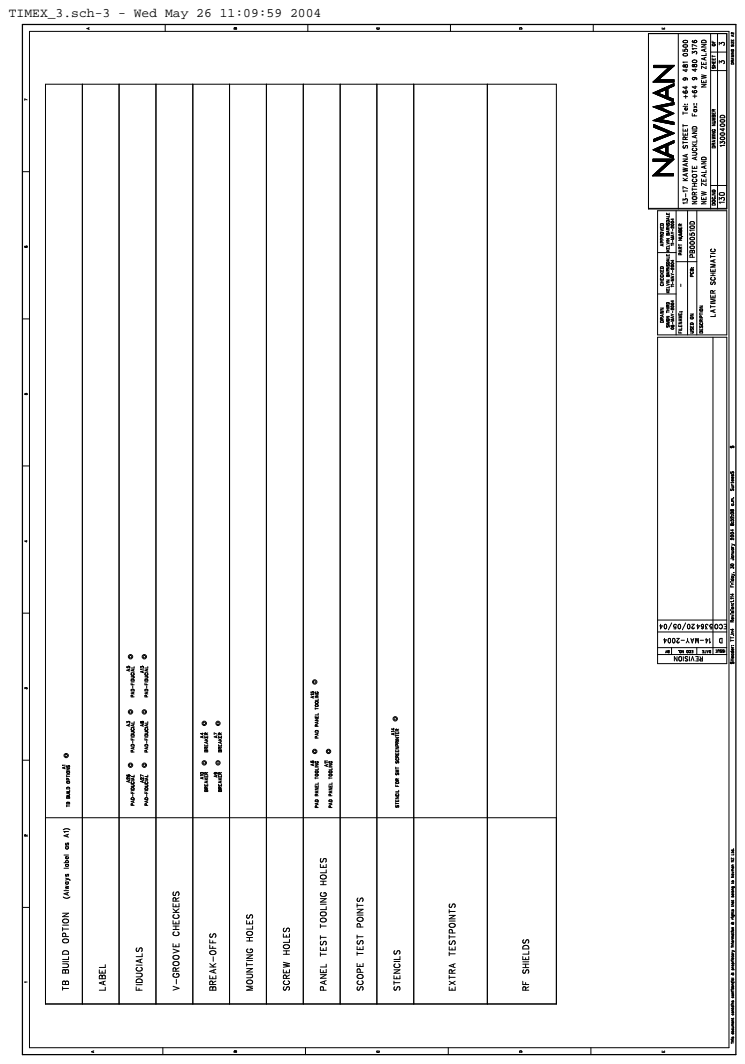
[picture p206: page 3]

TIMEX_3.sch-3 - Wed May 26 11:09:59 2004
