AMSAT-ZL/KiwiSAT_Sub-Systems/GPS/LatimerGPS/soldermask_bot.pdf

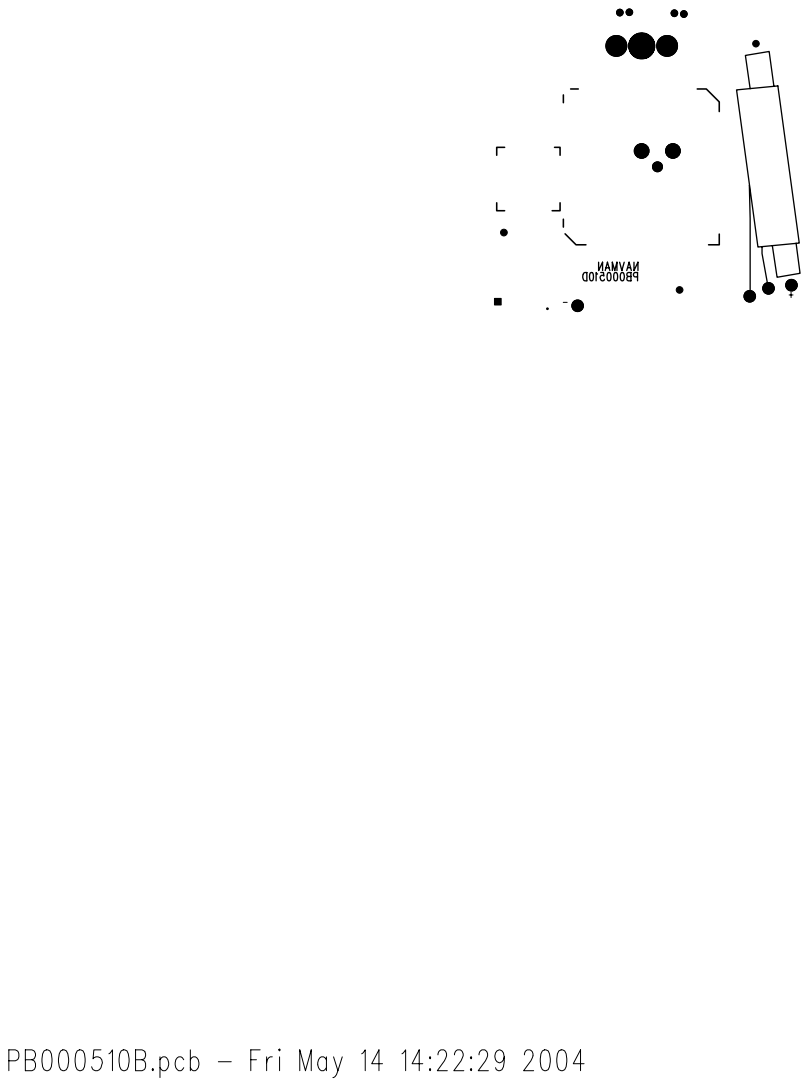
[picture p207: page 1]
