AMSAT-ZL/KiwiSAT_Sub-Systems/GPS/LatimerGPS/soldermask_top.pdf

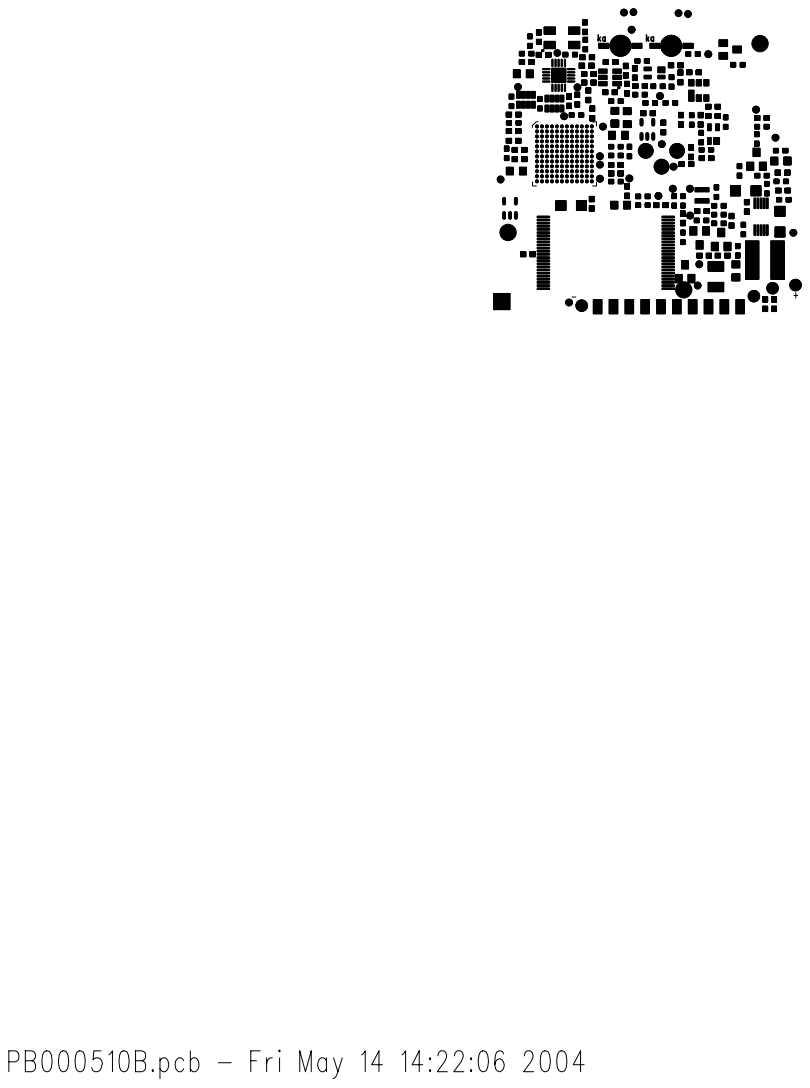
[picture p208: page 1]
