AMSAT-ZL/KiwiSAT_Sub-Systems/IHU/Rev2/FEC_Encoder_06B%20-%20schematic.pdf

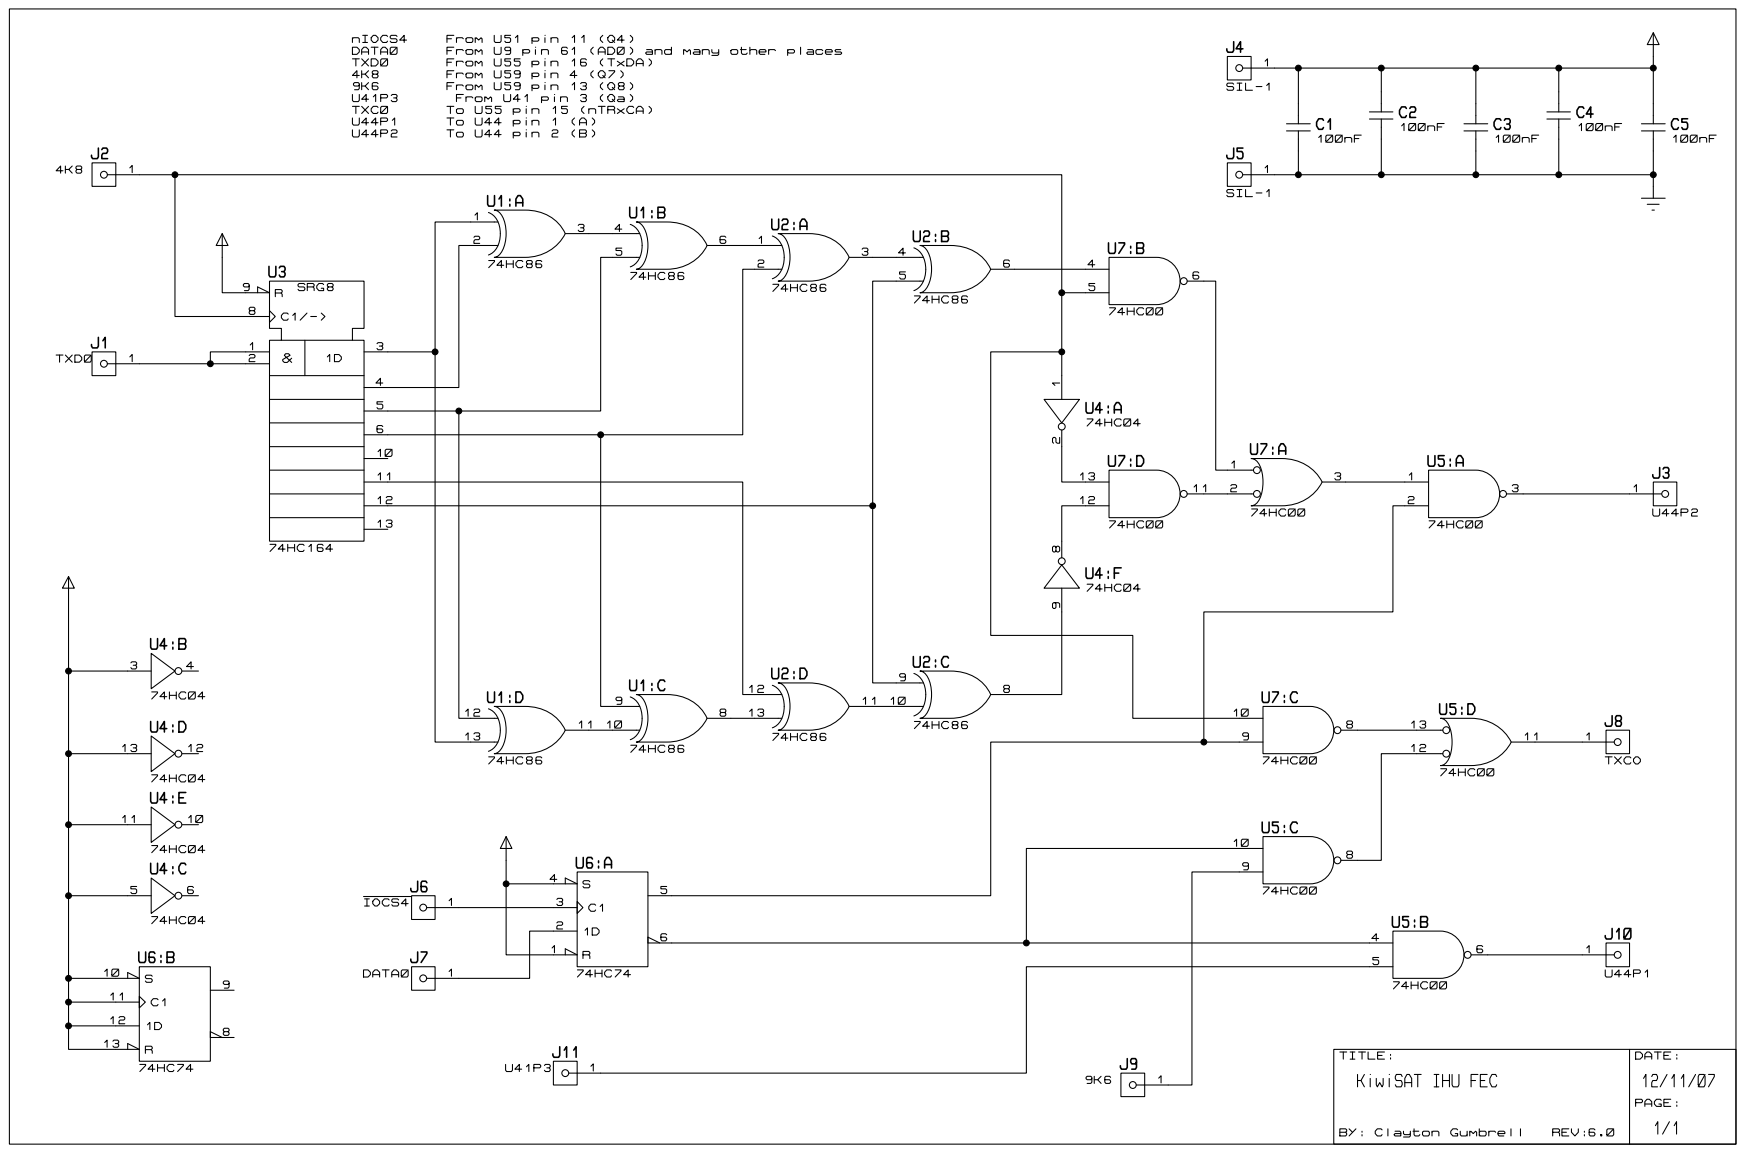
[picture p209: page 1]
