AMSAT-ZL/KiwiSAT_Sub-Systems/BCR/BCR-BLOCK-B.pdf

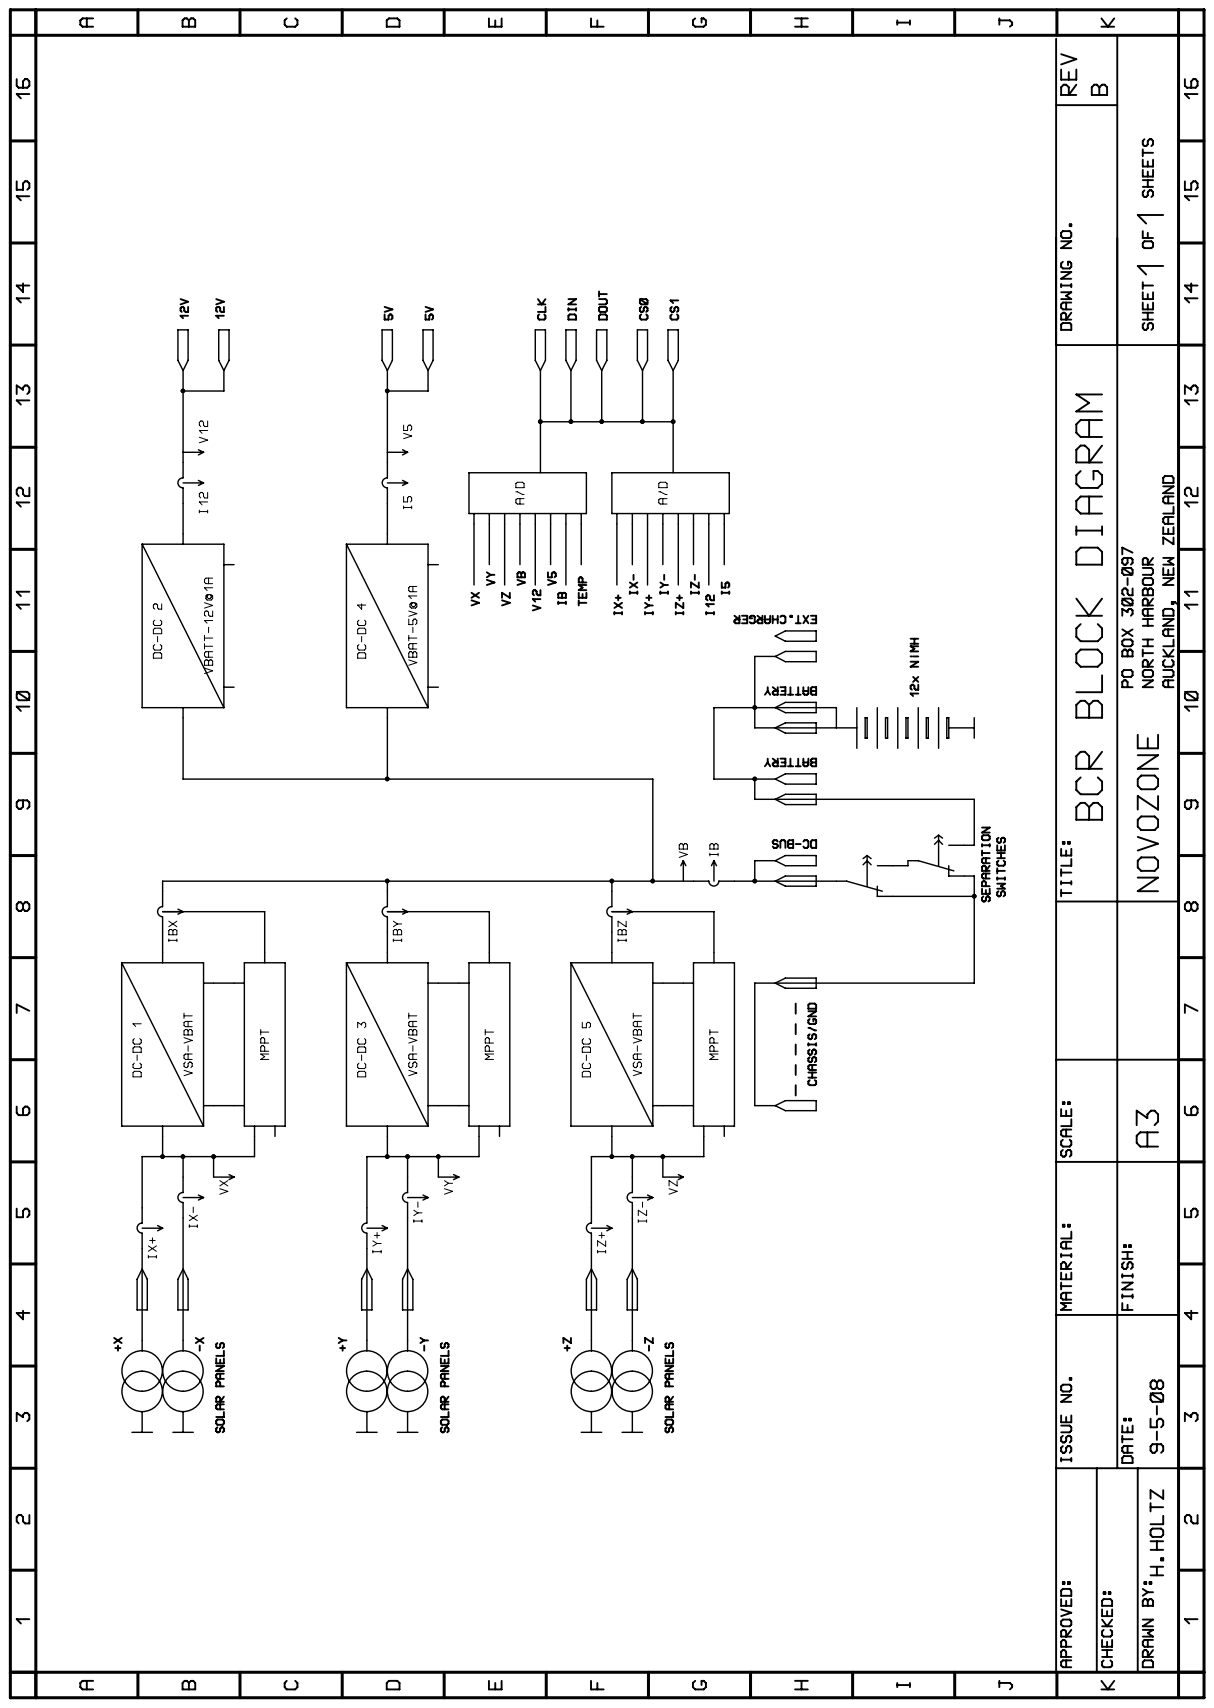
[picture p210: page 1]
