AMSAT-ZL/KiwiSAT_Sub-Systems/ADC_Module/ADC_Module_V10 overlay.pdf

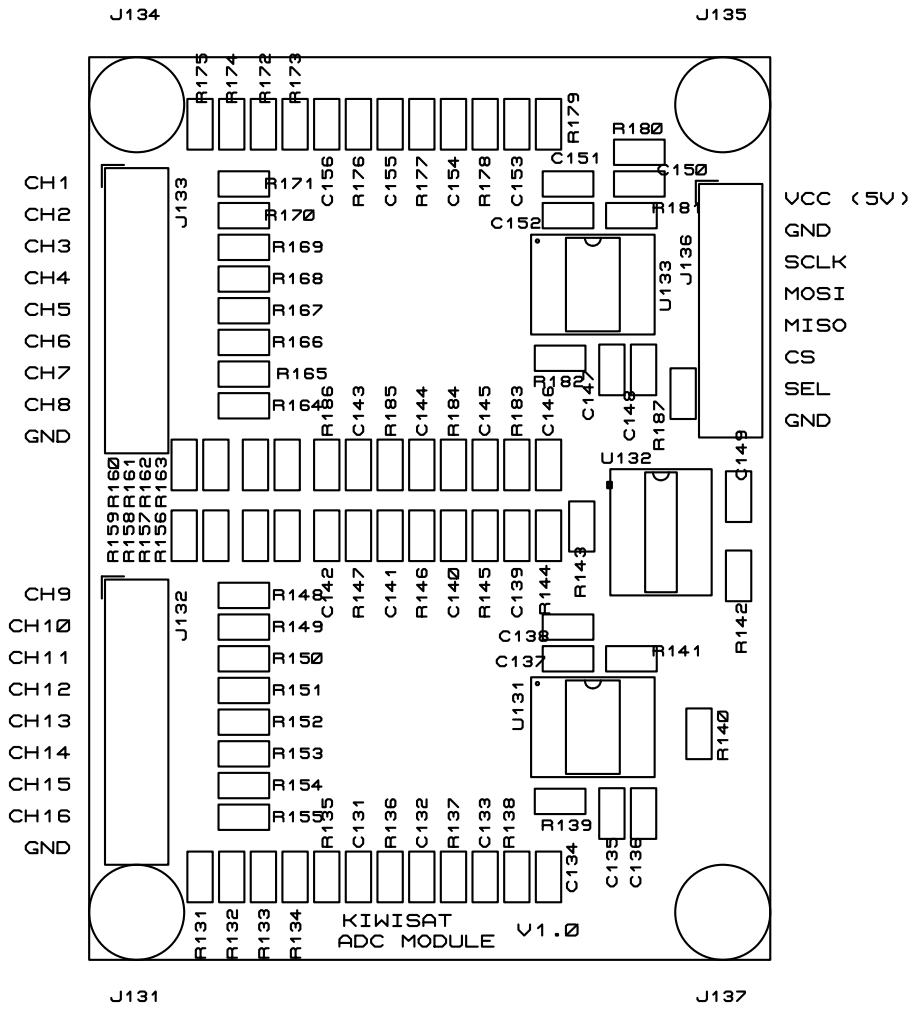
[picture p211: page 1]
