AMSAT-ZL/KiwiSAT_Sub-Systems/Camera/C328_Camera_ReverseEngineer.pdf

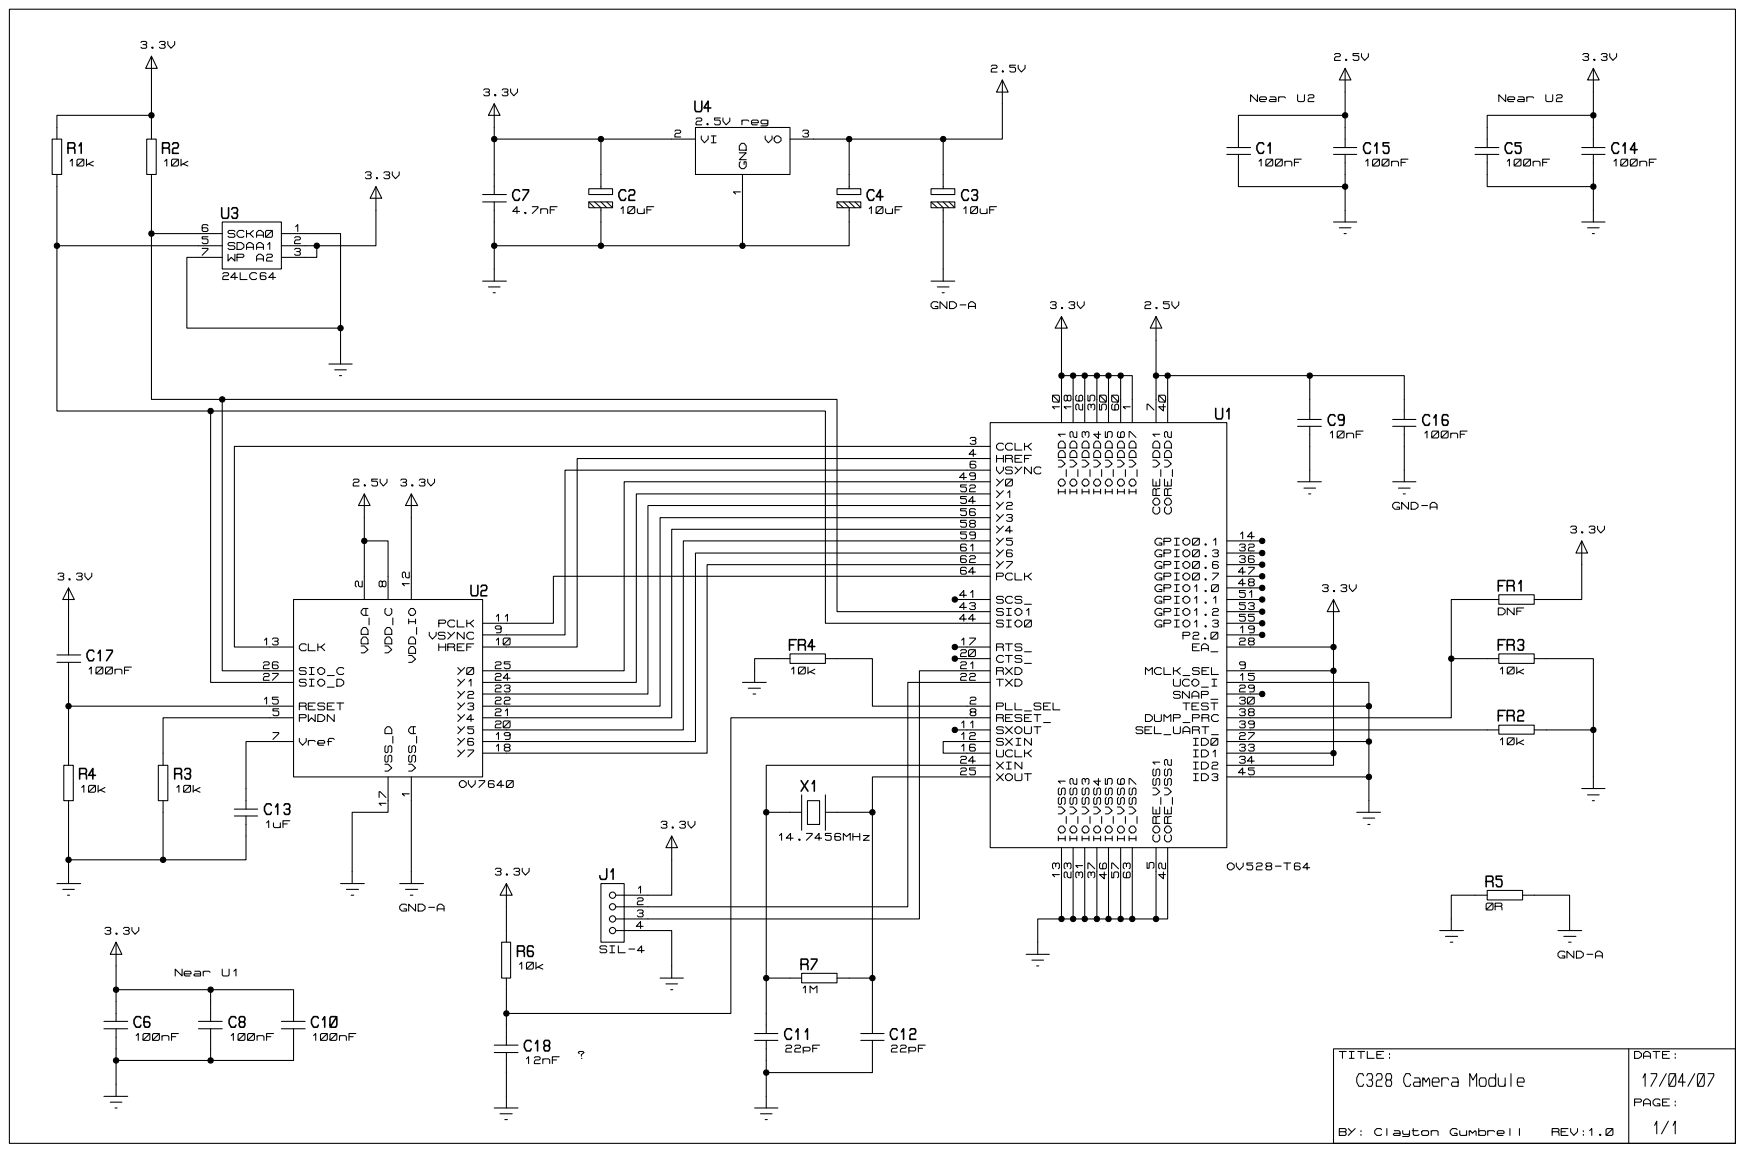
[picture p212: page 1]
