AMSAT-ZL/KiwiSAT_Sub-Systems/Camera/Camera_V2 bottom copper.pdf

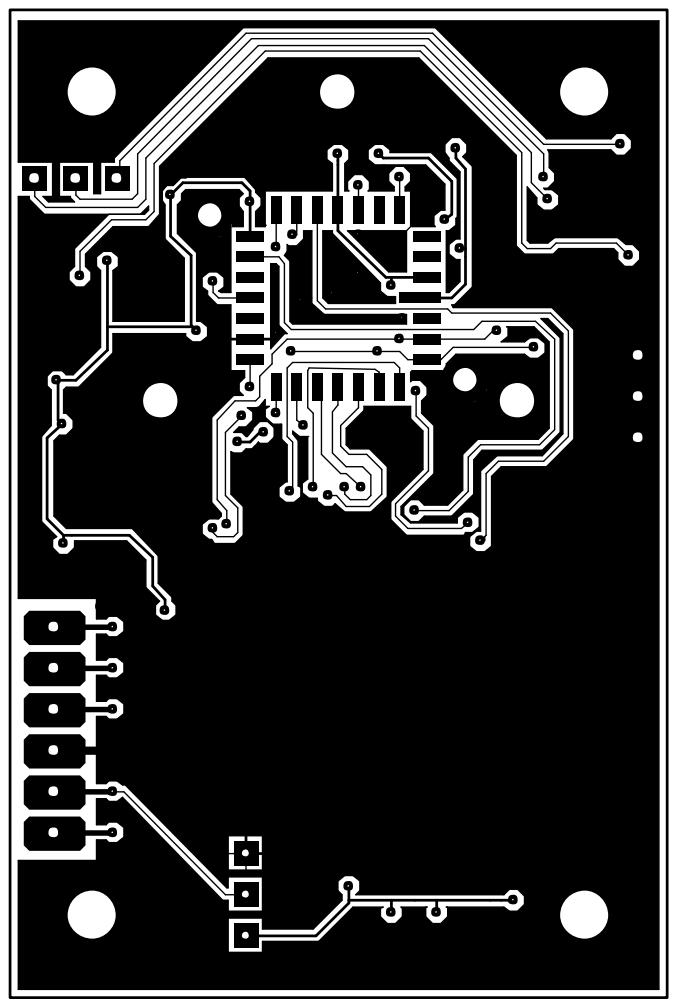
[picture p213: page 1]
