AMSAT-ZL/KiwiSAT_Sub-Systems/Camera/Camera_V2 top copper.pdf

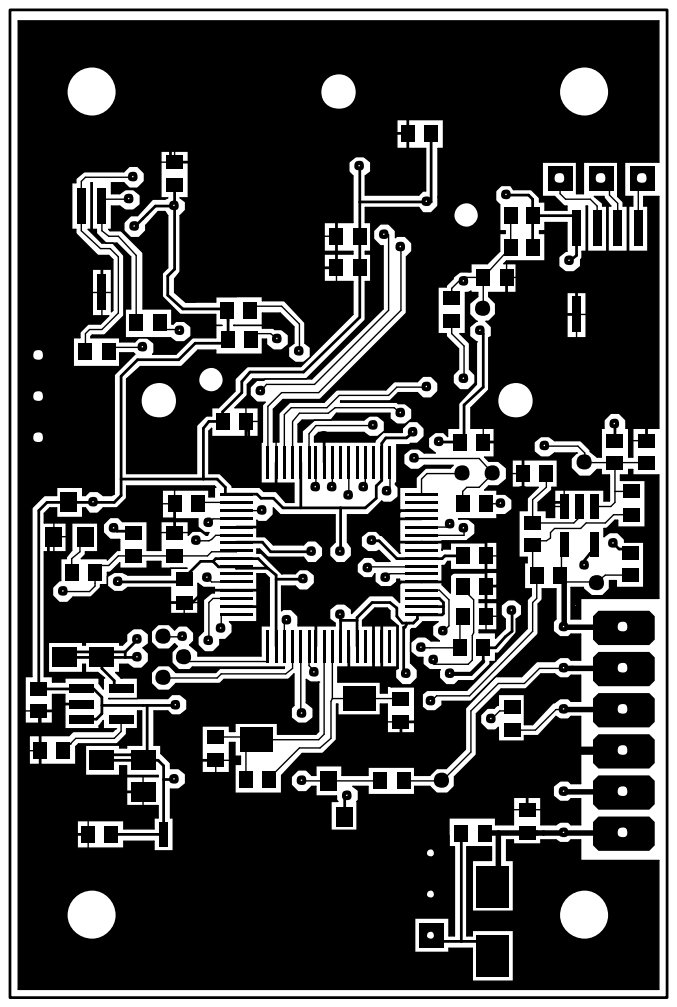
[picture p214: page 1]
