AMSAT-ZL/KiwiSAT_Sub-Systems/Camera/Camera_V2 top overlay.pdf

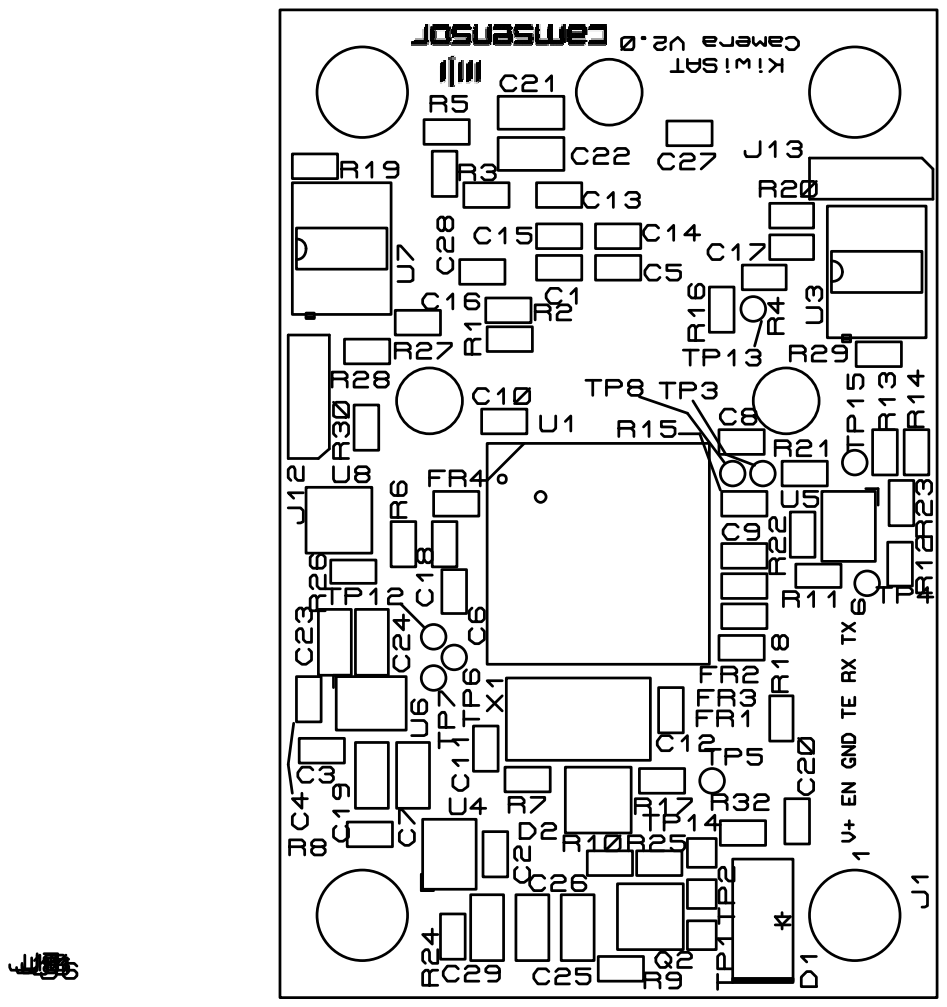
[picture p215: page 1]
