AMSAT-ZL/KiwiSAT_Sub-Systems/Coil_Driver/ADAC PCB v1 overlay.pdf

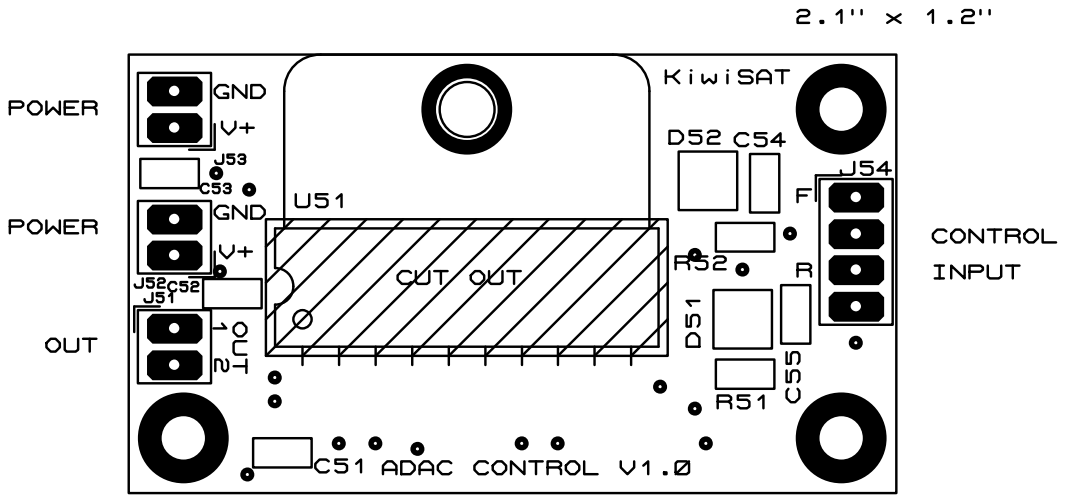
[picture p216: page 1]
