AMSAT-ZL/KiwiSAT_Sub-Systems/FM_Transmitter/dimensions.pdf

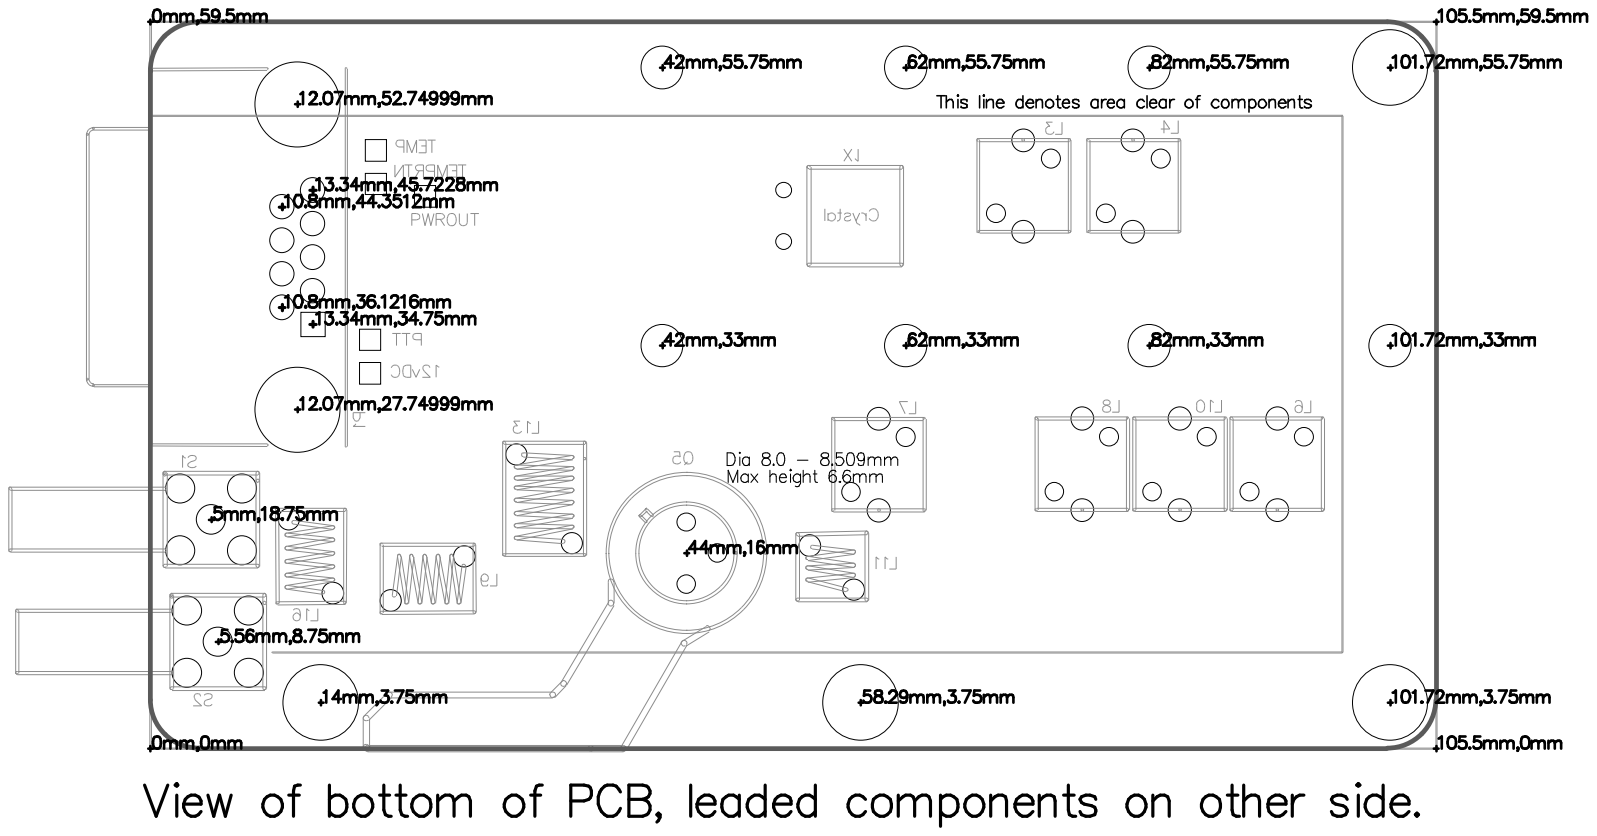
[picture p217: page 1]
