AMSAT-ZL/KiwiSAT_Sub-Systems/LBandDownConverter/LBandCon_V1_layout.pdf

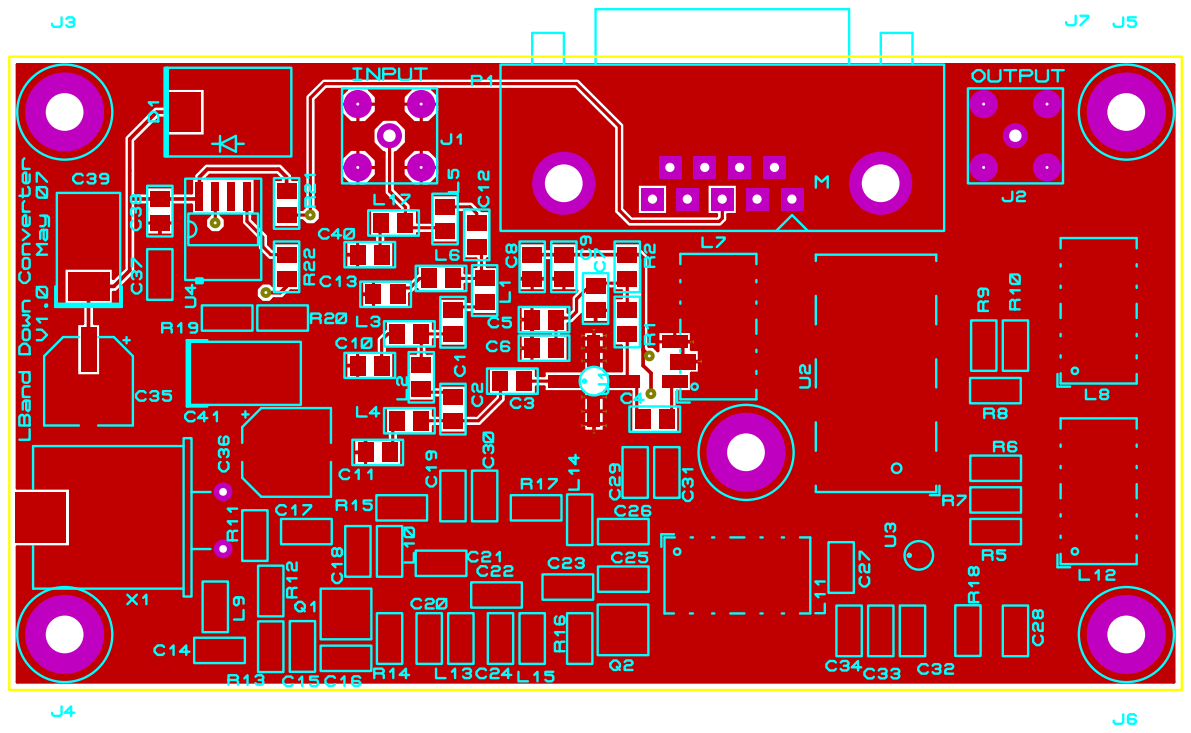
[picture p218: page 1]
