AMSAT-ZL/KiwiSAT_Sub-Systems/RamDisk/ramdisk_assy.pdf

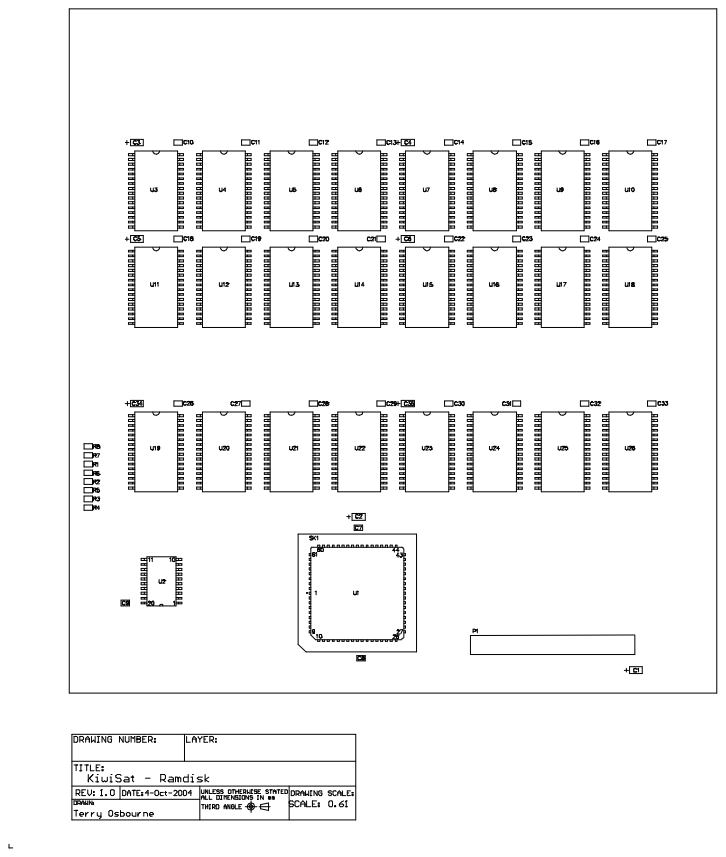
[picture p219: page 1]
