AMSAT-ZL/KiwiSAT_Sub-Systems/RamDisk/ramdisk_top.pdf

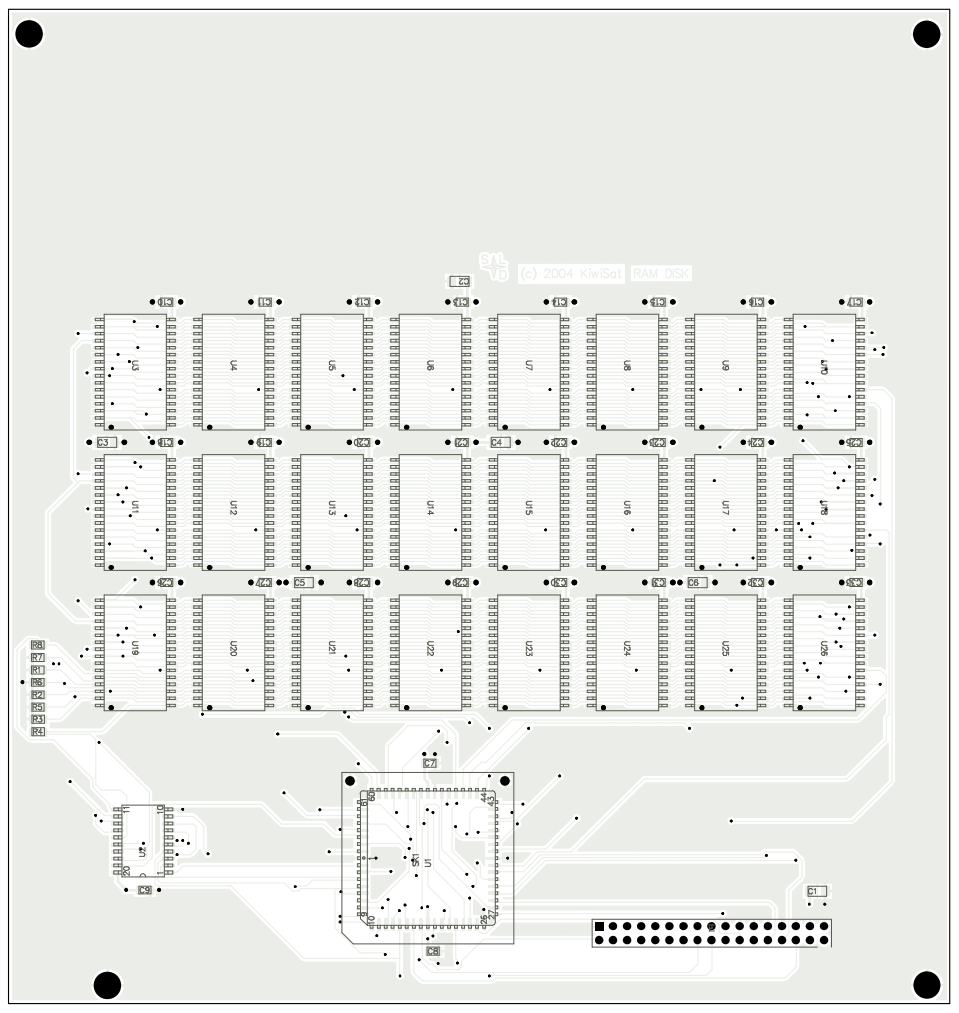
[picture p220: page 1]
