AMSAT-ZL/KiwiSAT_Sub-Systems/GPS/LatimerGPS/drill_drawing.pdf

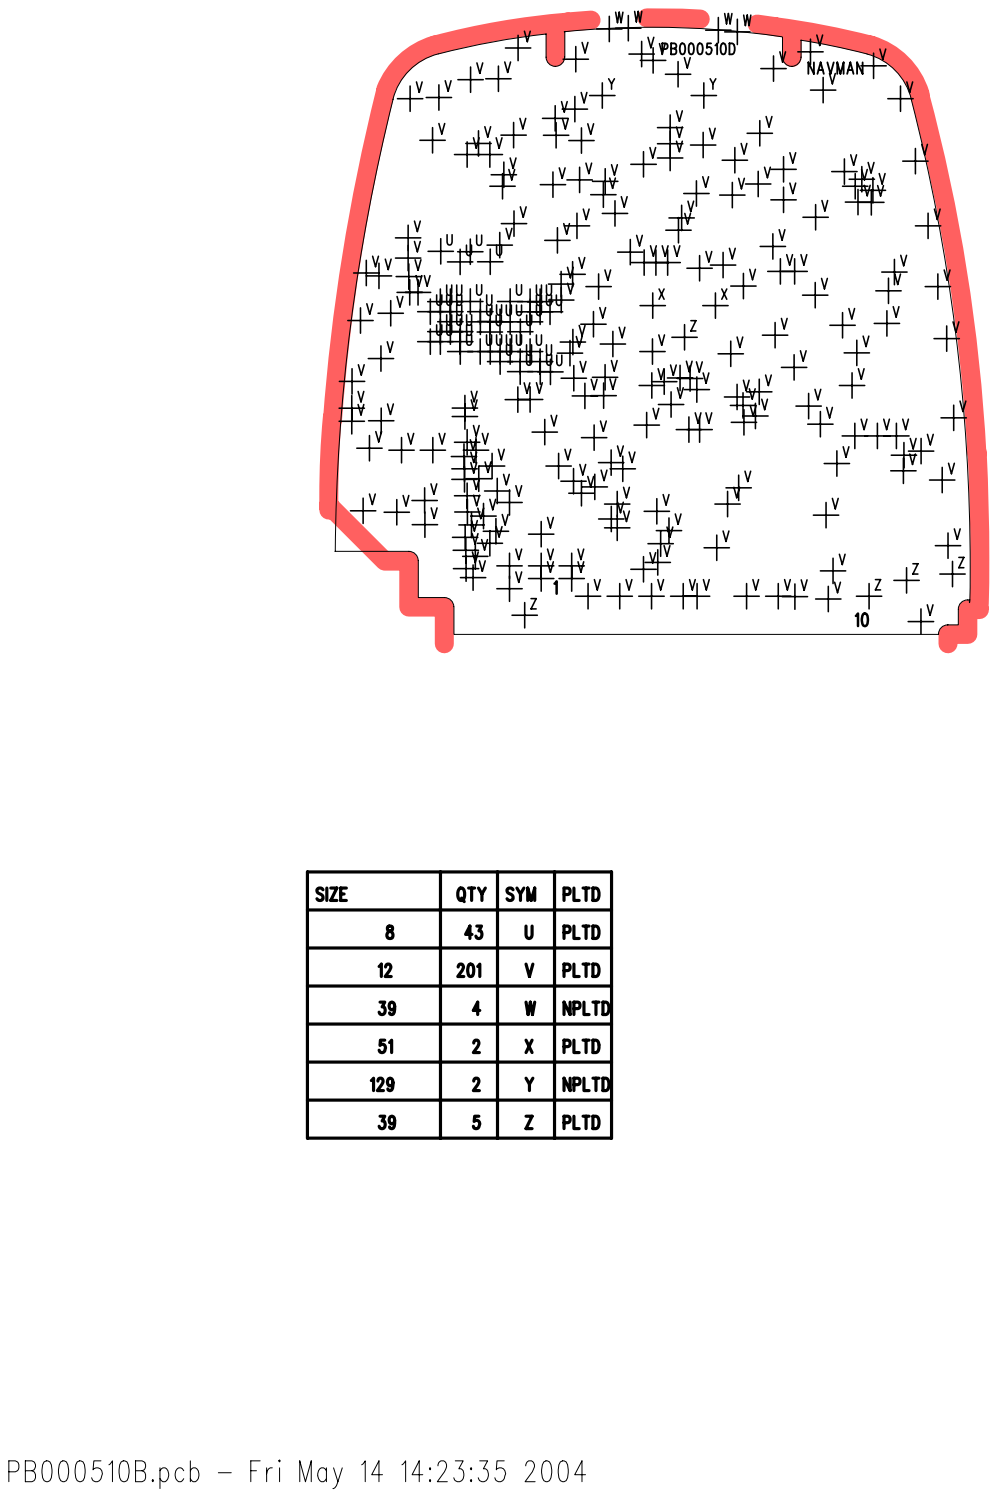
[picture p221: page 1]
