AMSAT-ZL/KiwiSAT_Sub-Systems/GPS/LatimerGPS/layer1.pdf

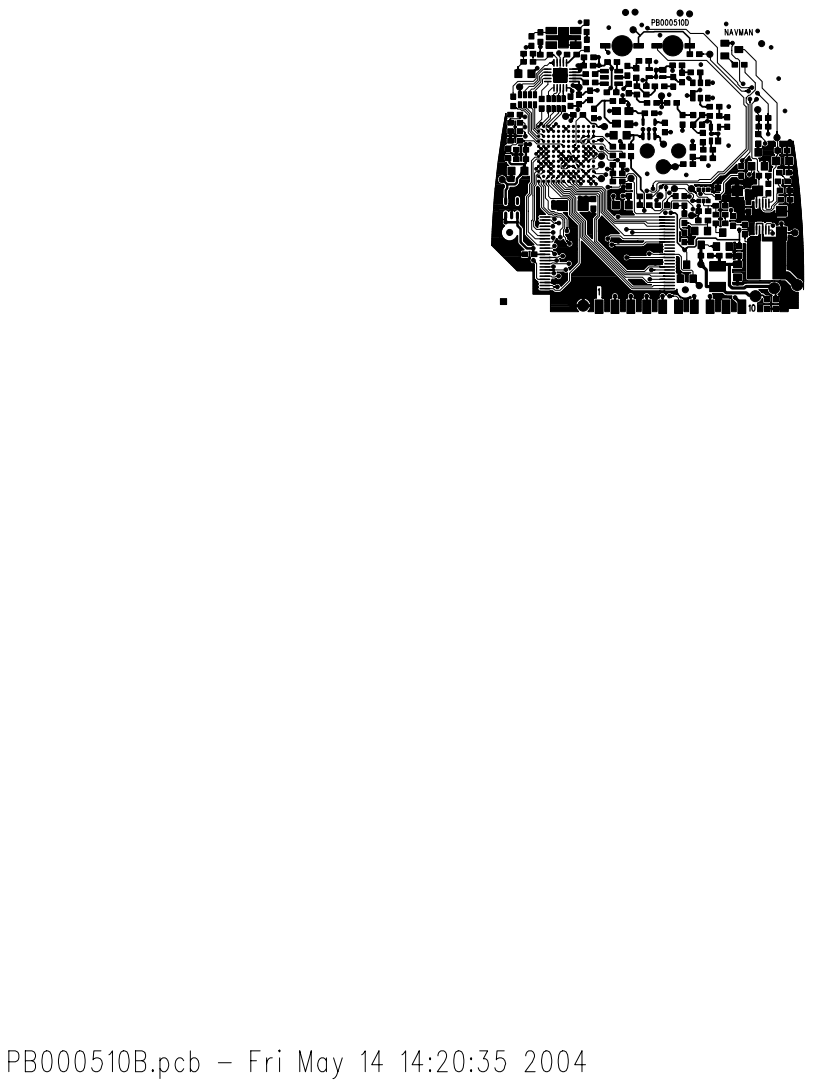
[picture p222: page 1]
