AMSAT-ZL/KiwiSAT_Sub-Systems/GPS/LatimerGPS/layer2.pdf

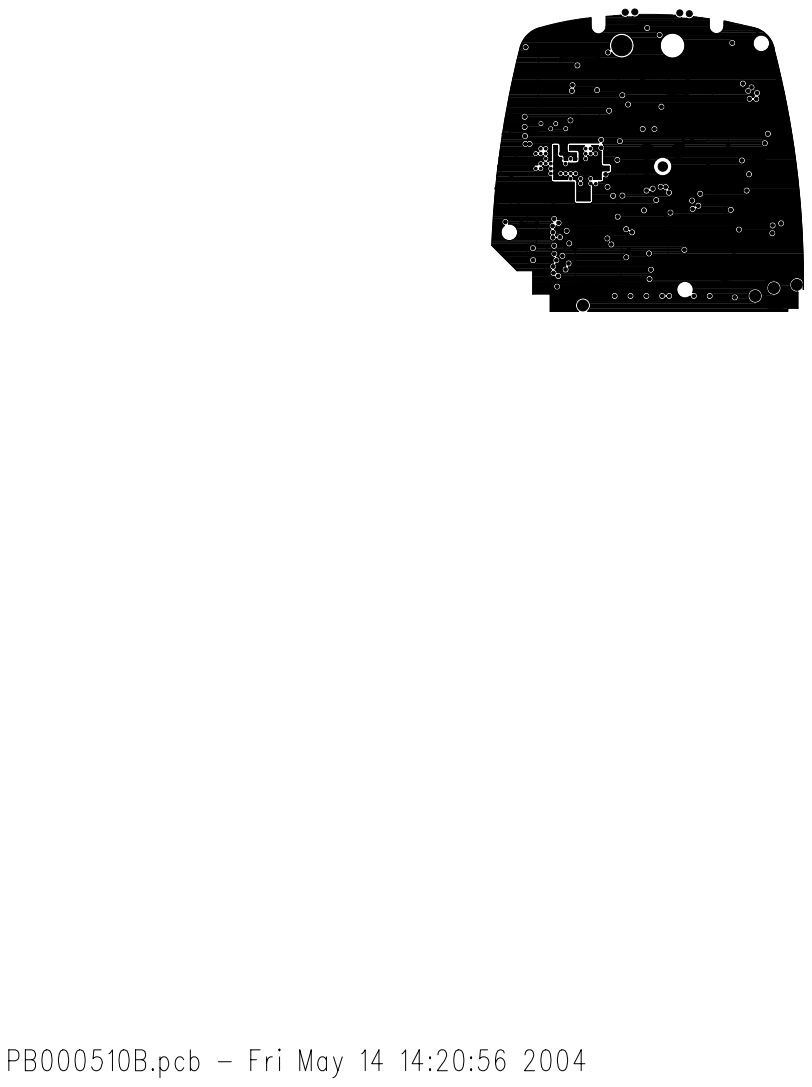
[picture p223: page 1]
