AMSAT-ZL/KiwiSAT_Sub-Systems/GPS/LatimerGPS/layer3.pdf

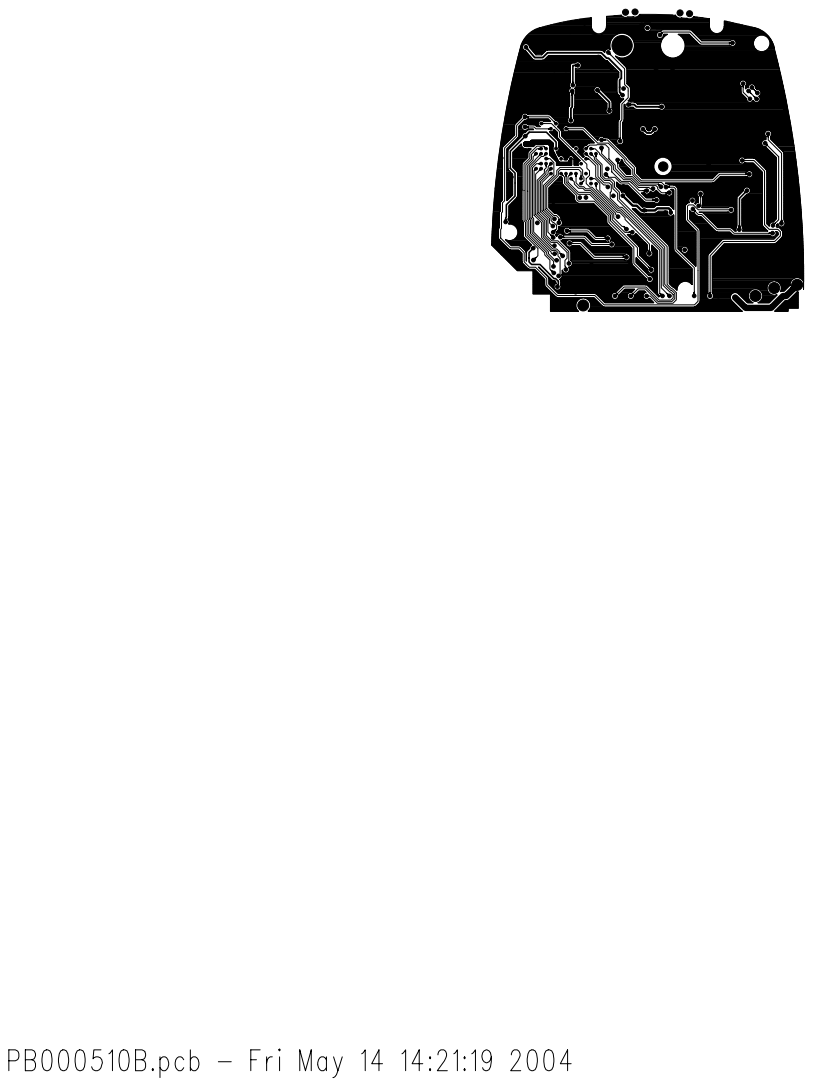
[picture p224: page 1]
