AMSAT-ZL/KiwiSAT_Sub-Systems/GPS/LatimerGPS/layer4.pdf

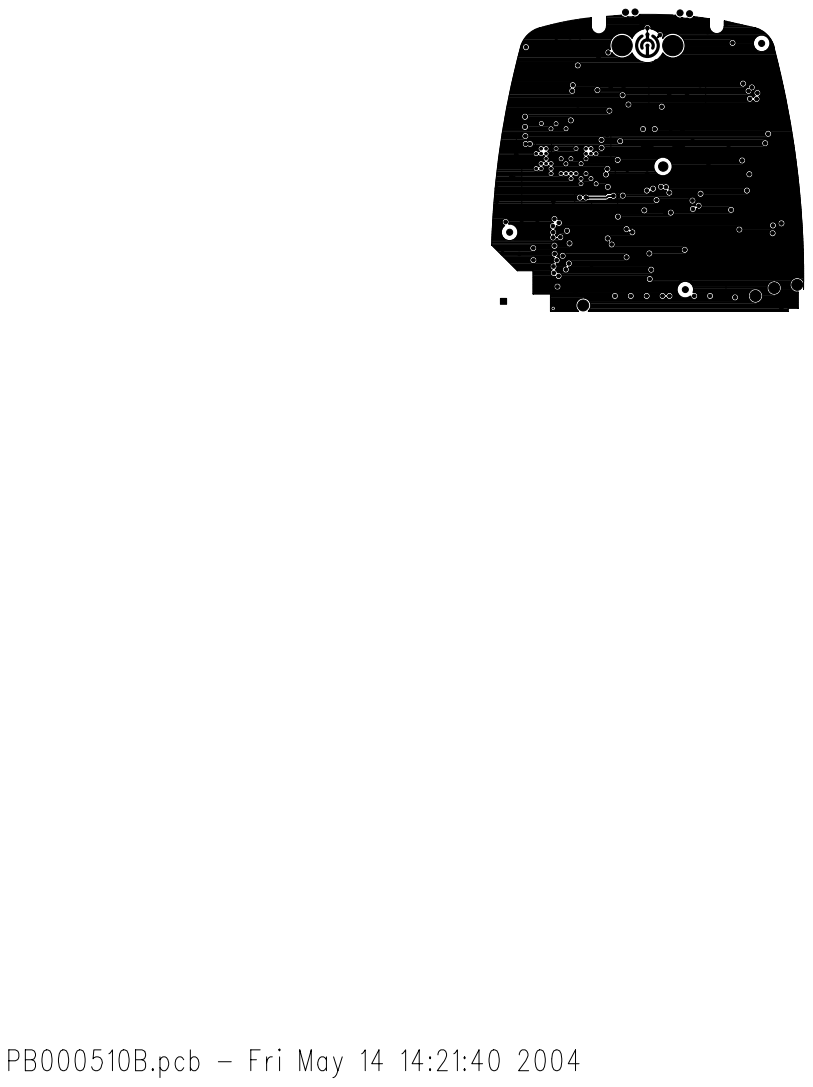
[picture p225: page 1]
