AMSAT-ZL/KiwiSAT_Sub-Systems/GPS/LatimerGPS/panel_drawing.pdf

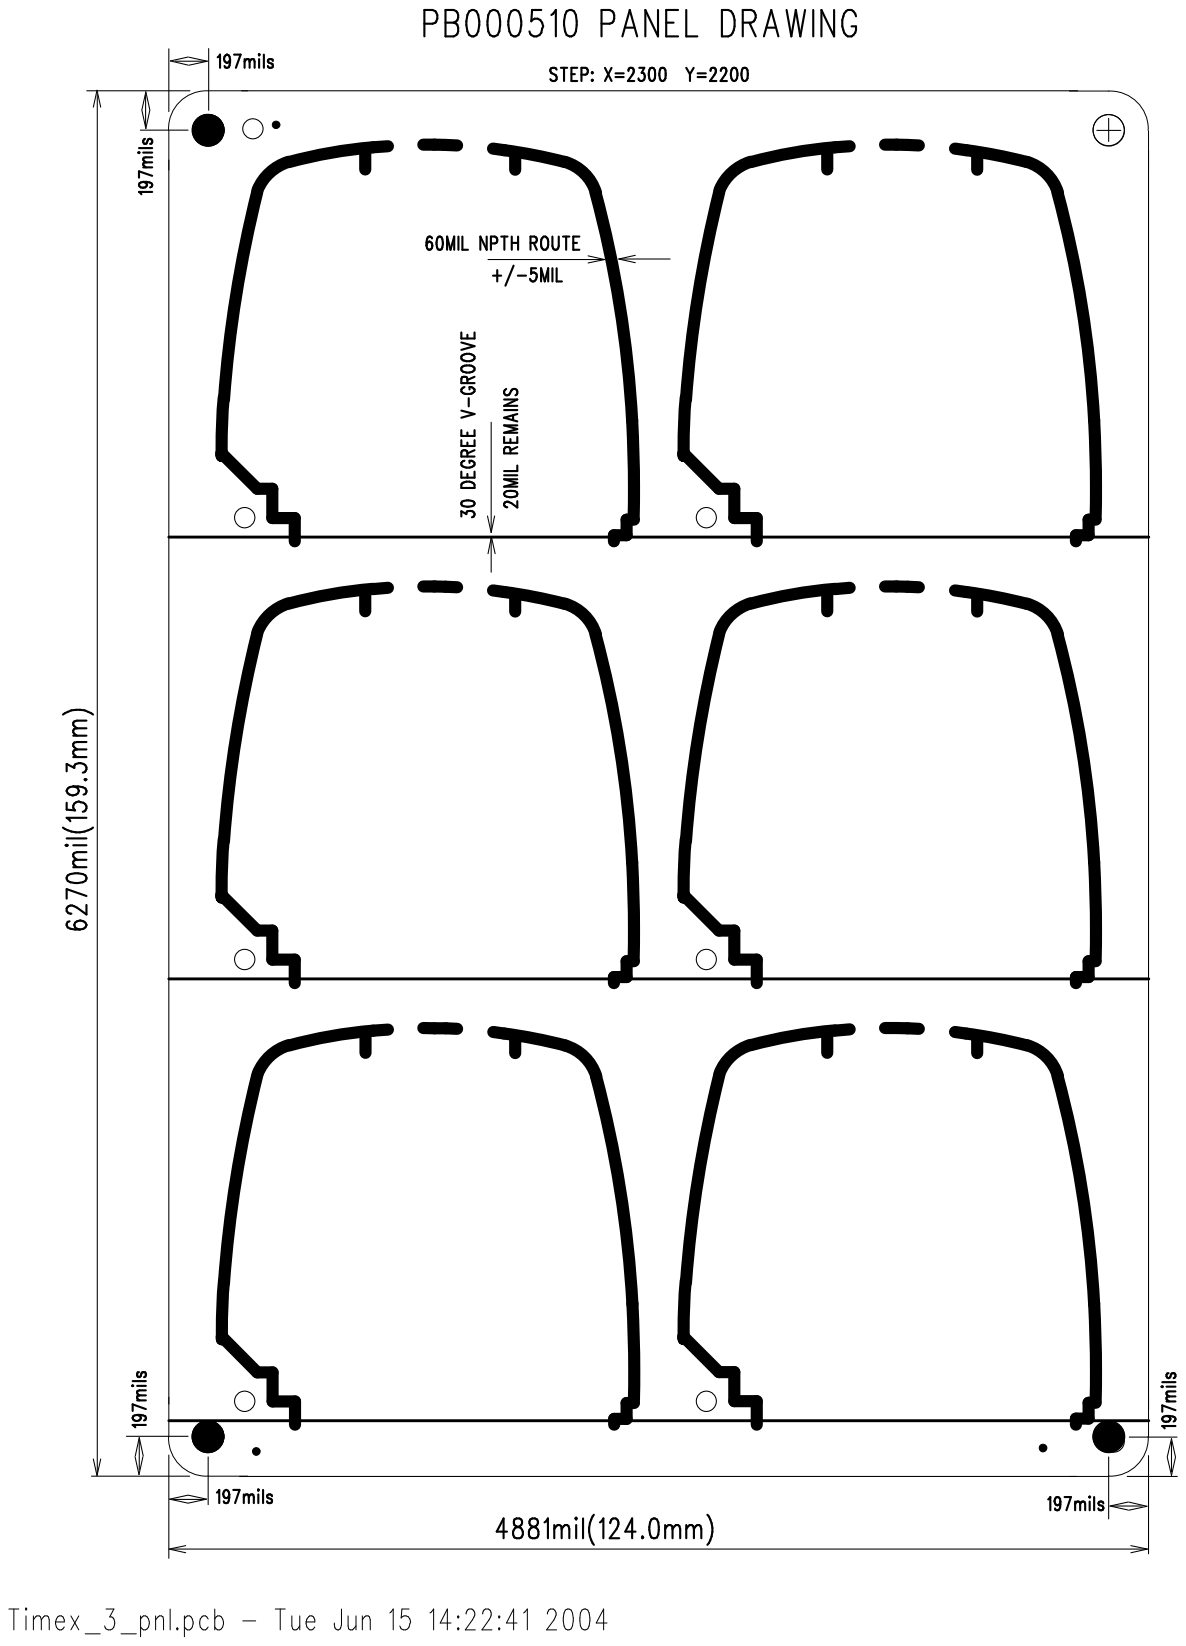
[picture p226: page 1]
