AMSAT-ZL/KiwiSAT_Sub-Systems/GPS/LatimerGPS/PB000510D-G_STACK_UP.pdf

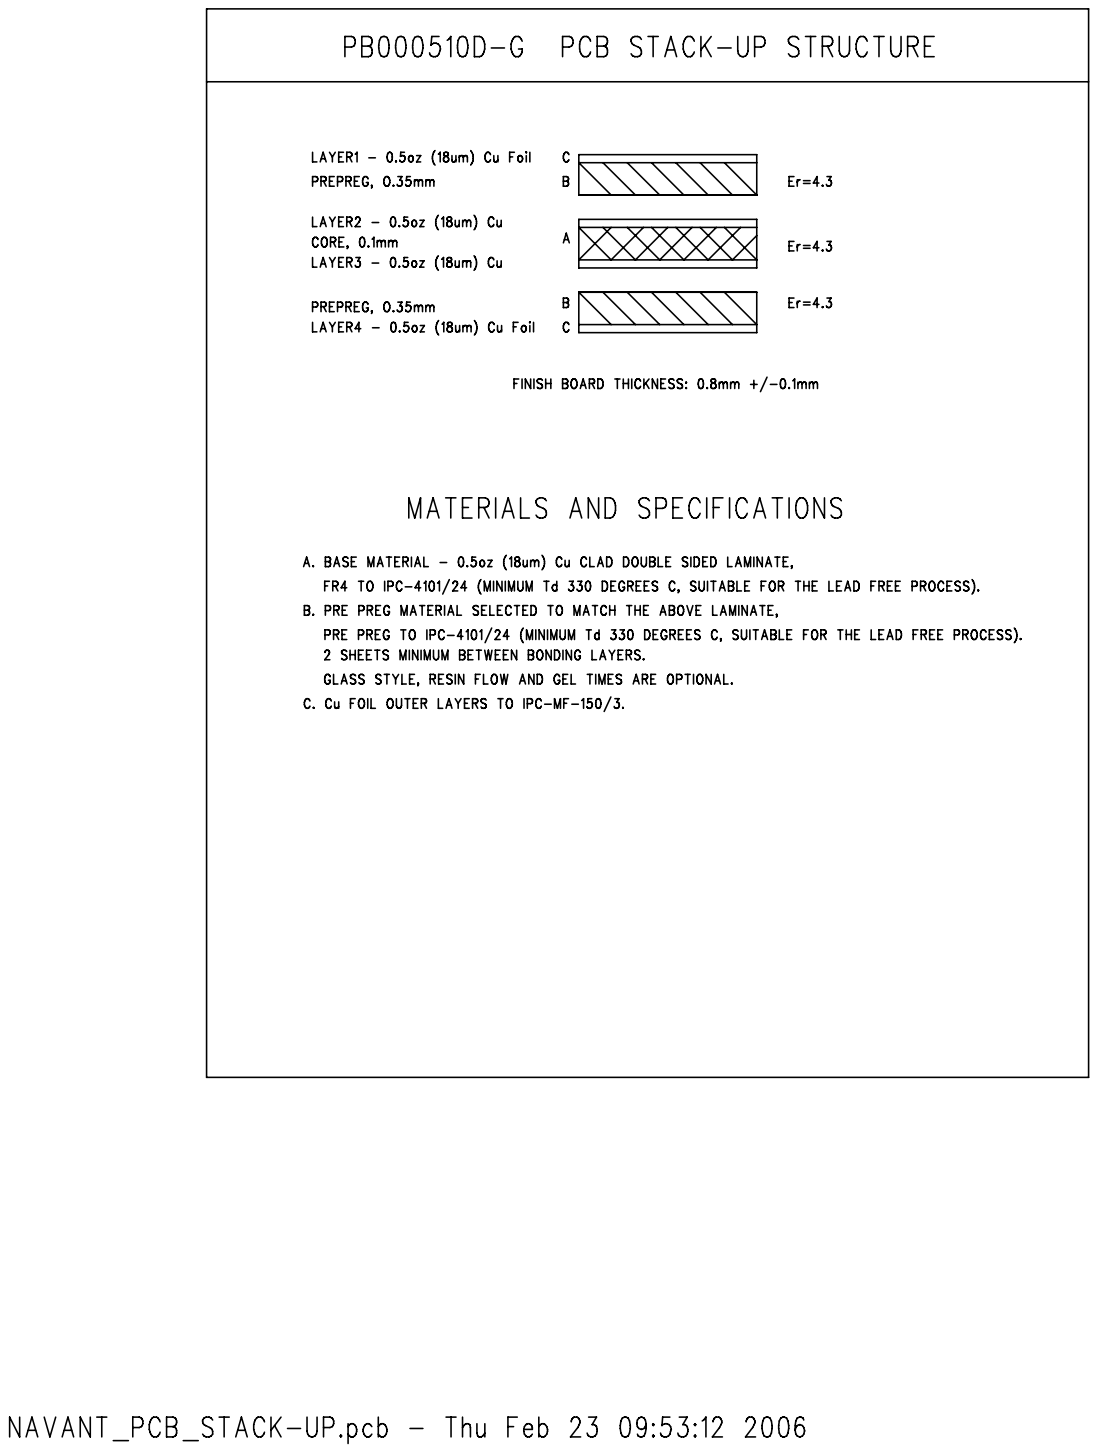
[picture p227: page 1]
