AMSAT-ZL/KiwiSAT_Sub-Systems/GPS/LatimerGPS/route.pdf

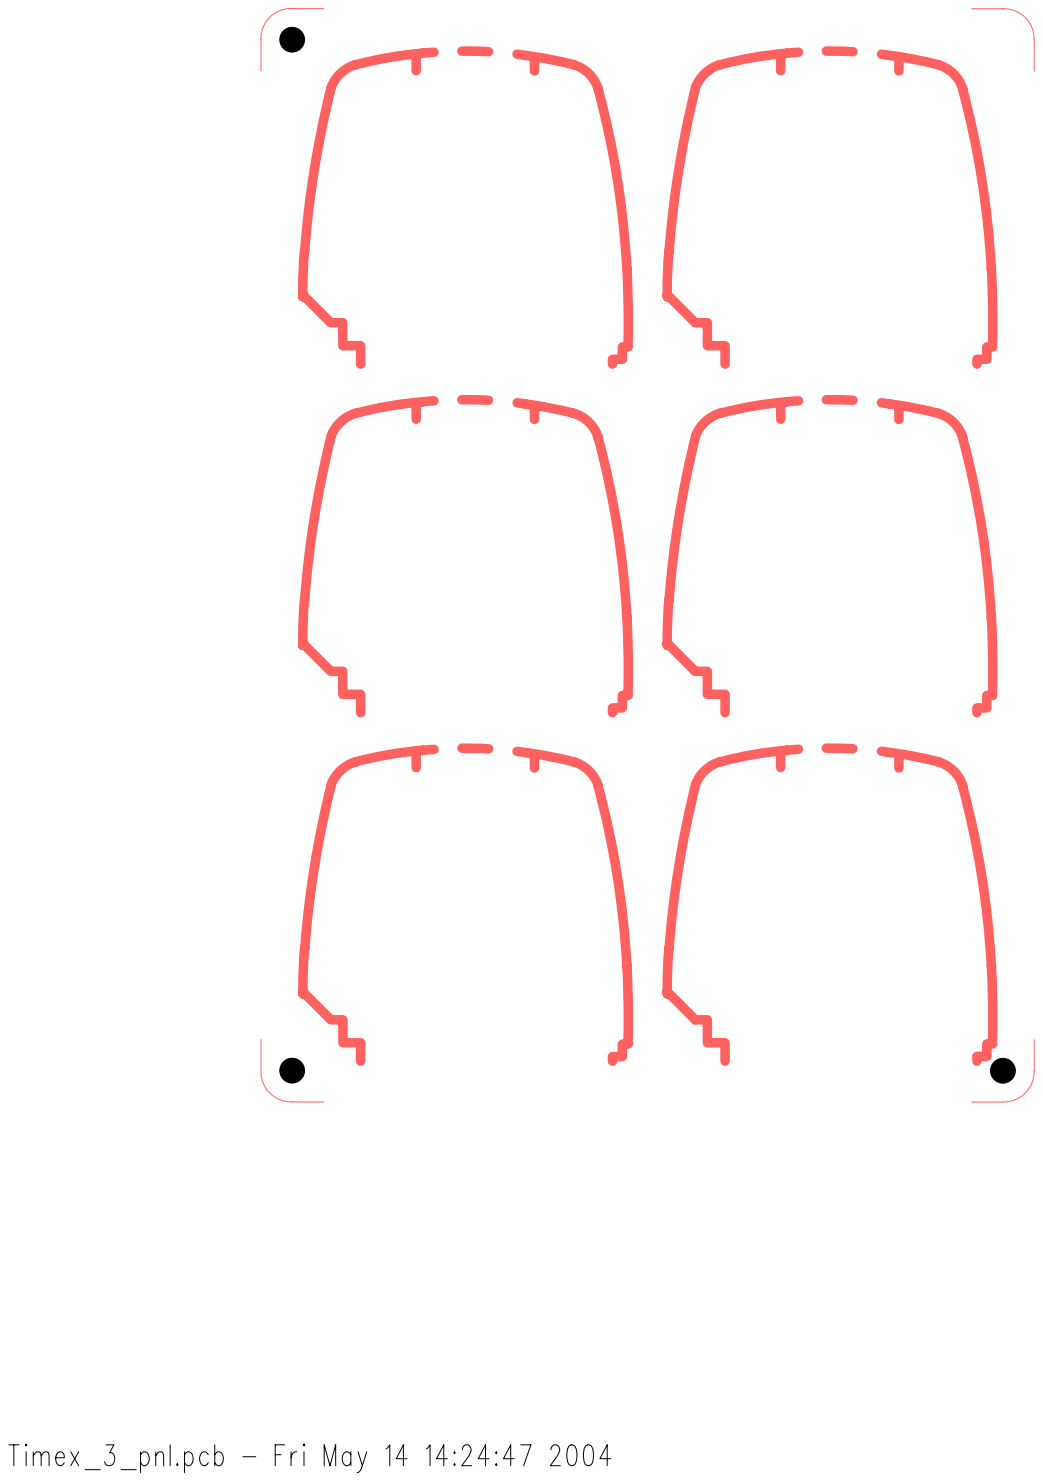
[picture p228: page 1]
