AMSAT-ZL/KiwiSAT_Sub-Systems/GPS/LatimerGPS/v-groove.pdf

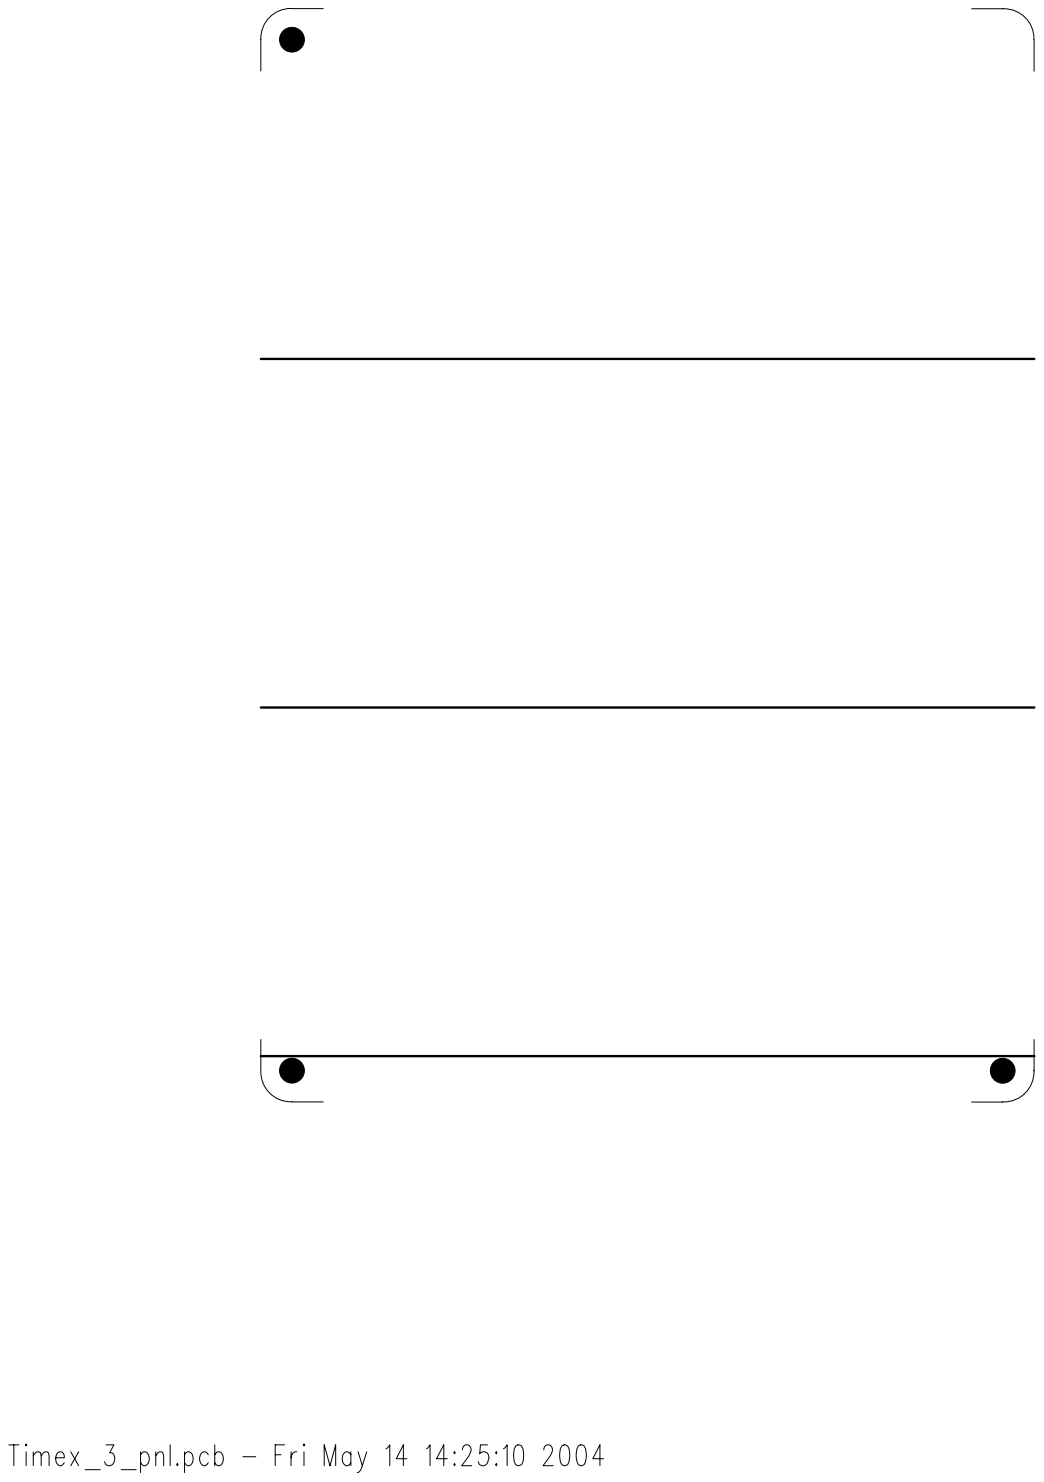
[picture p229: page 1]
