AMSAT-ZL/KiwiSAT_Sub-Systems/IHU/FEC_Encoder/FEC_Encoder_06B - copper.pdf

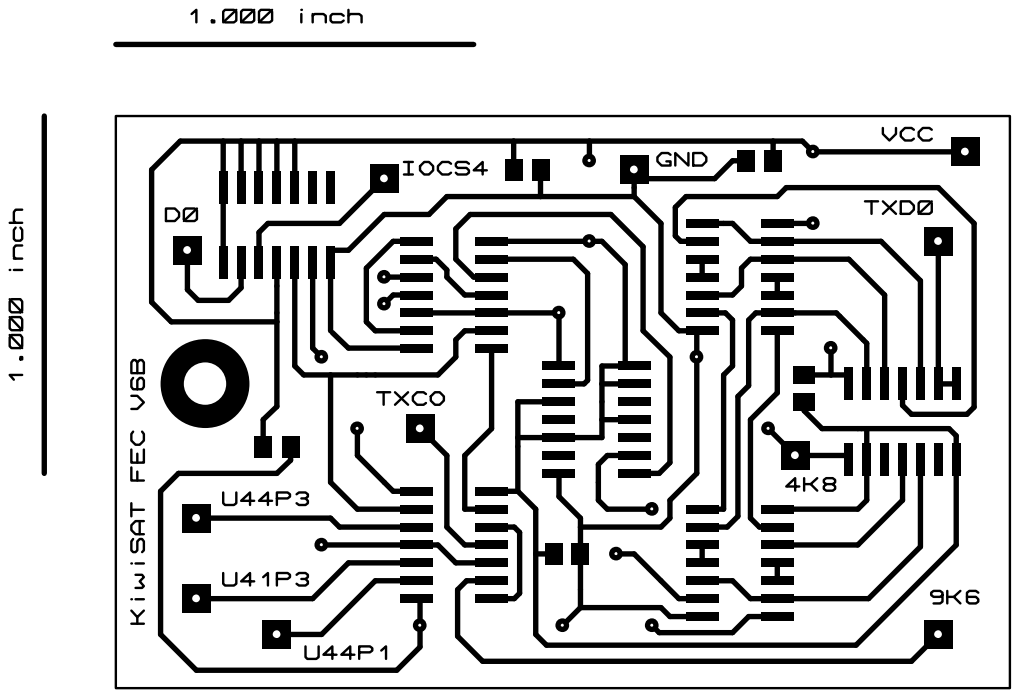
[picture p230: page 1]
