AMSAT-ZL/KiwiSAT_Sub-Systems/IHU/FEC_Encoder/FEC_Encoder_06B - layout.pdf

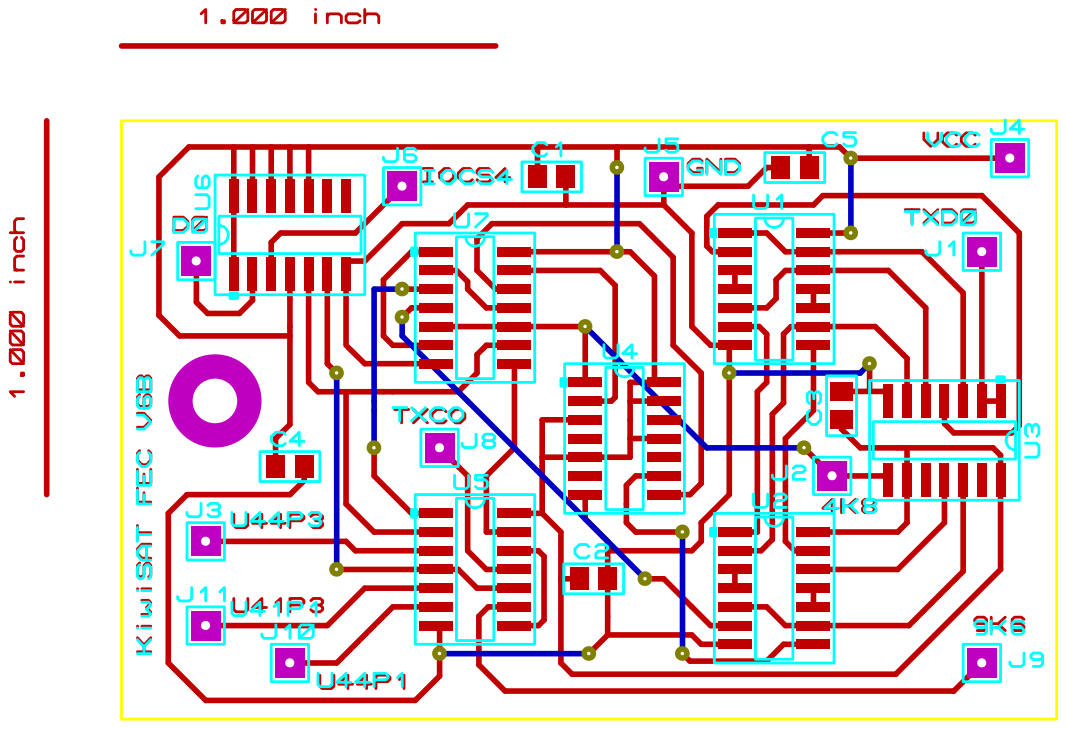
[picture p231: page 1]
