AMSAT-ZL/KiwiSAT_Sub-Systems/(list of files, drawings)

Other design files:
ADC_Module/ADC_Module_V10.DSN
ADC_Module/ADC_Module_V10.LYT
Camera/C328_Camera_ReverseEngineer.DSN
Camera/Camera_V2.DSN
Camera/Camera_V2.LYT
Camera/PCB Panels/CameraADAC1.LYT
Camera/PCB Panels/CameraADAC2.LYT
Coil_Driver/ADAC_Controller_V1.DSN
Coil_Driver/ADAC_Controller_V1.LYT
Earth_Horizon_Sensor/Horizon_Sensor_Heads_V11.LYT
Earth_Horizon_Sensor/Horizon_Sensor_Heads_V11b.DSN
FM_Transmitter/FM TX RevF Protel version 2.8.Pcb
GPS/Interface RevB/GPS Interface RevB.Pcb
IHU/FEC_Encoder/FEC_Encoder_06B.DSN
IHU/FEC_Encoder/FEC_Encoder_06B.LYT
LBandDownConverter/LBandCon_V1.DSN
LBandDownConverter/LBandCon_V1.LYT
Magnetometer/Magnetometer_V10.DSN
Magnetometer/Magnetometer_V10.LYT
Magnetometer/PCB Panels/PCB_SMAH.LYT
Preamp/PreampV2/preamp.pcb
Sun_Sensor/OldFiles/Old design and mechanical/Sun sensor pcb (new).PCBDOC
Sun_Sensor/OldFiles/PCB design/Sun Sensor.PCB
Sun_Sensor/SunSensor_V1.DSN
Sun_Sensor/SunSensor_V1.LYT
