AMSAT-ZL/KiwiSAT_Sub-Systems/(commit log)

2021-08-17 First Upload of files
    [ADAC_Controller_V1.DSN, ADAC_Controller_V1.LYT, ADC_Module_V10.DSN, ADC_Module_V10.LYT, ADC_Module_V10_BOM.xls, Backup of GPS Interface RevB.Pcb, Backup of GPS Interface RevB.Sch, C328_Camera_ReverseEngineer.DSN]
2021-09-03 70CM Beacon Files Completed
2021-09-04 Found pic of populated PCB and notes on O/P device
2021-09-04 ADC Module completed. Status updated
    [Documentation Status.xlsx]
2021-09-04 Some antenna data uploaded
2021-09-11 Antenna switch description completed
2021-09-12 Update KiwiSAT Antenna Switch Description.docx
2021-09-17 Solar Panels and Launch adapter files added
    [Documentation Status.xlsx, Launch Adaptor - Concept 1 (CGWIC).dxf, Launch Adaptor Concept 2 (CGWIC).dxf, Launch drum with pushers for CGWIC.dwg, Solar cell Pre Vac and Post Vac Currents.xls, Solar cell evaluation 2.xls, Tecstar Set 2.xls, Tecstar Set 3.xls]
2021-09-17 ADAC Coil Driver, Sun Sensor and GPS files completed
    [Backup of GPS Interface RevB.Pcb, Backup of GPS Interface RevB.Sch, Camera_V1.DSN, Camera_V1.DXF, Camera_V1.LYT, Documentation Status.xlsx, Earth sensor (rev).dxf, Earth sensor(rev).dwg]
2021-09-18 Updates to BCR Folder
    [Documentation Status.xlsx]
2021-09-19 BCR data completed
    [Documentation Status.xlsx]
2021-11-01 Reference to dxfViewer added and Status updated
    [Documentation Status.xlsx]
2021-11-01 Pcb Panel Files added to Camera and Magnetometer.
    [CameraADAC1.LYT, CameraADAC2.LYT, Documentation Status.xlsx, PCB_SMAH.LYT]
2021-11-13 FM Receivers completed
    [Documentation Status.xlsx, Production BOM_v1.0.xls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]
2021-11-14 IHU Rev2 completed
    [KiwiSatOverview.XLS]
2021-11-14 Update Documentation Status.xlsx
    [Documentation Status.xlsx]
